HarryHYu/GrappStar/base/spec/DECISIONS.md

# Coordinator decisions log (binding)

Each decision overrides anything older in BASE_SPEC.md, params.py or worker notes. Panel architecture docs that informed them: base/spec/panel/ (reference only).

## Coordinator decisions (binding from v1.0, 3 Nov 2026 11:20 Sydney)

| # | Decision | Why |
|---|---|---|
| D1 | Launch drive COAXIAL: cad-launch's launch sleeve (20 OD, 6 mm key at sprag #1 inside the 26T m2.5 drive gear, splitter sun, rail cheek journals); cad-drum's LAUNCH DOG RING keys onto its inboard flange; main shaft steps to a d12 spigot inside the sleeve; frame outboard bearing at the sleeve's far end | The big gear rides on the rail and only stays in mesh if the drive gear is coaxial with the rail pivot (v10's key property) |
| D2 | Main axis 165 above the deck top | Rail rear and cocked carriage sweep about 150 below the axis at 47 deg |
| D3 | REEL output gear m2 40T face 12 (cad-drum) meshing the capstan gear m2 24T (cad-reel): capstan 1.667 x wiper, about 0.13 to 0.16 m/s line; tow limit default 50 N in firmware | cad-reel's train is m2; at wiper stall the line sees about 373 N, below the 667 N break |
| D4 | 7 cup turns per wrap; brake FIRM during the wrap so the line comes from the slack dart side; N20 to drum ratio sized for 2x margin on the cup laying torque; the locking arc holds the cup at WRAPPED (reaction through the drum axis) | Euler-Eytelwein at mu 0.10 worst case with 2.6 N take-up holds 208 N with 7 wraps |
| D5 | Springs: preload 35 mm at HOME, 245 mm stroke, so 280 mm extension at full cock (13.1 J stored, about 7.5 m/s, about 4.5 m at 35 deg with a 0.5 N brake). Second anchor hole set for 5 mm preload (250 mm at full cock) if the hang test shows a weaker spring. Provision (anchor holes and clearance, not fitted) for a second pair of the same springs: about 8 to 9 m range | Physics F1/F2: safe extension about 290 mm (hook torsion, SF 1.2); more preload also cuts coil clash |
| D6 | Carriage front stop: compliant printed stop with at least 15 mm of travel, peak force under 300 N; carriage as light as possible (target 60 g or less) | Physics F3: a 4 mm pad peaks at about 1.2 kN |
| D7 | Payout brake 0.5 N at the line in LAUNCH and NEUTRAL; 3.0 N in REEL and through the wrap zone | Physics F5: best range with under 0.6 m of overrun |
| D8 | Torque protection: firmware current trips (ignore 50 ms after start; 5 A for 30 ms in aim, reel and tow; 6.5 A while cocking; tow trip at measured free current plus the 50 N equivalent, averaged over 200 ms) AND a mechanical torque limiter in the wiper coupler (cad-drum, printed, set about 5 N m). Keyed printed joints: rounded keyway corners and at least 20 mm of key engagement | Physics F6: the wiper stall (about 14 N m) breaks printed gears and keyed shafts |
| D9 | DRV8833 #3 SLP pin not wired (board pulls it high); AIN1/AIN2 only | Pololu 2130 docs; avoids back-feeding the ESP32 |
| D10 | Dart mass 0.279 kg (264.3 g from kedge/out30/physics.json plus 15 g ballast) | |
| D11 | Never fire without the tether attached | Physics F9: the tether, not the ballast, keeps the dart nose first at these speeds |
| D12 | AS5600 magnet: the Adafruit board ships without one. The magnet cap takes any small neodymium disc mounted edge-on (6 to 10 mm, 2 to 3 mm thick) or a 6 x 2.5 diametric disc. Fallback with no magnet: a 6-bump INDEX CAM on the main shaft read by a printed contact SW_INDEX; firmware degraded mode counts turns and sixths with time interpolation and re-zeroes on SW_HOME, SW_RAIL_LOW and the drum codes. Never wire the wiper's internal park switch | Harry's order shows no magnet; buying one is optional |
| D13 | Panel lens C proposed moving sprag #1 onto the rail pin (claimed 0.5 mm wall under a cut keyway in the 20 OD sleeve). REJECTED for churn and because the sleeve uses an INTEGRAL key rib on its outside (no keyway cut into it): wall 4 mm over the d12 spigot, torsion 1.9 MPa at 2.6 N m and 3.7 MPa at the 5 N m limiter. Binding: integral rib, sleeve wall at least 4 mm, rounded rib roots | Both workers already built the coaxial design; it is sound with a rib |
| D14 | Line transfer from the frame to the pitching rail over printed pulleys on 693ZZ bearings (Harry has them), one pulley on the rail on or just under the pivot axis so the line length does not change with pitch (panel lens C) | Eyes cost e^(mu theta) of 1.3 to 1.6 each; pulleys about 1 percent |
| D15 | TAKE-UP BUS (panel lens B, concept change 1): a gear on the main shaft UPSTREAM of the dog (always turns with the wiper) drives the storage reel's slip clutch through a forward-only printed swing one-way and a compound gear free on the capstan tube, overdrive about 2.5 (above the capstan's line speed and above cocking: 245 mm in about 1 wiper turn). A bus drag brake (about 0.04 N m, more than the LIGHT clutch) parks the bus on backward turns. The capstan train no longer drives the take-up. Payout brake = the LIGHT clutch reacting against the parked bus | Cocking pulls the dart back 245 mm; without take-up that slack is snatched at the end of the stroke: about 15 percent range lost and a 100 to 200 N spike on the tail-cap knot every shot |
| D16 | DRUM ORDER LAUNCH / NEUTRAL / WRAP / REEL (panel lens B, concept change 2): the collar stays in NEUTRAL across the wrap sector and engages REEL only when fully wrapped (fly-in with the wiper creeping forward). Unwrap: collar back to NEUTRAL first, then the cup unwinds while the wiper turns forward (take-up only, capstan still). Clutch per drum zone: LAUNCH LIGHT (0.5 N) / NEUTRAL FIRM (tidy and final approach) / WRAP sector LIGHT (line drawn off the reel; the anchored dart side is taut after the tidy) / REEL FIRM (3 N tail). Replaces D4's "brake firm during the wrap". Still physical: no wraps in LAUNCH, REEL only with wraps on, leaving REEL toward LAUNCH drives the cup back through the whole sector. Wraps stay 7 | Unwrapping in REEL needs forward wiper turns for take-up, which would also turn the capstan and pull the seated dart through the remaining wraps (up to about 157 N, invisible to the current sense) |
| D17 | Firmware sequence, interlocks and power-loss recovery follow panel lens B sections 7.1 to 7.4 (de-cock by running backward from a partial cock; tidy in NEUTRAL; fly-in for REEL; final approach on the FIRM clutch until SW_SEATED, timeout fault DART_STUCK) | Complete failure walk |
| D18 | The base frame carries the rover-side kit: a Kiyo X mount looking along the launch azimuth (pose in params FRAMEWORK; bore-sighted targeting), an RC832 holder with the antenna clear of metal, strain relief for the capture dongle and USB cables | The rover is unspecified; the base is the one structure we design on it |
| D19 | Confirm list: a spare right-angle worm N20 for the drum besides the dart's three (deploy, kick, foot; the foot N20 was already a purchase), the AS5600 magnet, a spare MP1584, M8 bolts or 8 mm rod, the load cell + HX711, how many 693ZZ / F693ZZ are left after the dart | Inventory not confirmed by Harry |
| D20 | REEL output gear m2 50T (cad-drum) and capstan gear m2 22T (cad-reel), centre distance 72.1, capstan axis at 255 deg; supersedes D3's 40T/24T. Wiper gearbox and can oriented ABOVE the main axis (WIPER.orient_deg 90) | At 64.1 the wrap cup came within 36 mm of the main axis, inside a typical wiper gearbox (about 40 mm half-width) in the same axial slab; at 72.1 the cup is 44 mm out. The 2.27 ratio also gives 0.21 m/s line speed (physics asked for more speed) and caps the stall line pull at about 270 N, below the 667 N break |
| D21 | params.py v1.0 and BASE_SPEC v1.0 (layout, interfaces, drum zones, contacts, timeline) written directly by the coordinator after the layout integration run was lost in a container restart | Workers needed positions by 12:00 |
| D22 | WRAP RIGHT AFTER LANDING, while the dart side still lies slack, BEFORE anchoring and the tidy. Sequence: LANDED -> NEUTRAL -> WRAP -> WRAPPED (cup locked, collar NEUTRAL, clutch FIRM) -> dart anchors -> TIDY (the FIRM take-up pulls the dart-side slack through the capstan, which turns freely in its wind-in sense) -> REEL fly-in -> TOW. The Jetson's landing-zone verdict comes before the wrap; a no-go retrieves the unanchored dart on the take-up (or after a wrap, on the capstan) | cad-reel: laying a turn needs 129 mm of line; with a taut dart side it would have to flow from the tail through the turns, which is the capstan's payout sense, blocked by sprag #2: 7 turns would need about 360 N at the ring. The 0.9 m comes from the landing slack instead (worst case it tugs the still unanchored dart under 1 m) |
| D23 | Launch sleeve y 111..193 with a TWO-LAYER big gear (a sector layer for the rack, a full 40T layer for the drive gear, so every cock can start); the sleeve's outboard bushing with the thrust face sits in cad-launch's AIM HOUSING at y 187..193 (stands on the deck; no frame seat on the sleeve); the d12 spigot runs through the sleeve to about y 200; magnet cap y 195..203; AS5600 bracket on the aim housing (cad-launch). The LAUNCH dog ring's joint follows the launch sleeve (it is bolted to it) | cad-launch review: a single sector layer leaves the drive gear in the toothless gap for 117 deg of each turn; the stack no longer fit inside y 172 |
| D24 | Clutch FIRM 5.0 N, LIGHT 0.5 N, both as line tension with the storage reel FULL (r 30.7 mm): torques LIGHT 15 N mm, FIRM 153 N mm (about 23 percent more tension at the core) | Physics: FIRM 3 N delivered 1.9 to 2.3 N at the dart in the final approach against 2.1 to 2.6 N needed; 5 N gives a 1.5x margin |
| D25 | Take-up bus as built by cad-reel: bus gear m1.5 50T face 8 at y 40..48 (cad-drum, on the outer coupler after the shear pin) meshes c1 m1.5 46T free on the capstan tube (centre 72.1); the swing idler m1.5 30T rides c1's hub and engages the reel gear m1.5 20T on forward turns; clutch disk at 2.5 x wiper; NO bus drag brake. Storage reel flange 72 (two-piece) for 20 m | Under payout the clutch back-drives the idler with the same tooth-force sense as take-up, so it stays engaged and reacts on the self-locking wiper; on backward turns it swings out and the reel is not driven. Flange 66 left only 1.6 mm freeboard |
| D26 | D8 torque limiter = a printed PLA shear pin (d4, single shear at r 13, about 5 N m) between the coupler hub and the outer coupler, replaceable, 6 spares in the pack; the firmware current trips are the first line. Carriage stop = printed PLA flexure with about 19 mm travel (no TPU in hand; TPU pads are an optional upgrade) | A printed friction limiter needs about 500 N of axial preload, which a printed spring cannot hold without creep. Physics: 2.8 to 3.3 J per shot needs about 19 mm for a 300 N peak |
| D27 | Contacts: one SW_DOG (fork deflected: tip to tip or jammed) replaces SW_DOG_L/R, checked after every drum arrival including NEUTRAL; GPIO table = fw-base's pins.h (SW_HOME 21, SW_INDEX 35; GPIO38 is the DevKitC-1 v1.1 RGB LED); drum Gray code per cad-drum (bits C B A: LAUNCH 001, L_TO_N 011, NEUTRAL 010, WRAP 110, WRAPPED 111, N_TO_R 101, REEL 100). On a fault the firmware HOLDS the drum (not NEUTRAL) when wraps are on, the spring is drawn, or the fault is the drum itself | Owners' final designs; shifting under load could dry fire or crush |
| D28 | Contract C2: the dart's impact threshold is 3.5 g (not 6 g) | fw-dart: the BNO085 clips at 8 g and filters, so short impacts read under 6 g |
| D29 | Ballistics: range_m is measured from the ground point under the rail pivot; the Jetson adds the camera-to-pivot offset; the solver uses the whole 6..47 deg table and prefers the higher pitch when two solutions exist; minimum range about 2.9 m (at 6 deg) | Physics review: shots would land 0.15 m short; AIM.launch_pitch_range was unused |
| D30 | Springs: the Bunnings part is Century C-243 (5/8 x 6-1/2 in, 0.054 in = 1.37 mm wire), rated 38.4 N max safe load and 302 mm max deflection. Full cock is now 265 mm extension (about 40 N with the estimated rate; preload 23.8 with the 241.2 stroke), fallback hole set F 256.5 mm (8.5 mm rearward, as built); the hang test decides. Supersedes the 280 mm of D5 | Physics catalogue check: 280 mm would be about 42 N, 9 percent over the rating. About 12 J stored instead of 13 J (range about 5 m) |
| D31 | (SUPERSEDED in part: WRAPPED park 314 since params 1.2.1 (D35); faults with the wraps on HOLD the drum, params 1.2.5) CORRECTION of D27: params v1.1 copied a cad-drum message queued before v1.0. params v1.2 restores what cad-drum actually built on v1.0 (drum_NOTES v4): SW_DOG_L and SW_DOG_R (not a single SW_DOG), Gray code bits A B C as in v1.0, end stops -4 / 352, park angles WRAP_PREP 56 and WRAPPED 309, REEL 347, unload jog 8 deg, and the fault rule "from REEL or N_TO_R go to WRAPPED, never NEUTRAL" | Owner's current design; my v1.1 drum block was stale |
| D32 | (SUPERSEDED by D33: offset -10.4, not -6) Tow tension from the current sense: line N = 17 x (I - I_free) - 6 (physics, through the 2.27 capstan ratio); the firmware's 8 N/A constant would let the tow reach about twice the limit | Physics review |
| D33 | Current trips revised: 5 A for 30 ms in aim and reel-in; 6.5 A while cocking AND while towing (a 50 N tow draws 5.1 A); the tow is limited by the tension estimate line N = 17.0 x (I - I_free) - 10.4 (physics v1.2 with FIRM 5 N), default limit 50 N. Printed spring guard over both springs (hooks near their rating) | Physics v1.2 rerun; docs safety review |
| D34 | The rail pivot pulley is cad-launch's part (launch_pulley_piv: groove r 6 on a 693ZZ, M3 axle from the inboard cheek), centre at pitch 0 world (0, 119, -44), axis +Y, rotating with the rail; cad-reel's last frame pulley feeds it in the y 119 plane from about (10, 119, -60). launch.line_entry(P, S) / line_path(P, S) define the hand-over. Tow trip computed in firmware: I_trip = (tow_limit_n + 10.4) / 17.0 + I_free | cad-launch already modelled it clear of the sleeve flange and dog ring; physics v1.2 tow drag |
| D35 | ONE C1 command sequence (BASE_SPEC 10.1), fixed by the coordinator: `wrap` ends at the WRAPPED park 314 with a `WRAPPED` event (no `MODE` REEL); then the dart anchors; `tidy` (take-up by time, event `TIDIED`); `mode` REEL is the fly-in; tow; release; capstan reel-in; `unwrap`; `retrieve` (take-up in NEUTRAL, event `SEATED`); `mode` LAUNCH. `decock` is a first-class command (alias of `cal decock`). fw-base owns PROTOCOL.md and documents exactly this; jetson mission, mock base and systest follow it | Review R1-A: firmware, PROTOCOL.md, the mock and the mission each ran a different drum sequence |
| D36 | Line guide BEHIND the rail rear end on the dart axis (params LAUNCH line_guide_u -200, line_guide_w 85, rail coords): the line runs from the pivot pulley along the rail to that guide, then forward to the dart tail, so the path only gets longer during the stroke. Printed carriage at most 70 g (params LAUNCH carriage_mass_target_g); cad-launch reports the slicer mass to physics | Physics: with the guide at the pivot (D14) the path shortens 72 to 98 mm in 40 ms, the line snatches after the shot: about 7 percent slower, 0.6 m less range (3.70 vs 4.29 m at 0.5 N); a 100 g carriage costs another 0.4 m and overloads the stop |
| D37 | Sleeve flange to dog ring joint: cad-launch puts 3 lugs (6.0 wide x 3.0 tall, r 15..21, at 60 / 180 / 300 deg) on the flange face at y 111 and 3 x M3 clearance holes at r 28.5 (0 / 120 / 240 deg); M3 screws from the launch side into cad-drum's tapped dog ring | Both parts had slots and no key (review R2-E); cad-drum's ring has no room for counterbores between its dogs |
| D38 | Two launch springs only in v1. The second-pair provision (pegs and anchor holes) stays in the CAD but is not supported: the second pair needs about 5.83 N m per cock, above the 5 N m coupler shear pin and the 6.5 A cock trip. Documents must not promise the 4-spring range | Review R2-K mechanism feasibility |
| D39 | Tow limit capped at 70 N (params REEL tow_limit_max_n; firmware refuses higher `max_n` / `tow_limit_n`): the 6.5 A tow trip is about 75 N at the line (17 N/A model) and the shear pin slips near it. `retrieve` only in NEUTRAL with the wraps off (never at the park, never on the capstan: unwrapping with the dart seated is the D16 hazard) | Review R2-K; fw-base question on retrieve at the park |
| D40 | Aim train protection: every backward wiper run in LAUNCH (aim, decock, backward jog) trips at 3 A (params REEL current_trips_a aim / backward_launch 3.0; the normal aim peak is about 1.9 A); the aim splitter sun, idler and bevels print in PPA-CF | Physics with cad-launch's real aim gears (m1.5 z30 face 8): Lewis safety factor 0.62 in PPA-CF at the old 5 A trip, 1.44 at 3 A; PLA fails even at 3 A (review R2-K, R2-F2) |
| D41 | Fly-in after the tidy (line straight, dart anchored): the wiper creep stops at the dog bite, not only at SW_DOG_R: stop as soon as SW_DOG_R closes OR the current rises about 0.8 A above the creep's running level; from the bite on, any wind-in is limited by the tension estimate at 20 N (like a tow start), not by the 3 A hard trip; if SW_DOG_R is still open the drum completes the move and the wiper jogs at most 5 deg at a time. The D35 order stays | Systest F20 with a stiff Dyneema plant (EA 20 kN): the creep after the bite winds about 0.6 mm of line per wiper degree (about 3.4 N per degree), so the fly-in tripped 3 A every time; the old soft plant hid it |
| D42 | Tow sensing offset corrected: line N = 17.0 x (I - I_free) - 3.0 (params REEL tow_tension_model), superseding the -10.4 of D33: the take-up drag was double counted (the clutch disk turns at 2.5 x the wiper, D25). Firmware default and CALIBRATION follow params | Physics round 6 review |
| D43 | Pulleys where the line turns under tow load: the exit eye, the cup ring and the storage guide get printed PPA-CF pulleys (groove radius at least 6 mm) on M3 screw axles (or 693ZZ where Harry has spares); no plain printed eye carries tow load. Path gain capstan/dart 1.15 (params REEL path_gain). The tow limit means the DART-side tension: line N = 14.8 x (I - I_free) - 2.6 at the dart (params REEL tow_tension_model), calibrated with the luggage scale at the line end. Cap 60 N at the dart (D39 updated) | Physics retrieve review: plain printed eyes (50 + 58 deg) give a gain of about 1.5: a 50 N dart pull needed 6.1 A, above 0.8 x the shear pin; 1 to 2.4 W of rubbing heat at the exit eye grooves PLA and weakens Dyneema above 70 C |
| D44 | Coupler shear pin (D26) prints lying down so the shear plane cuts across layers; break 3 spare pins on a torque arm before the first powered cock (MEASURE_LIST G14). Wraps walking along the capstan and the skirt gap get a bench tow test before the first field tow (TEST_PLAN). The storage reel gets a lay guide or more flange margin so a mounded pack does not overflow the d72 flange (cad-reel) | Physics: a layer line on the shear plane slips at 2.5 to 3.3 N m, the same as the cock (2.9) and tow (2.8) torques; without a level wind 20 m mounds to r 35..36 against the r 36 flange |
| D45 | After the landing and before the wrap, the Jetson lowers the rail to the minimum pitch (`aim` 6 deg) when it is above 15 deg (BASE_SPEC 10.1 step 7b); the tow then runs with the rail low. The firmware ignores SW_HOME for 0.5 s after the release (the PLA stop lets the carriage rebound up to about 100 mm) | cad-launch: in tow the line over the lip roller pushes the carriage back by T (1 - cos a); at 47 deg and 60 N that is about 19 N against about 20 N of spring preload; at 6 deg it is under 1 N |
| D46 | The cup-ring roller is not in v1 (it would rebuild Harry's v7 cup): the ring stays a plain eye, pulleys at the exit eye and the storage guide only. Path gain 1.30, dart-side law 13.1 x (I - I_free) - 2.3, tow cap 55 N at the dart (params REEL). Open for Harry: a steel bearing surface in the ring (an M3 screw shank or a pressed steel bore, about mu 0.15, gain 1.22) cuts the ring heat (about 0.9 W at 50 N) | Physics with cad-reel's plan; the first field tows stay at or under 40 N until the ring has been checked for wear |
| D47 | Datum: world y = 0 IS the wiper boss face (params frame note and WIPER motor frame). cad-frame places the motor so its boss face sits at y 0 (the plate and puck may extend to negative y behind it); cad-drum's coupler engagement (D bore over the flats, M8 nut on the thread) is derived from params WIPER (boss_h, shaft lengths) measured from that datum, so Harry's measurements move both together. Frame deck tiles keep at least 3 mm bed margin in print pose (X2D 256 mm) | Review S: the frame put the boss plane at y -10, leaving the coupler on 3.5 mm of flats and 1.2 mm of thread; deck tiles were 255.5 mm in print pose |
| D48 | The wiper boss face sits at world y -10, the rear face of the 10 mm motor plate, as the frame is built. params WIPER boss_face_y (-10) is the one datum: cad-frame places the motor from it and cad-drum derives the coupler hub (D bore over the flats, M8 nut on the thread) from it and the measured WIPER shaft numbers, so the measurements still move both together. Supersedes the y 0 datum of D47; the deck-tile bed margin rule of D47 stands | Final cross-check (cad_power-1): the frame never moved to y 0, so the hub engaged 3.5 mm of flats and 1.2 mm of thread; moving the hub to the frame as built is the smaller, audited change |

## D50: reel unit on the deck behind the launcher (binding from params 1.5.0, 5 Nov 2026)

| # | Decision | Why |
|---|---|---|
| D50 | REEL UNIT BEHIND THE LAUNCHER (supersedes D49; restores the 53ed345 base design with D49's free spool and axial eyelet). The storage reel and capstan sit on the DECK directly behind the launcher, in the rail plane y 140, on a bolt-on deck extension tile (x -412..-164, dovetails, heat-set inserts, M3 to the rover like the other tiles); the launcher stays where it is. From the back: free storage spool (core d40, flange d62, pack 20 wide, axis world Y, keyed on its shaft in two 608s), capstan with Harry's v7 drum and cup (axis world X, horizontal; the cup ring hole turned AXIAL at radius 26, ring at the BOTTOM at home), the unwrapped line straight from the pack top through the eyelet and out of the capstan front. The eyelet sits on the low-aim line (the dart axis at the 6.01 deg LOW dead point extended back, eyelet at world (-240.6, 140, 59.7)), so the floor segment is straight at the tow pitch. ONE free 693ZZ pulley at the rail rear end (the line runs UNDER it): 0 deg at 6 deg, 92 at 20, 114 at 34, 125 at 47 (the rail rear drops 150 mm while the unit stays put, so the owner's estimate of about 40 deg at 47 deg is not reachable this close; the line also leaves the eyelet mouth 72 to 80 deg downward above 20 deg). The bottom and pivot pulleys, pulleys 1 and 2, the swivel, the guide eye and the run under the rail are gone. Drives on the floor, nothing new on the rail, exactly one wiper and one N20: capstan from the REEL gear through a 41T idler, the 22T C gear and ONE bevel pair 20:20 into lane C (d12 along the deck), rear train 20T / 58T idler / 20T (capstan still 50/22 x wiper), sprag #2 on the capstan tube in P1; the cup from the single N20 through the drum's wrap segment and wrap idler, the 24T cup gear, a 1:1 riser (30T, idlers 34T and 30T, K2 30T), ONE bevel pair 18:18 into lane K, rear train 20T / 76T / 20T (7 wraps); the take-up from the always-turning bus gear through c1, the swing idler and the switched slip clutch as before (FIRM 5 N for tidy and the final approach, LIGHT 0.25 N fixed anti-overrun drag for payout and the cock take-up), clutch hub 28T / T2 28T, one bevel pair into lane T and one onto T3, 16T / 34T / 16T to the spool (1:1). Path gain 1.18 at the tow pitch, dart-side law 14.4 x (I - I_free) - 2.5, payout gain 1.32 (20..47 deg). Mission order unchanged (C1, BASE_SPEC 10.1); the take-up during the cock removes the aim slack at the rail-rear pulley | Owner: D49 put about 0.9 kg on the tilting rail (too heavy on the launcher); keep the straight, light D49 line at the tow pitch with the reel on the floor. Cost: three bevel pairs and two idler trains, the take-up chain spins with the spool in payout (about 9000 g mm2 at spool speed, in the physics), large pulley wrap at high pitch (693ZZ, low load in flight). Bench checks: eyelet mouth wear at high-pitch launches, the axial-ring wrap laying (D44 test), the lane shafts' wind-up |
