HarryHYu/GrappStar/base/cad/parts/reel_REPORT.md

# cad-reel report (worker cad-reel, 3 Nov 2026)

Status: DRAFT, updated through the day; final version at 18:30 Sydney.

## 1. What is done

- `reel.py`: the whole reel subsystem on the cad-infra API (parts, joints, kin, allowed, clearances, grounded,
  audit_states, checks, steps, line_path), placed by params.LAYOUT.reel_frame_R and reading REEL, DRUM and LAYOUT
  from params (v1.2).
- `reel_v7.py`: Harry's v7 capstan drum and wrap cup ported exactly to manifold3d (ring, block, U groove cut last,
  funnels); only the bores changed (drum keyed on the capstan tube, cup keyed on the cup shaft with the D hidden).
- `reel_calc.py`: wraps (Euler-Eytelwein), storage pack, spin-up and overrun, clutch preloads and the rocker spring,
  gear train speeds and torques, current to tension, cup holding torque, unwrap schedule.
- `reel_NOTES.md`: every interface number for the other workers (v6: brake linkage in section 6, pulley 2 swivel in 4b).
- Brake input linkage (review 2 rebuild): cad-drum's track 2 cam pushes my brake bar, the bar turns a bell crank, the
  crank lifts the rocker's stiff leg. kin follows the round nose's envelope on cad-drum's real cam profile.
- Rocker spring sized with its real section (`reel_calc.rocker_section`).
- Tests: `test_reel_calc.py` and `test_reel.py` (counts in section 3).

## 2. Decisions I made (Harry was away)

- Kept Harry's v7 reel exactly where the line touches it (ring, groove, guide 1 mm behind the flange, exit eye 31.5
  past the ring, plain round eyes). The two eye axes are tilted to bisect the line's bend (still plain round holes):
  along X the launch line left the guide 50 deg off axis and grazed the post.
- Sprag #2 is the capstan backstop in a separate PPA-CF hub (prints upright, so the 47 mm press seat is round).
- Wrap order: wrap right after landing, while the dart-side line is slack (adopted as D22). With a taut dart side the
  turns would have to slip on the backstopped capstan (about 360 N at the ring at mu 0.15).
- Take-up bus (D15) built as one bus gear on the capstan tube that also drives a pawl-free swing idler riding its own
  hub (adopted as D25); no bus drag brake (payout keeps the idler engaged; the reaction goes to the self-locking wiper).
- Clutch: friction ring r 20..30 on a separate flat flange disc; the PPA-CF brake rocker is the FIRM spring; LIGHT is set
  by two M3 trim screws (tolerance-free), and the brake fails to LIGHT if the drum track lets go.
- Storage reel flange 80 (spec said 66; D44 for the mounded pack), two-piece so it prints without support (D25).
- No slack-line shoe: physics F5 puts landing overrun at 0.24 m and the shroud keeps loops on the reel.
- Brake linkage (review 2: the old push rod from behind the wall could not reach cad-drum's cam, which sits in front
  of my wall 137 mm away): a sliding bar in front of the wall, under the shroud and under a shortened guide post, plus
  a bell crank left of the reel pushing a stiff leg on the rocker from behind (arm B in a 4 mm recess in the wall).
  Chosen over a wedge because a sliding 45 deg wedge needs about 18 N at the cam (cad-drum designed for 15 N); the
  crank needs 5 N plus pin friction.
- Rocker in PPA-CF, not PETG (Harry has no PETG; PLA would creep at 17 MPa held for minutes). The plate stays
  3.0 mm (17 MPa at FIRM); the crank (arm B 14.1 / arm A 20, less the FIRM screw's lost motion) sets the 2.1 mm leg stroke that gives exactly
  LIGHT to FIRM at E 5 GPa. Review 2 showed the old 4 mm at Y -33 would have given FIRM far too high.
- Wall top cut r 37.5 round the main axis (cad-drum's coupler grew to r 35 in my wall plane).
- SW_ARM lever tip moved 3 mm toward -X (home notch rotated with it) so its nuts clear cad-drum's wrap idler by 3.5 mm.
- D44 (no level wind): flange d 80 instead of a lay guide. A fixed fairlead 45 mm from a 22 mm wide pack cannot lay
  line; a traverse is not cheap. The reel axis moved 6 mm left so the guide eye post still clears the reel; the wall
  grew 6 mm on the left (free space).
- D43 exit eye: replaced by pulley 1 itself. Its groove line is tangent to Harry's ring-to-eye line at the old eye
  centre, so the line leaves the cup exactly as in v7 (31.5 past the ring).
- D43 storage guide: kept as a plain eye (tail only, at most 5 N; the pack sweeps 22 mm in front of it).
- Pulley 2 on a swivel fork (review r3_Q): a fixed pulley 2 saw the line leave 5 to 53 deg out of its groove as the
  rail aims. The fork turns about the incoming run, so the line stays within 2 deg.
- FIRM made adjustable (review 3): printed PPA-CF stiffness is only known to about 4 to 9 GPa. A FIRM screw in the
  rocker leg sets the lost motion, and a pad on the wall stops the rocker at LIGHT so the bar is not loaded there.
- Capstan drum in PPA-CF (physics: hoop stress 11.6 MPa if the shear pin slips, PLA allows 12).
- Final cross-check (params 1.3.8):
  - cad_support-5: the pulley 2 post's foot screw holes broke out of its 17.7 mm foot, so cad-frame cut no inserts.
    Foot widened to 29 mm (it now carries the whole gussets too, which also were not fused to the column: fixed),
    2.8 mm or more of solid round each hole; deck_holes(P) lists all 15 reel deck screws for cad-frame.
  - cad_support-7 / docs-3: the SW_ARM step said a bump closes the contact at home. The track holds it CLOSED away
    from home and the notch OPENS it at home (params SWITCHES, config.h armHomeOpen). Step, notes and comments say so;
    the step sets the gap with the lever free in the notch and checks both states with the meter.
  - cad_support-11: d2.6 pilots through the bracket plate under the switch base's four holes; the BOM lists the base,
    lever clamp and bracket screws.
  - cad_support-10: the pivot pulley centre is taken up the rail normal (it was along the rail, 9.2 mm off) at the
    pitch launch.kin poses; pulley 2 raised 2 mm to world z -54, so the real run to the pivot pulley clears cad-drum's
    shift rail by 0.88 mm at 6 deg (it was 0.13).
  - The line follows the cup as kin poses it (cad-drum's wrap idler), not S["wraps"] (up to half a turn apart
    mid-wrap), and checks(P, asm) adds tether_check: the posed line against every posed part of every subsystem, with
    each span's allowed contacts.

## 3. Verified (pasted at the final update)

## 4. Open items

- cad-frame (not mine to change):
  - frame_motor_adapter (194 mm plate, world y -16..0) cuts through my capstan drum, C tube and K shaft. Needs a
    through hole r 30.5 about world (x -18.66, z -69.64).
  - The same plate is crossed by the line run from pulley 1 down to pulley 2 (world x 61.3, z about -49). Needs a
    notch at world x 56..67, z -60..-43, y -16..0. The tether check also finds the guide eye -> cup ring run (0
    wraps) in the plate near world (-51, -5.5, -44) (cross-check cad_support-1, being carved).
- cad-launch (not mine to change): launch.line_path draws the pusher -> dart span straight to the landed dart; in
  rail_low (rail 36 to 47 deg) the tether check finds that straight line in launch_rail_front and launch_big_gear. The
  real line runs over the lip roller first (reel_NOTES.md section 12).
- D46 (coordinator): the cup ring stays a plain eye; a steel ring liner is left open for Harry. A roller in the ring
  would rebuild Harry's v7 cup, so I did not do it.
- D43 storage guide eye: kept as a plain eye. It carries only the tail, at most 5 N (FIRM). The pack position sweeps
  22 mm across a 45 mm run to the guide, which would throw a line off a pulley. Plain eye with coned mouths.
- Mid-wrap the dart line reaches pulley 1 steeply while the ring is turned away from home. It may brush the pulley rim
  and the lower cheek edge; this is slack line (D22). Under tow the cup is at home and the line is in the groove.
- Printing (needs supports or care, noted rather than redesigned):
  - sprag hub seat lip and the ring under it (paint supports inside the seat);
  - the pulley 1 and pulley 2 post cheeks and the pulley 2 arm (supports);
  - SW bracket flange (supports, or print on the flange's wall face).
- 693 inner-race bosses: 0.7 mm wall round the M3 hole; print slowly, or drop them and use two thin shims per pulley.
- Past the LAUNCH stop (drum -4 .. -2) the bar nose already sees cad-drum's gap blend toward FIRM (2.5 mm at -4).
  Harmless unless the drum parks on its stop.
- Rocker creep: 17 MPa held through NEUTRAL, WRAPPED and REEL. Recheck FIRM with the luggage scale after the first
  week (section 5).

## 5. What Harry must measure

1. Capstan sprag CSK20PP keyway depths (inner and outer) against the seat and key rib dimensions in reel_NOTES.md.
2. mu of the Dyneema on the printed capstan (7 wraps hold 407 N at mu 0.10 with the 5 N tail). Hang a weight over a
   printed drum offcut: the wrap count is set from it.
3. LIGHT drag: drum at LAUNCH, reel full. A 50 g weight on the line end must just pull line off slowly (0.5 N). Set
   it with the two trim screws: park the swing arm, line up the reel gear's holes, use a 2.5 mm hex key from behind.
4. FIRM drag: drum in REEL. The luggage scale on the line end must read 5.0 N at slip. Set it with the FIRM screw in
   the rocker leg (one turn is about 1 N), then lock its nut. This also measures the real E of Harry's PPA-CF: the
   screw range covers 4 to 9 GPa.
5. Bar travel: drum at LAUNCH, the nose must sit about 0.2 mm off the cam (feeler). At REEL the crank turns about 11 deg.
6. Storage pack: after winding 20 m, the pack top must stay at least 4 mm under the d 80 flange rim.
