HarryHYu/GrappStar/base/cad/parts/frame_REPORT.md

# frame_REPORT (worker cad-frame)

Interim at 14:45 Sydney; final at 18:30. Interfaces and board data: `frame_NOTES.md`. Whole-base audit (I am the
integration auditor): `frame_INTEGRATION.md`, regenerated by `cad/parts/_frame_tests/integration.py`.

## 1. What the frame is now (BASE_SPEC v1.2.x, D23)

- **Motor end.** Motor plate `frame_cheek_r` at y -10..0 (its front face is the spec's y = 0). A window r 88 takes
  the **puck adapter** `frame_motor_adapter` (PPA-CF): motor slots from `params.WIPER` (+-4 mm), M6 heads from the
  front, a rear lip (r 97, y -16..-10) keys it, 8 x M3 from the front at r 92.5 into lip inserts (only those with both
  plate and lip material are used, at least 4 checked), two tether channels cut out to its edge (cad_support-1).
  The wiper boss face is at y -10 (params WIPER boss_face_y, D48); cad-drum's coupler hub reaches into the puck bore
  to take the flats (y -4..10) and the M8 thread (y 10..22). Puck and plate are carved round the reel cup and capstan
  that pass behind the plate below the axis.
- **Support.** A bridge behind the puck lip carries the plate to `frame_motor_leg` in the free corner between the reel
  cup and the bay (x 78..108, y -55..-30), printed upright on a two-sided gusseted foot (4 x M3 into the deck). A can
  stay `frame_can_stay` from the plate's rear face straps the upright motor can.
- **Gear guards.** `frame_guard_hood` (over the reel and bus gears, hung from the plate front face) and
  `frame_guard_front` (between the drum gears and the bay), carved round every sweep.
- **Deck.** Dovetailed tiles, target footprint plus every foot of every subsystem; an insert under every frame foot
  hole and every round M3 hole found in another subsystem's foot; seams placed as far as possible from holes; rover
  holes never under a foot; 1:1 drill template PDF + CSV.
- **Electronics bay** 124 x 124 in the params region, USB to +x (outward), motor and sensor exits to -x clear of the
  leg, perfboard for the dividers and buses. **Rover kit**: Kiyo X edge-plate mount (tilted to the params pitch),
  RC832 holder, cable anchors.

## 2. Decisions I made (Harry away)

- Read BASE_SPEC section 2 literally (y = 0 is the adapter plate front face): the frame's motor interface moved to
  y <= 0 at 14:05 after review round 3 showed the drum stack and the SW_INDEX mount assume it.
- Frame spring guards dropped: cad-launch owns the D33 spring guard.
- The adapter became a puck in a plate window (not a standoff hub on a cheek): the only way to hold the motor at
  y -10 with the coupler, index block and reel parts all in front of y 0.
- Everything the frame owns near other subsystems is carved from their swept volumes at build time, so the frame
  follows when they move. Cost: the frame build loads the other subsystems (about 35 to 80 s).

## 3. Requests to other workers
- cad-launch: launch.py does not build on base-v1 at 14:26 (`NameError: RIB_T`, launch.py:385); it was left out of
  the 14:26 audit.
- cad-drum: coupler hub bore for the WIPER shaft (flats from y -4 to +10, M8 thread to +22, boss r 12 to y -6).
  Done in the final cross-check (D48): the hub follows params WIPER boss_face_y.
- sensors (whoever owns it): SW_GAP parts sit inside the wiper envelope; move them or mount them on the puck front.
- Everyone: feet on the deck top with M3 clearance holes (inserts come automatically).

## 4. Mass, CG and stability (whole base, 15:10)

- Mass 6.17 kg: frame 3.33 (incl. the 1.3 kg motor and the bought boards), launch 1.50, drum 0.71, reel 0.59,
  sensors 0.05. Printed frame parts about 1.9 kg.
- CG at world (42, 44, -29): 136 mm above the deck, 182 mm from the nearest deck edge.
- Unbolted, the base tips only with about 110 N sideways at 100 mm height; bolted (32 rover M3) the rover bolts see at
  most 14 N pull and 12 N shear at the 373 N wiper-stall line pull (D3).
- Shot: dart momentum 2.0 N s along the rail at 35 deg gives 0.33 N m s about the rear wheel line at the pivot height;
  the rover's front wheels stay down if its CG is more than about 26 mm in front of the rear axle (3 kg rover) or
  22 mm (5 kg).

## 5. Verified (paste of runs: see section 7 at 18:30)

## 6. What Harry must measure
- Wiper motor (boss holes, boss height, gearbox and can envelope, shaft flats and thread): edit `params.WIPER`, rerun,
  reprint `frame_motor_adapter` (the puck) and `frame_can_stay`.
- BTS7960 heatsink height and hole pattern; which ESP32-S3 DevKitC-1 (Micro-USB or USB-C); the rover top plate.
