HarryHYu/GrappStar/docs/build/src/07_electronics.md

# 7. Electronics and wiring (base and rover)

Battery unplugged for every step in this section. Two documents, used in this order:

1. **Base electronics bay, on the bench** (7.2, `firmware/base/WIRING.md` section 8, Parts A to D): set the buck,
   wire the ESP32, BTS7960, DRV8833, sensors and contacts, run the meter checks, first power with the ESP32 on the
   Mac's USB. Then `firmware/base/BENCH_TEST.md`.
2. **The whole rover** (7.1, the system page): the XT60 Y harness, the fuses, the Jetson and video, and the first
   power-on of everything together (its part 4). Do this once the base is assembled and on the rover (order of
   work step 9), and again after any rewiring.

One-page printable pin sheets for the bench: `docs/build/Wiring_Cheat_Sheet_Base.pdf` (base ESP32-S3) and
`docs/build/Wiring_Cheat_Sheet_Dart.pdf` (dart XIAO).

Before the buck output goes to the DRV8833 VM (WIRING.md Part B step 11), measure the buck on its own again: 9.0 V
with no load, then connect it (battery unplugged).

When you reach WIRING.md Part B step 12 (buck input), put a 2 A inline fuse in the IN+ wire right at the B+ screw
(system page, run P4).

Where the two differ, the system page adds the rover parts (Y harness, 2 A and 1 A tap fuses, Jetson, RC832); the
ESP32 pins always come from WIRING.md.

## 7.1 The whole system

@include docs/build/SYSTEM_ELECTRICAL.md

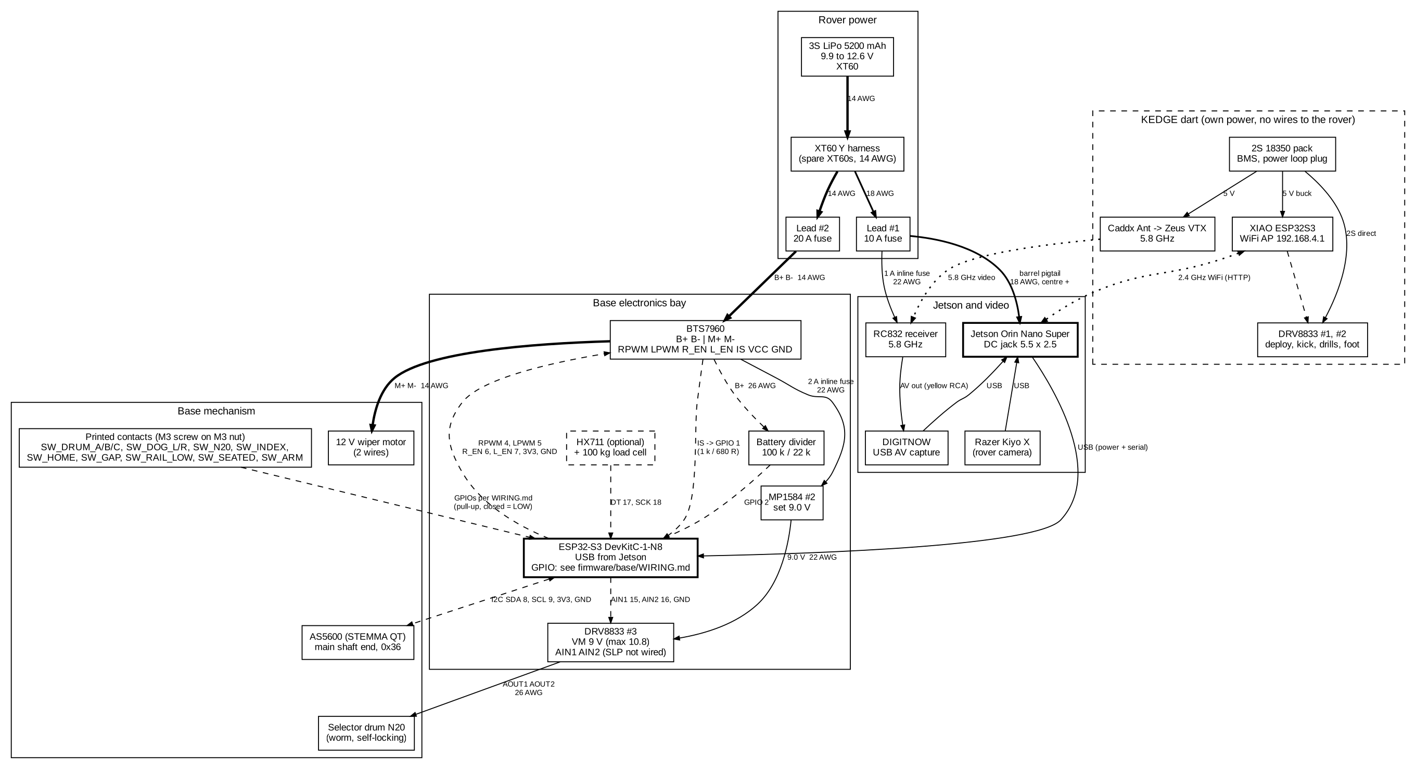
[picture p1: docs/build/system_electrical.png]
Whole system electrical diagram (bold = battery power, dashed = signal, dotted = radio)


## 7.2 Base ESP32 wiring (pin by pin)

@include firmware/base/WIRING.md
