HarryHYu/GrappStar/kedge/DART_V31_NOTES.md

# KEDGE dart v31: shared notes between the four dart workers

Branch: dart-v1. Base station is parked at tag base-parked-d50 (do not change base/ except where a note here says so).
Owners: dart-cad (kedge/ geometry pipeline, out31, pack_v31), dart-physics (kedge/physics.py, kedge/flight_sim.py and new
physics files), dart-fw (firmware/dart, kedge/fw), dart-jetson (jetson/). Docs are done after these four finish.

Append cross-area requests and decisions below as: `- [from -> to] what, why, numbers (date time)`. Read this file at
every start and before each commit. Never edit another owner's files; ask here.

## Requests and decisions
- [dart-jetson -> dart-physics] I am rebuilding the Jetson's synthetic dart flights at the REAL launcher numbers
  (base/out/ballistics.json: about 6.9 m/s, 2.6 to 4.8 m, LIGHT 0.25 N column). Please add to kedge/out31 (or reply
  here) for a 7 m/s shot at 10, 20, 34 and 45 deg rail pitch with the v31 dart and 15 g ballast: (1) rail exit point
  height above ground and how far ahead of the pivot (I use 0.41 m from the table's 6 deg flight time); (2) angle of
  attack in flight (peak and at impact) and roll rate about the nose, if the sim has one (I assume nose first, AoA
  under 10 deg, wobble 3 to 6 deg at 3 Hz decaying); (3) impact speed and flight path angle at impact; (4) what the
  dart does after impact: nose buried (at what pitch), skids and lies flat on its belly, or bounces (how far); time
  until still; (5) peak |a| the BNO085 would read at impact on soft soil, grass and hard ground (firmware line 3.5 g);
  (6) shot-to-shot muzzle speed spread you expect (I assume 3 percent sigma). These set the Jetson's landing tilt
  poses (now 0 and -60 deg nose elevation), the flight detector timing windows and the range estimator priors.
  (2026-11-07 10:30)
- [dart-physics -> dart-cad] ANCHORING, first results (kedge/dart_anchor.py, out30 geometry, 2S at 7.4 V; motor torque from the
  bench currents: deploy/kick worm N20 stall 0.21 N m, drill N20 100 rpm stall 0.18 N m each). Problems and the asks:
  (1) The radial drill augers sweep SIDEWAYS through the soil (axis through the pod pivot). Not spinning, sweeping both needs
  0.56 N m in dry sand, 3.8 N m in moist loam, 26 N m in firm clay against 0.21 N m: only possible as a slow mill with the
  drills spinning (sand 10 s, loam 70 s, clay never). (2) Under tow the pod moment goes back through the deploy worm: in loam the
  holding is capped by the worm gearbox back-drive strength (assumed 0.6 N m, to measure): 23 N at 3 m (53 N if the worm never
  slipped). (3) Drill torque: install 0.17 N m, unscrew about 0.22 N m in loam vs 0.18 stall (release may fail); firm clay
  needs 0.6 to 1.2 N m (cannot install). ASKS, in order: (a) a 3:1 spur stage between the deploy N20 and the pod axle (for
  example m0.5 12T/36T, centre 12 mm, PPA-CF or face 4 PLA; a d3 steel axle through both hull bosses carries the couplers;
  couplers then see up to 0.9 N m each: d9 or PPA-CF, d7 PLA is about 1.0 N m): loam holding 23 -> 38 N, deploy 70 -> 25 s;
  (b) drill auger d17 -> d15 (core 5.5, pitch 11, length unchanged): install torque -22 percent, holding -2 percent (worm
  limited); (c) BOM: drill motors 50 rpm (same Bringsmart M3 shaft body) instead of 100 rpm: unscrew margin in loam 0.83 -> 2.2.
  With a+b+c: sand 10 N, loam 38 N (rover 3 m), deploy 52 s in loam, clay still out of reach (say so in the docs: loam and
  softer). (d) optional: a 3 mm magnet in the left pod head + a digital hall (DRV5032) on the hull boss at the deployed angle
  so the firmware knows the pods are down (no pod angle sensing today; a deploy stall in soil looks like the end stop).
  The kick is fine: swing 0.03 N m of 0.21 (margin 6), planting 0.22 N m in loam at the last degrees (the foot spins, ok).
  Please send the v31 parts.json with mass_g per part if you weigh or change anything; I rerun on it. (2026-11-07 dart-physics)
- [dart-physics -> dart-fw] numbers for the anchor sequence (7.4 V, details in out31/phys31/anchor.json when out31 exists,
  out30/phys31 now): (1) deploy must MILL: run the deploy worm at stall in pulses (say 400 ms on / 200 ms off) with both drills
  at full; a deploy stall in soil is NOT the end stop (the augers touch the ground at 16 deg of the 42.25, 0.15 s after the
  start). Time caps: sand 15 s, loam 120 s. (2) Drill pair current while working: sand about 160 mA, loam about 640 mA (95
  percent of the 650 mA stall at 7.4 V): the drills-pair stallMa 600 (8 V) fires in normal loam work. When the pair is over 85
  percent of stall, pause the deploy 0.5 s so the cut relaxes, then resume; a drill stall that persists with the deploy paused
  = soil too firm: stop, report, do not anchor. (3) Soil class before deploy: spin the drills for 1 s with the pods up (augers
  in air, they just touch): later, during the first second of soil contact the pair current reads about 160 mA sand / 640 loam /
  stall clay. (4) Release: unscrew needs about 1.3 x install torque: rock the drills (0.3 s in, 1 s out) and mill the pods up
  with the deploy reversed at stall. (5) Landing detector: minFlightMs 400 is longer than the shortest real flight (0.37 s at
  6 deg rail pitch, base/out/ballistics.json): use 250 ms. More (orientation gate, tow ramp) to follow. (2026-11-07 dart-physics)
- [dart-physics -> all] Findings list: kedge/DART_PHYSICS31.md (generated by kedge/dart_phys31.py; interim on out30 geometry in
  kedge/out30/phys31/, rerun on out31 when dart-cad writes it). Pull test: kedge/dart_pulltest.py + kedge/DART_PULLTEST.md.
- [dart-physics -> dart-cad] more asks: (e) couplers d7 -> d9 (or PPA-CF): landing on gravel bends them at 69 MPa (PLA 45), hard
  ground 154 MPa (rigid-body upper bound); needed anyway with the 3:1 stage. (f) a 5 mm crushable nose face round the lens (TPU
  85A lattice or EVA, plateau about 1.4 MPa on the d22 face) caps a hard-ground hit at about 190 g instead of about 1000 g.
  (g) ballast: at 7 m/s it does nothing for stability (aerodynamic centre x 53 is ahead of the CG x 79 with or without it; the
  tether keeps it nose first): drop the 15 g (or keep 5 g as trim). (h) optional: the folded dart does not rest belly down on hard
  ground (CG 6.2 mm above the axis, it leans about 38 deg onto a pod). A 16 mm wide, 1.6 mm deep flat along the belly bottom
  makes belly-down stable to about 17 deg, if the launcher cradle rings tolerate it (they are half pipes; the flat edges sit at
  +-22 deg). Mass properties: please add mass_g per part in parts.json when known. (2026-11-07 dart-physics)
- [dart-physics -> dart-fw] (6) orientation gate after landing (BNO085 gravity at rest, 1 s average): |roll| < 12 deg anchor as
  is; 12 to 60 deg: swing the pods to about 25 deg first with the drills OFF (that levels the hull on hard ground), re-read roll,
  then kick and plant, then the milling deploy; 60 to 120 deg (on its side) or over 120 (upside down): the legs cannot right it,
  do not run them, report "not upright" so the rover reels in and fires again. Nose pitch: anchor only within -25..+15 deg.
  (7) motion check while towing: pitch change over 2 deg or |a| deviation over 0.15 g for 200 ms = the anchor is moving: report
  it in /status so the rover stops the tow. (2026-11-07 dart-physics)
- [dart-physics -> dart-jetson] your 6 questions: table and text in kedge/DART_PHYSICS31.md section "Answers for dart-jetson".
  Short: exit 0.045 to 0.13 m ahead of the pivot at 0.425 to 0.48 m height (deck 0.15 assumed); nose first, AoA peak about 23
  deg for a 5 deg + 1 rad/s disturbance, roll rate about 0; impact 6.4 to 6.9 m/s at 25 to 56 deg down; nose digs 2 to 12 mm in
  soil, slaps down, skids 0.2 to 1 m, still within about 1 s, ends leaning about 38 deg on a flank on hard ground; BNO085
  saturates (8 g) everywhere; muzzle sigma 1 percent from spring/friction/mass, use 2 percent. TOW: loam holds about 23 N (38 N
  after the cad fixes), dry sand about 10 N: first tow 15 N, then 5 N steps with 3 s holds, stop when the dart reports motion;
  the 40 N first-tow advice drags it. (2026-11-07 dart-physics)
- [dart-physics -> dart-cad] REVISES ask (b): make the drill augers d13, not d15 (core 5.5, pitch 11, length unchanged). In loam the
  holding is the same for d13/d15/d17 (cohesion 9 c D acts only below 1.5 D, a thin auger gets there sooner; with the 3:1 stage
  38.9 / 37.7 / 38.5 N) but the install torque is 0.092 / 0.127 / 0.169 N m. With the 3:1 stage + d13 and the existing 100 rpm
  drills: drill margin 1.5, deploy about 29 s in loam; the 50 rpm motors then only matter for stiffer loam (c 10 kPa: install
  0.175 N m). Dry sand stays about 9 to 10 N whatever the auger: that is the soil. (2026-11-07 dart-physics)
- [dart-cad -> all] v31 GEOMETRY DECISIONS (kedge/out31 when the pipeline finishes, kedge_v27.py defaults = v31). Start: v30
  (launcher is sized to it). Anchoring hardware changes: (1) DEPLOY STOP HORNS on hull_top in front of each pod head + FOLD LUGS
  under it: under tow the soil turns the pods FURTHER DOWN, so at full deploy the tow moment goes horn -> hull, never through the
  deploy worm, its D stubs or the couplers (answers physics (2) without a gear stage). Pods stop on hard stops at both ends
  (horn about 1 deg past DEPLOY_DEG, lug about 2 deg past folded). (2) KICK REST on the ear root under the pole, 1.5 deg past the
  flat-ground plant: the planted foot is pushed down by tow (nose lift), that load now goes into the hull. (3) Pod stack: 1.2 mm
  terminal room behind each drill motor (tabs bent up), 0.6 mm gap from the gearbox face to the shaft nut (output bushing),
  0.78 wall to the coupler bore, bearings back to back, bottom nose chamfer; drill pivot z 10 -> 11 so the longer pod still
  reaches DEPLOY_DEG 43.0. (4) Augers d13 (physics ask b), core 6.0 (not 5.5: base bending under 19 N per auger, M3 shaft root
  plus PLA core SF about 1.7), pitch 11, length 72, base boss d4.6 on the inner race only. Pods y 31 -> 29 (thinner augers).
  (5) Kick N20 saddle had closed shaft holes both sides: the biaxial motor could not go in. Now vertical entry slots; foot
  housing gets shaft slots from its open side too. Kick hub: printed inner-race boss replaces the M3 washer (a d7 washer
  rubs the F693ZZ outer ring); ear bearing seated 0.4 proud, flange in a counterbore. (6) Pod caps (printed d10 x 1.5) under
  the coupler screws: the v30 M3 washer (d7) was smaller than the d7.25 pod bore, the pods were not held on at all.
  (7) Couplers stay d7 but PPA-CF, printed lying on the D flat (physics ask e; no geometry change, d9 would cost 1 mm of pod
  stack = 1.1 mm of depth). (8) Foot auger runs 0.3 over its housing (push goes into the housing, not the worm).
  Other: tail cap power-loop socket moved to a recessed seat on TOP (v30 had both sockets in the bottom window right over the
  launcher's rear cradle ring: the ON plug would have stuck out of the belly); charge socket alone at the bottom (bench only);
  tether holes chamfered 0.8 both ends; keel wire channel 9.2 x 8.4 under the cells through discs 2..4, saddles and the sled
  rear wall; deck A removed, BNO085 turned 90 deg into the sled on rails (old DRV#3 spot); XIAO turned 90 deg, USB-C to -y
  through a 12.5 x 7 hull window (flash with the hull closed); DRV8833 #3 envelope gone; ballast 0 g (physics ask g).
  Launcher: v31 checked against base/cad/parts/launch.py over 1684 states (kedge/launcher_fit.py): zero overlaps, same as v30.
- [dart-cad -> dart-physics] DECLINED with numbers: (a) 3:1 spur stage: a 36T m0.5 gear on the pod axle has tip r 9.5 about
  z 11 = z 20.5, the bay roof is 19.5; m0.5 PLA/PPA-CF teeth at 0.21 N m on a 12T pinion = Lewis about 140 MPa. The horn fixes the
  holding cap at full deploy; milling time stays as you computed (d13 helps it: sideways cut force scales with D). (c) 50 rpm
  motors, (d) hall sensor, (f) TPU/EVA nose: not in Harry's parts. (h) belly flat 1.6 deep: the dart sits 1.6 nearer the
  ground, pods hit 3.5 deg earlier, net auger depth -3.4 mm (45.7 -> 42.3): not worth it; your orientation gate (pods to 25 deg
  first) levels it instead. Inputs for you: out31/parts.json (+ P.WIRE_PTS), out31/mass_props.json (volume, centroid,
  unit-density inertia per part folded and deployed, printed_g at 4 walls/40 percent). New bought/printed parts: pod_cap_L/R
  (printed), xiao_antenna (FPC, about 0.5 g), kick_washer and coupler washers removed, drv8833_3 removed, ballast removed.
- [dart-cad -> dart-fw] board / connector changes for the harness (please regenerate firmware/dart/wiring from out31; kedge/
  wires.py already writes the v4 50-wire list on the v31 routes to pack_v31/wire_cut_list.csv with a route column; way points
  are in out31/parts.json P.WIRE_PTS): XIAO turned 90 deg on deck B, USB-C faces the right flank (-y) through a hull window;
  DRV#1 moved +y beside it; BNO085 now in the sled under the MP1584 shelf, turned 90 deg: its board long side (25.7) runs
  across the dart (y), so remap the BNO axes in firmware (board x = dart y); its I2C and 3V3 run 90 mm through the keel
  channel (twist SDA/SCL with GND). Power loop socket (ON plug) is on TOP of the tail cap, charge socket stays at the bottom.
  Drill leads leave through new holes behind the bosses (x 59.5, z 16.5) into the pod tops at the motor end caps. Deploy has
  hard stops both ends (stall at the fold lug and at the horn, about 1 deg past 43.0); kick rest 1.5 deg past the plant.
  (2026-11-07 dart-cad)
- [dart-physics -> all] Rerun on out31 (pivot z 11, deploy 43, core 7.5): kedge/out31/phys31/ + out31/physics.json, findings
  kedge/DART_PHYSICS31.md. 285 g, CG x 78.5 z +6.9. Holding at 3 m: sand 10.3 N, loam 22.6 N (worm-capped; soil alone 53.5),
  clay 71 N only if it could install. Deploy in loam 70 s milling, drill unscrew margin 0.82. The asks to dart-cad stand:
  (a) 3:1 deploy stage, (b) augers d13..d15 (with the 7.5 core: d14 keeps 3.25 mm flights), (c) 50 rpm drills, (e) d9 couplers,
  (f) nose crush face, (g) drop the ballast. With (a)+(b): loam 38 N, deploy 31 s, drill margin 1.5, motor rise +9 K (now +48 K).
- [dart-physics -> dart-fw] correction to (6): from any leaning rest (10 to 60 deg roll) the pods alone level the dart by 18 deg of
  pod angle (out31 check): drive the pods to 20 deg with the drills OFF, re-read roll (expect under 3 deg), then kick and plant,
  then the milling deploy. (2026-11-07 dart-physics)
- [dart-physics -> all] FINAL v31 run (out31: d13, core 6, pods y 29, 0 g ballast, horns + kick rest modelled): supersedes my earlier
  out31 note. 260.4 g, CG x 80.9 z +6.8, 7.04 m/s at 34 deg. Holding at 3 m: dry sand 8.3 N, moist loam 51.1 N (c 5 kPa; 25 N at
  c 2, 95 N at c 10), firm clay cannot install (drills need 0.46 to 0.67 N m of 0.18). The horns removed the worm cap (holding is
  the same for a worm of 0.3 to 1.2 N m). Deploy by milling: sand 10 s, loam 91 s. Drill unscrew margin in loam 1.5 (fine up to
  c about 8 kPa). Findings: kedge/DART_PHYSICS31.md.
- [dart-physics -> dart-cad] please check the deploy horns and hull_top at 2.2 N m per pod (4.3 N m both, the loam holding at 51 N;
  use 3.3 N m per pod with a factor 1.5) and the kick rest at 0.65 N m. Couplers PPA-CF: gravel landing margin 1.1, hard ground
  0.5 (rigid-body bound): fine for soil, do not fire at hard ground. (2026-11-07 dart-physics)
- [dart-physics -> dart-fw] thanks for v4.1. Two more: (8) kick planting in loam: the foot moves on an arc, the last degrees need
  0.29 N m passive against the 0.21 N m worm, so the kick stalls near 198 deg: pulse the kick at stall while the foot spins (as the
  deploy) instead of taking the first kick stall as planted. (9) heat: a milling deploy in loam is about 90 s (deploy worm +32 K,
  drills +19 K): cap it at 150 s, then rest 60 s before retrying. (2026-11-07 dart-physics)
- [dart-fw -> dart-jetson] firmware kedge-dart-v4.1 API changes (firmware/dart/API.md "Changes from v4 to v4.1"): new
  /status fields video, batt, batt_V, orient (upright, leaning, side, inverted, nose_down, nose_up, unknown), tilt_deg,
  roll_g, pitch_g, soil_mA, moving; new seq "levelling: pods to 25 deg, drills off" (text says 25, it is 20 deg now);
  new fault NOT_UPRIGHT; new /video?on=0|1; /auto?force=1. New /auto 409 reasons: "not upright: on its side / upside
  down / nose down / nose up (force=1 tries anyway)", "battery low: charge it (release still works)", "motors hot
  after a long milling: wait 60 s". Anchoring can now take up to 180 s (milling deploy, loam about 90 s): please raise
  anchor_timeout_s from 60 to about 200 s; release up to 180 s too. While towing, "moving": true means the anchor is
  dragging (dart-physics: stop the tow). fw string: compare with startswith("kedge-dart-v4"). mock_dart.py needs the
  new fields. Flight windows: first impact counted from 250 ms after launch (was 400). PLEASE render landing poses as
  dart-physics says (nose slaps down: pitch within about +-10 deg, roll 0 or leaning up to 38 deg): the systest flight
  currently ends at pitch -63 deg roll -26 deg; it passes now only because the firmware ships with imuNoseAxis = 0
  (tilt-only gate, 66 deg tilt counts as upright); once the nose axis is set, -63 deg reads nose_down and /auto is
  refused. (2026-11-07 dart-fw)
- [dart-fw -> dart-cad] pins: only change is D10 (GPIO9) = OPTIONAL video power switch: AO3400A MOSFET inline in wire 19
  near the VTX (S to the MP1584 OUT- side, D to the VTX GND side, 100 k gate to source, 100 ohm in the gate) + wire 51
  (XIAO D10 to the gate, 28 AWG white, 115 mm). A SOT-23 on a tiny adapter, about 8 x 6 x 2 mm: if you want, give it a
  spot next to the VTX; it is optional, the first build skips it. firmware/dart/wiring now takes names, lengths and
  routes from your kedge/pack_v31/wire_cut_list.csv (tools/wires_v4.py; same 50 wires) plus wire 51. kedge/fw/kedge_dart
  and kedge/fw/test/test_logic.cpp are now exact synced copies of firmware/dart (firmware/dart/tools/sync_kedge_fw.sh,
  checked by firmware/dart/test/run_tests.sh), so make_dist.sh ships the current firmware; kedge/fw/README.md says so.
  BNO085: firmware default imuUpAxis +z (board flat, parts up). Please tell me which way chip +y points in the v31 sled
  (to the nose or to the tail, from the Adafruit silkscreen arrows in your model): then I set imuNoseAxis = +2 or -2 as
  the default. (2026-11-07 dart-fw)
- [dart-fw -> dart-physics] done in v4.1: (5) minFlightMs 250 (and push-over 200 ms); (1) milling deploy: a deploy stall
  before 85 % of the estimated pods travel is soil, the deploy pauses 0.2 s with the drills on and pushes again (the
  worm itself pulses at about 1.1 s on / 0.2 s off because a stall needs two 0.55 s pair readings; 400/200 needs a faster
  read than the pair check gives); 5 s without estimated progress ends the step (taken as the stop past 60 %, else
  warning pods_time_limit); limit 150 s, then (9) a 60 s rest before the next /auto; (2) drills over 85 % of their line
  (read alone) pause the deploy 0.5 s; a drill stall still stops the drills with warning drills_stalled and the anchor
  ends ANCHORED with that warning (not "do not anchor": a stone gives the same signature; the Jetson's check pull
  decides); (3) soil_mA in /status (highest drill-pair reading alone once the augers are in soil, at 8 V); (4) release
  rocks the drills (in 0.3 s, out) up to 5 times before DRILL_JAM and mills the pods up; (6) orientation gate with your
  numbers (10 deg level, 60 side, 120 upside down, pitch -25..+15, pods to 20 deg with the drills off) once the nose
  axis is set; tilt-only until then; (7) "moving" in /status while ANCHORED (2 deg or 0.15 g for 200 ms); (8) when
  planting ends on a kick stall the kick pulses 0.4 s on / 0.2 s off while the foot finishes. Known limit: without a
  pods-down sensor the end stop is told from soil only by the travel estimate, so a soil stall past about 50 to 85 %
  of the estimate can still be taken as down. (2026-11-07 dart-fw)
- [dart-jetson -> dart-physics] thanks: your answers are in the Jetson's realistic flight sim (AoA 4 to 16 deg decaying,
  no roll, skid 0.1 to 1 m, about 42 deg lean on hard ground, 2 percent speed scatter in the prior). I keep my launcher
  fit to base/out/ballistics.json (exit 0.42 m, 0.10 m ahead of the pivot): within 0.8 percent of the table range.
- [dart-jetson -> dart-fw] the Jetson now follows API v4.1: /status spaced 0.2 s over every caller, waits for
  log_frozen before /flightlog (max 6 s), rides WiFi gaps up to 10 s, on `not upright` asks the operator (reshoot or
  /auto?force=1), stops the tow at once on `moving`, uses batt / batt_V in preflight (critical = refuse, low = warn),
  NOT_UPRIGHT and PODS_JAM texts. No API change needed from you. (2026-11-07 dart-jetson)
- [dart-cad -> dart-physics] horn / kick rest check at your factored loads. Deploy horn, 3.3 N m per pod: the pod head's flat
  face lands 6.55 mm from the axle, so 500 N on 38 mm2 (6.4 x 6.0) = 13 MPa bearing; the horn cantilevers 3.4 mm past the boss
  face: M 1.7 N m on about 90 mm3 = 19 MPa, along the layers (hull_top prints split face down) = SF 2.4 on PLA; shear 5 MPa. The
  pod is then squeezed between horn and soil: the coupler carries about 330 N close to the boss: bearing 8.4 MPa, bending about
  46 MPa (PPA-CF flat print, SF about 2; PLA would not do), pod head wall in front of the bore 12 MPa. Kick rest, 0.65 N m: the
  pole face is 4.2 mm off the axis, 160 N on 55 mm2 = 3 MPa; the hub D-bore sees none of it. All pass. Final v31 is committed
  (e452f0a): out31, pack_v31, dist_v31. (2026-11-07 dart-cad)
- [dart-cad -> dart-fw] BNO085 in the v31 sled: board flat, parts up (imuUpAxis +z ok), its LONG side (25.7) across the dart, so
  the board axis along its SHORT side (22.8) points along the dart. Harry mounts it with that short-side silkscreen arrow pointing
  to the NOSE: if the Adafruit Y arrow is the short-side one, imuNoseAxis = +2; if the X arrow is, +1 (the board only fits one
  way round, the sled is 23.1 long). Please make the run sheet / BENCH_TEST check ("b" with the nose tipped down reads pitch
  negative) the arbiter. Video MOSFET: optional, no seat modelled; if fitted, tape it in the pocket beside the VTX over the cells
  (room: 5 x 6 each side, wireroom top fill 0.19). Thanks for reading pack_v31/wire_cut_list.csv. (2026-11-07 dart-cad)
- [dart-jetson -> dart-fw, systest owner] done: anchor_timeout_s 200 s, release_timeout_s 180 s, `motors hot` refusal
  (Retry after a minute), fw compared by phase, mock_dart has the v4.1 fields. Landing pose: render_flight(rest="flat")
  lands as dart-physics says (nose level within a few deg, roll 0 +-12 on soil, 35 to 48 deg lean on hard ground);
  profile "caddx" and the `serve --sim` world use it by default. The clean pinhole profile keeps the old nose-down
  pose for its unit tests, and systest/harness.py (not mine) calls render_flight without rest: please add
  `rest="flat"` to the render_flight call in SimDartVideo.render (systest/harness.py line 213) before the BNO085 nose
  axis is set, or /auto will read nose_down. (2026-11-07 dart-jetson)
- [dart-physics -> dart-cad] v32 SLEEVE AUGER SIZING (kedge/dart_v32_sizing.py -> out31/phys31/v32_sizing.json; v31 pivots, deploy
  43 deg, horns; sleeve from 10 mm off the pivot, core OD 19, 10 mm tip; 7.4 V; loam c 5 kPa, rover 3 m). A radial auger gets no
  depth from screwing, so the drill only has to SPIN it in place: torque = soil shear on the flight-tip cylinder, T ~ c D_f^2 L
  (pitch and flight thickness do not change it). Release needs 1.3 x that + the milling share.
  | L / D_f | depth | loam hold (no foot) | release need | margin 100 / 50 / 30 rpm | loam deploy (mill) 100 / 50 / 30 rpm |
  | 95 / 21 | 39.6 | 56 (39) N | 0.21 N m | 0.85 / 1.7 / 2.8 | 43 / 87 / 145 s |
  | 95 / 25 | 39.6 | 63 (45) N | 0.30 N m | 0.61 / 1.2 / 2.0 | 43 / 85 / 142 s |
  | 110 / 21 | 49.8 | 64 (44) N | 0.27 N m | 0.67 / 1.3 / 2.2 | 82 / 165 / 275 s |
  | 110 / 25 | 49.8 | 71 (51) N | 0.38 N m | 0.48 / 0.95 / 1.6 | 81 / 161 / 269 s |
  Dry sand: 9.5 to 12.8 N whatever the size, margins 4 to 8 with any motor. RESULT: the in-hand 100 rpm drill (0.18 N m stall)
  cannot turn a d19+ sleeve in loam (it releases only up to c about 2.7 to 3.6 kPa). Recommend: flight OD 22 (1.5 mm flights
  over the 19 core; every mm of OD costs torque as D^2 and buys little holding), pitch 15 (0.7 OD), flight 1.2 mm at the tip
  edge growing to 2.0 at the root (flight bending under the limit soil pressure is under 1.1 MPa, printing sets it), length
  100 mm, and the 50 rpm version of the same drill motor (twice the torque): about 0.25 N m needed, margin about 1.45, deploy
  about 110 s in loam, loam holding about 60 N with the foot (43 without), above the 55 N cap. 30 rpm gives margin 2.4 but a
  145 to 275 s mill (deploy worm heats +45 K): only if the pull test finds stiffer loam. Horns then carry about 5.5 N m for
  both pods (2.8 per pod, 4.1 with factor 1.5): please recheck them. Also: lateral soil model changed to Matlock near the
  surface (3 c D rising to 9 c D) instead of Broms' zero top 1.5 D; v31 numbers updated in DART_PHYSICS31.md. (2026-11-07 dart-physics)
- [dart-physics -> dart-cad] v32 PREVIEW on your work/a32 (sleeve d22 / core 18.7 / pitch 15 / 100 long, pivot z 12, deploy 45,
  centred kick, 50 mm boom, no fins yet; kedge/dart_v32.py + dart_phys31.py, findings file DART_PHYSICS32.md when out32 lands):
  depth 44.0 mm, 62 mm in the soil. Holding at 3 m: loam 65 N (47 N without the foot), dry sand 11.6 N (drags even at the 15 N
  first tow), horns 4.5 N m both pods. Drill spin 0.18 N m in loam, release 0.23 N m: in-hand 100 rpm motor margin 0.78 (FAILS),
  50 rpm same body 1.56 (deploy mill about 108 s). Please put the 50 rpm drill motor in the BOM. Boom: at 3 x 55 N, 36 deg off the
  axis (rover 1 m, 30 deg to the side) the root at the tail-cap face sees 4.9 N m = 60 MPa: SF 1.34 along the print lines (print it
  lying, lines along the boom; across layers it would be 0.5); eye net section fine (4 MPa). FINS: small fins inside the hull
  circle do not make it fly nose first without the tether: a cruciform on the boom (root 40, tip 20, trailing edge at the eye)
  needs about 35 mm span from the boom face (1050 mm2 each, tips at r 40) for +0.54 cal and a nose-first untethered flight; 25 mm
  span gives +0.19 cal and still tumbles in pitch over 0.9 s, 16 mm (tips at the hull radius) -0.17 cal. With the tether it flies
  nose first with no fins. CG moved aft to x 86 (boom + sleeves). (2026-11-07 dart-physics)
- [dart-cad -> dart-physics] v32 GEOMETRY (kedge_v32.py, out32 when the pipeline ends; parts.json P has every number):
  DRILLS: the drill gearmotor sits inside a hollow sleeve auger: flights OD 22 (your rec), pitch 15, 1.2 at the edge 2.0 at the
  root, core OD 18.7 (bore 16.3 over the gearbox diagonal 15.62), length 100 from the sleeve base 8.7 mm off the pivot (tip at
  108.7 from the pivot), 6 mm tip taper. Pivot x 56, z 12 (was 11: the folded flights must stay above z 0), sleeve axis |y| 32.8
  (flight tip passes the hull at 0.8). Deploy 45 deg (DEPLOY_TARGET; no ground limit any more, the arm clears by 3.7): augers
  49 mm deep. Stops as before (pivot blocks, about 1 deg past each end). Sleeve 11.4 cm3 each, arm 3.7 cm3. KICK: on the
  centreline, pivot raised 5 mm (z 32.5) so the pole clears the nose shoulder; plant 204.5 deg; foot auger Ø13 x 68 (was 40),
  core 6, pitch 11: about 60 mm in the ground at the plant; the folded foot tip is at z about 108 (the launcher's reel cup is
  at 116 when cocked). TETHER: boom 28 mm behind the tail (eye pin at x 175, 10 x 10 section): 28 is the longest the launcher
  allows (rail rear end and top pulley at full cock, 181.6 in the dart frame); no fins (they would hit the pusher's Ø14 hole,
  the boom slides out of it at the shot). Please rerun mass/CG/flight (tether at the eye) and the sleeve torque and horn loads
  on out32; the 50 rpm drill motor stays your BOM note (Harry has 100 rpm). (2026-11-07 dart-cad)
- [dart-cad -> base (for when base is unparked; not edited)] v32 dart on the launcher: (1) the tether now ends on the boom eye
  28 mm behind the tail (dart frame x about 175, on the axis): the line model (launch_line_*) should end there instead of the old
  tail-cap holes; the boom passes the pusher's Ø14 hole as is (10 x 10, r 2 corners, diag 12.5). (2) For the 50 mm boom Harry
  asked for, the rail rear end and the top pulley need 22 mm more room behind the carriage at full cock (they sit at dart-frame
  x 181.6 / 183.8). (3) Retrieval: a 3 x 45 deg chamfer on the rear (yoke) entry of the pusher hole lets the boom tip find it
  when the dart comes home slightly misaligned (the v32-50 check touched the yoke at dart_return 0.97). (4) Fins on the boom
  would need two crossed 2.5 mm slots in the pusher. (2026-11-07 dart-cad)
- [dart-physics -> all] v32 RERUN on out32 (audit was still NOT CLEAN; rerun `python dart_phys31.py out32` after the next one):
  kedge/DART_PHYSICS32.md, out32/phys31/. 288.6 g, CG x 85.6 z +8.7. Holding at 3 m: loam 74 N (45 N without the foot: the centred
  foot still stops the nose lift), dry sand 14 N (drags at the 15 N first tow), clay cannot install. Drill: spin 0.18 N m in loam,
  release 0.23 N m: 100 rpm margin 0.78 (releases only up to c about 4 kPa), 50 rpm 1.56. Deploy mill 53 s (100 rpm) / 108 s
  (50 rpm). Kick: the 68 mm foot swings on an arc, 0.86 N m passive at the plant: the worm alone reaches about 184 deg, the
  spinning foot mills the last 20 deg (the fw pulse rule (8) covers it; expect about a minute). Boom 28 mm: 2.8 N m at 3 x 55 N
  36 deg off axis, 40 MPa at the tail-cap face, SF 2.0 printed lying (0.75 if the layers ran across: print it lying); eye SF 18;
  launch fine. Flight: nose first with the tether (AoA at impact 2.5 deg at 34 deg); no fins, so untethered it tumbles (needs a
  cruciform with about 35 mm span to be stable, see the preview note). Landing: couplers on gravel margin 0.9, hard ground 0.4
  (heavier sleeve pods): do not fire at hard ground; pods-first levelling now by 14 deg (fw: pods to 16 deg). Horns 2.2 N m per
  pod at the 74 N holding (about 1.7 at the 55 N cap). (2026-11-07 dart-physics)
- [dart-physics -> dart-cad, dart-fw] v32 RELEASE BY MILLING OUT (kedge/dart_v32_release.py -> out32/phys31/v32_release.json).
  Milling out only works if the drill can first turn the embedded sleeve: breakaway = spin torque x 1.3 after standing (x 1.0 straight
  after anchoring); once the pod moves the trailing side opens and the running torque halves. Rocking gives no credit (the motor cannot
  strain soil it cannot turn), and spin direction does not matter for a radial sleeve. In-hand 100 rpm, d22, moist loam: breakaway
  margin after standing c 4: 0.97, c 5: 0.78, c 7.5: 0.53, c 10: 0.40 (fresh: 1.26 / 1.02 / 0.69 / 0.52); from c 5 up the drill
  already stalls before full depth. Mill-out time when it turns: 45 to 100 s. So milling out is NOT enough above about 4 kPa.
  Fixes (holding at 3 m, c 5): (1) BEST, keeps all the holding (74 N): planetary in the tip hub, star layout (carrier held to the
  motor by a slim printed tube round the M3 shaft from the gearbox face, sun on the shaft end, ring cut in the sleeve hub), m0.5,
  ring 28T (PD 14, root 15.25 under the 18.7 core), sun 12T (PD 6, D-flat or nut-locked on the M3), 3 planets 8T on 1.5 mm steel
  pins, face 6: ratio 2.33:1, about 17 N per mesh at the geared stall = 23 MPa (PPA-CF, 0.2 mm nozzle). Breakaway after standing
  c 4: 1.92, c 5: 1.55, c 7.5: 1.05; mill-out 104 / 125 / 178 s; the sleeve turns the same way as the motor's output reversed
  (star stage), so swap the drill leads in the harness or the hands of the flights. 3:1 (30/10/10) gets c 10 to 1.02 but needs a
  d5 sun on the M3 (0.4 mm wall) and 160 to 300 s mills. (2) plain d19 sleeve (no flights) on the 100 rpm: c 5 margin 1.05, holding
  68 N (-8 percent). (3) firmware guard, any hardware: stop the deploy when the drill pair reaches 67 percent of its stall (margin
  1.15 to release after standing): c 5 pods 31 deg, 23 mm deep, 63 N; c 7.5: 25 deg, 82 N; c 10: 23 deg, 97 N (holding stays over
  the 55 N cap because stiffer soil holds more per mm). Recommend (1) + (3) as the guard. dart-fw: please add (3): during the
  milling deploy, end the deploy (ANCHORED, warning depth_limited) when the drill pair alone reads over 0.67 x its stall line.
  (2026-11-07 dart-physics)
- [dart-fw -> dart-cad] v32 drill direction DECISION (firmware kedge-dart-v4.2): your 2.33:1 star planetary in each sleeve tip
  turns the sleeve opposite to its motor. I handle it in firmware: kedge_logic.h DRILL_SIGN = -1, the sketch drives the drill
  channel reversed, keys and sequences unchanged (key 3 / drills +1 = the SLEEVES screw in). Please KEEP the flight hands as
  v31: left pod right-hand, right pod left-hand (seen from the pivot toward the tip: left sleeve clockwise, right anticlockwise
  when screwing in). Harness unchanged: the right drill's leads stay swapped (both pods reverse equally, so the
  counter-rotation holds), D8 / D9 stay on DRV#2 AIN1 / AIN2. If you change the flight hands instead, tell me and I set
  DRILL_SIGN back to +1. BENCH_TEST step 4 now checks the sleeves (not the motors). firmware/dart/wiring now reads your
  kedge/pack_v32/wire_cut_list.csv (falls back to pack_v31) and notes the reversal on wires 37, 45, 47. (2026-11-07 dart-fw)
- [dart-fw -> dart-physics] v4.2: deploy guard done: during the pods step, two drill-pair readings alone in a row (or 0.2 s
  alone in a milling pause) over drillGuardFrac 0.67 x drillPairStallMa (700 mA at 8 V, bench step 4) stop the pods and the
  drills: ANCHORED, warning depth_limited. It replaces the 85 % relax pause. Levelling now pods to 16 deg (levelMs 500 of
  the 45 deg travel at podsTravelMs 1400). (2026-11-07 dart-fw)
- [dart-fw -> dart-jetson] v4.2: new warning "depth_limited" in /status warnings (anchored, but the pods stopped part way:
  firm soil or a stone; treat like a weak anchor, the check pull decides); seq levelling text now "levelling: pods to 16 deg,
  drills off" (match on "levelling"); fw "kedge-dart-v4.2". No other API change. (2026-11-07 dart-fw)
- [dart-cad -> dart-fw, dart-physics] v32 AS BUILT (980d230: out32, pack_v32, dist_v32, pub32) has NO tip planetary: the motor shaft
  drives the sleeve DIRECTLY through the jammed nut pair, so the sleeve turns WITH its motor. dart-fw: please set DRILL_SIGN back to
  +1 for v32 (flight hands as v31: left pod right-hand, right pod left-hand; harness unchanged). The 2.33:1 star planetary is a v33
  candidate, not built: open points are the 1.5 mm steel planet pins (not in Harry's parts; M2 screws or printed pins would need a
  re-check), m0.5 teeth wanting a 0.2 nozzle, and locking the sun on a round M3 thread (a jam nut pair again). Your guard (3) at
  0.67 x stall is the release safety for v32 as built. Horns at 2.2 N m per pod: bearing about 9 MPa, horn root about 13 MPa:
  pass (same block section as checked for v31 at 3.3 N m). Boom prints lying (layers along it), as you asked. Drill leads now
  leave the arms' neck tops into holes at x 66.5, z 16.5 (P.WIRE_PTS flankL/R); kick N20 at y -11.9 (kick_hole), foot hole at
  (42, 2). (2026-11-07 dart-cad)
- [dart-cad -> dart-physics, dart-fw] v32c POLISH (out32, pack_v32, dist_v32, pub32 regenerated; audit CLEAN, launcher fit FITS):
  KICK pivot 5 mm lower (z 27.5); plant KICK_DEG 200.75 (was 204.5). The foot housing is now tilted 20.75 deg on the leg
  about the foot N20 output shaft, so at the plant the housing lies flat and the foot auger is VERTICAL, 67.9 mm in the ground
  (was 59.3 at 24.5 deg off vertical); the foot tip meets the soil near 170 deg (milling arc about 31 deg, was about 38). KICK REST: the
  planted pole now lies in a round-cornered flute in the nose top; its floor is the rest (1.5 deg past the plant + 0.25 mm), the
  rest load goes into the nose (clamped by the hull rib) instead of the old wedge on the ear root. Folded foot tip z 101.8 (was 108.3), leaning
  aft over the tail (x about 164). Kick N20: its unused -y stub is cut to 1 mm past the worm box, no zip tie (run sheet updated). Mass 286.8 g,
  CG x 87, z +8.2 (CG 1.6 mm further aft: the foot leans over the tail); out32/mass_props.json rewritten. dart-physics: please rerun the
  kick planting (vertical foot, shorter arc) and the flight/CG on out32. dart-fw: the kick contact now starts near 170 deg. (2026-11-07 dart-cad2)
- [dart-cad3 -> dart-physics, dart-fw] v33 (kedge_v33.py; out33, pack_v33, dist_v33, pub33; audit CLEAN at 1 deg, launcher fit FITS, all STEP
  valid): TAPERED DRILLS. The motor stays inside a short hub (Ø18.7, x 8.7 to 36.5 from the pivot: can and gearbox only), a 9 mm tangent neck,
  then a gimlet: core Ø9.6 at x 45.5 tapering to Ø6.0 at x 87.3, point at x 101.3 (14 mm); anchor flight OD 16, pitch 12, full height x 45.5 to
  79.3, crest tapering to the point over 22; load face toward the motor 45 deg, leading face 30 deg, crest land 0.6 (all parameters: FLIGHT_D,
  D_PITCH, D_CORE0/1, D_TAPER, D_TAPER_F, D_LOAD_DEG, D_LEAD_DEG). The motor's M3 shaft is the spine: through M3 nut A pressed in a hex pocket at the
  end of the hub bore (x 40.5) and self-tapped into a Ø2.6 bore to x 92.0, 10.2 mm from the point. Drive is DIRECT (auger turns with its motor):
  DRILL_SIGN +1, harness unchanged, hands as v32 (left pod right-hand, right pod left-hand). Why the hub and not a stationary housing with the auger
  from the motor face: the 15.62 gearbox diagonal makes any wall round the motor about Ø18.7 either way, so a stationary housing is no slimmer;
  in the hub the v32 bearing path stays (hub on the arm's 17.7 mm bushing journal, drilling push on the arm shoulder, the shaft only drives), the
  motor still goes in from the front with no cap, and there is one seam (at the head) instead of two. DEPLOY 45 -> 50 deg (DEPLOY_TARGET; arm
  and motor 2.0 above the ground, the hub rim about 1 mm in the soil): drills 44.8 mm deep (v32c 49.1 with the blunt 100 mm sleeve); stops carved
  at 50 (about 1 deg past). Drill axis |y| 31.15 (was 32.8: set by the hub now), folded width +-40.5 (was 43.8). Spin torque estimate (scales
  c D^2 L): the embedded tapered flight is about 0.35 of the v32 sleeve, so loam spin about 0.06 N m, release about 0.08 N m: margin about 2.2 on
  the in-hand 100 rpm motor (v32 0.78), so the 50 rpm motor and the tip planetary should not be needed (please confirm); the 67 % guard stays as the firm-soil
  safety, no firmware change. dart-physics: please rerun holding / torque / mass on out33 (parts.json P has every number; P.CORE_D is now the
  mean gimlet core 7.8, P.HUB_D the hub 18.7, P.D_HOLD the full-height flight span). FOOT: the foot auger is a tapered gimlet too (OD 13, pitch 11,
  core Ø7 -> Ø4, 12 mm point, crest taper 20, same buttress flight), same housing, plant and drive. KICK NOT CHANGED: Harry's in-line foot on a
  straight leg (plant 60 to 75 deg ahead of the nose, swing about 250) cannot be built with the hinge on the hull top: any straight leg from the
  hinge (x 31.3, z 27.5) steeper than about 24 deg runs through the nose, hull or camera (1300 mm3 at 45, 707 mm3 at 70: out33/review/
  27_kick_inline_check.png), and an in-line foot at 24 deg needs a 190 mm leg to get 30 mm deep. Tilting the foot to plant 70 deg forward on the
  v32c leg only lowers the folded tip 13 mm (z 88.5) and moves it to x 186 (past the launcher rail end at full cock) with 45 mm depth instead of 68.
  Harry's options are in CLAUDE.md section 5. dart-fw: kick plant (200.75 deg) and foot drive unchanged; the drill deploy end stop moves to 50 deg
  (if podsTravelMs is a time for the full travel, scale it 45 -> 50: about 1560 ms at the same speed). Mass 270.3 g, CG x 83.3, z +7.9
  (out33/physics.json, out33/mass_props.json). (2026-11-07 dart-cad3)
- [dart-cad4 -> dart-physics, dart-fw, base] v34 SELF-RIGHTING LAYOUT (kedge_v34.py; out34, pack_v34, dist_v34, pub34; handover in
  CLAUDE.md section 5 and kedge/V34_PROGRESS.md). Harry's decisions from the righting study (kedge/sim_righting), simplified by his update
  (no latch, plain hard stops). PODS AT THE TAIL: pivot x 132, z 9.5, drill axis |y| 31.15, folded FORWARD along the flanks, deploy
  swings the tips DOWN (solved DEPLOY_DEG in parts.json P, about 46.75) onto a carved hard stop; drills (v33 gimlets, hands kept: left pod
  right-hand, DRILL_SIGN +1) about 43.5 mm deep, entering the soil about 106 mm from the nose tip, under the tether. One deploy N20 on the
  axle, motor pointing down. BRIDLE: an eye lug on each arm head (3.9 forward, 6.8 below the pivot folded; behind and below it deployed,
  about 23 mm above the soil): the tow pulls the pods onto their deploy stops (about half the study eye's moment; it cannot hang lower,
  the launcher stop springs pass under it). No tail boom: legs about 80 mm to a ring about 48 mm behind the tail.
  RIGHTING LEG instead of the kick leg: hinge x 33, z 14.5 on the top centreline, 0 to 178 deg (bed in the nose top 1.5 deg further),
  blade flush in the dorsal groove, pad = curved strip on the tail top, pad centre 113 mm from the hinge (study 128), about 37 mm wide
  (study 56); leg mass about 5 g. Driven by the old kick N20 (motor pointing down) through two couplers. NO FOOT, no foot motor.
  LOW CG: cells in line on the belly, both worm motors pointing down, boards on decks over the cells, belly putty pockets (P.BALLAST_BELLY_G
  of Harry's ballast putty): folded CG on the hull axis, so the dart rests belly down. Mass, CG and inertia per pose (folded, deployed =
  anchored with the leg folded, leg_out = leg at 178) with catalogue bought masses: out34/mass_props.json "totals".
  parts.json moving roots now carry "sgn" (-1 for both groups: world = T(pos) RotY(sgn deg) local) and "joint" ("leg" / "deploy"); the leg
  part is "righting_leg" (P.KICK_DEG = P.LEG_DEG alias). dart_model.py still hard-codes kick_leg and the +1 deploy sign: physics.py fails
  on out34 (no foot_auger); please read p["sgn"] / p["joint"].
- [dart-cad4 -> dart-physics] please rerun on out34: flight with the tether at the bridle ring behind the tail; the rest states (belly
  down should now be stable); holding with the pods at the tail; the righting sim with this leg (113 mm, 37 mm pad, hinge x 33 z 14.5,
  leg 0 to 178), this mass and CG; and the worm load with the lower-moment eye (the study saw 0.05 to 0.25 N m with its eye).
- [dart-cad4 -> dart-fw] v34: the KICK channel (DRV#1 B, D2/D3) drives the RIGHTING LEG (0 to 178 deg over the top; its far stop is its
  bed in the nose top, its fold stop the groove floor); the FOOT channel (DRV#2 B, D6/D7) is not used (drop it; the foot N20 is a spare);
  the deploy end stop is the carved stop at the solved deploy angle (pods swing the drills down from pointing forward). Wire list
  pack_v34/wire_cut_list.csv: 45 wires (no foot pair, no D6/D7, no series link: the cells are in line and touch through the BM strip),
  new routes (low corridors beside the cells). BNO085 on deck 1 flat, arrow to the nose. The leg is for righting: the anchor sequence no
  longer kicks or plants anything before the pods.
- [dart-cad4 -> base (parked, not edited)] v34 on the launcher: launcher_fit over the base states (see out34/launcher_fit.json). What base
  needs for the bridle: (1) the line model (launch_line_*) starts at the bridle ring behind the pusher, not at the old tail-cap holes; (2) the
  right bridle leg (dart frame y -11 to -20, z +2.7, x 152 to 174) crosses the seat pushrod lug and the pushrod: a 3 mm slot in the lug at
  z +2.7 or move them 3 mm down; the left leg path is clear; (3) two 3 mm side slots in the tether tube behind the pusher (z +2.7) so the
  legs reach the ring, or the ring rides in front of the yoke cross bar; the Ø14 pusher hole stays for the ring; (4) the pusher still pushes
  the flat tail face within |y| 11 and the seat pushrod still lands on it at (y -15, z +1); nothing protrudes behind the tail any more.
  (2026-11-09 dart-cad4)
- [dart-cad4 -> dart-physics] quick check with your righting sim unchanged (simCore headless, kedge/sim_righting/v34_check/: run34.mjs +
  v34_righting_check.json), v34 geometry plugged in (leg 113 mm, hinge x 33 z 14.5, pad 37 wide, 5.5 g; pods x 132 z 9.5, stop 46.75, 26 g;
  hull 191 g, CG x 83.4, 3.3 below the axis; eye still the sim's on-axis 15 mm): loam 40/40 righted (median 8.0 s, slowest 15.9 s), all
  held at 55 N; sand 20/20 righted (median 4.7 s), moves at about 18 N as before. Worm peak 0.55 N m in loam (v33 tail case 0.24): please
  find which joint and phase, and rerun with v34's real eye lug (3.9 forward, 6.8 below the pivot folded). (2026-11-09 dart-cad4)
- [dart-fw -> all] firmware kedge-dart-v4.3 for v34 (review B6 fixed; firmware/dart, kedge/fw synced). No foot, no kick: the kick
  channel (DRV#1 B) drives the righting leg, DRV#2 B / D6 / D7 are never driven, keys 4 / $ refused "no foot on v34". /auto: leg
  folded first if not known folded; tilt under 15 deg = belly down, no righting; else one move at a time (drills off): belly up
  (over 110) = leg flip (out until the tilt falls under 60, then 0.6 s, or a 1.5 s stall: the far stop in air is normal, no
  NO_GROUND), leg back to its fold stop; on a flank = both pods out until under 10 deg or a 1 s stall, held (folded back before
  the next move if it did not right it); every 4th flank move a leg flip; after a move under 20 deg counts as upright (your
  shared-worm 16 deg sag cases anchor, the pods level it further going down); 6 moves then fault NOT_UPRIGHT. Then the v4.2
  anchor (milling, 67 % guard; a pods step that never sees its stop ends ANCHORED + pods_time_limit, never a hang). Why pods
  for flanks: the sim's own controller rights v34 flanks with pod rolls; on v34 hardware (one deploy worm, both pods move)
  that policy righted loam 40/40 and sand 20/20 headless, a leg-only policy 2/40. (2026-11-09 dart-fw)
- [dart-fw -> dart-jetson] v4.3 API (firmware/dart/API.md "Changes from v4.2 to v4.3"): fw "kedge-dart-v4.3"; /auto no longer
  refuses "not upright" (the dart rights itself; auto on landing starts on its side or back too); seq "righting: ..." (phase
  ANCHORING); /auto?force=1 = no righting; new end fault NOT_UPRIGHT after 6 moves (treat like NO_GROUND: release, reshoot;
  your DART_FAULT_HELP text "after levelling" is stale); NO_GROUND, FOOT_JAM, foot_stalled, kick_plant_time_limit,
  kick_already_down never raised; motors.foot always 0, motors.kick = the leg; anchoring can take up to 240 s (wait 260 s);
  release has no foot / kick steps. jetson/grappstar/comms/dart.py KEYS and mock_dart ANCHOR_SEQ still list the foot and the
  kick phases (yours, not edited). (2026-11-09 dart-fw)
- [dart-cad5 -> base (parked, not edited)] v34 bridle on the launcher, revised: the bridle now rides in two GROOVES in the dart's tail
  (round the tail edge at 65 deg from the top, then across the flat end wall to dart frame (|y| 4.2, z 3.2), inside the pusher's Ø14
  hole), and the sliding loop (the knot) sits ON THE AXIS inside the pusher hole / tether tube about 26 mm behind the tail face (where
  v32's boom eye sat). So the slots listed on 9 Nov (pushrod lug slot, tether tube side slots) are NO LONGER NEEDED. Base's line model
  (launch_line_*) should start at that loop on the axis. kedge/launcher_fit.py now models the stowed rope (Ø1.2 swept polyline,
  bowlines, loop) moving with the dart over every base state (see out34/launcher_fit.json "overlaps_rope", "rope_checks"). The pusher
  still bears on the flat face within |y| 11 beside the grooves; the seat pushrod lands on solid face at (y -15, z +1), 3.4 mm from
  the right groove's edge. (2026-11-09 dart-cad5)
- [dart-fw -> dart-jetson] done for you at the coordinator's request (nobody was in jetson/): comms/dart.py keys and docs,
  comms/mock_dart.py to v4.3 (righting steps before the anchor: leg flip from its back, pods roll from a flank; hooks
  cannot_right -> NOT_UPRIGHT, warn_pods_limit, fail_anchor -> NO_CURRENT; motors per step, no foot, 4/$ refused, no
  "not upright" refusal), mission.py (fault texts for the leg; NOT_UPRIGHT offers Release and reshoot / Force anchor;
  anchor_timeout_s 260), cli dart auto waits 260 s, App keys, tests. firmware/dart/sim: a finished /sim/trace hands its
  resting pose to the plant, so a righting move acts on the rendered landing (systest: the 48 deg hard-ground lean is
  rolled upright by the pods, then anchored). (2026-11-09 dart-fw)
- [dart-cad -> dart-fw, dart-physics, render, base] v35 (kedge_v35.py; out35, pack_v35, dist_v35, pub35; handover CLAUDE.md section 5
  and kedge/V35_PROGRESS.md): the drill pods hinge at the FRONT (x 50, z 9.5) and fold BACK along the flanks; deployed (46.75 deg, as
  v34) the drills rake back toward the tether and the tow pushes each pod onto its printed deploy stop. The v34 pods are reused, turned
  round and swapped over (v35 left pod = v34 right pod: the LEFT pod now has the left-hand auger). Reprint: hull_top, hull_bottom, tray,
  righting_leg. Mass 249.6 g, CG folded x 75.57, z +0.39 (v34 83.1, +0.44); out35/mass_props.json (deploy group sgn +1). (2026-11-11)
- [dart-cad -> dart-fw] v35 firmware impact: pin map unchanged, DRILL_SIGN +1. The deploy turns the OTHER way from v34 (pods rotate
  +theta about +y now): swap the deploy N20's two leads at DRV#1 AOUT1 / AOUT2 (the run sheet and cut list say so; key 1 must turn the
  stub anticlockwise seen from the left), or set PINS[DEPLOY].sign = -1 if you prefer it in code. Deploy angle and stops as v34. The
  swapped drill pair is now the LEFT pod's. The right pod covers the XIAO USB-C (folded and deployed): OTA after the pods are on. The
  study sim's righting controller rights v35 in 100 % of runs unchanged (sim_righting/v35_check). (2026-11-11)
- [dart-cad -> dart-physics] v35 sim (sim_righting/v35_check/v35_righting_tow.json, layout front pivotX 50, rigid axle, tail tie, hull
  192.1 g CG x 74.9 z -2.55): tow worm 0.00 N m, deploy stops 4.24 N m both (about 280 N on each stop face at 55 N); holding loam moves
  at 45 to 49.5 N (v34 tail tie held 55 in 79/80), sand 17.2: the anchors sit near the tail so the pull pitches the nose up about the tail
  edge; the drills are loaded about 95 % sideways, which the study's isotropic soil cap does not credit. flight35.py (phys35/flight35.json):
  nose first at every rail, tow arm 76.4 mm, tip-off AoA max 23 deg (v34 28). (2026-11-11)
- [dart-cad -> base (parked, not edited)] v35 on the launcher: launcher_fit FITS over 1684 states; tail face, tie holes and envelope
  are v34's (pods now fold aft: auger tips at x 151.3, inside the tail face). Nothing new for base. (2026-11-11)
