HarryHYu/GrappStar/kedge/DART_PHYSICS32.md

# KEDGE v32 dart physics: findings

Generated by `kedge/dart_phys31.py` on `out32` geometry (2026-11-07 04:27). Base station numbers from
base/spec/params.py 1.5.0 through base/physics. Every assumption is a named constant in dart_model.py, dart_anchor.py,
dart_landing.py or flight_sim.py; measured bench torques (dart_pulltest.py torque) replace them through kedge/bench31.json.

## Key numbers

- Mass 288.6 g (140.7 printed, 0 ballast), CG x 85.6 mm, z +8.7 mm above the axis.
- Launch (34 deg, this mass): 6.78 m/s, peak 17.6 g over 59.3 ms, tail push 60.4 N, line pull in the stroke 8.28 N, above 4 g for 56 ms (launch detector fine). Muzzle speed spread about 0.96 percent sigma.
- Flight (tether on, 0.25 N brake): nose first at every pitch; 34 deg: 4.41 m, 0.871 s, impact 6.47 m/s at 45.5 deg down, angle of attack at impact 2.5 deg (5 deg + 1 rad/s disturbance). Without the tether it tumbles with or without ballast: aerodynamic centre x 59.6 is ahead of the CG (-0.62 cal).
- Impact at 34 deg (nose, rigid-body upper bound at the CG): soft soil 120 g (4.9 mm nose dig), grass 92 g, gravel 448 g, hard ground 951 g. The BNO085 clips at 8 g in every case.
- At rest on flat hard ground the folded dart does NOT lie belly down: the CG is 8.7 mm above the axis, so it rolls onto a flank and leans about 36 deg on a pod (random tumble: 46 percent leaning, 28 percent on its side, 20 percent upside down).
- Holding at the dart, rover 3 m (line 7.3 deg): dry sand 13.8 N, moist loam 73.8 N, firm clay 463.6 N (if it could install). Rover 1 m: 14.0 / 74.6 / 463.6 N. Against the 15 N first tow and the 55 N cap: loam holds both, dry sand holds neither.
- Energy: avionics 2.52 W, video about 1.85 h on the 2S 18350 pack (630 mAh usable); anchor sequence about 15.5 mAh in loam, release about 20.1 mAh (5.7 percent of the pack). Energy is not a limit.

## What fails or has no margin, and the fix

1. Drill deploy torque. The augers are radial on the pods, so they sweep sideways through the soil. Sweeping both without spinning needs 0.619 N m in dry sand, 3.788 N m in loam, 25.645 N m in firm clay against the deploy worm's 0.207 N m stall. They only go in as a mill (drills spinning, worm at stall): sand 9 s, loam 53 s, clay never. Fix: milling deploy in firmware (dart-fw: worm pulsed at stall, drills full, deploy stall is not the end stop, time caps). A 3:1 stage would cut the loam time by 3 but does not fit under the bay roof (dart-cad).
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
