HarryHYu/GrappStar/base/out/base/pack/plates/plate_2_PLA.png

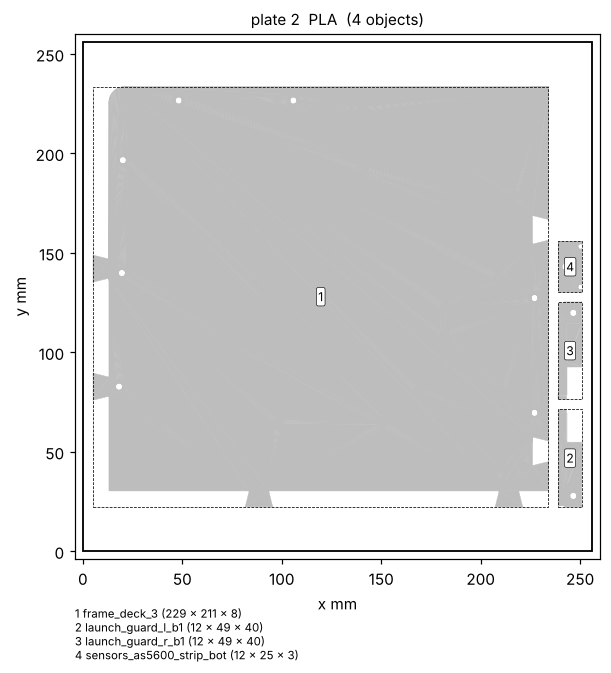
base/out/base/pack/plates/plate_2_PLA.png
