HarryHYu/GrappStar/base/out/base/pack/plates/plate_3_PLA.png

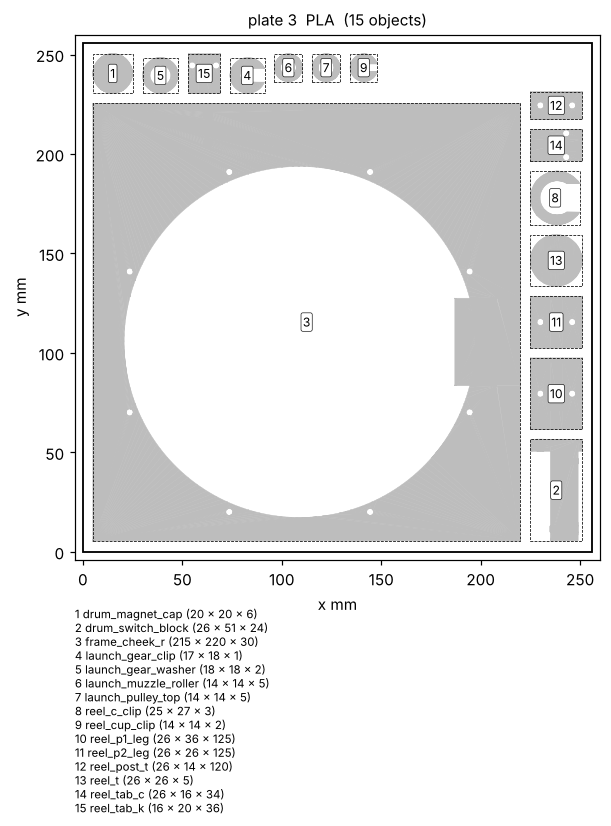
base/out/base/pack/plates/plate_3_PLA.png
