HarryHYu/GrappStar/base/out/base/pack/plates/plate_8_PLA.png

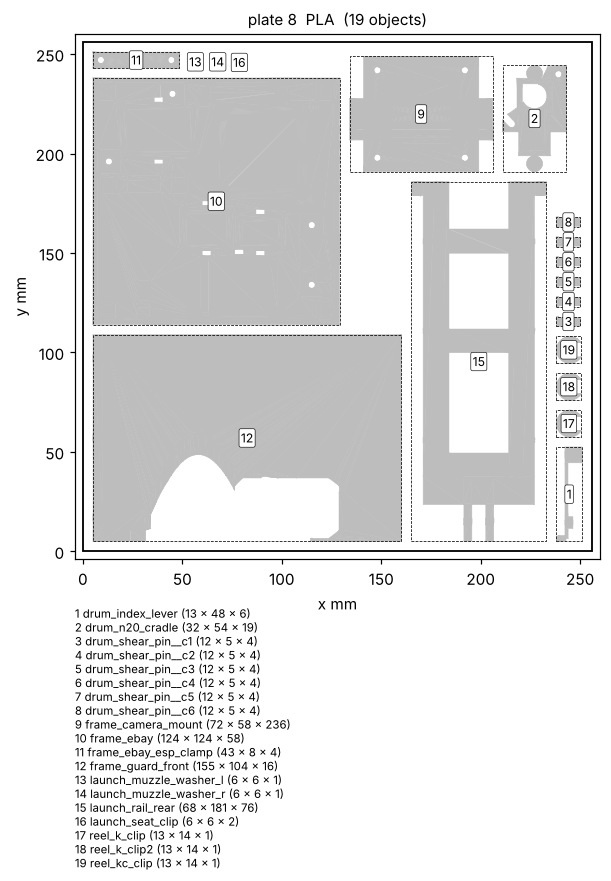
base/out/base/pack/plates/plate_8_PLA.png
