HarryHYu/GrappStar/base/out/base/pack/plates/plate_11_PLA.png

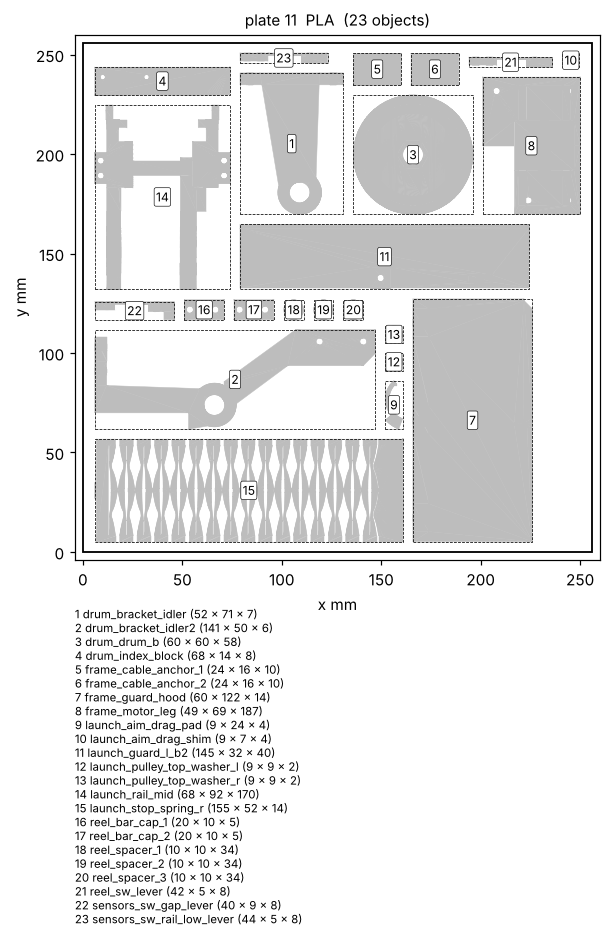
base/out/base/pack/plates/plate_11_PLA.png
