HarryHYu/GrappStar/base/out/base/pack/plates/plate_12_PLA.png

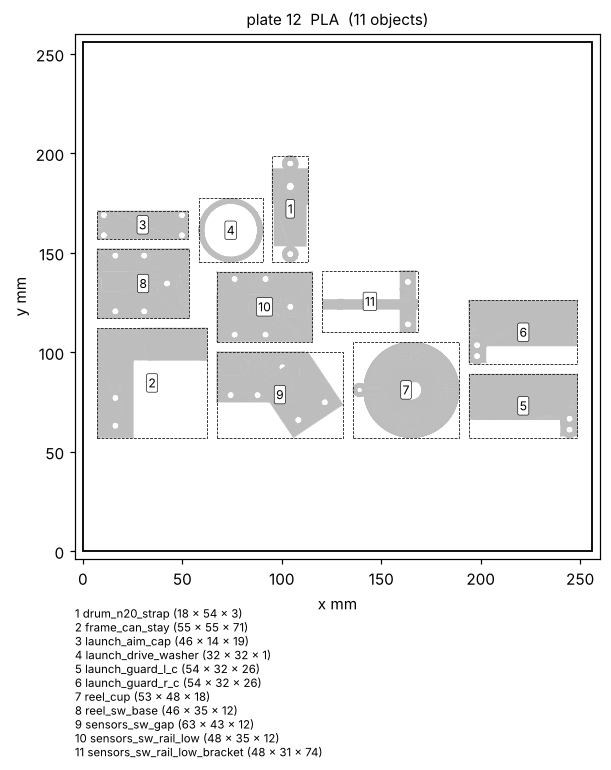
base/out/base/pack/plates/plate_12_PLA.png
