HarryHYu/GrappStar/base/out/base/pack/plates/plate_17_PPA-CF.png

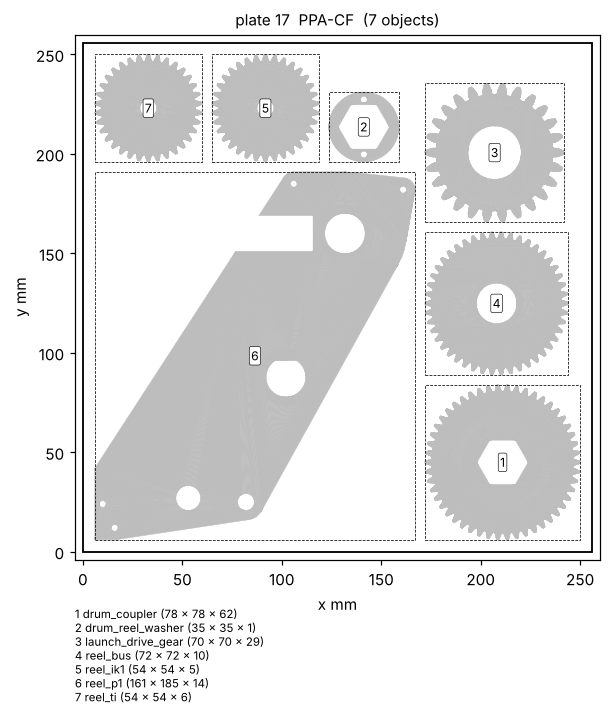
base/out/base/pack/plates/plate_17_PPA-CF.png
