HarryHYu/GrappStar/base/out/base/pack/plates/plate_20_PPA-CF.png

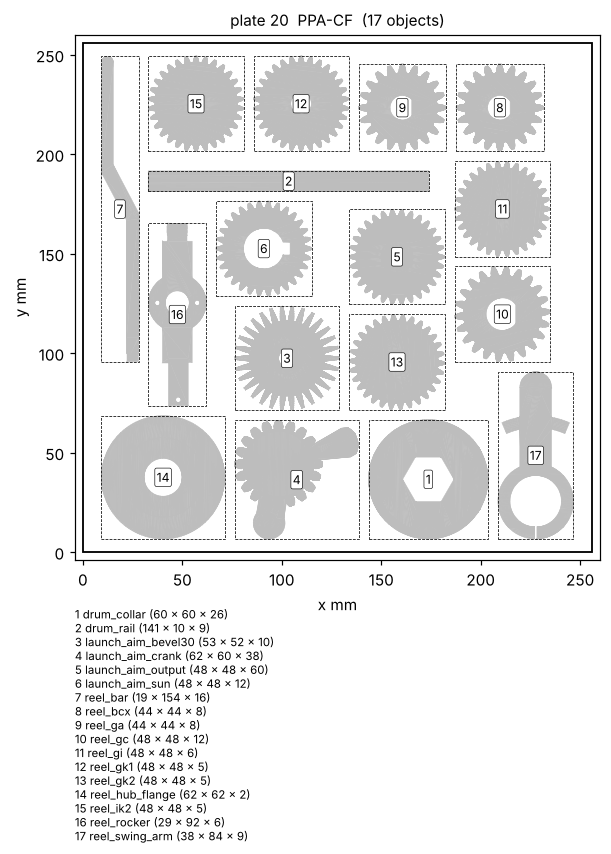
base/out/base/pack/plates/plate_20_PPA-CF.png
