HarryHYu/GrappStar/base/out/base/pack/plates/plate_21_PPA-CF.png

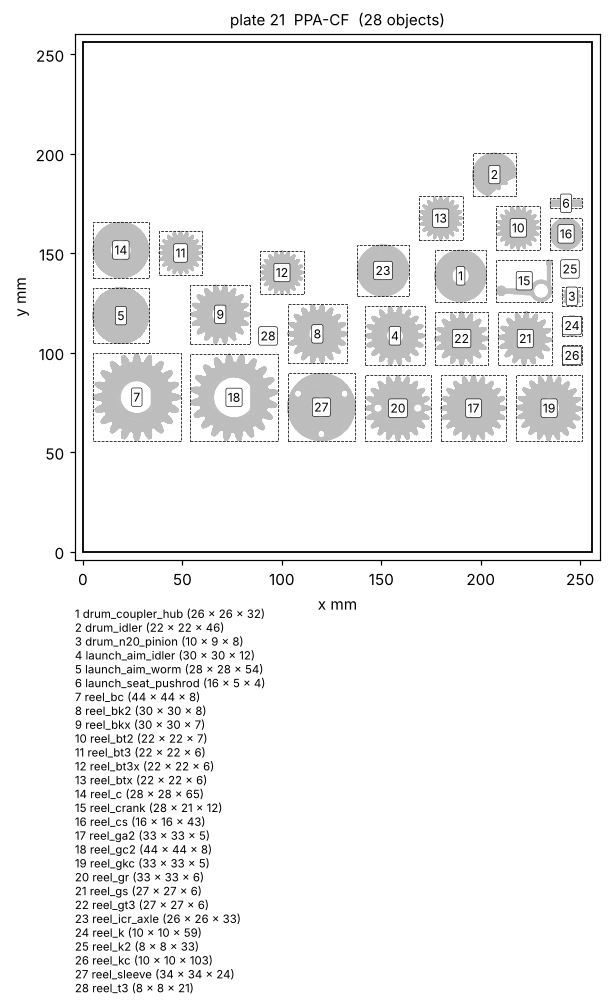
base/out/base/pack/plates/plate_21_PPA-CF.png
