HarryHYu/GrappStar/base/out/base/sections.png

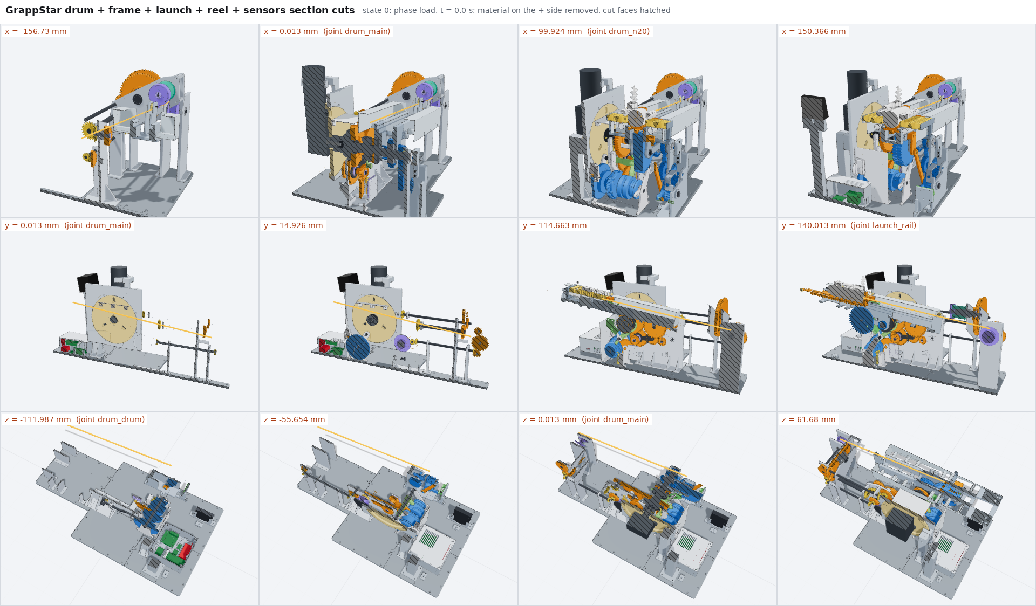
base/out/base/sections.png
