HarryHYu/GrappStar/base/out/base/shots/mech_launcher.png

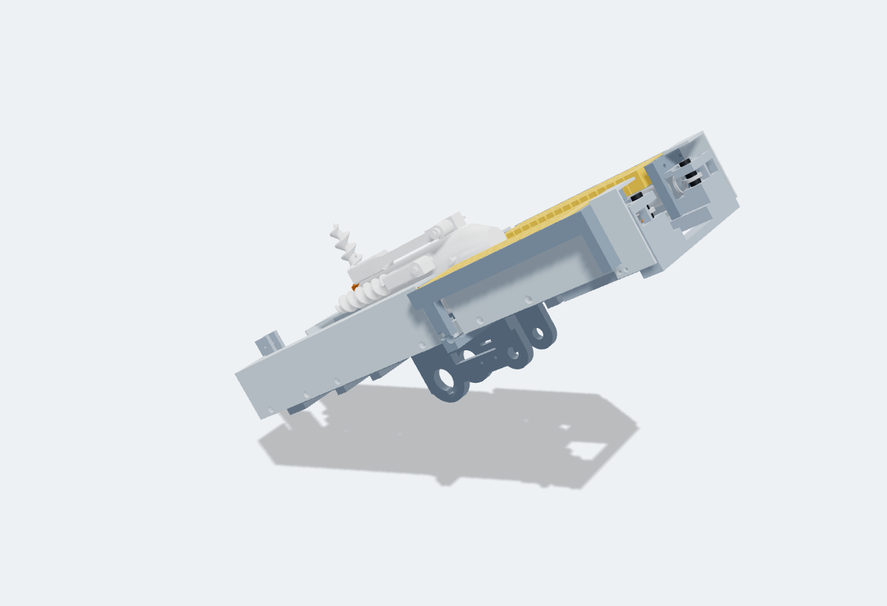
base/out/base/shots/mech_launcher.png
