HarryHYu/GrappStar/base/out/base/shots/mech_power.png

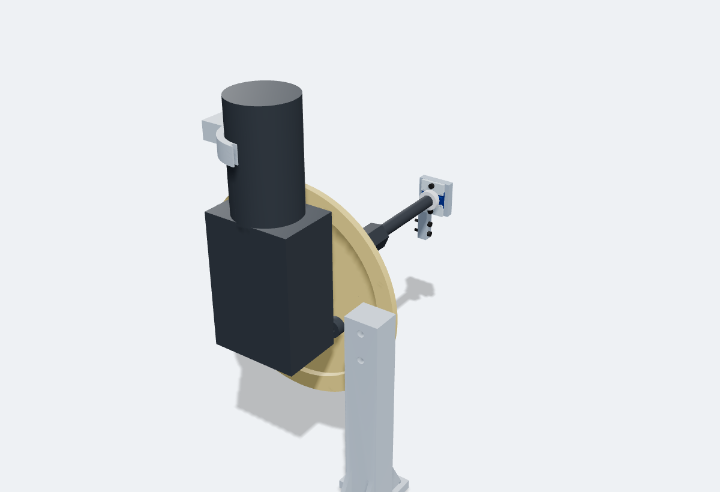
base/out/base/shots/mech_power.png
