HarryHYu/GrappStar/base/out/base/shots/mech_wrap.png

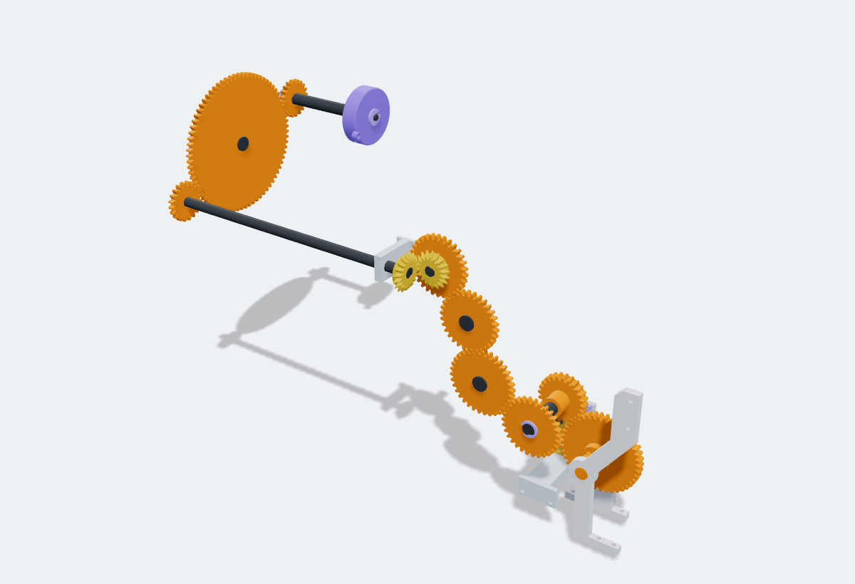
base/out/base/shots/mech_wrap.png
