HarryHYu/GrappStar/base/out/base/shots/sim_follow_dart.png

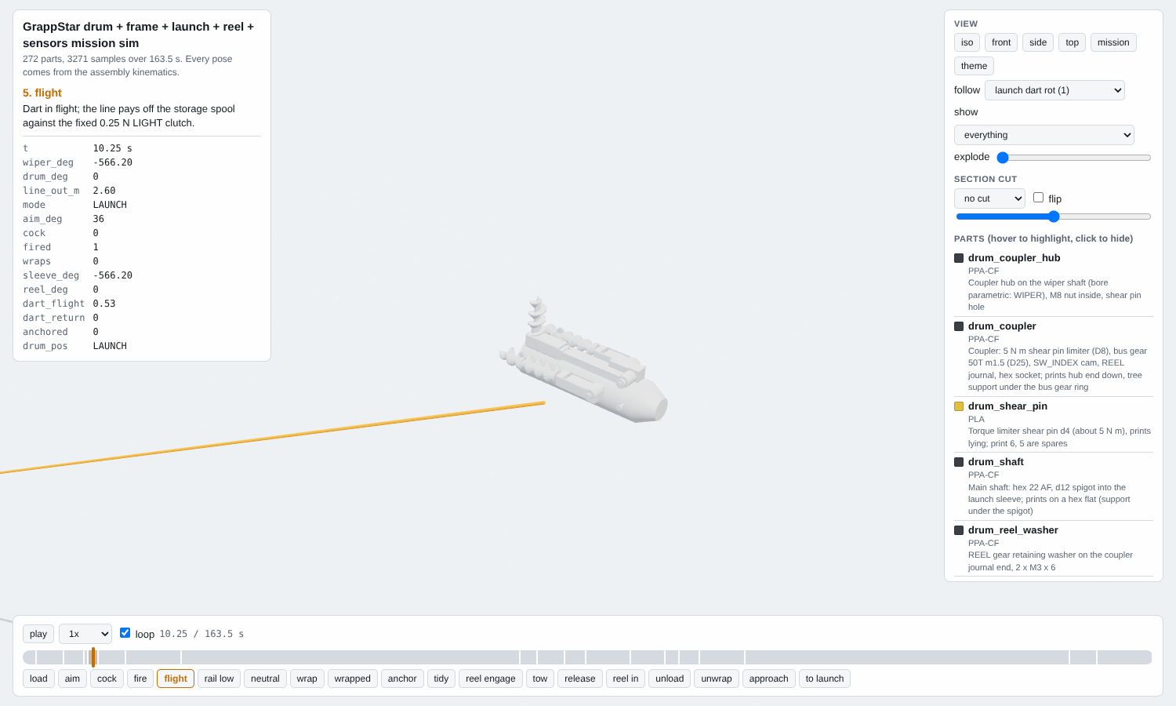
base/out/base/shots/sim_follow_dart.png
