HarryHYu/GrappStar/base/out/base/shots/sim_hero.png

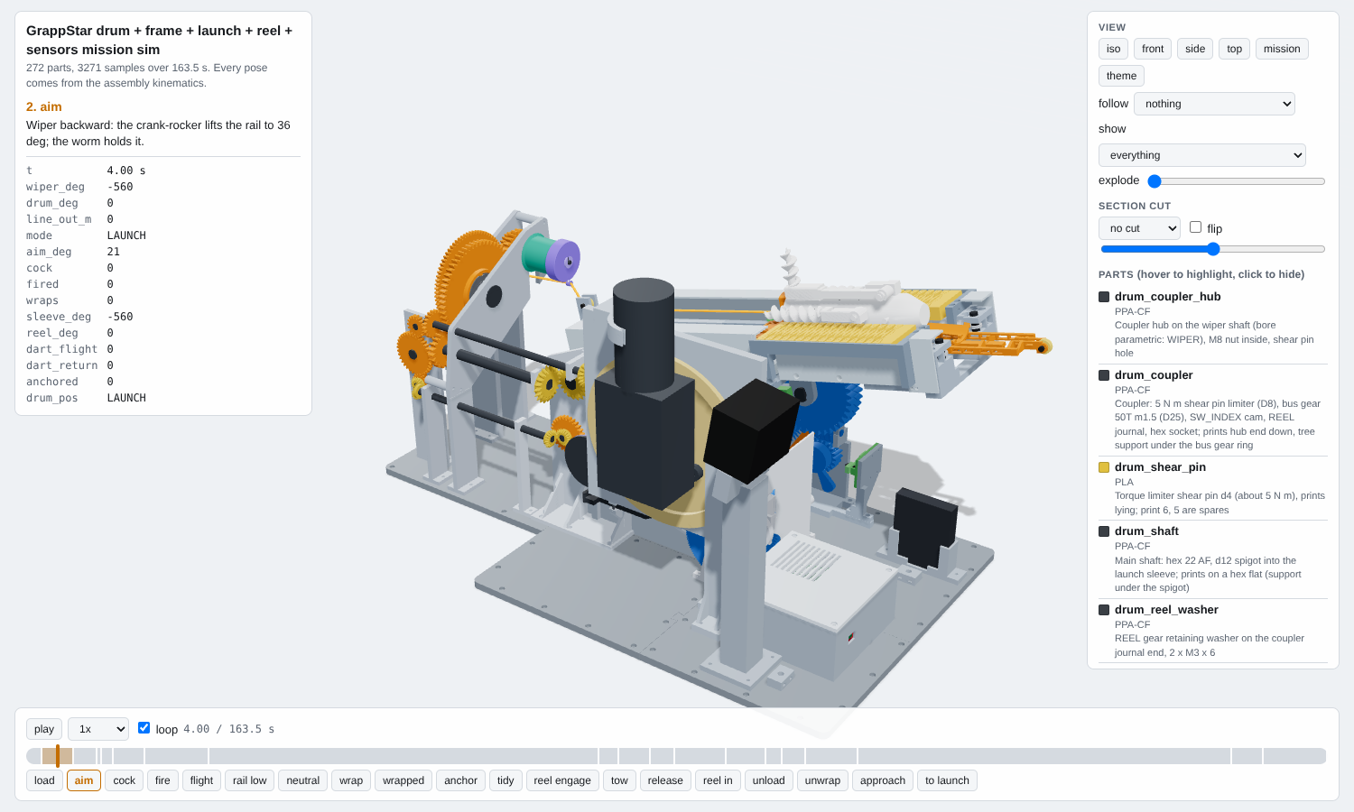
base/out/base/shots/sim_hero.png
