HarryHYu/GrappStar/base/out/base/views/section_01_x.png

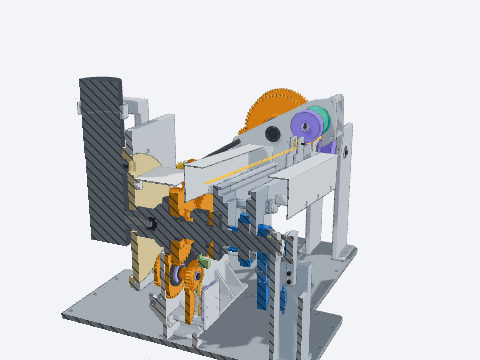
base/out/base/views/section_01_x.png
