HarryHYu/GrappStar/base/out/base/views/section_04_y.png

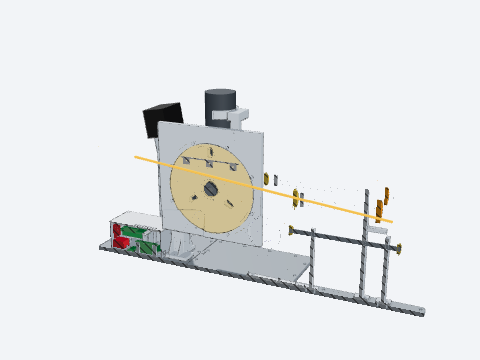
base/out/base/views/section_04_y.png
