HarryHYu/GrappStar/base/out/base/views/section_05_y.png

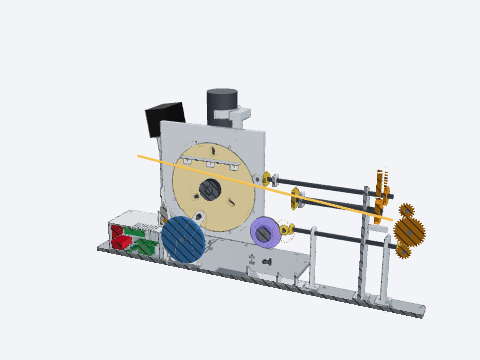
base/out/base/views/section_05_y.png
