HarryHYu/GrappStar/base/out/base/views/section_07_y.png

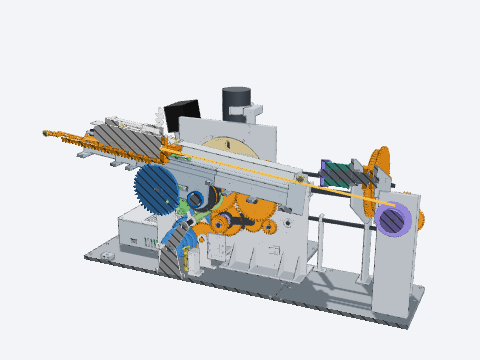
base/out/base/views/section_07_y.png
