HarryHYu/GrappStar/base/out/base/views/section_08_z.png

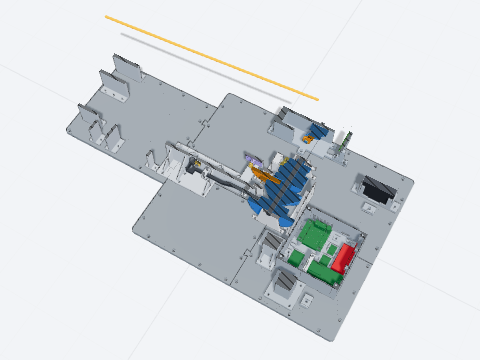
base/out/base/views/section_08_z.png
