HarryHYu/GrappStar/base/out/base/views/section_11_z.png

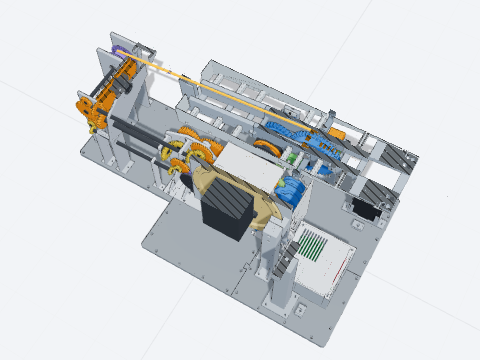
base/out/base/views/section_11_z.png
