HarryHYu/GrappStar/base/out/base/views/view_az000_el+60.png

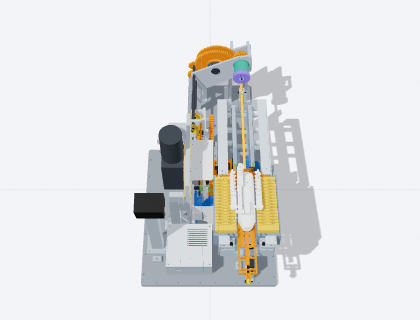
base/out/base/views/view_az000_el+60.png
