HarryHYu/GrappStar/base/out/base/views/view_az135_el+60.png

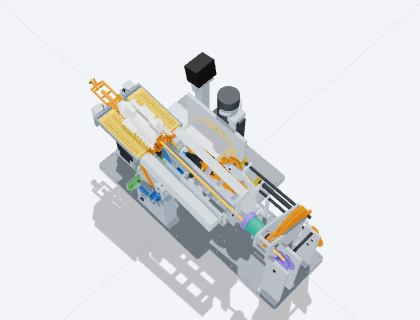
base/out/base/views/view_az135_el+60.png
