HarryHYu/GrappStar/base/out/base/views/view_az180_el-20.png

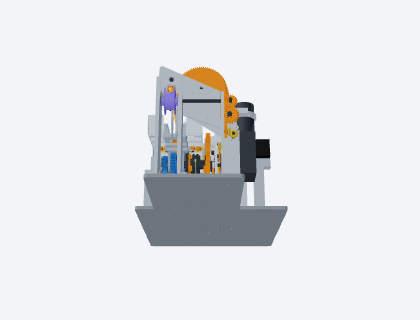
base/out/base/views/view_az180_el-20.png
