HarryHYu/GrappStar/base/out/base/views/view_az270_el+25.png

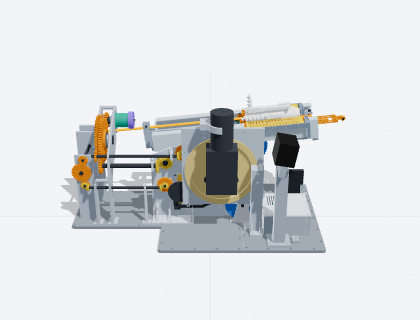
base/out/base/views/view_az270_el+25.png
