HarryHYu/GrappStar/base/out/base/views/view_az315_el+60.png

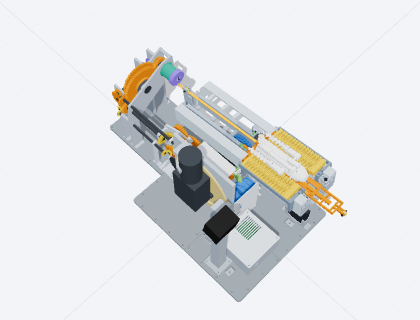
base/out/base/views/view_az315_el+60.png
