HarryHYu/GrappStar/base/out/display/plates/plate_3_PLA.png

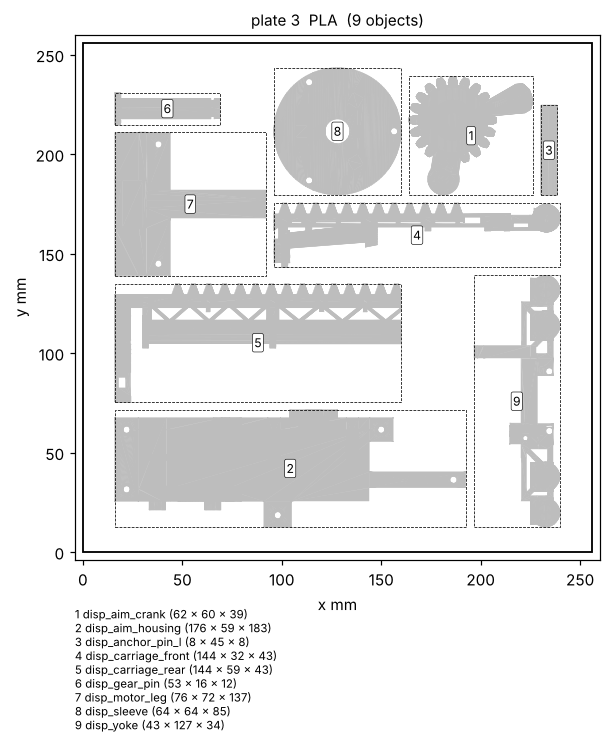
base/out/display/plates/plate_3_PLA.png
