HarryHYu/GrappStar/base/out/display/plates/plate_4_optional_PLA.png

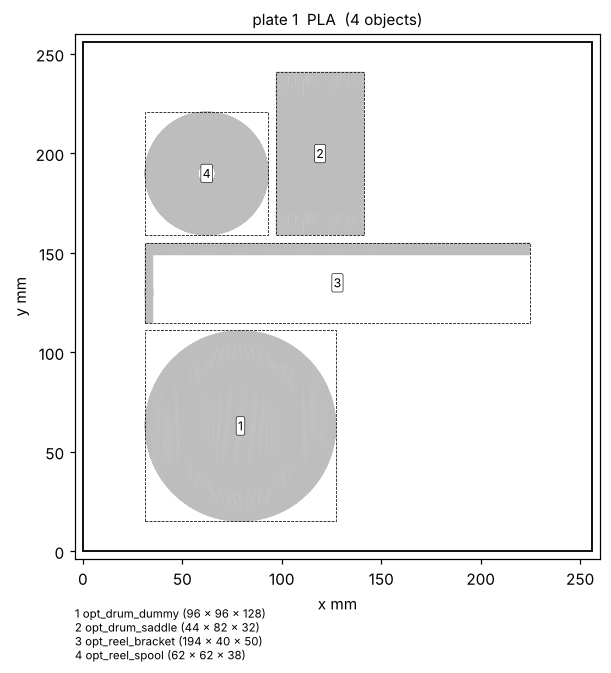
base/out/display/plates/plate_4_optional_PLA.png
