HarryHYu/GrappStar/base/out/display/plates_sheet.png

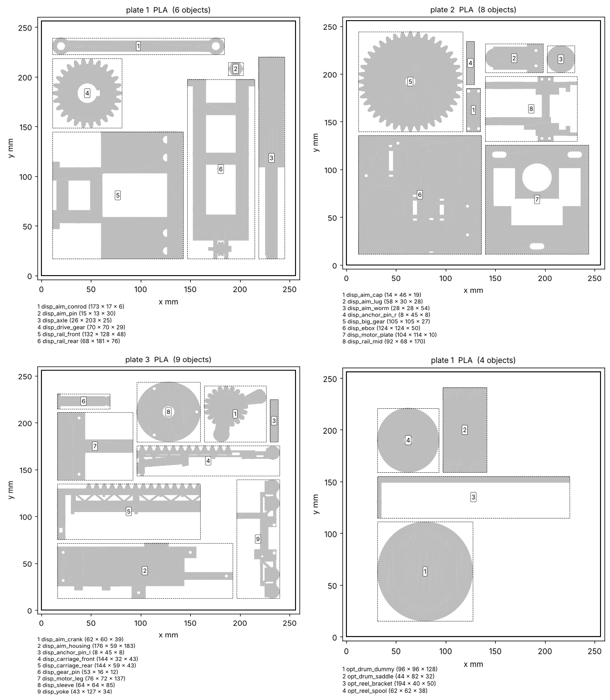
base/out/display/plates_sheet.png
