HarryHYu/GrappStar/base/out/display/renders/display_ebox_motor.png

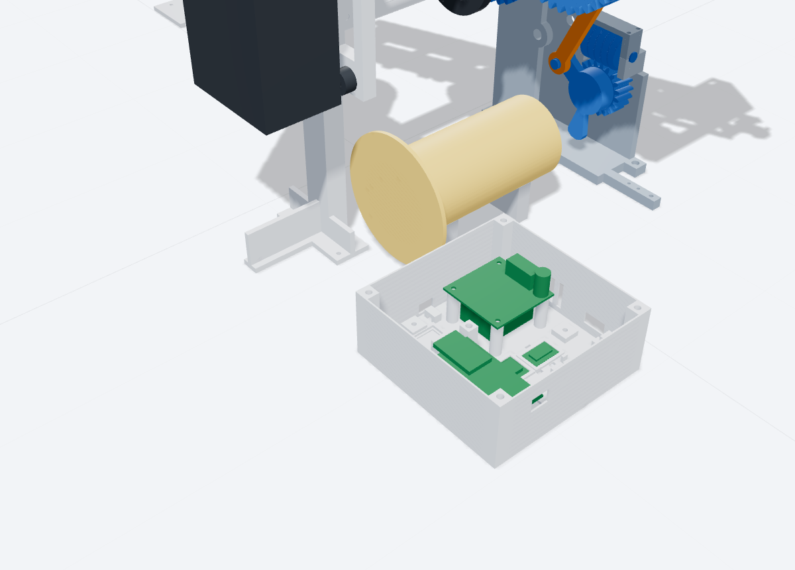
base/out/display/renders/display_ebox_motor.png
