HarryHYu/GrappStar/base/out/display/renders/display_iso_left.png

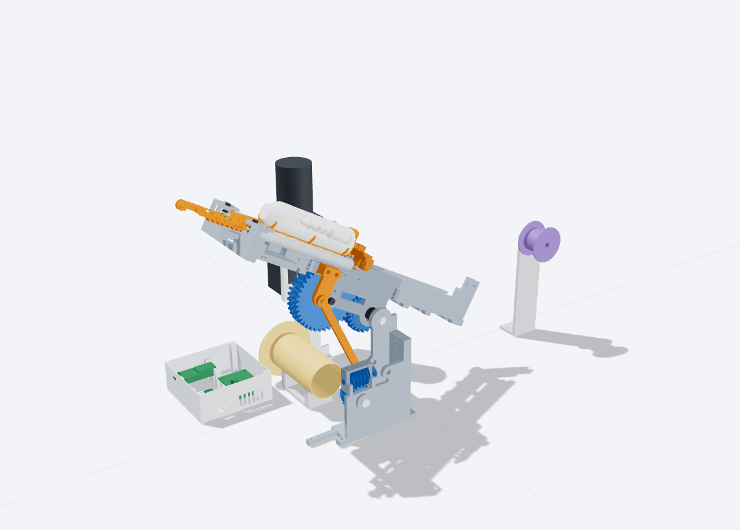
base/out/display/renders/display_iso_left.png
