HarryHYu/GrappStar/base/out/display/renders/display_iso_right_motor.png

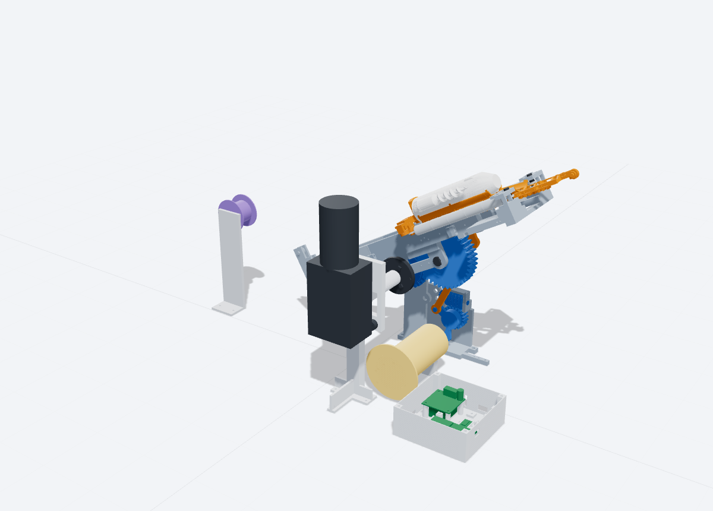
base/out/display/renders/display_iso_right_motor.png
