HarryHYu/GrappStar/base/out/display/renders/display_launcher.png

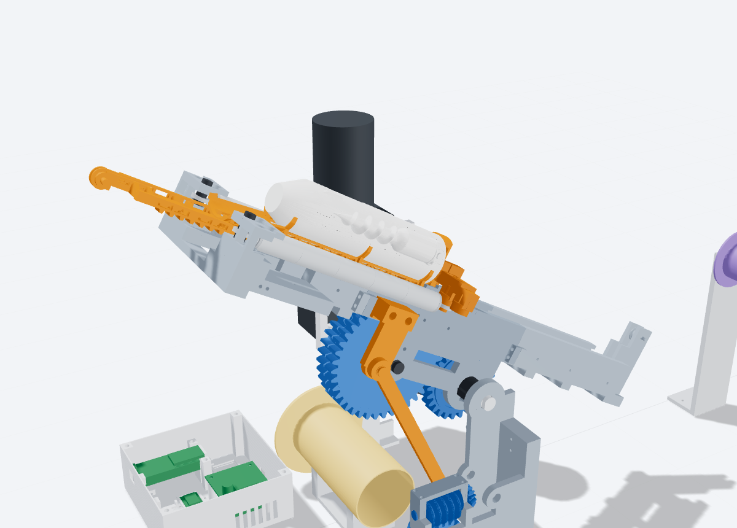
base/out/display/renders/display_launcher.png
