HarryHYu/GrappStar/base/out/display/renders/display_sheet.png

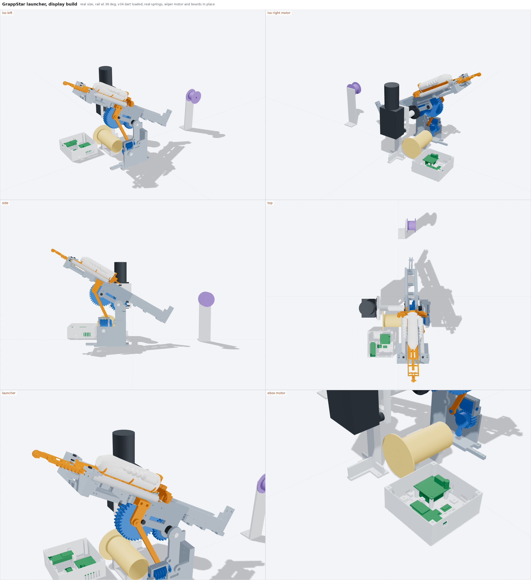
base/out/display/renders/display_sheet.png
