HarryHYu/GrappStar/base/out/display/renders/display_side.png

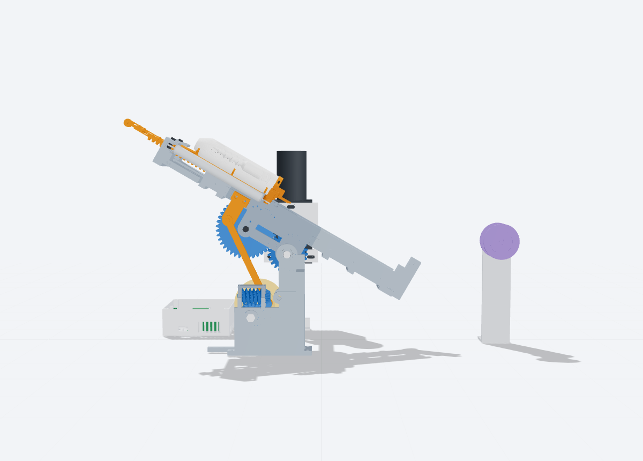
base/out/display/renders/display_side.png
