HarryHYu/GrappStar/base/out/display/renders/display_top.png

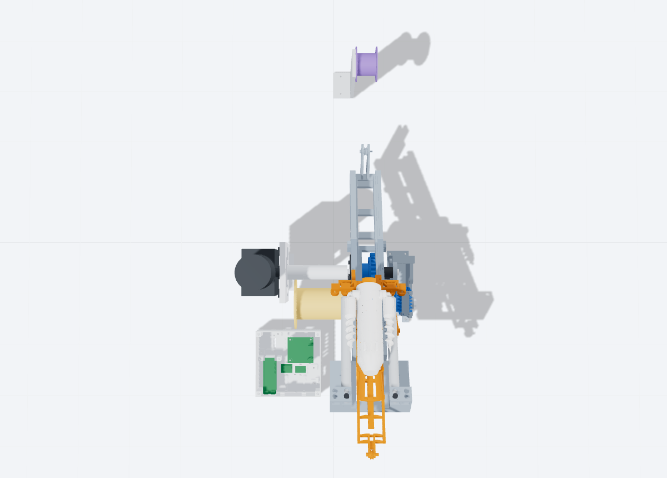
base/out/display/renders/display_top.png
