HarryHYu/GrappStar/base/out/show/audit_sheet.png

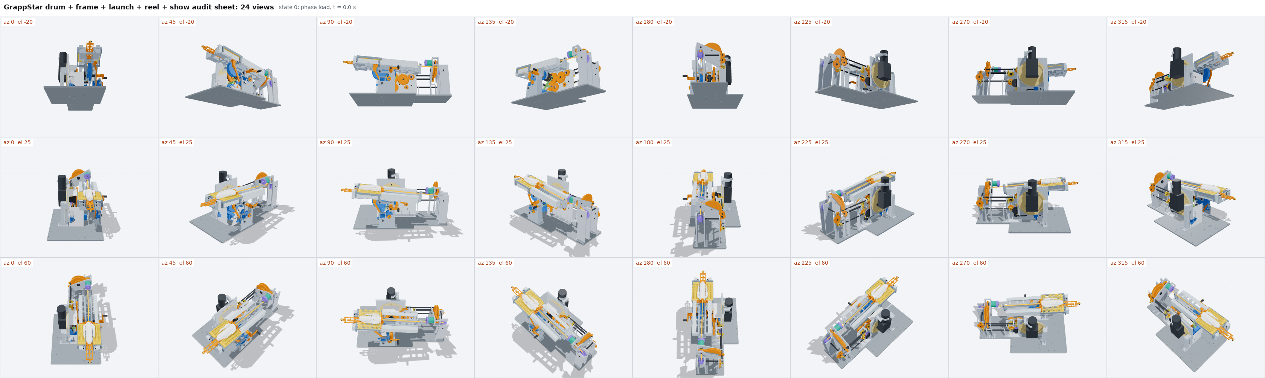
base/out/show/audit_sheet.png
