HarryHYu/GrappStar/base/out/show/plates_all.png

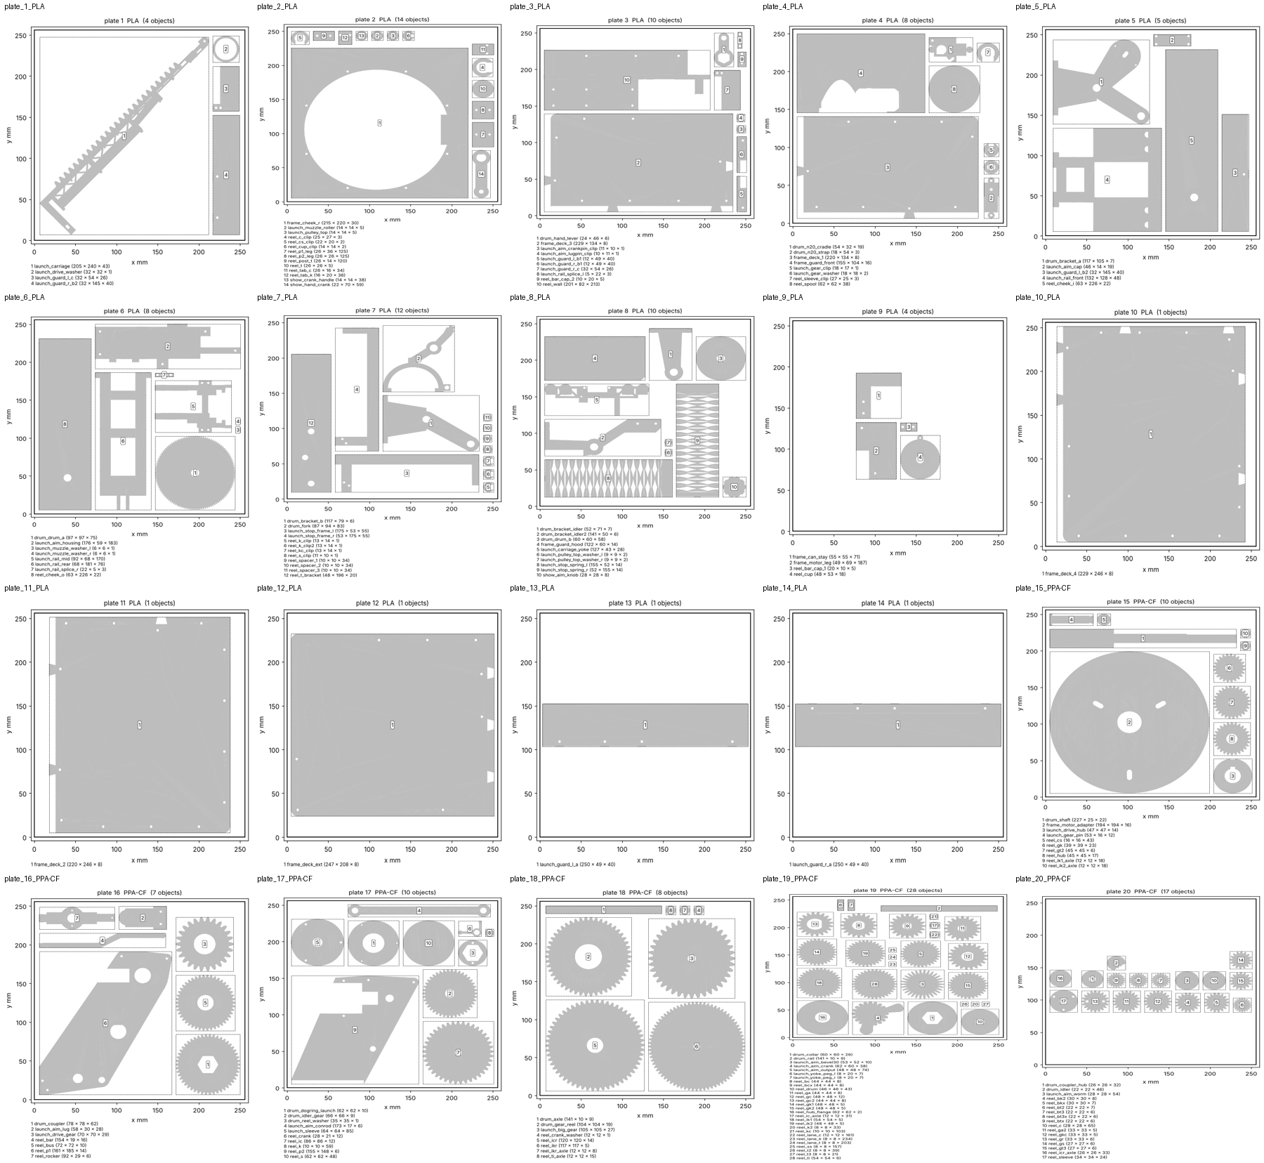
base/out/show/plates_all.png
