HarryHYu/GrappStar/base/out/show/renders/show_cocked_iso.png

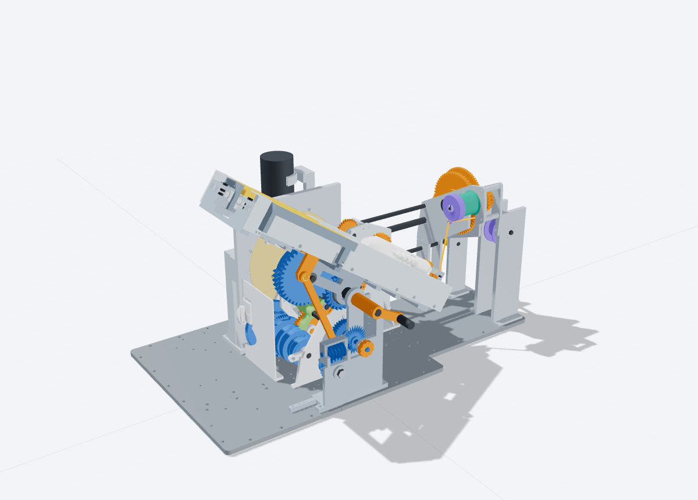
base/out/show/renders/show_cocked_iso.png
