HarryHYu/GrappStar/base/out/show/renders/show_cocked_iso_motor_side.png

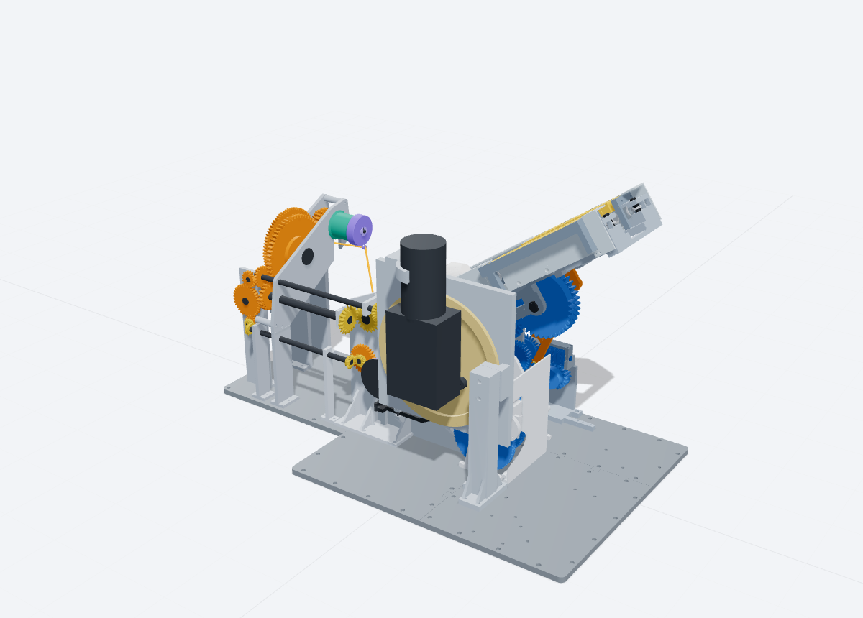
base/out/show/renders/show_cocked_iso_motor_side.png
