HarryHYu/GrappStar/base/out/show/renders/show_cocked_launcher.png

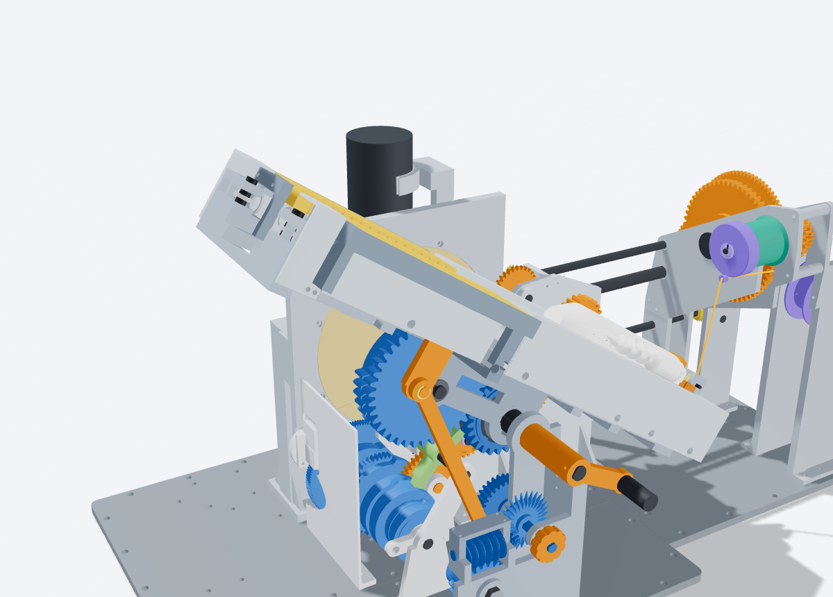
base/out/show/renders/show_cocked_launcher.png
