HarryHYu/GrappStar/base/out/show/renders/show_cocked_side.png

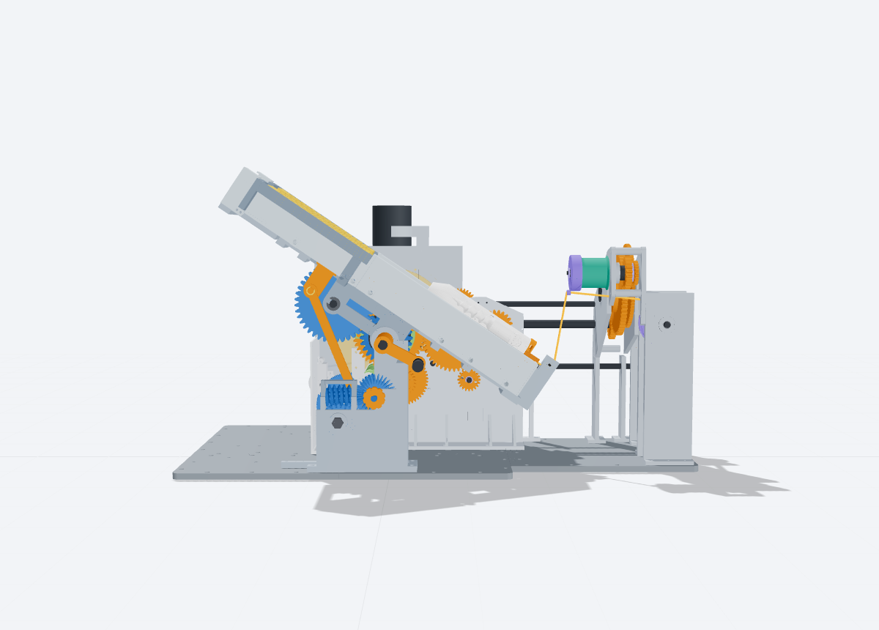
base/out/show/renders/show_cocked_side.png
