HarryHYu/GrappStar/base/out/show/renders/show_fired_iso.png

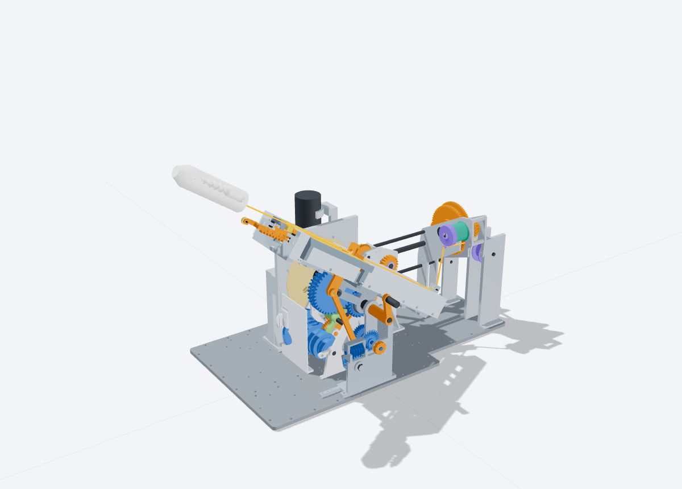
base/out/show/renders/show_fired_iso.png
