HarryHYu/GrappStar/base/out/show/renders/show_fired_iso_motor_side.png

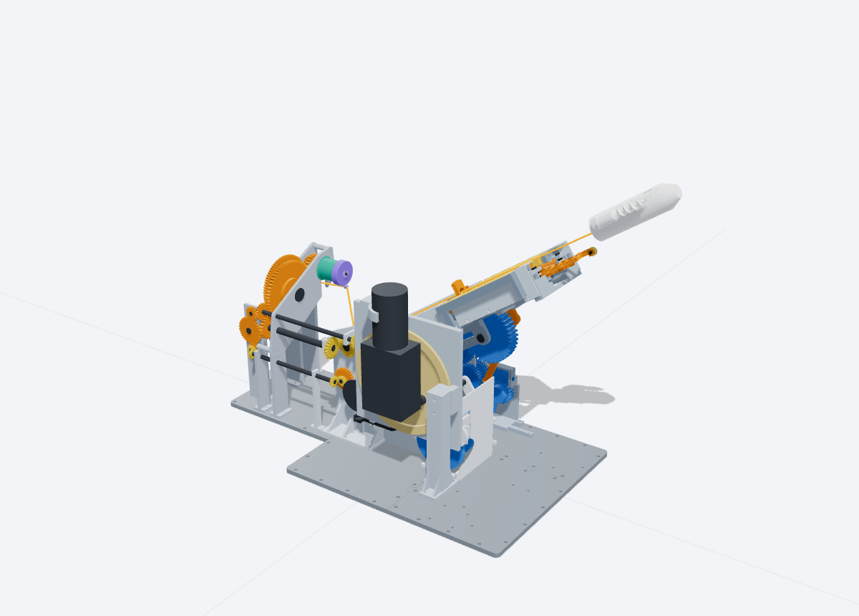
base/out/show/renders/show_fired_iso_motor_side.png
