HarryHYu/GrappStar/base/out/show/renders/show_fired_launcher.png

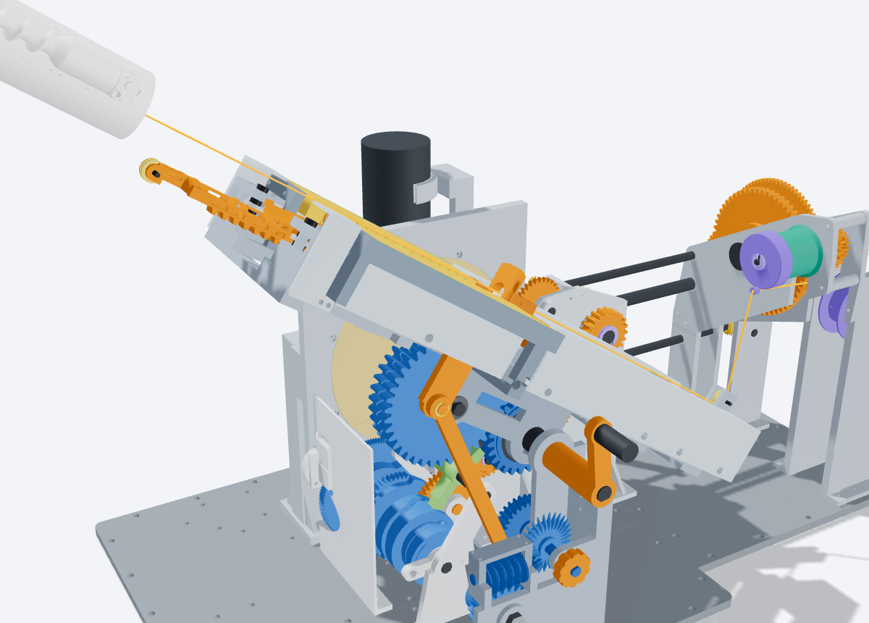
base/out/show/renders/show_fired_launcher.png
