HarryHYu/GrappStar/base/out/show/renders/show_fired_side.png

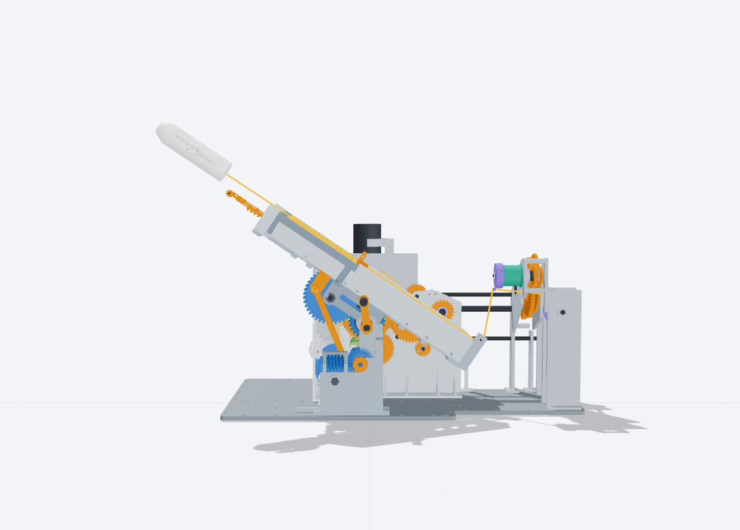
base/out/show/renders/show_fired_side.png
