HarryHYu/GrappStar/base/out/show/renders/show_loaded_controls.png

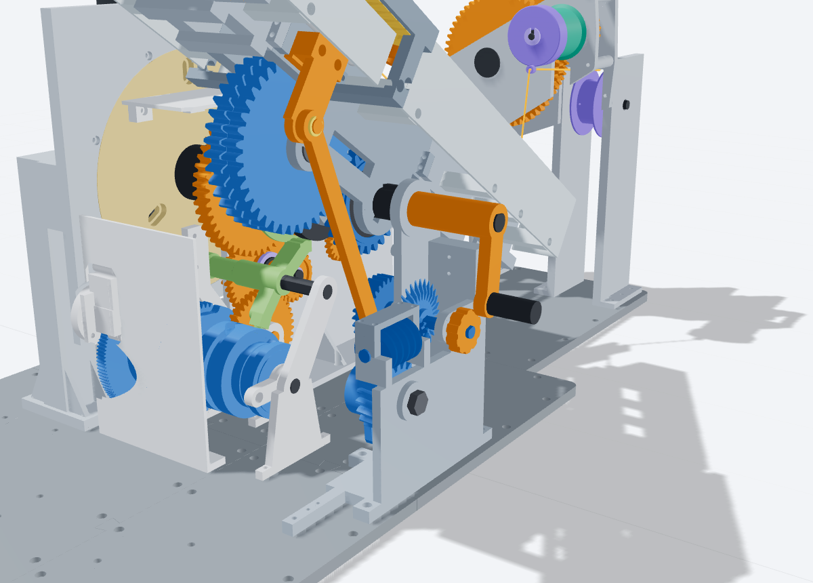
base/out/show/renders/show_loaded_controls.png
