HarryHYu/GrappStar/base/out/show/renders/show_loaded_tail_knot.png

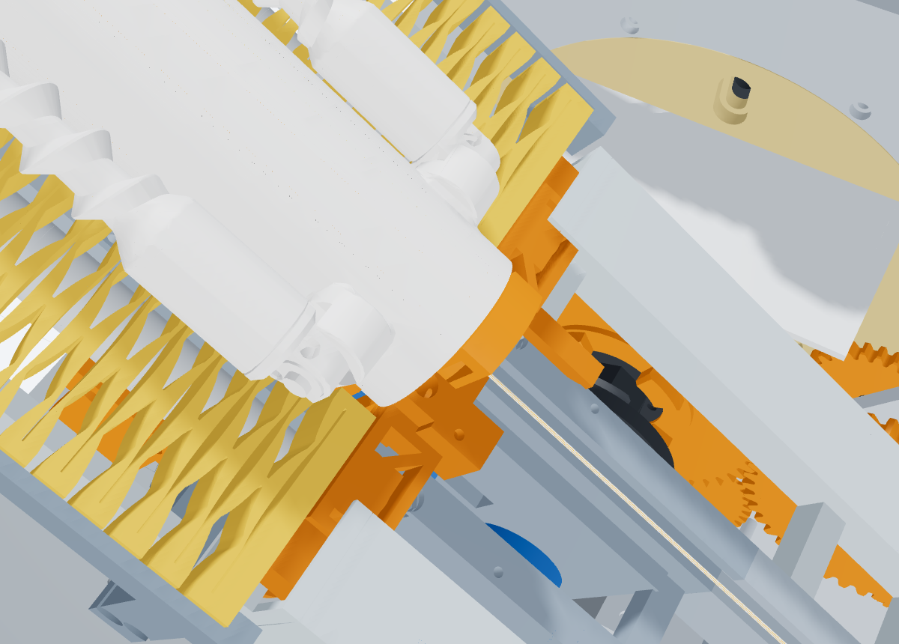
base/out/show/renders/show_loaded_tail_knot.png
