HarryHYu/GrappStar/base/out/show/renders/show_loaded_tail_knot_b.png

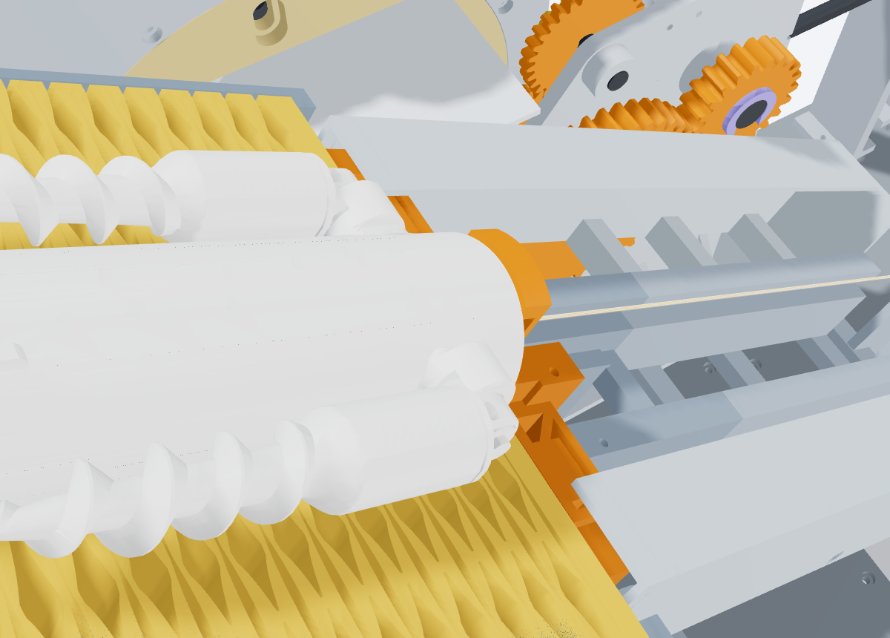
base/out/show/renders/show_loaded_tail_knot_b.png
