HarryHYu/GrappStar/base/out/show/renders/show_states.png

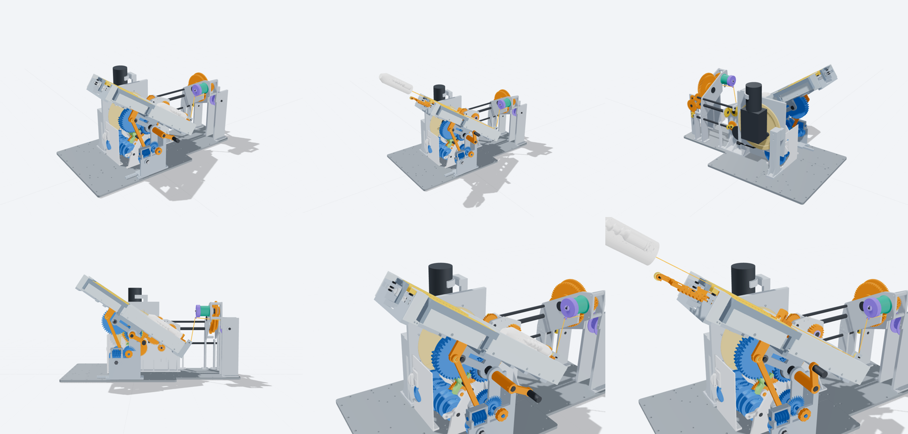
base/out/show/renders/show_states.png
