HarryHYu/GrappStar/base/out/show/sections.png

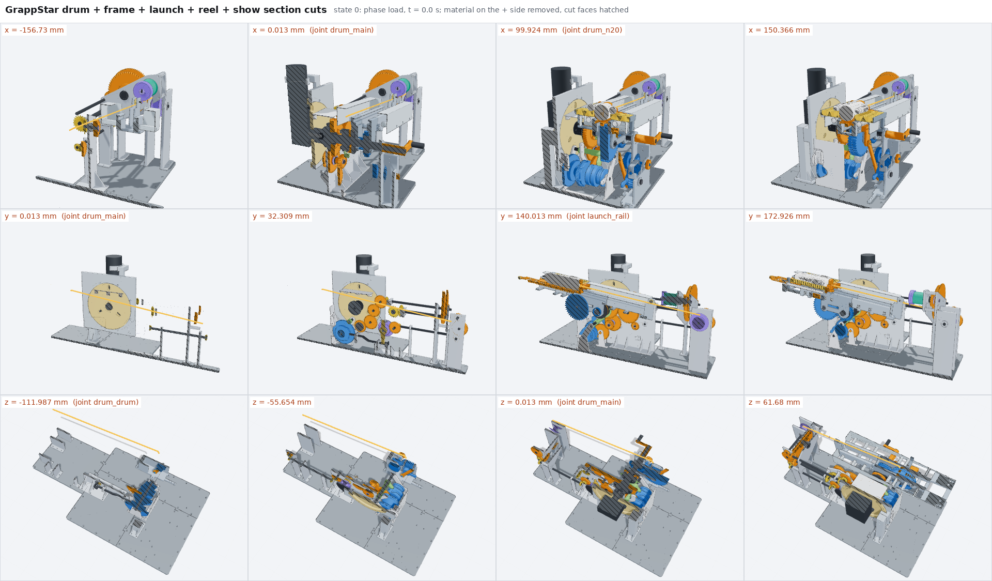
base/out/show/sections.png
