HarryHYu/GrappStar/base/site/mech/aim.png

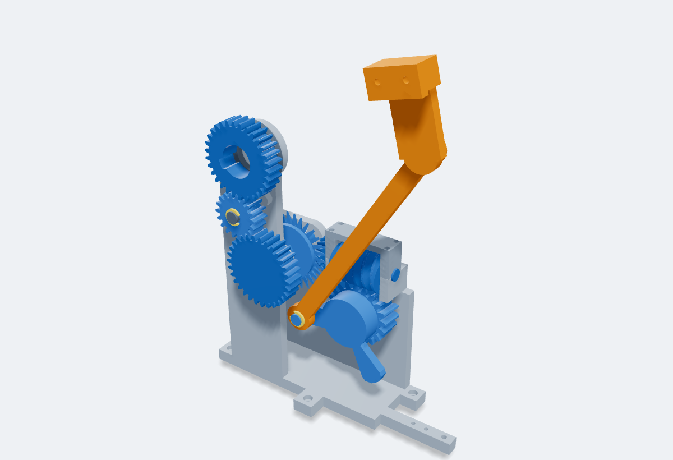
base/site/mech/aim.png
