HarryHYu/GrappStar/base/site/mech/cock.png

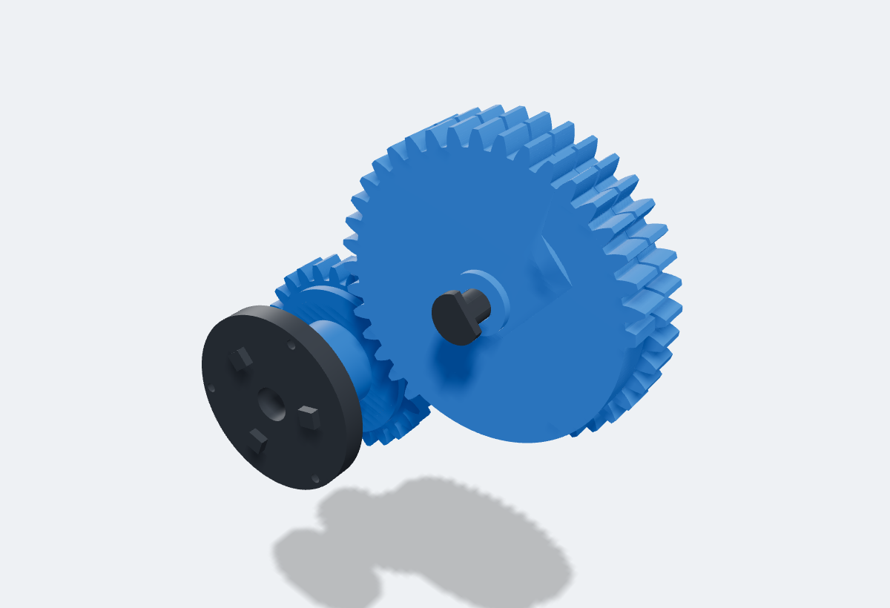
base/site/mech/cock.png
