HarryHYu/GrappStar/base/site/mech/selector.png

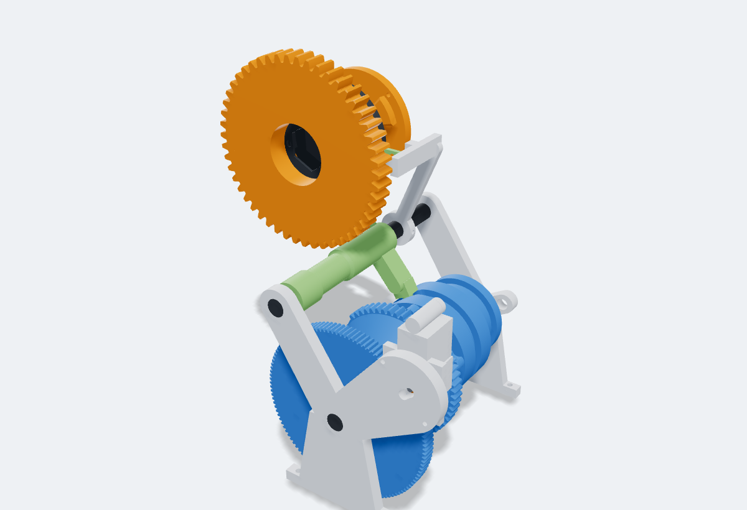
base/site/mech/selector.png
