HarryHYu/GrappStar/base/site/mech/storage.png

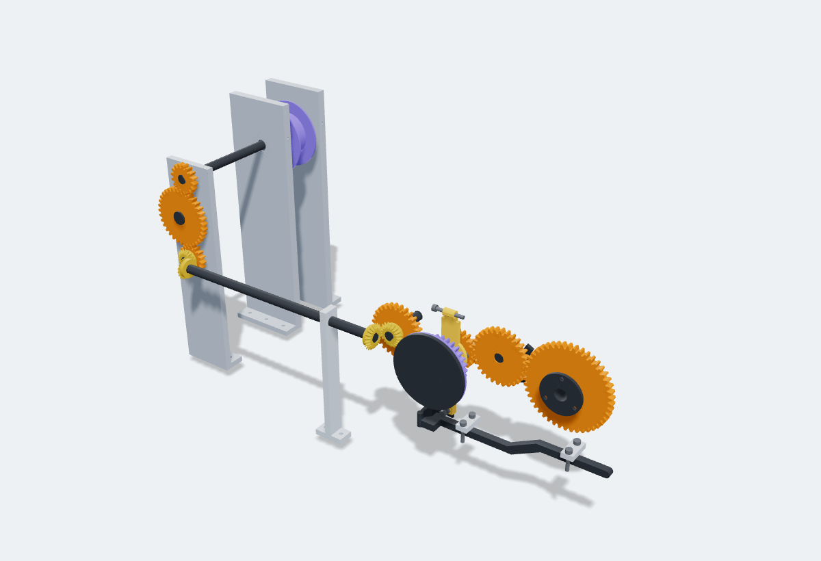
base/site/mech/storage.png
