HarryHYu/GrappStar/base/site/operator.png

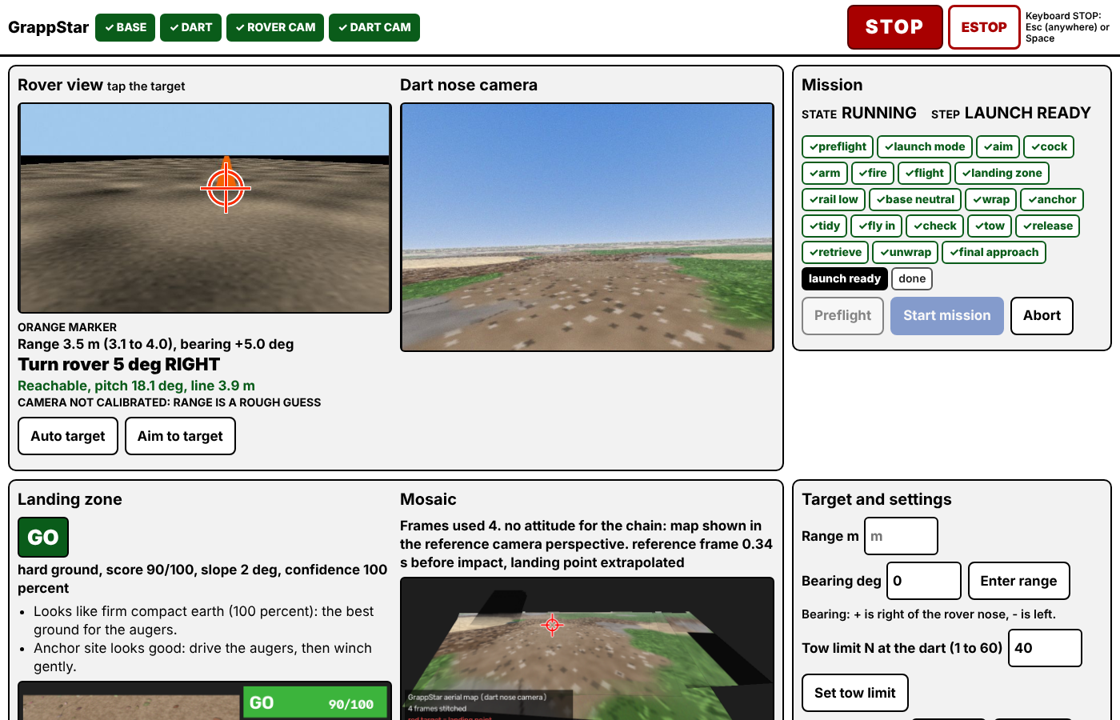
base/site/operator.png
