HarryHYu/GrappStar/kedge/dist_v35/KEDGE_v35/docs/audit_sheet.png

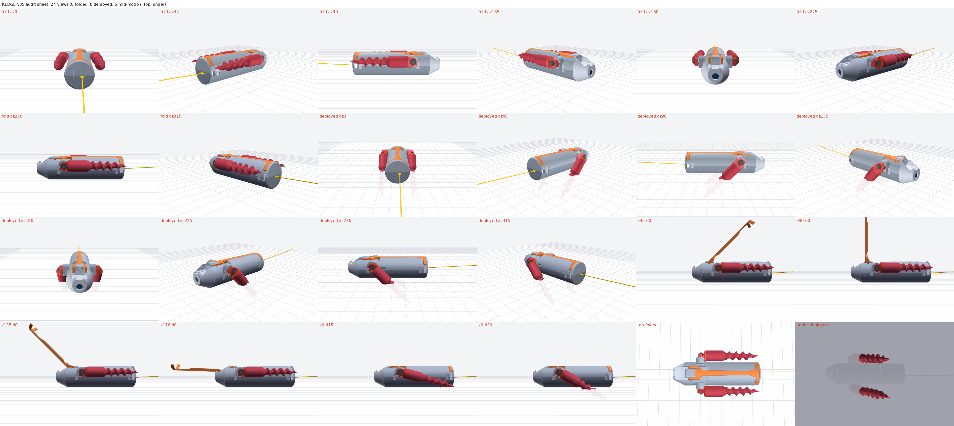
kedge/dist_v35/KEDGE_v35/docs/audit_sheet.png
