HarryHYu/GrappStar/kedge/dist_v35/KEDGE_v35/docs/flight_sim.png

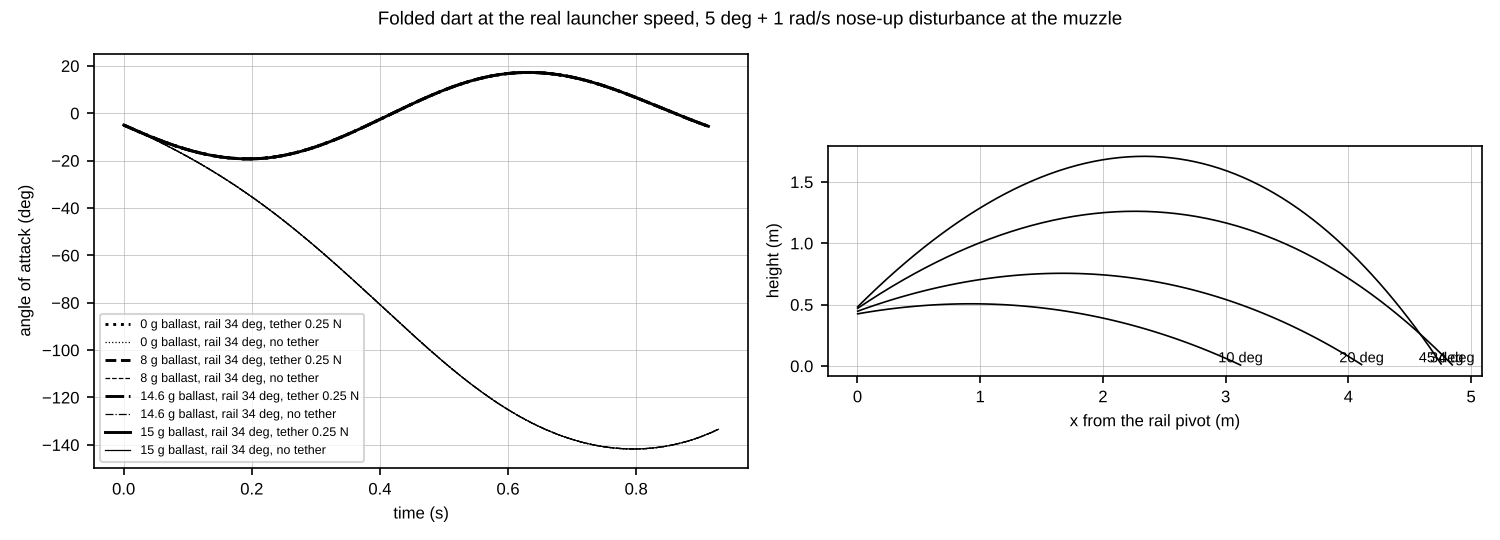
kedge/dist_v35/KEDGE_v35/docs/flight_sim.png
