HarryHYu/GrappStar/kedge/dist_v35/KEDGE_v35/docs/plates.png

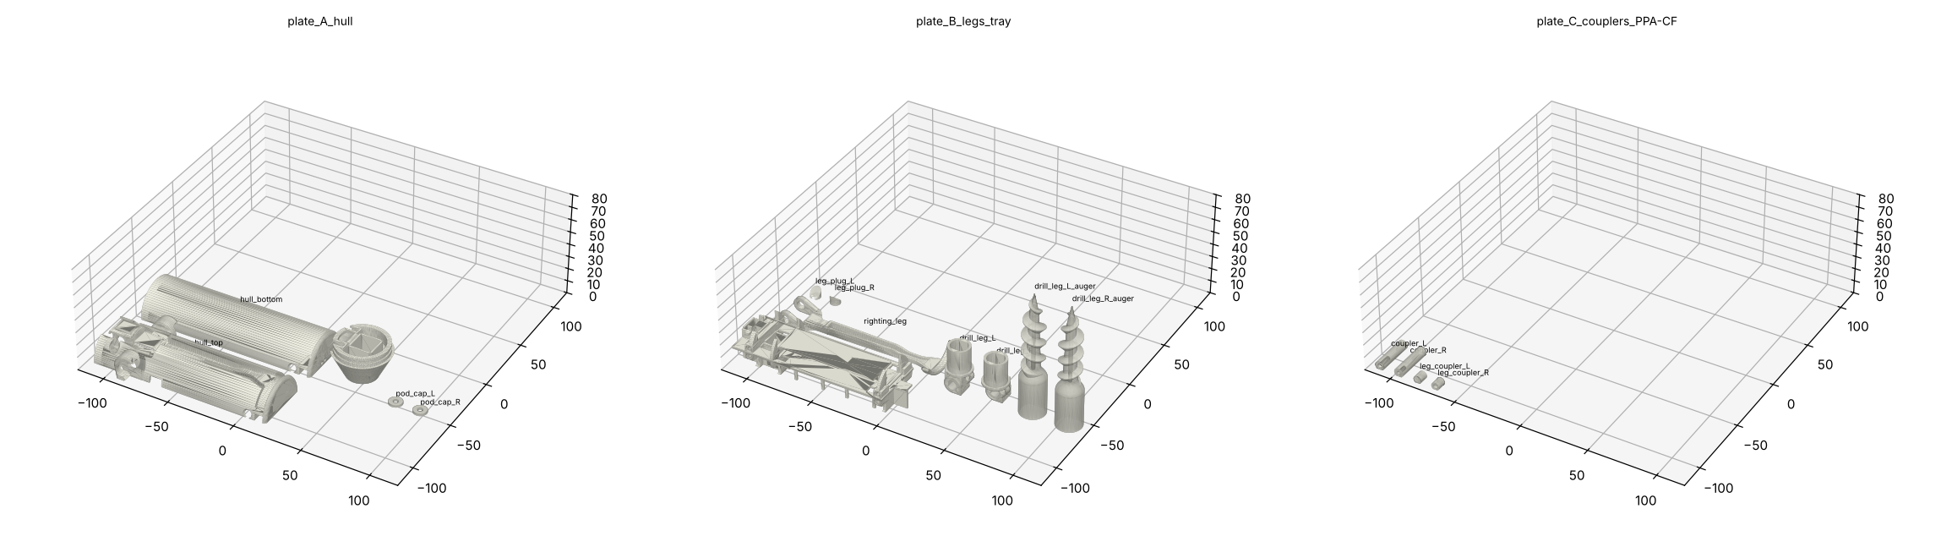
kedge/dist_v35/KEDGE_v35/docs/plates.png
