HarryHYu/GrappStar/kedge/dist_v35/KEDGE_v35/docs/sections.png

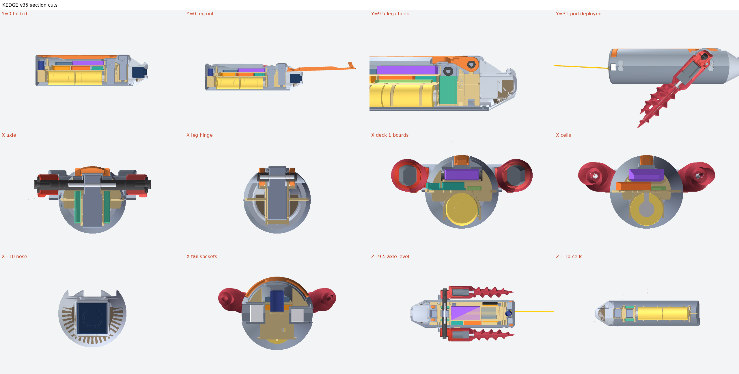
kedge/dist_v35/KEDGE_v35/docs/sections.png
