HarryHYu/GrappStar/kedge/gs/shots/a0.png

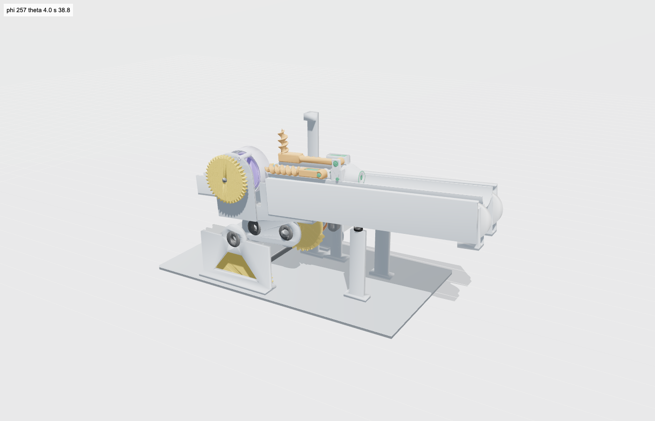
kedge/gs/shots/a0.png
