HarryHYu/GrappStar/kedge/gs/shots/asm2_6.png

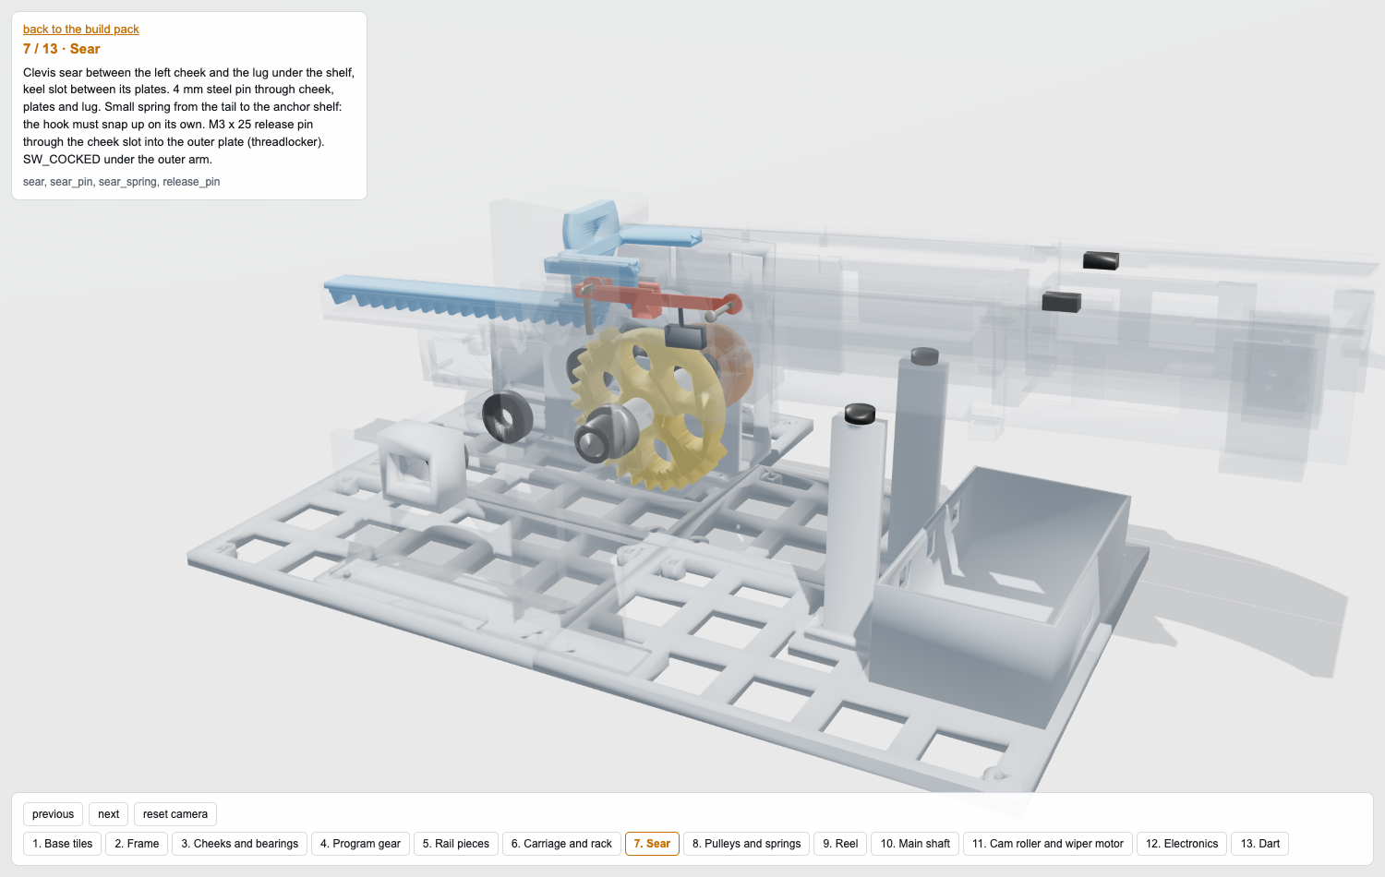
kedge/gs/shots/asm2_6.png
