HarryHYu/GrappStar/kedge/gs/shots/asm_3.png

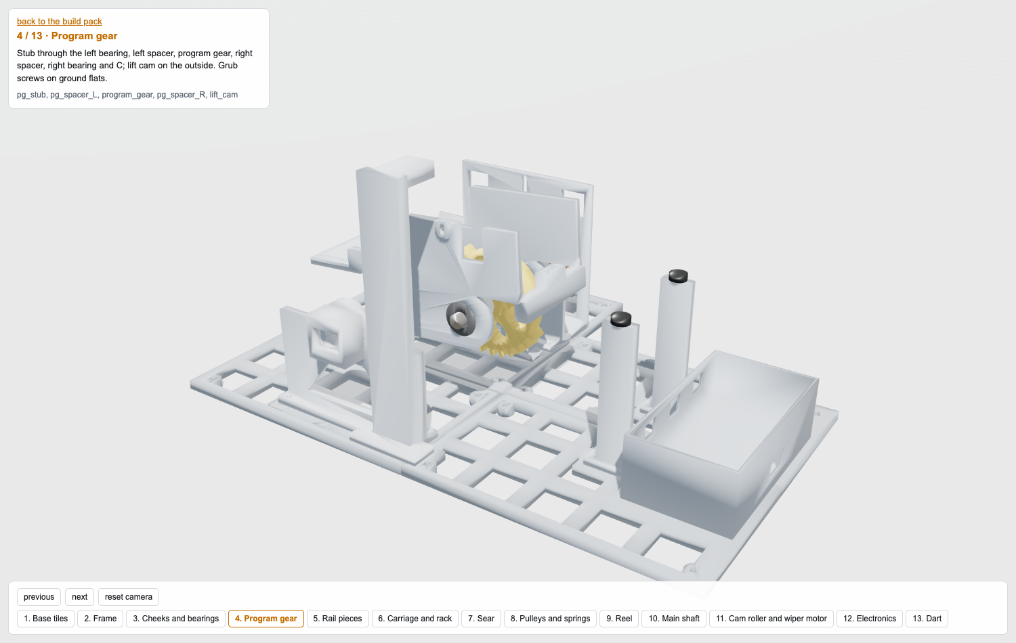
kedge/gs/shots/asm_3.png
