HarryHYu/GrappStar/kedge/gs/shots/asm_9.png

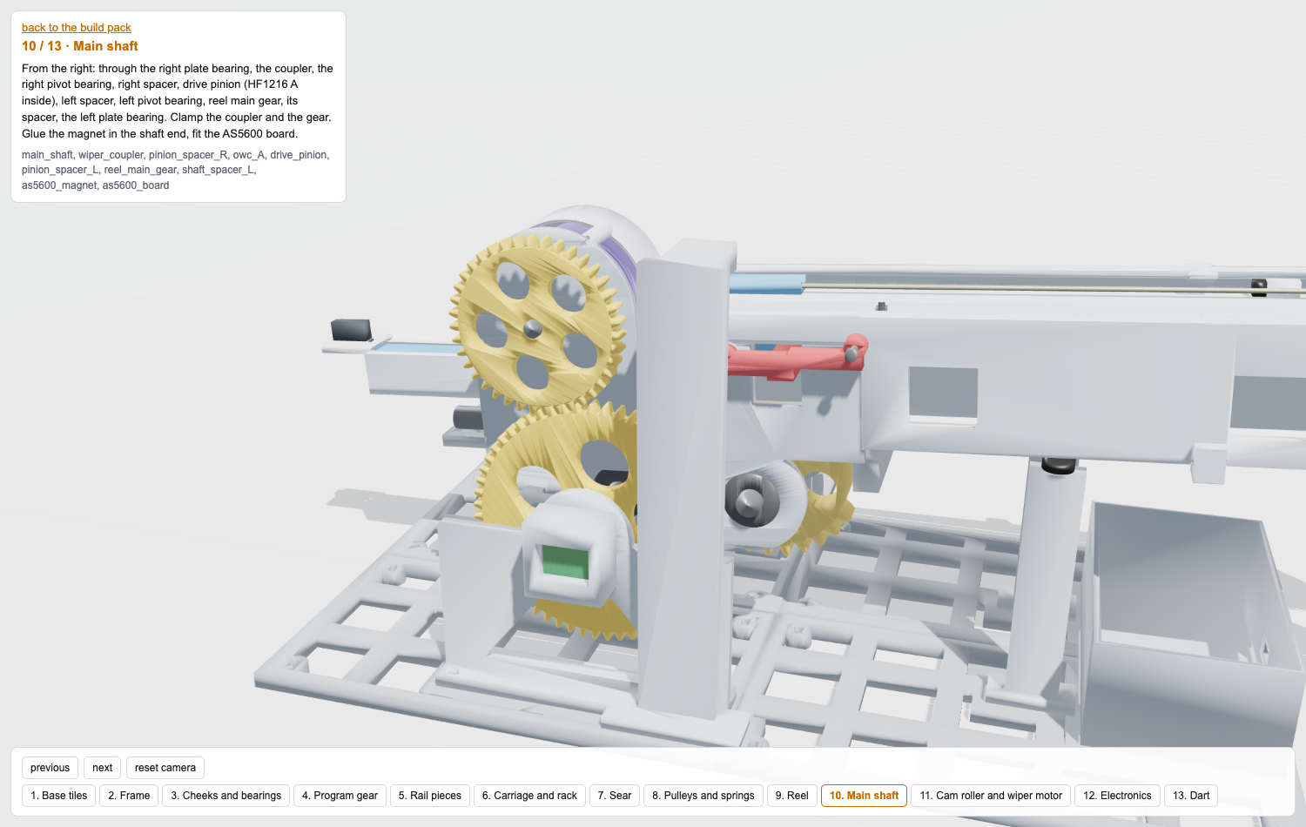
kedge/gs/shots/asm_9.png
