HarryHYu/GrappStar/kedge/gs/shots/asm_sheet.jpg

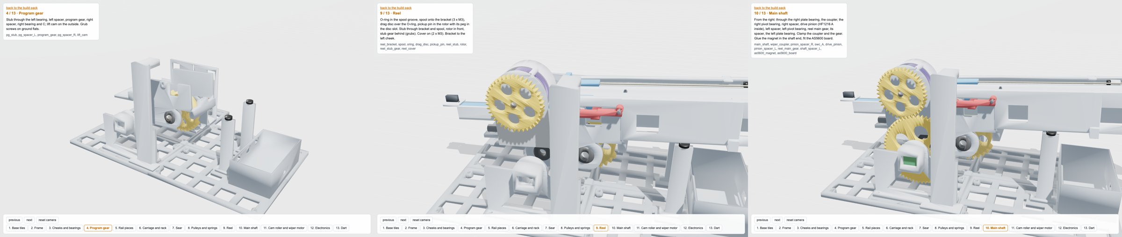
kedge/gs/shots/asm_sheet.jpg
