HarryHYu/GrappStar/kedge/gs/shots/b1.png

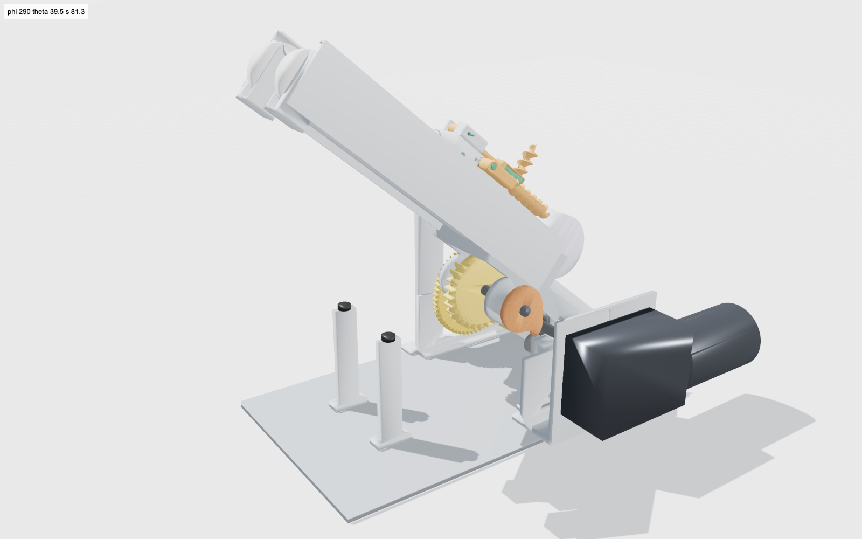
kedge/gs/shots/b1.png
