HarryHYu/GrappStar/kedge/gs/shots/pin_9.7.png

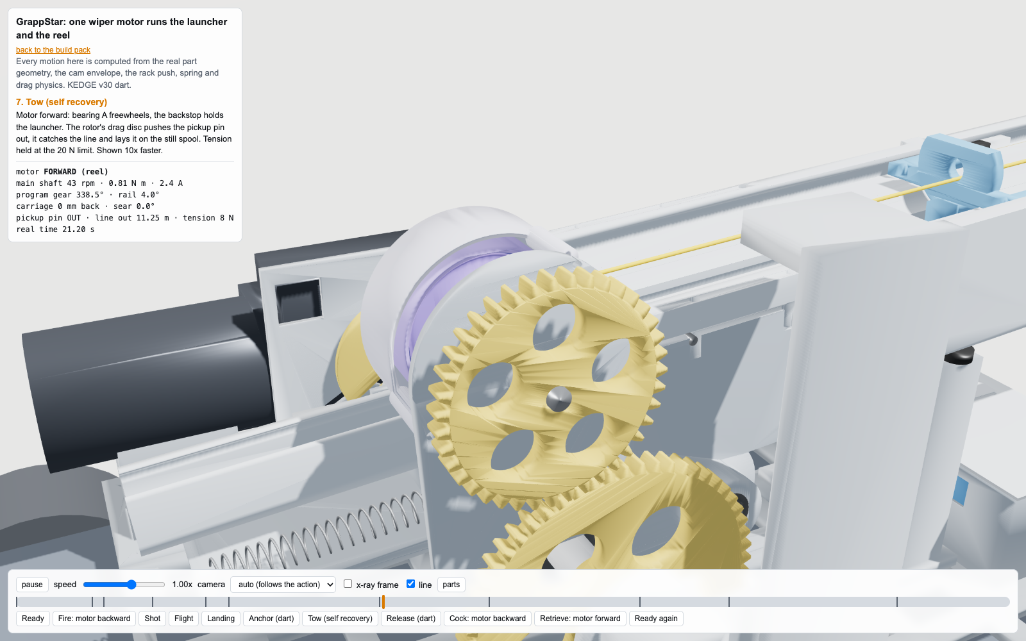
kedge/gs/shots/pin_9.7.png
