HarryHYu/GrappStar/kedge/gs/shots/pin_10.5.png

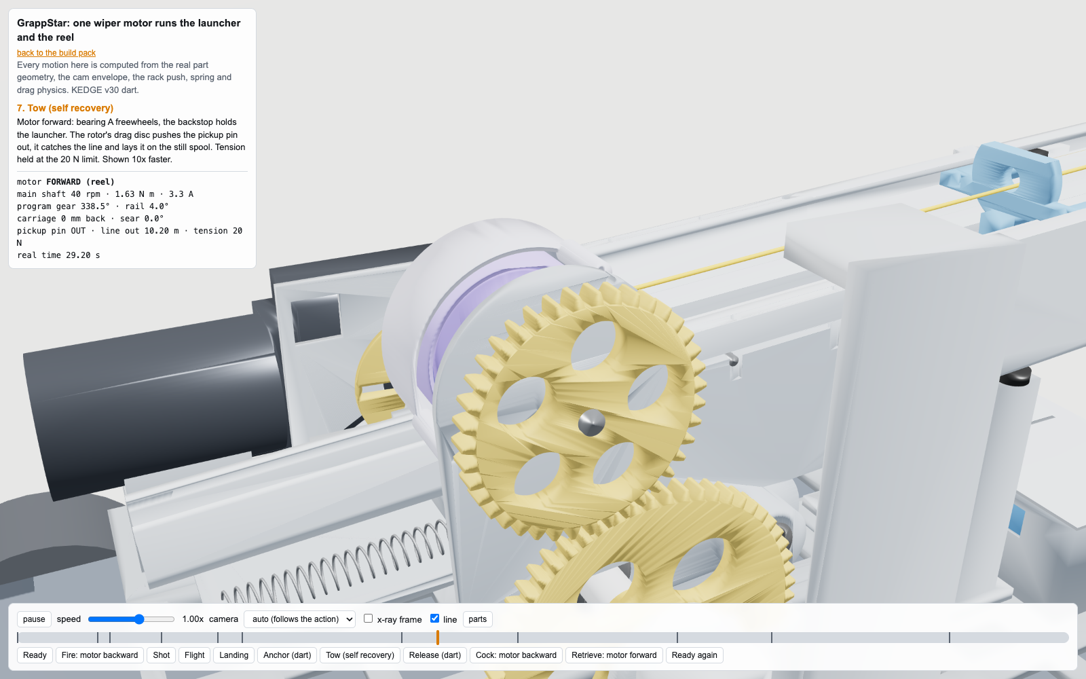
kedge/gs/shots/pin_10.5.png
