HarryHYu/GrappStar/kedge/gs/shots/r_21.5.png

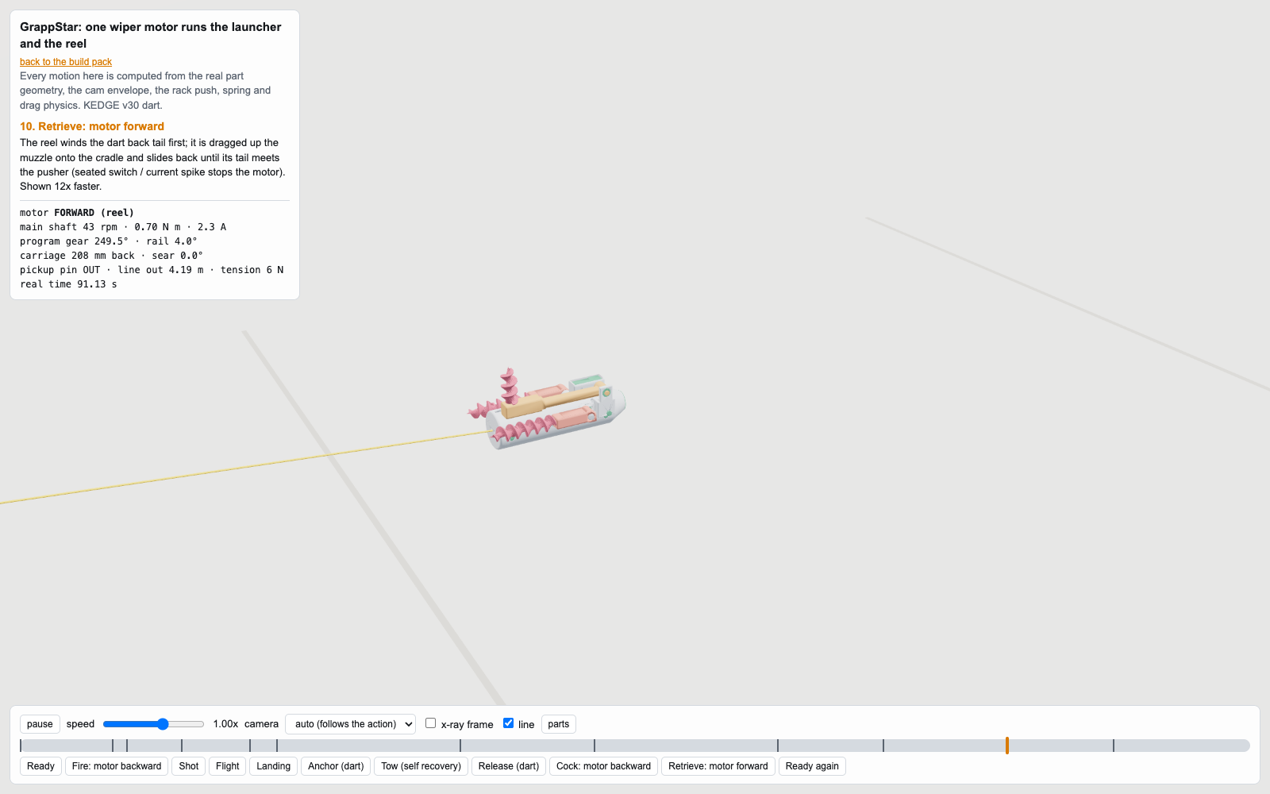
kedge/gs/shots/r_21.5.png
