HarryHYu/GrappStar/kedge/gs/shots/r_23.6.png

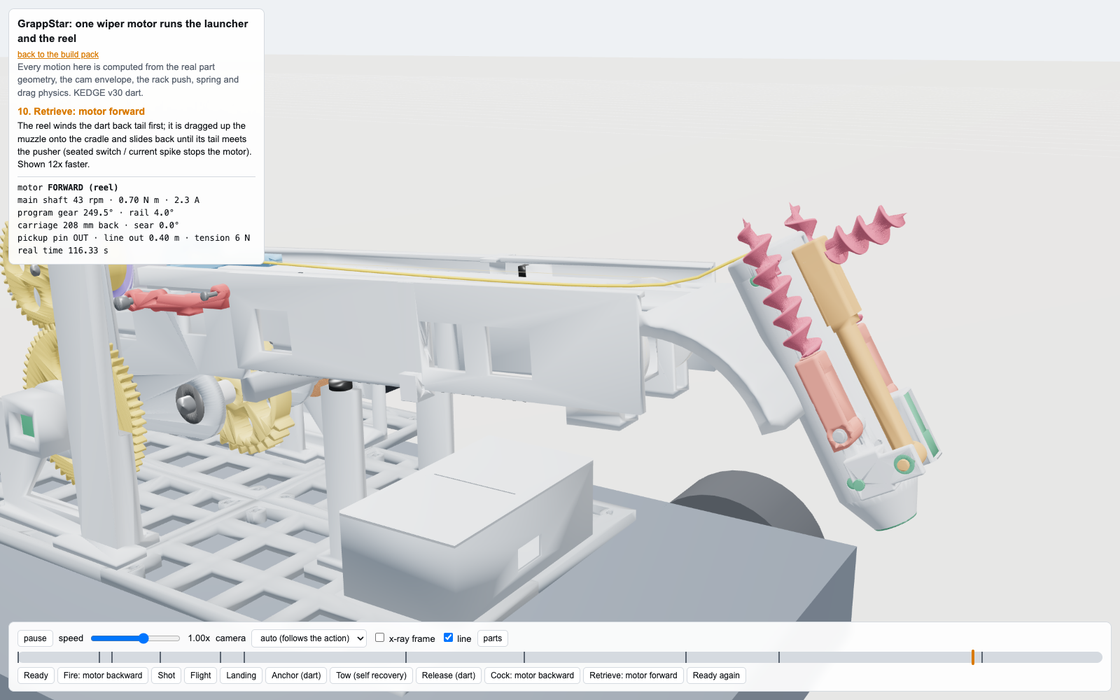
kedge/gs/shots/r_23.6.png
