HarryHYu/GrappStar/kedge/gs/shots/reel_x.png

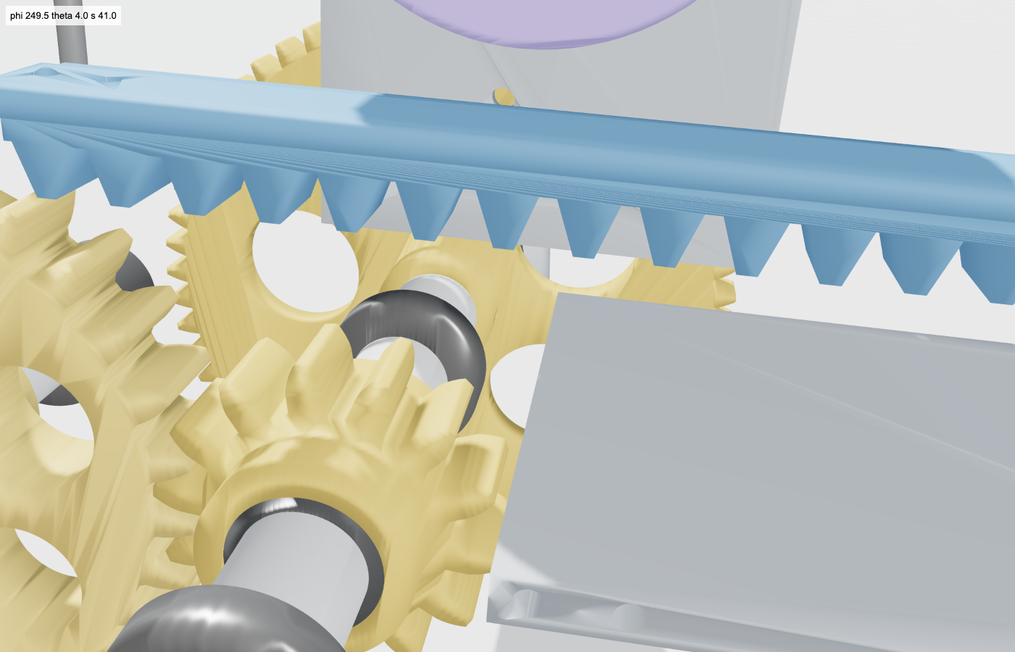
kedge/gs/shots/reel_x.png
