HarryHYu/GrappStar/kedge/gs/shots/s_2.2.png

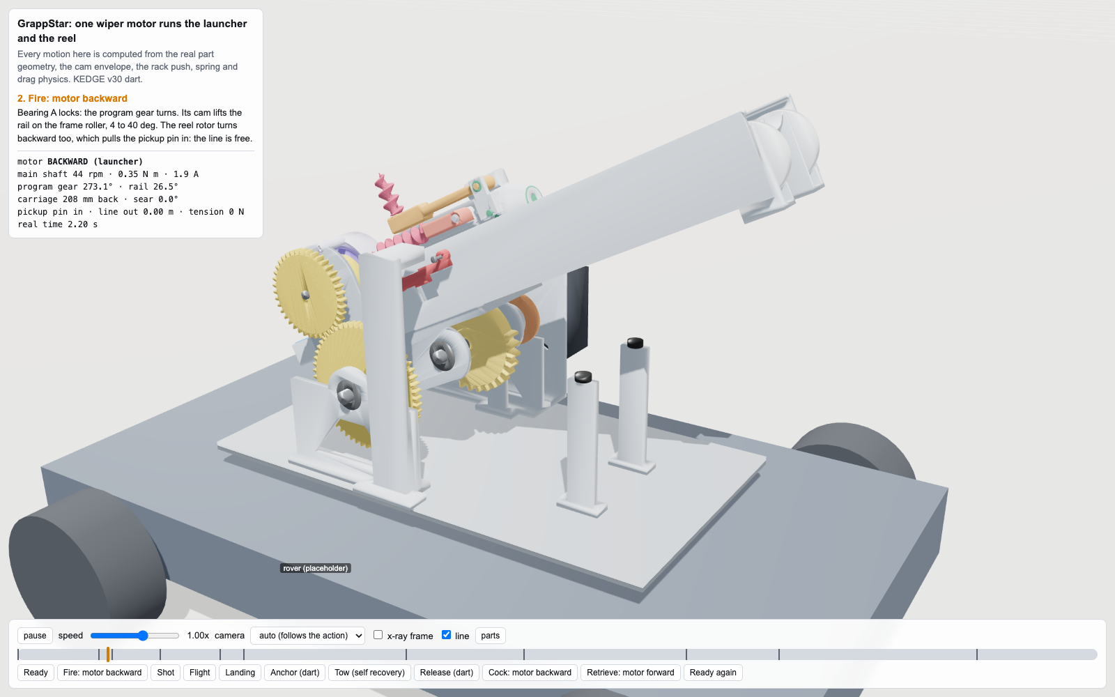
kedge/gs/shots/s_2.2.png
