HarryHYu/GrappStar/kedge/gs/shots/t_12.png

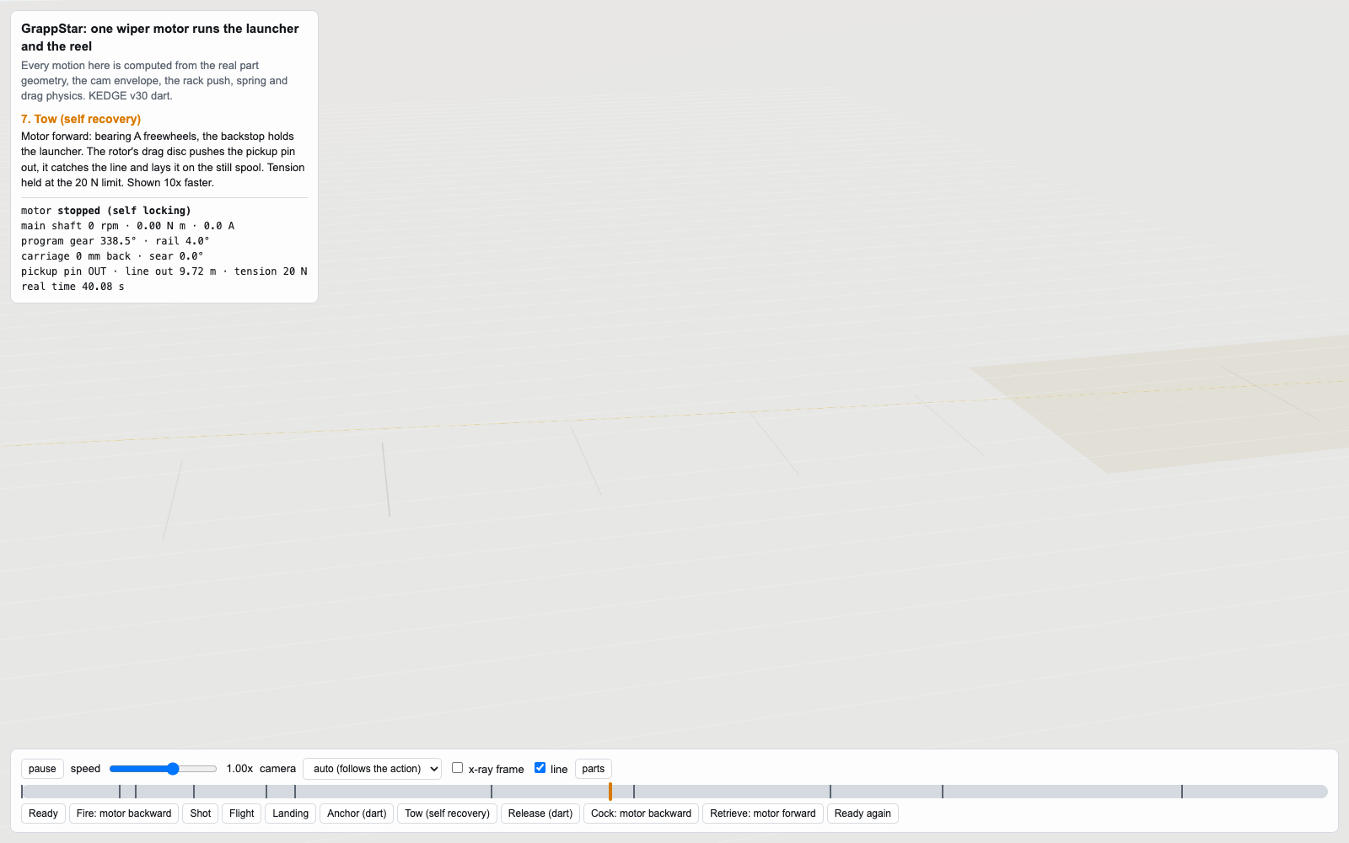
kedge/gs/shots/t_12.png
