HarryHYu/GrappStar/kedge/gs/shots/t_17.2.png

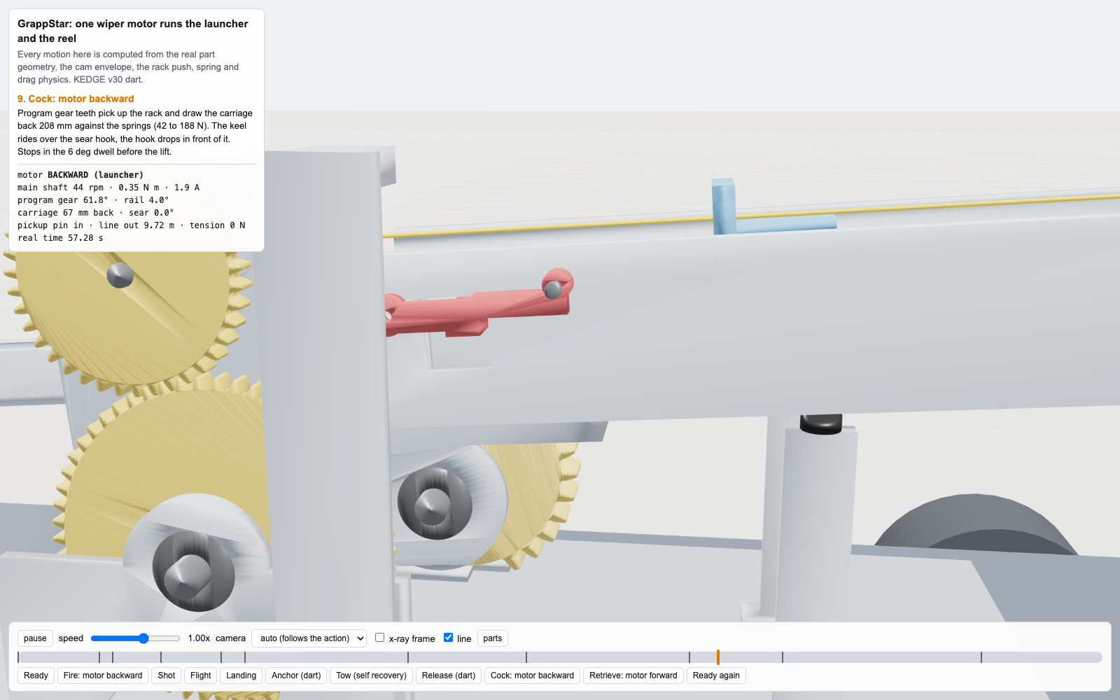
kedge/gs/shots/t_17.2.png
