HarryHYu/GrappStar/kedge/gs/shots/trip_2.25.png

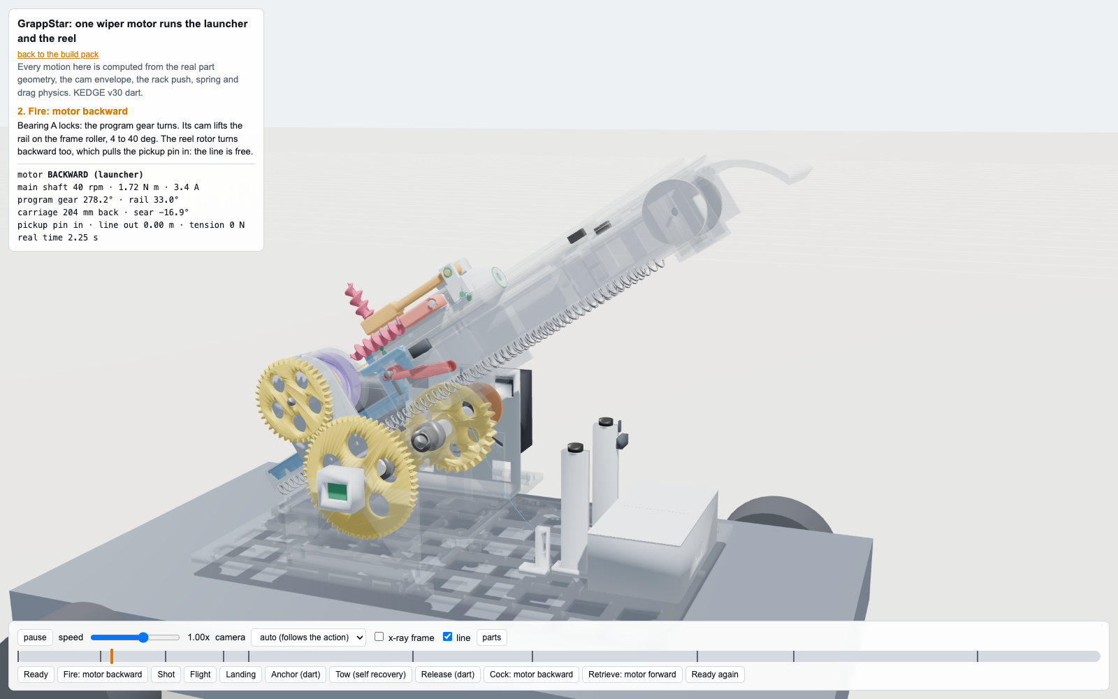
kedge/gs/shots/trip_2.25.png
