HarryHYu/GrappStar/kedge/gs/shots/u_17.5.png

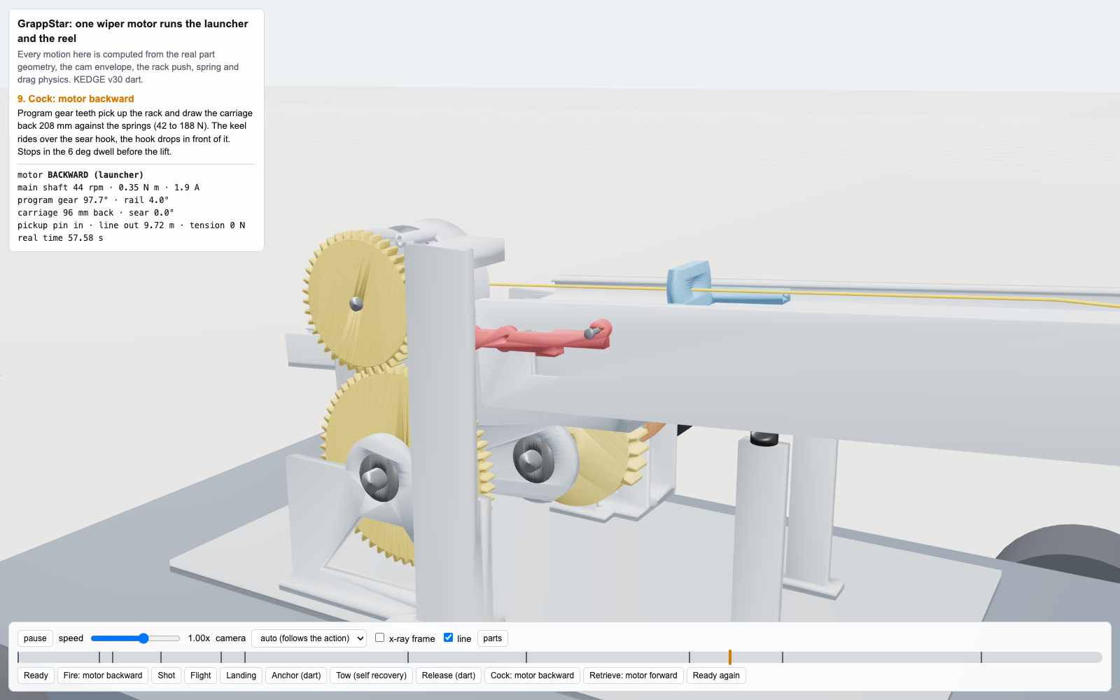
kedge/gs/shots/u_17.5.png
