HarryHYu/GrappStar/kedge/gs/shots/x_17.3.png

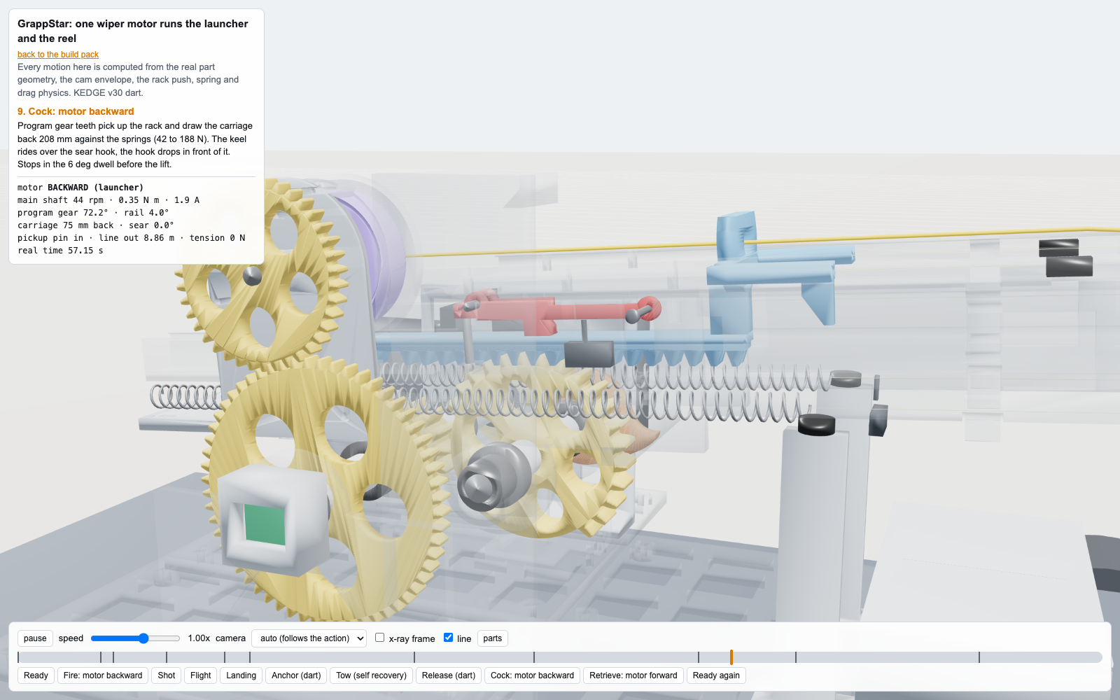
kedge/gs/shots/x_17.3.png
