HarryHYu/GrappStar/kedge/out29/_c08.png

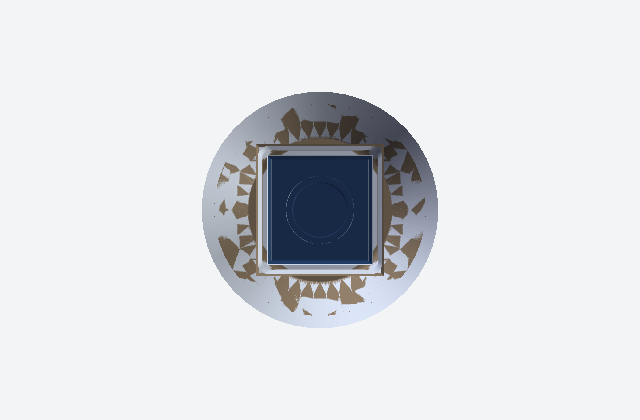
kedge/out29/_c08.png
