HarryHYu/GrappStar/kedge/out30/img_deployed_side.png

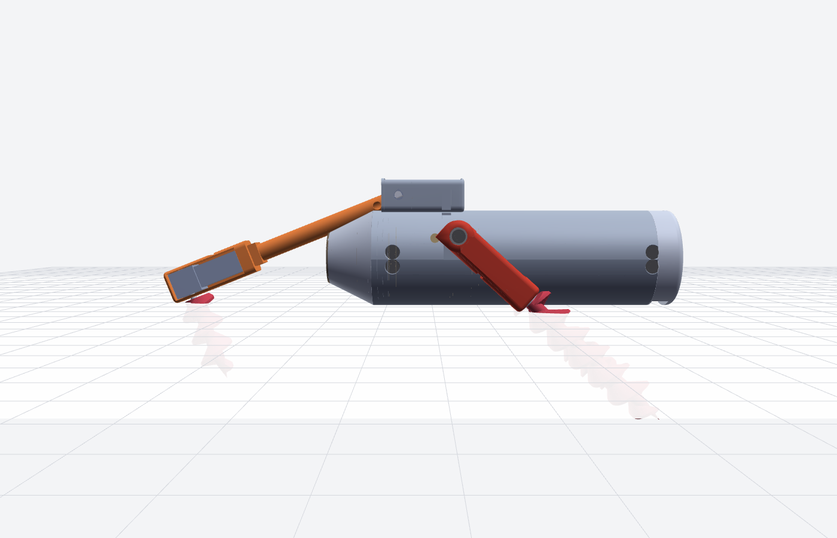
kedge/out30/img_deployed_side.png
