HarryHYu/GrappStar/kedge/out32/phys31/anchor.png

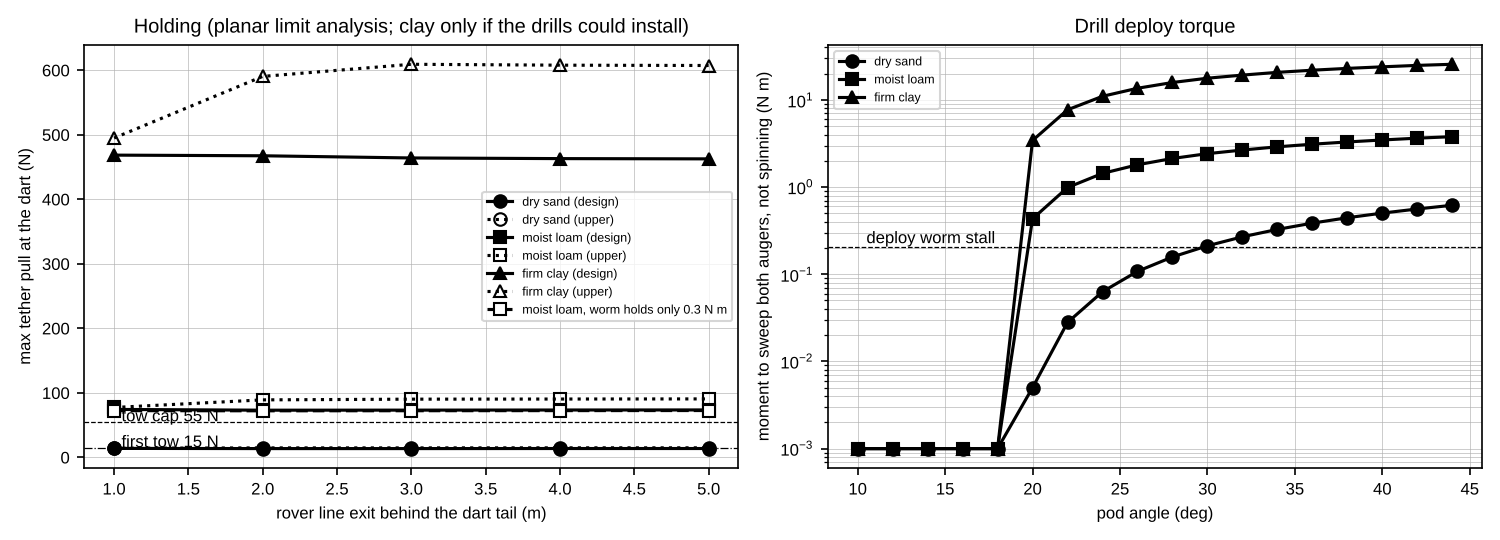
kedge/out32/phys31/anchor.png
