HarryHYu/GrappStar/kedge/out32/review/after/01_folded_34_front.png

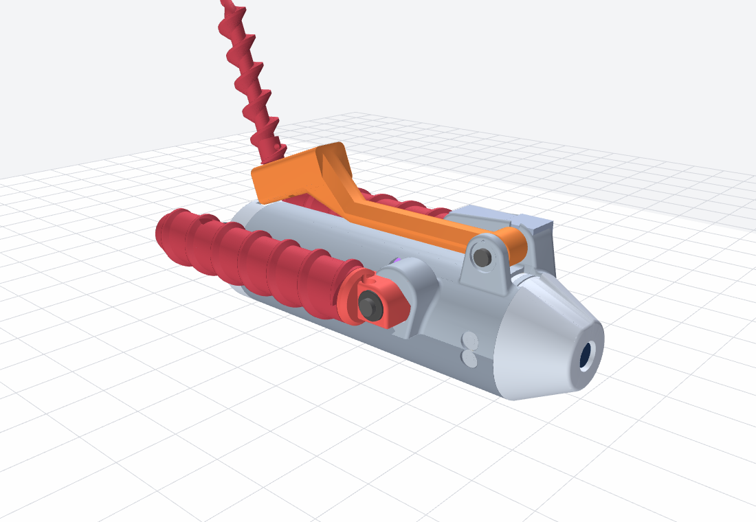
kedge/out32/review/after/01_folded_34_front.png
