HarryHYu/GrappStar/kedge/out32/review/after/02_folded_34_rear.png

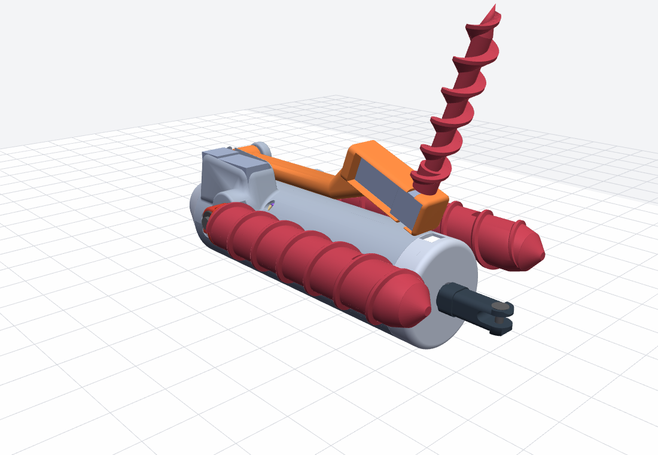
kedge/out32/review/after/02_folded_34_rear.png
