HarryHYu/GrappStar/kedge/out32/review/after/06_pod_left_deployed.png

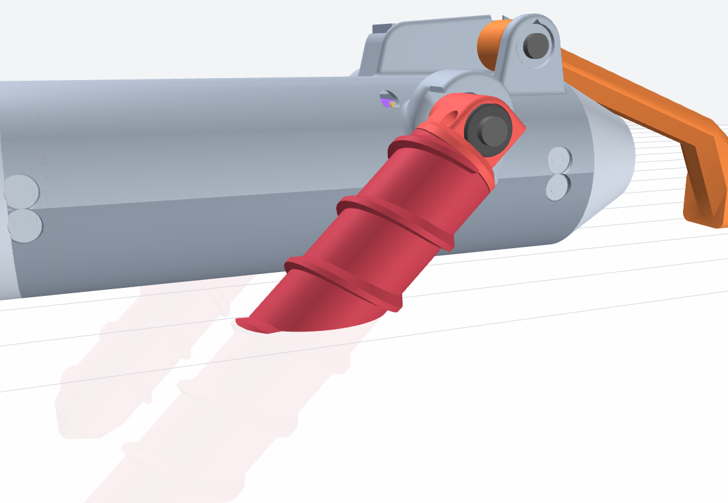
kedge/out32/review/after/06_pod_left_deployed.png
