HarryHYu/GrappStar/kedge/out32/review/after/10_kick_planted.png

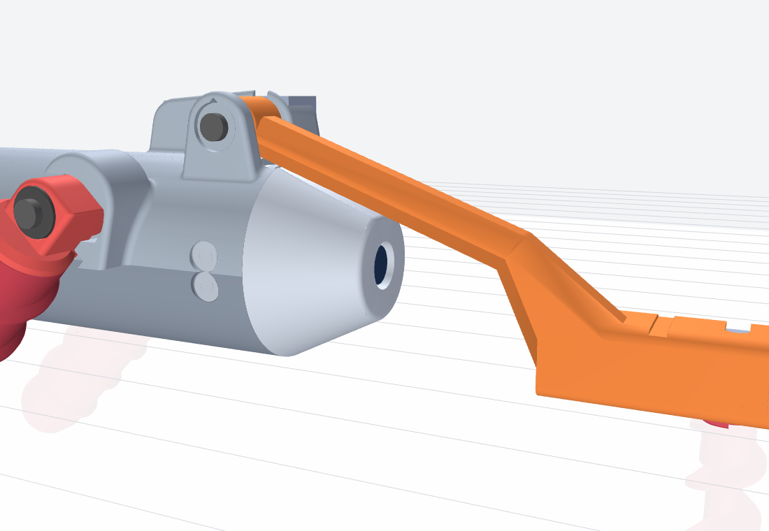
kedge/out32/review/after/10_kick_planted.png
