HarryHYu/GrappStar/kedge/out32/review/after/11_tail_boom.png

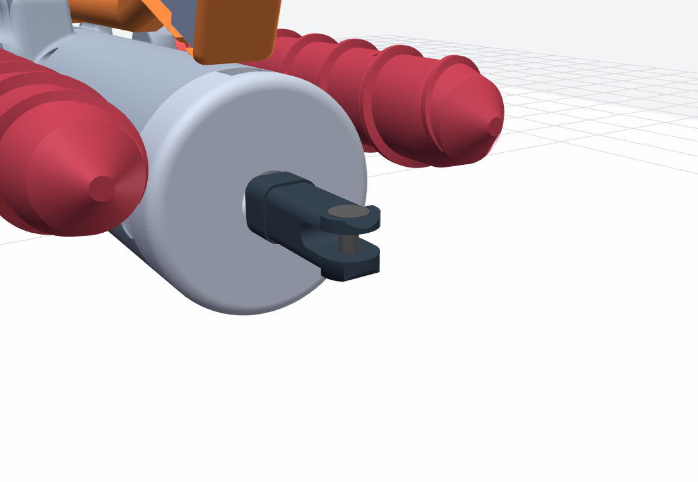
kedge/out32/review/after/11_tail_boom.png
