HarryHYu/GrappStar/kedge/out32/review/after/14_under_deployed.png

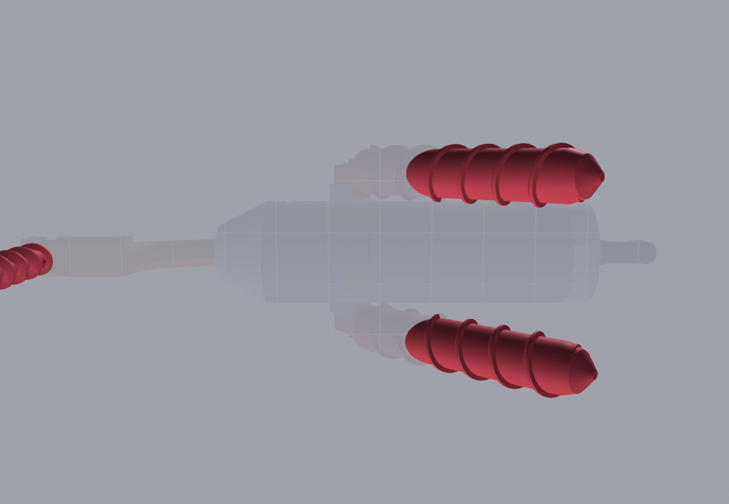
kedge/out32/review/after/14_under_deployed.png
