HarryHYu/GrappStar/kedge/out32/review/after/15_folded_left_low.png

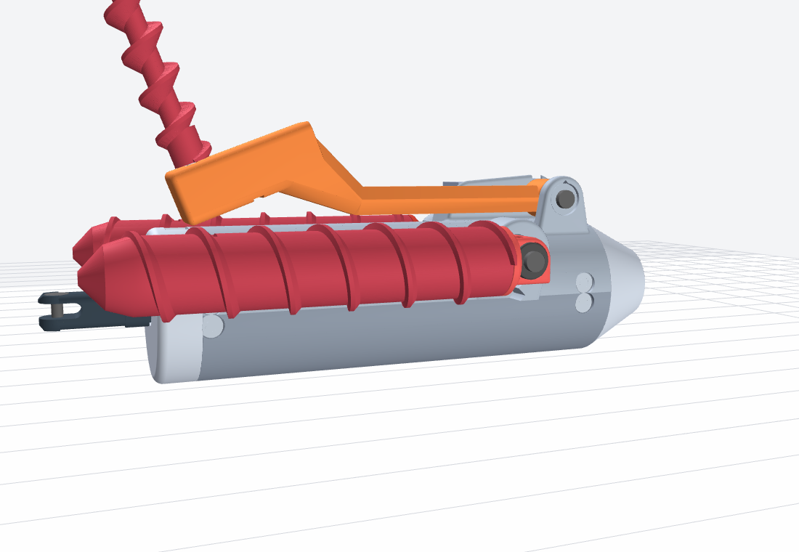
kedge/out32/review/after/15_folded_left_low.png
