HarryHYu/GrappStar/kedge/out32/review/after/16_folded_right_high.png

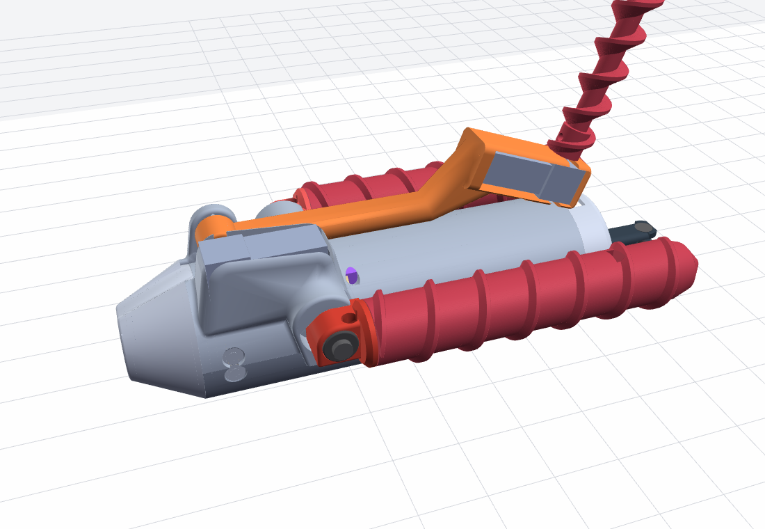
kedge/out32/review/after/16_folded_right_high.png
