HarryHYu/GrappStar/kedge/out32/review/after/18_kick_mid_120.png

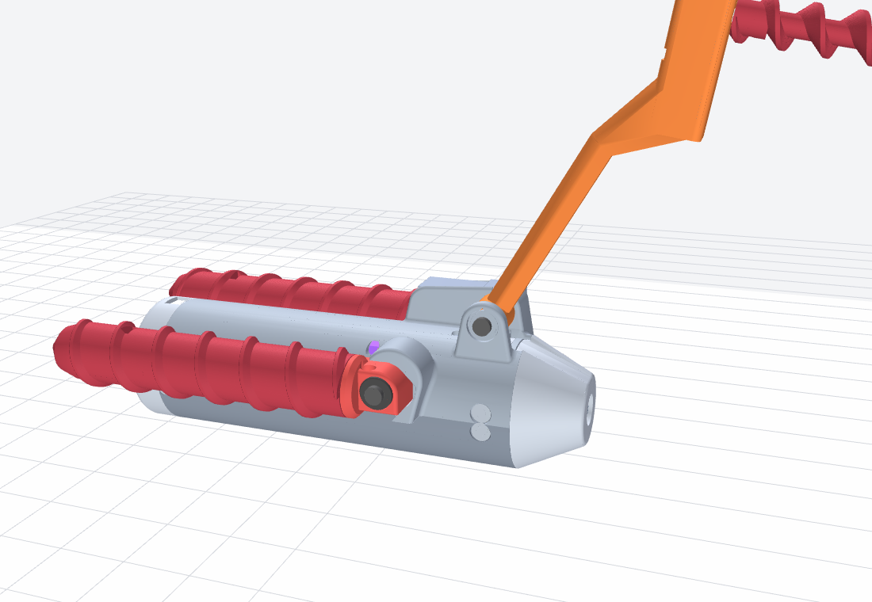
kedge/out32/review/after/18_kick_mid_120.png
