HarryHYu/GrappStar/kedge/out32/review/after/audit_sheet.png

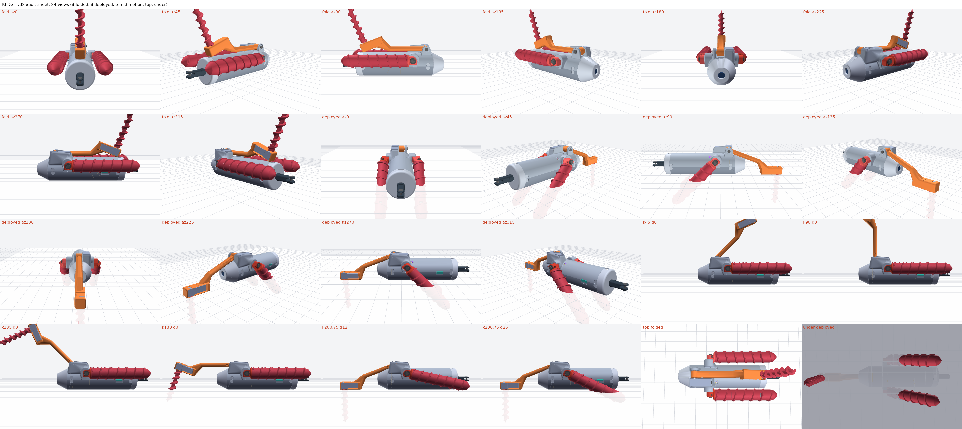
kedge/out32/review/after/audit_sheet.png
