HarryHYu/GrappStar/kedge/out32/review/after/sections.png

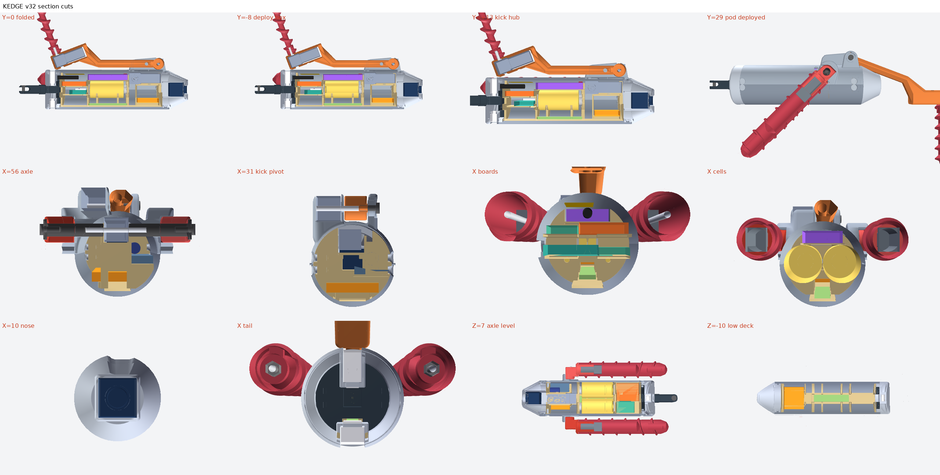
kedge/out32/review/after/sections.png
