HarryHYu/GrappStar/kedge/out32/review/after/v32c_now.png

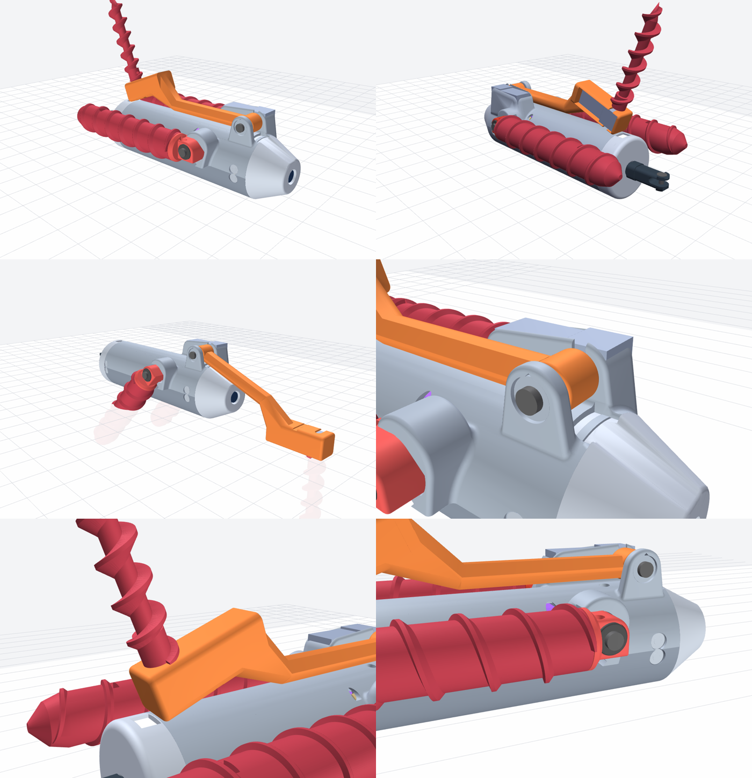
kedge/out32/review/after/v32c_now.png
