HarryHYu/GrappStar/kedge/out33/review/07_pod_right_folded_low.png

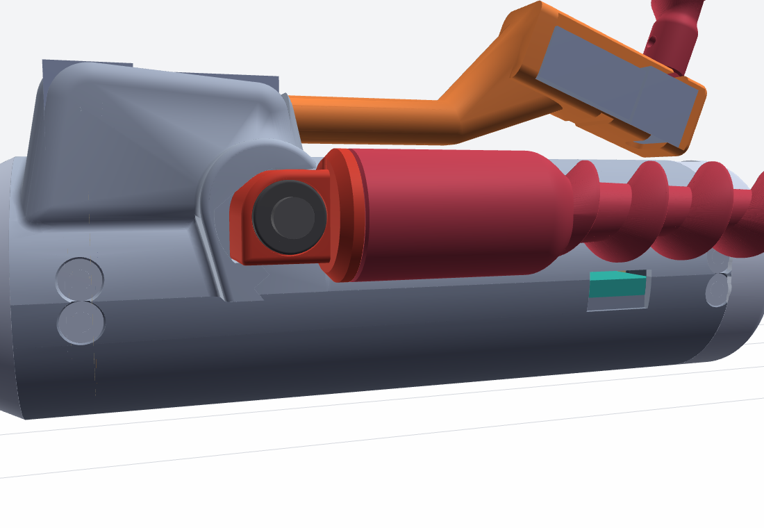
kedge/out33/review/07_pod_right_folded_low.png
