HarryHYu/GrappStar/kedge/out33/review/09_foot_folded.png

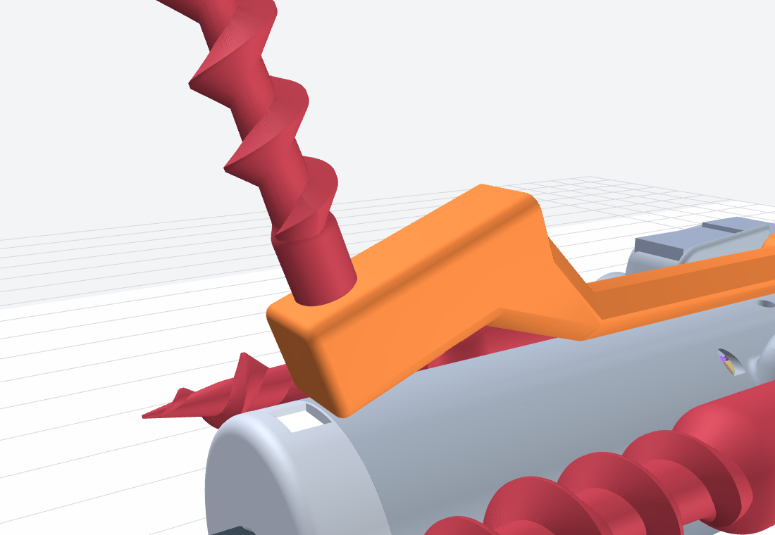
kedge/out33/review/09_foot_folded.png
