HarryHYu/GrappStar/kedge/out33/review/11_tail_boom.png

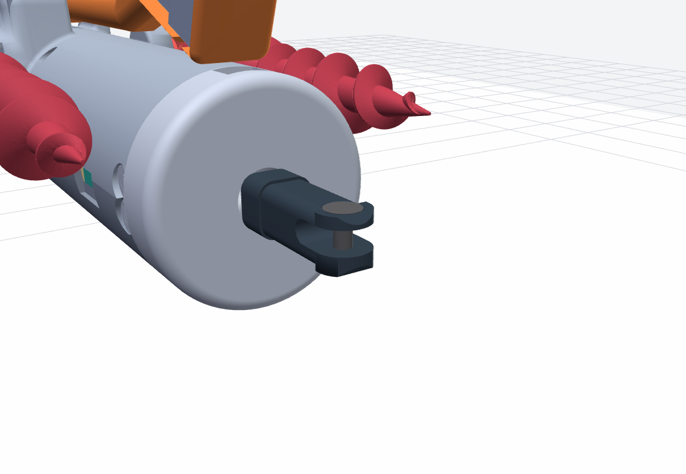
kedge/out33/review/11_tail_boom.png
