HarryHYu/GrappStar/kedge/out34/review/03_deployed_34_front.png

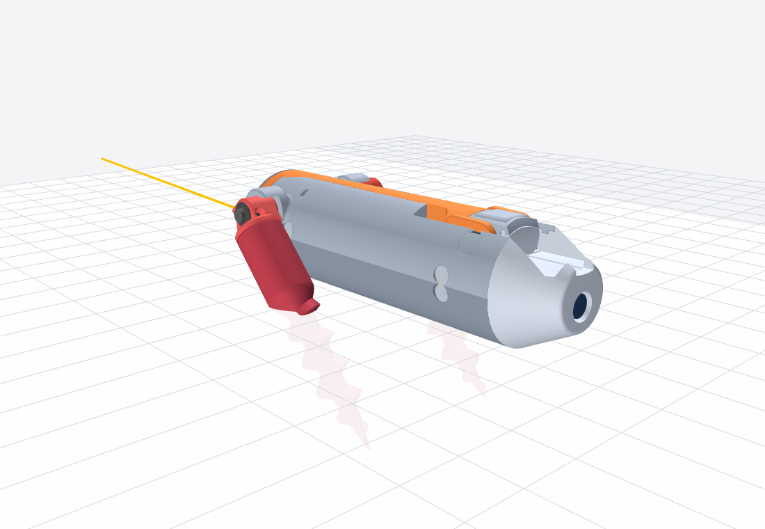
kedge/out34/review/03_deployed_34_front.png
