HarryHYu/GrappStar/kedge/out34/review/04_deployed_side.png

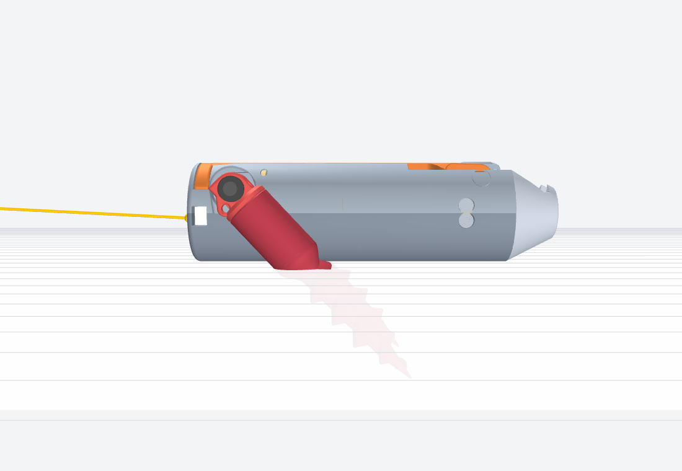
kedge/out34/review/04_deployed_side.png
