HarryHYu/GrappStar/kedge/out34/review/05_leg_178_side.png

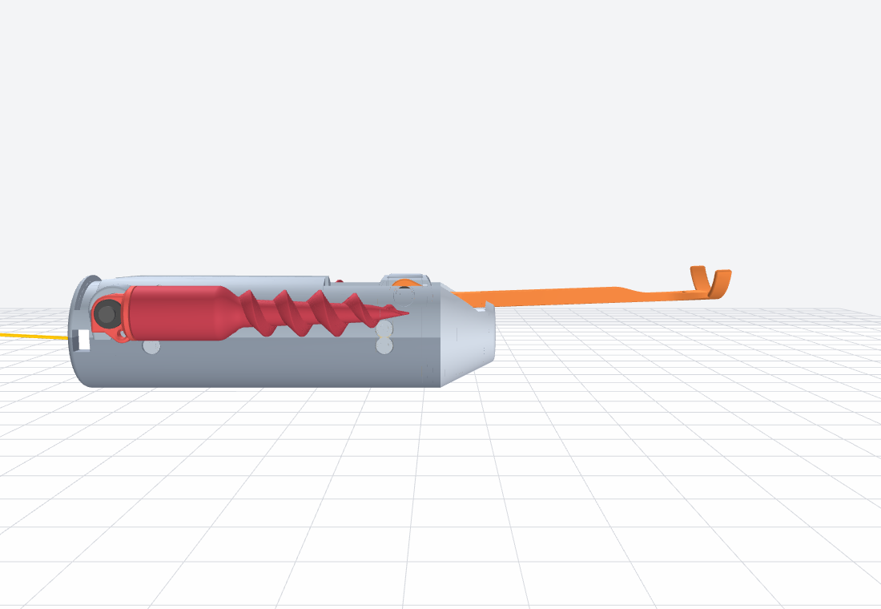
kedge/out34/review/05_leg_178_side.png
