HarryHYu/GrappStar/kedge/out34/review/06_leg_90_34.png

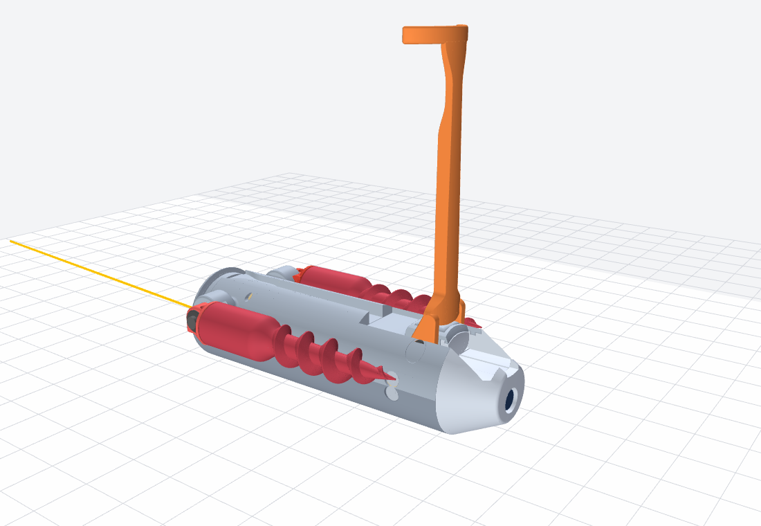
kedge/out34/review/06_leg_90_34.png
