HarryHYu/GrappStar/kedge/out34/review/07_hinge_close.png

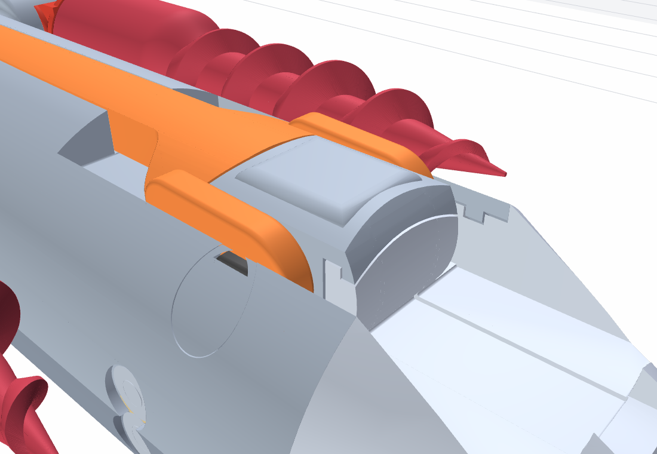
kedge/out34/review/07_hinge_close.png
