HarryHYu/GrappStar/kedge/out34/review/08_hinge_close_rear.png

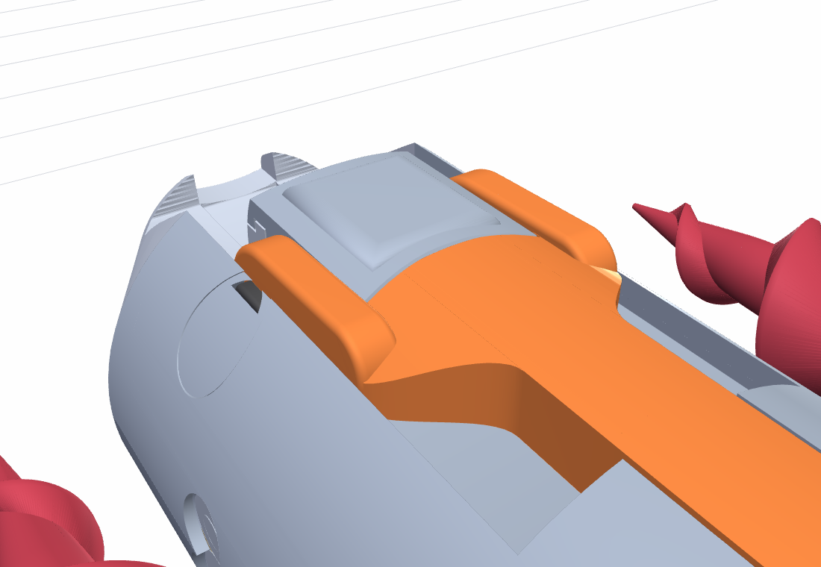
kedge/out34/review/08_hinge_close_rear.png
