HarryHYu/GrappStar/kedge/out34/review/09_tail_pad.png

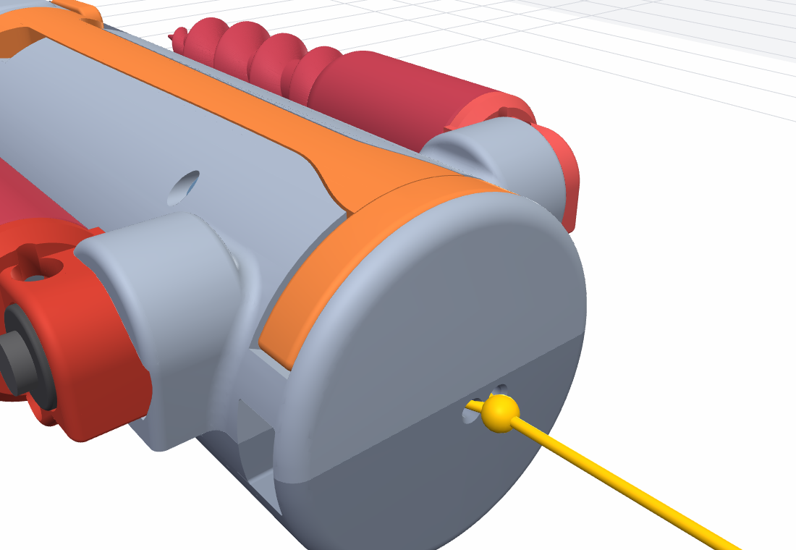
kedge/out34/review/09_tail_pad.png
