HarryHYu/GrappStar/kedge/out34/review/10_pod_rear_folded.png

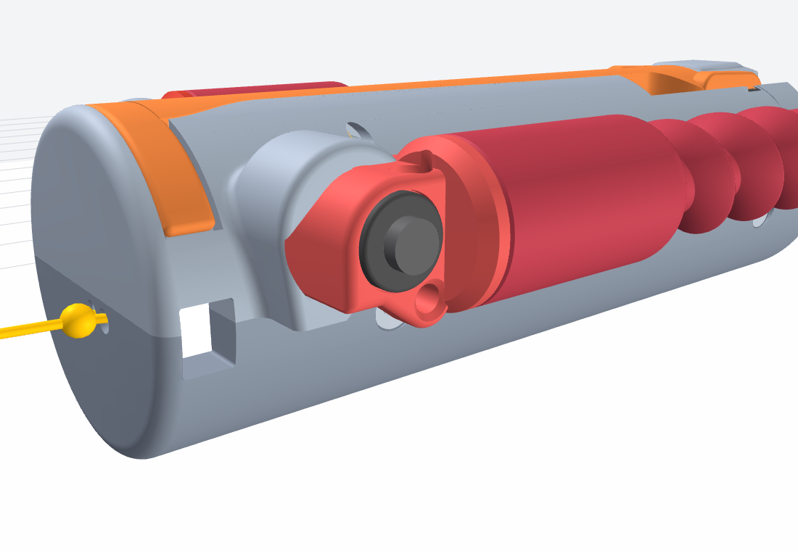
kedge/out34/review/10_pod_rear_folded.png
