HarryHYu/GrappStar/kedge/out34/review/11_pod_rear_deployed.png

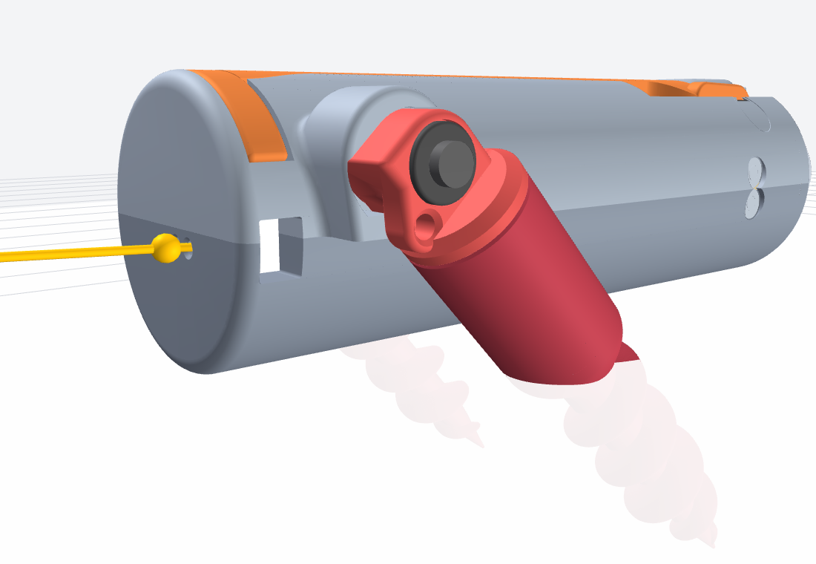
kedge/out34/review/11_pod_rear_deployed.png
