HarryHYu/GrappStar/kedge/out34/review/12_nose.png

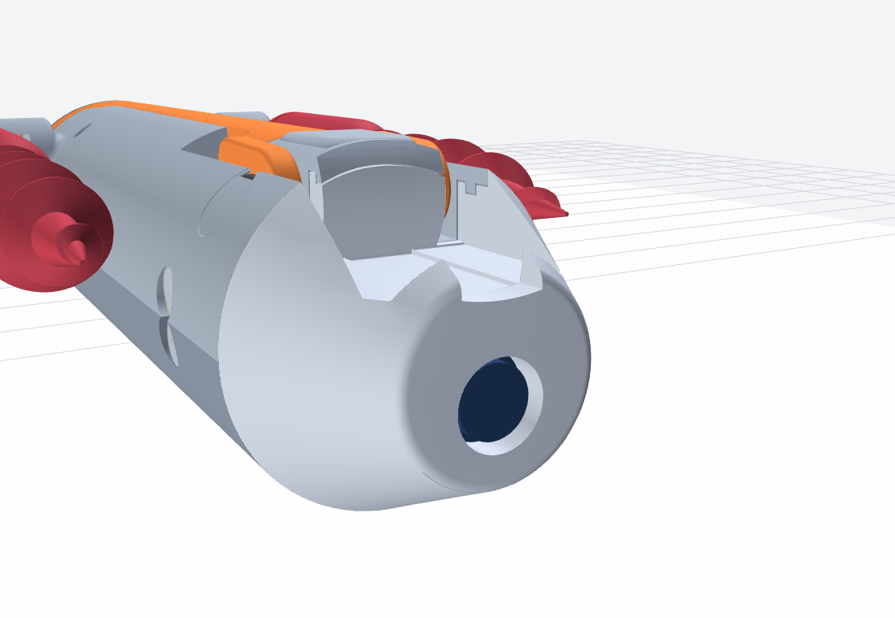
kedge/out34/review/12_nose.png
