HarryHYu/GrappStar/kedge/out34/review/14_under_deployed.png

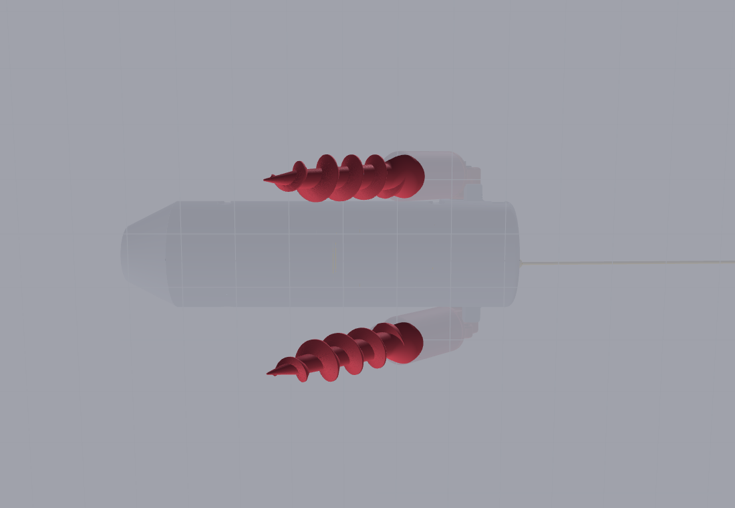
kedge/out34/review/14_under_deployed.png
