HarryHYu/GrappStar/kedge/out34/review/17_leg_45_hinge.png

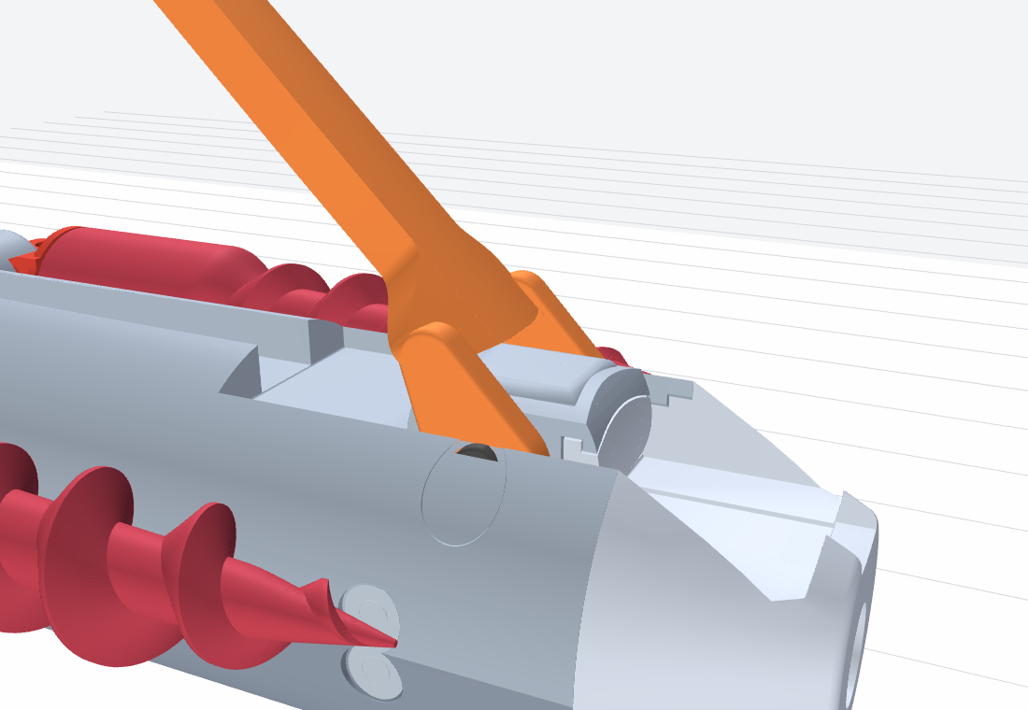
kedge/out34/review/17_leg_45_hinge.png
