HarryHYu/GrappStar/kedge/out34/review/18_leg_178_nose.png

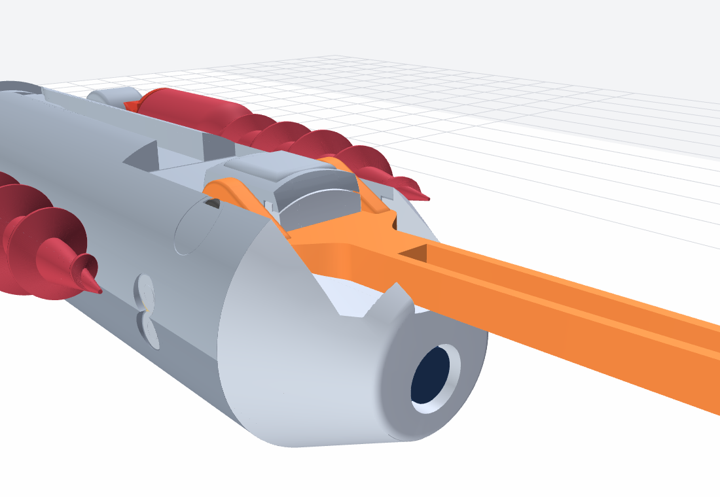
kedge/out34/review/18_leg_178_nose.png
