HarryHYu/GrappStar/kedge/out34/review/19_section_y0_folded.png

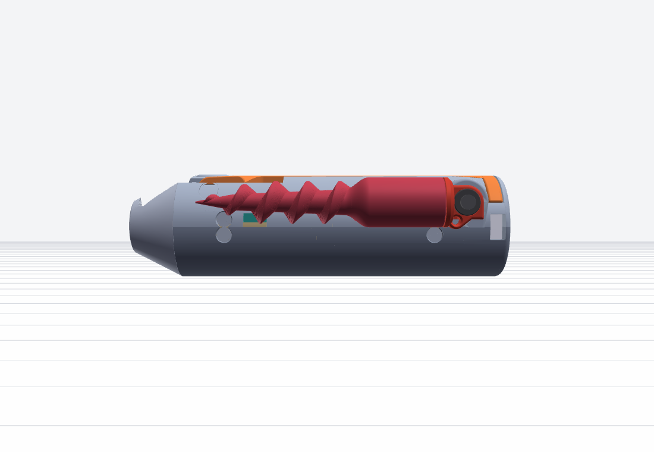
kedge/out34/review/19_section_y0_folded.png
