HarryHYu/GrappStar/kedge/out34/review/20_section_pivot.png

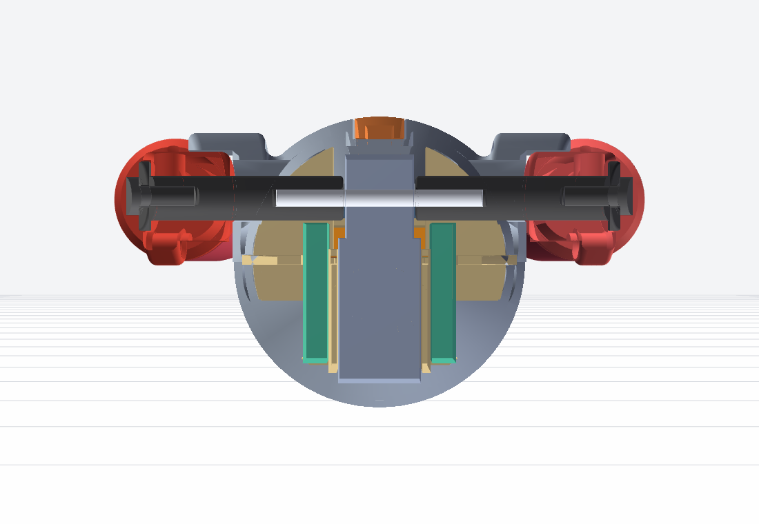
kedge/out34/review/20_section_pivot.png
