HarryHYu/GrappStar/kedge/out34/review/22_pods_deployed_rear_low.png

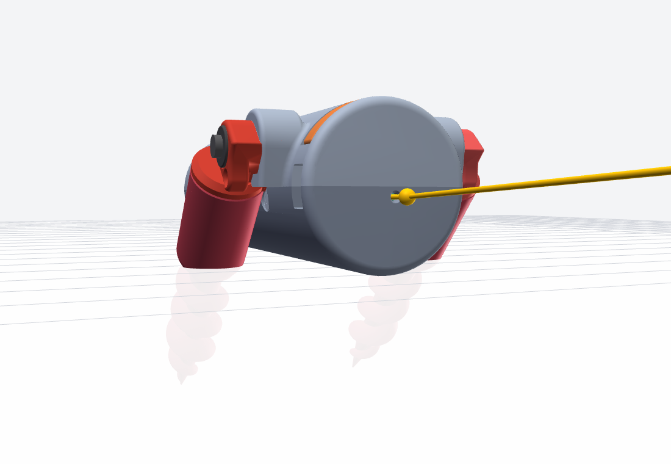
kedge/out34/review/22_pods_deployed_rear_low.png
