HarryHYu/GrappStar/kedge/out34/review/c01_nose_putty_y0.png

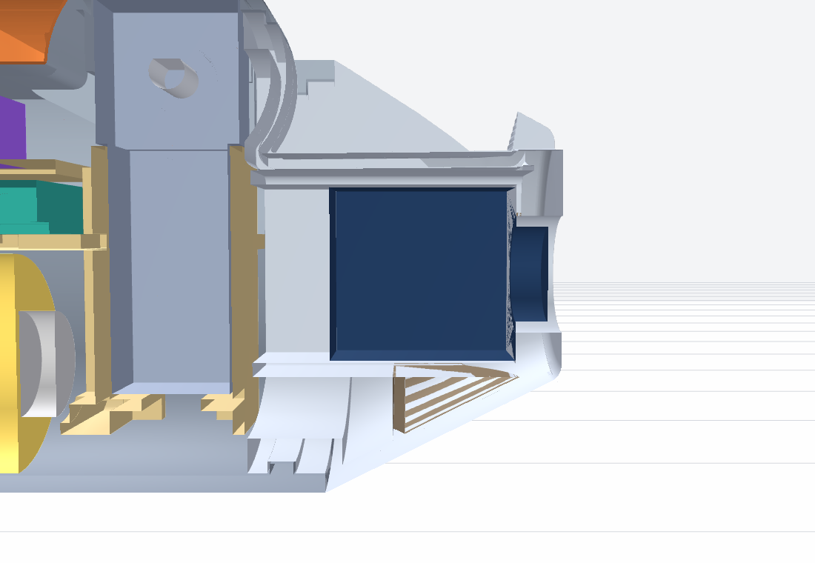
kedge/out34/review/c01_nose_putty_y0.png
