HarryHYu/GrappStar/kedge/out34/review/c03_nose_rear_x20.png

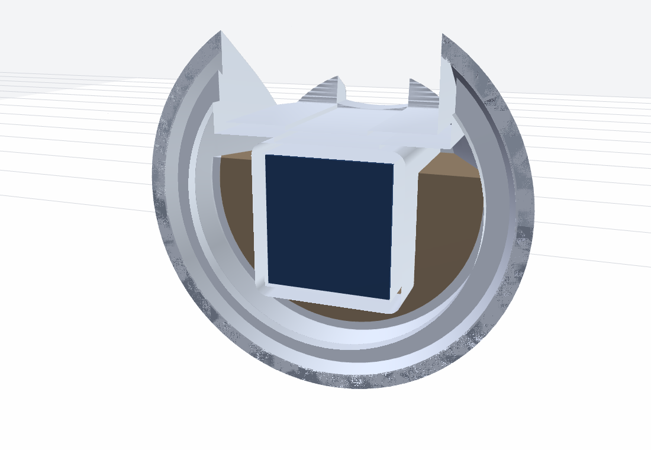
kedge/out34/review/c03_nose_rear_x20.png
