HarryHYu/GrappStar/kedge/out34/review/c08_bosses_plan_z3.png

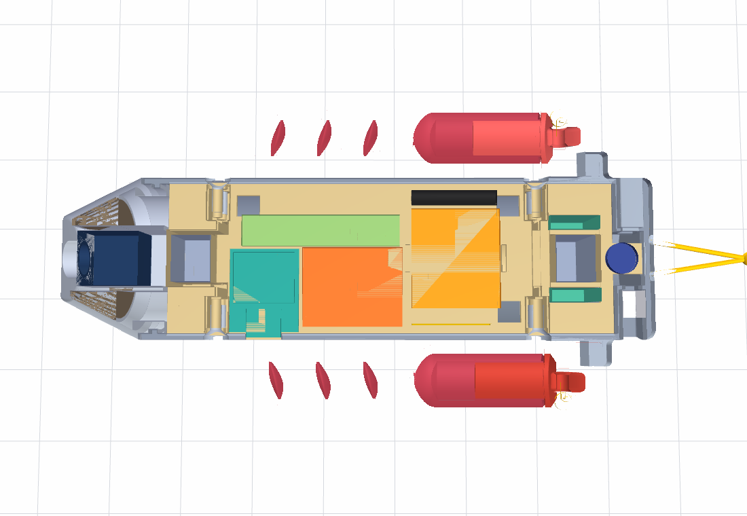
kedge/out34/review/c08_bosses_plan_z3.png
