HarryHYu/GrappStar/kedge/out34/review/c11_pivot_x132.png

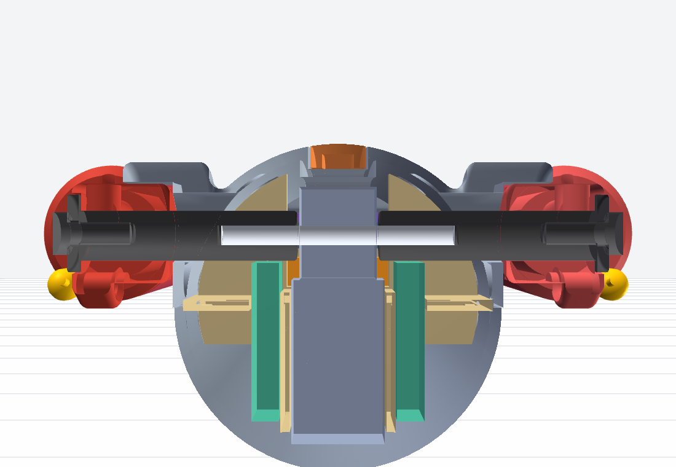
kedge/out34/review/c11_pivot_x132.png
