HarryHYu/GrappStar/kedge/out34/review/c18_saddle_x54.png

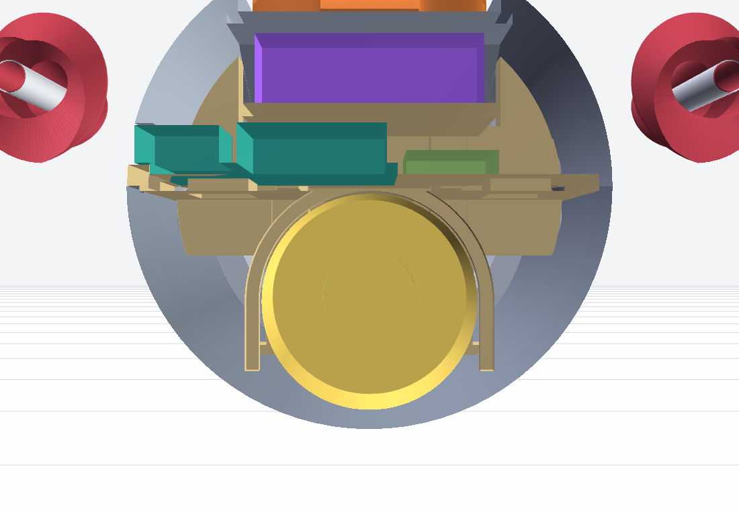
kedge/out34/review/c18_saddle_x54.png
