HarryHYu/GrappStar/kedge/out34/review/c20_usb_x52.png

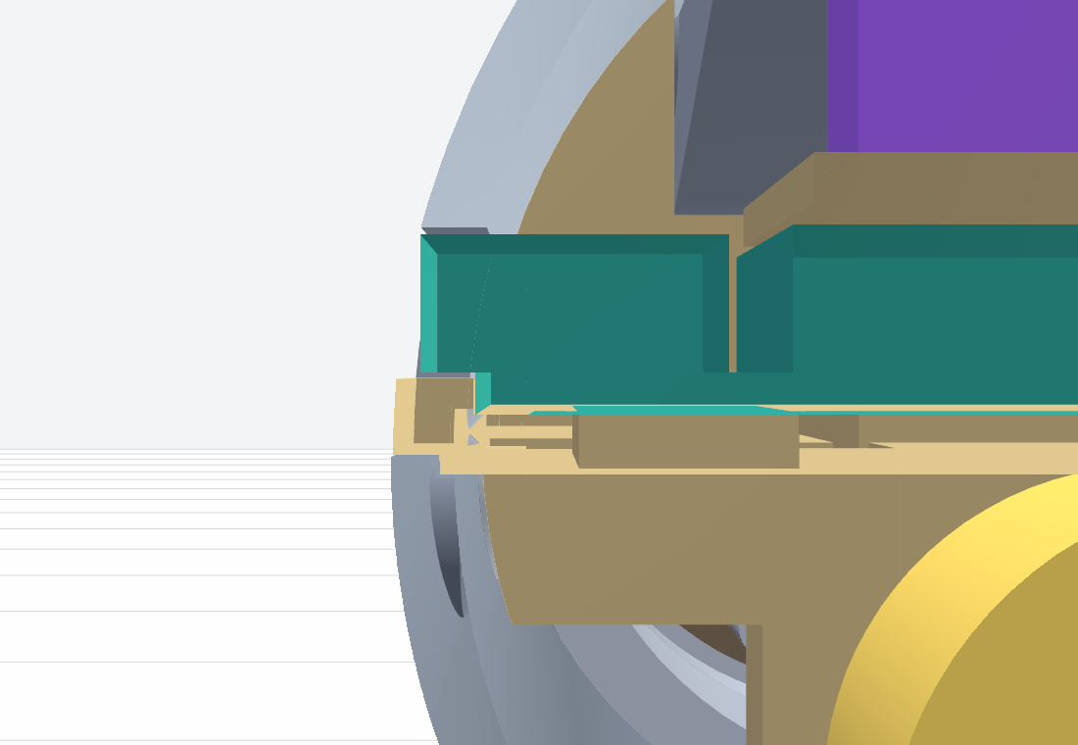
kedge/out34/review/c20_usb_x52.png
