HarryHYu/GrappStar/kedge/out34/review/c21_capacitor_open.png

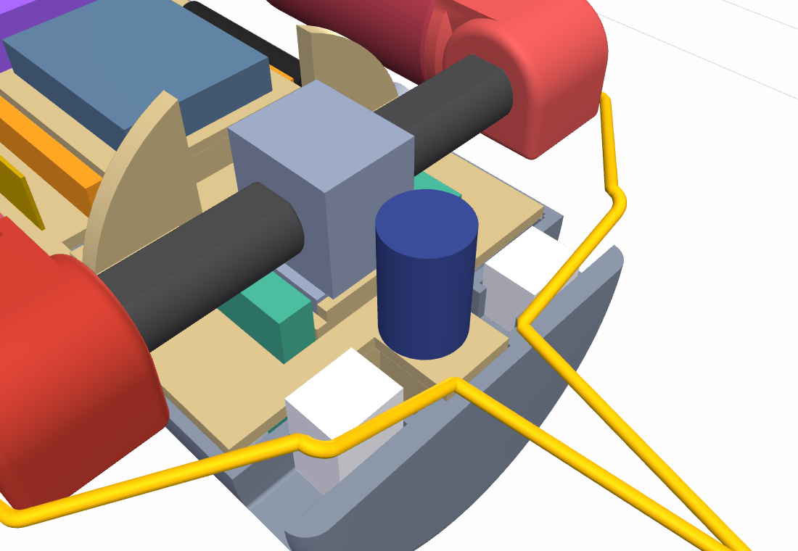
kedge/out34/review/c21_capacitor_open.png
