HarryHYu/GrappStar/kedge/out34/review/c22_plug_rope_left.png

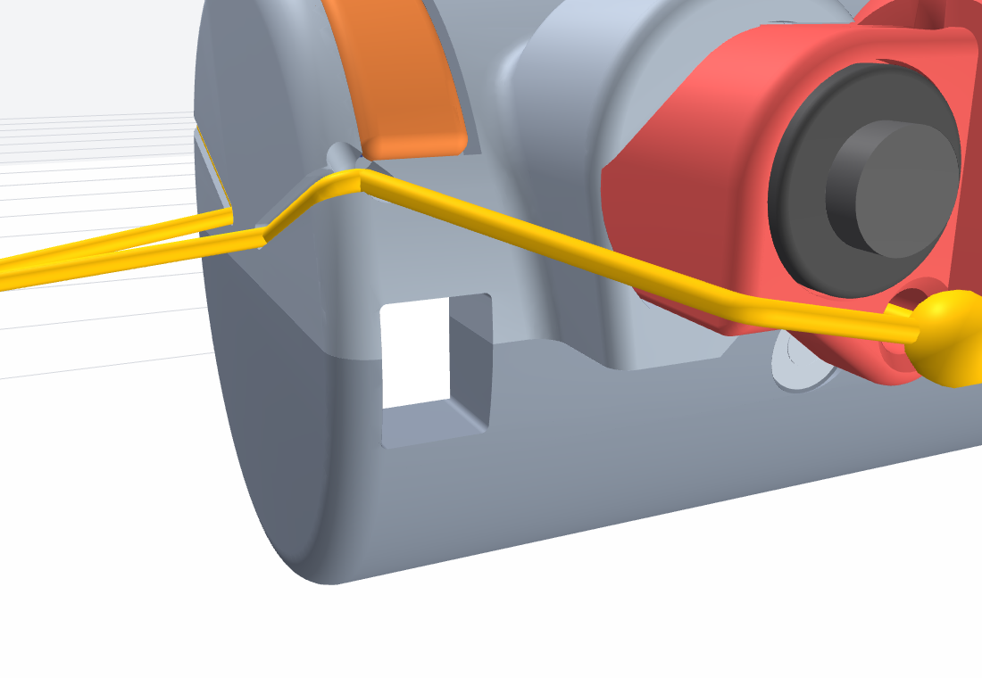
kedge/out34/review/c22_plug_rope_left.png
