HarryHYu/GrappStar/kedge/out34/review/c23_saddles_side_open.png

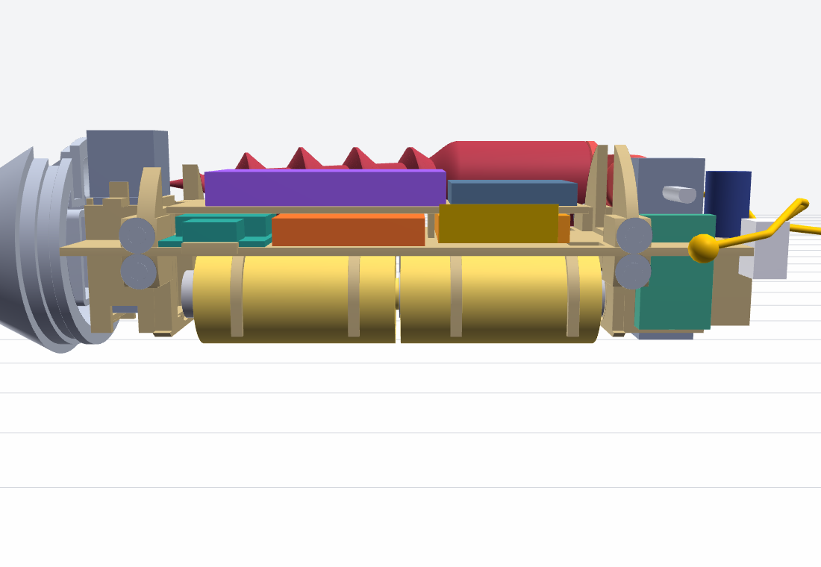
kedge/out34/review/c23_saddles_side_open.png
