HarryHYu/GrappStar/kedge/out34/review/c24_putty_nose_open.png

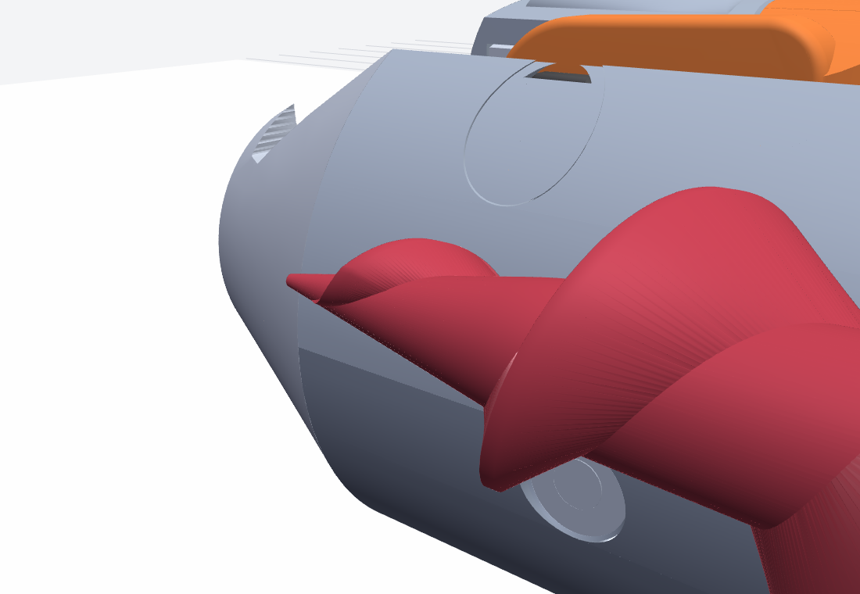
kedge/out34/review/c24_putty_nose_open.png
