HarryHYu/GrappStar/kedge/out34/review/h2_34_noleg.png

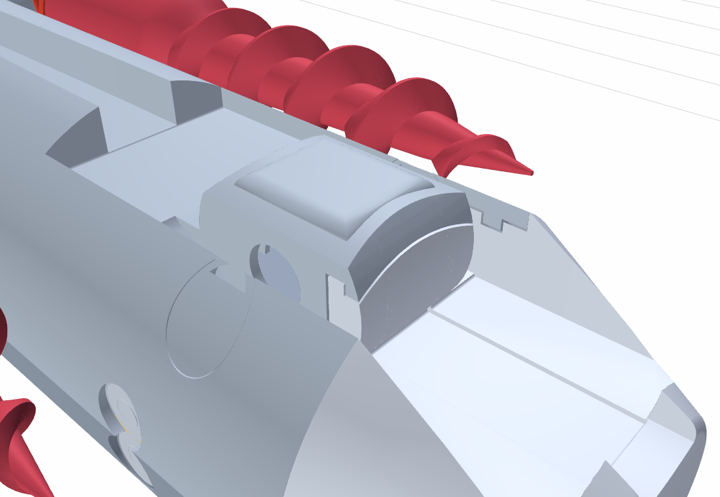
kedge/out34/review/h2_34_noleg.png
