HarryHYu/GrappStar/kedge/out34/review/L1_top_folded.png

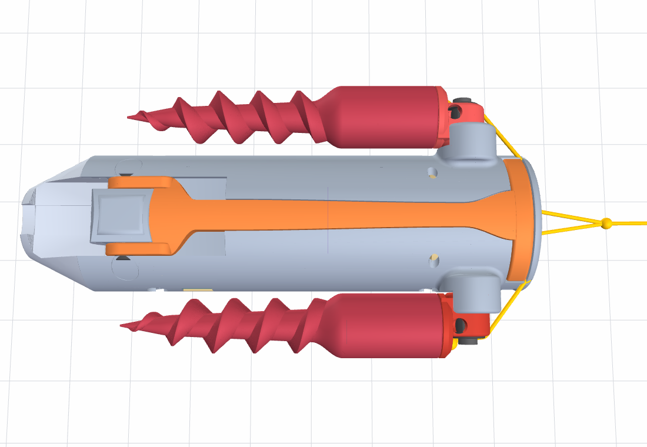
kedge/out34/review/L1_top_folded.png
