HarryHYu/GrappStar/kedge/out34/review/L3_pad_close.png

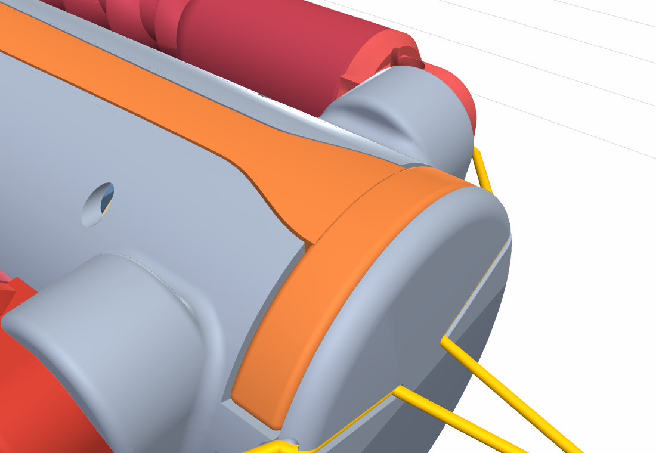
kedge/out34/review/L3_pad_close.png
