HarryHYu/GrappStar/kedge/out34/review/L4_folded_34_rear_high.png

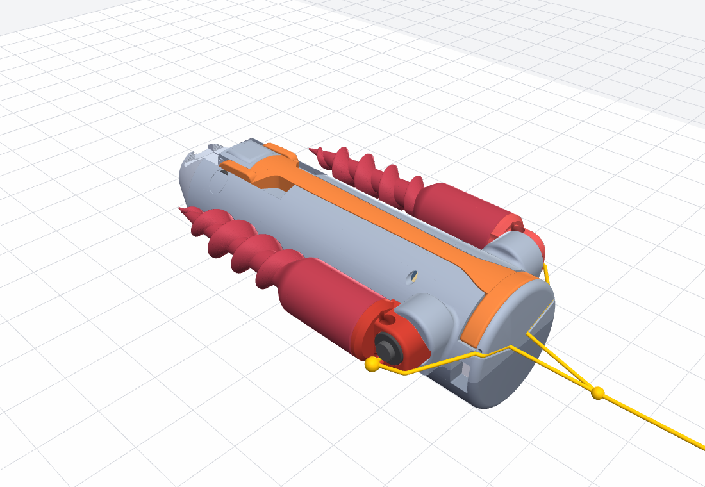
kedge/out34/review/L4_folded_34_rear_high.png
