HarryHYu/GrappStar/kedge/out34/review/pub/p1_folded_front34.png

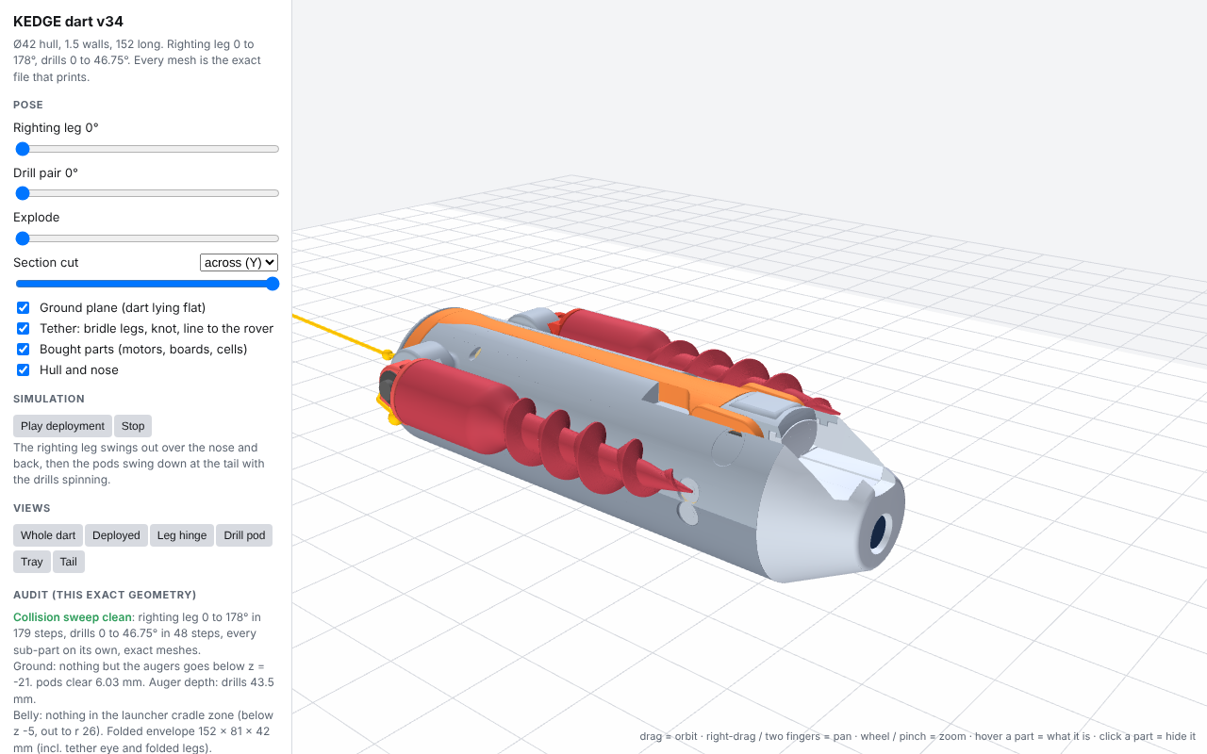
kedge/out34/review/pub/p1_folded_front34.png
