HarryHYu/GrappStar/kedge/out35/_c03.png

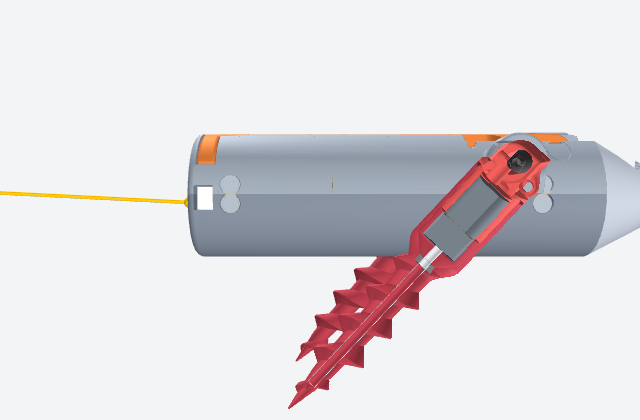
kedge/out35/_c03.png
