HarryHYu/GrappStar/kedge/out35/_c04.png

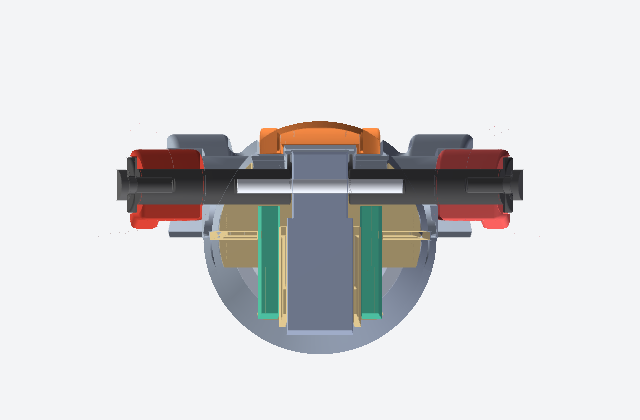
kedge/out35/_c04.png
