HarryHYu/GrappStar/kedge/out35/_c06.png

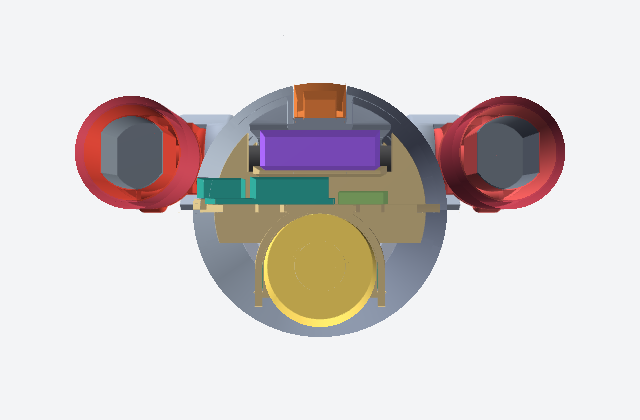
kedge/out35/_c06.png
