HarryHYu/GrappStar/kedge/out35/_s00.png

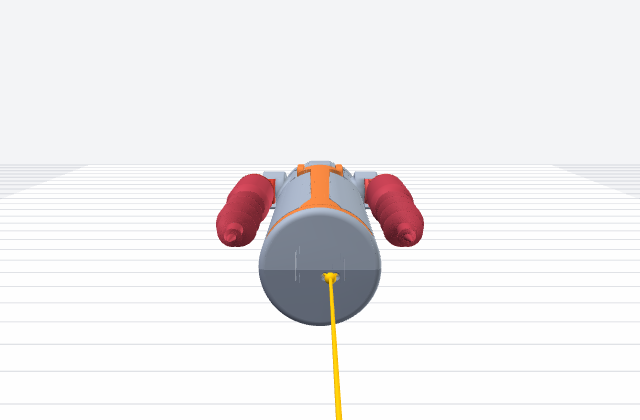
kedge/out35/_s00.png
