HarryHYu/GrappStar/kedge/out35/_s03.png

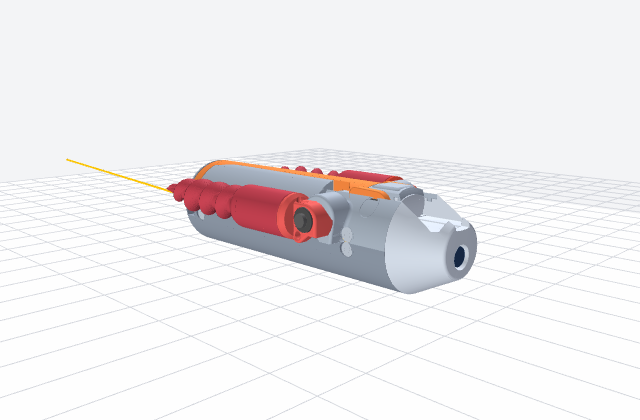
kedge/out35/_s03.png
