HarryHYu/GrappStar/kedge/out35/_s04.png

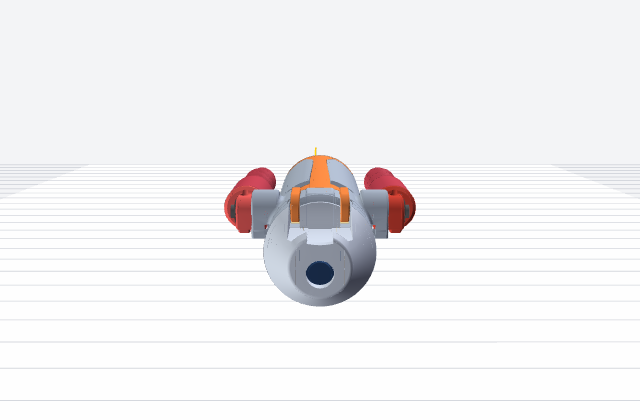
kedge/out35/_s04.png
