HarryHYu/GrappStar/kedge/out35/_s07.png

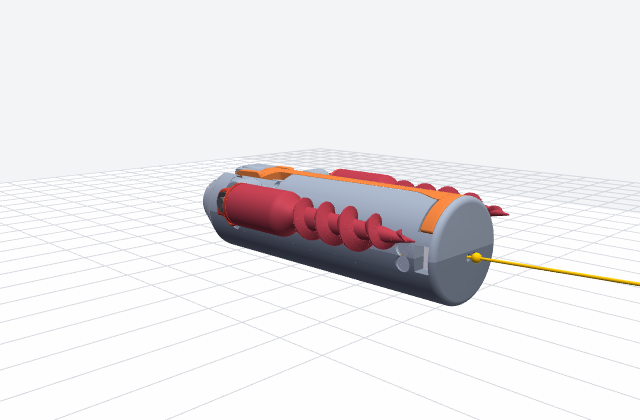
kedge/out35/_s07.png
