HarryHYu/GrappStar/kedge/out35/_s11.png

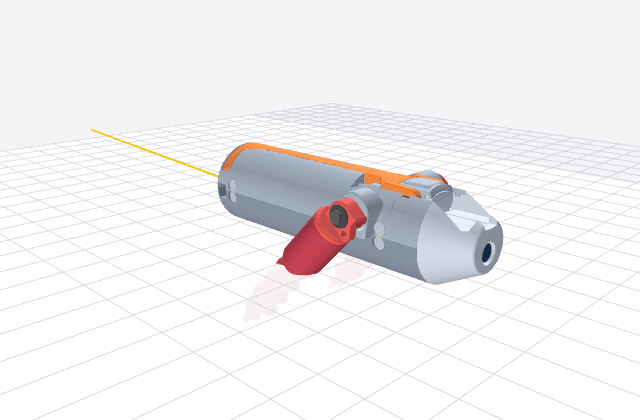
kedge/out35/_s11.png
