HarryHYu/GrappStar/kedge/out35/_s14.png

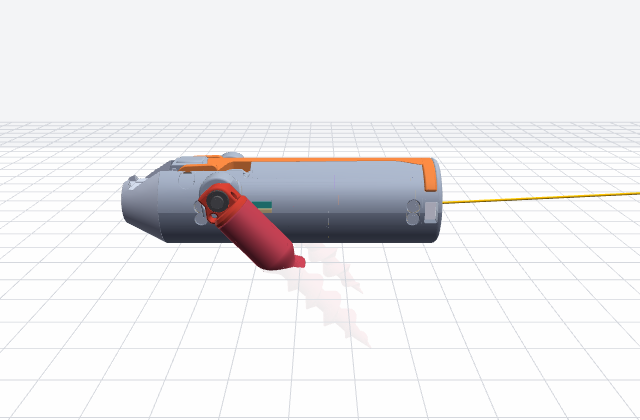
kedge/out35/_s14.png
