HarryHYu/GrappStar/kedge/out35/_s18.png

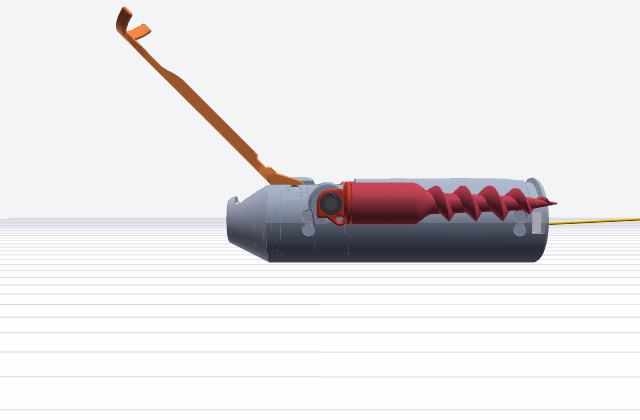
kedge/out35/_s18.png
