HarryHYu/GrappStar/kedge/out35/_s21.png

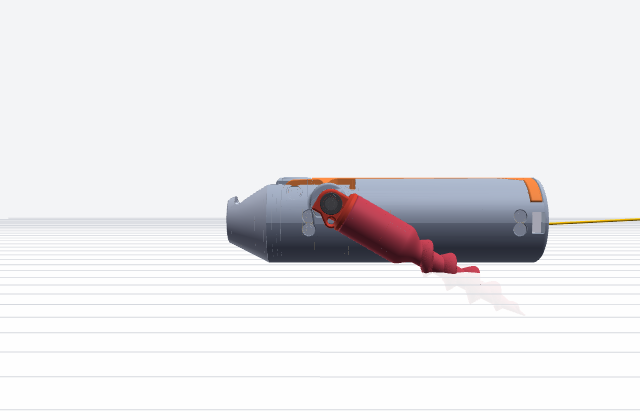
kedge/out35/_s21.png
