HarryHYu/GrappStar/kedge/out35/_s22.png

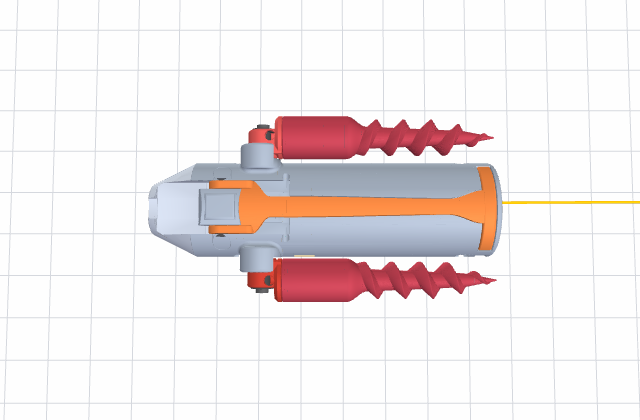
kedge/out35/_s22.png
