HarryHYu/GrappStar/kedge/out35/img_deployed_side.png

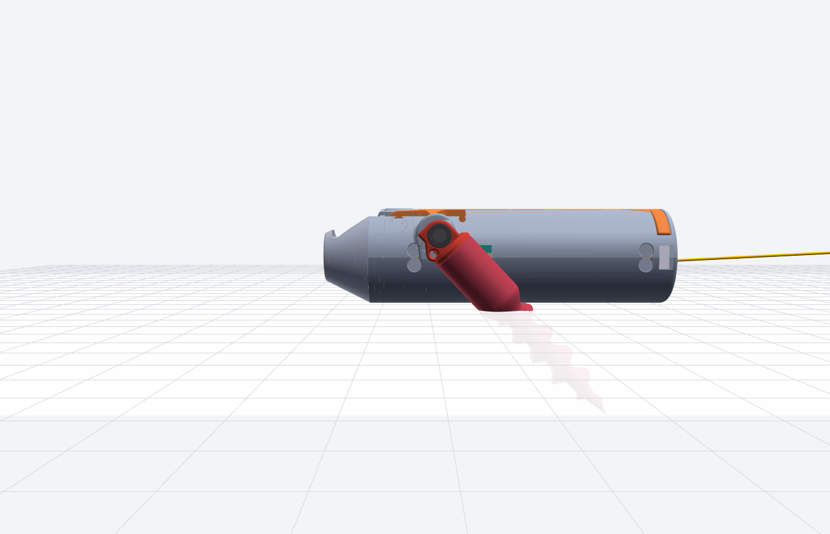
kedge/out35/img_deployed_side.png
