HarryHYu/GrappStar/kedge/out35/img_exploded.png

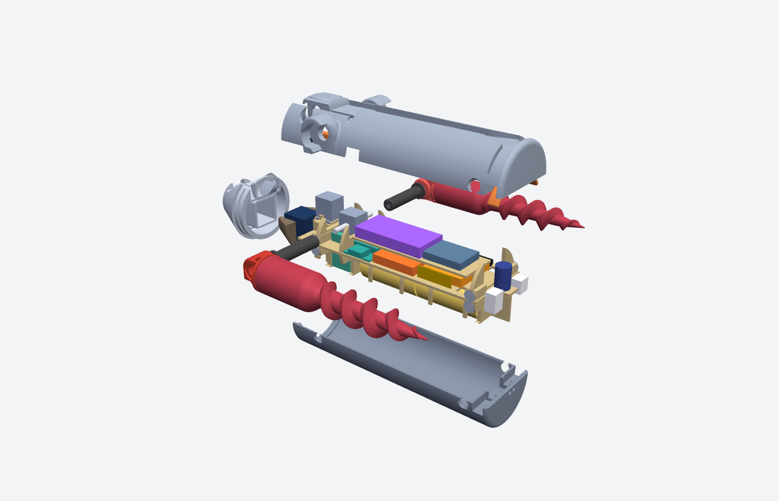
kedge/out35/img_exploded.png
