HarryHYu/GrappStar/kedge/out35/img_kick_hub.png

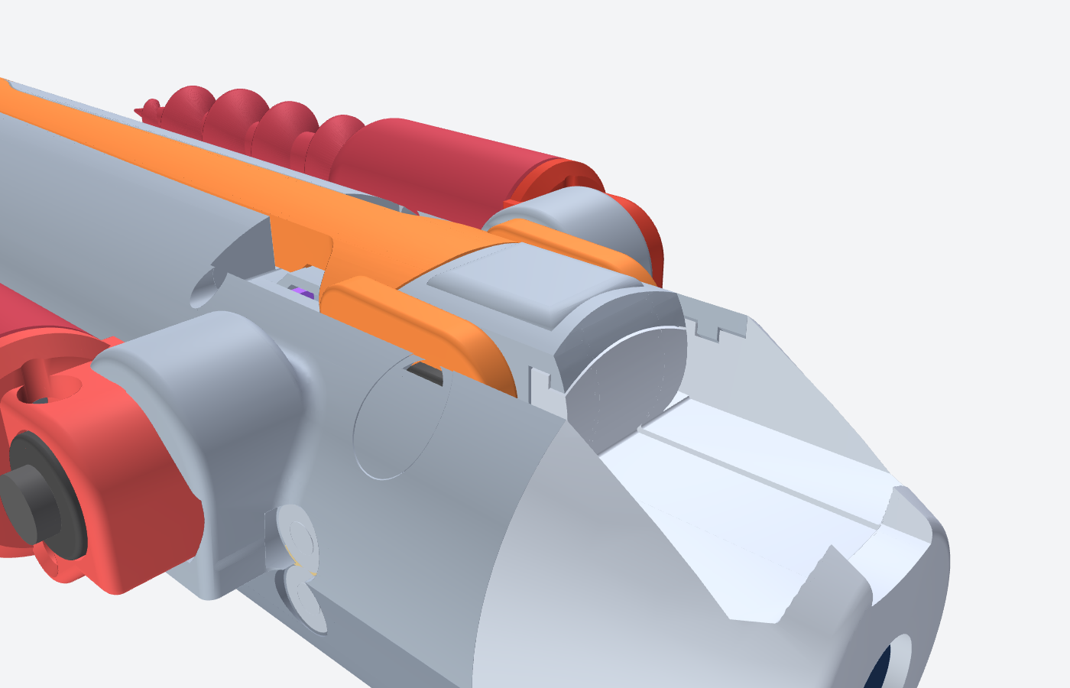
kedge/out35/img_kick_hub.png
