HarryHYu/GrappStar/kedge/out35/img_pod_section.png

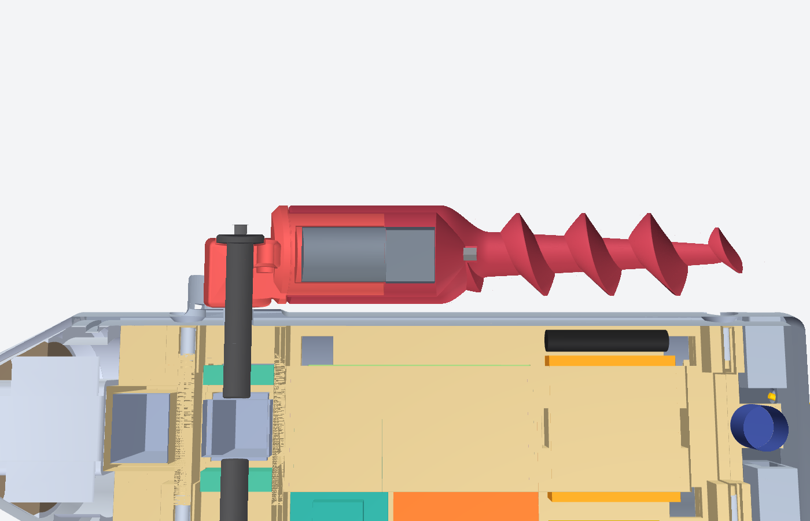
kedge/out35/img_pod_section.png
