HarryHYu/GrappStar/kedge/out35/img_stage2_in_bottom.png

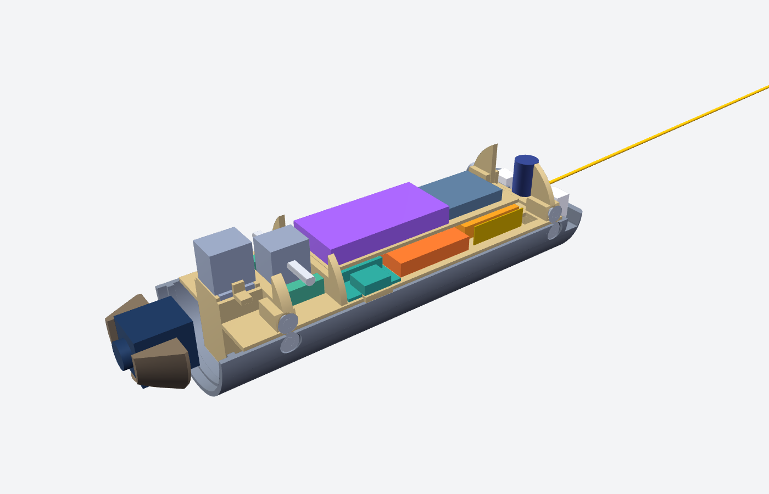
kedge/out35/img_stage2_in_bottom.png
