HarryHYu/GrappStar/kedge/out35/img_stage3_closed.png

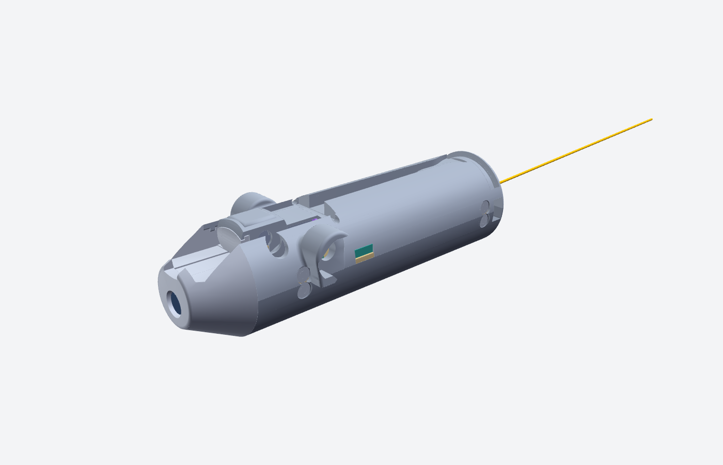
kedge/out35/img_stage3_closed.png
