HarryHYu/GrappStar/kedge/out35/img_tray_populated.png

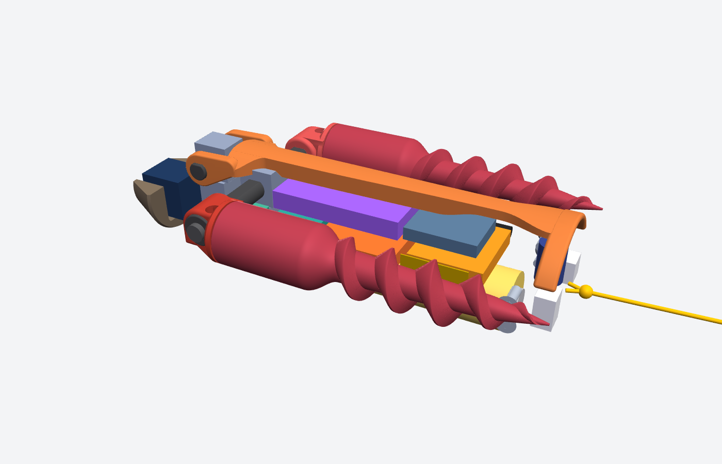
kedge/out35/img_tray_populated.png
