HarryHYu/GrappStar/kedge/out35/review/08_hinge_close_rear.png

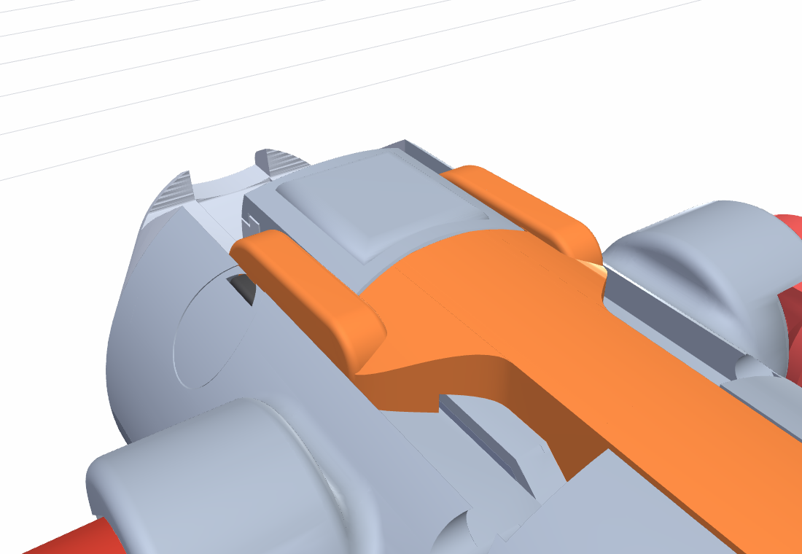
kedge/out35/review/08_hinge_close_rear.png
