HarryHYu/GrappStar/kedge/out35/review/09_tail_pad.png

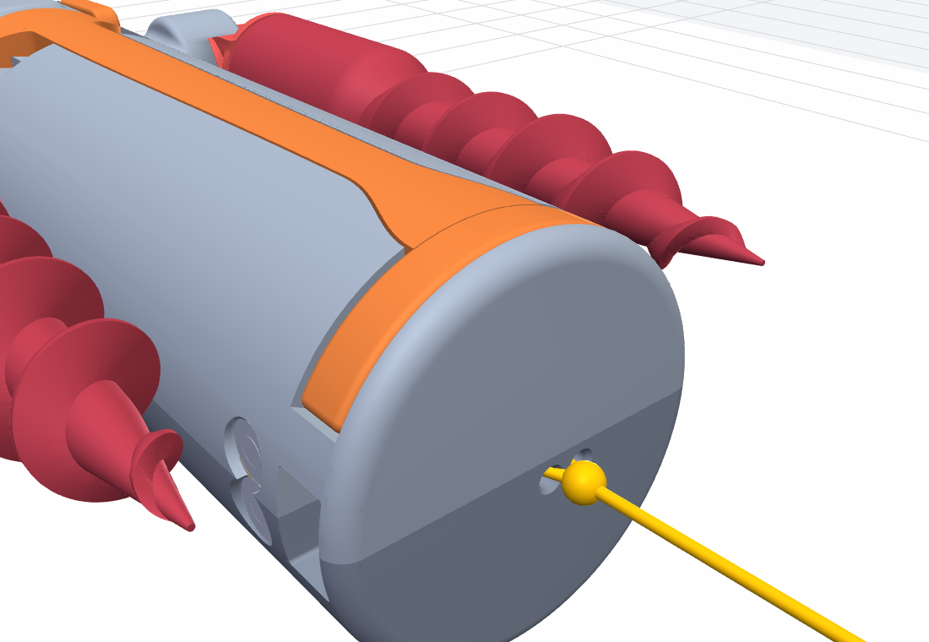
kedge/out35/review/09_tail_pad.png
