HarryHYu/GrappStar/kedge/out35/review/11_pod_rear_deployed.png

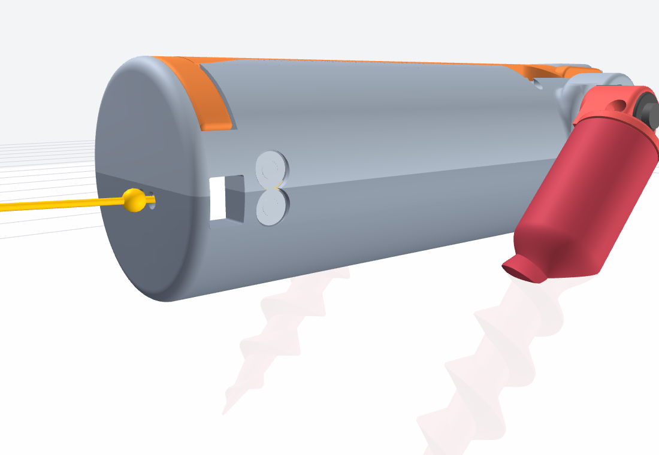
kedge/out35/review/11_pod_rear_deployed.png
