HarryHYu/GrappStar/kedge/out35/review/16_flank_sockets.png

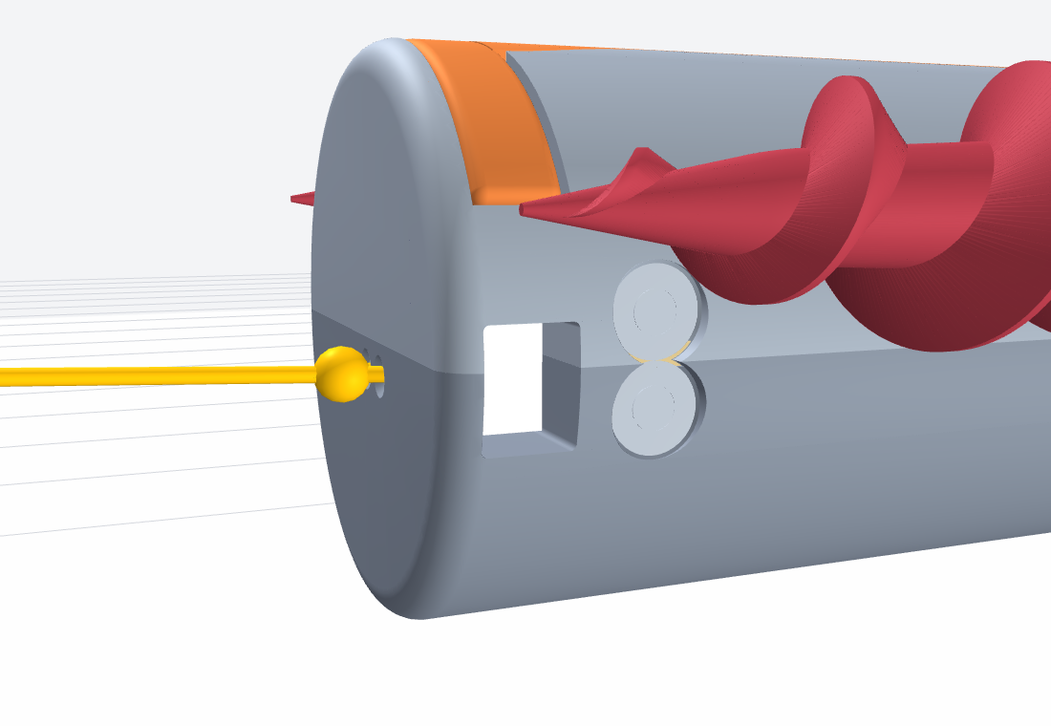
kedge/out35/review/16_flank_sockets.png
