HarryHYu/GrappStar/kedge/out35/review/21_section_hinge.png

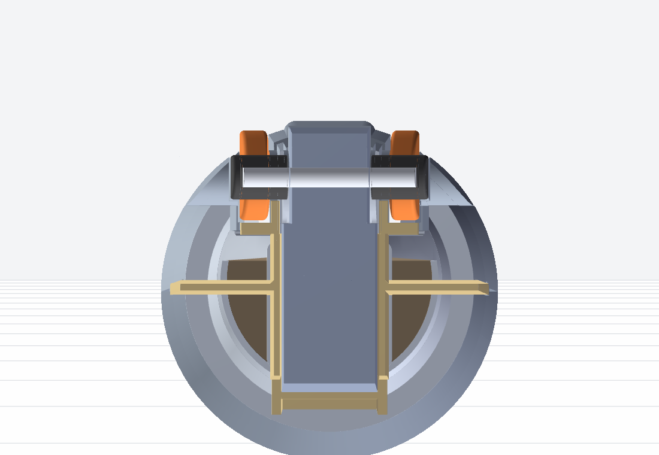
kedge/out35/review/21_section_hinge.png
