HarryHYu/GrappStar/kedge/out35/review/22_pods_deployed_rear_low.png

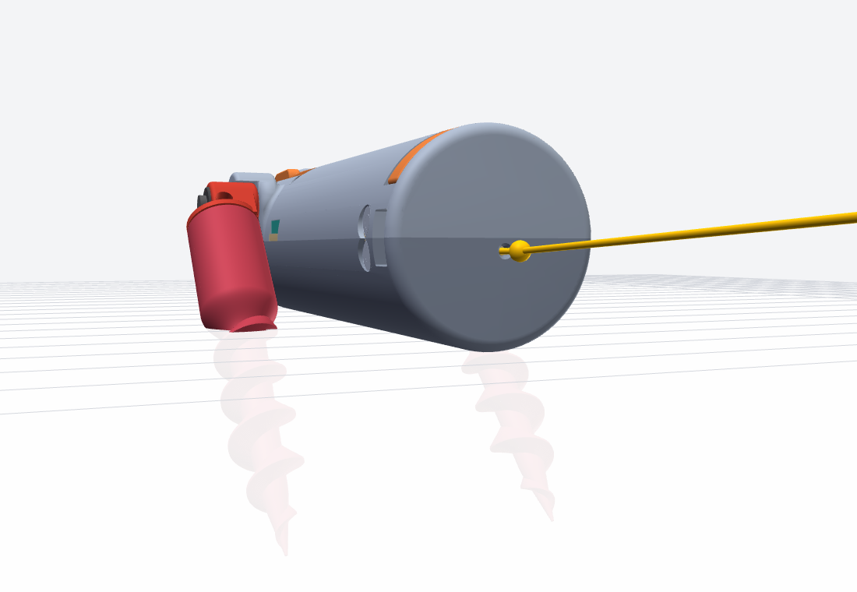
kedge/out35/review/22_pods_deployed_rear_low.png
