HarryHYu/GrappStar/kedge/out35/review/v02_leg_out_top.png

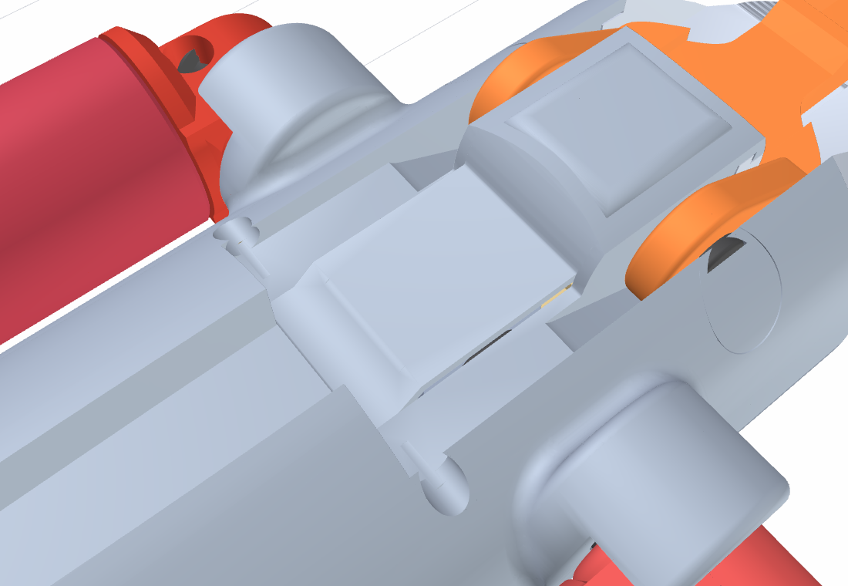
kedge/out35/review/v02_leg_out_top.png
