HarryHYu/GrappStar/kedge/out35/review/v03_leg_out_x58.png

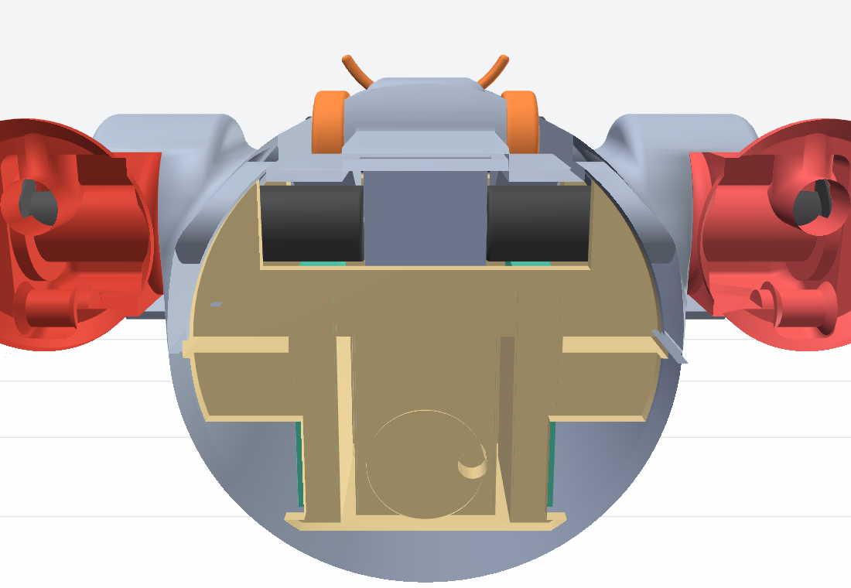
kedge/out35/review/v03_leg_out_x58.png
