HarryHYu/GrappStar/kedge/out35/review/v05_deploy_stop_left.png

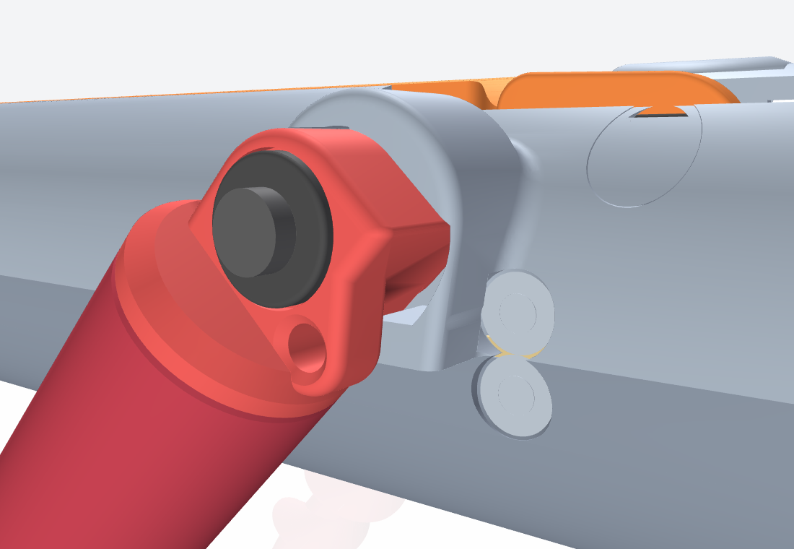
kedge/out35/review/v05_deploy_stop_left.png
