HarryHYu/GrappStar/kedge/out35/review/v08_usb_window_deployed.png

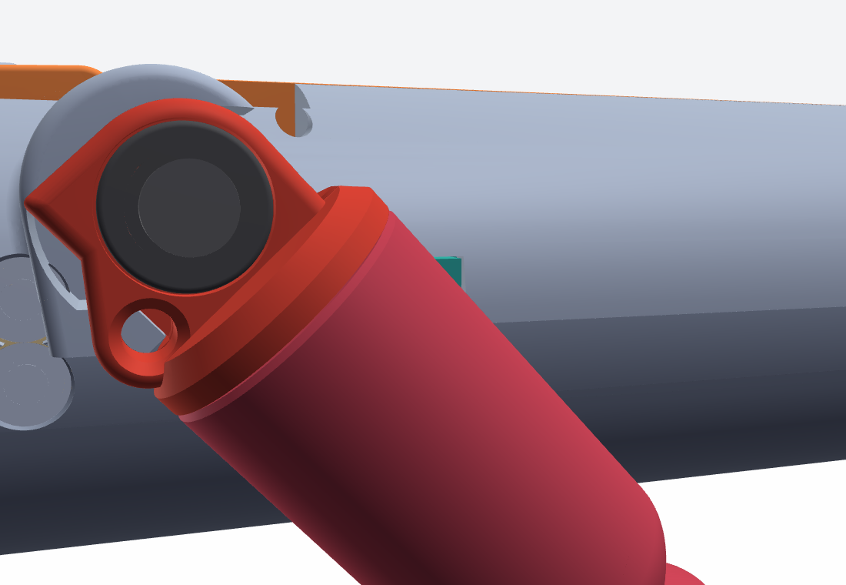
kedge/out35/review/v08_usb_window_deployed.png
