HarryHYu/GrappStar/kedge/out35/review/v09_drill_lead_holes.png

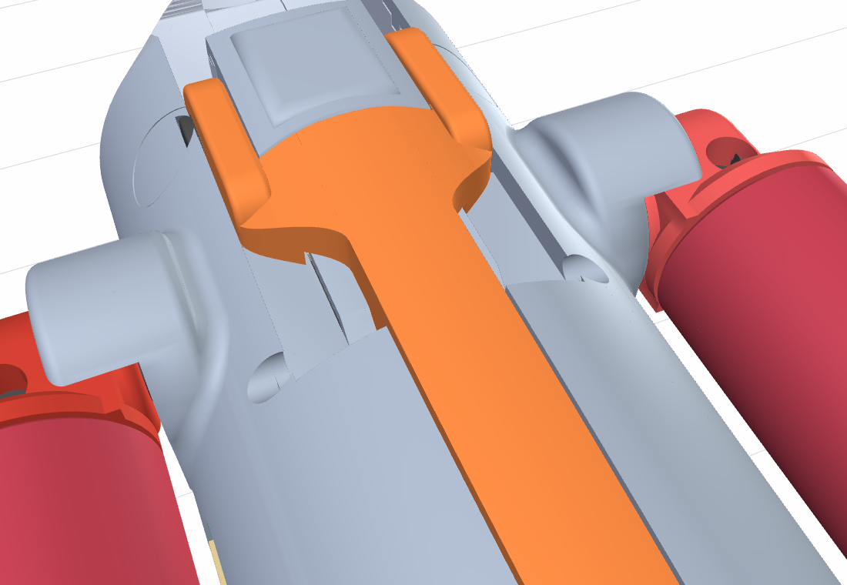
kedge/out35/review/v09_drill_lead_holes.png
