HarryHYu/GrappStar/kedge/out35/review/v11_interior_x57.png

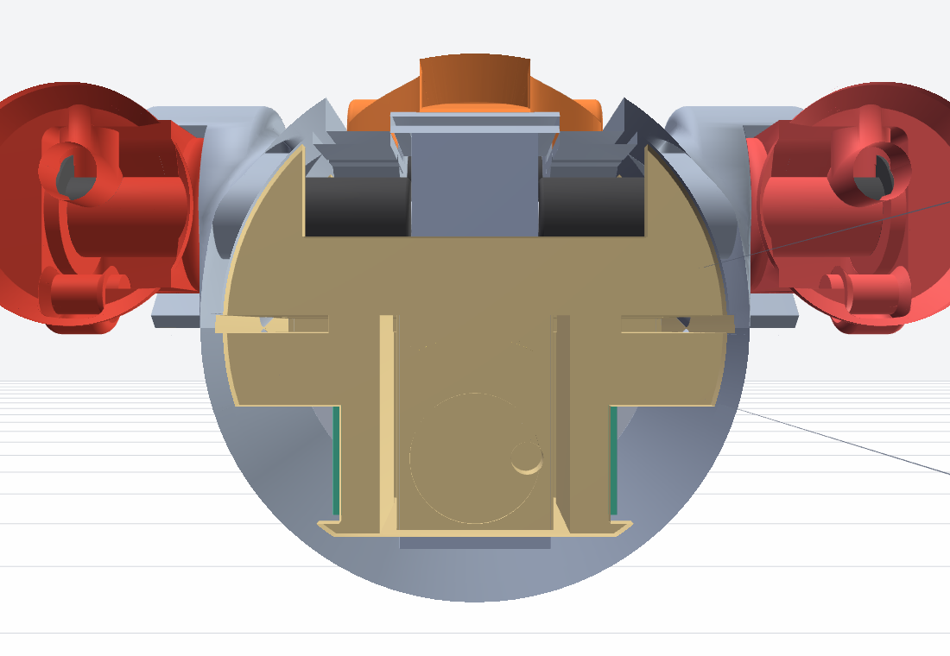
kedge/out35/review/v11_interior_x57.png
