HarryHYu/GrappStar/kedge/pack_gs/renders/01_overview.png

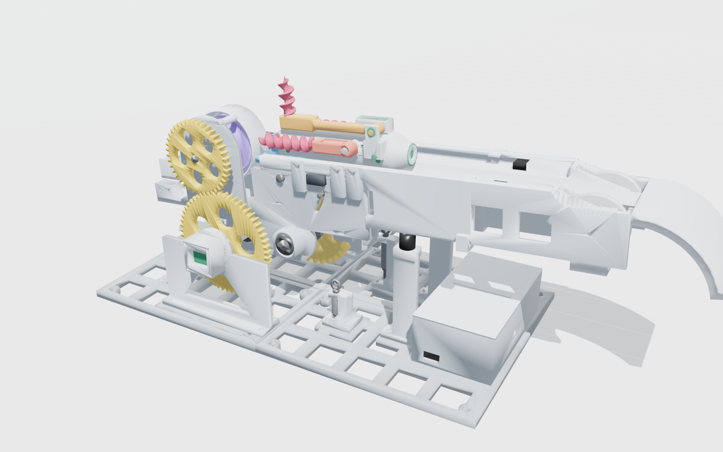
kedge/pack_gs/renders/01_overview.png
