HarryHYu/GrappStar/kedge/pack_gs/renders/02_fire_pose.png

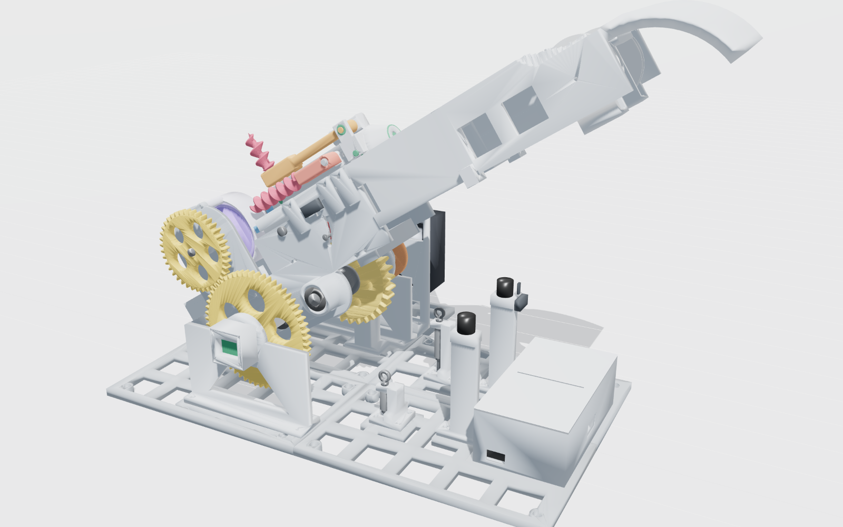
kedge/pack_gs/renders/02_fire_pose.png
