HarryHYu/GrappStar/kedge/pack_gs/renders/03_right_side_cam.png

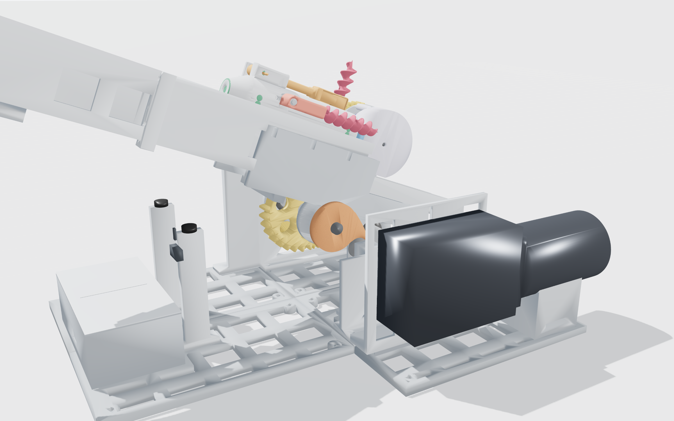
kedge/pack_gs/renders/03_right_side_cam.png
