HarryHYu/GrappStar/kedge/pack_gs/renders/04_reel_left.png

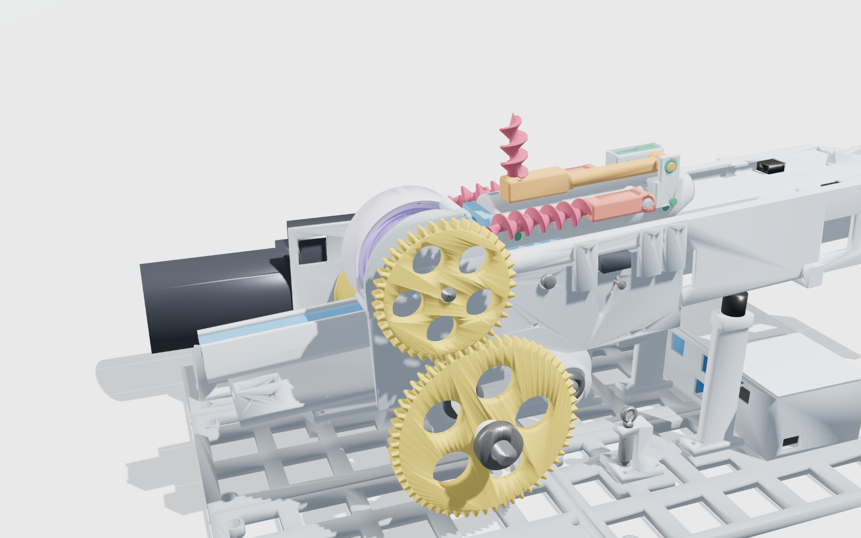
kedge/pack_gs/renders/04_reel_left.png
