HarryHYu/GrappStar/kedge/pack_gs/renders/05_sear.png

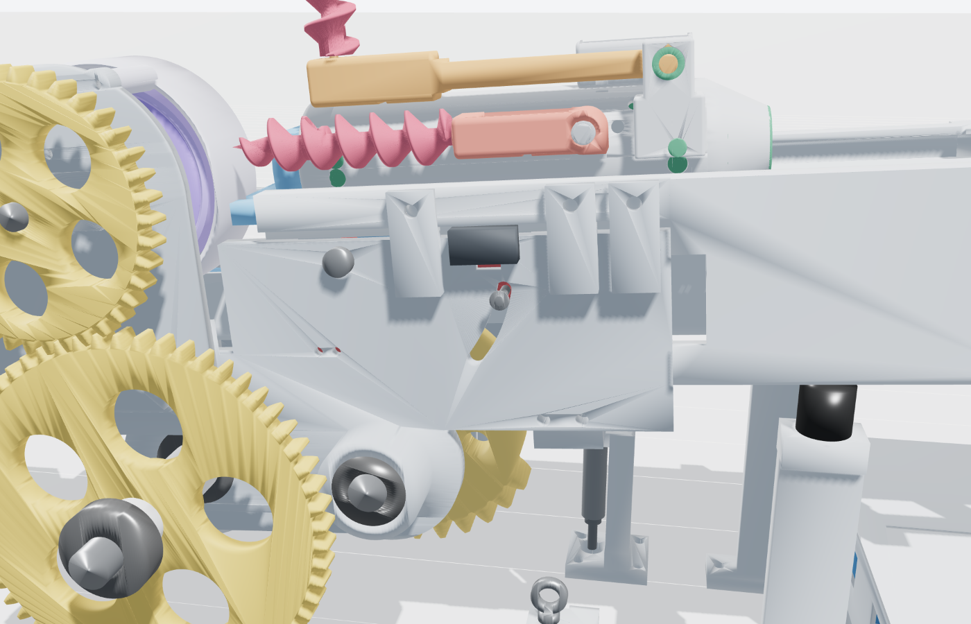
kedge/pack_gs/renders/05_sear.png
