HarryHYu/GrappStar/kedge/pack_gs/renders/06_top.png

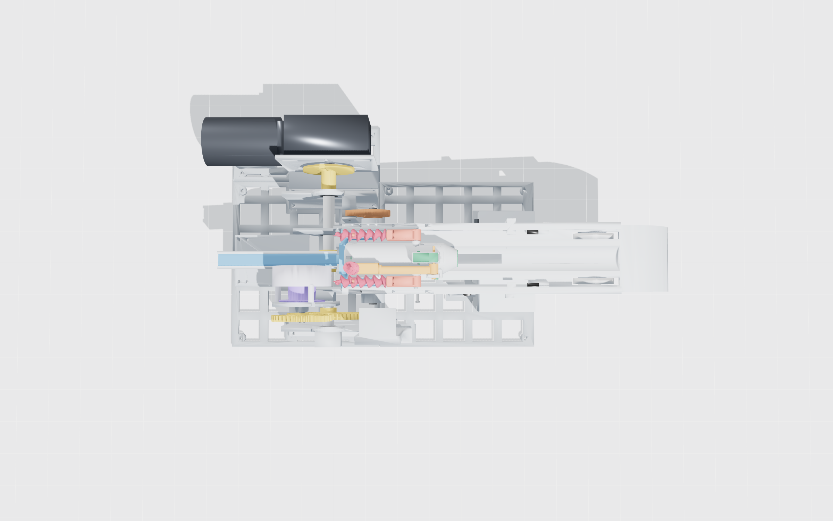
kedge/pack_gs/renders/06_top.png
