HarryHYu/GrappStar/kedge/pack_gs/renders/07_xsec_xray.png

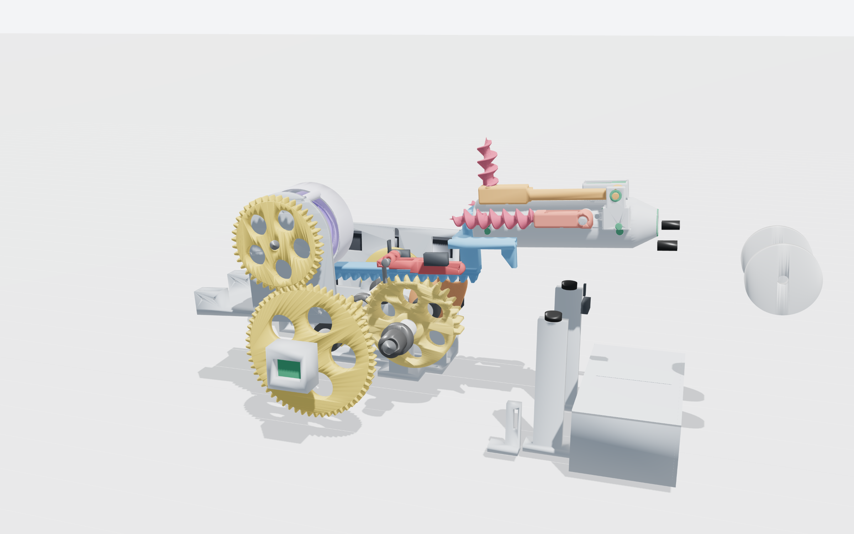
kedge/pack_gs/renders/07_xsec_xray.png
