HarryHYu/GrappStar/kedge/reports/fig/cad_v32b_deployed_side.png

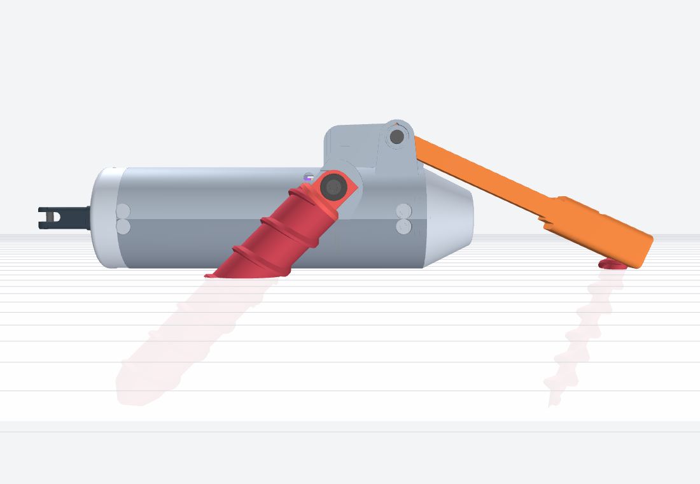
kedge/reports/fig/cad_v32b_deployed_side.png
