HarryHYu/GrappStar/kedge/reports/fig/cad_v32c_final.png

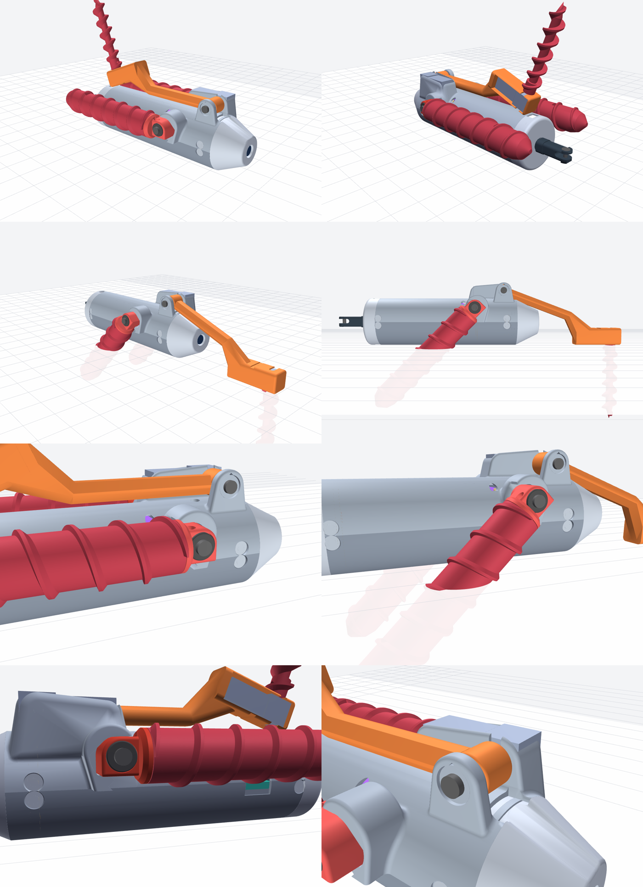
kedge/reports/fig/cad_v32c_final.png
