HarryHYu/GrappStar/kedge/reports/fig/cad_v33_16_auger_hub_folded.png

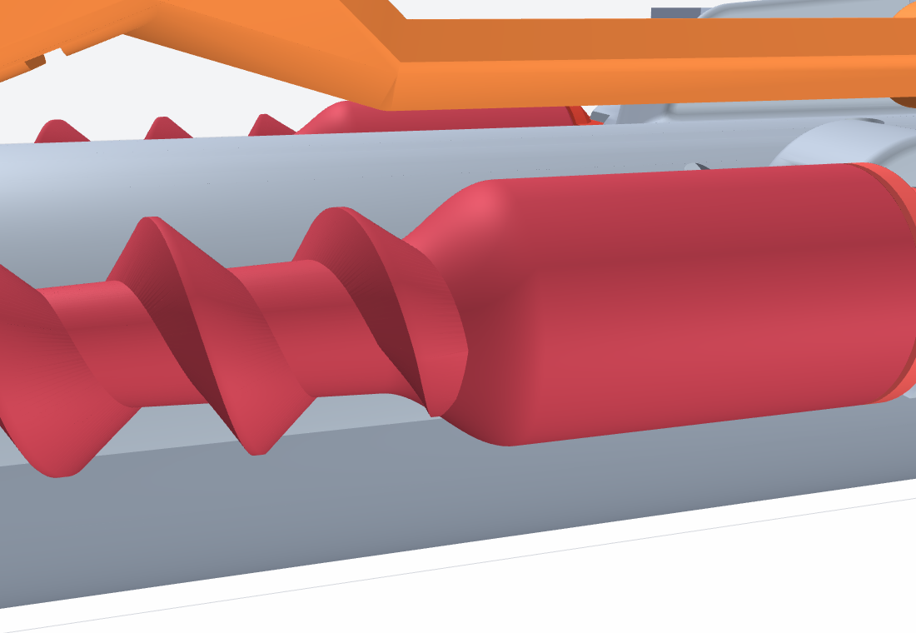
kedge/reports/fig/cad_v33_16_auger_hub_folded.png
