HarryHYu/GrappStar/kedge/reports/fig/cad_v33_17_auger_right_low.png

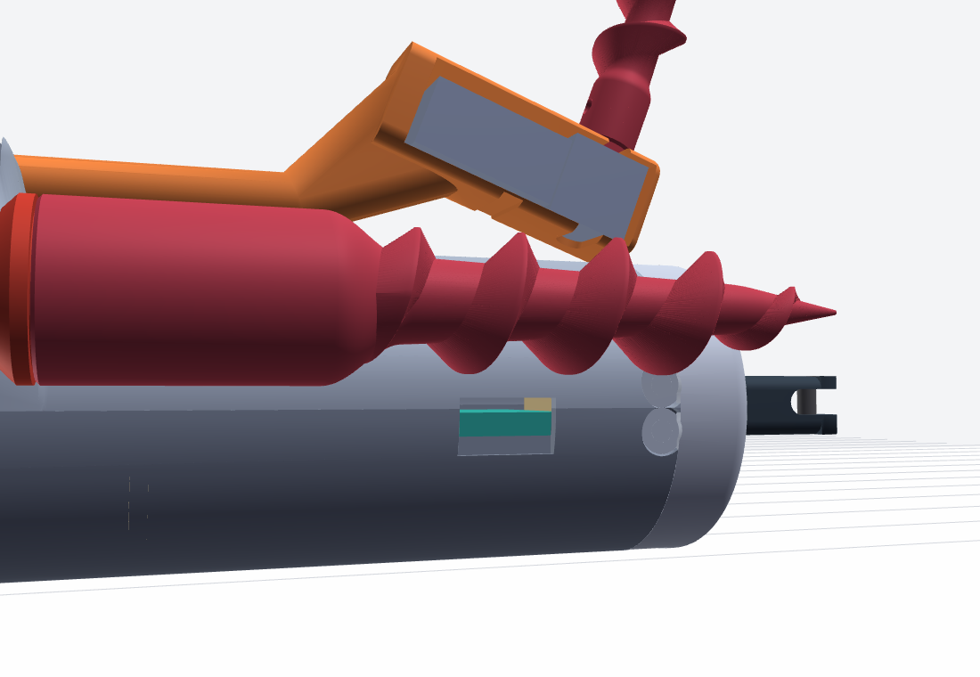
kedge/reports/fig/cad_v33_17_auger_right_low.png
