HarryHYu/GrappStar/kedge/reports/fig/cad_v33_24_foot_gimlet.png

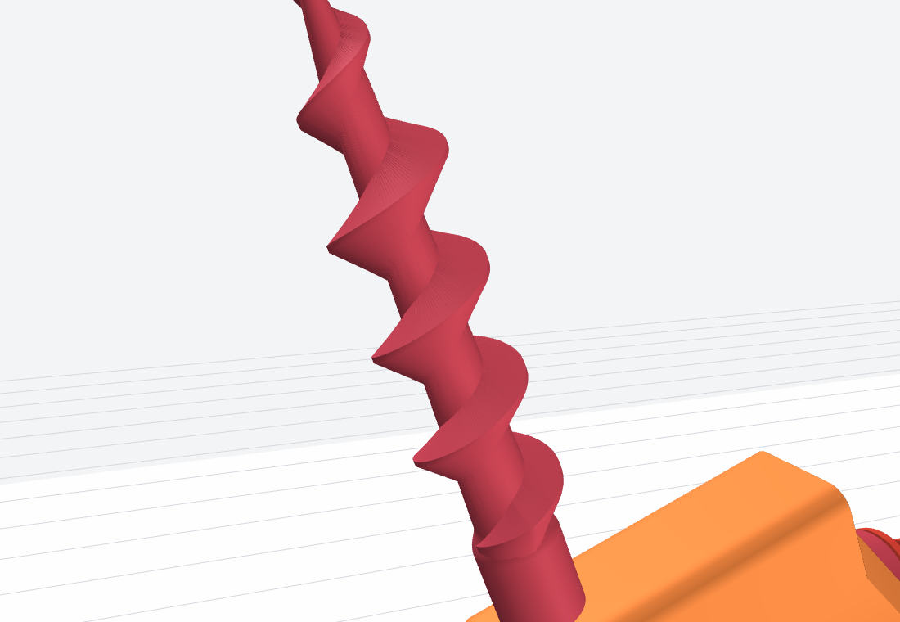
kedge/reports/fig/cad_v33_24_foot_gimlet.png
