HarryHYu/GrappStar/kedge/reports/fig/cad_v33_25_pod_section.png

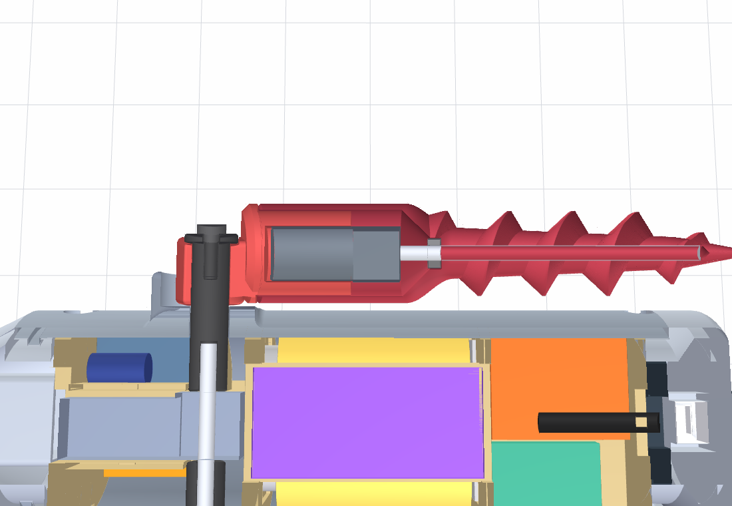
kedge/reports/fig/cad_v33_25_pod_section.png
