HarryHYu/GrappStar/kedge/reports/fig/cad_v33_27_kick_inline_check.png

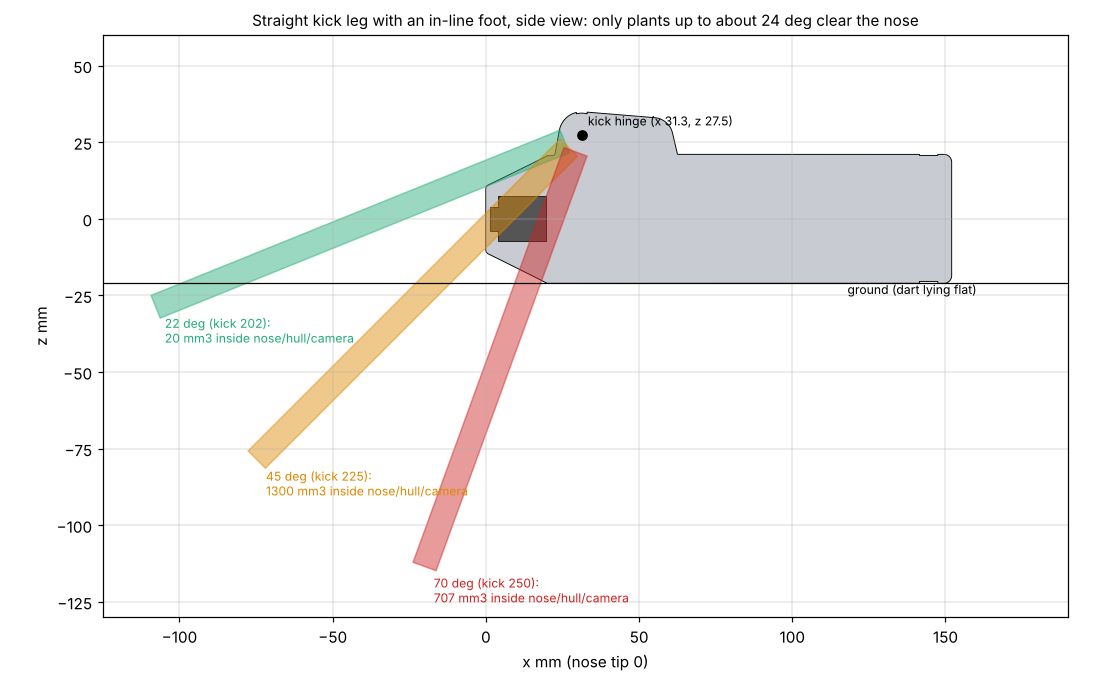
kedge/reports/fig/cad_v33_27_kick_inline_check.png
