HarryHYu/GrappStar/kedge/reports/fig/cad_v33_deployed_side.png

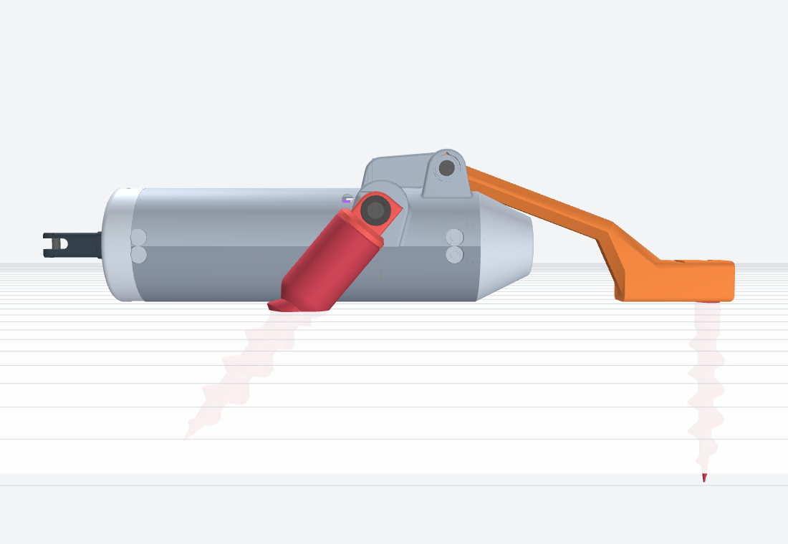
kedge/reports/fig/cad_v33_deployed_side.png
