HarryHYu/GrappStar/kedge/reports/fig/cad_v33_sheet.png

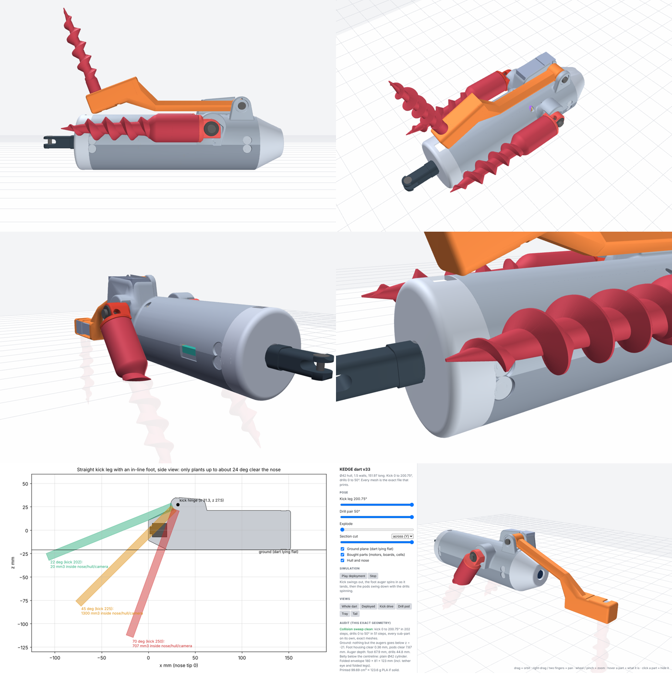
kedge/reports/fig/cad_v33_sheet.png
