HarryHYu/GrappStar/kedge/reports/fig/fig_cg_height_effect.png

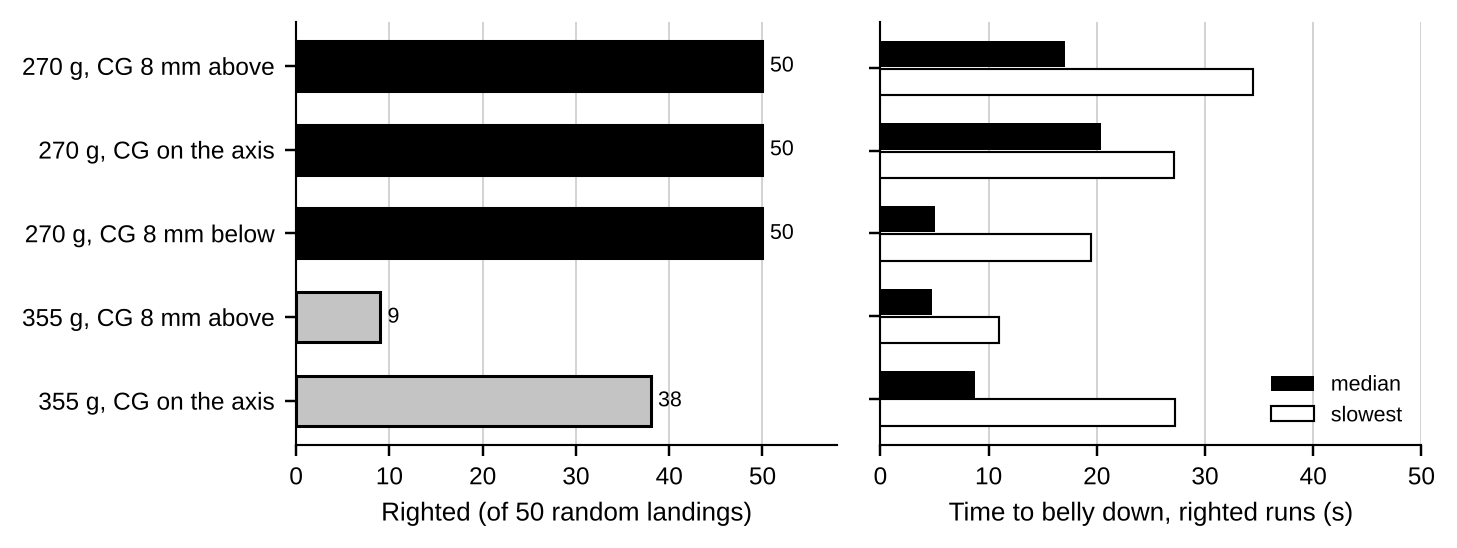
kedge/reports/fig/fig_cg_height_effect.png
