HarryHYu/GrappStar/kedge/reports/fig/fig_holding_by_soil.png

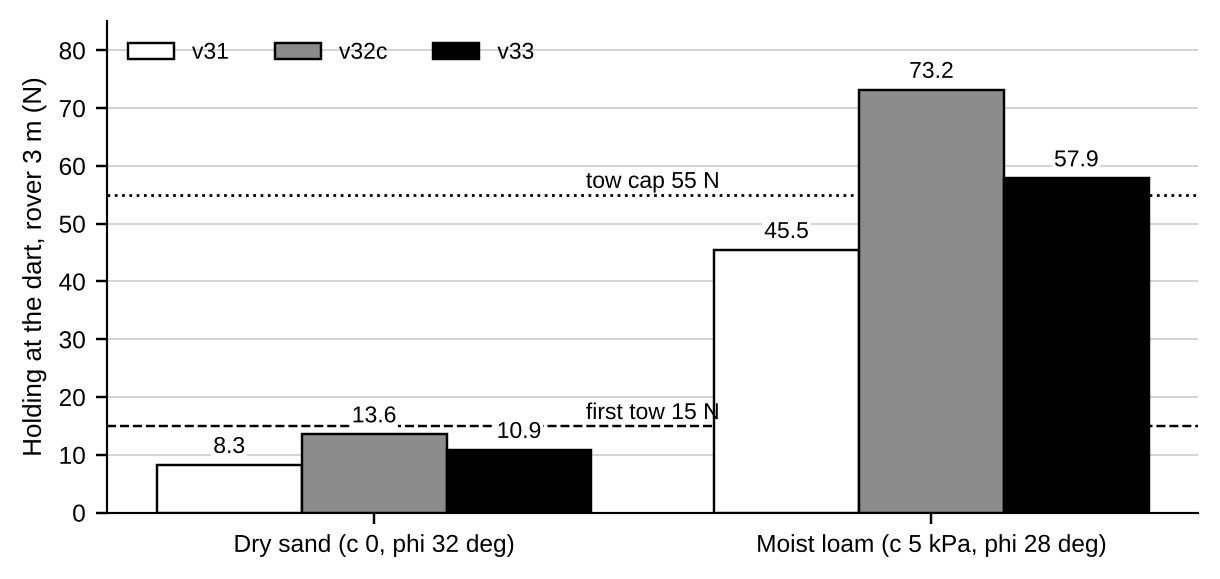
kedge/reports/fig/fig_holding_by_soil.png
