HarryHYu/GrappStar/kedge/reports/fig/fig_holding_vs_tension.png

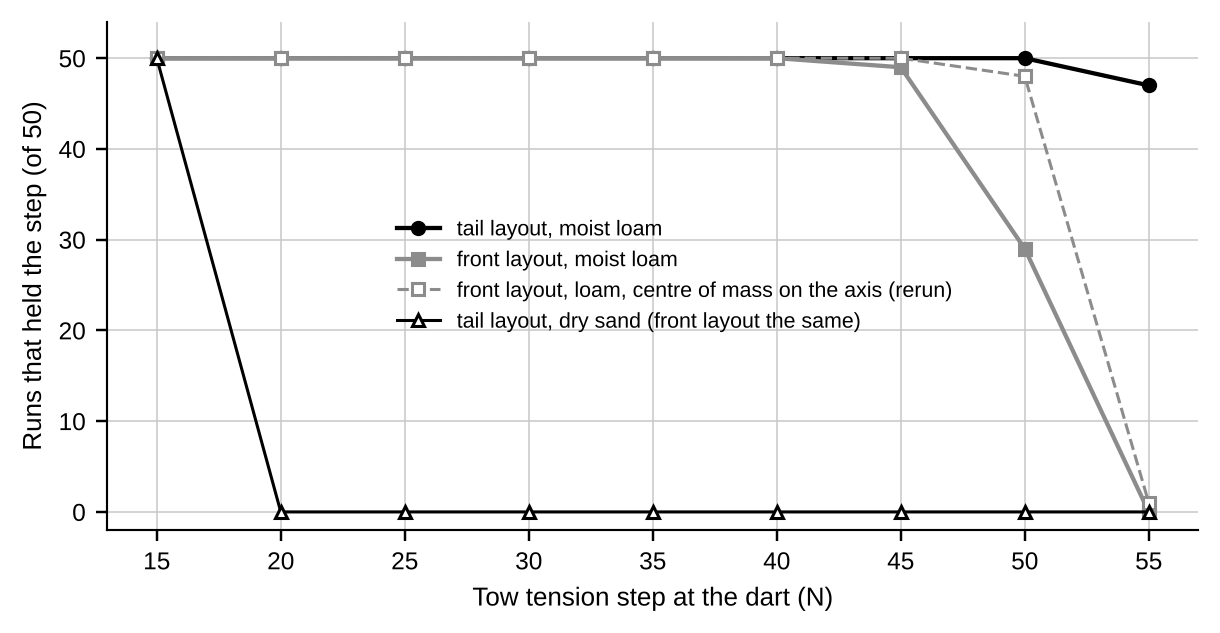
kedge/reports/fig/fig_holding_vs_tension.png
