HarryHYu/GrappStar/kedge/reports/fig/fig_layout_worm_load.png

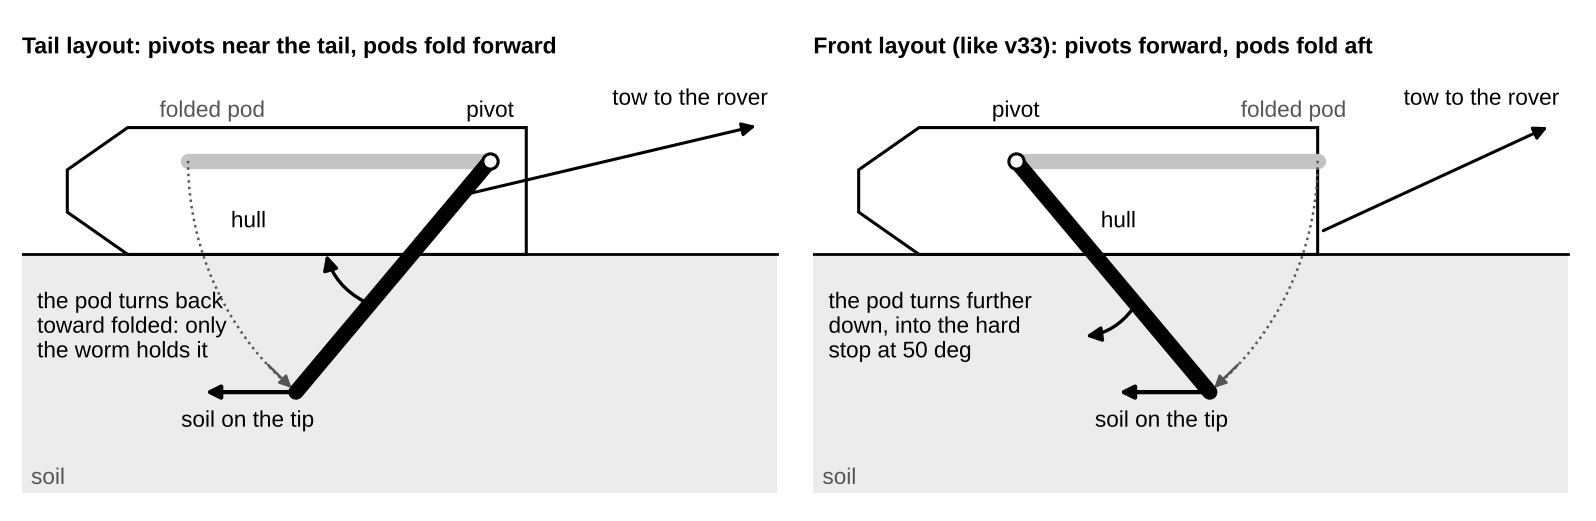
kedge/reports/fig/fig_layout_worm_load.png
