HarryHYu/GrappStar/kedge/reports/fig/fig_mass_breakdown.png

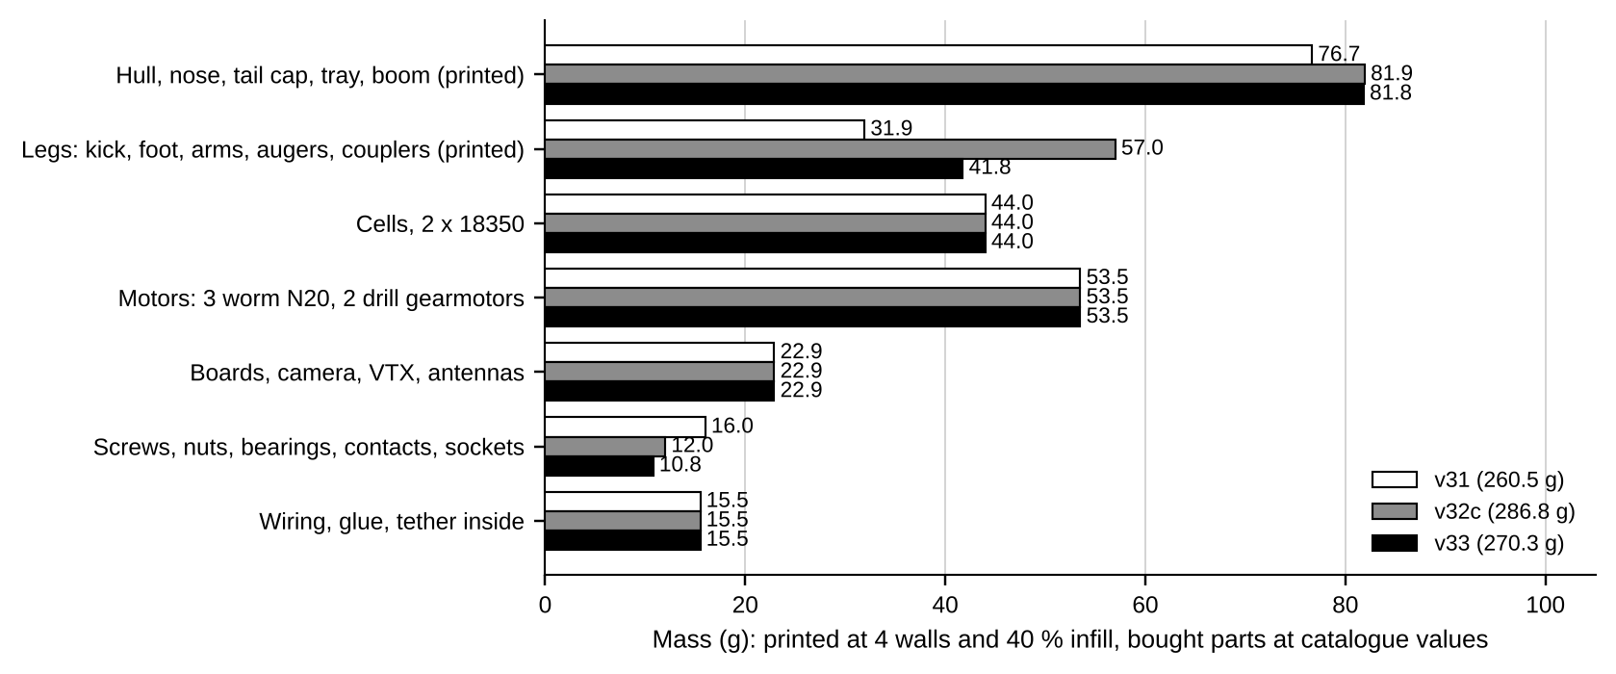
kedge/reports/fig/fig_mass_breakdown.png
