HarryHYu/GrappStar/kedge/reports/fig/fig_release_vs_cohesion.png

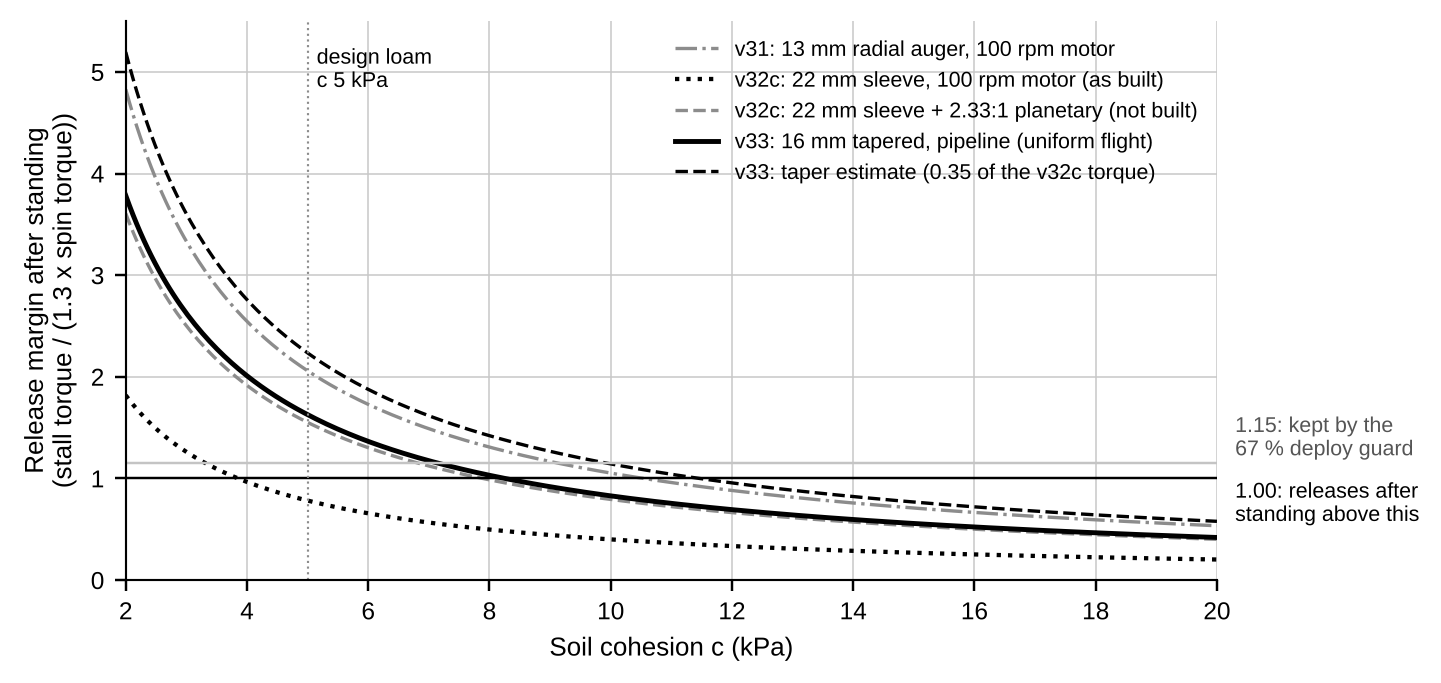
kedge/reports/fig/fig_release_vs_cohesion.png
