HarryHYu/GrappStar/kedge/reports/fig/fig_righting_time_hist.png

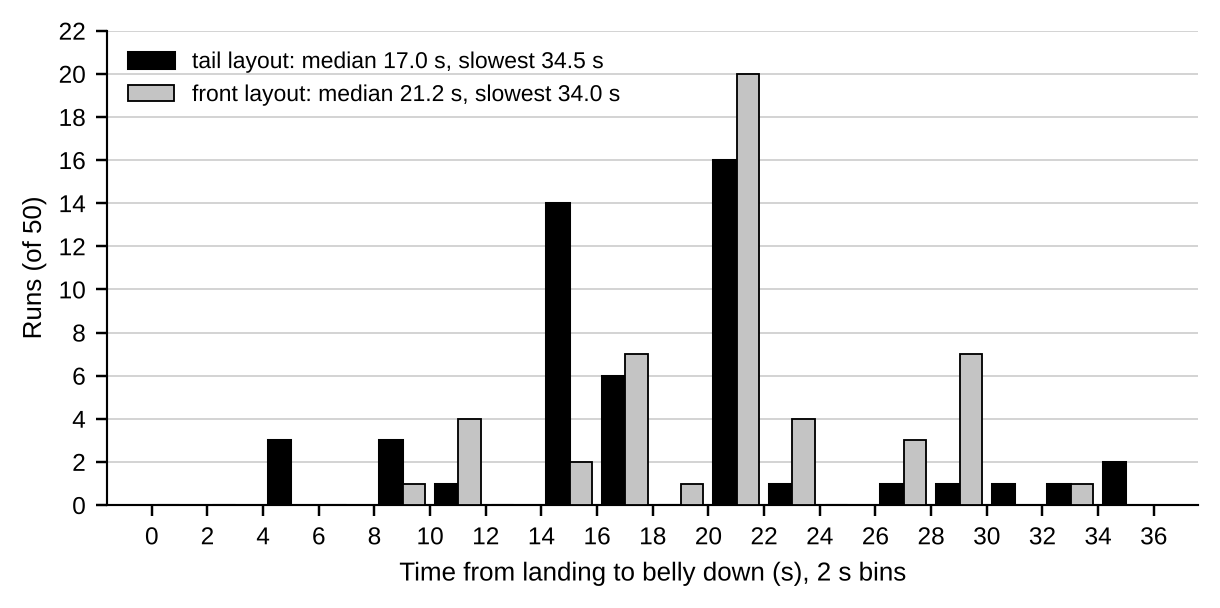
kedge/reports/fig/fig_righting_time_hist.png
