HarryHYu/GrappStar/kedge/reports/fig/fig_spin_torque_vs_od.png

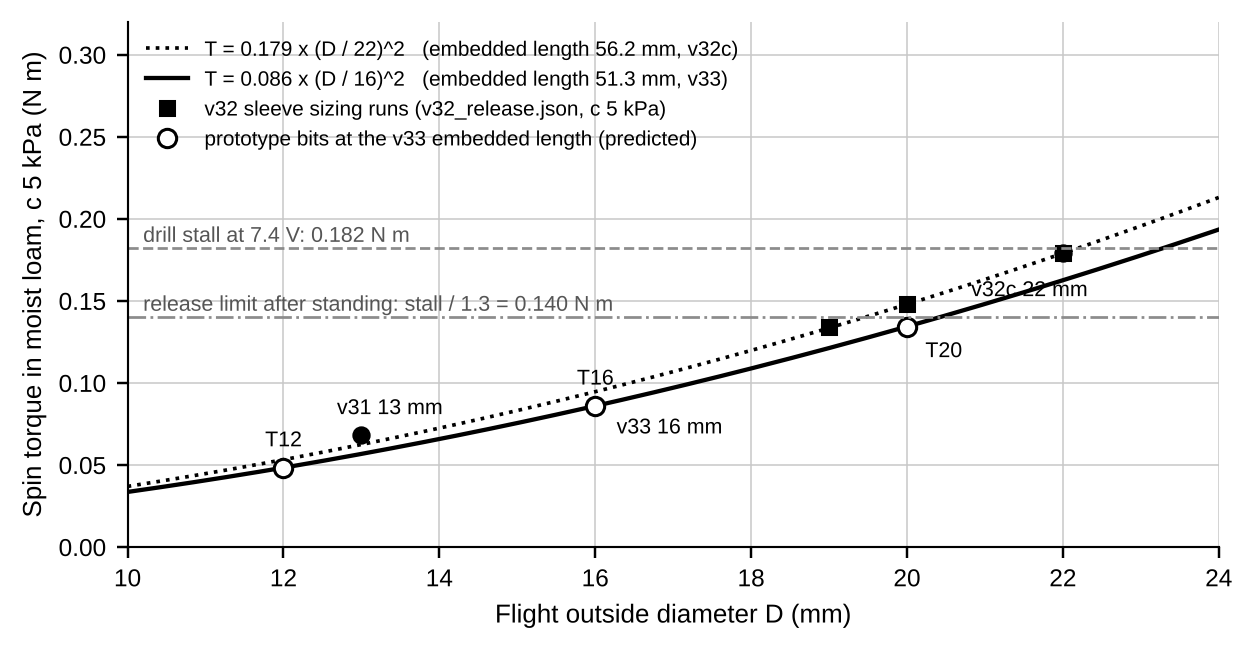
kedge/reports/fig/fig_spin_torque_vs_od.png
