HarryHYu/GrappStar/kedge/reports/fig/proto_bits.png

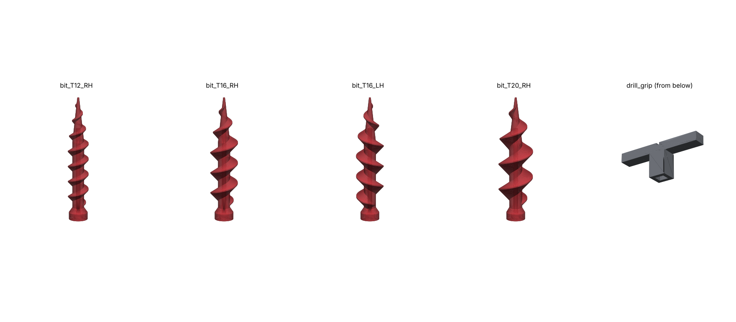
kedge/reports/fig/proto_bits.png
