HarryHYu/GrappStar/kedge/reports/fig/sim_belly_podroll.png

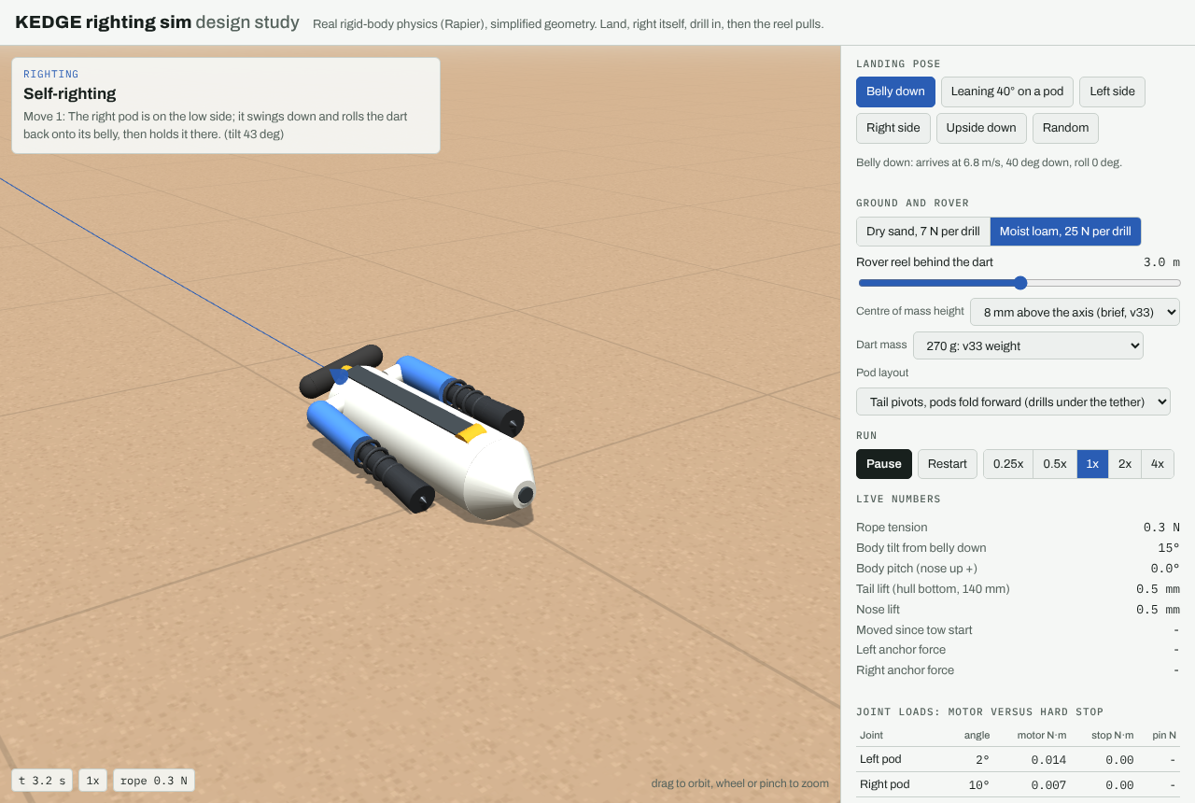
kedge/reports/fig/sim_belly_podroll.png
