HarryHYu/GrappStar/kedge/reports/fig/sim_stuck_355g.png

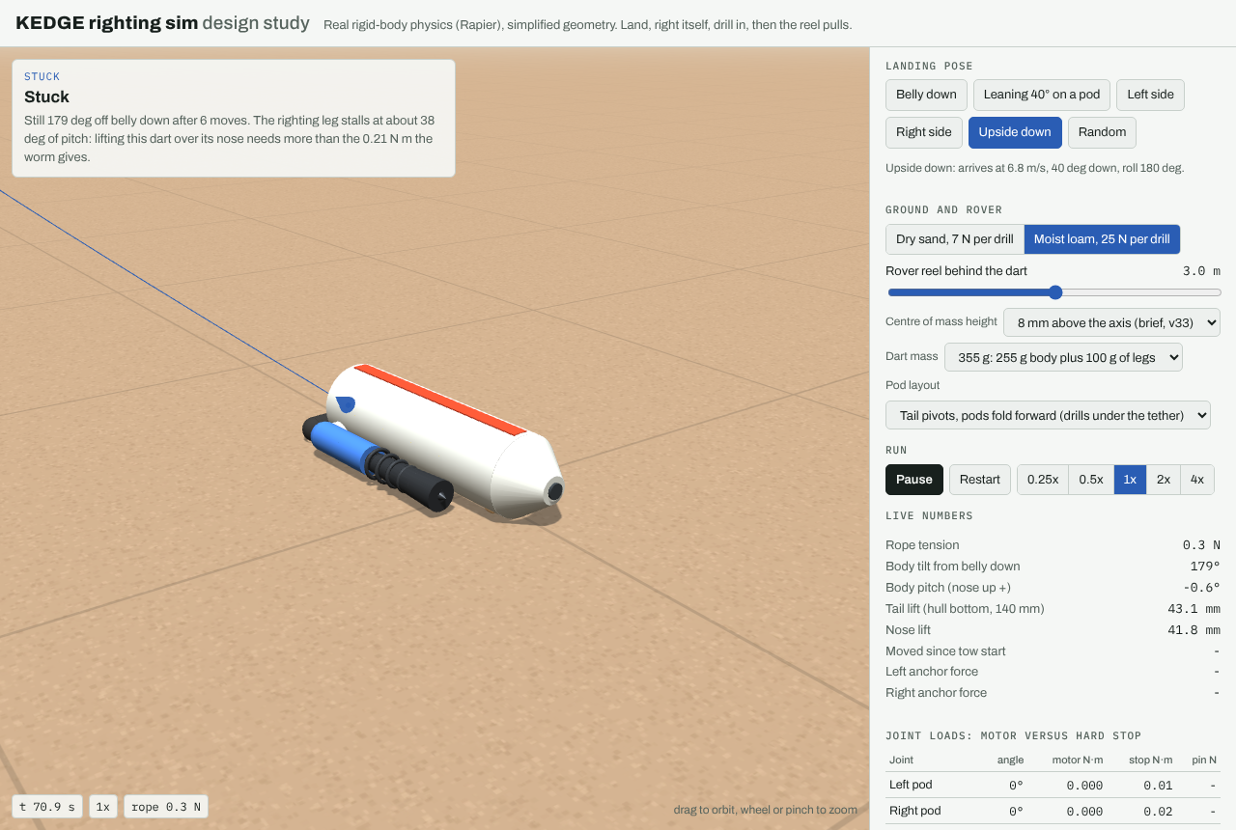
kedge/reports/fig/sim_stuck_355g.png
