HarryHYu/GrappStar/kedge/reports/fig/sim_tow_front_layout.png

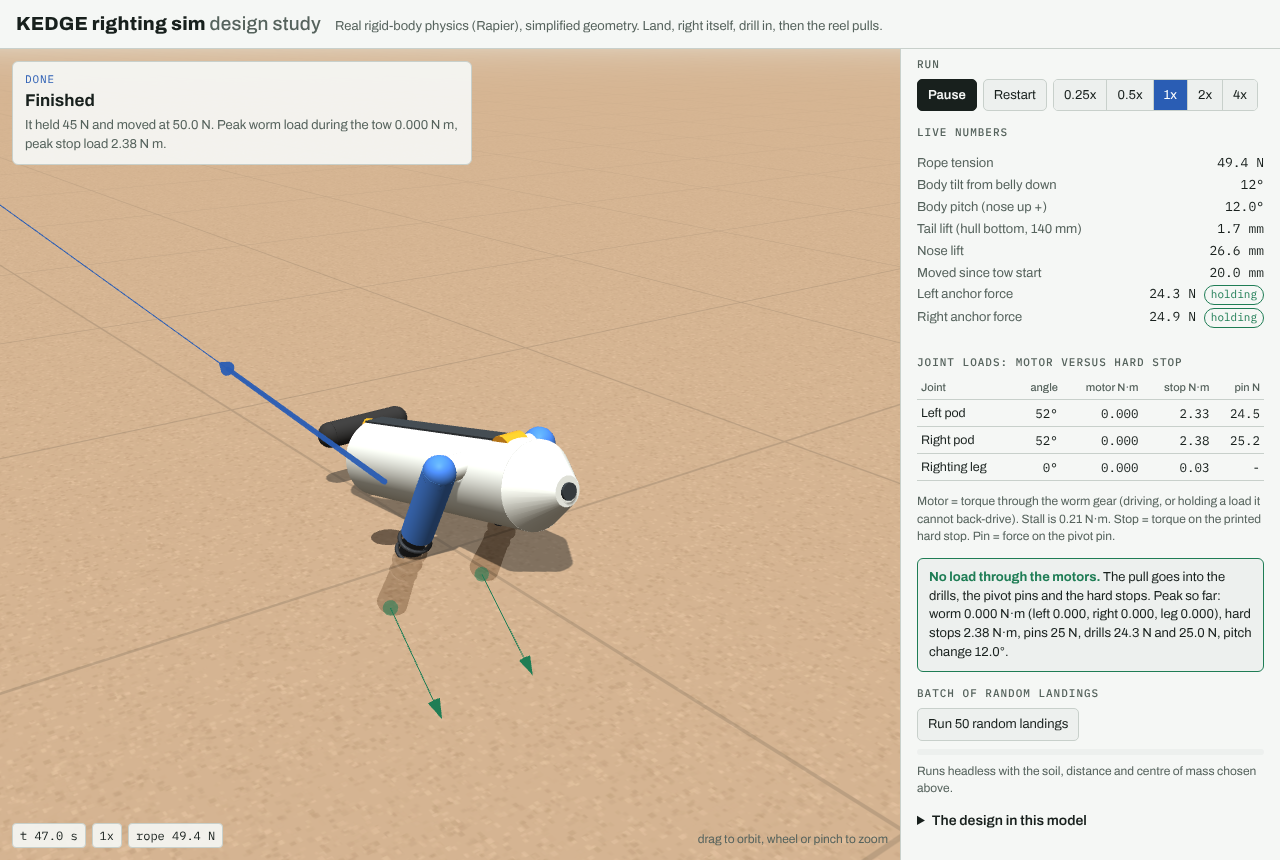
kedge/reports/fig/sim_tow_front_layout.png
