HarryHYu/GrappStar/kedge/reports/fig/sim_tow_tail_55N.png

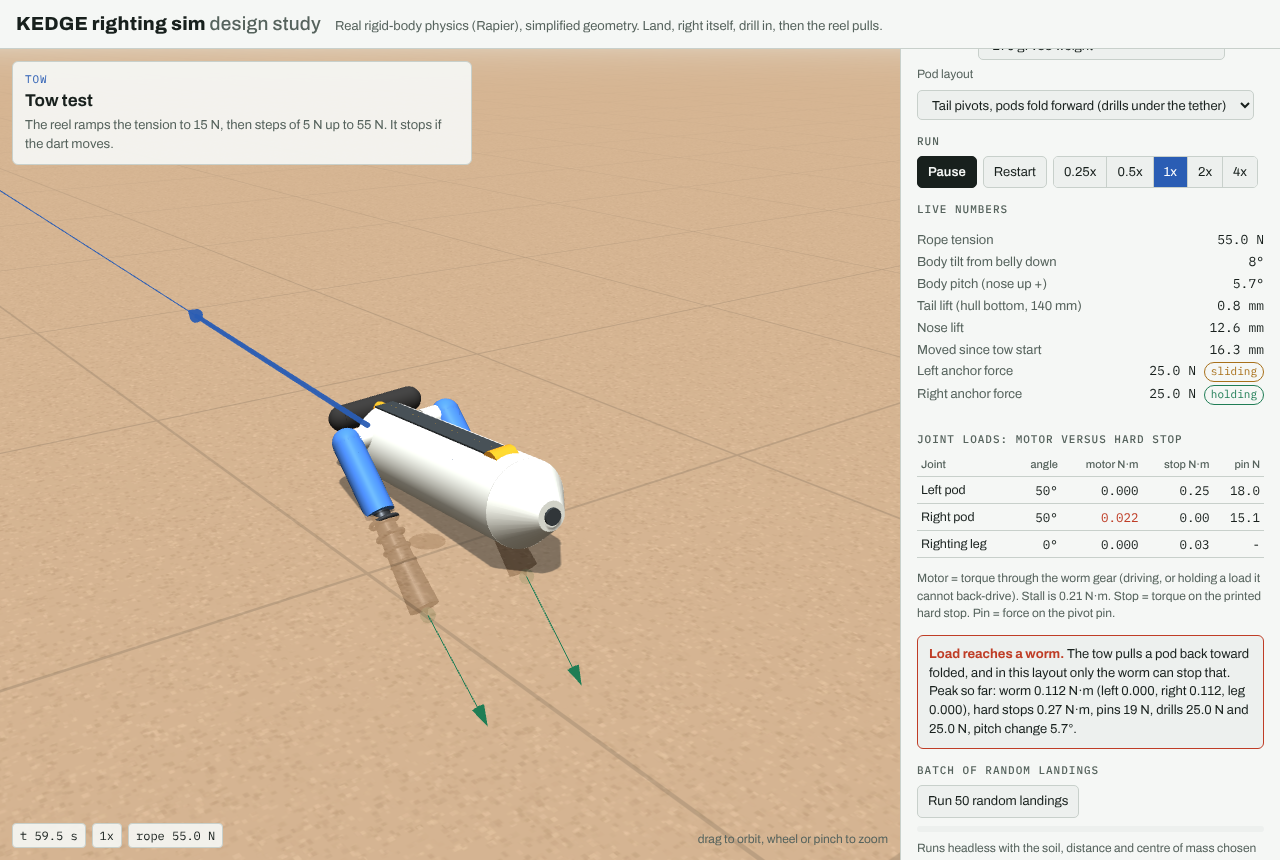
kedge/reports/fig/sim_tow_tail_55N.png
