HarryHYu/GrappStar/kedge/reports/fig/sim_upside_drilling.png

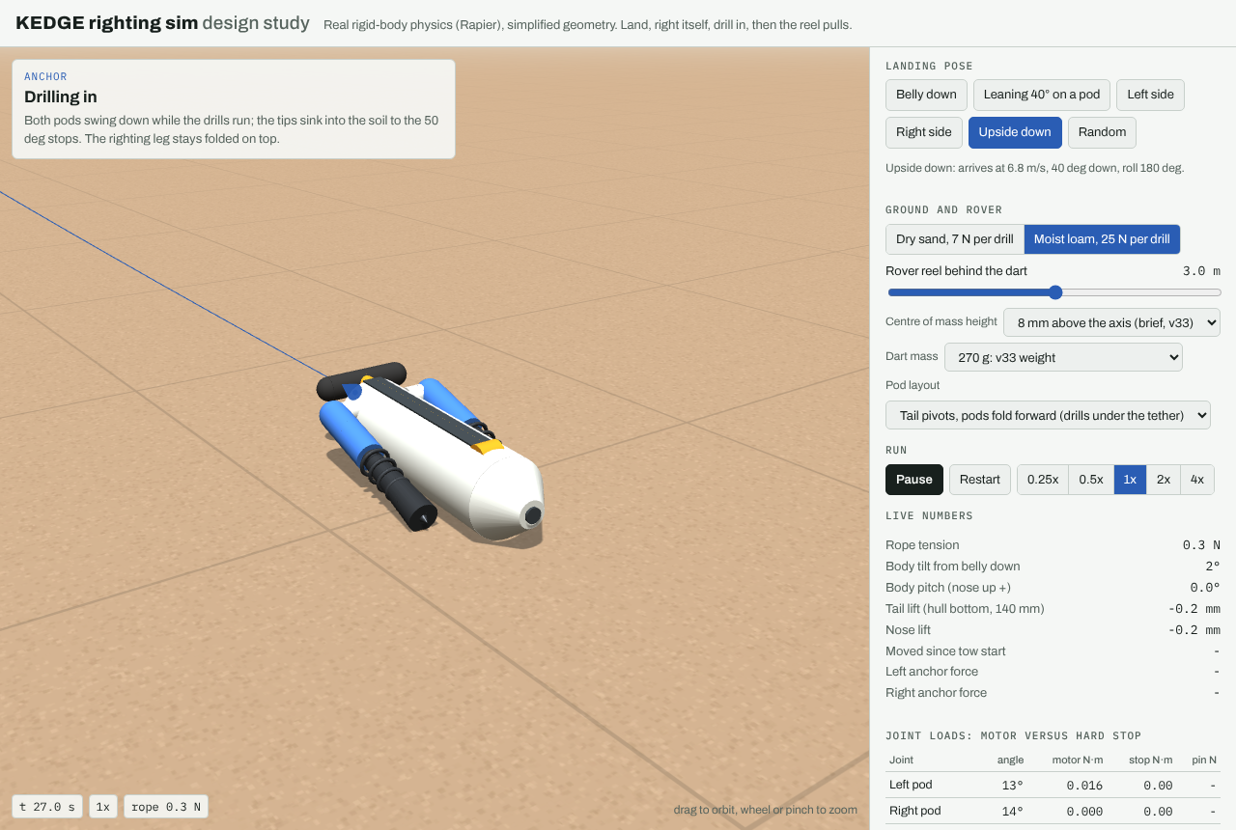
kedge/reports/fig/sim_upside_drilling.png
