HarryHYu/GrappStar/kedge/reports/fig/sim_upside_flip.png

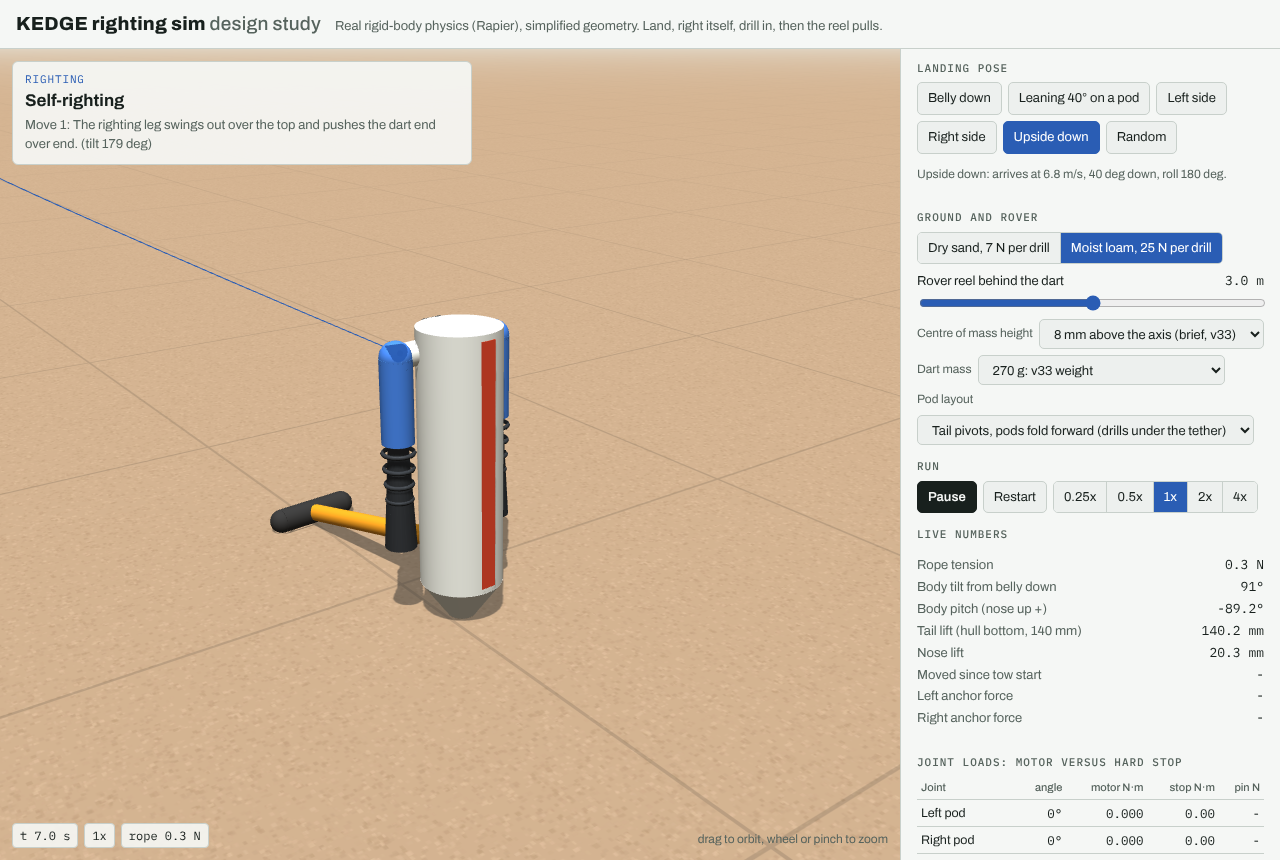
kedge/reports/fig/sim_upside_flip.png
