HarryHYu/GrappStar/kedge/site/04_reel_left.jpg

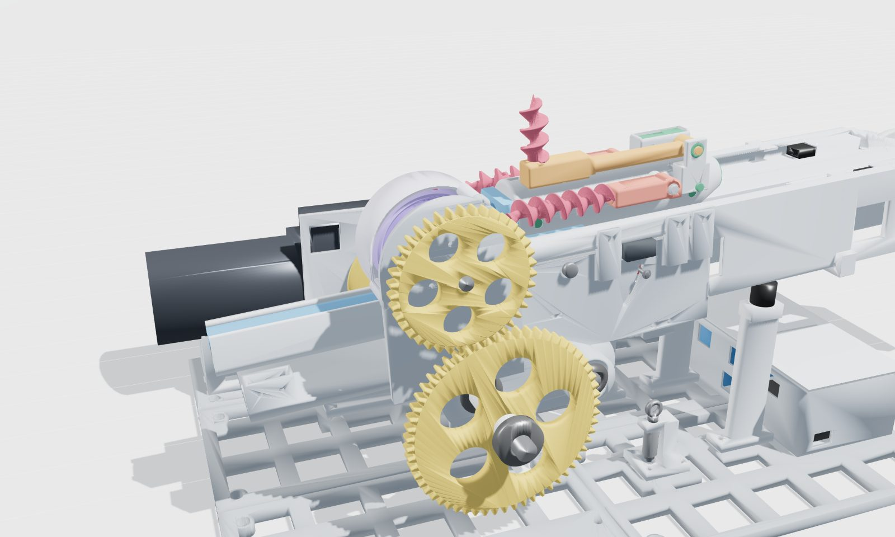
kedge/site/04_reel_left.jpg
