HarryHYu/GrappStar/kedge/work/shots/payout_sim.png

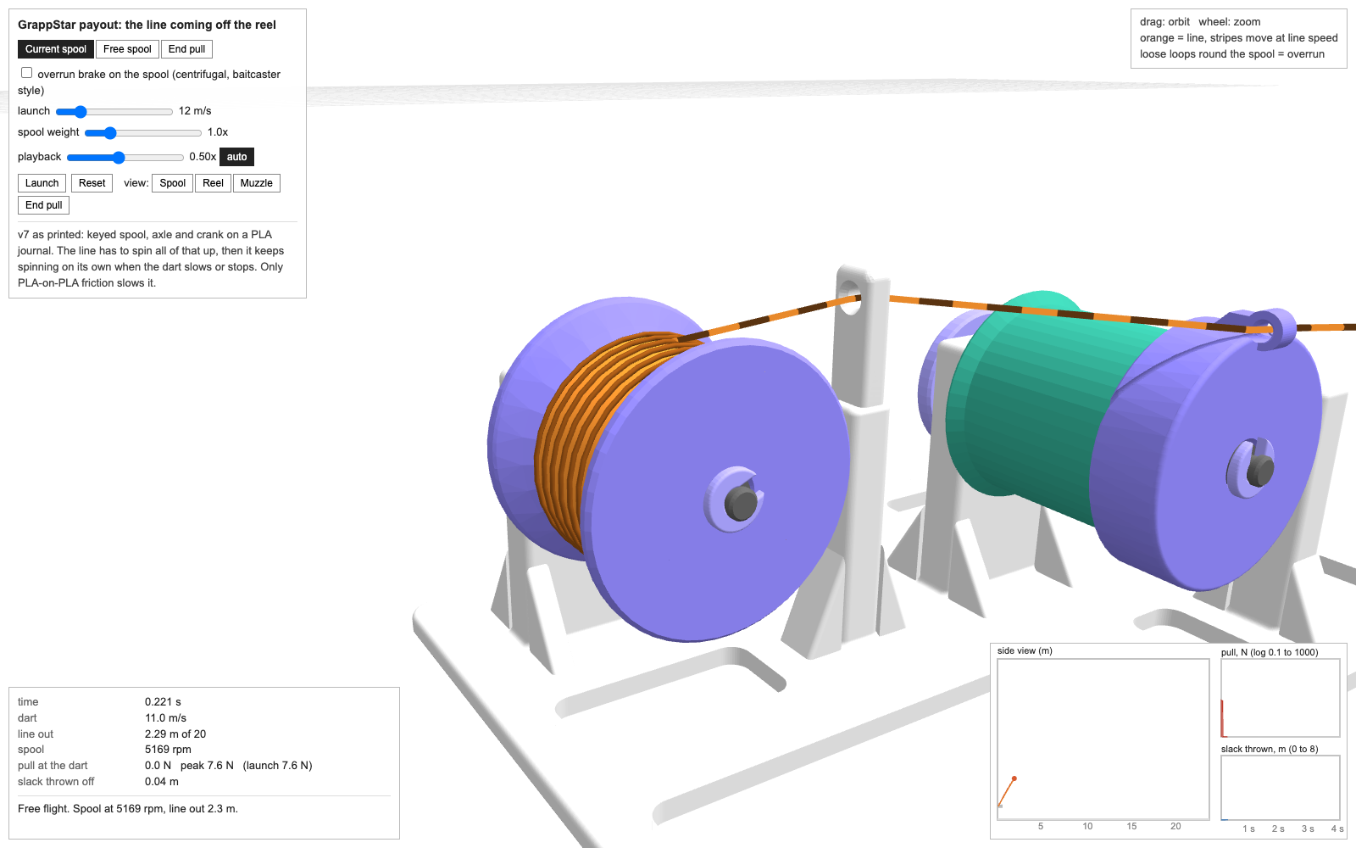
kedge/work/shots/payout_sim.png
