HarryHYu/GrappStar/kedge/work/shots/reel_sim.png

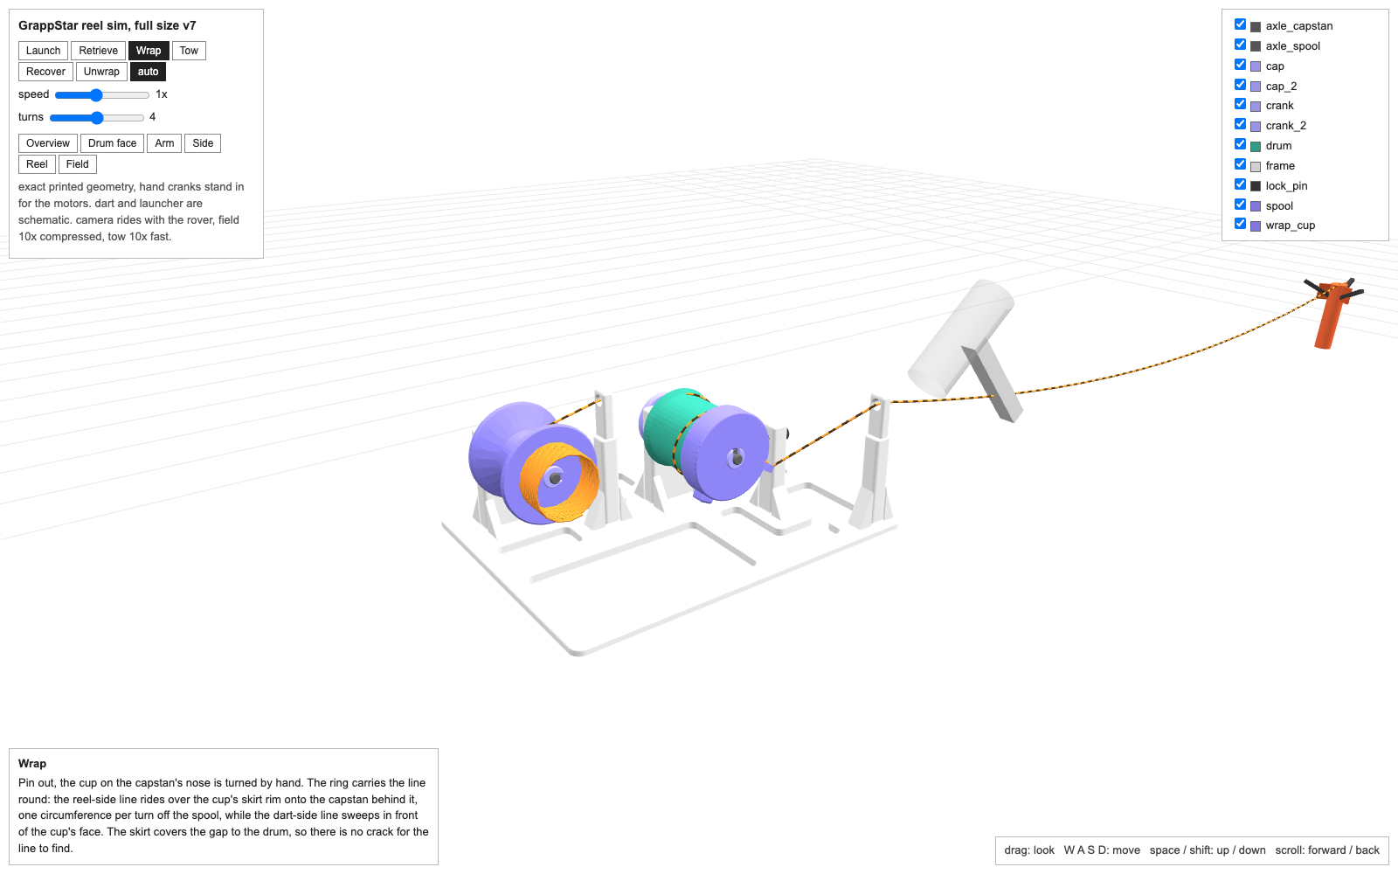
kedge/work/shots/reel_sim.png
