HarryHYu/GrappStar/knowledge/images/9166a6d4_1.png

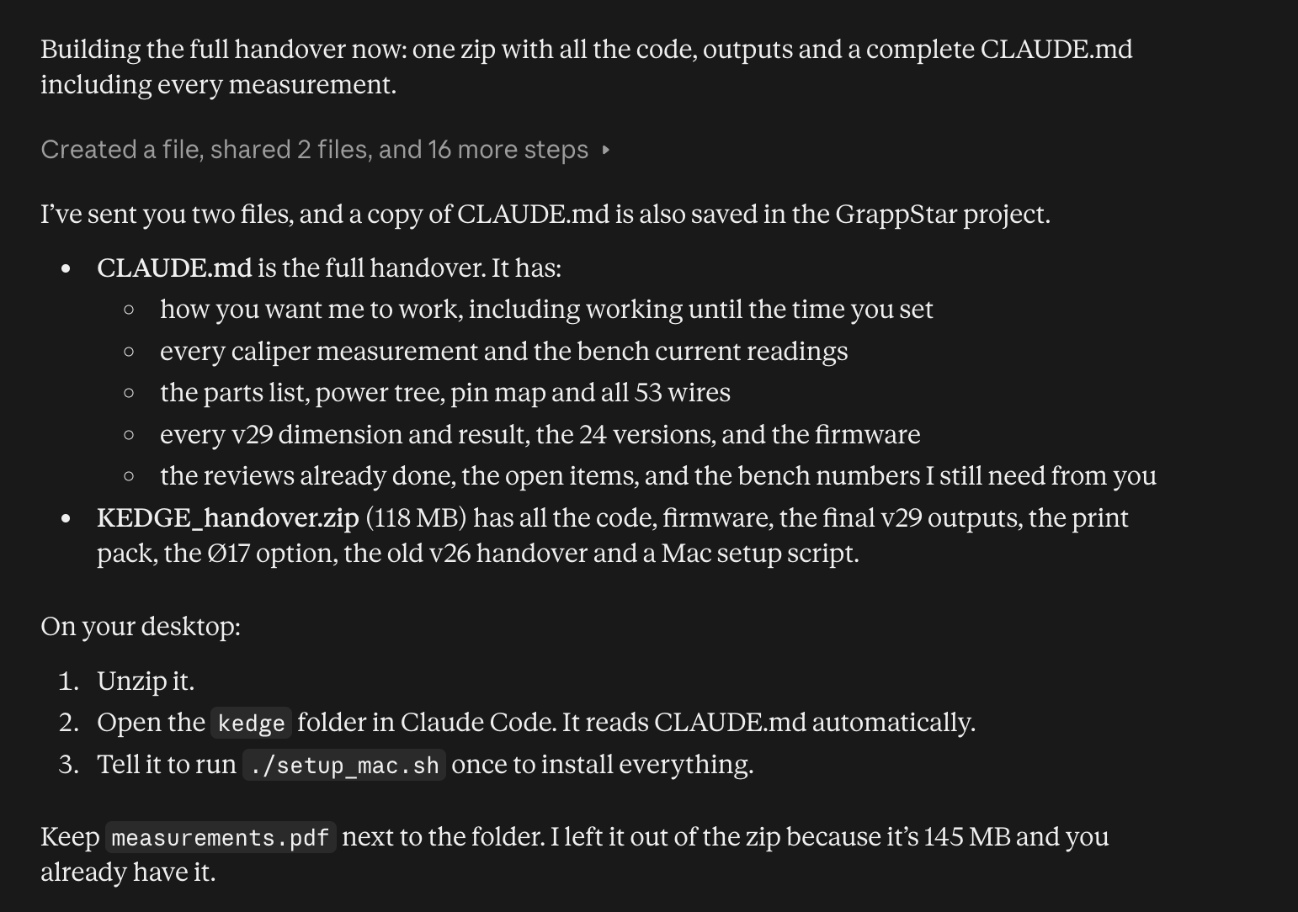
knowledge/images/9166a6d4_1.png
