HarryHYu/GrappStar/knowledge/images/29012b84_1.webp

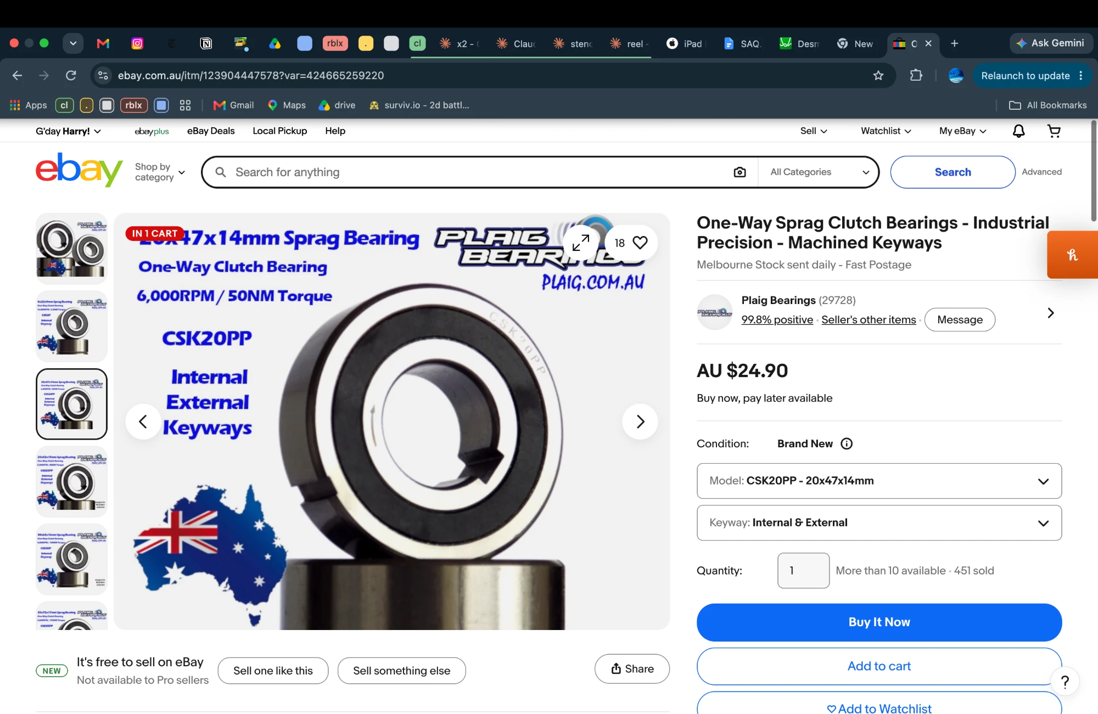
knowledge/images/29012b84_1.webp
