HarryHYu/GrappStar/knowledge/images/29012b84_2.webp

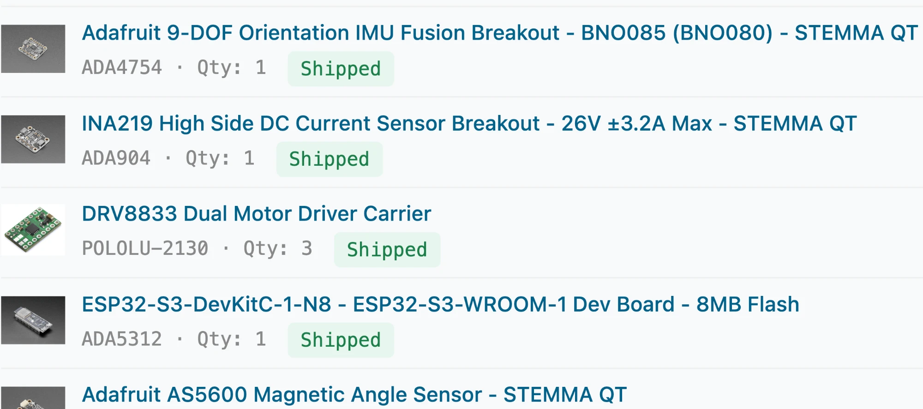
knowledge/images/29012b84_2.webp
