HarryHYu/GrappStar/knowledge/images/29012b84_3.webp

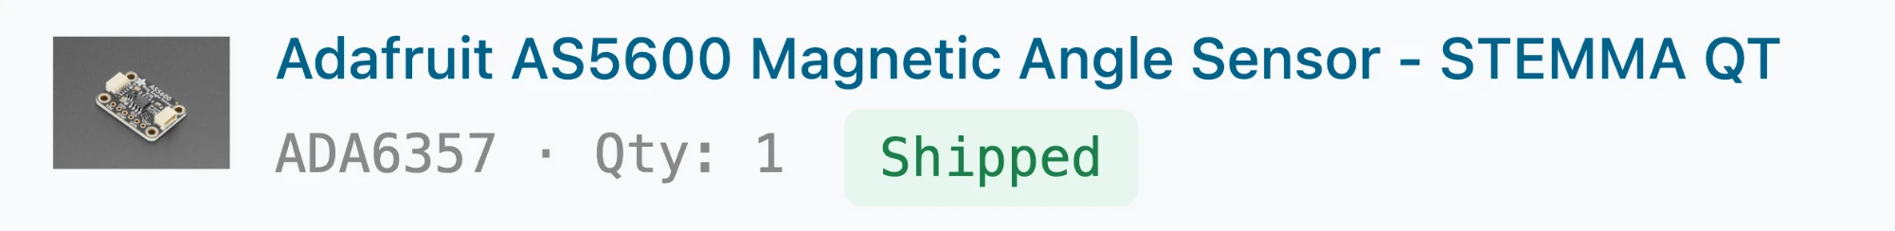
knowledge/images/29012b84_3.webp
