HarryHYu/GrappStar/render/motion/plots/01_film_clock.png

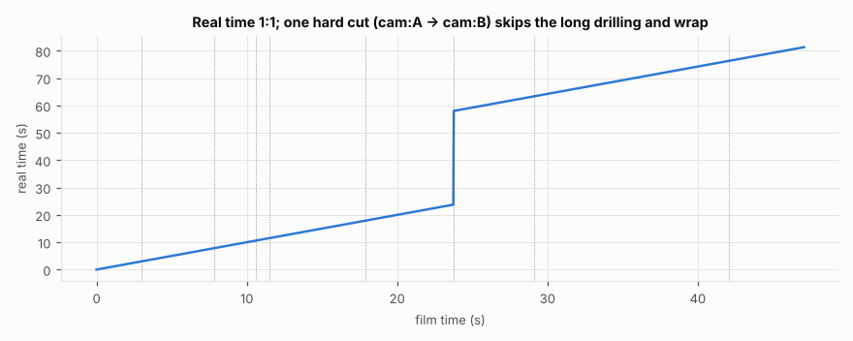
render/motion/plots/01_film_clock.png
