HarryHYu/GrappStar/render/motion/plots/02_base.png

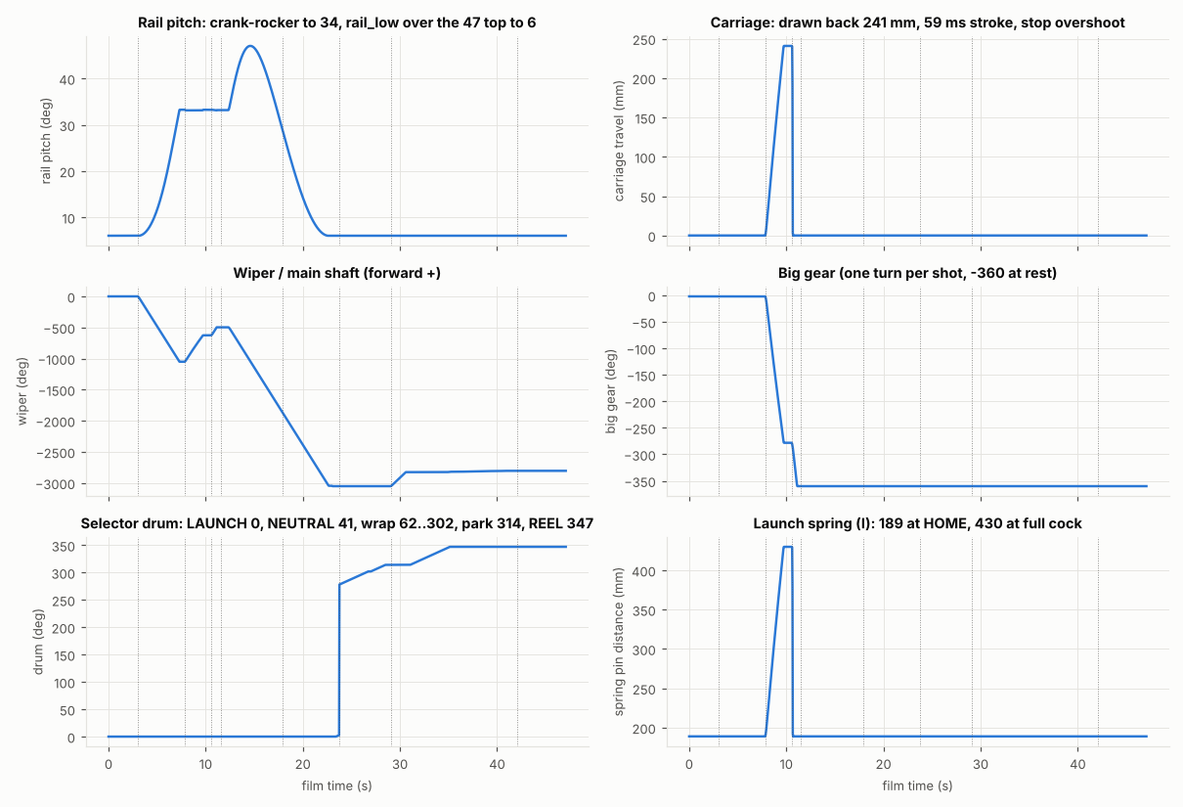
render/motion/plots/02_base.png
