HarryHYu/GrappStar/render/motion/plots/03_shot.png

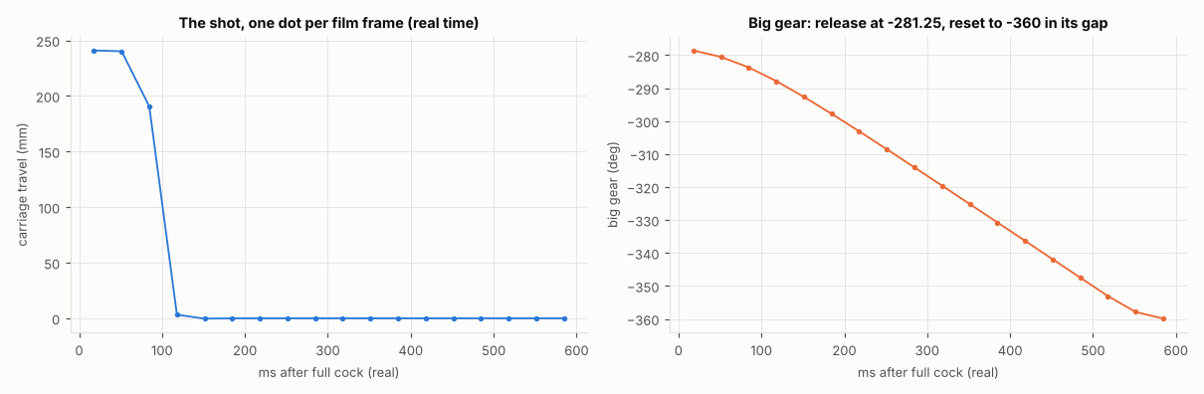
render/motion/plots/03_shot.png
