HarryHYu/GrappStar/render/motion/plots/04_dart_path.png

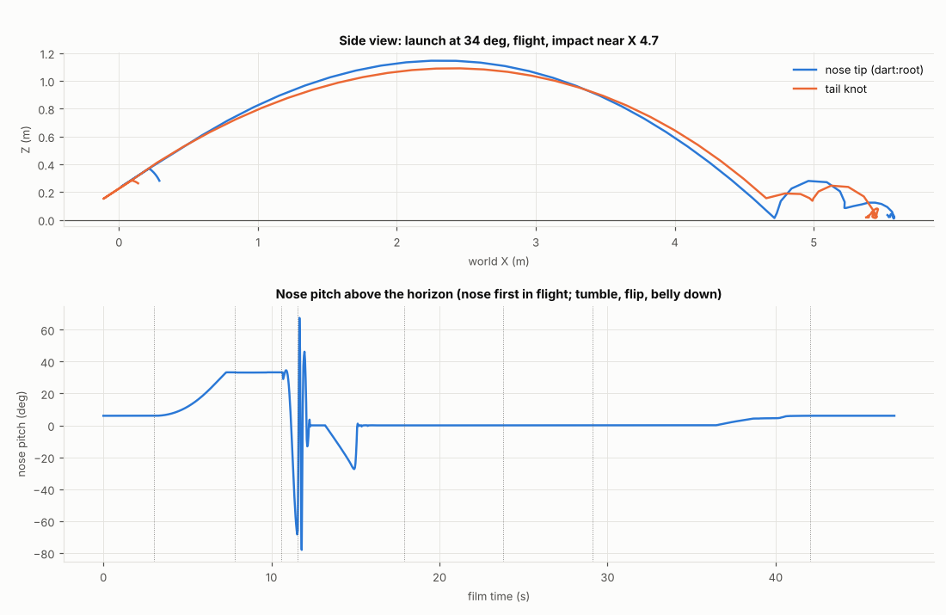
render/motion/plots/04_dart_path.png
