HarryHYu/GrappStar/render/motion/plots/05_flight_attitude.png

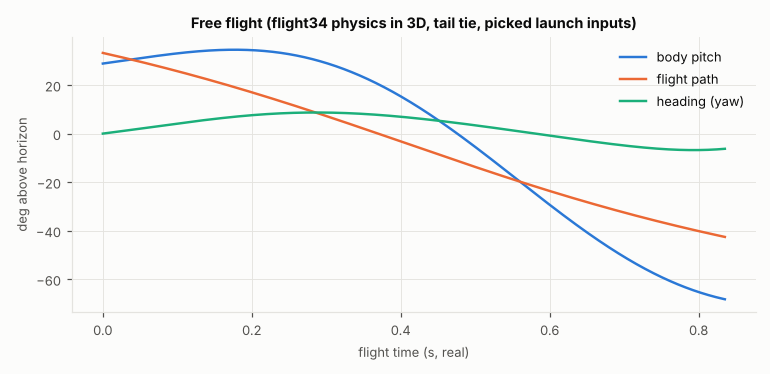
render/motion/plots/05_flight_attitude.png
