HarryHYu/GrappStar/render/motion/plots/06_dart_joints.png

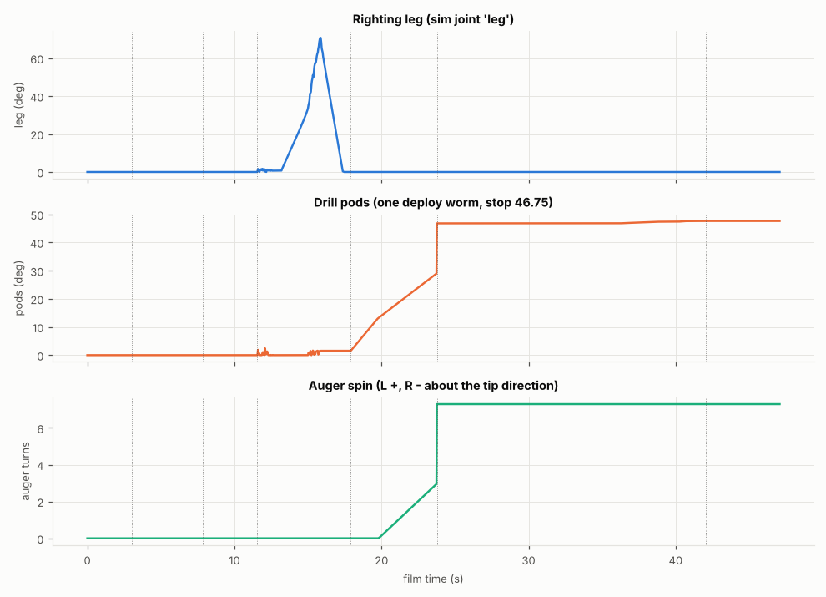
render/motion/plots/06_dart_joints.png
