HarryHYu/GrappStar/render/motion/plots/07_tether.png

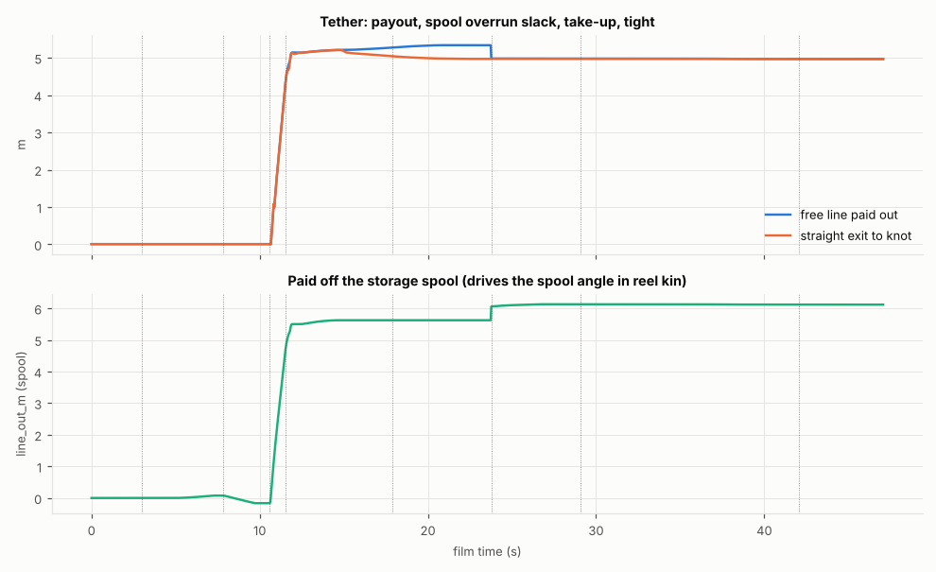
render/motion/plots/07_tether.png
