HarryHYu/GrappStar/render/motion/plots/08_line_snapshots.png

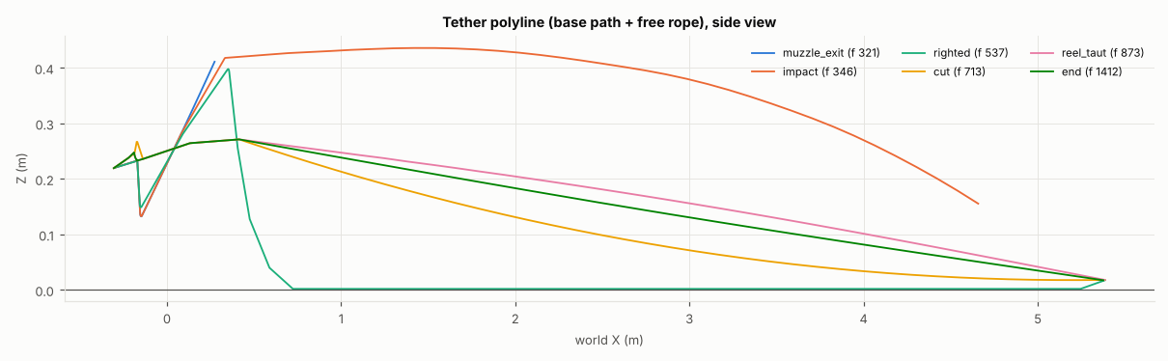
render/motion/plots/08_line_snapshots.png
