HarryHYu/GrappStar/render/motion/plots/09_sim_tension.png

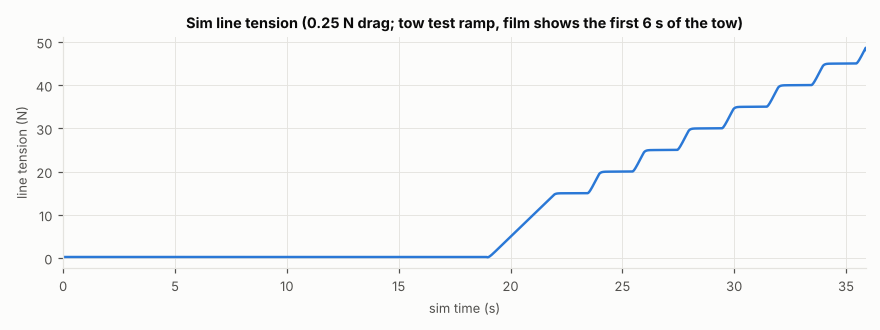
render/motion/plots/09_sim_tension.png
