HarryHYu/GrappStar/render/motion/plots/10_scene_check.png

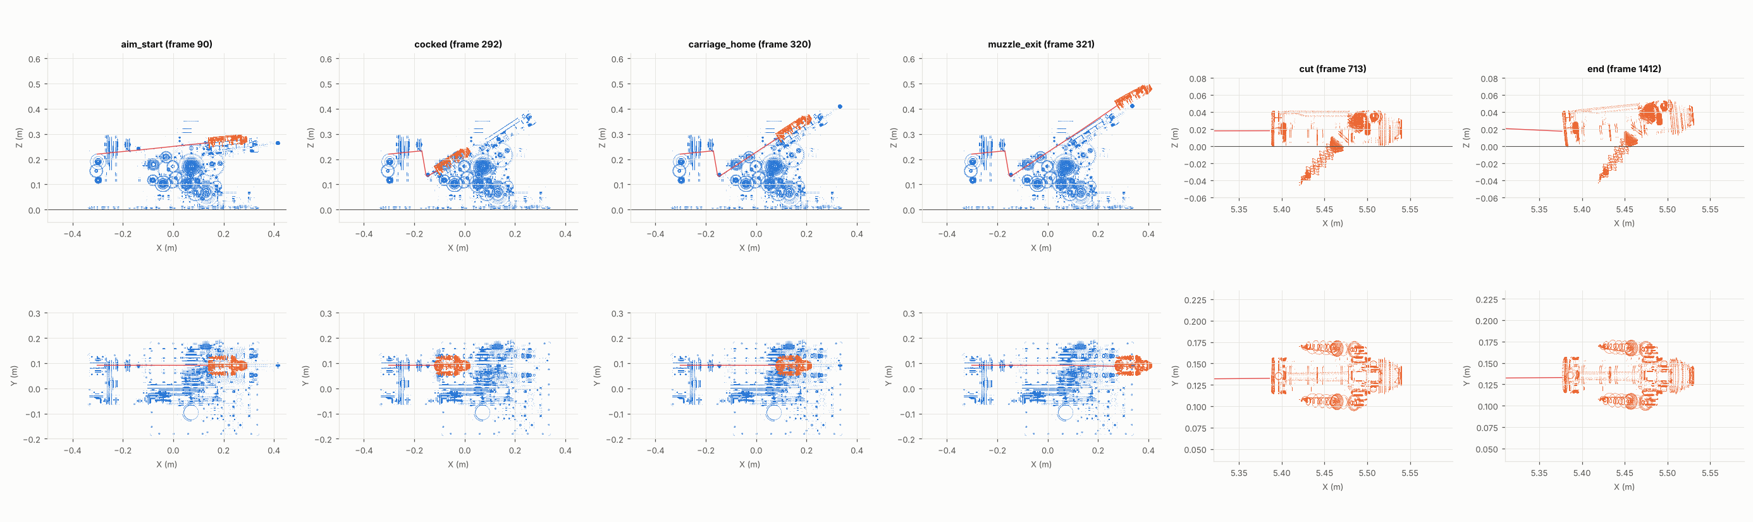
render/motion/plots/10_scene_check.png
