HarryHYu/GrappStar/render/out/env_sheet.png

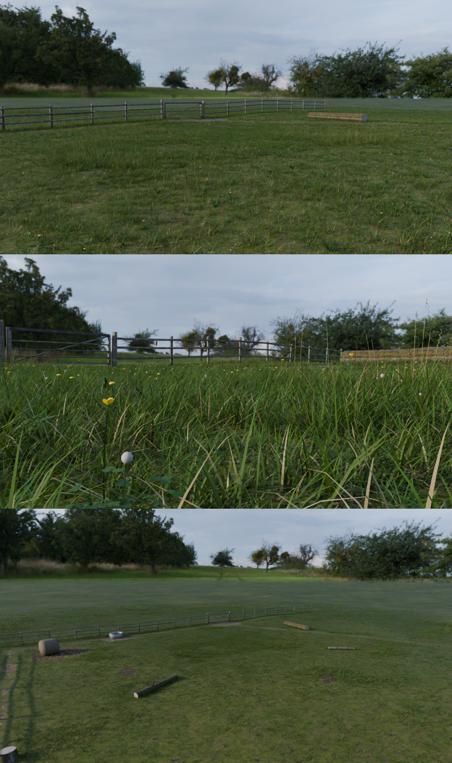
render/out/env_sheet.png
