HarryHYu/GrappStar/render/out/models_sheet.png

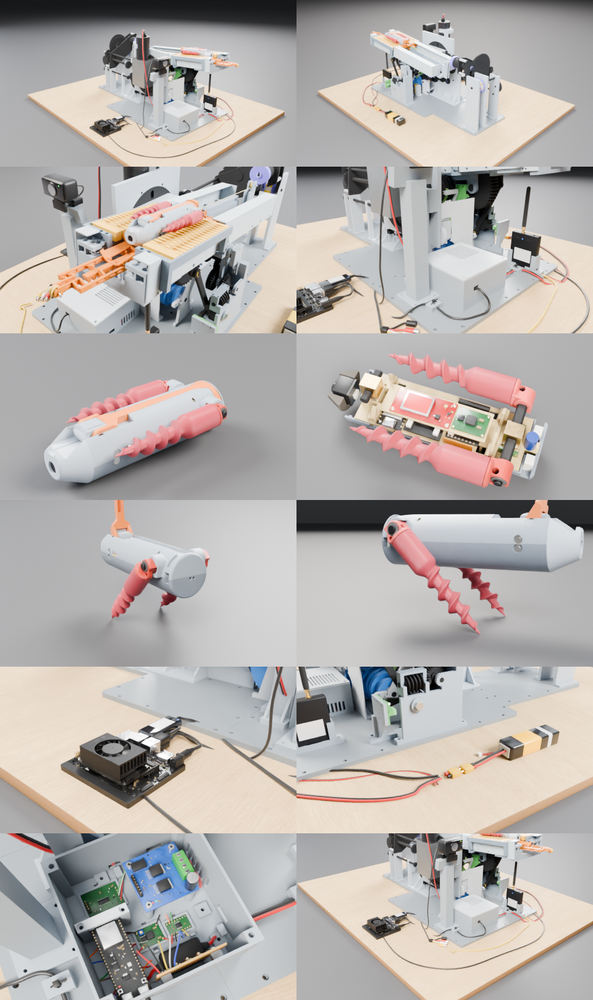
render/out/models_sheet.png
