HarryHYu/GrappStar/render/out/preview_env.png

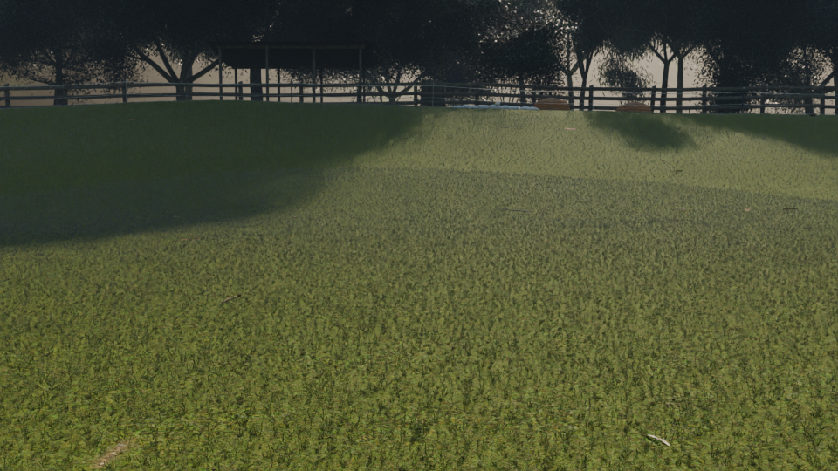
render/out/preview_env.png
