HarryHYu/GrappStar/render/out/preview_env_b.png

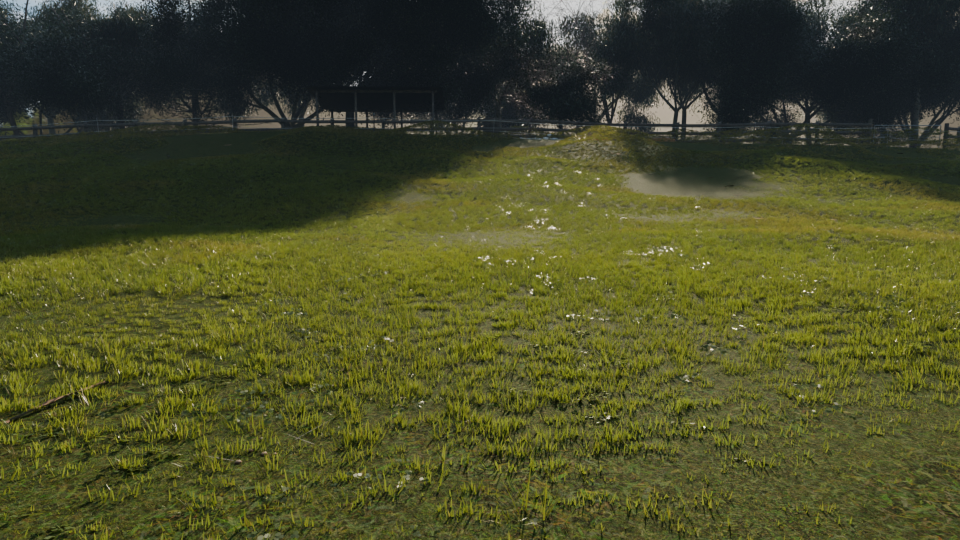
render/out/preview_env_b.png
