HarryHYu/GrappStar/render/out/preview_env_fg.png

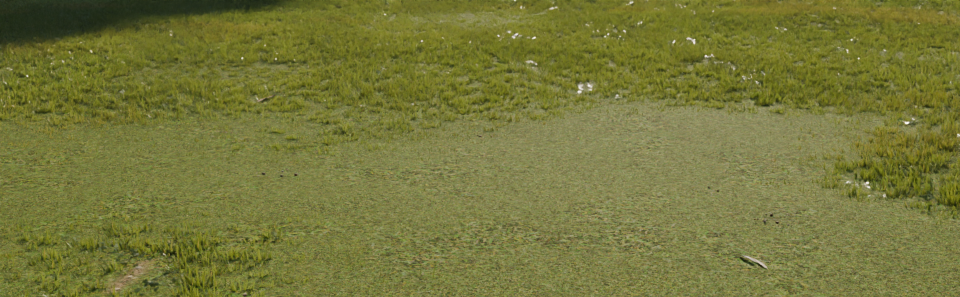
render/out/preview_env_fg.png
