HarryHYu/GrappStar/render/out/preview_env_photo.png

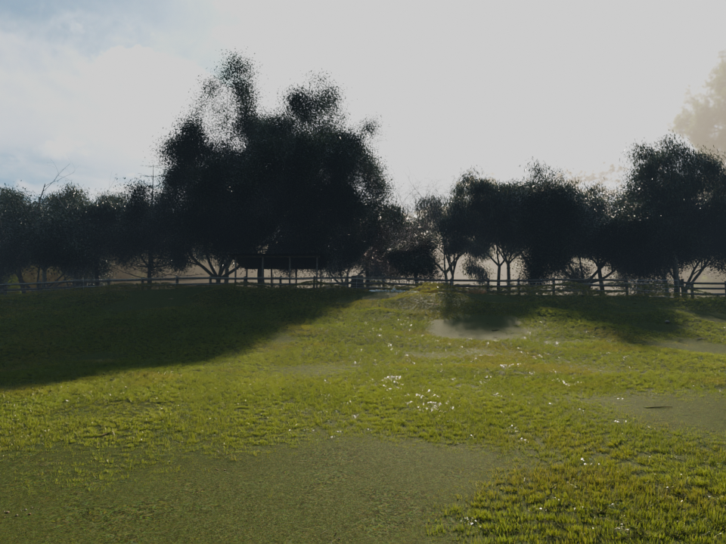
render/out/preview_env_photo.png
