HarryHYu/GrappStar/render/out/preview_models_base.png

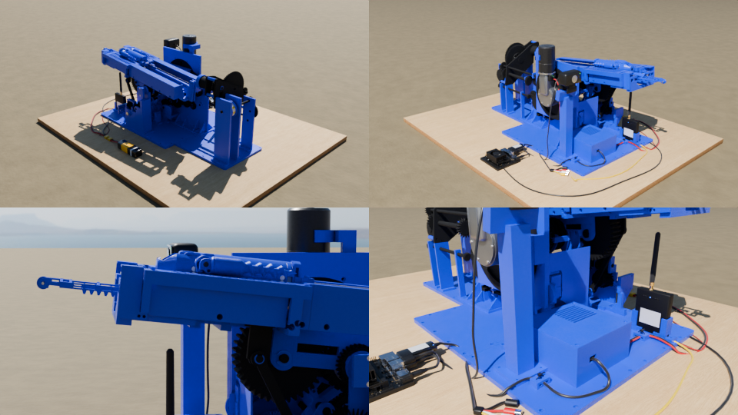
render/out/preview_models_base.png
