HarryHYu/GrappStar/render/out/preview_models_dart.png

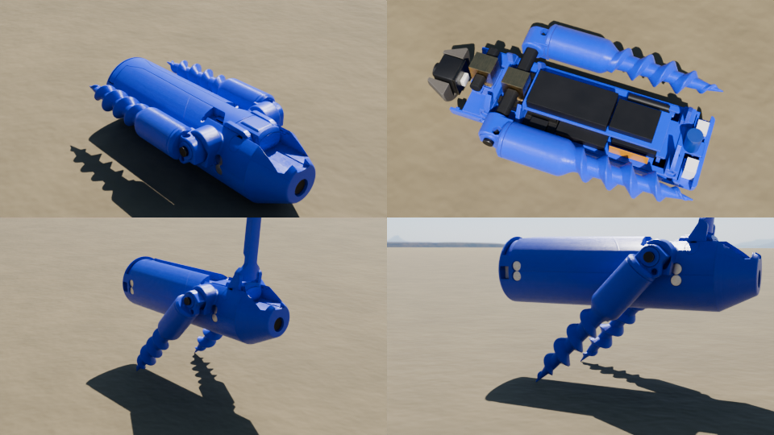
render/out/preview_models_dart.png
