HarryHYu/GrappStar/render/out/preview_models_elec.png

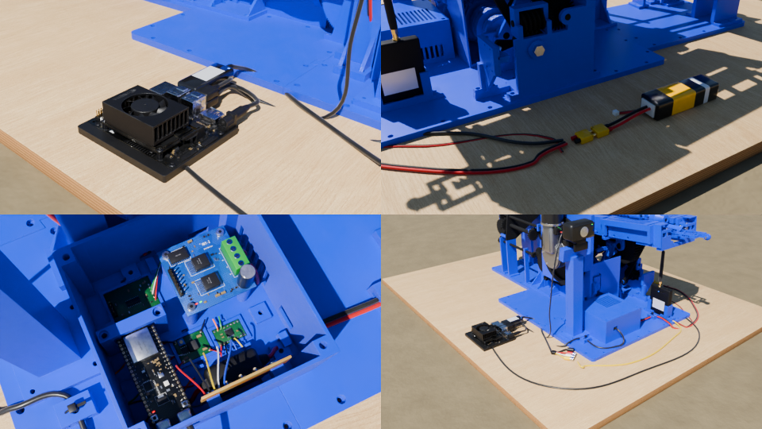
render/out/preview_models_elec.png
