HarryHYu/GrappStar/render/out/preview_models_hardlight_check.png

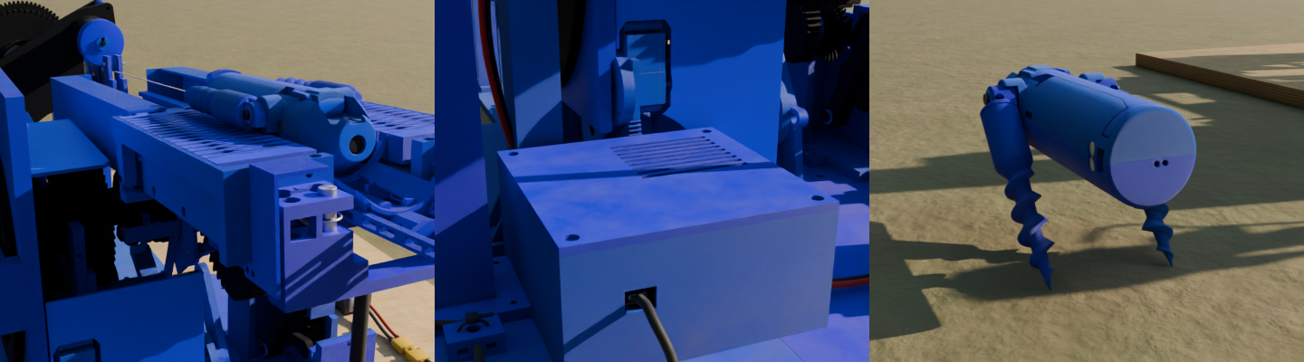
render/out/preview_models_hardlight_check.png
