HarryHYu/GrappStar/render/out/preview_models_sun_check.png

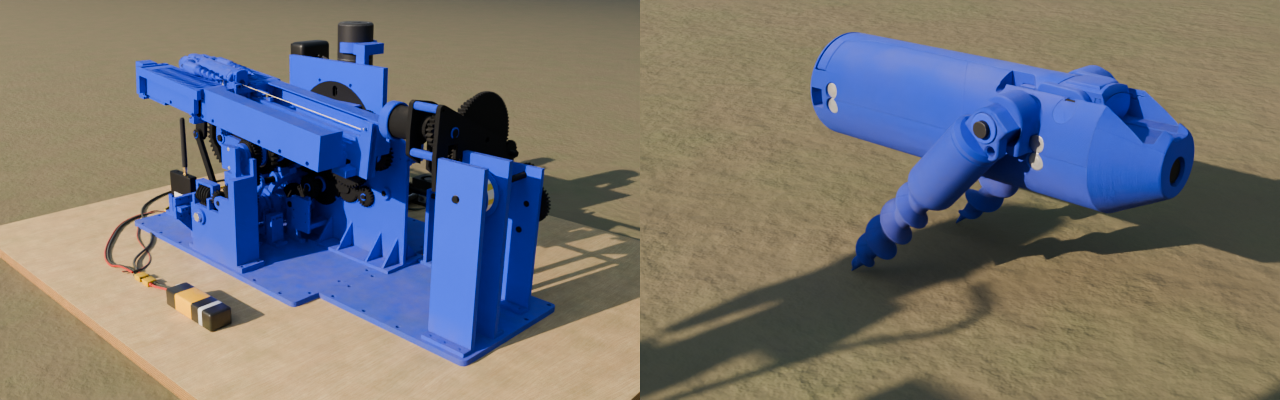
render/out/preview_models_sun_check.png
