HarryHYu/GrappStar/render/out/progress_1.png

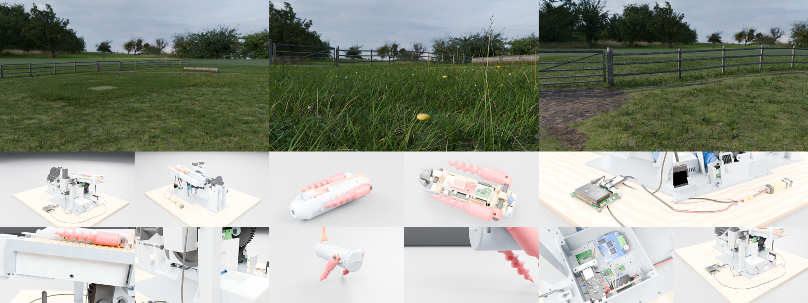
render/out/progress_1.png
