HarryHYu/GrappStar/render/out/shot_A1_launch.png

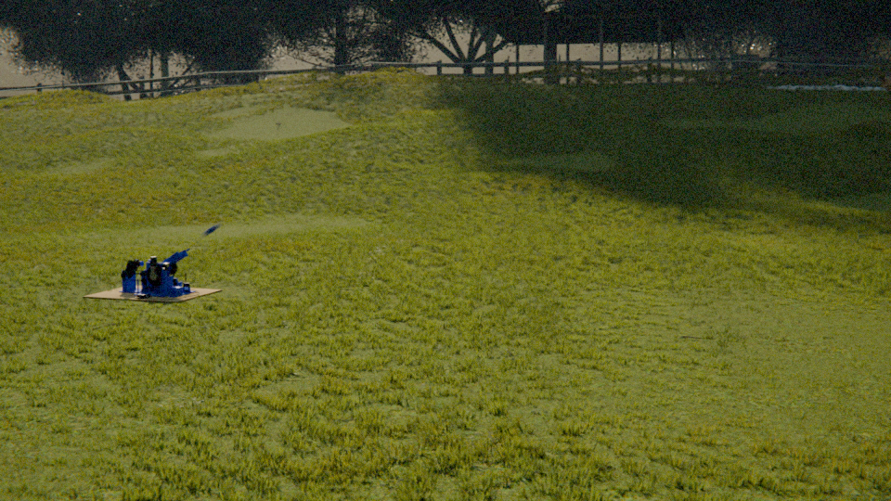
render/out/shot_A1_launch.png
