HarryHYu/GrappStar/render/out/shot_A2_flight.png

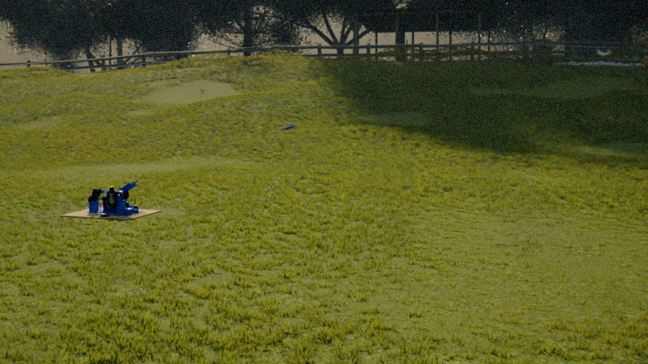
render/out/shot_A2_flight.png
