HarryHYu/GrappStar/render/out/shot_A3_landed.png

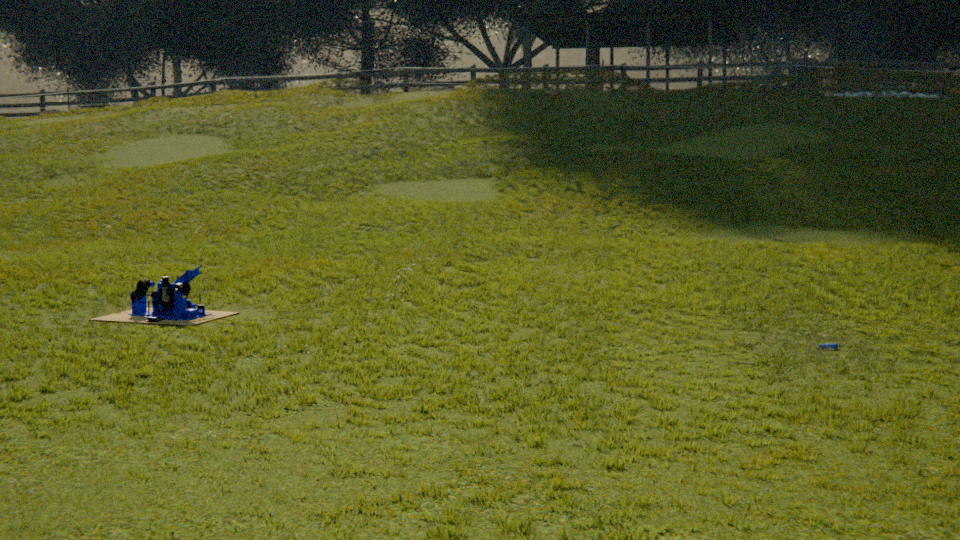
render/out/shot_A3_landed.png
