HarryHYu/GrappStar/render/out/shot_A4_righting.png

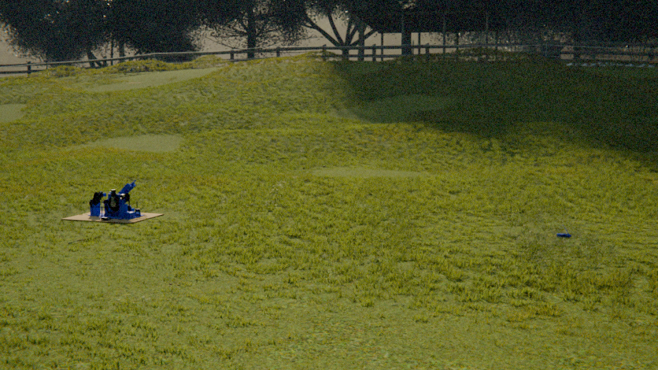
render/out/shot_A4_righting.png
