HarryHYu/GrappStar/render/out/shot_A5_drills.png

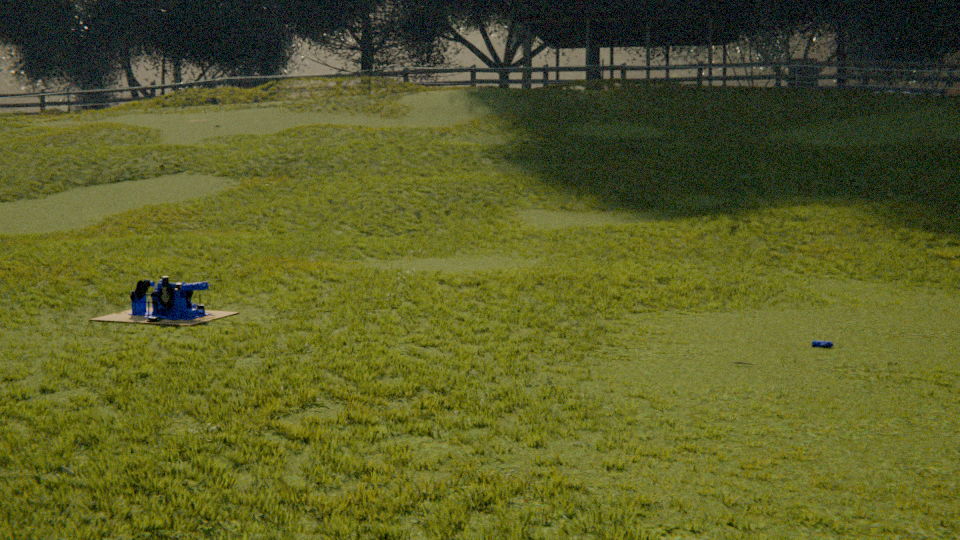
render/out/shot_A5_drills.png
