HarryHYu/GrappStar/render/out/shot_B1_taut.png

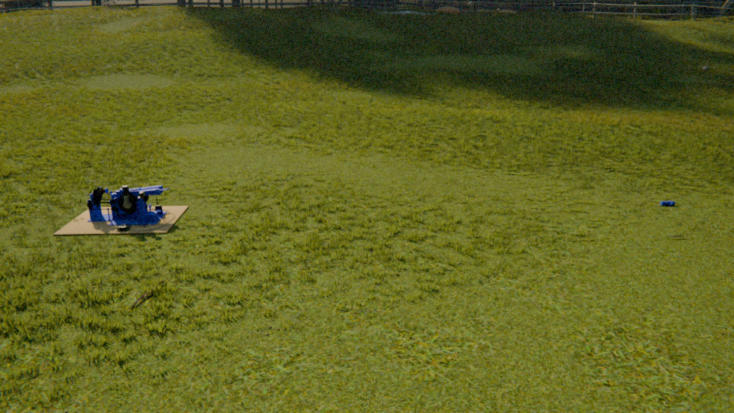
render/out/shot_B1_taut.png
