HarryHYu/GrappStar/render/out/shot_B2_tow.png

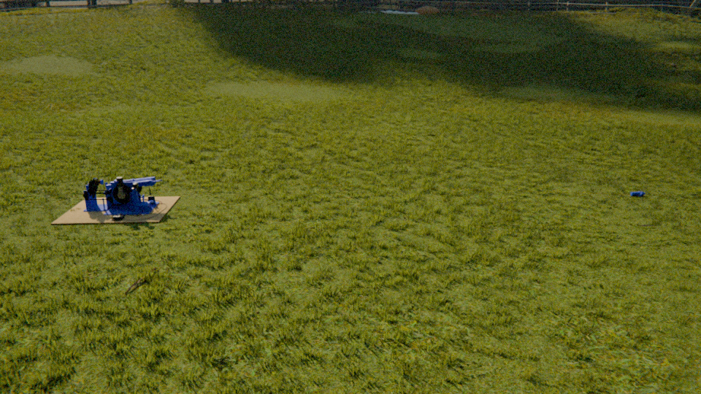
render/out/shot_B2_tow.png
