HarryHYu/GrappStar/render/out/shots_sheet.png

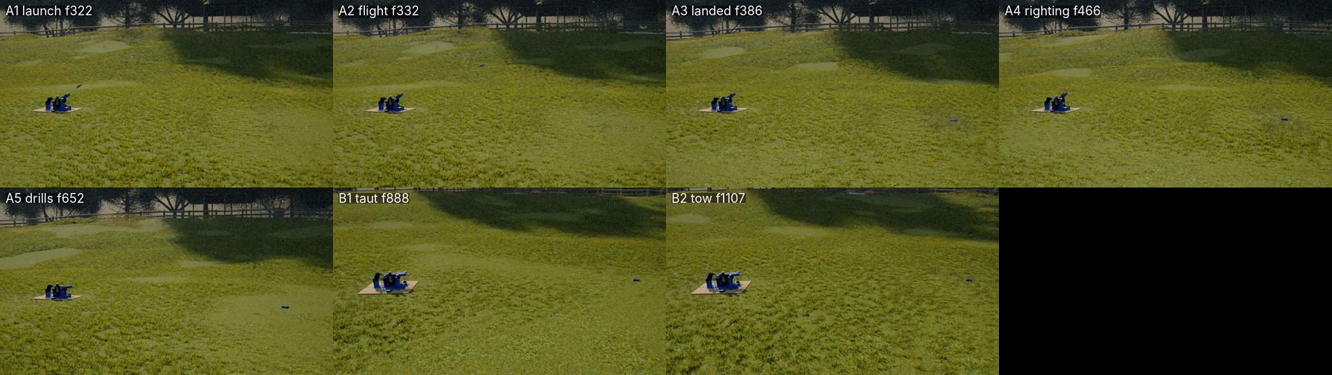
render/out/shots_sheet.png
