HarryHYu/GrappStar/render/out/still_front.png

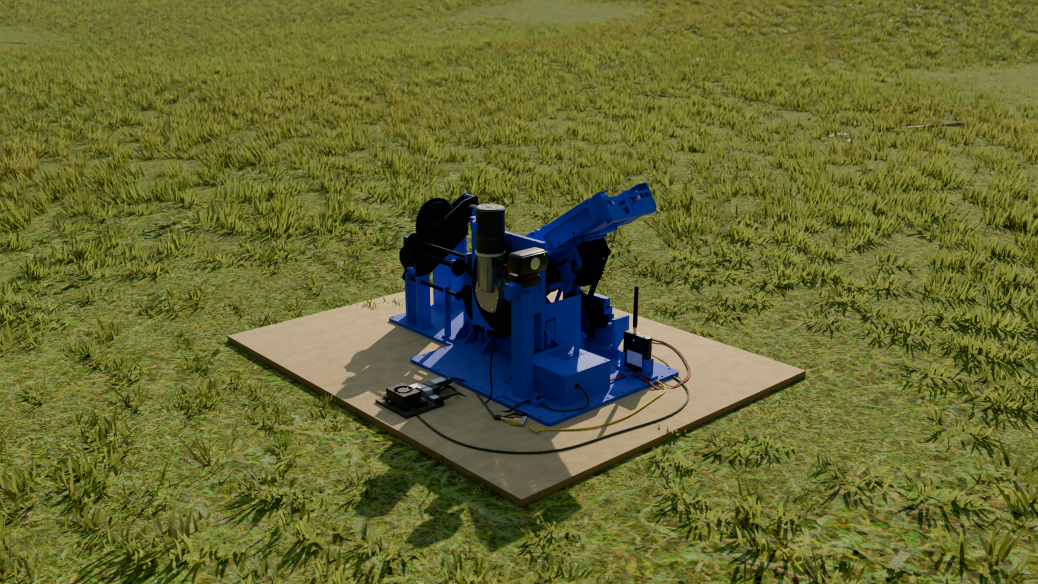
render/out/still_front.png
