HarryHYu/GrappStar/render/out/still_rear.png

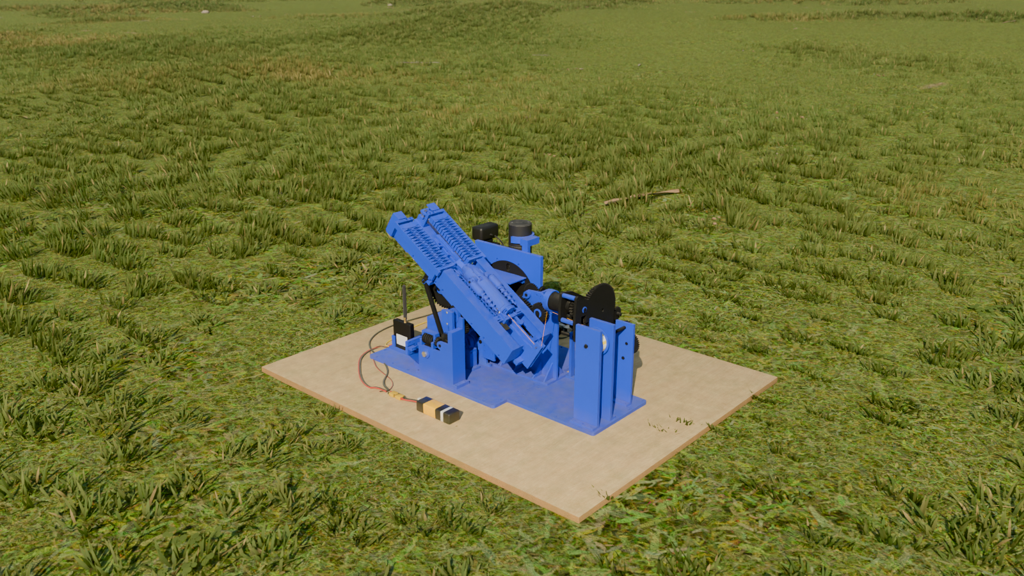
render/out/still_rear.png
