HarryHYu/GrappStar/render/out/table_a.png

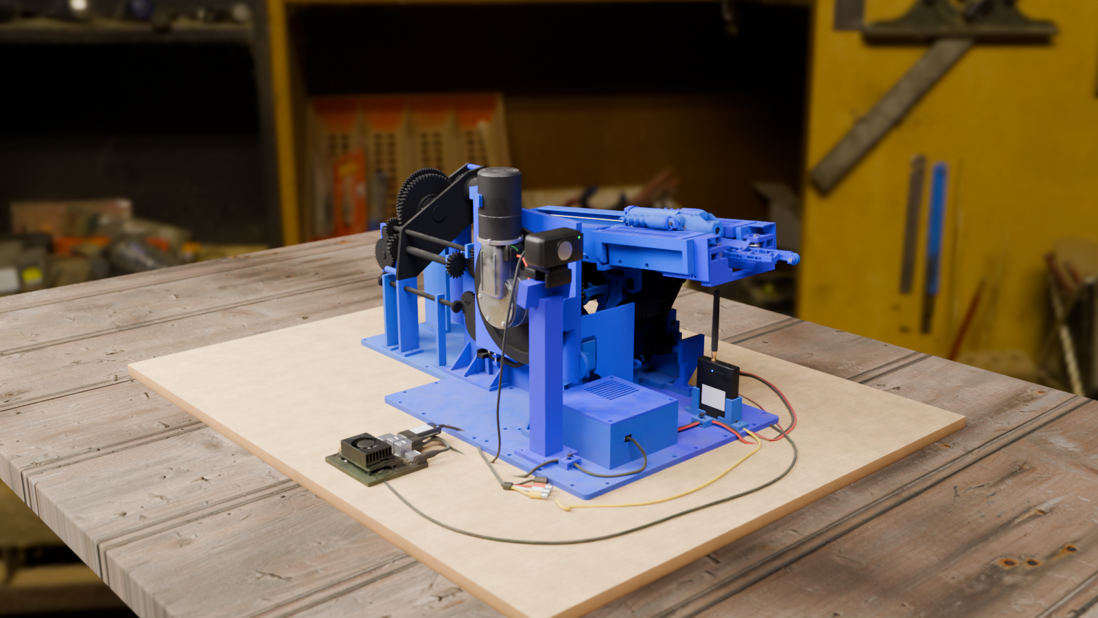
render/out/table_a.png
