HarryHYu/GrappStar/render/out/table_b.png

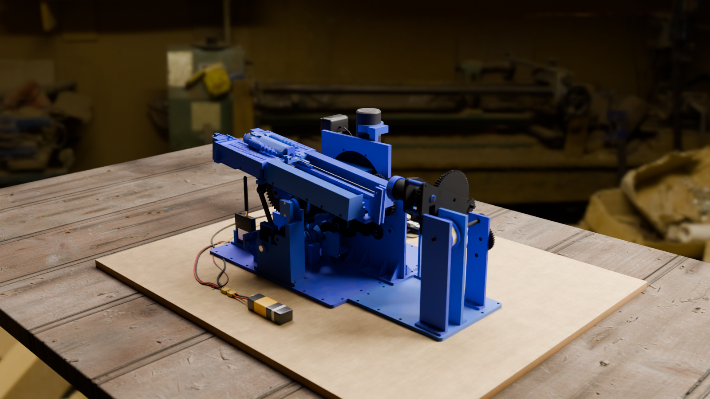
render/out/table_b.png
