HarryHYu/GrappStar/render/out/table_dart.png

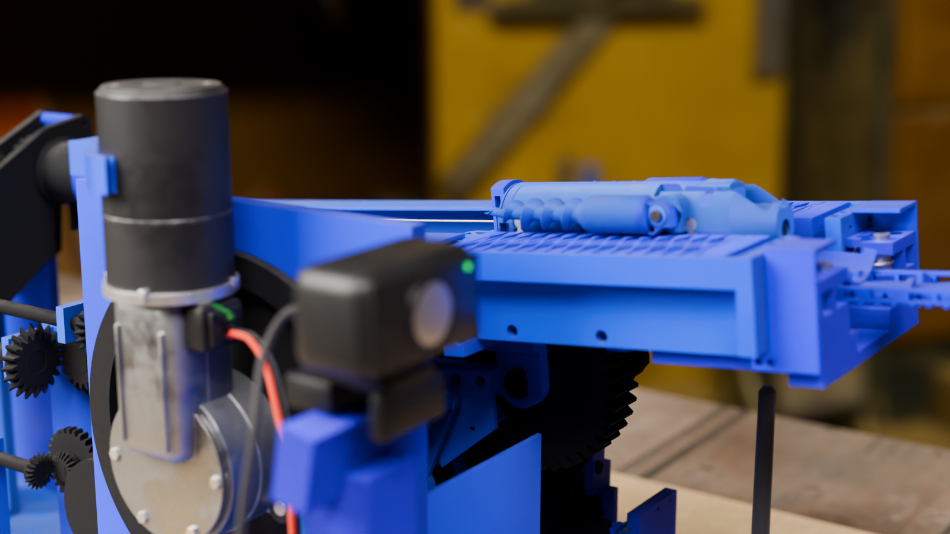
render/out/table_dart.png
