HarryHYu/GrappStar/base/out/base/BOM.md

# Bill of materials

## Printed parts

| part | subsystem | material | qty | mass g each | mass g total | notes |
|---|---|---|---|---|---|---|
| drum_bracket_a | drum | PLA | 1 | 37.7 | 37.7 | Drum bracket A: axle, shift rail, N20 ear, 2 x M3 to the deck |
| drum_bracket_b | drum | PLA | 1 | 23.4 | 23.4 | Drum bracket B: axle, shift rail, 2 x M3 to the deck |
| drum_bracket_idler | drum | PLA | 1 | 12.5 | 12.5 | Wrap idler journal post, 2 x M3 to the deck |
| drum_bracket_idler2 | drum | PLA | 1 | 16.2 | 16.2 | Wrap idler second journal post (motor end), 2 x M3 to the deck |
| drum_dog_post | drum | PLA | 1 | 6.0 | 6.0 | Dog contact post on the shift rail: SW_DOG_R and SW_DOG_L screws (collar fully engaged) |
| drum_drum_a | drum | PLA | 1 | 146.5 | 146.5 | Drum A: N20 gear 120T m0.8, brake cam, wrap segment gear + locking arc, hex spigot |
| drum_drum_b | drum | PLA | 1 | 79.0 | 79.0 | Drum B: shift groove barrel, Gray code bands A B C, hand lever hex boss |
| drum_fork | drum | PLA | 1 | 25.9 | 25.9 | Compliant shift fork: thin yoke is the spring (about 1.5 N/mm), follower pin in groove 1, contact tab |
| drum_hand_lever | drum | PLA | 1 | 4.0 | 4.0 | Hand lever on the drum hex boss (fallback: swing the N20 out first) |
| drum_index_block | drum | PLA | 1 | 8.1 | 8.1 | SW_INDEX block: 2 x M3 x 12 through the idler post 2 strut, M3 nut contact |
| drum_index_lever | drum | PLA | 1 | 0.9 | 0.9 | SW_INDEX lever on the 6-bump coupler cam (D12 fallback encoder) |
| drum_magnet_cap | drum | PLA | 1 | 1.9 | 1.9 | AS5600 magnet cap on the spigot end (6 x 2.5 diametric or edge-on disc), M3 x 6 onto the flat |
| drum_n20_cradle | drum | PLA | 1 | 11.9 | 11.9 | N20 cradle on the bracket A ear: pivot + swing screw (hand fallback), SW_N20 contact |
| drum_n20_strap | drum | PLA | 1 | 2.7 | 2.7 | End plate closing the N20 cradle, 2 x M3 x 8 |
| drum_shear_pin | drum | PLA | 6 | 0.2 | 1.1 | Torque limiter shear pin d4 (about 5 N m), prints lying; print 6, 5 are spares |
| drum_sw_lever_0 | drum | PLA | 1 | 1.0 | 1.0 | Code switch lever A: flexure, round nub, M3 x 6 contact screw |
| drum_sw_lever_1 | drum | PLA | 1 | 1.0 | 1.0 | Code switch lever B: flexure, round nub, M3 x 6 contact screw |
| drum_sw_lever_2 | drum | PLA | 1 | 1.0 | 1.0 | Code switch lever C: flexure, round nub, M3 x 6 contact screw |
| drum_switch_block | drum | PLA | 1 | 16.6 | 16.6 | Code switch block: 3 lever feet, 3 M3 nut contacts (SW_DRUM_A, B, C) |
| frame_cable_anchor_1 | frame | PLA | 1 | 4.0 | 4.0 | cable-tie anchor (strain relief), 1 x M3 x 12 into the deck |
| frame_cable_anchor_2 | frame | PLA | 1 | 4.0 | 4.0 | cable-tie anchor (strain relief), 1 x M3 x 12 into the deck |
| frame_camera_mount | frame | PLA | 1 | 166.5 | 166.5 | Kiyo X mount: its own clip grips the 16 mm edge plate (or a 1/4-20 screw), 4 x M3 x 10 into the deck |
| frame_can_stay | frame | PLA | 1 | 28.4 | 28.4 | can stay: post on the motor plate (2 x M3 x 12 into plate inserts), cable tie or hose clamp round the can through the cradle slots; reprint with the adapter |
| frame_cheek_r | frame | PLA | 1 | 197.7 | 197.7 | motor plate (y -10..0, front face = the spec's y 0): window for the puck adapter, 8 rim holes (M3 x 12 from the front into the puck lip), bridge to the motor leg (2 x M3 x 12), can stay and hood inserts; carved round the other subsystems |
| frame_deck_1 | frame | PLA | 1 | 290.3 | 290.3 | deck: M3 inserts for every frame foot; 9 x M3 rover holes (it is its own drill template) |
| frame_deck_2 | frame | PLA | 1 | 241.0 | 241.0 | deck: M3 inserts for every frame foot; 8 x M3 rover holes (it is its own drill template) |
| frame_deck_3 | frame | PLA | 1 | 302.3 | 302.3 | deck: M3 inserts for every frame foot; 7 x M3 rover holes (it is its own drill template) |
| frame_deck_4 | frame | PLA | 1 | 249.9 | 249.9 | deck: M3 inserts for every frame foot; 11 x M3 rover holes (it is its own drill template) |
| frame_deck_ext | frame | PLA | 1 | 340.5 | 340.5 | deck: M3 inserts for every frame foot; 8 x M3 rover holes (it is its own drill template) |
| frame_ebay | frame | PLA | 1 | 175.3 | 175.3 | electronics bay: ESP32-S3 cradle (USB slot), BTS7960 on standoffs with vents, DRV8833, MP1584, HX711 pockets, fuse cradle, wire exits with tie anchors |
| frame_ebay_esp_clamp | frame | PLA | 1 | 1.6 | 1.6 | ESP32 hold-down over the module end, 2 x M3 x 8 into the cradle posts |
| frame_ebay_lid | frame | PLA | 1 | 71.4 | 71.4 | bay lid: grille over the BTS7960, 4 x M3 into the corner bosses |
| frame_guard_front | frame | PLA | 1 | 46.0 | 46.0 | front gear guard between the drum gears and the bay, M3 x 10 into the deck |
| frame_guard_hood | frame | PLA | 1 | 26.2 | 26.2 | gear hood over the reel and bus gears, M3 x 10 through its lugs into the motor plate |
| frame_motor_leg | frame | PLA | 1 | 117.3 | 117.3 | motor support leg (prints upright): 4 x M3 x 10 into the deck, 2 x M3 x 12 along y into the bridge behind the motor plate |
| frame_rc832_holder | frame | PLA | 1 | 22.8 | 22.8 | RC832 holder: receiver stands antenna-end up in the slot, leads out low, 2 x M3 x 10 |
| launch_aim_cap | launch | PLA | 1 | 5.2 | 5.2 | Worm shaft saddle cap, 4 x M3x30 through the legs into 13 deep pilots in the saddles |
| launch_aim_crankpin_clip | launch | PLA | 1 | 0.1 | 0.1 | Printed C clip on the crank pin, inboard of the conrod |
| launch_aim_drag_pad | launch | PLA | 1 | 0.4 | 0.4 | Flexure drag pad: cantilever finger t 2, tip bump 0.45 into the sleeve d20 (strain 0.43 %, about 2.3 N), root block pushed axially into the arm hub pocket |
| launch_aim_drag_shim | launch | PLA | 1 | 0.1 | 0.1 | Preload shim behind the drag pad root block (nominal; print up to 0.25 thicker for more drag, strain stays under 0.7 %) |
| launch_aim_housing | launch | PLA | 1 | 185.4 | 185.4 | Aim housing on the deck (4 x M3 x 10 from the top through its counterbored foot flanges into the deck inserts): sleeve end bushing, countershaft bushings, worm saddles, M8 wheel bolt (head on the outer boss, nut in the inner face hex pocket), engaged and swung-out swing arm stop posts |
| launch_aim_idler_clip | launch | PLA | 1 | 0.1 | 0.1 | Printed C clip on the arm pin, holds the idler |
| launch_aim_lugpin_clip | launch | PLA | 1 | 0.1 | 0.1 | Printed C clip on the lug pin, outboard of the conrod |
| launch_carriage | launch | PLA | 1 | 59.6 | 59.6 | Carriage: rack, shoes, dart cradle, pusher with tether hole, spring arms and pegs, SW feet |
| launch_carriage_yoke | launch | PLA | 1 | 23.5 | 23.5 | Bolted yoke: both spring arms (hit the stop, d8.1 holes for the 8 mm steel rod spring pegs, D5 holes at y +-56 empty), cross bar, keys, SW_SEATED block, rigid SW_HOME foot. Prints on the peg boss bottoms and key plates (w 62) |
| launch_drive_washer | launch | PLA | 1 | 0.2 | 0.2 | Spacer washer: drive gear hub to the left cheek |
| launch_gear_clip | launch | PLA | 1 | 0.3 | 0.3 | C clip on the big gear pin groove |
| launch_gear_washer | launch | PLA | 1 | 0.5 | 0.5 | Spacer washer: big gear hub to the left cheek |
| launch_guard_l_a | launch | PLA | 1 | 65.0 | 65.0 | Spring guard left rear (end wall, top cover) (D33): 2 mm side plate outside both spring pairs, 4 wall brackets (M3x12 self tap into the rail wall); fit by moving it inward |
| launch_guard_l_b1 | launch | PLA | 1 | 4.5 | 4.5 | Spring guard left mid front of the stop frame (D33): 2 mm side plate outside both spring pairs, 1 wall bracket (M3x12 self tap into the rail wall); fit by moving it inward |
| launch_guard_l_b2 | launch | PLA | 1 | 17.9 | 17.9 | Spring guard left mid under the stop spring (D33): 2 mm side plate outside both spring pairs, 1 wall bracket (M3x12 self tap into the rail wall) and a foot on the front plate (M3x10 self tap down); fit by moving it inward |
| launch_guard_l_c | launch | PLA | 1 | 4.8 | 4.8 | Spring guard left front (top cover) (D33): 2 mm side plate outside both spring pairs, 2 bosses on the front plate edge (M3x12 self tap along y); fit by moving it inward |
| launch_guard_r_a | launch | PLA | 1 | 65.0 | 65.0 | Spring guard right rear (end wall, top cover) (D33): 2 mm side plate outside both spring pairs, 4 wall brackets (M3x12 self tap into the rail wall); fit by moving it inward |
| launch_guard_r_b1 | launch | PLA | 1 | 4.5 | 4.5 | Spring guard right mid front of the stop frame (D33): 2 mm side plate outside both spring pairs, 1 wall bracket (M3x12 self tap into the rail wall); fit by moving it inward |
| launch_guard_r_b2 | launch | PLA | 1 | 21.8 | 21.8 | Spring guard right mid under the stop spring (D33): 2 mm side plate outside both spring pairs, 2 wall brackets (M3x12 self tap into the rail wall) and a foot on the front plate (M3x10 self tap down); fit by moving it inward |
| launch_guard_r_c | launch | PLA | 1 | 4.8 | 4.8 | Spring guard right front (top cover) (D33): 2 mm side plate outside both spring pairs, 2 bosses on the front plate edge (M3x12 self tap along y); fit by moving it inward |
| launch_muzzle_roller | launch | PLA | 1 | 0.5 | 0.5 | Lip roller at the carriage front: the tether bends down over it in tow and retrieval (groove r 6 for the 1 mm line), 693ZZ inside |
| launch_muzzle_washer_l | launch | PLA | 1 | 0.0 | 0.0 | Lip roller thrust washer (0.9 thick, flange on the cheek side) between the bearing inner race and the cheek: put both in the roller bore, then drop roller and washers into the fork slot |
| launch_muzzle_washer_r | launch | PLA | 1 | 0.0 | 0.0 | Lip roller thrust washer (0.9 thick, flange on the cheek side) between the bearing inner race and the cheek: put both in the roller bore, then drop roller and washers into the fork slot |
| launch_pulley_top | launch | PLA | 1 | 0.5 | 0.5 | Rail-rear tether pulley (D50, the line runs under it), groove r 6, 693ZZ inside |
| launch_pulley_top_washer_l | launch | PLA | 1 | 0.1 | 0.1 | Printed top-hat thrust washer between fork plate and 693ZZ inner race |
| launch_pulley_top_washer_r | launch | PLA | 1 | 0.1 | 0.1 | Printed top-hat thrust washer between fork plate and 693ZZ inner race |
| launch_rail_front | launch | PLA | 1 | 137.7 | 137.7 | Rail front piece: shoe track end, spring anchor posts with straps, muzzle tie |
| launch_rail_mid | launch | PLA | 1 | 178.6 | 178.6 | Rail mid piece: shoe track, cheeks on the sleeve, big gear pin bosses, lever seats, SW_GAP bracket pilots |
| launch_rail_rear | launch | PLA | 1 | 135.9 | 135.9 | Rail rear piece: shoe track, walls, tether fork and two pulleys behind the rear end |
| launch_rail_splice_l | launch | PLA | 1 | 0.3 | 0.3 | Top splice strap over the front rail joint (4 x M3 x 10 self tap) |
| launch_rail_splice_r | launch | PLA | 1 | 0.3 | 0.3 | Top splice strap over the front rail joint (4 x M3 x 10 self tap) |
| launch_seat_clip | launch | PLA | 1 | 0.1 | 0.1 | Head cap on the plunger pin (rests on the yoke block) |
| launch_stop_frame_l | launch | PLA | 1 | 32.7 | 32.7 | Stop frame (print outboard face down): outboard preload ledge, anchor seat, rear foot (2 x M3x12 into the rail wall), front foot (2 x M3x16 into the rail front plate, hex key through the d6.5 holes in the front wall). Fit before the spring guards and the main springs |
| launch_stop_frame_r | launch | PLA | 1 | 32.7 | 32.7 | Stop frame (print outboard face down): outboard preload ledge, anchor seat, rear foot (2 x M3x12 into the rail wall), front foot (2 x M3x16 into the rail front plate, hex key through the d6.5 holes in the front wall). Fit before the spring guards and the main springs |
| launch_stop_spring_l | launch | PLA | 1 | 81.6 | 81.6 | Carriage stop flexure: 16 loops (31 tapered leaves t 3.15/1.0 x 14), print upside down on the flat w 83.5 face, 100% infill / all perimeters; preload 6.6 mm by 2 x M3x20 draw screws through the frame front wall |
| launch_stop_spring_r | launch | PLA | 1 | 81.6 | 81.6 | Carriage stop flexure: 16 loops (31 tapered leaves t 3.15/1.0 x 14), print upside down on the flat w 83.5 face, 100% infill / all perimeters; preload 6.6 mm by 2 x M3x20 draw screws through the frame front wall |
| launch_sw_home | launch | PLA | 1 | 0.8 | 0.8 | SW_HOME printed flex lever on the right rail lip, at rest (prints on its side): beam 0.8 thick, contact gap 0.50 (one screw turn), pad pretravel 0.70 + overtravel 0.25, peak strain 0.10 % (limit 0.8 %) |
| launch_sw_seated | launch | PLA | 1 | 0.8 | 0.8 | SW_SEATED printed flex lever on the left rail lip, at rest (prints on its side): beam 0.8 thick, contact gap 0.50 (one screw turn), pad pretravel 0.70 + overtravel 0.25, peak strain 0.10 % (limit 0.8 %) |
| reel_bar_cap_1 | reel | PLA | 1 | 1.0 | 1.0 | Bar guide cap: closes the U guide over the bar. Print flat |
| reel_bar_cap_2 | reel | PLA | 1 | 1.0 | 1.0 | Bar guide cap: closes the U guide over the bar. Print flat |
| reel_c_clip | reel | PLA | 1 | 1.0 | 1.0 | C-clip behind G_c |
| reel_cheek_i | reel | PLA | 1 | 102.1 | 102.1 | Inboard cheek: spool shaft 608, P2 bolts to its front edge. Print flat |
| reel_cheek_o | reel | PLA | 1 | 102.1 | 102.1 | Outboard cheek: spool shaft 608, P2 bolts to its front edge. Print flat |
| reel_cs_clip | reel | PLA | 1 | 0.5 | 0.5 | C-clip behind the C gear |
| reel_cup | reel | PLA | 1 | 12.7 | 12.7 | Wrap cup (Harry v7, ring hole turned axial): ring at the bottom at home, the line passes straight through it. Print open end down |
| reel_cup_clip | reel | PLA | 1 | 0.3 | 0.3 | Harry's v7 C-clip on the cup shaft neck in front of the cup |
| reel_k_clip | reel | PLA | 1 | 0.1 | 0.1 | C-clip holding the cup gear on the cup shaft |
| reel_k_clip2 | reel | PLA | 1 | 0.1 | 0.1 | C-clip in front of the riser gear |
| reel_kc_clip | reel | PLA | 1 | 0.1 | 0.1 | C-clip behind P2 |
| reel_p1_leg | reel | PLA | 1 | 30.8 | 30.8 | P1 leg: from the deck up to P1; lane T runs through its bushing. Print on its side |
| reel_p2_leg | reel | PLA | 1 | 22.8 | 22.8 | P2 leg: from the deck up to P2; lane T runs through its bushing. Print on its side |
| reel_post_t | reel | PLA | 1 | 12.8 | 12.8 | Lane T front post on the deck extension. Print on its foot |
| reel_s_clip | reel | PLA | 1 | 0.1 | 0.1 | C-clip holding the reel gear |
| reel_sleeve_clip | reel | PLA | 1 | 1.0 | 1.0 | C-clip on the sleeve behind the bus gear hub |
| reel_spacer_1 | reel | PLA | 1 | 2.9 | 2.9 | Spacer tube between P1 and P2 (M3 through) |
| reel_spacer_2 | reel | PLA | 1 | 2.9 | 2.9 | Spacer tube between P1 and P2 (M3 through) |
| reel_spacer_3 | reel | PLA | 1 | 2.9 | 2.9 | Spacer tube between P1 and P2 (M3 through) |
| reel_spool | reel | PLA | 1 | 36.1 | 36.1 | Free storage spool: 20 m of 1 mm Dyneema on a dia 40 core, d62 flanges, keyed on the spool shaft |
| reel_sw_base | reel | PLA | 1 | 7.0 | 7.0 | SW_ARM contact base (printed switch, M3 head on M3 nut) |
| reel_sw_bracket | reel | PLA | 1 | 20.6 | 20.6 | SW_ARM bracket: screwed to the wall below the gears. Print flat |
| reel_sw_lever | reel | PLA | 1 | 1.3 | 1.3 | SW_ARM lever: rides the cup gear's raised track (contact closed) and drops into its home notch (open). Print on its side |
| reel_t | reel | PLA | 1 | 1.7 | 1.7 | Thrust ring: the rocker pushes it onto the rear 608 inner race |
| reel_t_bracket | reel | PLA | 1 | 58.3 | 58.3 | T bracket: bushings for T3 and the spool shaft behind the 45T pair. Print flat |
| reel_tab_c | reel | PLA | 1 | 6.6 | 6.6 | Lane C bushing tab: screwed to the wall front. Print on its flange |
| reel_tab_k | reel | PLA | 1 | 5.6 | 5.6 | Lane K bushing tab: screwed to the wall front. Print on its flange |
| reel_wall | reel | PLA | 1 | 291.1 | 291.1 | Reel wall: foot, take-off bosses (C, K2, T2, idlers), rocker ears, stop pins, brake guides and crank boss. Print on its foot |
| sensors_as5600_carrier | sensors | PLA | 1 | 12.7 | 12.7 | AS5600 carrier: plate with 4 pegs through the board holes, column screwed to the aim housing spine |
| sensors_as5600_strip_bot | sensors | PLA | 1 | 1.0 | 1.0 | AS5600 clamp strip on the board edge over the pegs, M3 from the strip front into a nut in the carrier back |
| sensors_as5600_strip_top | sensors | PLA | 1 | 1.0 | 1.0 | AS5600 clamp strip on the board edge over the pegs, M3 from the strip front into a nut in the carrier back |
| sensors_sw_gap | sensors | PLA | 1 | 9.9 | 9.9 | SW_GAP printed contact base (cad.lib.switch, coupon 2 geometry): with its arm screwed to the right rail cheek outer face below the big gear, closed by the big gear cam bump (gear in its gap) |
| sensors_sw_gap_lever | sensors | PLA | 1 | 1.4 | 1.4 | SW_GAP lever, t 1.4 mm, print on its side so layers run along the beam |
| sensors_sw_rail_low | sensors | PLA | 1 | 7.3 | 7.3 | SW_RAIL_LOW printed contact base (cad.lib.switch, coupon 2 geometry): on its bracket on the aim housing foot, closed by the crank cam at the LOW dead point |
| sensors_sw_rail_low_bracket | sensors | PLA | 1 | 17.8 | 17.8 | SW_RAIL_LOW bracket on the aim housing foot extension: an M3x10 into the extension and its own deck screw, an M3x16 from the top through the counterbored foot and the extension into a deck insert |
| sensors_sw_rail_low_lever | sensors | PLA | 1 | 1.3 | 1.3 | SW_RAIL_LOW lever, t 1.4 mm, print on its side so layers run along the beam |
| drum_axle | drum | PPA-CF | 1 | 13.1 | 13.1 | Fixed drum axle d10, pressed into brackets A and B |
| drum_collar | drum | PPA-CF | 1 | 44.0 | 44.0 | Dog collar: hex bore, 4 back-cut roofed dogs each face, fork groove (bridges over the lower dogs) |
| drum_coupler | drum | PPA-CF | 1 | 89.3 | 89.3 | Coupler: 5 N m shear pin limiter (D8), bus gear 50T m1.5 (D25), SW_INDEX cam, REEL journal, hex socket; prints hub end down, tree support under the bus gear ring |
| drum_coupler_hub | drum | PPA-CF | 1 | 14.6 | 14.6 | Coupler hub on the wiper shaft (bore parametric: WIPER), M8 nut inside, shear pin hole |
| drum_dogring_launch | drum | PPA-CF | 1 | 19.0 | 19.0 | LAUNCH dog ring: 3 slots for the launch sleeve lugs, 3 x M3 from the sleeve side |
| drum_gear_reel | drum | PPA-CF | 1 | 95.9 | 95.9 | REEL output gear m2 50T face 12 (D20), free on its sleeve, dog face toward the collar |
| drum_idler | drum | PPA-CF | 1 | 7.6 | 7.6 | Wrap idler shaft: pinion 10T m1.25 (locked at home by the drum lock arc), lock cam, two journals |
| drum_idler_gear | drum | PPA-CF | 1 | 27.5 | 27.5 | Wrap idler output gear 42T m1.5 (D bore) to the cad-reel cup ring 24T: 7 cup turns |
| drum_n20_pinion | drum | PPA-CF | 1 | 0.5 | 0.5 | N20 pinion 10T m0.8, D bore pressed on the N20 shaft |
| drum_rail | drum | PPA-CF | 1 | 13.1 | 13.1 | Shift rail d10, pressed into brackets A and B |
| drum_reel_washer | drum | PPA-CF | 1 | 0.9 | 0.9 | REEL gear retaining washer on the coupler journal end, 2 x M3 x 6 |
| drum_shaft | drum | PPA-CF | 1 | 45.2 | 45.2 | Main shaft: hex 22 AF, d12 spigot into the launch sleeve; prints on a hex flat (support under the spigot) |
| frame_motor_adapter | frame | PPA-CF | 1 | 299.3 | 299.3 | puck adapter: slotted M6 holes (+-4 mm) for the motor bosses, rear lip with 8 M3 inserts for the rim screws; reprint when the motor is measured |
| launch_aim_arm | launch | PPA-CF | 1 | 6.6 | 6.6 | Swing arm on the sleeve, dragged by the printed PLA flexure pad in its hub; printed idler pin with a printed C clip groove |
| launch_aim_bevel30 | launch | PPA-CF | 1 | 8.8 | 8.8 | Bevel m1.5 z30 on the countershaft D flat, drives the z15 2:1 |
| launch_aim_conrod | launch | PPA-CF | 1 | 14.2 | 14.2 | Conrod 156 between pin centres (PPA-CF), printed C clips on both pins |
| launch_aim_crank | launch | PPA-CF | 1 | 35.3 | 35.3 | Worm wheel m2 z20 face 16 = crank gear, crank arm r30 and d8 crank pin in one part, two 608 inside |
| launch_aim_idler | launch | PPA-CF | 1 | 7.5 | 7.5 | Splitter idler m1.5 z18 face 12 on the arm pin |
| launch_aim_lug | launch | PPA-CF | 1 | 16.9 | 16.9 | Lug bracket (PPA-CF), 2 x M3 into the rail wall, d8 lug pin at (u 115.2, w 0) |
| launch_aim_output | launch | PPA-CF | 1 | 26.2 | 26.2 | Splitter output m1.5 z30 face 12 with its d8 countershaft (D flat) |
| launch_aim_sun | launch | PPA-CF | 1 | 18.3 | 18.3 | Splitter sun m1.5 z30 face 12, keyed on the launch sleeve |
| launch_aim_worm | launch | PPA-CF | 1 | 21.3 | 21.3 | Worm m2 pd24 single start (lead angle 4.8 deg, self-locking) + d8 shaft + bevel z15 |
| launch_big_gear | launch | PPA-CF | 1 | 177.6 | 177.6 | Big gear m2.5: sector layer 27 of 40 teeth (rack, v10 release teeth) + full 40T layer (drive), SW_GAP cam bump, on the rail pin |
| launch_drive_gear | launch | PPA-CF | 1 | 29.9 | 29.9 | Drive gear m2.5 26T, sprag #1 inside on an integral key rib |
| launch_gear_pin | launch | PPA-CF | 1 | 5.4 | 5.4 | Snap pin d10 for the big gear, C clip; prints lying on its flat |
| launch_seat_plunger | launch | PPA-CF | 1 | 1.0 | 1.0 | SW_SEATED plunger: foot pad + stem with a 45 deg chamfer, clip groove on top |
| launch_seat_pushrod | launch | PPA-CF | 1 | 0.2 | 0.2 | SW_SEATED pushrod d3.2 with the stem slot |
| launch_sleeve | launch | PPA-CF | 1 | 49.3 | 49.3 | Launch sleeve d20: dog ring flange, integral key ribs (sprag #1, splitter sun), journals |
| launch_yoke_peg_l | launch | PPA-CF | 1 | 1.2 | 1.2 | Spring peg on the yoke arm (printed PPA-CF lying down, or 8 mm steel rod 20 long): pressed into the blind d8.1 hole from below up to its end (a drop of CA if it is loose), the spring hook sits on the 6 mm below the boss (held at w 60 by the spring line); ends deburred |
| launch_yoke_peg_r | launch | PPA-CF | 1 | 1.2 | 1.2 | Spring peg on the yoke arm (printed PPA-CF lying down, or 8 mm steel rod 20 long): pressed into the blind d8.1 hole from below up to its end (a drop of CA if it is loose), the spring hook sits on the 6 mm below the boss (held at w 60 by the spring line); ends deburred |
| reel_bar | reel | PPA-CF | 1 | 7.9 | 7.9 | Brake bar: cad-drum's track 2 cam pushes its nose, its left end turns the crank. Print flat |
| reel_bc | reel | PPA-CF | 1 | 7.5 | 7.5 | C bevel m2 z20 (1:1 into lane C) |
| reel_bcx | reel | PPA-CF | 1 | 8.0 | 8.0 | Lane C bevel m2 z20 (meshes the C bevel) |
| reel_bk2 | reel | PPA-CF | 1 | 3.3 | 3.3 | K bevel m1.5 z18 on K2 (1:1 into lane K) |
| reel_bkx | reel | PPA-CF | 1 | 3.1 | 3.1 | Lane K bevel m1.5 z18 (meshes the K2 bevel) |
| reel_bt2 | reel | PPA-CF | 1 | 1.5 | 1.5 | T bevel m1 z20 on T2 (1:1 into lane T) |
| reel_bt3 | reel | PPA-CF | 1 | 1.3 | 1.3 | T3 bevel m1 z20 |
| reel_bt3x | reel | PPA-CF | 1 | 1.4 | 1.4 | Lane T rear bevel m1 z20 (meshes T3 in front of its axis) |
| reel_btx | reel | PPA-CF | 1 | 1.4 | 1.4 | Lane T front bevel m1 z20 (meshes the T2 bevel) |
| reel_bus | reel | PPA-CF | 1 | 26.3 | 26.3 | Bus gear m1.5 z46 (free on the sleeve): driven by the drum's bus gear, drives the swing idler. Print face down |
| reel_c | reel | PPA-CF | 1 | 19.8 | 19.8 | Capstan tube C: key rib in the sprag and the drum, D flat for G_c. Print standing |
| reel_crank | reel | PPA-CF | 1 | 2.1 | 2.1 | Brake bell crank: the bar turns it, arm B pushes the rocker leg. Print on its flat side |
| reel_crank_washer | reel | PPA-CF | 1 | 0.2 | 0.2 | Printed washer: keeps the crank on its boss |
| reel_cs | reel | PPA-CF | 1 | 9.3 | 9.3 | Countershaft C (PPA-CF d16): bevel in front of the wall, wall bushing, 22T gear behind |
| reel_drum | reel | PPA-CF | 1 | 44.5 | 44.5 | Capstan drum dia 40 x 40 (Harry v7), keyed on the tube. Print flange down |
| reel_ga | reel | PPA-CF | 1 | 11.2 | 11.2 | G_a m2 z20 on lane C |
| reel_ga2 | reel | PPA-CF | 1 | 4.0 | 4.0 | G_a' m1.5 z20 on lane K |
| reel_gc | reel | PPA-CF | 1 | 19.4 | 19.4 | C gear m2 z22: driven by the REEL gear (50T) through the 41T idler |
| reel_gc2 | reel | PPA-CF | 1 | 9.2 | 9.2 | G_c m2 z20 on the capstan tube |
| reel_gi | reel | PPA-CF | 1 | 11.3 | 11.3 | Swing idler m1.5 z30: meshes the reel gear only on forward wiper turns |
| reel_gk | reel | PPA-CF | 1 | 11.9 | 11.9 | Cup gear m1.5 z24: driven by the drum's wrap idler; the raised track on its back holds SW_ARM closed, the notch at home lets it open |
| reel_gk1 | reel | PPA-CF | 1 | 9.3 | 9.3 | Cup riser gear m1.5 z30 on the cup shaft in front of the wall (1:1 riser to K2) |
| reel_gk2 | reel | PPA-CF | 1 | 9.5 | 9.5 | K2 riser gear m1.5 z30 |
| reel_gkc | reel | PPA-CF | 1 | 3.8 | 3.8 | G_k m1.5 z20 on the cup shaft K' |
| reel_gr | reel | PPA-CF | 1 | 4.7 | 4.7 | Reel gear m1.5 z20: turns the clutch disk 2.5 x wiper speed |
| reel_gs | reel | PPA-CF | 1 | 2.9 | 2.9 | Spool shaft gear m1.5 z16 |
| reel_gt2 | reel | PPA-CF | 1 | 9.8 | 9.8 | T2 gear m1.5 z28: meshes the clutch hub 1:1 |
| reel_gt3 | reel | PPA-CF | 1 | 2.9 | 2.9 | T3 gear m1.5 z16 |
| reel_hub | reel | PPA-CF | 1 | 13.1 | 13.1 | Clutch hub: two 608s on the reel shaft, 40T teeth drive T2 (and the spool 1:1). Print rear face down |
| reel_hub_flange | reel | PPA-CF | 1 | 6.0 | 6.0 | Friction disc: keeps the front 608 in, carries the clutch friction ring. Print flat |
| reel_ic | reel | PPA-CF | 1 | 67.6 | 67.6 | REEL idler m2 z41: from the REEL gear to the C gear |
| reel_ic_axle | reel | PPA-CF | 1 | 2.0 | 2.0 | REEL idler axle pin (PPA-CF d8): pressed into the wall from behind, head behind the idler |
| reel_icr | reel | PPA-CF | 1 | 89.2 | 89.2 | I_c m2 z58: idler from lane C to the capstan, sprag #2 pressed in its hub |
| reel_icr_axle | reel | PPA-CF | 1 | 11.9 | 11.9 | I_c axle (PPA-CF d20, keyed): fixed in P1 (D flat), carries sprag #2's inner race |
| reel_ik1 | reel | PPA-CF | 1 | 12.3 | 12.3 | Cup riser idler m1.5 z34 on its axle pin in the wall |
| reel_ik1_axle | reel | PPA-CF | 1 | 1.2 | 1.2 | Idler axle pin (PPA-CF d8): pressed into the wall from the front, head in front of the idler |
| reel_ik2 | reel | PPA-CF | 1 | 9.4 | 9.4 | Cup riser idler m1.5 z30 on its axle pin in the wall |
| reel_ik2_axle | reel | PPA-CF | 1 | 1.2 | 1.2 | Idler axle pin (PPA-CF d8): pressed into the wall from the front, head in front of the idler |
| reel_ikr | reel | PPA-CF | 1 | 63.1 | 63.1 | I_k m1.5 z76: idler from lane K to the cup shaft |
| reel_ikr_axle | reel | PPA-CF | 1 | 0.6 | 0.6 | I_k axle pin (PPA-CF d8): pressed into P2, head in front of the idler |
| reel_k | reel | PPA-CF | 1 | 5.5 | 5.5 | Cup shaft K: through the sleeve, cup gear behind the wall, riser gear in front. Print standing |
| reel_k2 | reel | PPA-CF | 1 | 2.0 | 2.0 | K2 stub (PPA-CF d8): wall bushing, riser gear and the K bevel |
| reel_kc | reel | PPA-CF | 1 | 9.6 | 9.6 | Rear cup shaft K': cup in front, G_k behind, journal in P2. Print standing |
| reel_lane_c | reel | PPA-CF | 1 | 21.5 | 21.5 | Lane C (PPA-CF d12): the capstan drive along the deck to the reel unit. Print standing |
| reel_lane_k | reel | PPA-CF | 1 | 14.5 | 14.5 | Lane K (PPA-CF d8): the cup drive along the deck to the reel unit. Print standing |
| reel_lane_t | reel | PPA-CF | 1 | 12.6 | 12.6 | Lane T (PPA-CF d8): the take-up drive along the deck to the spool. Print standing |
| reel_p1 | reel | PPA-CF | 1 | 111.9 | 111.9 | Reel unit front plate P1 with the sprag #2 seat and the capstan bushing. Print front face down |
| reel_p2 | reel | PPA-CF | 1 | 86.0 | 86.0 | Reel unit rear plate P2: cup shaft and lane K journals, I_k axle. Print flat |
| reel_rocker | reel | PPA-CF | 1 | 6.1 | 6.1 | Brake rocker: flexible PPA-CF lever = clutch spring, pushed by the crank. Print flat |
| reel_s | reel | PPA-CF | 1 | 14.1 | 14.1 | Reel shaft: 608 journals, head = clutch disk, D flat for the reel gear. Print head down |
| reel_sleeve | reel | PPA-CF | 1 | 8.4 | 8.4 | Stationary sleeve at the old capstan axis: c1 turns on it, the cup shaft inside. Print flange down |
| reel_ss | reel | PPA-CF | 1 | 9.6 | 9.6 | Spool shaft (PPA-CF d8): 45T gear, bushing in the T bracket, 608s in both cheeks, the spool on its flat |
| reel_swing_arm | reel | PPA-CF | 1 | 5.5 | 5.5 | Swing arm: rides on the bus gear hub, carries the idler into mesh on forward wiper turns. Print flat |
| reel_t2 | reel | PPA-CF | 1 | 2.4 | 2.4 | T2 stub (PPA-CF d8): wall bushing, 40T gear and the T bevel |
| reel_t3 | reel | PPA-CF | 1 | 1.2 | 1.2 | T3 stub (PPA-CF d8): rear T bevel and the 45T gear |
| reel_ti | reel | PPA-CF | 1 | 14.7 | 14.7 | Take-up idler m1.5 z34 |
| reel_ti_axle | reel | PPA-CF | 1 | 1.0 | 1.0 | Take-up idler axle pin (PPA-CF d8): pressed into the T bracket, head on the inboard side of the idler |

## Printed totals

| material | parts | mass g | filament m (1.75 mm) |
|---|---|---|---|
| PLA | 115 | 4609 | 1545.2 |
| PPA-CF | 87 | 1943 | 646.1 |

## Bought parts

### Bearings

| item | count | used by |
|---|---|---|
| 608ZZ 8x22x7 | 6 | launch_aim_brg_1, launch_aim_brg_2, reel_brg_1, reel_brg_2, reel_brg_3, reel_brg_4 |
| 693ZZ 3x8x4 | 2 | launch_muzzle_roller_brg, launch_pulley_top_brg |
| Adafruit AS5600 STEMMA QT PID 6357 | 1 | sensors_as5600 |
| CSK20PP 20x47x14 sprag #1 | 1 | launch_sprag |
| CSK20PP one-way bearing 20x47x14 | 1 | reel_sprag |

### Fasteners

| item | count | used by |
|---|---|---|
| M3 nut | 11 | launch_sw_seated_nut, launch_sw_home_nut, reel_p1, sensors_as5600_strip_top, sensors_as5600_strip_bot, sensors_sw_rail_low_nut, sensors_sw_gap_nut |
| M3 nut (jam) | 2 | sensors_sw_rail_low_screw, sensors_sw_gap_screw |
| M3 nyloc nut | 1 | launch_muzzle_roller_axle |
| M3x10 self tap | 2 | launch_guard_l_b2, launch_guard_r_b2 |
| M3x10 self tap (lever clamp) | 6 | reel_sw_lever, sensors_sw_rail_low_lever, sensors_sw_gap_lever |
| M3x10 SHCS | 20 | reel_tab_c, reel_tab_k, reel_post_t, reel_p1_leg, reel_p2_leg, reel_cheek_i, reel_cheek_o, reel_t_bracket, sensors_sw_rail_low_screw, sensors_sw_gap_screw |
| M3x10 SHCS (foot into the housing) | 1 | sensors_sw_rail_low_bracket |
| M3x10 SHCS + 2 M3 nuts | 1 | reel_sw_hw |
| M3x10 SHCS + M3 nut | 1 | reel_firm_screw |
| M3x12 self tap | 17 | launch_guard_l_a, launch_guard_l_b1, launch_guard_l_b2, launch_guard_l_c, launch_guard_r_a, launch_guard_r_b1, launch_guard_r_b2, launch_guard_r_c |
| M3x12 SHCS | 4 | reel_p2, sensors_as5600_strip_top, sensors_as5600_strip_bot |
| M3x12 SHCS (arm into the right cheek) | 2 | sensors_sw_gap |
| M3x16 SHCS | 15 | launch_muzzle_roller_axle, reel_bar_screws, reel_p1, reel_p2 |
| M3x16 SHCS (deck screw) | 1 | sensors_sw_rail_low_bracket |
| M3x16 SHCS (into the housing spine) | 2 | sensors_as5600_carrier |
| M3x20 SHCS | 1 | reel_crank_screw |
| M3x20 SHCS + nyloc nut | 1 | launch_pulley_top_axle |
| M3x25 SHCS + M3 nut | 1 | reel_rocker_pin |
| M3x6 SHCS | 2 | launch_sw_seated_screw, launch_sw_home_screw |
| M3x8 self tap (base to bracket) | 8 | reel_sw_base, sensors_sw_rail_low |
| M3x8 SHCS | 7 | reel_sleeve, reel_trim_screws, reel_sw_bracket |
| M8 hex nut ISO 4032 | 1 | launch_aim_nut |
| M8x25 hex bolt ISO 4017 | 1 | launch_aim_bolt |
| STEMMA QT JST SH 4 pin cable | 1 | sensors_as5600 |

### Other

| item | count | used by |
|---|---|---|
| (part of the wiper motor) | 1 | frame_wiper_shaft |
| 12 V car wiper motor (self-locking worm), 2-wire rebuild | 1 | frame_wiper_motor |
| 8 mm steel rod, cut to length (see note), ends deburred | 2 | launch_anchor_pin_l, launch_anchor_pin_r |
| BTS7960 43 A module (IBT-2) | 1 | frame_pcb_bts7960 |
| Century C-243 (5/8 x 6-1/2 in x 0.054 in wire) extension spring | 2 | launch_spring_l_hook_a, launch_spring_r_hook_a |
| Dyneema braid 1 mm (LINE) | 9 | launch_line_a0, launch_line_a1, launch_line_a2, launch_line_a3, launch_line_a4, launch_line_a5, launch_line_a6, launch_line_a7, launch_line_a8 |
| Espressif ESP32-S3-DevKitC-1-N8 | 1 | frame_pcb_esp32 |
| HX711 load cell amplifier (optional) | 1 | frame_pcb_hx711 |
| inline ATO fuse holder + 20 A fuse | 1 | frame_fuse_20a |
| KEDGE v30 dart (reference, built separately) | 1 | launch_dart |
| launch_line_p (bought, no bought_ref) | 1 | launch_line_p |
| launch_spring_l_0 (bought, no bought_ref) | 1 | launch_spring_l_0 |
| launch_spring_l_1 (bought, no bought_ref) | 1 | launch_spring_l_1 |
| launch_spring_l_2 (bought, no bought_ref) | 1 | launch_spring_l_2 |
| launch_spring_l_3 (bought, no bought_ref) | 1 | launch_spring_l_3 |
| launch_spring_l_4 (bought, no bought_ref) | 1 | launch_spring_l_4 |
| launch_spring_l_hook_c (bought, no bought_ref) | 1 | launch_spring_l_hook_c |
| launch_spring_r_0 (bought, no bought_ref) | 1 | launch_spring_r_0 |
| launch_spring_r_1 (bought, no bought_ref) | 1 | launch_spring_r_1 |
| launch_spring_r_2 (bought, no bought_ref) | 1 | launch_spring_r_2 |
| launch_spring_r_3 (bought, no bought_ref) | 1 | launch_spring_r_3 |
| launch_spring_r_4 (bought, no bought_ref) | 1 | launch_spring_r_4 |
| launch_spring_r_hook_c (bought, no bought_ref) | 1 | launch_spring_r_hook_c |
| MP1584EN buck module, set to 9.0 V | 1 | frame_pcb_mp1584 |
| N20 right-angle self-locking worm gearmotor 12 V 27 rpm (have) | 1 | drum_n20 |
| perfboard 55 x 31 (dividers, pull-downs, 3V3 and GND buses), 2 x M3 x 10 on wall bosses | 1 | frame_perfboard |
| Pololu DRV8833 2130 (headers off) | 1 | frame_pcb_drv8833 |
| Razer Kiyo X webcam | 1 | frame_kiyo_x |
| RC832 5.8 GHz receiver (80 x 65 x 15) | 1 | frame_rc832 |
| sensors_as5600_col_screws (bought, no bought_ref) | 1 | sensors_as5600_col_screws |
| sensors_as5600_nut_bot (bought, no bought_ref) | 1 | sensors_as5600_nut_bot |
| sensors_as5600_nut_top (bought, no bought_ref) | 1 | sensors_as5600_nut_top |
| sensors_as5600_screw_bot (bought, no bought_ref) | 1 | sensors_as5600_screw_bot |
| sensors_as5600_screw_top (bought, no bought_ref) | 1 | sensors_as5600_screw_top |
| sensors_sw_gap_jam (bought, no bought_ref) | 1 | sensors_sw_gap_jam |
| sensors_sw_rail_low_jam (bought, no bought_ref) | 1 | sensors_sw_rail_low_jam |

Parts that are not printed and have no bought_ref: launch_spring_l_hook_c, launch_spring_l_0, launch_spring_l_1, launch_spring_l_2, launch_spring_l_3, launch_spring_l_4, launch_spring_r_hook_c, launch_spring_r_0, launch_spring_r_1, launch_spring_r_2, launch_spring_r_3, launch_spring_r_4, launch_line_p, sensors_as5600_nut_top, sensors_as5600_screw_top, sensors_as5600_nut_bot, sensors_as5600_screw_bot, sensors_as5600_col_screws, sensors_sw_rail_low_jam, sensors_sw_gap_jam.
