HarryHYu/GrappStar/base/cad/parts/launch_NOTES.md

# Launcher + aim train: notes (worker cad-launch)

Current state for BASE_SPEC v1.2.7 (D23 sleeve y 111..193 in the aim housing bushing, D26 PLA flexure stop, D36 rear
line guide, D37 flange lugs, D38 two springs). Every number below comes from the code: `launch_kin.py` (sizing), `launch.py` (geometry, kin, contacts),
`launch_aim.py` (aim train), `launch_line.py` (tether on the rail). Run `python cad/parts/launch_kin.py` for the
sizing summary.

## 1. How it works (Harry's v10, sized to KEDGE v30)

- The rail pivots on the main axis. The LAUNCH SLEEVE (coaxial on the main shaft's d12 spigot, driven by cad-drum's
  LAUNCH dog ring at its flange, y 111) carries sprag #1 inside the 26T drive gear.
- The BIG GEAR rides on the rail on its own pin (82.6 from the axis). Two layers on one hub:
  - sector layer (y 134..146, the rack plane): 27 of 40 teeth, Harry's release teeth (last one cut to the pitch line,
    the one before 30 percent taller);
  - full 40T layer (y 147.5..158.5, face 11) that the drive gear meshes all the way round. (One sector layer would leave the
    drive in the toothless gap for 117 deg of every turn: found in review round 1.)
- One big gear turn (553.8 forward wiper deg) = cock, release, reset to rest. Backward wiper turns freewheel in
  sprag #1. The sprag drag can carry the big gear up to about 127 deg BACKWARD from rest before its relieved last
  tooth meets rack tooth 0 from behind (review 3): no damage, the carriage only presses its stop, but SW_GAP opens.
- Firmware rules: aim only at HOME (spring slack). After any aim move, run FORWARD until SW_GAP closes (the gear
  passes its gap with no tooth contact), then fire in one forward run of 553.8 wiper deg.
- The carriage is a long sled (the rack must be one stroke long). The dart rides on it in a light V cradle (5 rings
  and 2 strips), tail on the pusher; the tether leaves through the pusher hole on the axis.
- Aim: v10 crank-rocker scaled 0.6, rotated -90 deg about the pivot (pitch table identical to v10, 6.0 to 47.1 deg),
  driven only by BACKWARD wiper turns: swing-arm splitter (pawl-free) -> 2:1 bevel -> self-locking worm (lead
  4.8 deg) -> worm wheel 20T = crank. 10 wiper turns per aim cycle. The worm holds the pitch while cocking and at the
  shot.

## 2. Current numbers (generated: `PYTHONPATH=. python cad/parts/launch_numbers.py`)

| item | value |
|---|---|
| params version | 1.2.9 |
| springs | 2 x Century C-243 (5/8 x 6-1/2 in x 0.054 in wire), k 0.125 N/mm, F0 7.0 N each, max_ext 265.0 mm |
| stroke (travel at release / peak) | 240.2 / 240.9 mm (design value 240.9) |
| preload at HOME / extension at full cock | 23.8 / 264.7 mm |
| force at HOME / full cock (both springs) | 19.9 / 80.2 N |
| energy released | 12.06 J |
| hook pin distance HOME / cocked | 188.9 / 429.8 mm |
| big gear | m2.5 40T: sector layer 27 teeth (gap 117 deg, face 12 on a 9 mm rack) + full 40T layer (face 11) |
| drive gear | 26T, face 11 (full layer y 147.5..158.5 world; physics SF 1.55 at the 5 N m pin), centre distance 82.6 |
| wiper deg per shot / release at | 553.8 / 432.7 forward wiper deg from rest |
| torque at full cock: big gear / wiper | 4.01 / 2.61 N m |
| moving mass (carriage body + yoke + roller + seat parts) | 80.5 g (dart 279 g) |
| carriage rear face HOME / cocked (u) | 70.6 / -170.3 |
| rail span (u) / splits | -178.3 .. 273.5 / (-30.0, 140.0) |
| spring anchors (u, y, w) | 263.5, +-38 (provision +-56), 60 |
| tether pulleys (rail frame) | top (-200.9, 0.0, 78.1), bottom (-200.9, 0.0, 30.0), pivot (0.0, -21.0, -44.0) |
| aim | pitch 6.01 .. 47.06 deg, 10 wiper deg per crank deg, worm lead 4.76 deg |
| dart speed / range at 34 deg (physics, 80 g carriage) | 6.85 m/s; 4.19 / 3.76 / 3.39 m at 0.5 / 0.75 / 1.0 N line drag; about 2.7 J into the stop |

1:1 springs (a pulley trades force for stroke and multiplies the moving spring mass by the ratio squared). Preload =
SPRING.max_ext - stroke (spec D30: max_ext 265, so 23.8 mm). The stroke is fixed by the 27-tooth sector.

## 3. Tooth timing

`launch.release_table` (real 2D tooth contact): at rest tooth 0 is 3 pitches (27 deg) before the mesh centre so it is
the first tooth to touch rack tooth 0 while the carriage sits on its stop (a turning gear cannot enter a stationary rack
at the mesh centre). Release at big gear -281.25 deg. The gear then runs on through its 117 deg gap to rest (-360).
Audited with the gear lagging up to 12 deg behind during the shot; carriage rebound positions off the stop are inside
those shot states.

## 4. Geometry (rail frame: origin on the main axis at y 140, u along the rail to the muzzle, w up, y = world y - 140)

World: x = u cos p - w sin p, z = u sin p + w cos p (p = pitch); world origin on the main axis (LAYOUT v1.0).

| item | value |
|---|---|
| rack pitch line / dart axis | w 50.1 / w 85 (dart rests 0.4 low on the cradle) |
| shoe track (rail walls y +-22..28) | u -178.3 to 190 |
| spring anchors | 8 mm steel rod pins in post + strap (double shear); fallback hole set F 8.5 mm rearward (256.5 at full cock; the stop frame front wall at u 248.15 leaves no room for 15); spare holes at y +-56 (D5 provision, D38: two springs in v1) |
| rail | 3 printed pieces split at u -30 and 140 (2 x M3 x 16 per flange pair) |
| tether pulleys | 693ZZ in printed pulleys (groove r 6); positions in section 2 |
| carriage | body (|y| <= 21.5, prints on its side) + 2 bolted spring arms (half lap, 2 x M3 each) |
| sleeve (world y) | flange 111..119 (D37: 3 lugs 6 x 3 at r 15..21 on the face into the dog ring slots, 3 x M3 at r 28.5 into the tapped ring), cheek journals 123..131 and 161..168, sprag rib 143.5..158.5, sun rib 174..182, end 193 in the aim housing bushing |
| aim crank centre | world (58.0, about 202, -100.5) |

Swept envelope: rail rear dips to about z -150 at 47 deg (fork bottom about 22 above the deck); muzzle about +260 up.

## 5. Contacts (printed: M3 screw head on an M3 nut, internal pull-up; no wire rides on the carriage)

| name | where | closes when |
|---|---|---|
| SW_HOME | flex lever on the RIGHT rail lip at u 40..69, y -25 | a rigid foot under the right yoke arm sits on its screw: closed from about 3 to 5 mm behind the stop to 21 mm into the stop overshoot. Overshoot into the stop just slides the foot (never a load path) |
| SW_SEATED | flex lever on the LEFT rail lip, mirrored | the dart tail pushes a pushrod in the pusher (y 15, w 86) back 1.5 mm; its wedge pushes a plunger whose foot presses the lever screw. Only meaningful at HOME |
| SW_GAP | cad-sensors contact on a bracket on the right cheek outer face (pilots at u 48 / 64, w 2) | a 2 mm cam bump on the big gear web (r 29.7 at 225 deg) passes its tip: gear within about +-5 deg of rest |
| SW_RAIL_LOW | cad-sensors contact on the aim housing foot, cam on the crank (launch_aim) | crank within the window around the LOW dead point |

Firmware: shot reference = SW_GAP closing edge at the end of the forward run (or AS5600 angle); SW_HOME confirms the
carriage really came home; SW_RAIL_LOW zeroes the aim crank on the backward run.

## 6. Carriage stop (`launch_stop.py`, D26: no TPU)

Printed PLA flexure per side: 16 closed loops (31 tapered leaves, 3.15 to 1.0 mm thick) lying over the main spring,
in a bolted frame, preloaded 6.56 mm (32 N per side, 64 N both, far more than the 10 N per side spring pull at HOME, so the carriage rests
exactly at u_stop). Both sides: 9.76 N/mm, 4.29 J at 23.8 mm, peak 296 N, leaf stress 34.8 MPa. Every gap closes at
23.8 mm, so the stack goes solid exactly at full travel (no separate hard stop). Sized for the moving mass of the
first build (about 122 g moving: up to 3.9 J after the dart leaves); the lighter
carriage only adds margin. PLA returns most of the energy: the carriage rebounds up to about 100 mm before the
springs and friction settle it; the gear is in its gap then (audited). Firmware: wait 0.5 s after the release before
reading SW_HOME. Dry fire (no dart, 12 J into the stop) exceeds it: firmware refuses fire without SW_SEATED.

## 6b. Strength notes

- Cock train: drive gear 26T and full 40T layer face 11 in PPA-CF: physics SF 1.55 / 1.74 at the 5 N m shear pin; the
  sector layer on the 9 mm rack 1.42 at 5 N m.
- Aim train: splitter face 12 (SF 1.57 to 1.83 at 5 A), worm wheel face 16 (1.42), bevel pair z15 / z30 face 8: SF 0.44
  to 0.70 at the shear pin / 5 A, about 1.65 at the D40 3 A trip for backward runs. Only that 3 A trip protects the
  bevels: keep it in firmware (fine for v1; a jam strips the printed bevel first).
- Print notes: the drive gear and the aim bevel z30 rims print over air in their print orientation; use tree supports
  under the rims (listed in the print sheet overhang warnings).

## 7. Aim table for fw-base

P.AIM.table holds the full cycle (backward wiper deg from the LOW dead point vs pitch). Rising stroke 0..1596 wiper deg
(6.0 to 47.1 deg), falling stroke 1596..3600 (back to 6.0, controlled by the worm, no drop).

## 8. Interfaces

- cad-drum: dog ring bolted to the sleeve flange at y 111 (D37: sleeve lugs in the ring slots, 3 x M3 x 10 from the
  flange side into the tapped ring, fitted before the sleeve goes into the cheeks). kin: the sleeve angle equals
  S["sleeve_deg"] exactly (or wiper_deg in drum-only and load states), so ring and sleeve always agree. Spigot d12 runs through the 12.35 sleeve bore to the magnet cap at y 195..203.
- cad-frame: the aim housing stands on the deck: 4 x M3 x 10 from the TOP through counterbored holes in its foot
  flanges (two behind the spine, one in front of the outer wall, one on an inboard tab) into deck heat-set inserts.
  `launch.deck_holes(P)` re-exports `launch_aim.deck_holes(P)` so the frame's deck_contacts cuts the inserts (the deck
  is on the rover long before Aim 3, so nothing can be reached from below). The SW_RAIL_LOW bracket's deck screw
  passes through a clearance hole in the housing foot extension; it is cad-sensors' (`sensors.deck_holes`).
- cad-sensors: AS5600 carrier, SW_RAIL_LOW and SW_GAP (sensors.py) screw into pilots on the aim housing and the right
  cheek; the cams (big gear bump, crank cam) are launch parts. Keep out of the rail sweep (LAYOUT keep_out).
- cad-reel: the tether arrives at the rear of the pivot pulley (D36: then over the bottom and top pulleys behind the
  rail rear end, top tangent on the dart axis, forward to the pusher), `launch.line_entry(P, S)` (world); `launch.line_path(P, S)`
  continues it over the rail pulleys to the pusher and the dart tail.
- Timeline keys used by kin: aim_deg, cock, fired, dart_flight, dart_return, phase ("lower" runs the crank over the
  top and down the falling stroke).
