HarryHYu/GrappStar/base/cad/parts/drum_NOTES.md

# Drum subsystem notes (worker cad-drum): main shaft, dog clutch, N20 selector drum

Status: v7, 3 Nov 2026 14:50 Sydney. Written against params.py v1.3.0. Deviations are in section 0.

Every number lives in code:
- `_drum_kin.py` DEFAULTS: angles, groove and clutch profiles, Gray code, stop plan, timing, loads. It has no CAD
  imports.
- `drum.py` GEOM: geometry. G() reads params.LAYOUT.axes (main, drum, capstan origins), deck_top_z and
  DRUM.reel_output, and derives the fork pin direction and the idler position from them.
- Firmware table: `drum_table.json` (`python cad/parts/_drum_kin.py --json`). All codes in it are A B C strings.

Coordinates: world mm. s = world y (distance from the adapter plate face). Local frame L (joint drum_base): x = world
x, y = world DOWN.

State keys (params 1.2.3):
- wiper_deg drives the main shaft, coupler, bus gear and collar;
- sleeve_deg drives the LAUNCH dog ring (with cad-launch's sleeve);
- reel_deg drives the REEL gear;
- drum_deg drives the drum.

A state without wiper_deg: the main shaft follows the launch sleeve in LAUNCH, reel_deg in REEL, else 0. Without sleeve_deg the dog ring follows cad-launch's sleeve joint
(it is bolted to it).

## 0. Deviations from the params v1.0 table (most in params; the rest are listed in drum_REPORT.md)

- Single-turn travel: end stops -4 / 352. The original -8 / 358 spanned 366 deg.
- Park angles off the code edges:
  - 56 (WRAP_PREP);
  - 314 (WRAPPED, inside N_TO_R: clutch FIRM from 312, collar NEUTRAL until 318).
- Idler output 42T (7 cup turns = 4 pinion turns x 42/24).
- Clutch ramps 30..40 and 302..312, which keep the 2x N20 margin at FIRM 5 N.
- One small difference: the cup lock frees at 62 (the window start), not 60. The lock layer is cut exactly where the
  pinion turns.

## 1. What it does

- The wiper turns the coupler hub. A printed shear pin (about 5 N m, D8/D26) drives the outer coupler, which
  carries:
  - the SW_INDEX cam (D12);
  - the take-up bus gear 50T m1.5 (D25, meshing cad-reel c1 46T at 72.1);
  - the REEL gear journal;
  - the hex socket for the main shaft.
- REEL output gear m2 50T (D20): free on the coupler journal, held by a retaining washer.
- LAUNCH dog ring: keyed to the cad-launch launch sleeve flange.
- DOG COLLAR: on the shaft hex.
- SELECTOR DRUM: drum A and drum B on a fixed d10 axle, self-locking right-angle N20 through 10:120. It carries:
  - groove 1 (long compliant fork);
  - track 2 (cad-reel clutch pushrod);
  - a segment gear with a locking arc (wrap idler);
  - three Gray code bands (SW_DRUM_A/B/C).
- SW_DOG_L / SW_DOG_R close only when the collar is fully engaged. SW_N20 closes when the N20 is swung into mesh.
- Hand fallback: loosen the swing screw, swing the N20 cradle out, turn the hand lever.

## 2. Main axis stack (s = world y)

| s | part | notes |
|---|---|---|
| -5..27.5 | `drum_coupler_hub` PPA-CF OD 26 | D48: placed from params WIPER boss_face_y (-10) and the shaft numbers (drum.G, cad-frame's motor model defaults), so the measurements move the shaft and the hub together. Wiper shaft per cad-frame's model (not measured): output boss top s -6, round d10 to s -4, flats 8 to s 10, M8 thread s 10..22. The hub starts 1.0 above the boss (0.5 once the nut pulls it onto the end of the flats), inside the puck bore (r 15). Round bore to s -3.5, D bore to s 10.5 (13.5 mm on the flats), M8 nut at s 13..19.5 in a round pocket (13 mm socket, 8 mm down) |
| 0.5..62 | `drum_coupler` PPA-CF | OD 40 to s 27.5, 45 deg cone to the index cam (r 26), 45 deg cone to r 28.5, bus gear. Stays under r 28.5 for s < 40 (cad-reel's wall top edge is 29.6 under the axis). Prints hub end down; tree support under the bus gear ring (r 28.5..39) |
| | (coupler) shear pin | `drum_shear_pin` d4, radial at s 9, single shear at r 13 (about 4.9 N m) |
| | (coupler) socket | hex 22 AF from s 28; the shaft end is bored d9.6 for the wiper thread end |
| | (coupler) shaft retention | none: a radial screw would sit inside the frame cheek, out of reach. The shaft is captured by the magnet cap against the launch sleeve end (2 mm play) and its hex shoulder against the sleeve flange (5 mm); the hex stays at least 29 mm in the socket |
| 33.5..38.5 | SW_INDEX cam on the coupler | 6 bumps, base r 26, nub lift 2.5 |
| 40..48 | bus gear | 50T m1.5, face 8, tip r 39 |
| 48..50.3 | thrust step r 20 | the REEL gear bears on it |
| 50..62 | REEL journal OD 33 | 1.45 mm wall outside the washer screw holes |
| 62.05..63.5 | `drum_reel_washer` | OD 35.1, hex bore on the shaft, 2 x M3 x 6 at r 13.8 on the flat lines into the journal end (heads clear the flats) |
| 50.5..69.5 | `drum_gear_reel` m2 50T face 12, dogs 64.5..69.5 | bore steps to r 17.7 past the journal |
| 28..106 | `drum_shaft` hex 22 AF | |
| 106..198.5 | d12 spigot | through the launch sleeve bore (12.35) and the aim housing bushing (D23); flat from s 194.5 |
| 72..98 | `drum_collar` at NEUTRAL | dogs 72..77 and 93..98, groove 82..88. REEL engaged: tips at 65. LAUNCH engaged: tips at 105 |
| 100.5..111 | `drum_dogring_launch` | dogs 100.5..105.5, back face at 111 with 3 key slots, 3 x M3 tapped at r 28.5 |
| 195..201.5 | `drum_magnet_cap` | magnet pocket d6.2 x 2.6, face at 201.5; M3 x 6 radial onto the spigot flat. AS5600 bracket: cad-launch |

### 2b. Launch sleeve interface (agreed, D37)

- Sleeve flange face at s 111.
- Lugs on the SLEEVE: 3 lugs 6.0 wide x 3.0 tall, r 15..21, at 60 / 180 / 300 deg. They key into my slots, which are
  6.4 x 3.2. I keep the slots because the ring prints on that face.
- Screws: 3 x M3 clearance holes in the sleeve flange at r 28.5, 0 / 120 / 240 deg. The heads go on the sleeve side
  and thread into my ring. My ring has no room for counterbores between its dogs.
- The sleeve's two-way axial location is in cad-launch's aim housing (D23).

## 3. Dog clutch

- 4 dogs, r 18..26, height 5, root 36 deg. Engaged play +-8 deg.
- Both flanks back-cut 4 deg (resists walking out). Tips roofed 1.2 mm.
- Neutral gap 2.5, stroke 7, engagement 4.5.
- Tip to tip: the yoke (2.4 thick flat PLA, about 0.95 N/mm out of plane) bends up to 4.5 mm, the drum still
  arrives, and SW_DOG_x stays open.
- SW_DOG_L / SW_DOG_R: screw heads on the fixed dog post touch the nut in the yoke tab 0.5 mm before full engagement
  (about 0.5 N contact force through the yoke).

## 4. Drum (axis world x 60, z -112; s 1..142)

`drum_drum_a` (PLA, prints standing on the gear face; 45 deg cones under the cam and the segment gear):

| s | feature |
|---|---|
| 8..16 | drum gear 120T m0.8 x -0.3. N20 pinion 10T m0.8 x +0.3 at L angle -40, world (99.9, z -78.5) |
| 18..29 | clutch cam: base r 30, lift 0 / 4 mm, follower at L angle 180 (straight back), 15 N at FIRM |
| 52..60 | segment gear m1.25 from 60T, 39 teeth over 240 deg |
| 59.95..66 | locking arc ring r 38, sitting on the segment gear |
| 29..77 | neck r 10 |
| 77..83 | hex spigot 16 AF into drum B, +x corner cut flat at x 7.5 (drum B's socket keeps it: one orientation only) |

`drum_drum_b` (PLA, prints standing on the barrel face):

| s | feature |
|---|---|
| 77.3..106 | groove 1 barrel r 30, groove 6.4 x 4. The groove roof prints as a 4 mm ledge: clean it with a file if it droops |
| 108..114 / 115..121 / 122..128 | code bands A / B / C, base r 22, nub lift 3, round-nub envelope |
| 128.7..135.7 | hex boss 14 AF for the hand lever |

Fork:
- pads in the collar groove (s 82.3..87.7), yoke 82.3..84.7;
- sleeve on the rail s 15.5..98.5 at NEUTRAL (83 long, grease it), necked to r 7.5 below s 57 (cad-reel c1);
- follower pin d6 at s 91.8, entering the barrel from the main-axis side.

Rail and dog post:
- `drum_rail` d10 at world (25, z -58), s 1..142.
- `drum_dog_post` clamps the rail at s 106.5..111.5, clear of the launch rail cheeks (y 123..131). Its bar runs back
  to s 69.8; REEL boss to s 72.8, LAUNCH boss from s 94.2. Clamp: slide fit on the rail, M3 x 8 tapped onto the
  rail flat. The two boss screws go in before the post goes on (no driver room later).

Wrap idler:
- `drum_idler` shaft: d10 journals in two posts (s 40.5..46.5 and 78..85), d12 between them (the shoulders locate it
  axially).
- Pinion 10T m1.25 x +0.4 at s 52..59.7; lock cam at s 60.3..66.
- `drum_idler_gear` 42T m1.5 on the D flat at s 68.5..75.8 (ends short of the bump on cad-reel's cup gear back), with a thrust hub to post 1.
- Axis at world (16.24, z -104.88).

N20 cradle (on the bracket A ear):
- pivot M3 at world (111.9, z -89.5); swing screw at world (88.4, z -64.5), 55 mm from the drum axis (clear of the
  drum gear); ear r 20 round the N20;
- swing M3 tapped in the ear, through an arc slot in the cradle plate, 0..+15 deg only (+ swings the pinion out;
  it cannot be pushed into the drum gear);
- the N20 shaft end below the pinion runs in a matching arc slot in the ear;
- SW_N20: nut in a pocket in the ear front face (wire groove), M3 x 8 tapped in the cradle plate from +s, 2.5 mm off
  the nut centre so the tip lands on a flat; the back of bracket A is only 4 mm from the frame cheek.
- Strap screws in r 4 lugs at N20-frame x -11.5 and 34.

Contact blocks:
- `drum_switch_block`: s 105..128, on the back (-x) side of the drum (cad-reel's pulley 2 post fills the front).
  The code levers are mirrored; their joints turn about -z.
- `drum_index_block`: +x of the coupler cam at s 32.5..40.5, held by a strut of idler post 2 (2 x M3 x 12 from the
  far face of the post, tapped into the block). Nothing of mine is fixed to the frame cheek: cad-frame carves the
  cheek round every drum part.

## 5. Drum angle table

| zone | drum deg | collar | clutch | cup | code A B C | code range |
|---|---|---|---|---|---| --- |
| LAUNCH | -4..8 (target 0) | LAUNCH | LIGHT | home, locked | 100 | -4..6 |
| L_TO_N | 8..32 | ramp 8..32 | LIGHT (ramp to FIRM over 30..40) | locked | 110 | 6..34 |
| NEUTRAL | 32..50 (target 41) | NEUTRAL | FIRM from 40 | locked | 010 | 34..50 |
| WRAP_PREP | 50..62 (park 56) | NEUTRAL | FIRM to LIGHT 50..62 | locked to 62 | 011 | 50..62 |
| WRAP | 62..302 | NEUTRAL | LIGHT | 7 turns | 001 | 62..302 |
| N_TO_R | 302..340 (park WRAPPED 314) | NEUTRAL to 318, ramp 318..340 | LIGHT to FIRM 302..312 | locked at 7 | 101 | 302..342 |
| REEL | 340..352 (target 347) | REEL | FIRM | locked | 111 | 342..352 |

- Code edges at 6, 34, 50, 62, 302 and 342 are the physical contact closing points: the bump ramps put the
  80 percent lift, where the contact closes, on the edge.
- Bit arcs (closed inside):
  - A: [-8, 34) and [302, 362)
  - B: [6, 62) and [342, 354)
  - C: [50, 354)
- Code 000 never occurs: fault DRUM_SENSOR.

## 6. Stop plan and timing

| target | dir | edge | code change (A B C) | extra |
|---|---|---|---|---|
| LAUNCH 0 | - | 6 | 110 to 100 | 6 |
| NEUTRAL 41 | + | 34 | 110 to 010 | 7 |
| NEUTRAL 41 | - | 50 | 011 to 010 | 9 |
| WRAP_START 56 | + | 50 | 010 to 011 | 6 |
| WRAP_START 56 | - | 62 | 001 to 011 | 6 |
| WRAPPED 314 | + | 302 | 001 to 101 | 12 |
| WRAPPED 314 | - | 342 | 111 to 101 | 28 (30 percent error lands 305.6..322.4: the collar has moved under 0.7 mm at 322) |
| REEL 347 | + | 342 | 101 to 111 | 5 |

Timing:
- 8.1 deg/s nominal. LAUNCH to NEUTRAL 5.1 s, wrap window 29.6 s, WRAPPED to REEL 4.1 s, full travel 44 s.
- Timeout = 1.3 x nominal + 1 s up to the expected edge.

## 7. Firmware rules (fw-base c740e46 is the reference for behaviour; drum_table.json "rules" are my inputs to it)

1. Wiper stopped before drum moves, with two exceptions:
   - the fly-in into REEL (D41): creep the wiper forward over 318..340; stop the creep when SW_DOG_R closes or the
     wiper current rises 0.8 A, then jog at most 5 deg at a time;
   - the unwrap: REEL or WRAPPED back to NEUTRAL with the wiper creeping forward for the bus take-up.
2. Check SW_DOG_L / SW_DOG_R during and after every move:
   - LAUNCH needs DOG_L closed;
   - REEL needs DOG_R closed;
   - NEUTRAL, WRAP_PREP, WRAP and WRAPPED need both open;
   - never enter the wrap window with either closed.
3. Dog not closed in LAUNCH: backward wiggle of the wiper within a 40 deg / 6 s budget. Leaving LAUNCH or REEL under
   load: unload jog 6 deg (params unload_jog_deg), stopped early on a 0.8 A rise.
4. During every move:
   - a code that is not the current zone or the next one in the travel direction: stop, DRUM_SENSOR;
   - an intermediate code must last at least 70 percent of its span / dps;
   - timeout 1.3 x nominal + 1 s: stop, DRUM_TIMEOUT;
   - SW_ARM opening (cup leaves home) outside a wrap or unwrap: fault;
   - contacts debounced 20 ms with chatter detection (0.16 deg of drum at 8.1 deg/s).
   All 7 nonzero codes are valid zones, so one failed contact reads as a wrong zone: these rules and the dog
   cross-checks catch it.
5. Faults (D27):
   - In LAUNCH or L_TO_N: HOLD the drum unless SW_HOME is closed (spring not drawn), then NEUTRAL.
   - In NEUTRAL or WRAP_PREP: stop the wiper and hold.
   - With the wraps on (WRAP, N_TO_R, REEL): HOLD where it is (DRUM_HELD), never NEUTRAL; the operator unwraps when
     safe. There is no REEL to WRAPPED command: the unwrap goes REEL to NEUTRAL with the take-up.
6. Boot: no automatic drum moves (the host commands them).
   - Cross-check the code with the other switches: LAUNCH needs DOG_L closed; REEL needs DOG_R closed; NEUTRAL and
     WRAP_PREP need both dogs open and SW_ARM closed (cup home); otherwise report.
   - The first commanded move from a guessed angle re-references on a real code edge.
   - Code 000: DRUM_SENSOR.
7. SW_N20 open means the hand fallback is active: no drum moves. When it closes again, the boot rules run again.
8. SW_INDEX: 6 pulses per wiper turn (degraded mode without the AS5600 magnet).
9. Positive drum = N20 forward (DRV8833 #3 AIN1 high) = wrap direction.

## 8. Contacts (printed: M3 screw head or tip touching an M3 nut, pull-up, closed = LOW)

| name | GPIO (params) | where | closes |
|---|---|---|---|
| SW_DRUM_A / B / C | 10 / 11 / 12 | levers on the bands, drum back (-x) | at 80 percent of the bump lift |
| SW_DOG_L | 13 | dog post LAUNCH boss (M3 x 8) | collar within 0.5 mm of full LAUNCH engagement |
| SW_DOG_R | 14 | dog post REEL boss (M3 x 8) | collar within 0.5 mm of full REEL engagement |
| SW_INDEX | 35 | index lever on the coupler cam | 6 times per wiper turn |
| SW_N20 | 47 | screw tip in the bracket A ear, nut in the cradle | N20 swung into mesh |

- Levers: PLA beam 1.6 thick, 36 long, round nub r 1.5, M3 x 6 in a 4 mm boss 8 mm below the nub. Peak strain
  0.66 percent (cad.lib.switch model, limit 0.8). Contact gap at rest 1.87 (codes) and 1.56 (index).
- The feet screw along x into the block face.

## 9. Loads and strength

- N20 stall estimate 0.22 N m at 9 V (0.20 used). Drum stall capacity 2.16 N m at 12:1.
- Peak drum load 0.92 N m, margin 2.34 (params rule: at least 2). Peaks per load:

| load | peak N m | basis |
|---|---|---|
| fork | 0.72 | yoke block force 4.3 N plus 3 N friction, x 1.88 racking: (1 + 2 mu a/L) / (1 - 2 mu b/L), pin b 36.5 and yoke a 77.6 on opposite sides of the rail (a = far pad: a soft yoke may bear on one pad), sleeve L 83, mu 0.25 greased rail; groove 44 deg. Margin 2.30 at mu 0.35, 1.85 at mu 0.45; lock-up only at mu 1.14 |
| clutch ramps | 0.78 | 15 N pushrod at FIRM 5 N (cad-reel: 10.8 N at 4 mm, design 15) |
| wrap | 0.78 | 0.06 N m at the cup x 10.5 / 0.81 |

  The loads never coincide. The 0.92 worst (at 302) includes a follower friction term (force x mu x r) even where
  the track is LIGHT: conservative; without it the margin is about 2.75.
- Sensitivity: groove and cam mu 0.4 gives margin 1.91; with rail mu 0.35 as well, 1.83. The 2x margin needs a real
  stall of at least 0.171 N m at 9 V: Harry measures it. Not in the model: lever and axle drag (small).
- At the 5 N m limiter:
  - hex torsion 2.5 MPa;
  - REEL gear Lewis 10 MPa;
  - dogs about 2.1 MPa (3.3 mm flat contact after the 1.2 roof, 4.5 mm engaged).
- The tow cap of 60 N at the dart (D39/D43) gives about 2.8 N m at the main shaft, under the 5 N m limiter.

## 10. Wrap train (cad-reel)

- Window 62..302 = 40 pitches of the 60T m1.25 segment = 4 pinion turns.
- Lock: locked at home and at 7 cup turns. Lock play +-1.5 deg at the pinion; mesh backlash +-1 deg. Clean handover
  (one side always held).
- Output gear 42T m1.5, face 7.3, s 68.5..75.8, axis world (16.24, z -104.88). Cup gear 24T at 49.6.
- Tooth phase (measured on the exact meshes, cad-reel joint conventions): reel_cup = (42/24) x drum_idler + 3.01
  (`drum.reel_cup_deg(P, S)`), reel_bus = (50/46) x wiper_deg + 3.91, reel_capstan = (50/22) x reel_deg + 8.18.

## 11. Frame interfaces (cad-frame)

| part | s | deck fixing |
|---|---|---|
| bracket A | 1..7.7 | 2 x M3 at world x 32 and 88 |
| bracket B | 136..142 | 2 x M3 at world x 32 and 88 |
| idler post 1 | 78..85 | 2 x M3 at world x -8.8 and 33.2 |
| idler post 2 | 40.5..46.5 | 2 x M3 at world x 33.2 and 45.2 (x >= 12.3 below z -118: reel_wall) |
| switch block | 105..128 | 2 x M3 at world x 5.0 |

- All stand on the deck top (z -165).
- Index block: on idler post 2, no frame fixing (params DRUM.sw_index_mount says so).
- Clear the coupler (r 28.5 at s < 40), the index block (s 32.5..40.5, x 39..53, z +12..-56) and the bus gear
  (r 39, s 40..48).

## 12. Open items and measurements for Harry

- Wiper output shaft (the coupler hub is parametric).
- N20 output shaft diameter and flat (modelled d3, 2.5 flat).
- N20 stall torque (bench).
- Shear pin break torque (cad-infra coupon: about 8.3 kg on a luggage scale at r 60).
- Spare worm N20 for the drum (D19).
- AS5600 magnet (optional, SW_INDEX fallback).

## 13. Printing (print_tf in drum.py; the pack tool writes the STLs this way)

| part | material | on the bed | supports and notes |
|---|---|---|---|
| drum_coupler | PPA-CF | hub end down | tree support under the bus gear ring only (r 28.5..39 at s 40) |
| drum_coupler_hub | PPA-CF | motor end down | none |
| drum_shear_pin (x6) | PLA, 100 percent | lying on its 0.4 mm flat (D44) | 5 mm brim (30 mm2 on the bed) |
| drum_shaft | PPA-CF, 100 percent | lying on a hex flat | tree supports under the spigot |
| drum_gear_reel | PPA-CF | plain face down | none |
| drum_reel_washer | PPA-CF | flat | none |
| drum_collar | PPA-CF, 100 percent | one dog face down | tree support (build plate only) under the body face between the dogs; file the hex entry if it droops |
| drum_dogring_launch | PPA-CF, 100 percent | slotted back face down | none |
| drum_drum_a | PLA | gear face down | tree support under the brake cam lobe (4.5 mm ledge) and the segment teeth (3.3 mm) |
| drum_drum_b | PLA | barrel face down | groove roof ledge 4 mm; band undersides up to 4 mm at the bumps: tree support |
| drum_idler | PPA-CF | journal end (s 40) down | 5 mm brim (78 mm2 on the bed, 46 mm tall); tree support under the lock cam disc |
| drum_idler_gear | PPA-CF | flat | none |
| drum_n20_pinion | PPA-CF | flat | 5 mm brim (42 mm2) |
| drum_fork | PLA | sleeve end down (s 15.5, about 170 mm2) | brim; tree support under the yoke, arms and the follower pin (its working flanks are top and bottom: check the pin fits the groove, sand if tight) |
| drum_dog_post | PLA | as print_tf | tree support under the arm bridge and the two bosses |
| drum_n20_cradle | PLA | plate down | support under the roof over the drum gear cut |
| drum_axle, drum_rail | PPA-CF | on their 1 mm flat | none |
| everything else | PLA | largest flat face down | none |
