HarryHYu/GrappStar/kedge/out34/review/parts/coupler_L.png

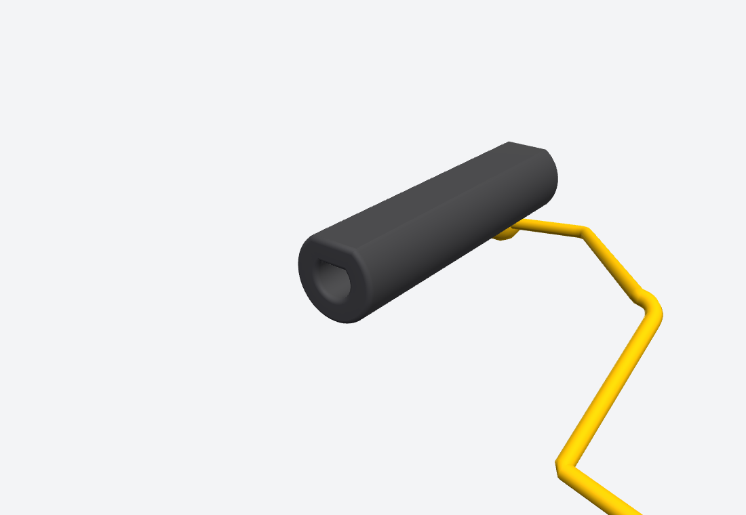
kedge/out34/review/parts/coupler_L.png
