HarryHYu/GrappStar/kedge/out34/review/parts/drill_leg_L.png

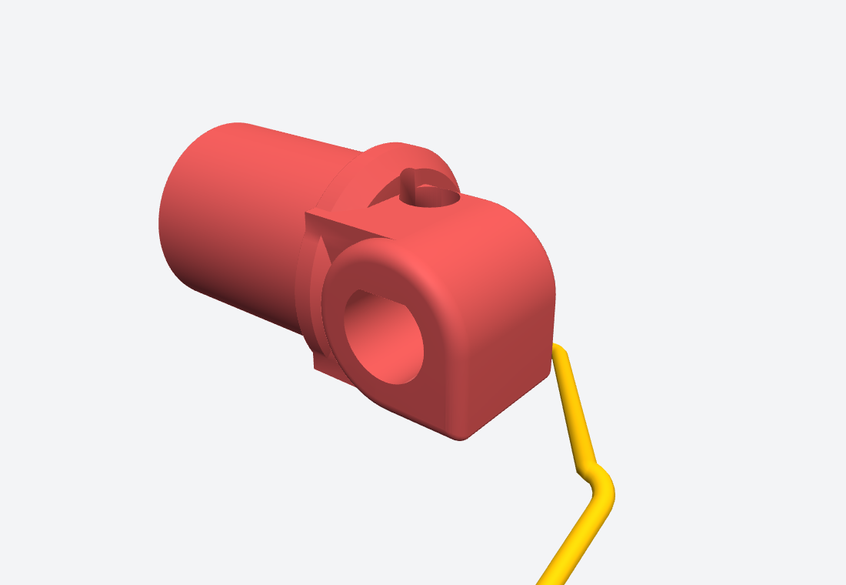
kedge/out34/review/parts/drill_leg_L.png
