HarryHYu/GrappStar/kedge/out34/review/parts/drill_leg_L_auger.png

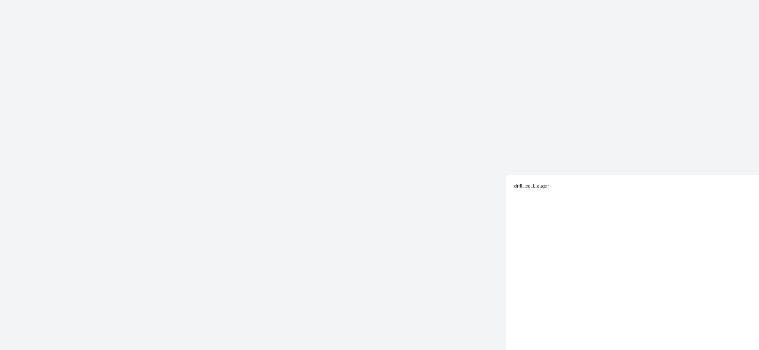
kedge/out34/review/parts/drill_leg_L_auger.png
