HarryHYu/GrappStar/kedge/out34/review/parts/hull_bottom.png

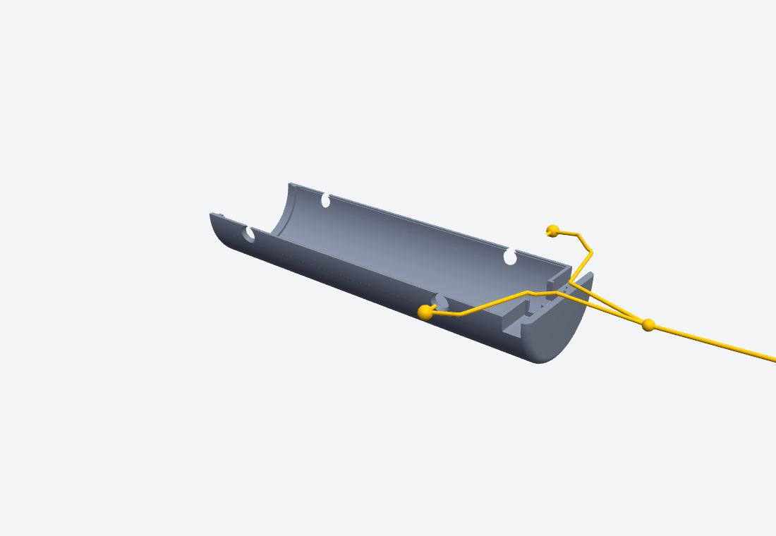
kedge/out34/review/parts/hull_bottom.png
