HarryHYu/GrappStar/kedge/out34/review/parts/leg_coupler_L.png

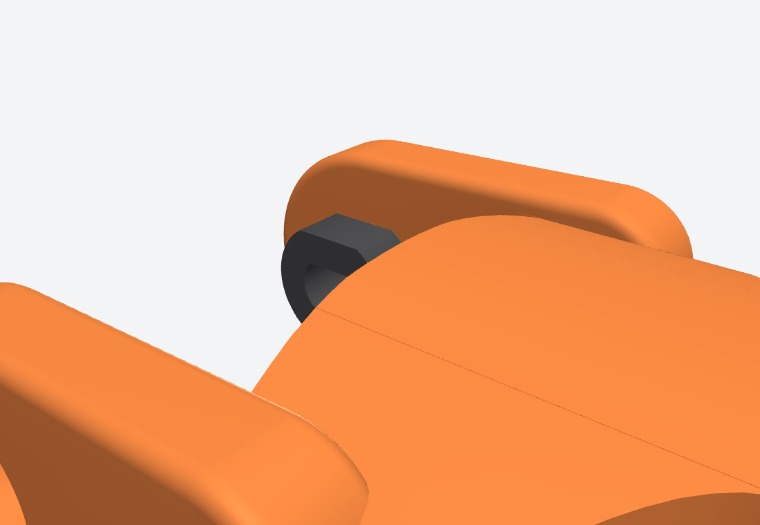
kedge/out34/review/parts/leg_coupler_L.png
