HarryHYu/GrappStar/kedge/out34/review/parts/leg_plug_L.png

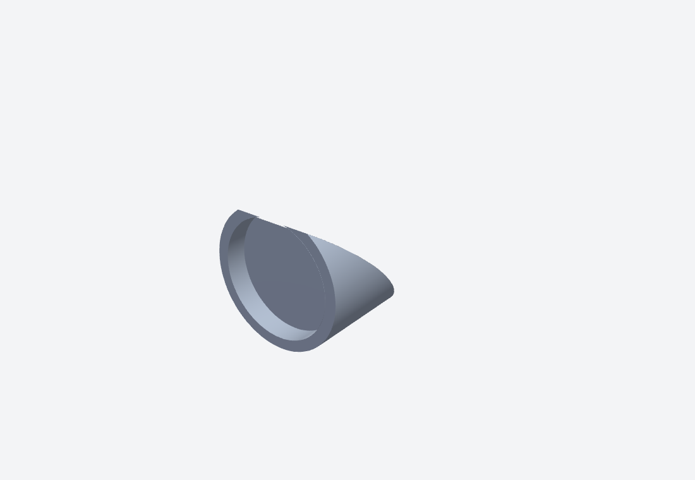
kedge/out34/review/parts/leg_plug_L.png
