HarryHYu/GrappStar/kedge/out34/review/parts/nose.png

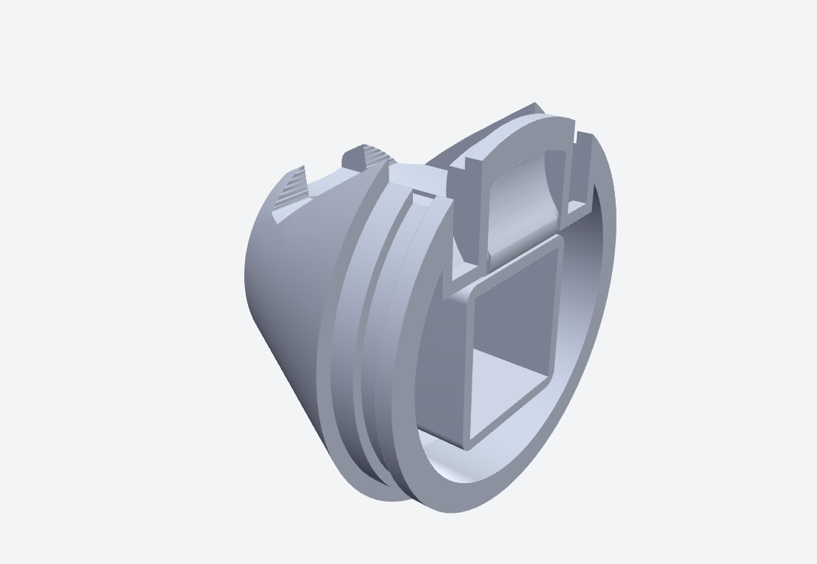
kedge/out34/review/parts/nose.png
