HarryHYu/GrappStar/kedge/out34/review/parts/q_arm.png

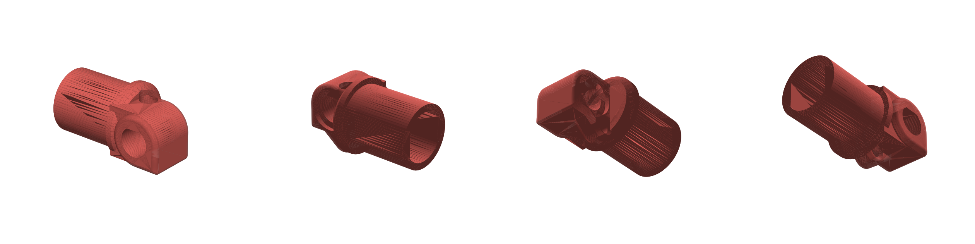
kedge/out34/review/parts/q_arm.png
