HarryHYu/GrappStar/kedge/out34/review/parts/q_auger.png

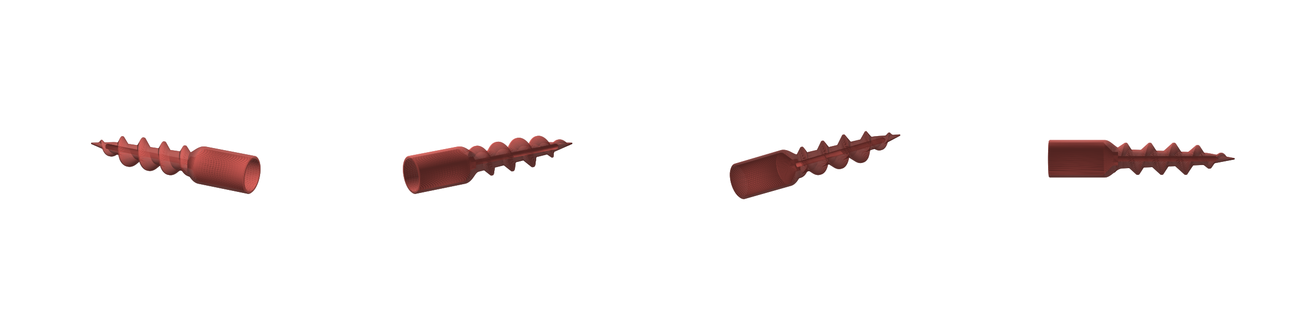
kedge/out34/review/parts/q_auger.png
