HarryHYu/GrappStar/kedge/out34/review/parts/q_plug.png

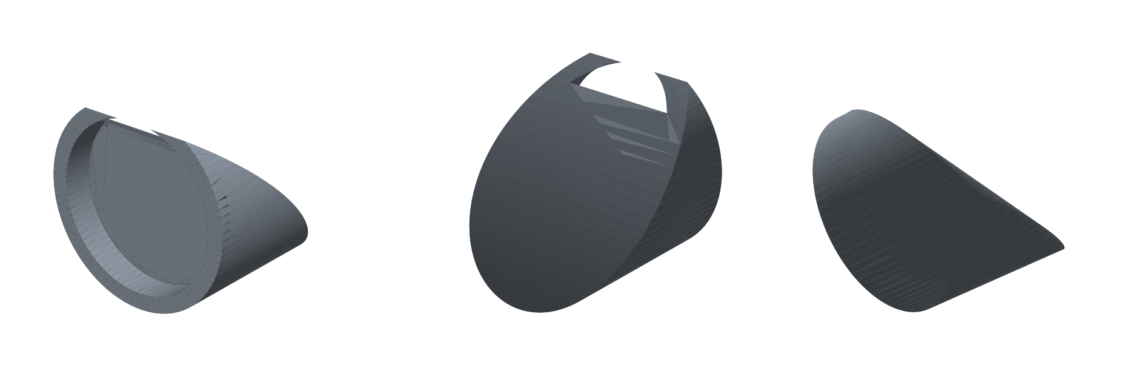
kedge/out34/review/parts/q_plug.png
