HarryHYu/GrappStar/kedge/out34/review/parts/q_small.png

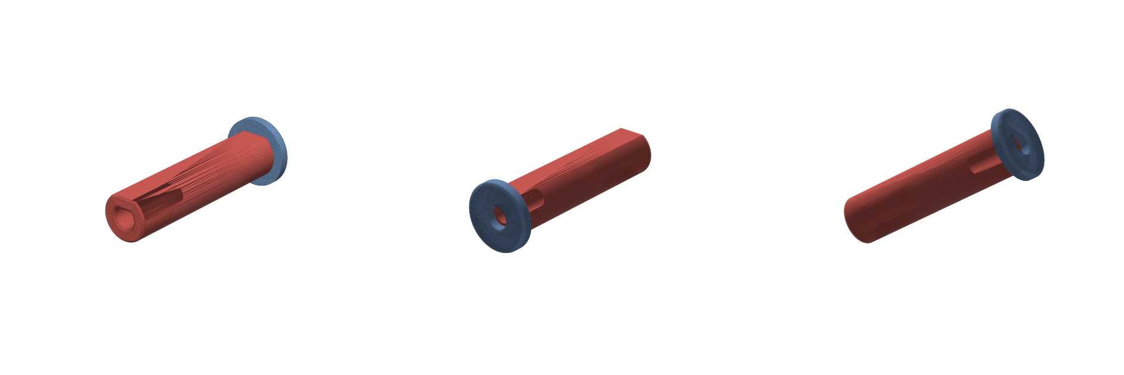
kedge/out34/review/parts/q_small.png
