HarryHYu/GrappStar/kedge/out34/review/parts/righting_leg.png

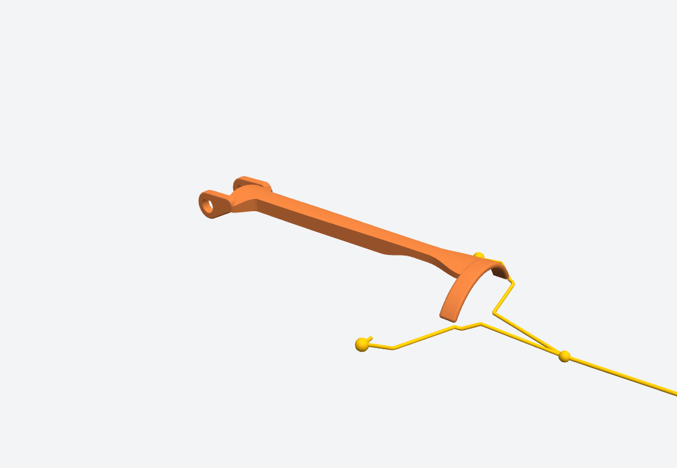
kedge/out34/review/parts/righting_leg.png
