HarryHYu/GrappStar/kedge/gs/out/reel_main_gear.stl

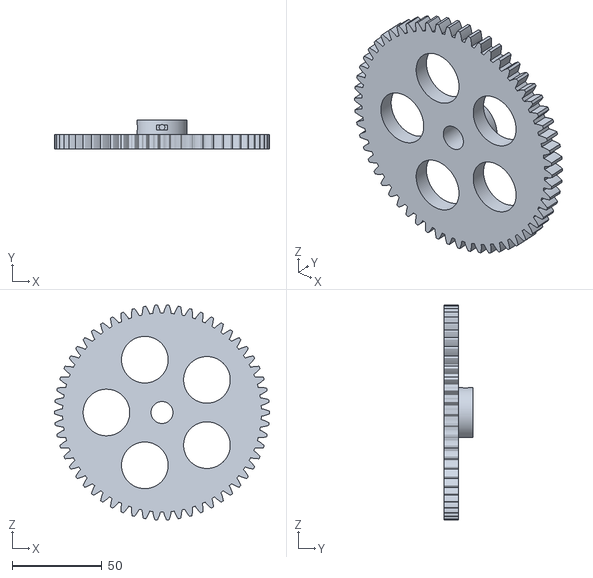
[picture p248: CAD file, 2026-11-02]
kedge/gs/out/reel_main_gear.stl
120.0 x 16.0 x 119.9
