HarryHYu/GrappStar/kedge/gs/out/main_shaft.stl

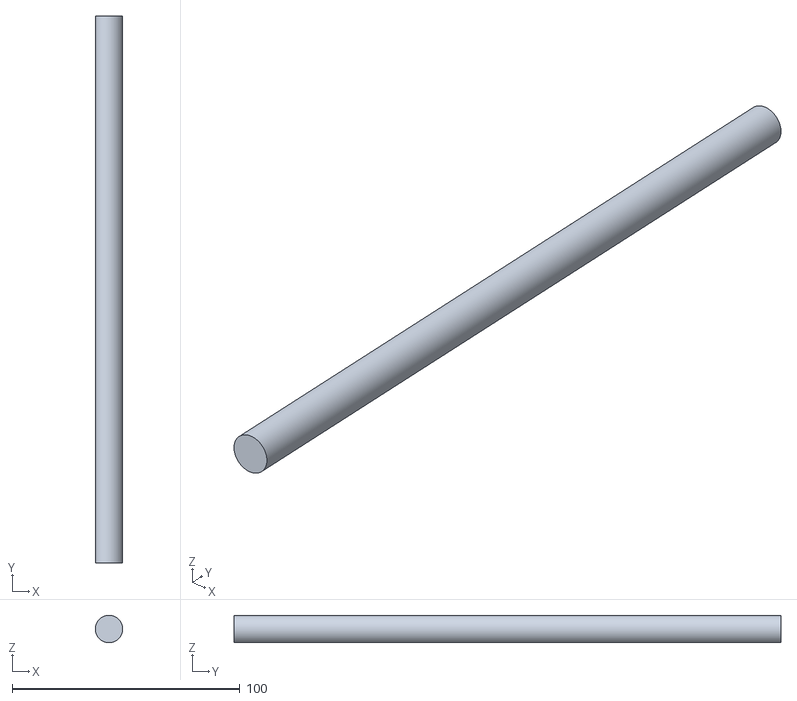
[picture p249: CAD file, 2026-11-02]
kedge/gs/out/main_shaft.stl
12.0 x 240.0 x 12.0
