HarryHYu/GrappStar/base/out/base/pack/plates/plate_19_PPA-CF.3mf

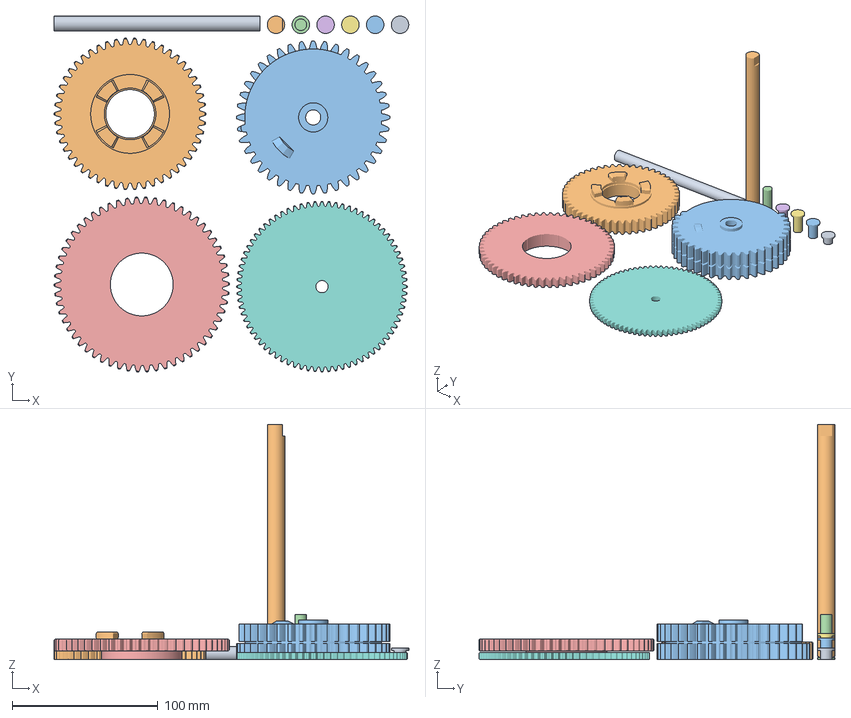
[picture p250: CAD file, 2026-11-06]
base/out/base/pack/plates/plate_19_PPA-CF.3mf
243.0 x 244.0 x 161.2 mm
drum_axle
drum_gear_reel
launch_big_gear
reel_ic_axle
reel_icr
reel_ik1_axle
reel_ik2_axle
reel_ikr
reel_ikr_axle
reel_lane_c
reel_ti_axle
