HarryHYu/GrappStar/base/out/base/pack/stl/reel_tab_c.stl

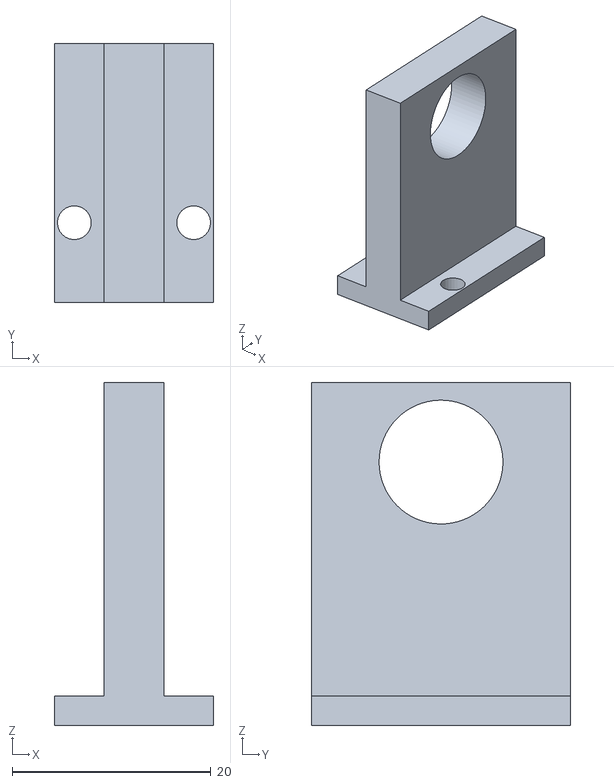
[picture p251: CAD file, 2026-11-06]
base/out/base/pack/stl/reel_tab_c.stl
16.0 x 26.0 x 34.5
