HarryHYu/GrappStar/base/out/display/plates/plate_4_optional_PLA.3mf

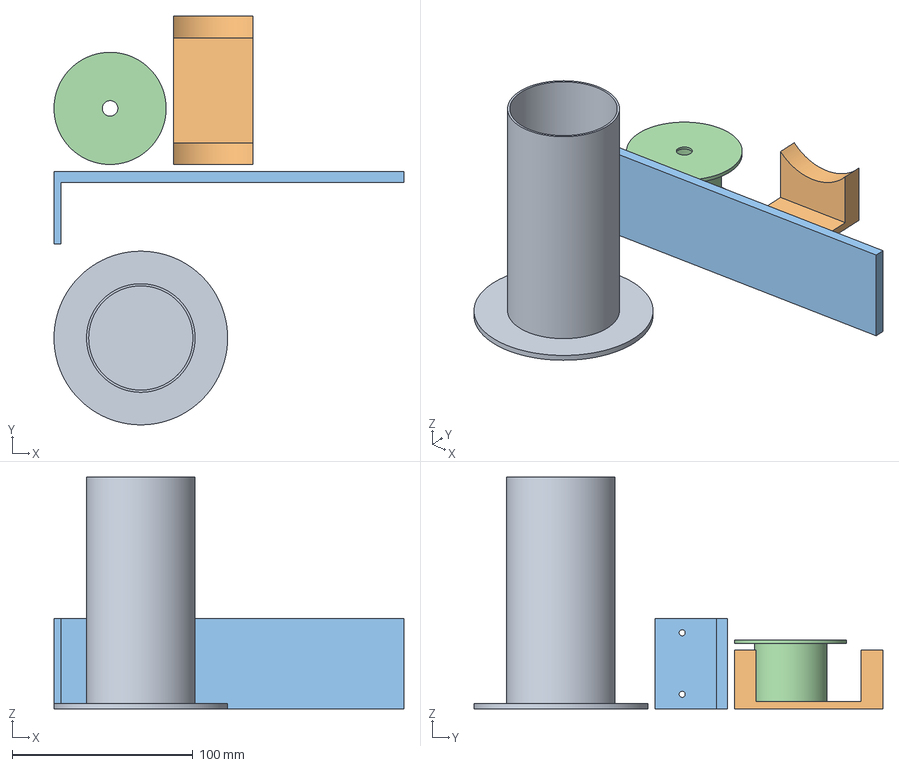
[picture p252: CAD file, 2026-11-11]
base/out/display/plates/plate_4_optional_PLA.3mf
193.5 x 225.9 x 128.0 mm
opt_drum_dummy
opt_drum_saddle
opt_reel_bracket
opt_reel_spool
