HarryHYu/GrappStar/base/pack/coupons/rc1_sleeve.stl

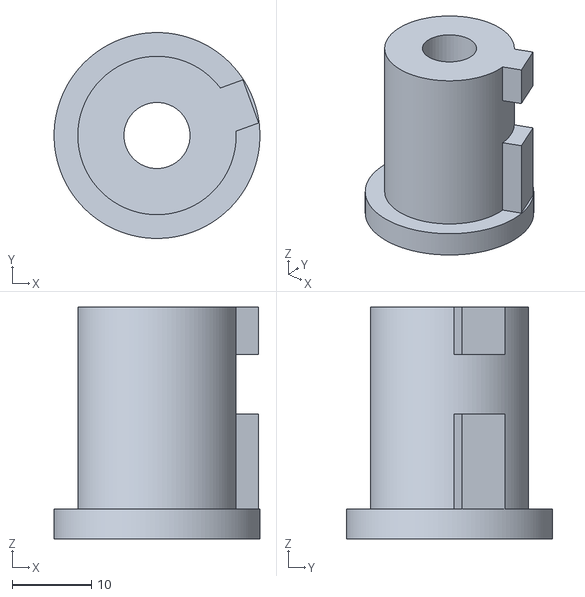
[picture p253: CAD file, 2026-11-03]
base/pack/coupons/rc1_sleeve.stl
26.0 x 26.0 x 29.3
