HarryHYu/GrappStar/base/pack/fit_coupon/coupon_plate_1.3mf

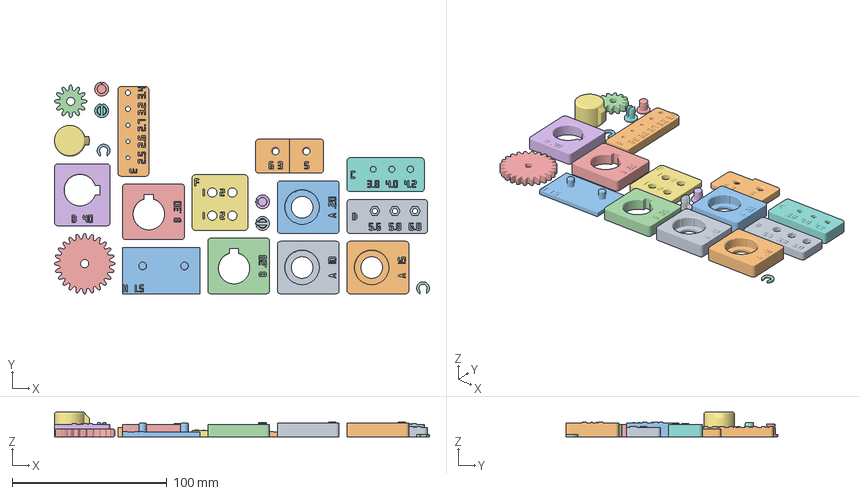
[picture p254: CAD file, 2026-11-03]
base/pack/fit_coupon/coupon_plate_1.3mf
242.5 x 136.8 x 16.0 mm
coupon_a1_608_rib
coupon_a2_608_rib
coupon_a3_608_rib
coupon_b1_key_bore
coupon_b2_key_bore
coupon_b3_key_bore
coupon_b_key_shaft
coupon_c_m3_insert
coupon_d_m3_nut
coupon_e_m3_holes
coupon_f_c_clip__c1
coupon_f_c_clip__c2
coupon_f_clip_pin_1
coupon_f_clip_pin_2
coupon_f_pin_host
coupon_f_snap_pin_1
coupon_f_snap_pin_2
coupon_g_eye
coupon_h_gear_plate
coupon_h_gear_z12
coupon_h_gear_z24
