HarryHYu/GrappStar/kedge/dist_v35/KEDGE_v35/launcher/barrel_profile.dxf

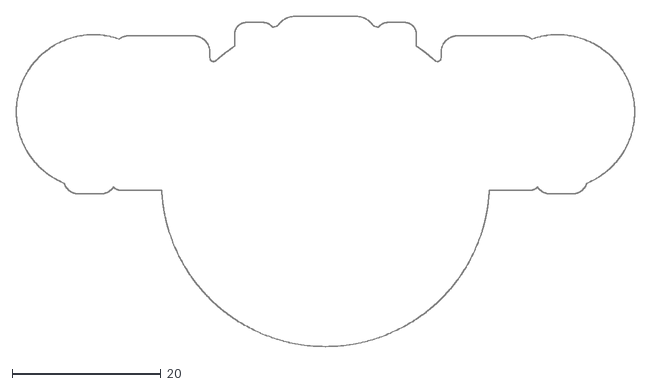
[picture p255: CAD file, 2026-11-11]
kedge/dist_v35/KEDGE_v35/launcher/barrel_profile.dxf
83.0 x 44.3
