HarryHYu/GrappStar/kedge/dist_v35/KEDGE_v35/print/plate_A_hull.3mf

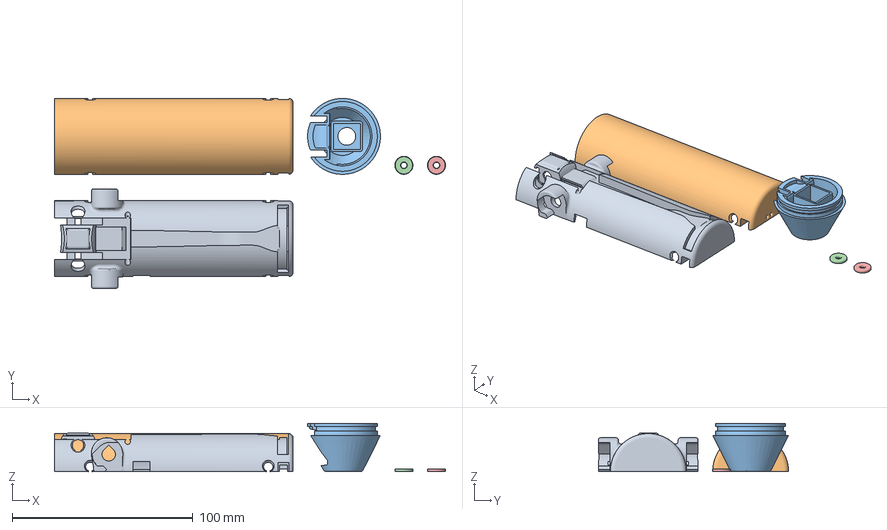
[picture p256: CAD file, 2026-11-11]
kedge/dist_v35/KEDGE_v35/print/plate_A_hull.3mf
216.3 x 105.2 x 26.6 mm
hull_top
hull_bottom
nose
pod_cap_L
pod_cap_R
