HarryHYu/GrappStar/kedge/dist_v35/KEDGE_v35/step/fit_coupon_pegs.step

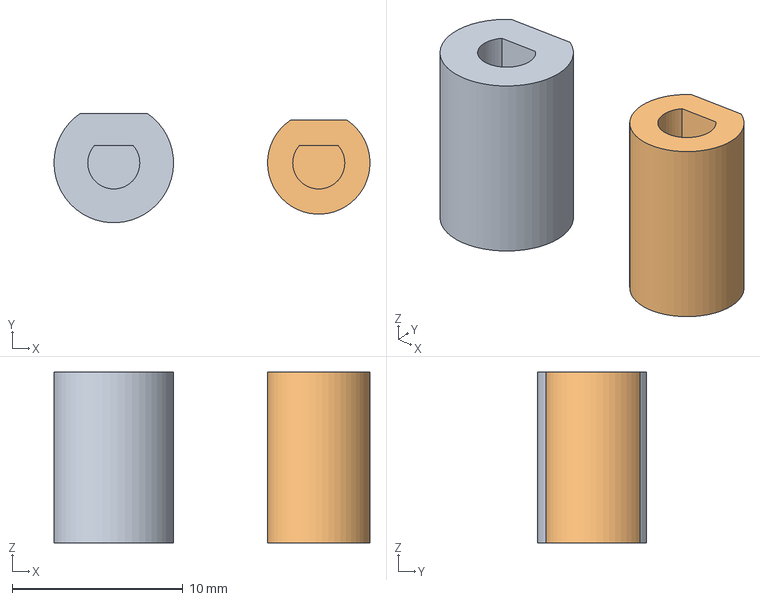
[picture p257: CAD file, 2026-11-11]
kedge/dist_v35/KEDGE_v35/step/fit_coupon_pegs.step
18.5 x 6.39 x 10.0 mm
