HarryHYu/GrappStar/kedge/dist_v35/KEDGE_v35_all_STL/PLA/tray.stl

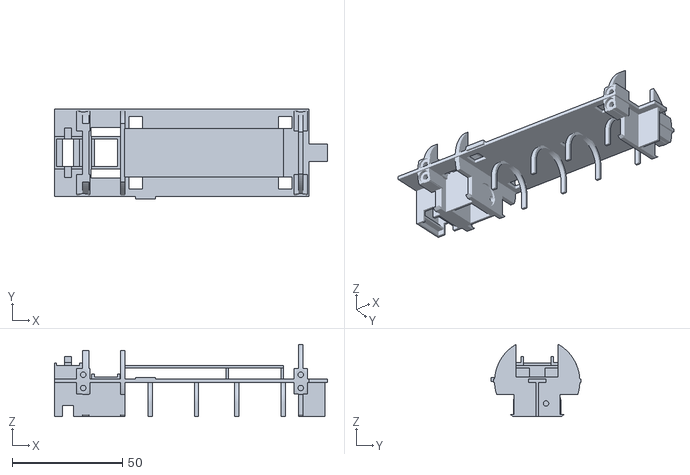
[picture p258: CAD file, 2026-11-11]
kedge/dist_v35/KEDGE_v35_all_STL/PLA/tray.stl
123.6 x 40.8 x 32.8
