HarryHYu/GrappStar/kedge/dist_v35/KEDGE_v35_all_STL/PPA-CF/leg_coupler_L.stl

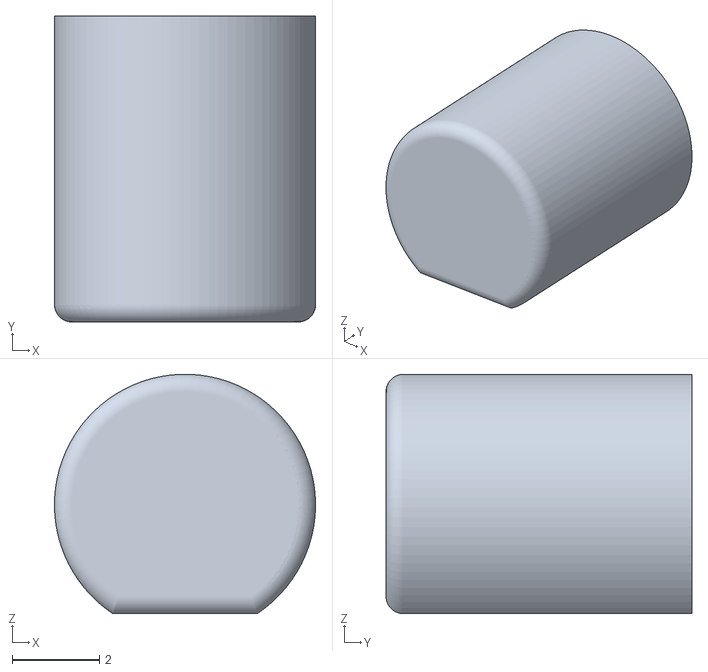
[picture p259: CAD file, 2026-11-09]
kedge/dist_v35/KEDGE_v35_all_STL/PPA-CF/leg_coupler_L.stl
6.00 x 7.03 x 5.50
