HarryHYu/GrappStar/kedge/gs/out/pulley_R.stl

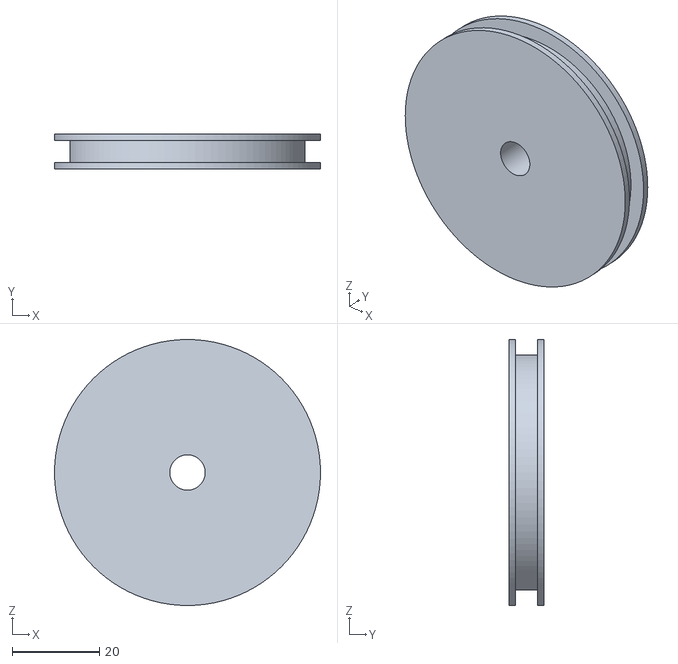
[picture p260: CAD file, 2026-11-02]
kedge/gs/out/pulley_R.stl
61.0 x 8.00 x 61.0
