HarryHYu/GrappStar/kedge/out30/contacts_front_springs.stl

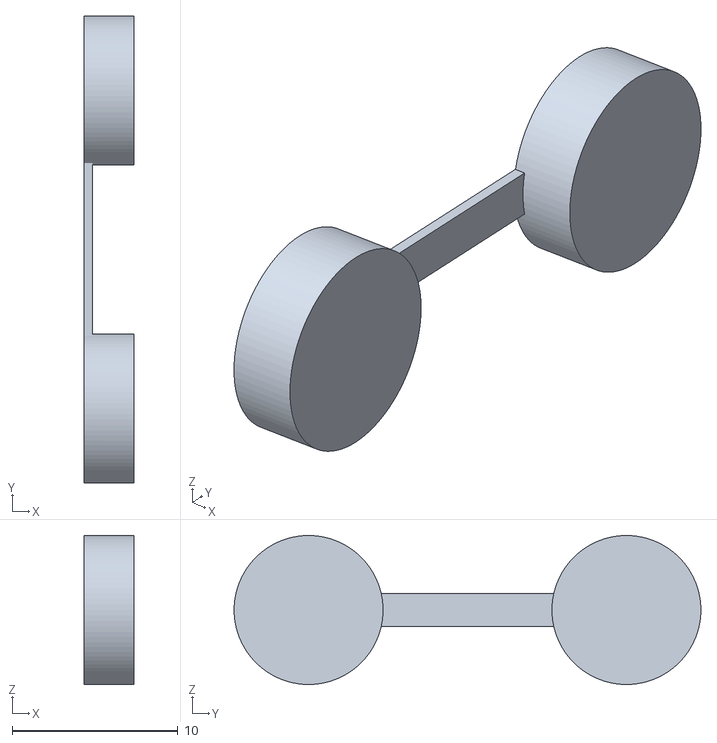
[picture p261: CAD file, 2026-11-02]
kedge/out30/contacts_front_springs.stl
3.01 x 28.2 x 9.00
