HarryHYu/GrappStar/kedge/out31/drill_leg_R_motor.stl

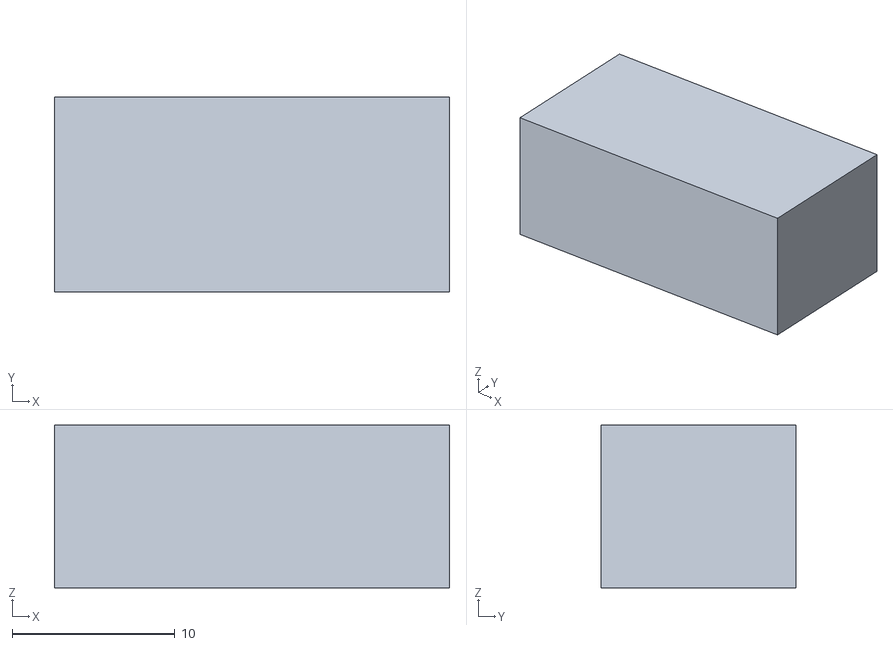
[picture p262: CAD file, 2026-11-07]
kedge/out31/drill_leg_R_motor.stl
24.3 x 12.0 x 10.0
