HarryHYu/GrappStar/kedge/out34/drill_leg_L.step

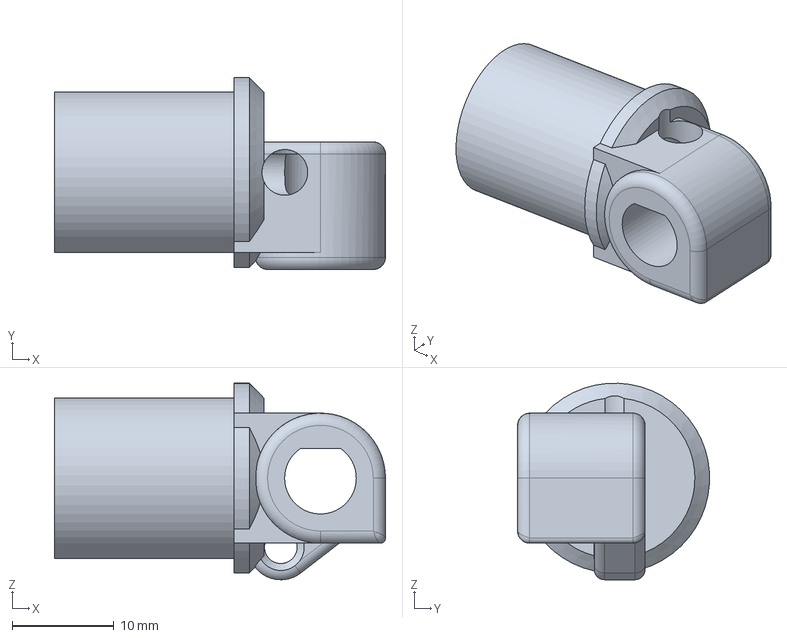
[picture p263: CAD file, 2026-11-09]
kedge/out34/drill_leg_L.step
32.6 x 18.9 x 19.3 mm
