HarryHYu/GrappStar/kedge/out35/drv8833_1.stl

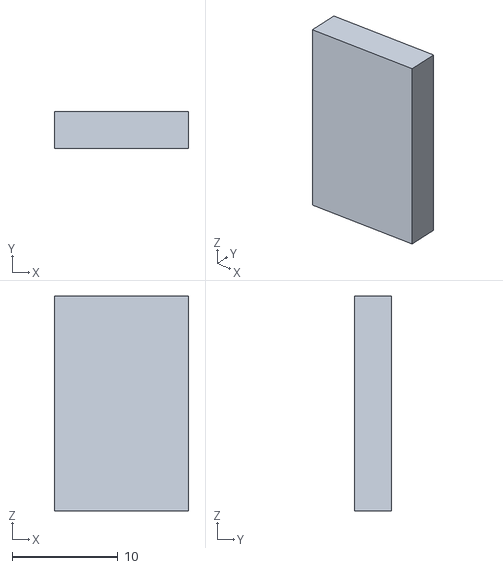
[picture p264: CAD file, 2026-11-11]
kedge/out35/drv8833_1.stl
12.7 x 3.50 x 20.3
