HarryHYu/GrappStar/kedge/pack_gs/plates/plate_05_PLA.3mf

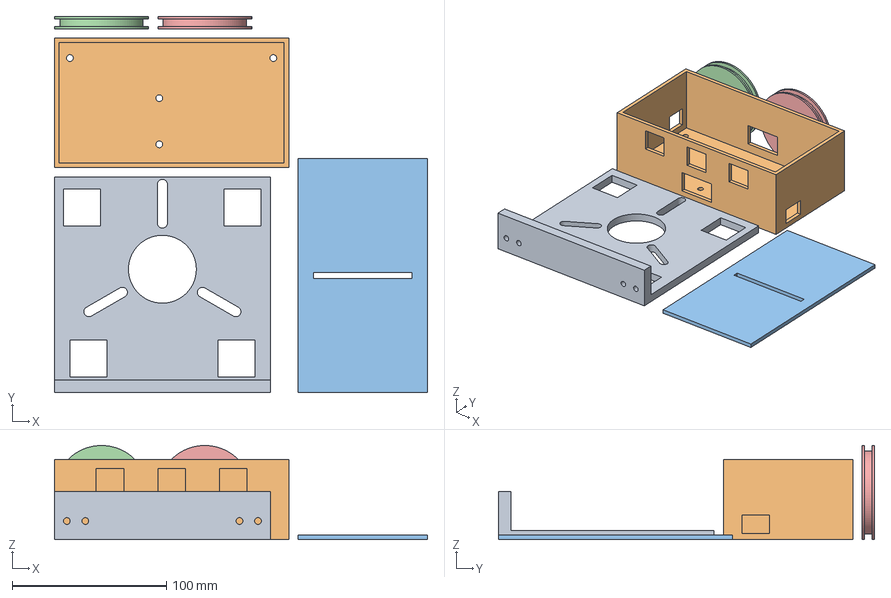
[picture p265: CAD file, 2026-11-02]
kedge/pack_gs/plates/plate_05_PLA.3mf
242.0 x 244.0 x 61.0 mm
motor_plate.stl
ebox.stl
ebox_lid.stl
pulley_R.stl
pulley_L.stl
