HarryHYu/GrappStar/kedge/pack_gs/step/pg_spacer_L.step

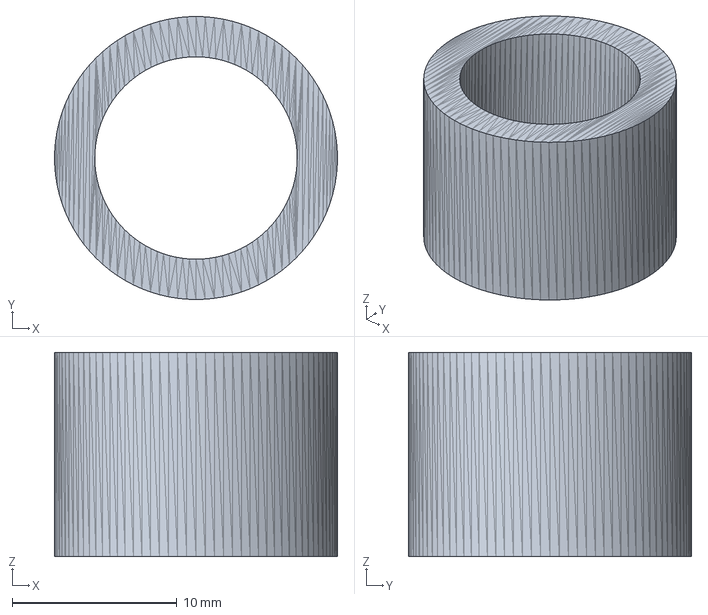
[picture p266: CAD file, 2026-11-02]
kedge/pack_gs/step/pg_spacer_L.step
17.2 x 17.2 x 12.4 mm
