HarryHYu/GrappStar/kedge/pack_proto/drill_test_plate.3mf

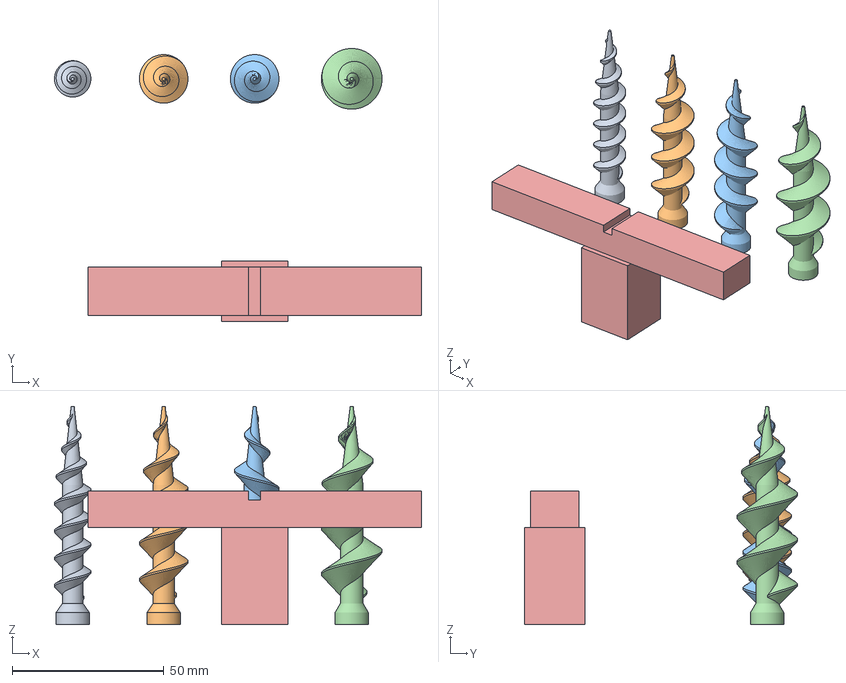
[picture p267: CAD file, 2026-11-07]
kedge/pack_proto/drill_test_plate.3mf
121.0 x 90.0 x 72.0 mm
bit_T12_RH
bit_T16_RH
bit_T16_LH
bit_T20_RH
drill_grip
