HarryHYu/GrappStar/kedge/pack_v35/plate_C_couplers_PPA-CF.3mf

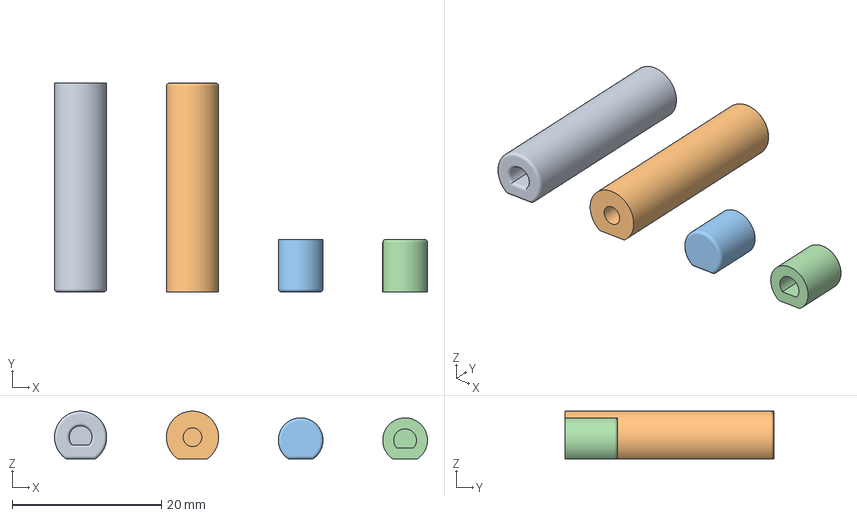
[picture p268: CAD file, 2026-11-11]
kedge/pack_v35/plate_C_couplers_PPA-CF.3mf
50.0 x 28.0 x 6.40 mm
coupler_L
coupler_R
leg_coupler_L
leg_coupler_R
