HarryHYu/GrappStar/kedge/work/launcher10/07_frame.stl

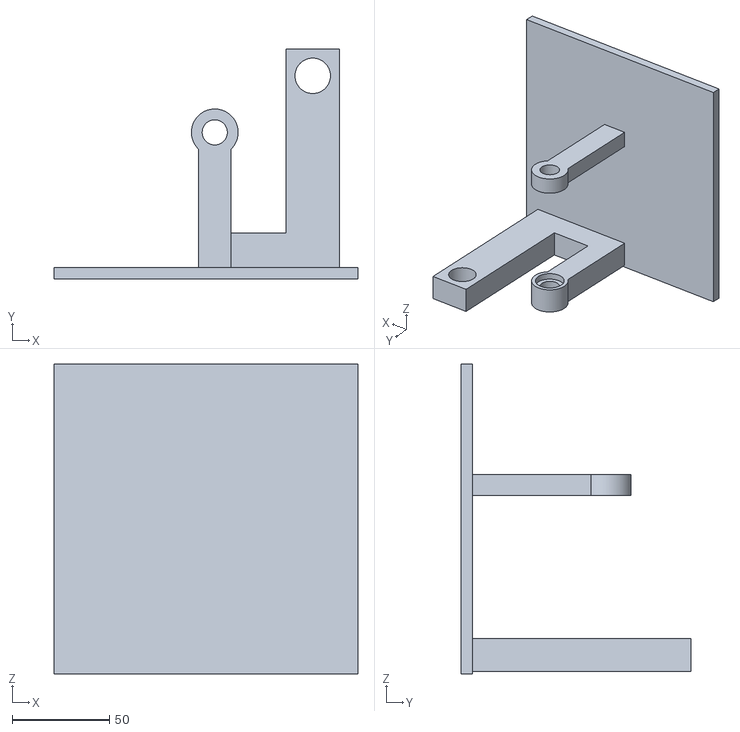
[picture p269: CAD file, 2026-11-02]
kedge/work/launcher10/07_frame.stl
156.0 x 118.1 x 159.0
