HarryHYu/GrappStar/kedge/work/reel7/frame.stl

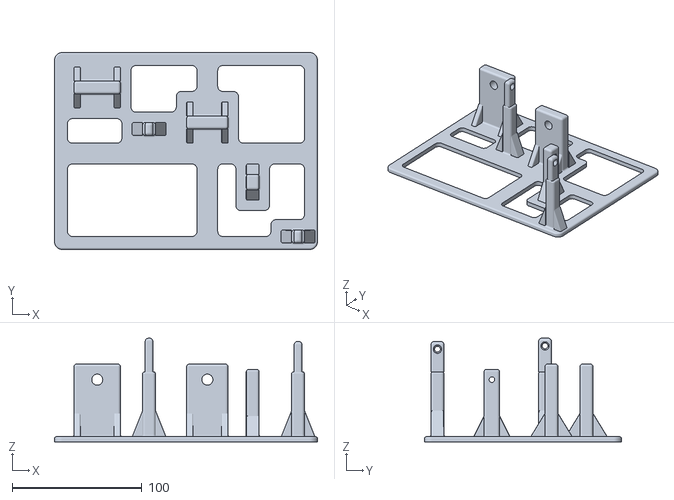
[picture p270: CAD file, 2026-11-02]
kedge/work/reel7/frame.stl
203.0 x 152.0 x 80.0
