HarryHYu/GrappStar/originals/grappstar_desk_v10_test_stl/16_motor.stl

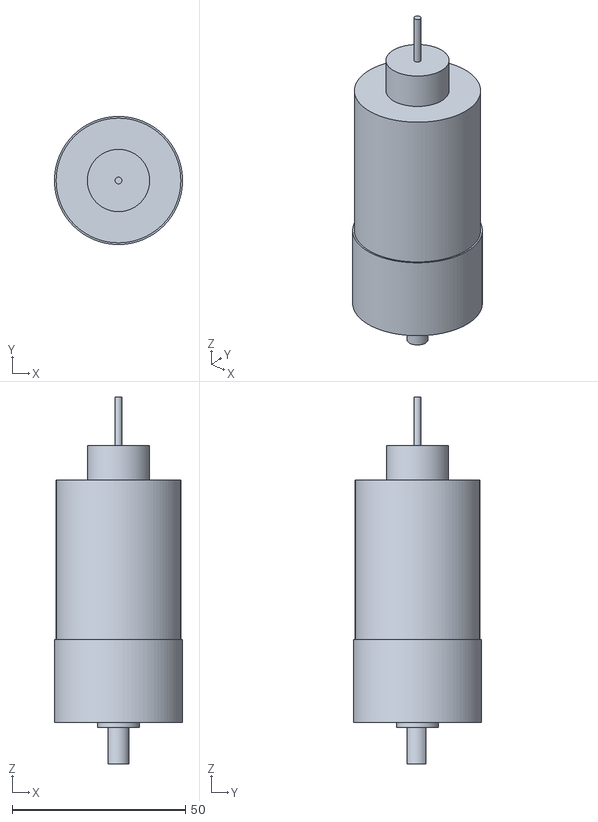
[picture p271: CAD file, 2026-11-02]
originals/grappstar_desk_v10_test_stl/16_motor.stl
37.0 x 37.0 x 106.0
