HarryHYu/GrappStar/originals/grappstar_desk_v9_stl/13_bearing_A.stl

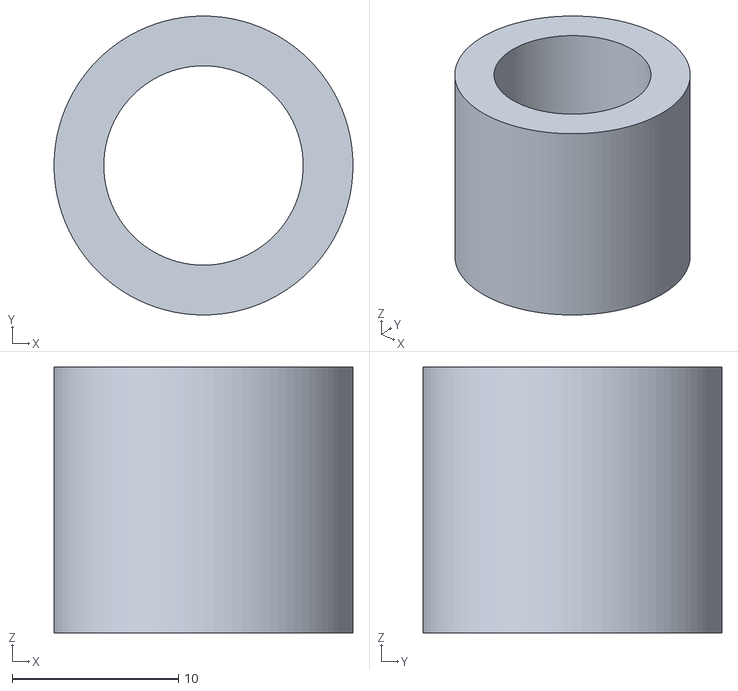
[picture p272: CAD file, 2026-11-02]
originals/grappstar_desk_v9_stl/13_bearing_A.stl
18.0 x 18.0 x 16.0
