HarryHYu/GrappStar/originals/grappstar_mini_reel_v9/lock_bracket.stl

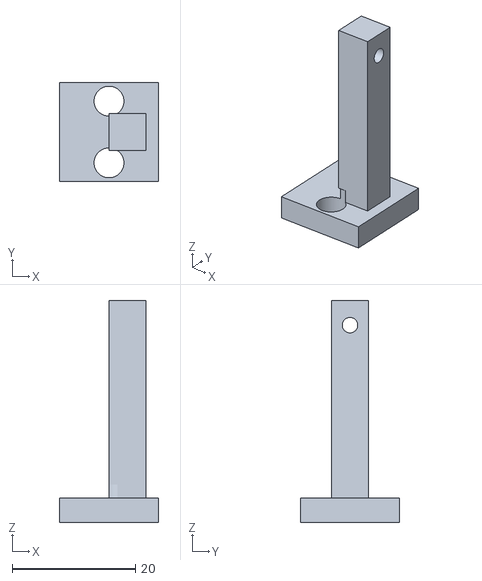
[picture p273: CAD file, 2026-11-02]
originals/grappstar_mini_reel_v9/lock_bracket.stl
16.0 x 16.0 x 36.0
