HarryHYu/GrappStar/originals/kedge_poc_print/poc_snap_pin.stl

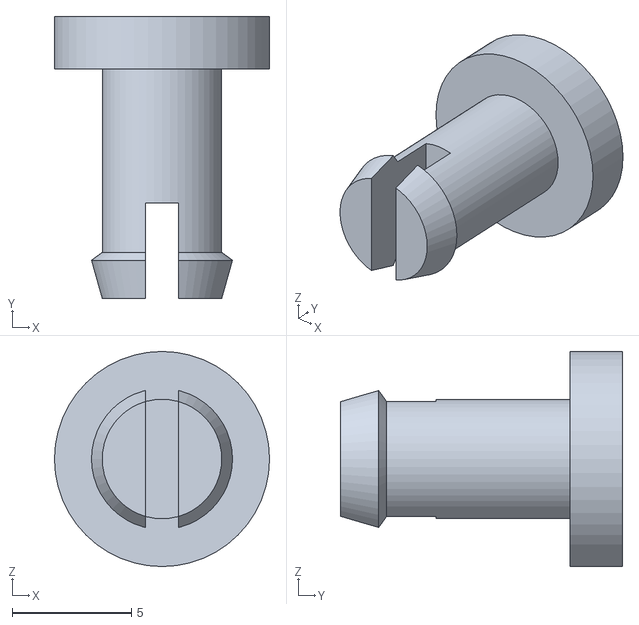
[picture p274: CAD file, 2026-11-02]
originals/kedge_poc_print/poc_snap_pin.stl
9.00 x 11.8 x 9.00
