HarryHYu/GrappStar/base/out/base/pack/plates/plate_16_PPA-CF.3mf

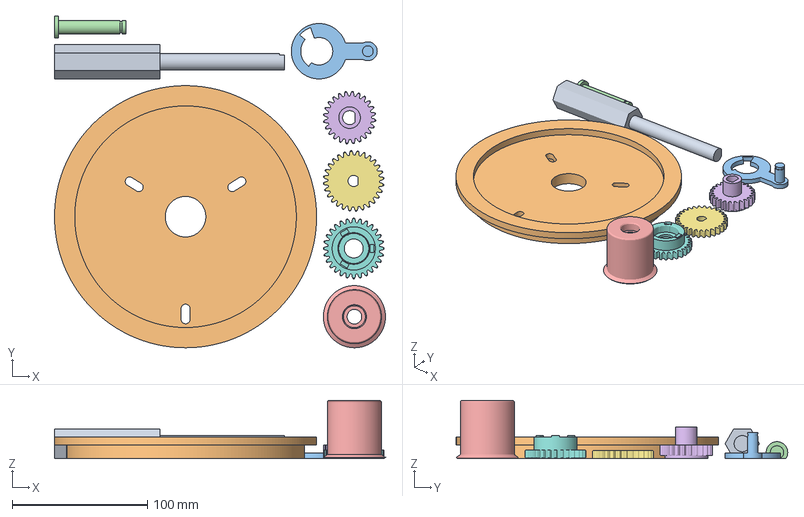
[picture p275: CAD file, 2026-11-06]
base/out/base/pack/plates/plate_16_PPA-CF.3mf
245.0 x 245.4 x 43.0 mm
drum_shaft
frame_motor_adapter
launch_aim_arm
launch_gear_pin
reel_drum
reel_gk
reel_gt2
reel_hub
