HarryHYu/GrappStar/base/out/base/pack/stl/frame_cheek_r.stl

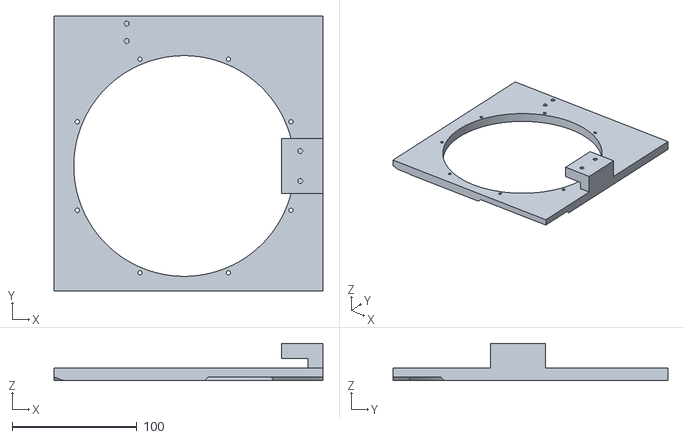
[picture p276: CAD file, 2026-11-06]
base/out/base/pack/stl/frame_cheek_r.stl
215.0 x 220.0 x 30.0
