HarryHYu/GrappStar/base/out/display/plates/plate_1_PLA.3mf

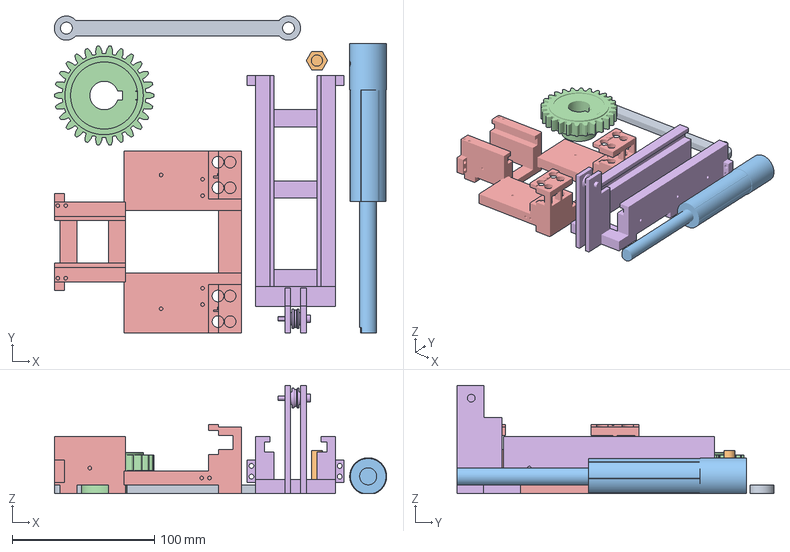
[picture p277: CAD file, 2026-11-11]
base/out/display/plates/plate_1_PLA.3mf
233.5 x 222.7 x 76.1 mm
disp_aim_conrod
disp_aim_pin
disp_axle
disp_drive_gear
disp_rail_front
disp_rail_rear
