HarryHYu/GrappStar/base/pack/coupons/rc1_plate.stl

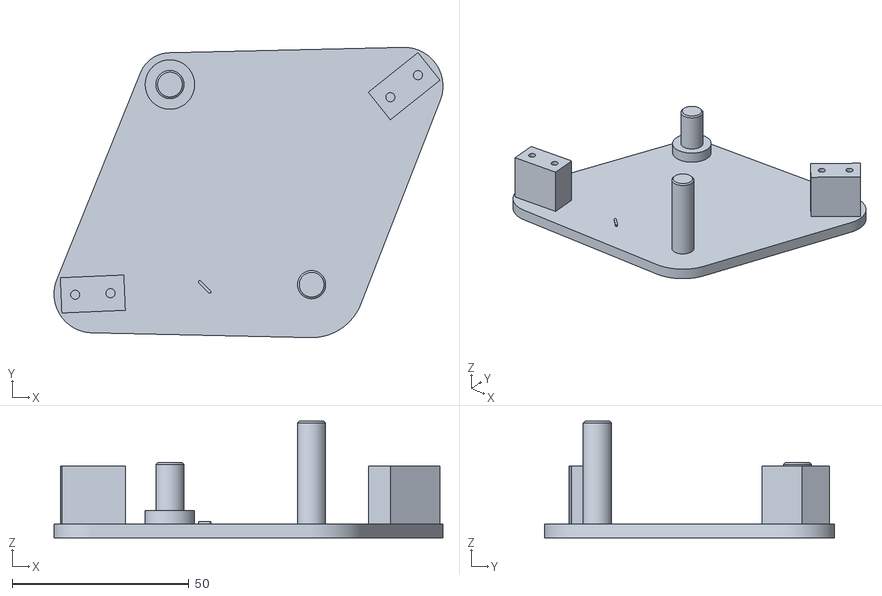
[picture p278: CAD file, 2026-11-03]
base/pack/coupons/rc1_plate.stl
110.1 x 82.2 x 33.1
