HarryHYu/GrappStar/base/pack/fit_coupon/coupon_f_snap_pin_2.stl

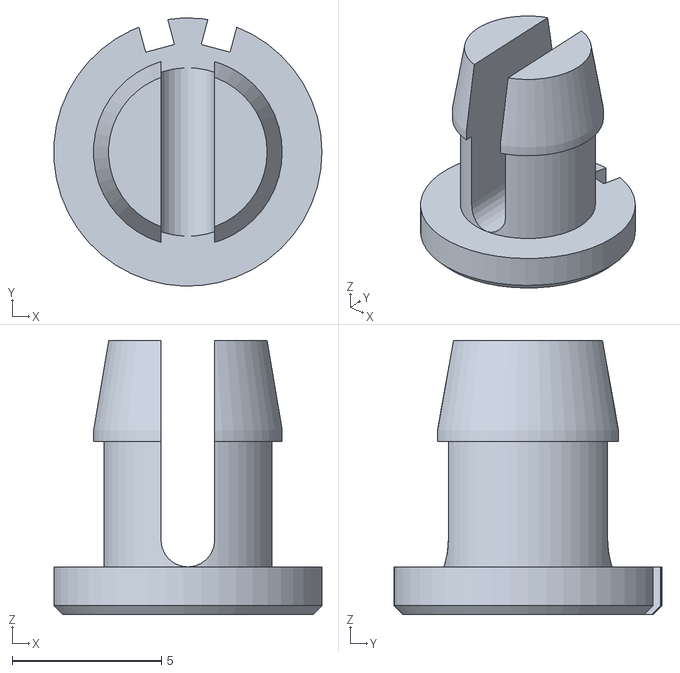
[picture p279: CAD file, 2026-11-03]
base/pack/fit_coupon/coupon_f_snap_pin_2.stl
8.99 x 8.99 x 9.20
