HarryHYu/GrappStar/kedge/dist_v35/KEDGE_v35/launcher/barrel_keepout.stl

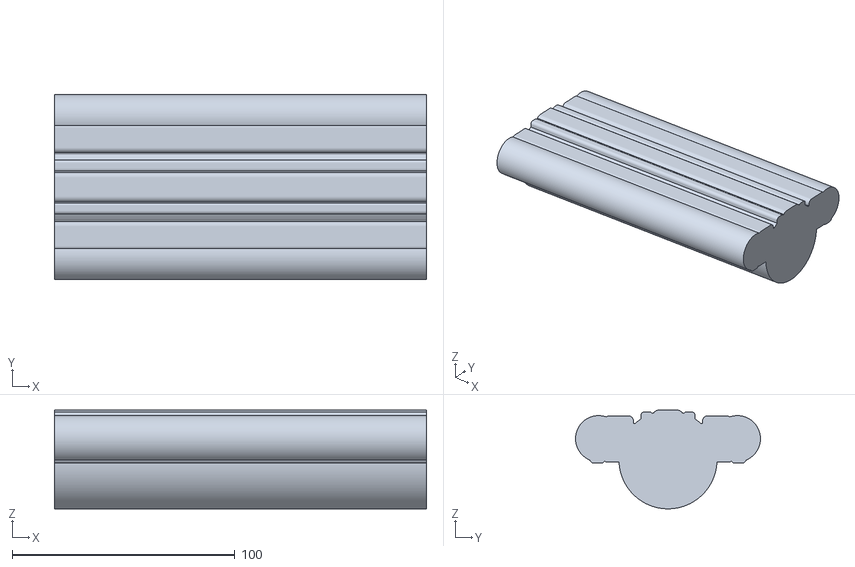
[picture p280: CAD file, 2026-11-11]
kedge/dist_v35/KEDGE_v35/launcher/barrel_keepout.stl
167.0 x 83.0 x 44.3
