HarryHYu/GrappStar/kedge/dist_v35/KEDGE_v35/step/fit_coupon.step

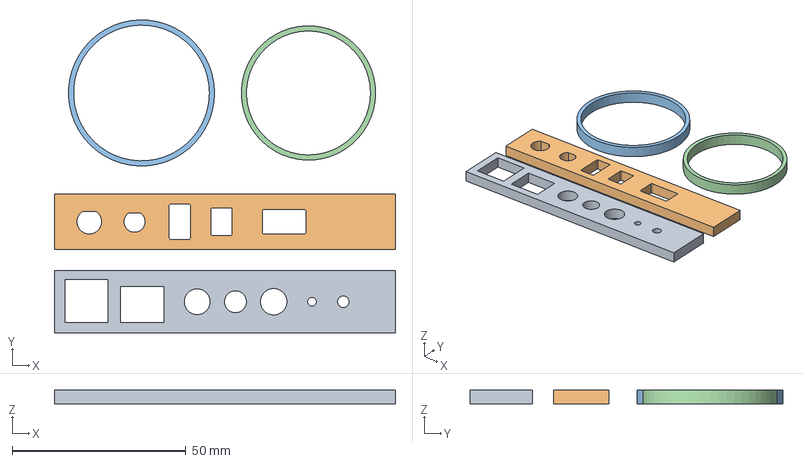
[picture p281: CAD file, 2026-11-11]
kedge/dist_v35/KEDGE_v35/step/fit_coupon.step
98.0 x 90.0 x 4.00 mm
