HarryHYu/GrappStar/kedge/dist_v35/KEDGE_v35_all_STL/PLA/hull_bottom.stl

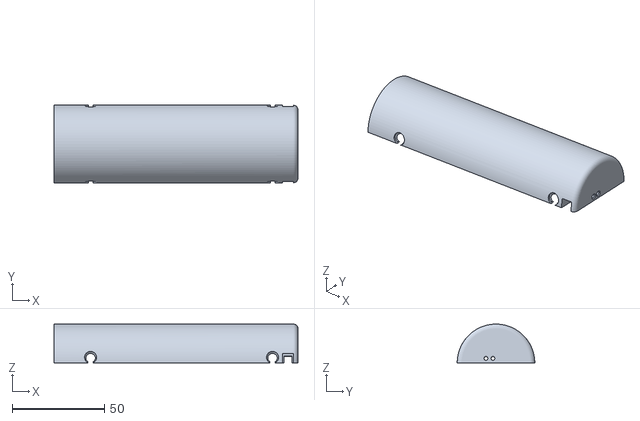
[picture p282: CAD file, 2026-11-11]
kedge/dist_v35/KEDGE_v35_all_STL/PLA/hull_bottom.stl
132.0 x 42.0 x 21.0
