HarryHYu/GrappStar/kedge/dist_v35/KEDGE_v35_all_STL/PPA-CF/coupler_L.stl

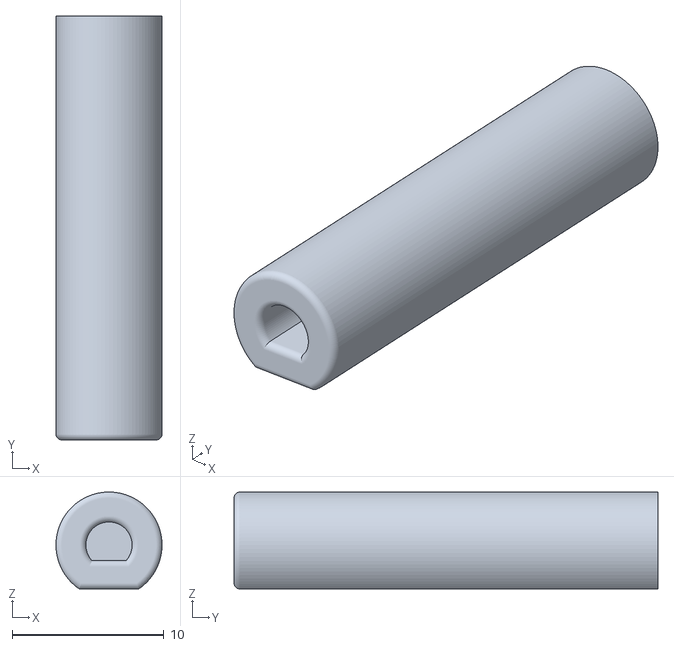
[picture p283: CAD file, 2026-11-09]
kedge/dist_v35/KEDGE_v35_all_STL/PPA-CF/coupler_L.stl
7.00 x 28.0 x 6.40
