HarryHYu/GrappStar/kedge/dist_v35/KEDGE_v35_reprint_vs_v34_STL/PLA/hull_top.stl

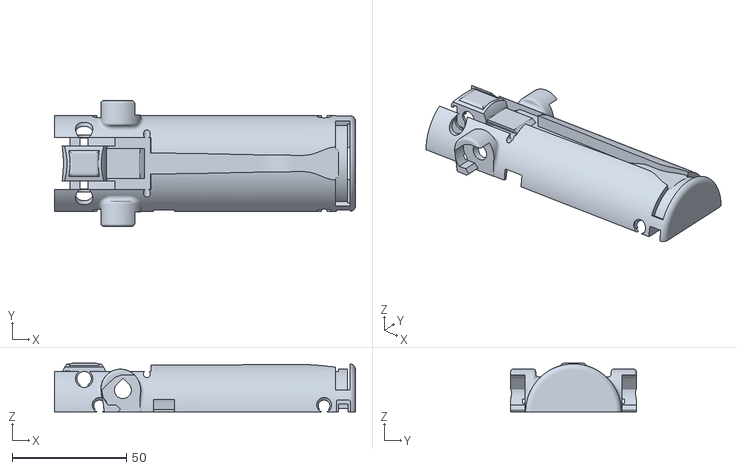
[picture p284: CAD file, 2026-11-11]
kedge/dist_v35/KEDGE_v35_reprint_vs_v34_STL/PLA/hull_top.stl
132.0 x 55.2 x 21.3
