HarryHYu/GrappStar/kedge/gs/out/spring_env_L.stl

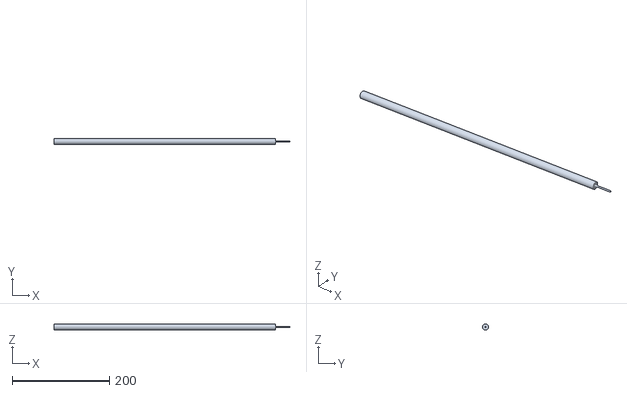
[picture p285: CAD file, 2026-11-02]
kedge/gs/out/spring_env_L.stl
485.2 x 12.6 x 12.6
