HarryHYu/GrappStar/kedge/out30/contacts_rear_plates.stl

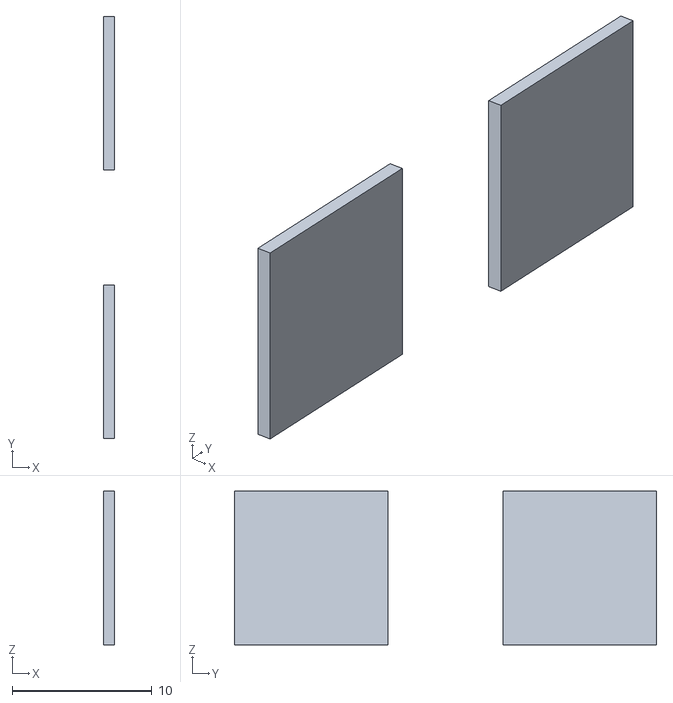
[picture p286: CAD file, 2026-11-02]
kedge/out30/contacts_rear_plates.stl
0.79 x 30.2 x 11.0
