HarryHYu/GrappStar/kedge/out31/drill_leg_R_brg2.stl

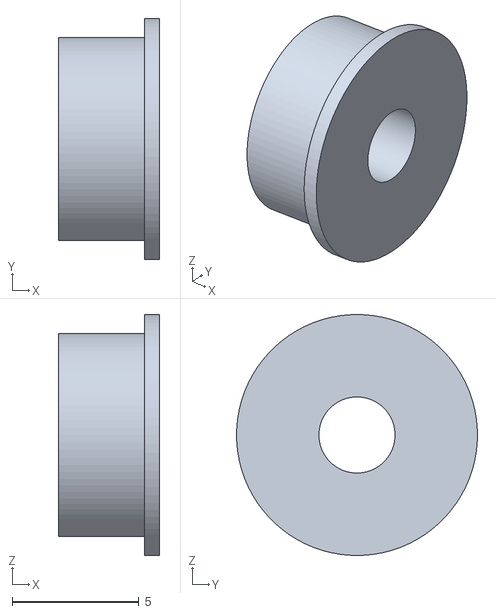
[picture p287: CAD file, 2026-11-07]
kedge/out31/drill_leg_R_brg2.stl
4.00 x 9.50 x 9.50
