HarryHYu/GrappStar/kedge/out35/vtx.stl

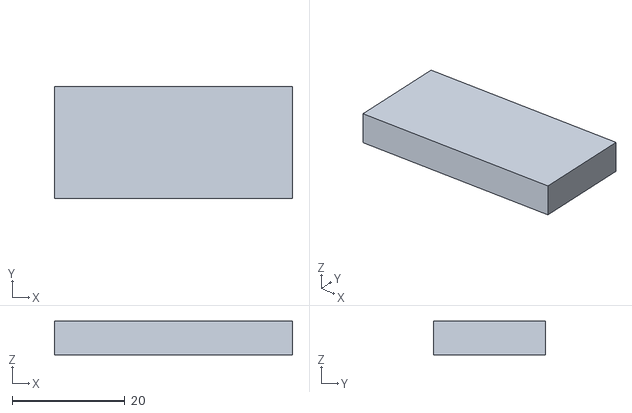
[picture p288: CAD file, 2026-11-11]
kedge/out35/vtx.stl
42.2 x 19.9 x 6.01
