HarryHYu/GrappStar/kedge/pack_gs/plates/plate_06_PPA-CF.3mf

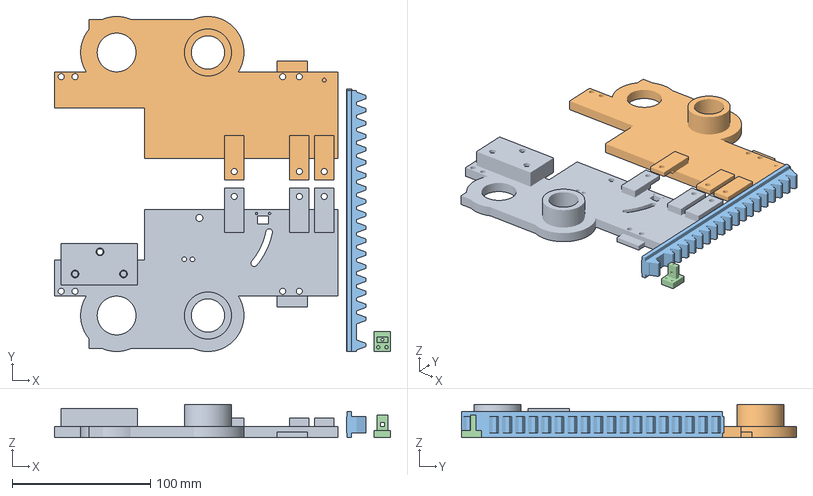
[picture p289: CAD file, 2026-11-02]
kedge/pack_gs/plates/plate_06_PPA-CF.3mf
243.0 x 242.0 x 24.0 mm
cheek_L.stl
cheek_R.stl
rack.stl
sear_spring_post.stl
