HarryHYu/GrappStar/kedge/pack_proto/bit_T12_RH.stl

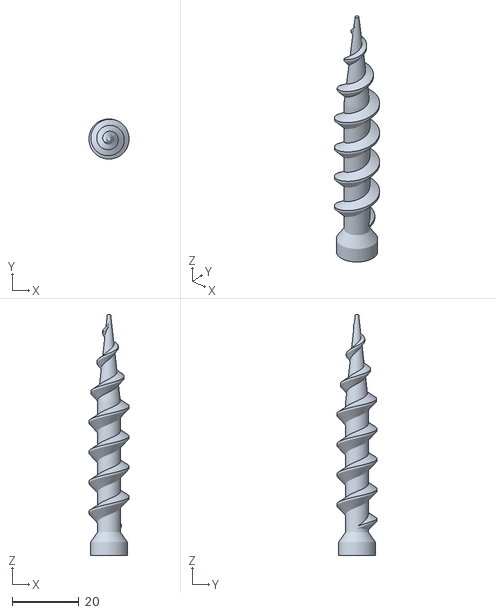
[picture p290: CAD file, 2026-11-07]
kedge/pack_proto/bit_T12_RH.stl
12.0 x 12.0 x 72.0
