HarryHYu/GrappStar/kedge/work/launcher10/09_crank_gear.stl

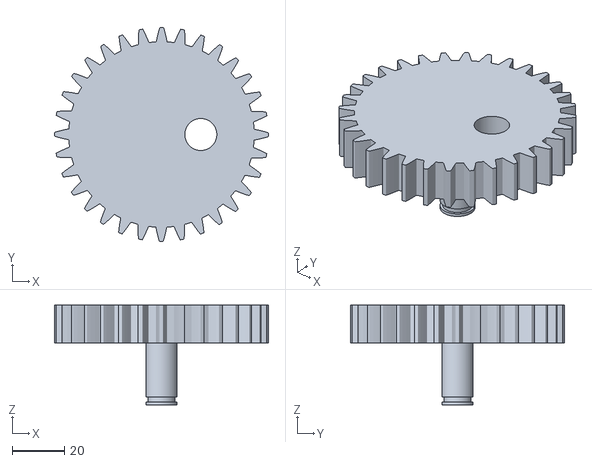
[picture p291: CAD file, 2026-11-02]
kedge/work/launcher10/09_crank_gear.stl
81.6 x 81.6 x 38.1
