HarryHYu/GrappStar/kedge/work/reel7/crank.stl

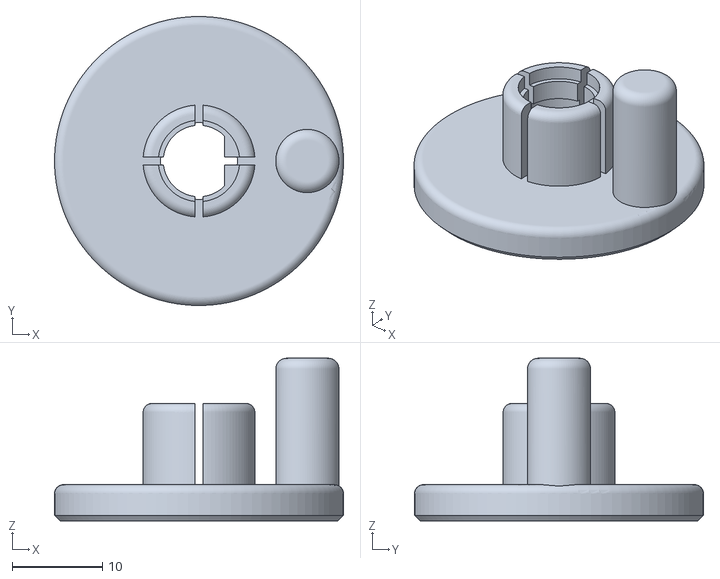
[picture p292: CAD file, 2026-11-02]
kedge/work/reel7/crank.stl
32.0 x 32.0 x 18.0
