HarryHYu/GrappStar/originals/grappstar_mini_reel_v9/base.stl

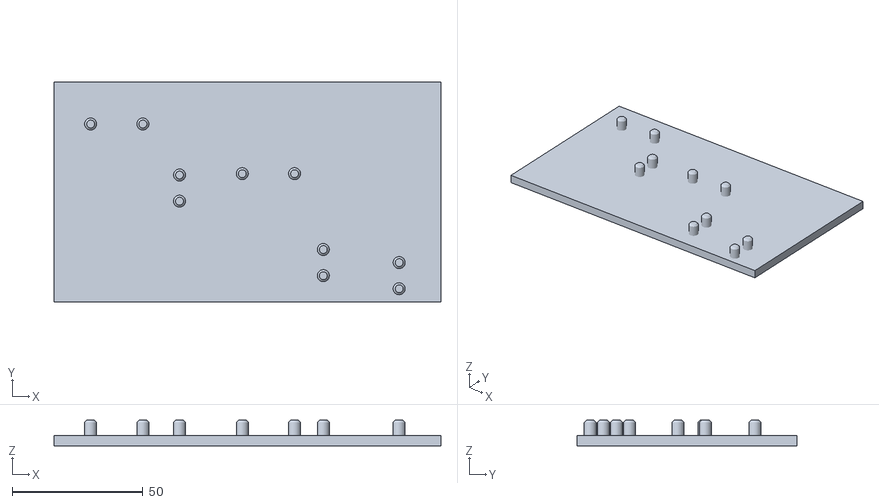
[picture p293: CAD file, 2026-11-02]
originals/grappstar_mini_reel_v9/base.stl
148.0 x 84.0 x 9.80
