HarryHYu/GrappStar/originals/kedge_poc_print/poc_body.stl

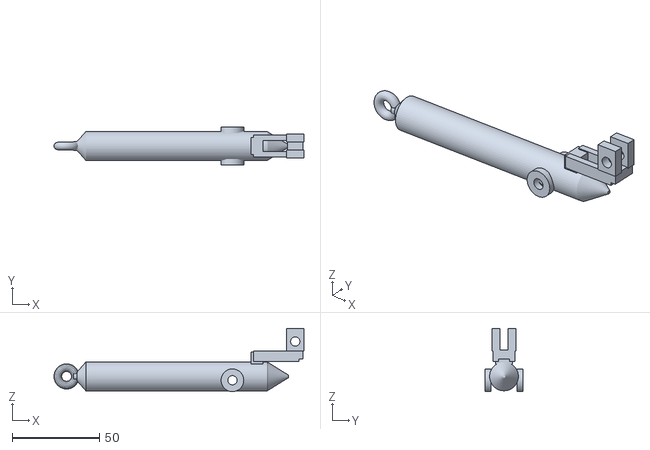
[picture p294: CAD file, 2026-11-02]
originals/kedge_poc_print/poc_body.stl
143.2 x 21.7 x 36.2
