HarryHYu/GrappStar/base/out/base/pack/plates/plate_4_PLA.3mf

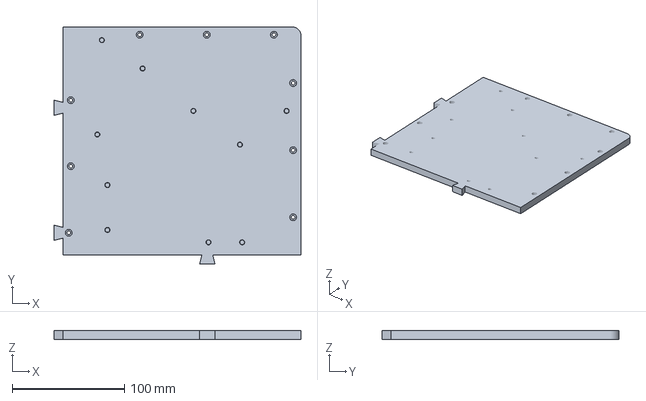
[picture p295: CAD file, 2026-11-06]
base/out/base/pack/plates/plate_4_PLA.3mf
220.0 x 211.3 x 8.00 mm
