HarryHYu/GrappStar/base/out/base/pack/stl/reel_ga2.stl

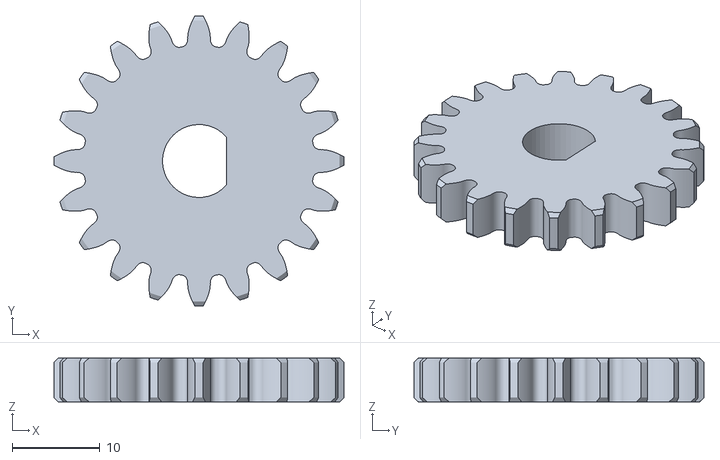
[picture p296: CAD file, 2026-11-06]
base/out/base/pack/stl/reel_ga2.stl
33.0 x 33.0 x 5.00
