HarryHYu/GrappStar/base/out/display/plates/plate_2_PLA.3mf

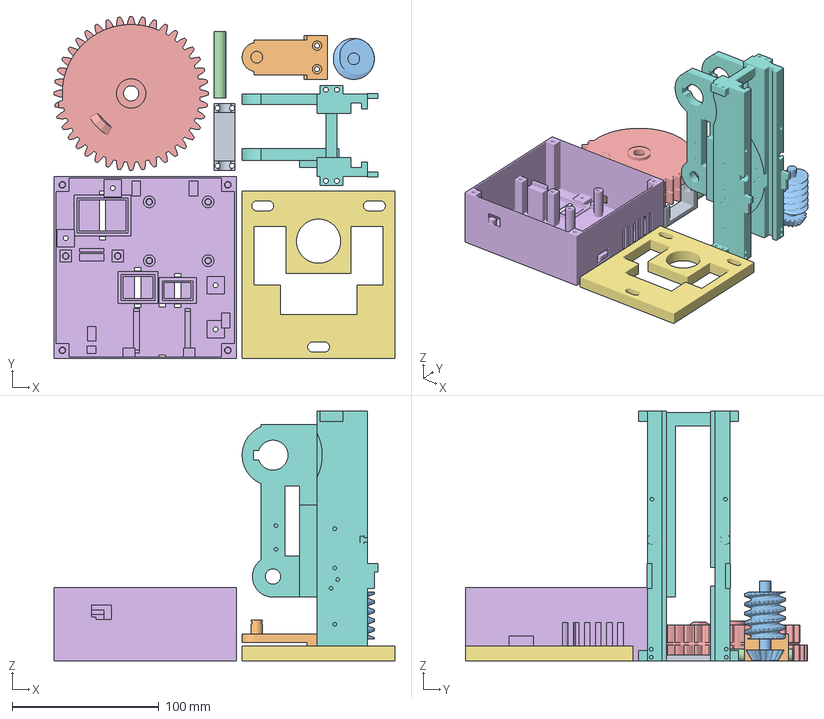
[picture p297: CAD file, 2026-11-11]
base/out/display/plates/plate_2_PLA.3mf
232.0 x 233.0 x 170.0 mm
disp_aim_cap
disp_aim_lug
disp_aim_worm
disp_anchor_pin_r
disp_big_gear
disp_ebox
disp_motor_plate
disp_rail_mid
