HarryHYu/GrappStar/base/pack/coupons/rc1_stop_e.stl

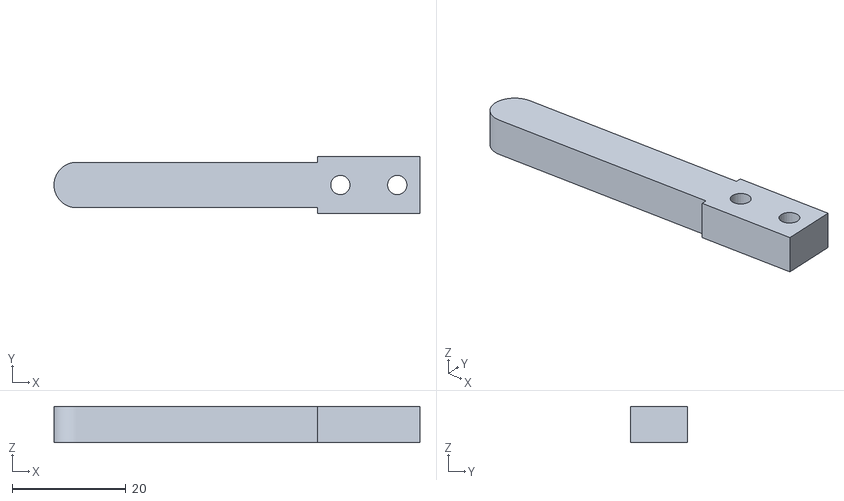
[picture p298: CAD file, 2026-11-03]
base/pack/coupons/rc1_stop_e.stl
64.4 x 10.0 x 6.40
