HarryHYu/GrappStar/base/pack/fit_coupon/coupon_b2_key_bore.stl

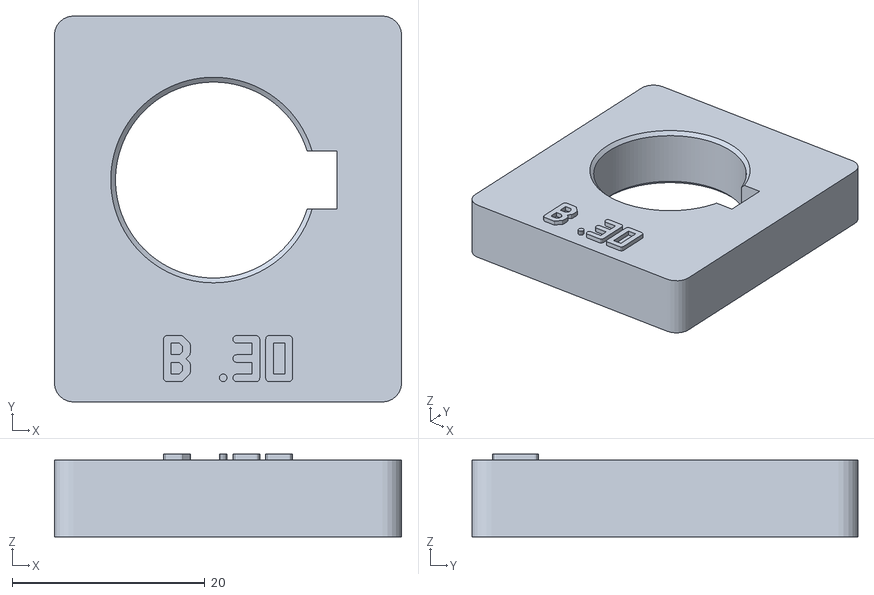
[picture p299: CAD file, 2026-11-03]
base/pack/fit_coupon/coupon_b2_key_bore.stl
36.0 x 40.0 x 8.60
