HarryHYu/GrappStar/kedge/dist_v35/KEDGE_v35/print/plate_B_legs_tray.3mf

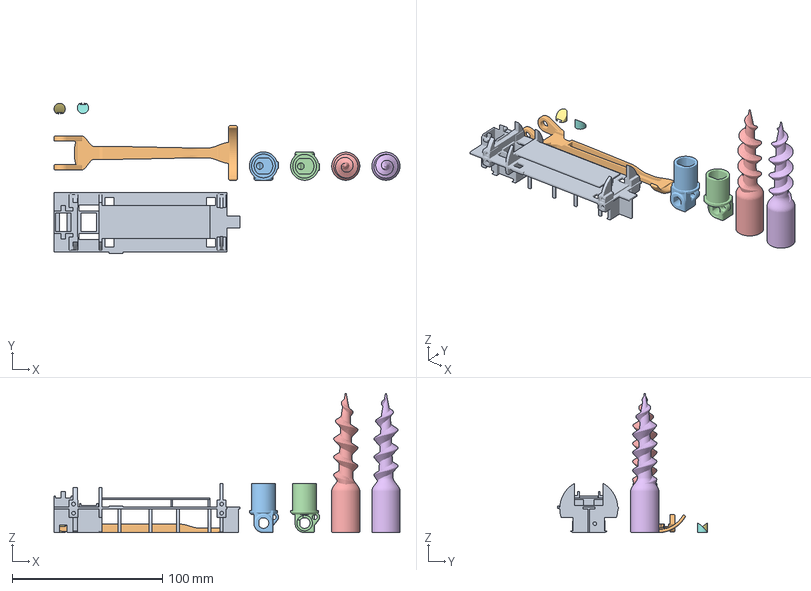
[picture p300: CAD file, 2026-11-11]
kedge/dist_v35/KEDGE_v35/print/plate_B_legs_tray.3mf
230.0 x 100.0 x 92.6 mm
tray
righting_leg
drill_leg_L
drill_leg_R
drill_leg_L_auger
drill_leg_R_auger
leg_plug_L
leg_plug_R
