HarryHYu/GrappStar/kedge/dist_v35/KEDGE_v35_all_STL/PLA/righting_leg.stl

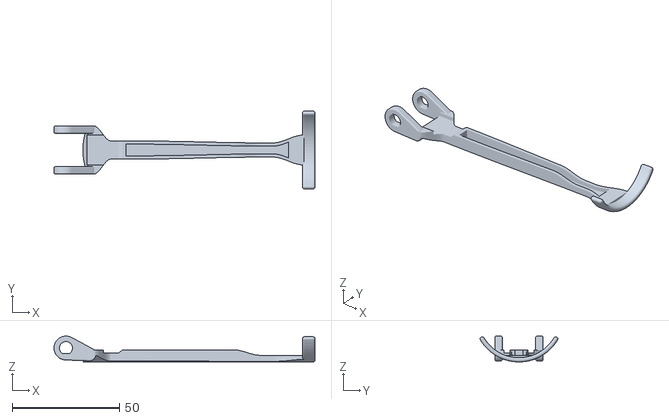
[picture p301: CAD file, 2026-11-11]
kedge/dist_v35/KEDGE_v35_all_STL/PLA/righting_leg.stl
121.9 x 36.4 x 12.1
