HarryHYu/GrappStar/kedge/gs/out/trip_spring.stl

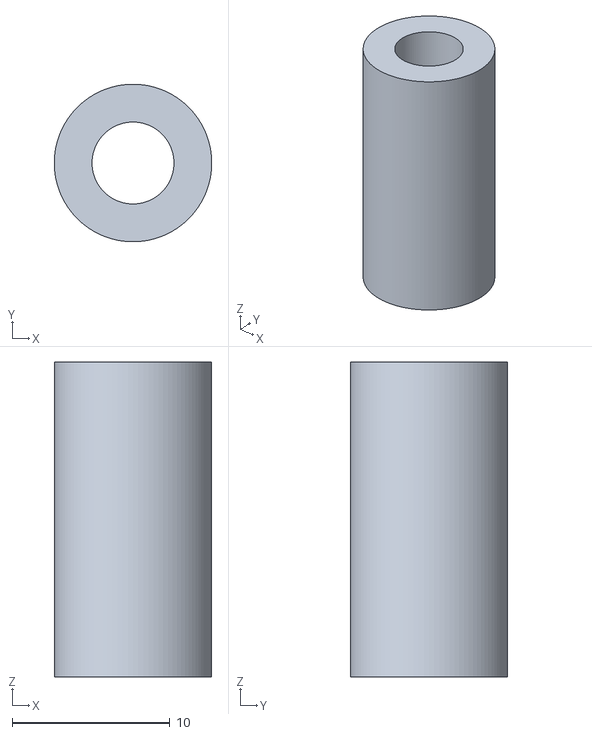
[picture p302: CAD file, 2026-11-02]
kedge/gs/out/trip_spring.stl
10.0 x 10.0 x 20.0
