HarryHYu/GrappStar/kedge/out34/leg_plug_L.step

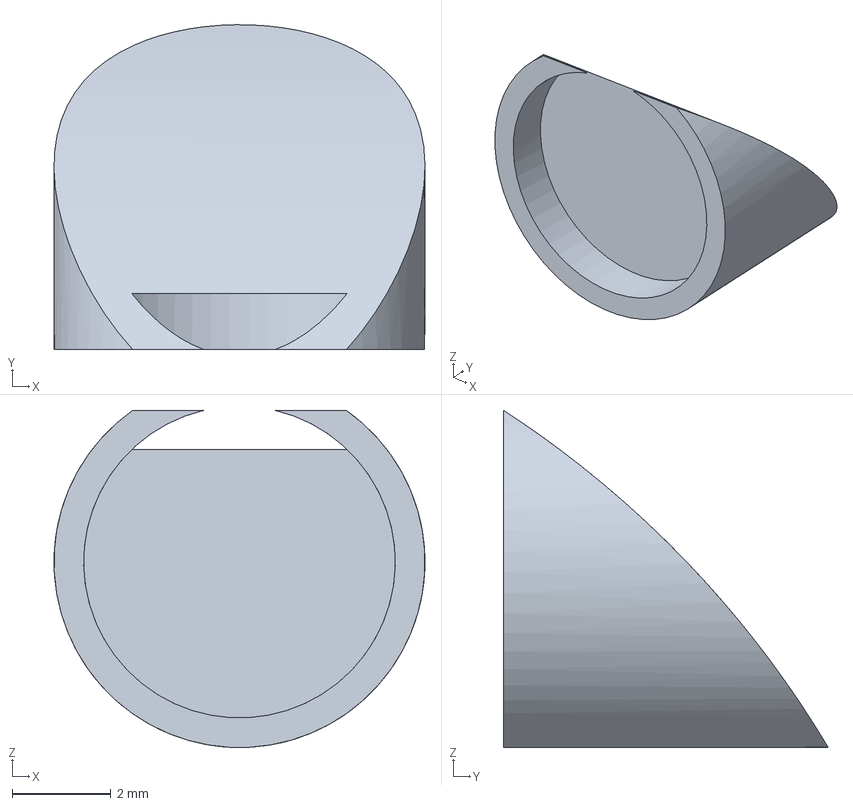
[picture p303: CAD file, 2026-11-09]
kedge/out34/leg_plug_L.step
7.50 x 6.56 x 6.81 mm
