HarryHYu/GrappStar/kedge/out35/nose.stl

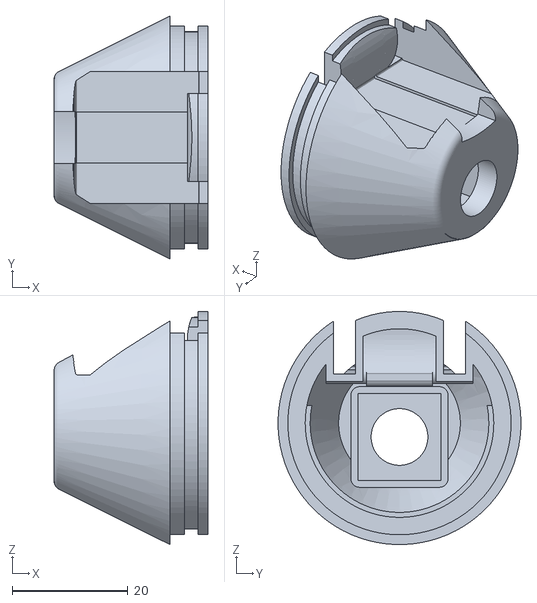
[picture p304: CAD file, 2026-11-11]
kedge/out35/nose.stl
26.6 x 42.0 x 40.3
