HarryHYu/GrappStar/kedge/pack_gs/plates/plate_02_PLA.3mf

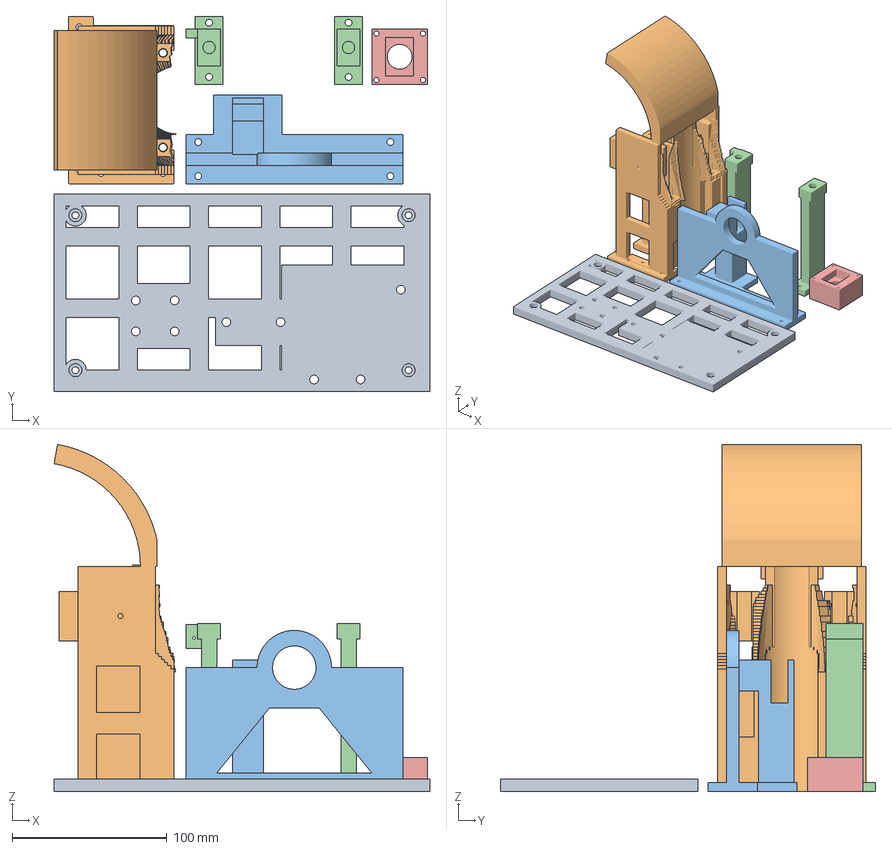
[picture p305: CAD file, 2026-11-02]
kedge/pack_gs/plates/plate_02_PLA.3mf
242.5 x 242.0 x 224.0 mm
base_4.stl
rail_beam_C.stl
frame_plate_R.stl
bumper_posts.stl
as5600_bracket.stl
