HarryHYu/GrappStar/kedge/pack_gs/step/shaft_spacer_M.step

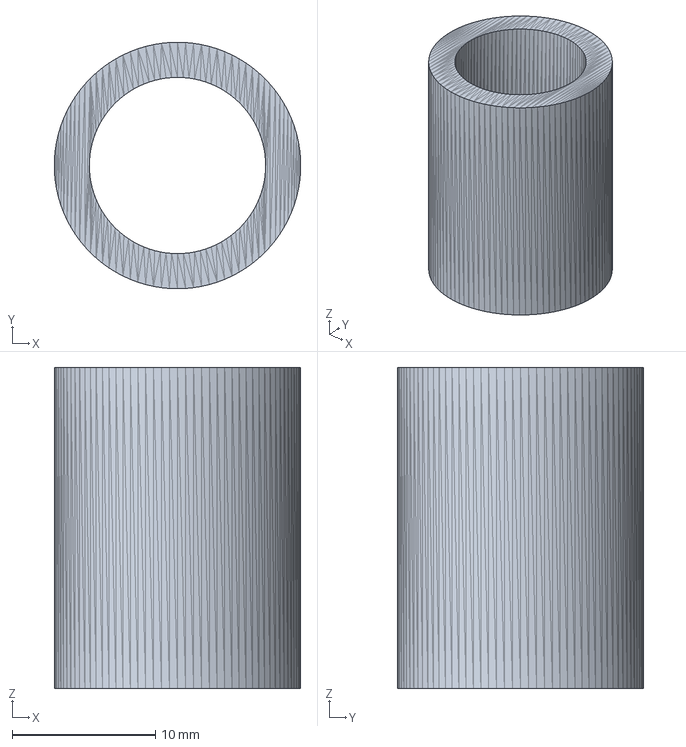
[picture p306: CAD file, 2026-11-02]
kedge/pack_gs/step/shaft_spacer_M.step
17.2 x 17.2 x 22.4 mm
