HarryHYu/GrappStar/kedge/pack_proto/drill_grip.stl

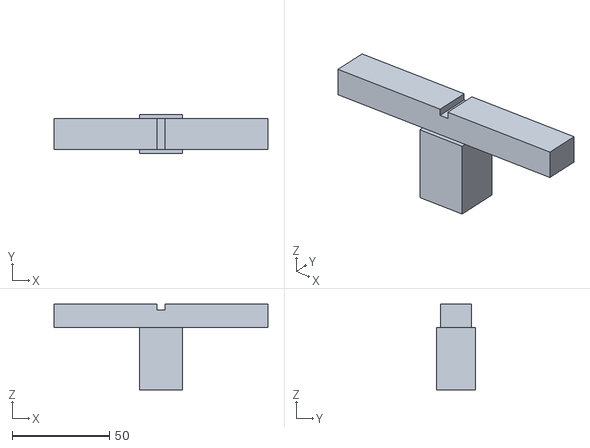
[picture p307: CAD file, 2026-11-07]
kedge/pack_proto/drill_grip.stl
110.0 x 20.0 x 44.0
