HarryHYu/GrappStar/kedge/work/launcher10/12_clip.stl

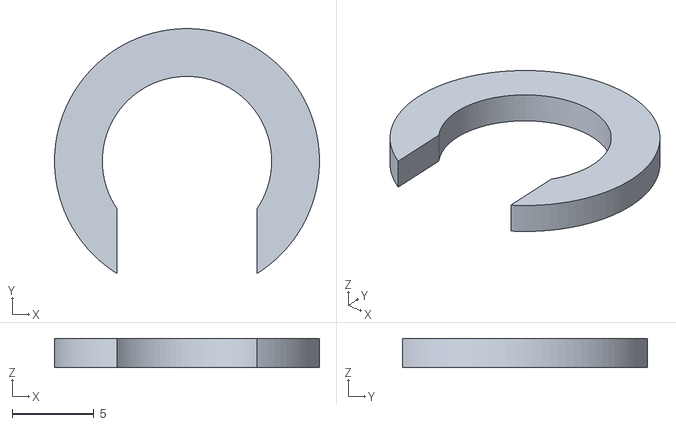
[picture p308: CAD file, 2026-11-02]
kedge/work/launcher10/12_clip.stl
16.2 x 15.0 x 1.80
