HarryHYu/GrappStar/kedge/work/reel7/drum.stl

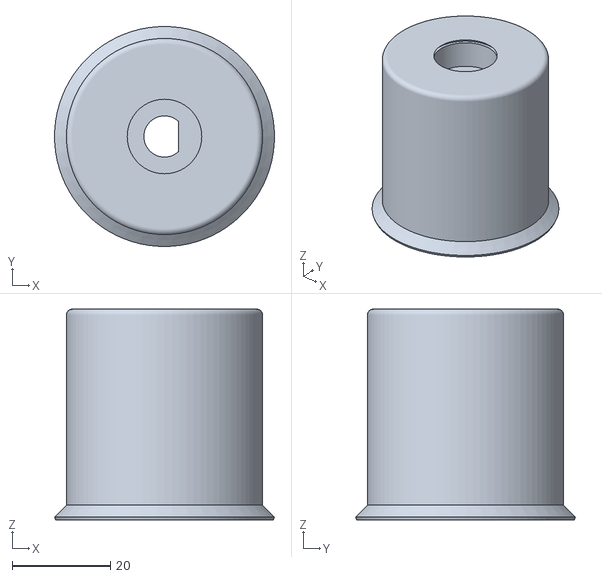
[picture p309: CAD file, 2026-11-02]
kedge/work/reel7/drum.stl
44.9 x 44.9 x 43.0
