HarryHYu/GrappStar/originals/grappstar_desk_v9_stl/06_rail_body.stl

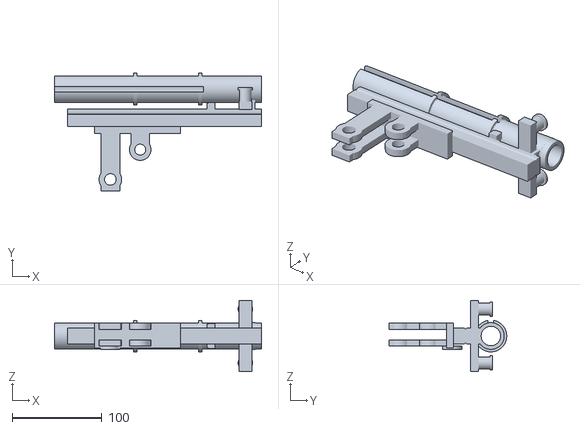
[picture p310: CAD file, 2026-11-02]
originals/grappstar_desk_v9_stl/06_rail_body.stl
230.4 x 130.8 x 79.2
