HarryHYu/GrappStar/originals/grappstar_mini_reel_v9/eye_post.stl

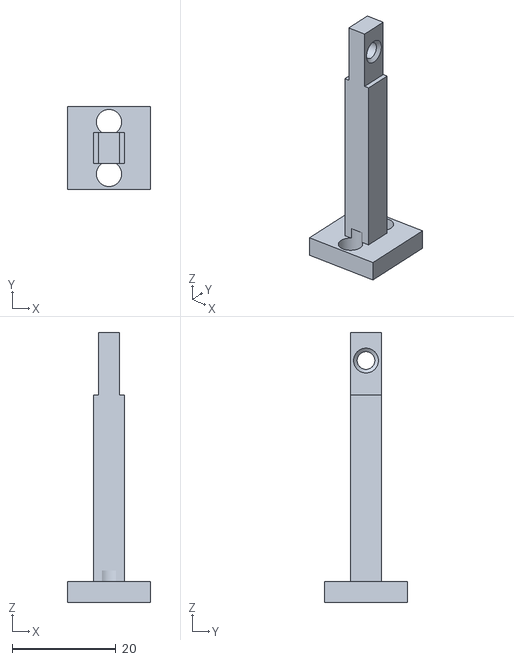
[picture p311: CAD file, 2026-11-02]
originals/grappstar_mini_reel_v9/eye_post.stl
16.0 x 16.0 x 52.0
