HarryHYu/GrappStar/originals/kedge_poc_print/poc_leg_kick.stl

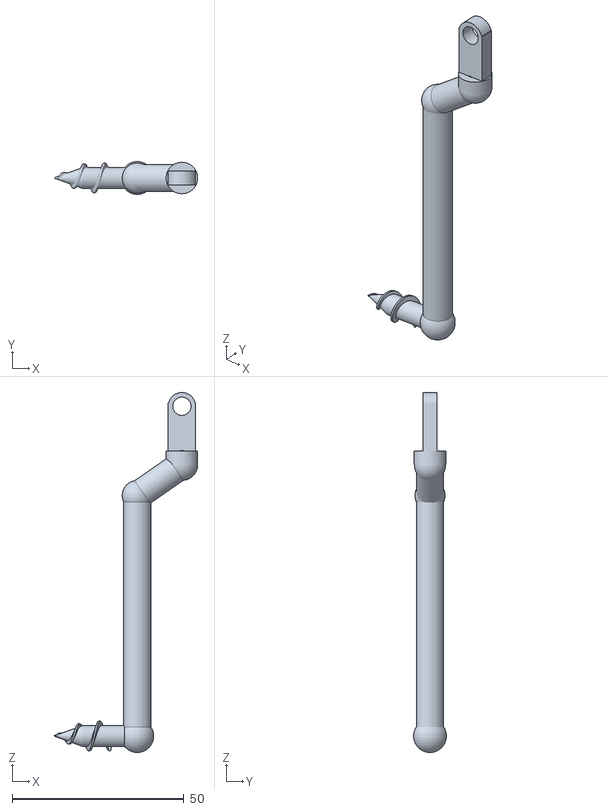
[picture p312: CAD file, 2026-11-02]
originals/kedge_poc_print/poc_leg_kick.stl
41.8 x 9.57 x 104.8
