HarryHYu/GrappStar/base/out/base/pack/plates/plate_11_PLA.3mf

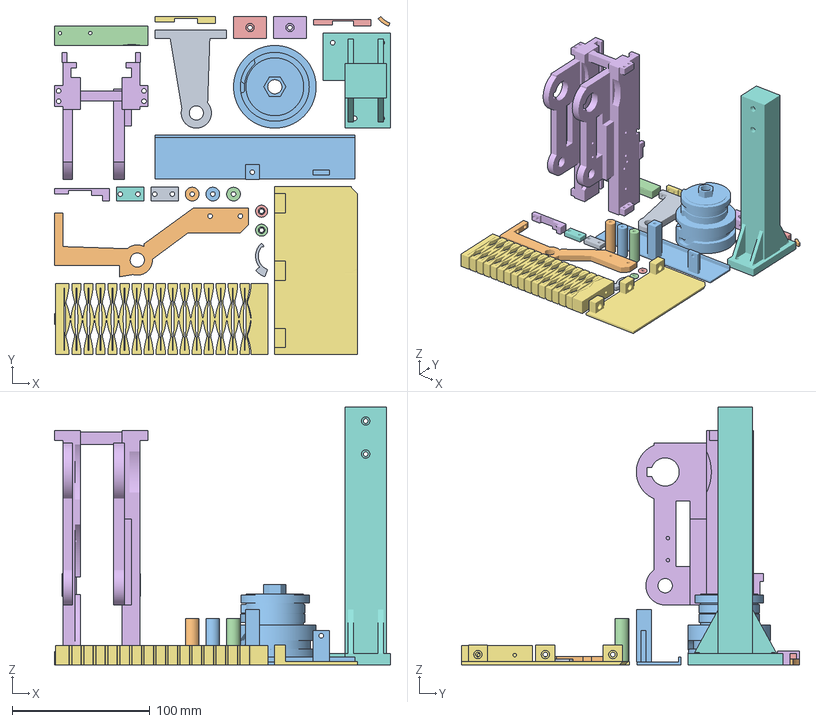
[picture p313: CAD file, 2026-11-06]
base/out/base/pack/plates/plate_11_PLA.3mf
244.0 x 245.6 x 187.0 mm
drum_bracket_idler
drum_bracket_idler2
drum_drum_b
drum_index_block
frame_cable_anchor_1
frame_cable_anchor_2
frame_guard_hood
frame_motor_leg
launch_aim_drag_pad
launch_aim_drag_shim
launch_guard_l_b2
launch_pulley_top_washer_l
launch_pulley_top_washer_r
launch_rail_mid
launch_stop_spring_r
reel_bar_cap_1
reel_bar_cap_2
reel_spacer_1
reel_spacer_2
reel_spacer_3
reel_sw_lever
sensors_sw_gap_lever
sensors_sw_rail_low_lever
