HarryHYu/GrappStar/base/out/base/pack/stl/reel_bt3.stl

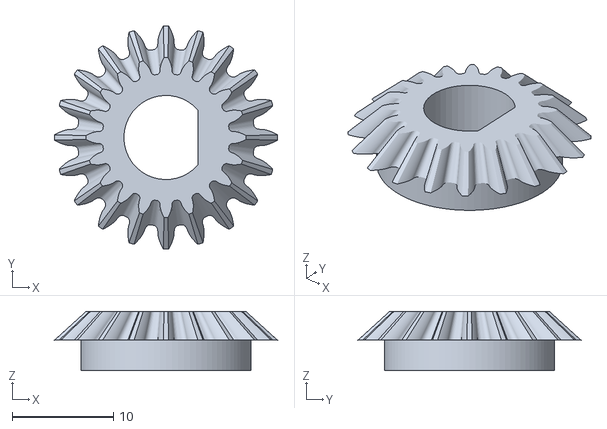
[picture p314: CAD file, 2026-11-06]
base/out/base/pack/stl/reel_bt3.stl
22.0 x 22.0 x 5.83
