HarryHYu/GrappStar/base/out/display/plates/plate_3_PLA.3mf

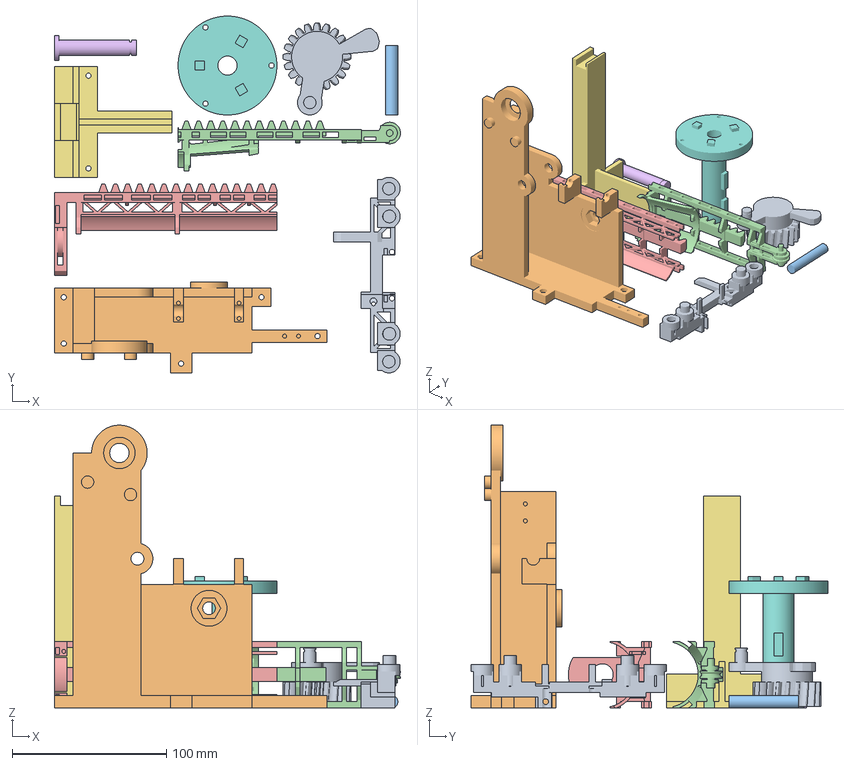
[picture p315: CAD file, 2026-11-11]
base/out/display/plates/plate_3_PLA.3mf
224.0 x 231.0 x 183.0 mm
disp_aim_crank
disp_aim_housing
disp_anchor_pin_l
disp_carriage_front
disp_carriage_rear
disp_gear_pin
disp_motor_leg
disp_sleeve
disp_yoke
