HarryHYu/GrappStar/base/pack/coupons/risk_plate_1_PLA.3mf

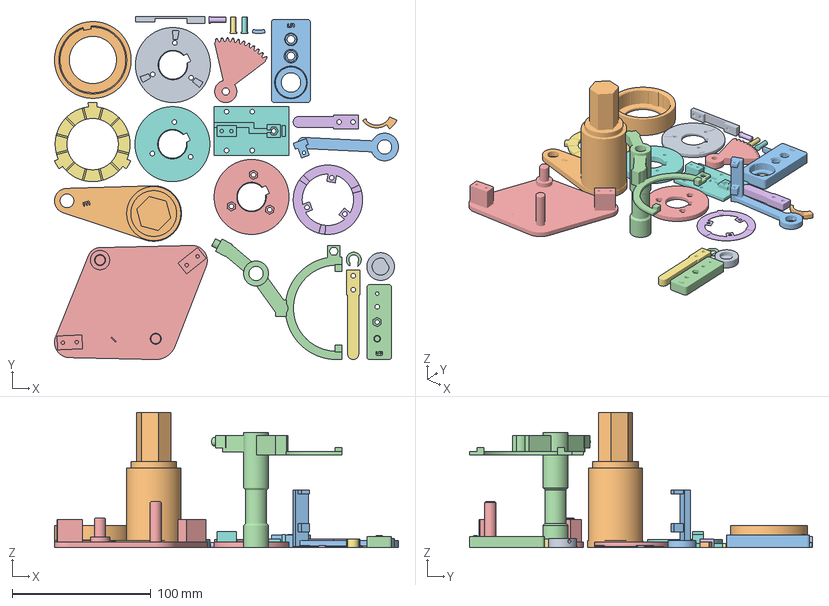
[picture p316: CAD file, 2026-11-03]
base/pack/coupons/risk_plate_1_PLA.3mf
247.8 x 247.2 x 97.5 mm
rc10_magnet_cap
rc1_drag_pad
rc1_drag_shim
rc1_idler_clip
rc1_plate
rc1_stop
rc1_stop_e
rc2_switch_base
rc2_switch_lever
rc3_base
rc3_dog_post
rc3_fork
rc4_adjuster_plate
rc4_flexure
rc4_friction_disc
rc4_hub_plate
rc4_pressure_plate
rc5_csk20_seat
rc5_seats_608_693
rc6_m3_tile
rc8_m125_seg
rc9_shear_pin__c1
rc9_shear_pin__c2
rc9_shear_pin__c3
