HarryHYu/GrappStar/kedge/gs/out/pinion_spacer_L.stl

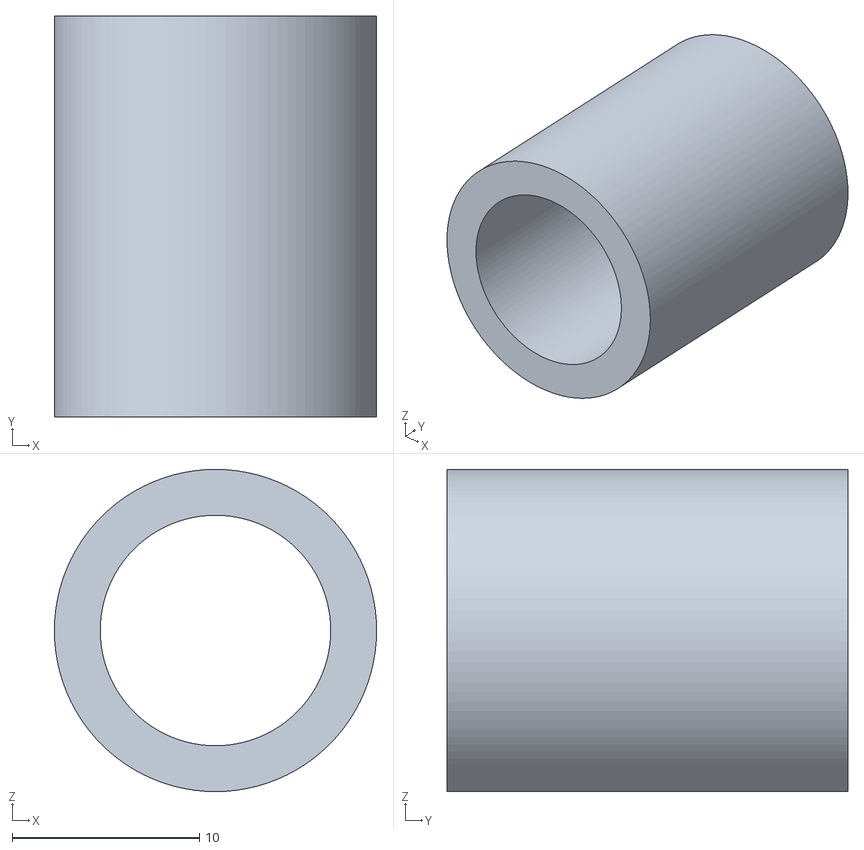
[picture p317: CAD file, 2026-11-02]
kedge/gs/out/pinion_spacer_L.stl
17.2 x 21.4 x 17.2
