HarryHYu/GrappStar/kedge/out33/foot_auger.stl

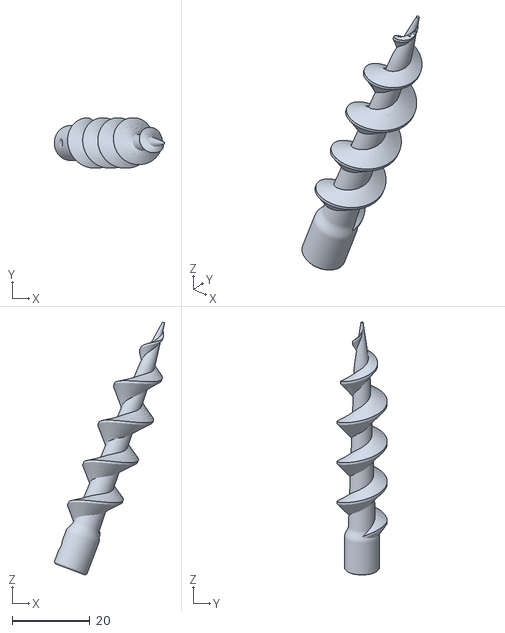
[picture p318: CAD file, 2026-11-07]
kedge/out33/foot_auger.stl
28.4 x 13.0 x 65.1
