HarryHYu/GrappStar/kedge/out35/ina219.stl

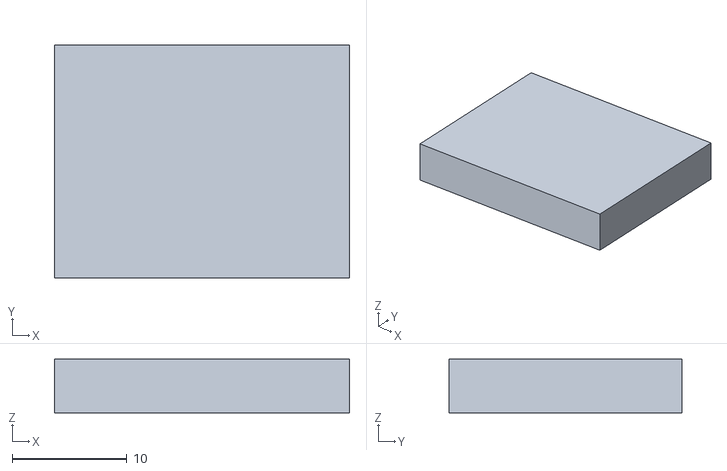
[picture p319: CAD file, 2026-11-11]
kedge/out35/ina219.stl
25.7 x 20.3 x 4.70
