HarryHYu/GrappStar/kedge/pack_gs/plates/plate_07_PPA-CF.3mf

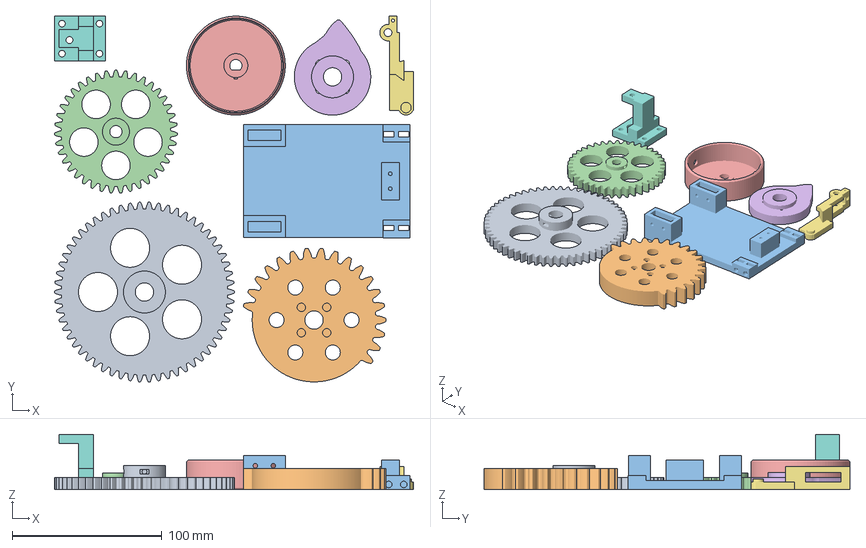
[picture p320: CAD file, 2026-11-02]
kedge/pack_gs/plates/plate_07_PPA-CF.3mf
239.5 x 244.0 x 37.0 mm
reel_main_gear.stl
program_gear.stl
spring_anchor.stl
reel_stub_gear.stl
rotor.stl
lift_cam.stl
sear.stl
trip_anchor.stl
