HarryHYu/GrappStar/kedge/pack_gs/step/spool.step

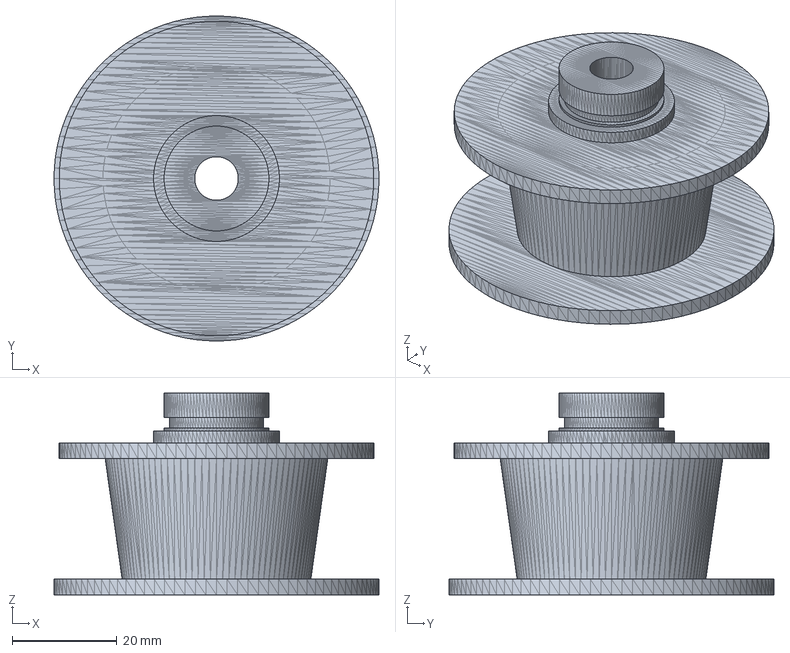
[picture p321: CAD file, 2026-11-02]
kedge/pack_gs/step/spool.step
62.0 x 62.0 x 38.5 mm
