HarryHYu/GrappStar/kedge/pack_proto/bit_T20_RH.stl

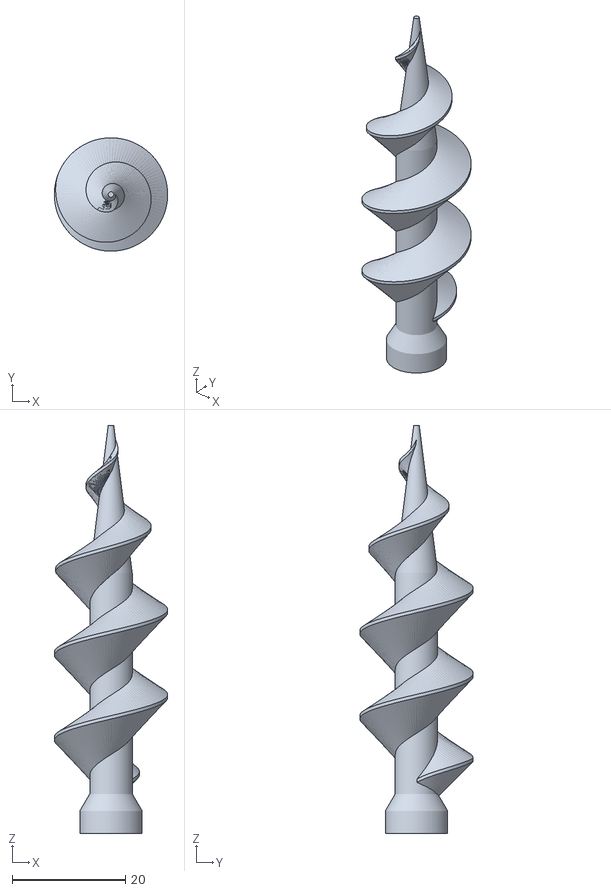
[picture p322: CAD file, 2026-11-07]
kedge/pack_proto/bit_T20_RH.stl
20.0 x 20.0 x 72.0
