HarryHYu/GrappStar/kedge/work/launcher10/08_pinion.stl

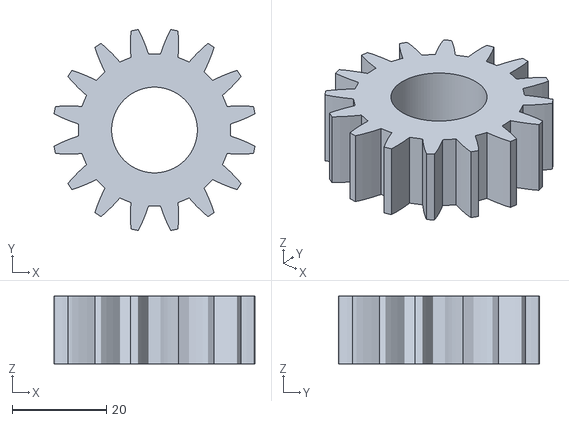
[picture p323: CAD file, 2026-11-02]
kedge/work/launcher10/08_pinion.stl
42.6 x 42.6 x 14.4
