HarryHYu/GrappStar/kedge/work/reel7/axle_spool.stl

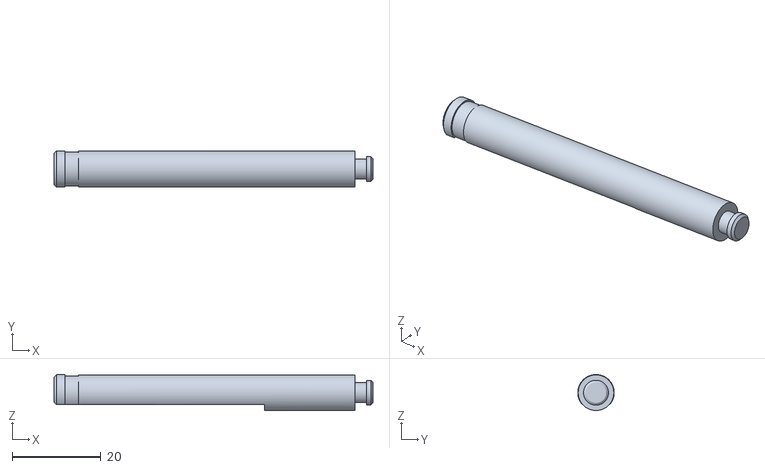
[picture p324: CAD file, 2026-11-02]
kedge/work/reel7/axle_spool.stl
71.7 x 8.20 x 8.10
