HarryHYu/GrappStar/originals/grappstar_mini_reel_v9/capstan_bracket.stl

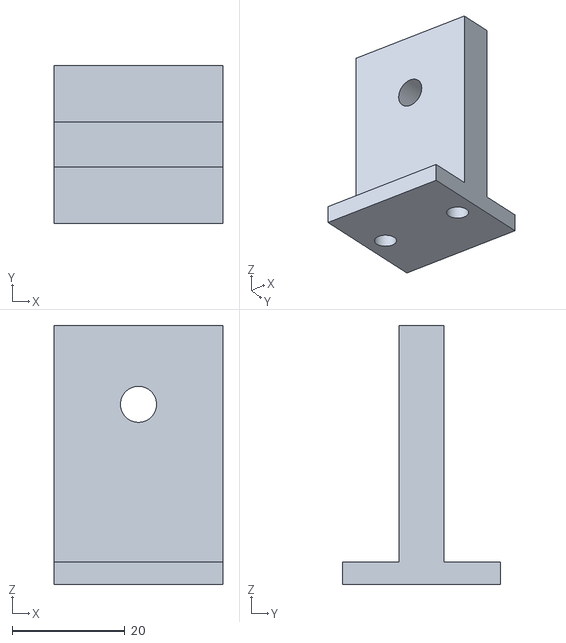
[picture p325: CAD file, 2026-11-02]
originals/grappstar_mini_reel_v9/capstan_bracket.stl
30.0 x 28.0 x 46.0
