HarryHYu/GrappStar/originals/kedge_poc_print/poc_leg_drill.stl

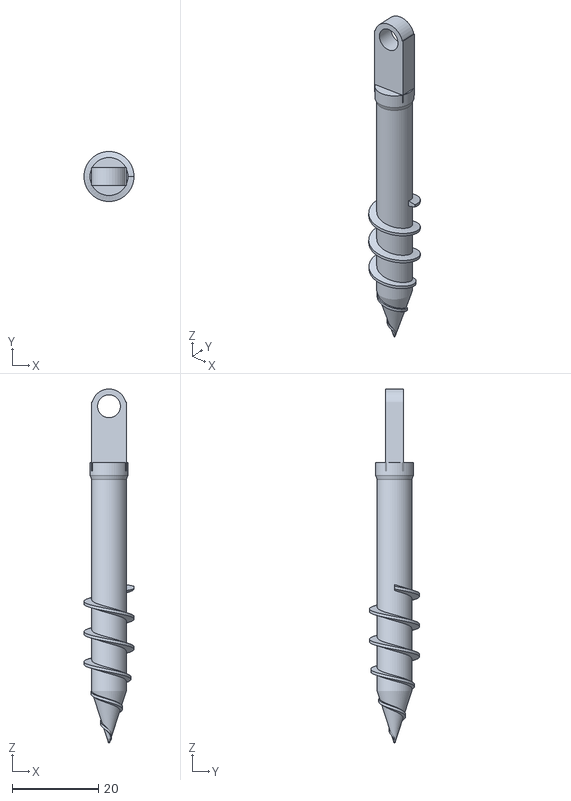
[picture p326: CAD file, 2026-11-02]
originals/kedge_poc_print/poc_leg_drill.stl
11.6 x 11.6 x 82.0
