HarryHYu/GrappStar/base/out/base/pack/plates/plate_3_PLA.3mf

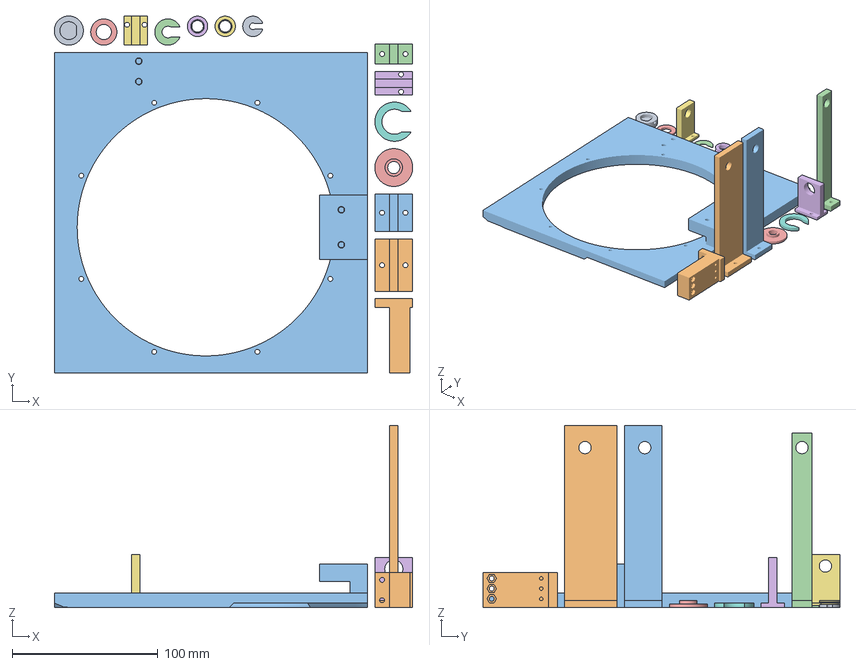
[picture p327: CAD file, 2026-11-06]
base/out/base/pack/plates/plate_3_PLA.3mf
246.0 x 245.0 x 125.0 mm
drum_magnet_cap
drum_switch_block
frame_cheek_r
launch_gear_clip
launch_gear_washer
launch_muzzle_roller
launch_pulley_top
reel_c_clip
reel_cup_clip
reel_p1_leg
reel_p2_leg
reel_post_t
reel_t
reel_tab_c
reel_tab_k
