HarryHYu/GrappStar/base/out/base/pack/stl/reel_gt3.stl

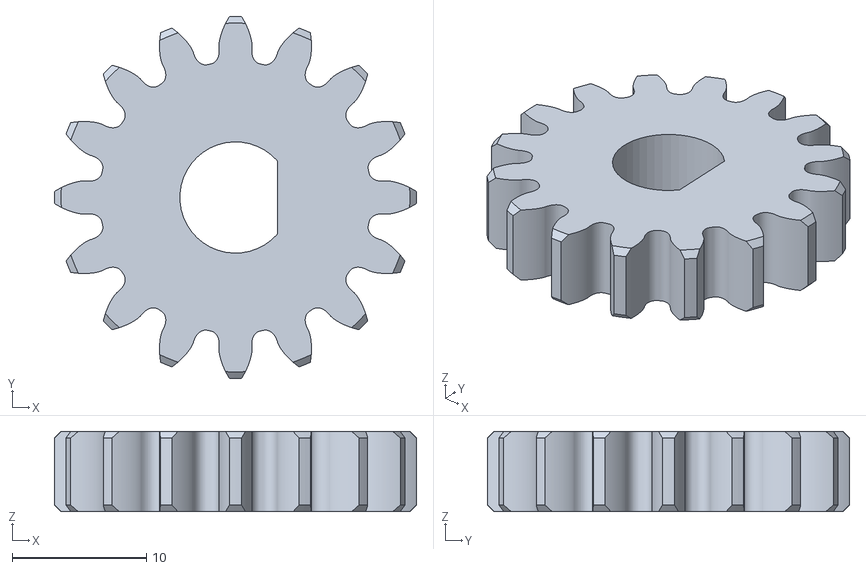
[picture p328: CAD file, 2026-11-06]
base/out/base/pack/stl/reel_gt3.stl
27.0 x 27.0 x 6.00
