HarryHYu/GrappStar/base/pack/coupons/risk_plate_2_PPA-CF.3mf

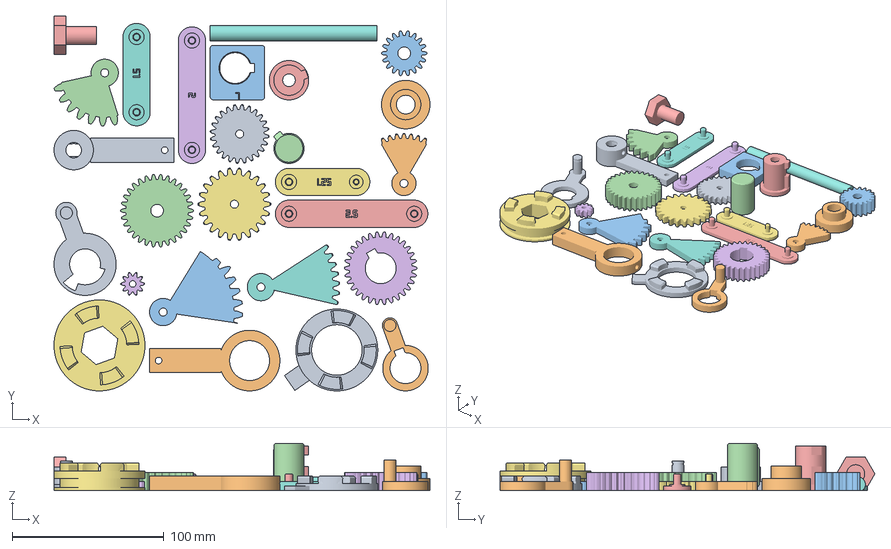
[picture p329: CAD file, 2026-11-03]
base/pack/coupons/risk_plate_2_PPA-CF.3mf
248.0 x 247.2 x 31.0 mm
rc1_arm
rc1_crank
rc1_idler
rc1_output
rc1_sleeve
rc1_sun
rc3_collar
rc3_rail
rc3_reel_face
rc7_bushing
rc7_key_bore
rc7_key_stub
rc7_spigot
rc8_m125_pinion
rc8_m125_plate
rc8_m15_plate
rc8_m15_z24
rc8_m15_z42
rc8_m25_big
rc8_m25_drive
rc8_m25_plate
rc8_m2_plate
rc8_m2_z22
rc8_m2_z50
rc9_hub_lever
rc9_outer_lever
