HarryHYu/GrappStar/kedge/gs/out/rubber_foot_L.stl

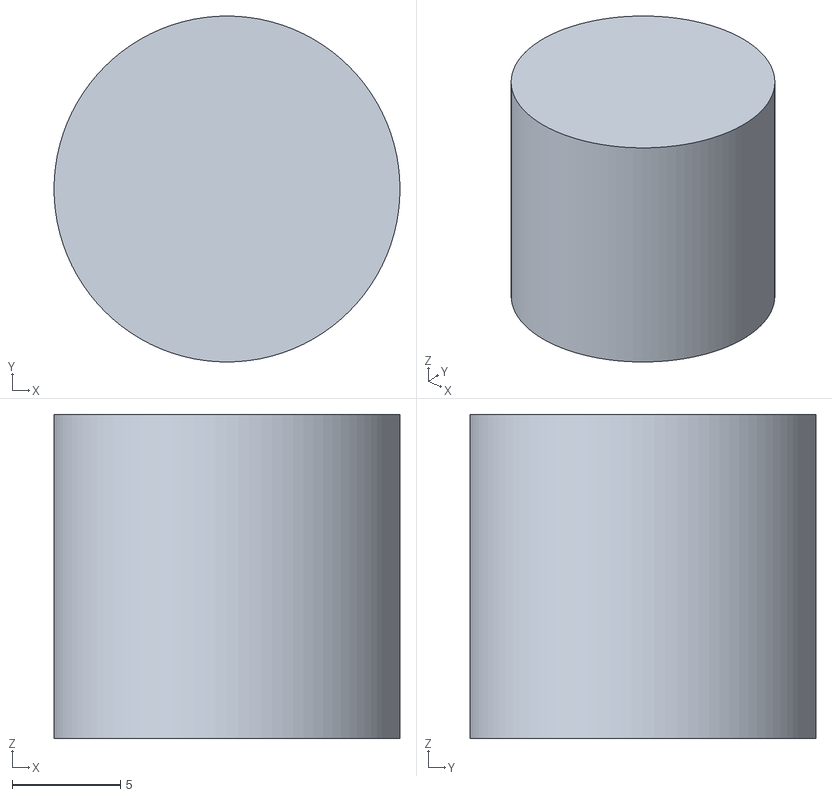
[picture p330: CAD file, 2026-11-02]
kedge/gs/out/rubber_foot_L.stl
16.0 x 16.0 x 15.0
