HarryHYu/GrappStar/kedge/out34/pod_cap_R.step

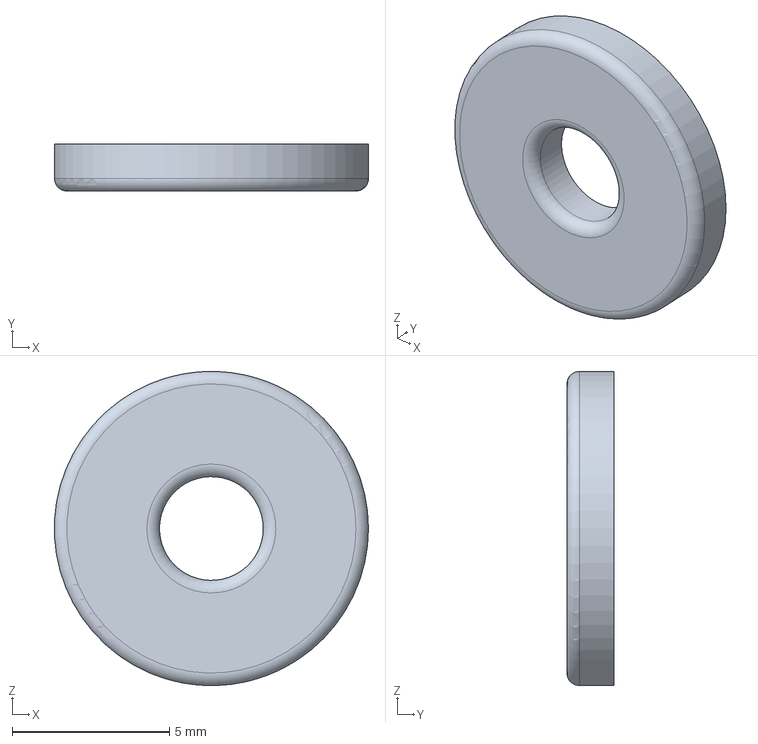
[picture p331: CAD file, 2026-11-09]
kedge/out34/pod_cap_R.step
9.99 x 1.50 x 10.00 mm
