HarryHYu/GrappStar/kedge/out35/cell_2.stl

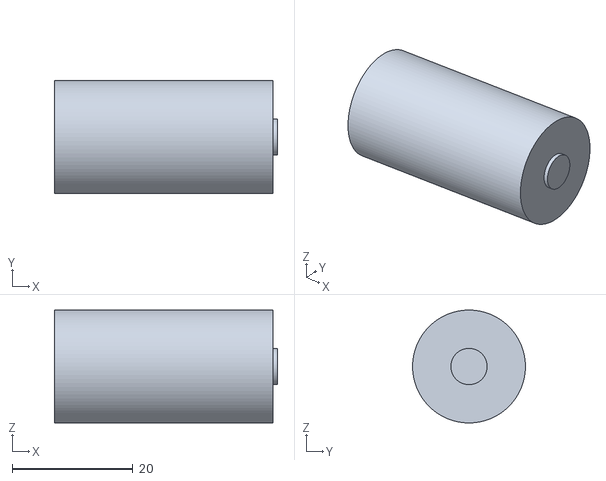
[picture p332: CAD file, 2026-11-11]
kedge/out35/cell_2.stl
36.9 x 18.7 x 18.7
