HarryHYu/GrappStar/kedge/pack_gs/plates/plate_04_PLA.3mf

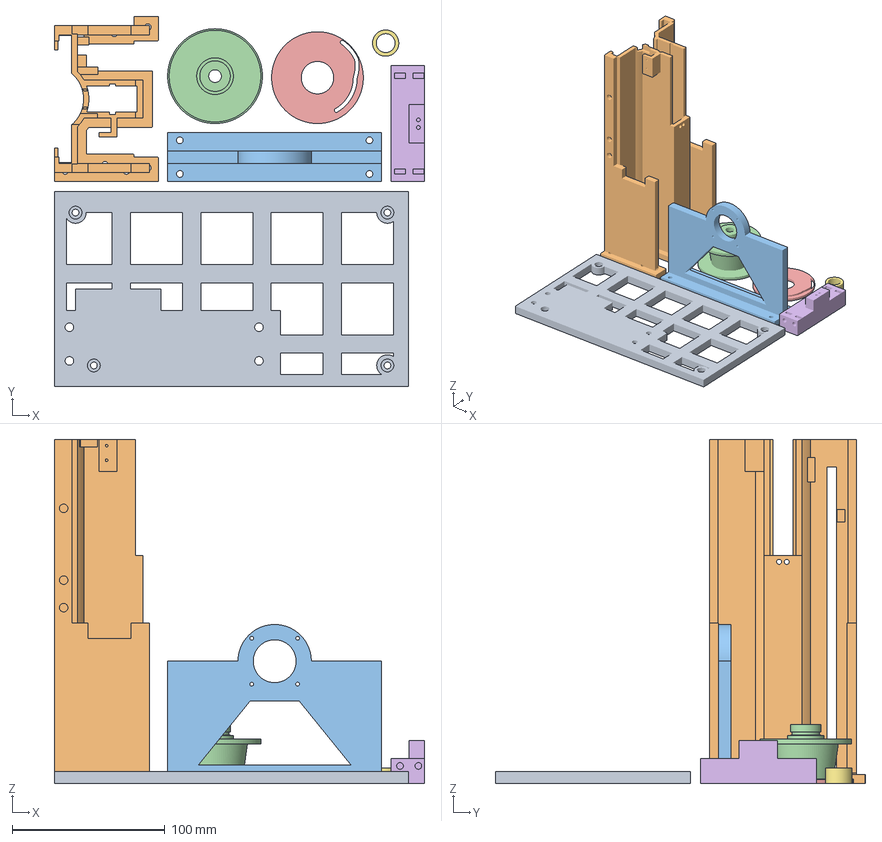
[picture p333: CAD file, 2026-11-02]
kedge/pack_gs/plates/plate_04_PLA.3mf
242.0 x 242.0 x 225.0 mm
base_2.stl
rail_beam_B.stl
frame_plate_L.stl
spool.stl
drag_disc.stl
cheek_tie.stl
shaft_spacer_L.stl
