HarryHYu/GrappStar/kedge/pack_gs/step/shaft_spacer_R.step

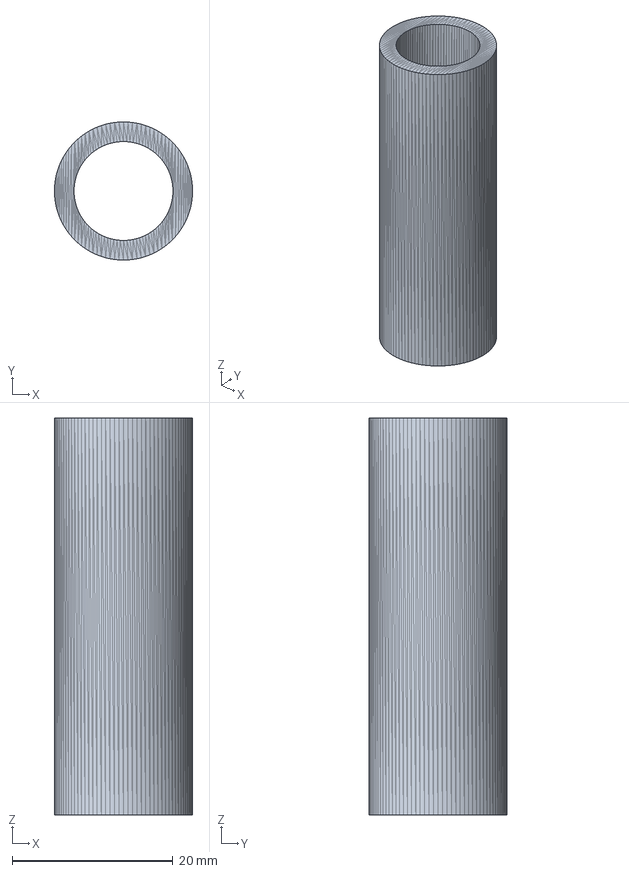
[picture p334: CAD file, 2026-11-02]
kedge/pack_gs/step/shaft_spacer_R.step
17.2 x 17.2 x 49.4 mm
