HarryHYu/GrappStar/kedge/pack_proto/bit_T16_LH.stl

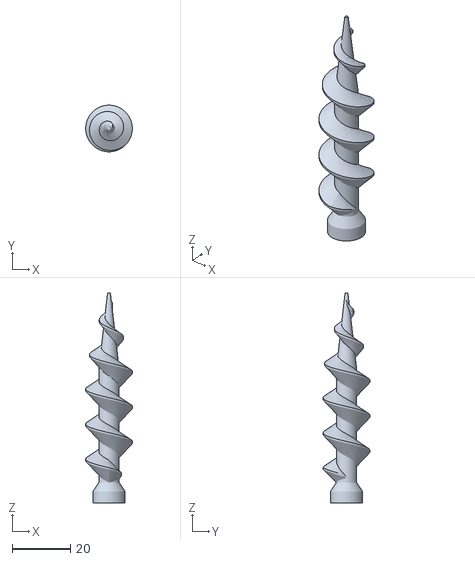
[picture p335: CAD file, 2026-11-07]
kedge/pack_proto/bit_T16_LH.stl
16.0 x 16.0 x 72.0
