HarryHYu/GrappStar/kedge/work/launcher10/10_conrod.stl

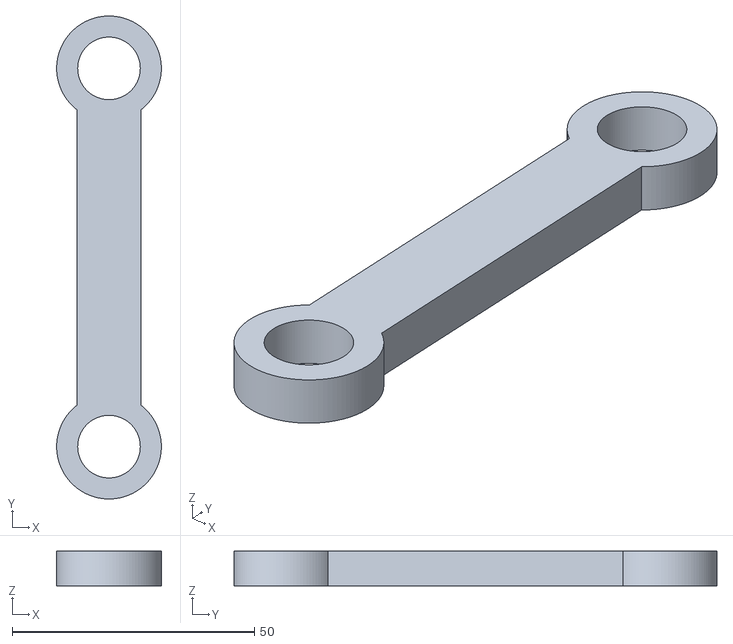
[picture p336: CAD file, 2026-11-02]
kedge/work/launcher10/10_conrod.stl
21.6 x 99.6 x 7.20
