HarryHYu/GrappStar/kedge/work/reel7/cap.stl

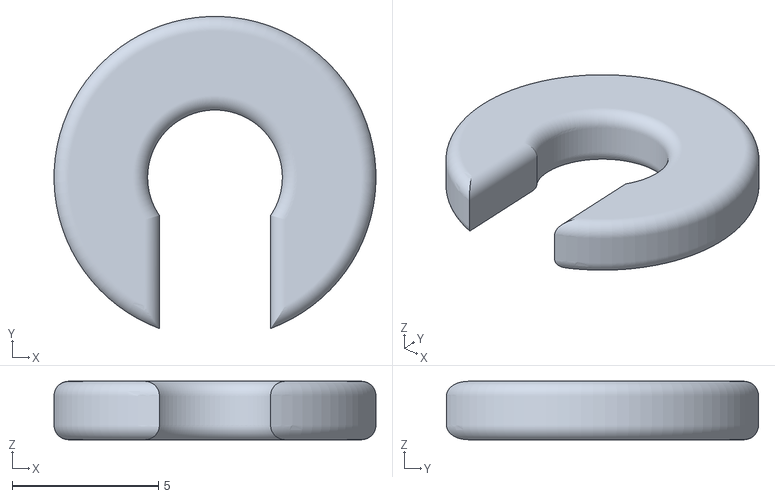
[picture p337: CAD file, 2026-11-02]
kedge/work/reel7/cap.stl
11.0 x 10.7 x 2.00
