HarryHYu/GrappStar/originals/grappstar_desk_v9_stl/03_axle_head.stl

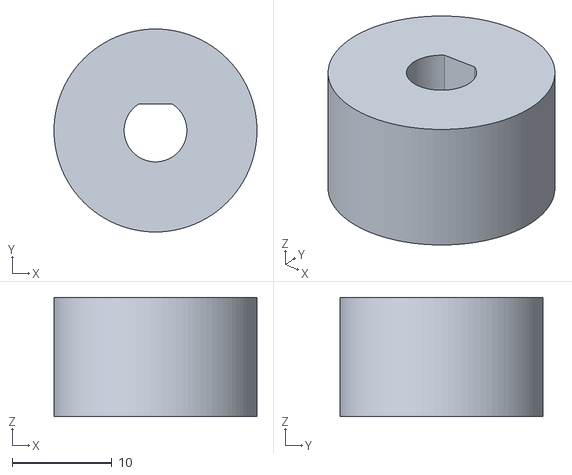
[picture p338: CAD file, 2026-11-02]
originals/grappstar_desk_v9_stl/03_axle_head.stl
20.4 x 20.4 x 12.0
