HarryHYu/GrappStar/originals/grappstar_mini_reel_v9/axle_spool.stl

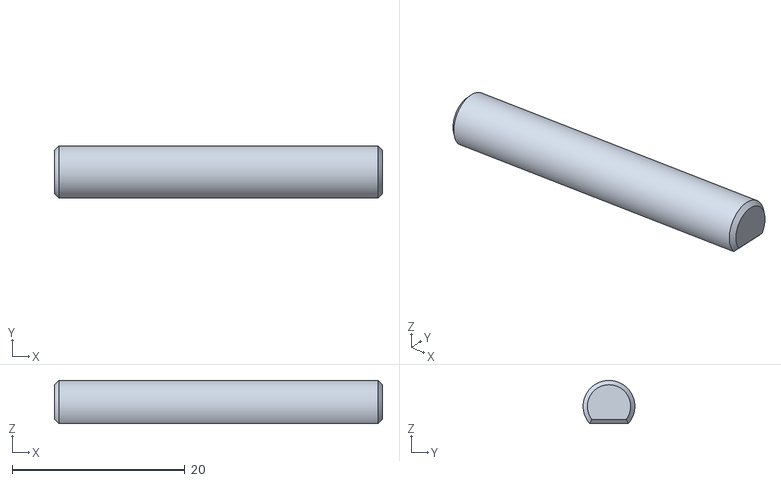
[picture p339: CAD file, 2026-11-02]
originals/grappstar_mini_reel_v9/axle_spool.stl
38.0 x 6.00 x 5.00
