HarryHYu/GrappStar/base/out/base/pack/plates/plate_8_PLA.3mf

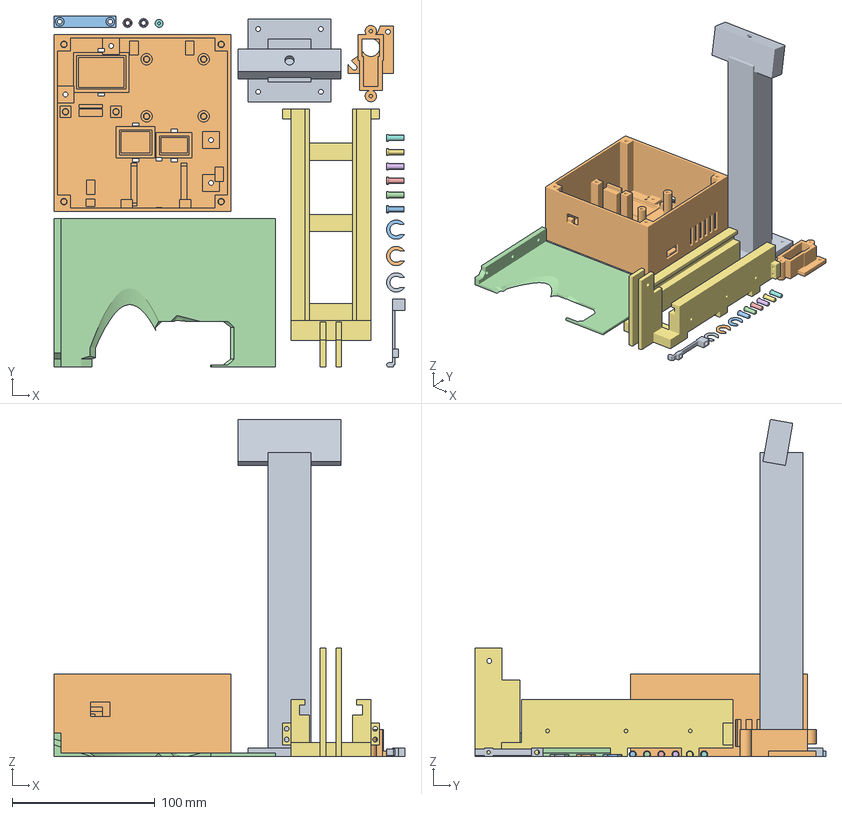
[picture p340: CAD file, 2026-11-06]
base/out/base/pack/plates/plate_8_PLA.3mf
245.9 x 246.0 x 236.4 mm
drum_index_lever
drum_n20_cradle
drum_shear_pin__c1
drum_shear_pin__c2
drum_shear_pin__c3
drum_shear_pin__c4
drum_shear_pin__c5
drum_shear_pin__c6
frame_camera_mount
frame_ebay
frame_ebay_esp_clamp
frame_guard_front
launch_muzzle_washer_l
launch_muzzle_washer_r
launch_rail_rear
launch_seat_clip
reel_k_clip
reel_k_clip2
reel_kc_clip
