HarryHYu/GrappStar/base/out/base/pack/stl/reel_hub.stl

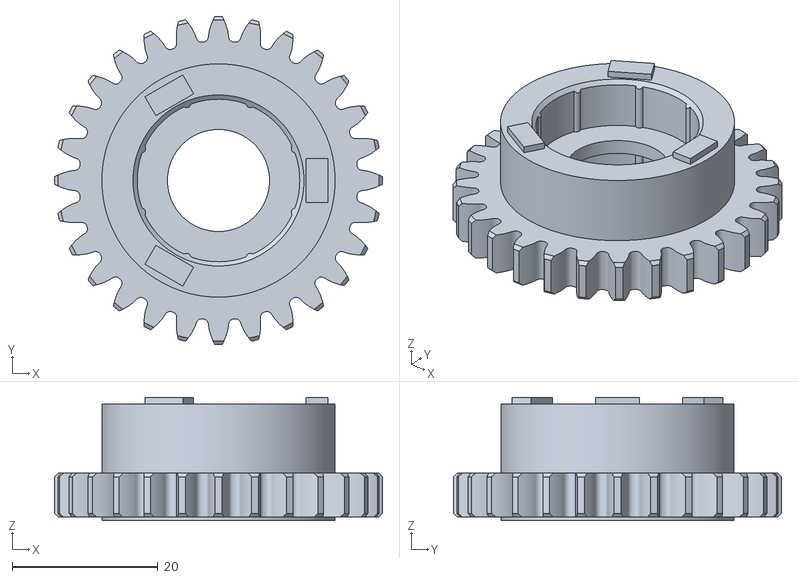
[picture p341: CAD file, 2026-11-06]
base/out/base/pack/stl/reel_hub.stl
45.0 x 45.0 x 16.9
