HarryHYu/GrappStar/base/pack/coupons/rc7_spigot.stl

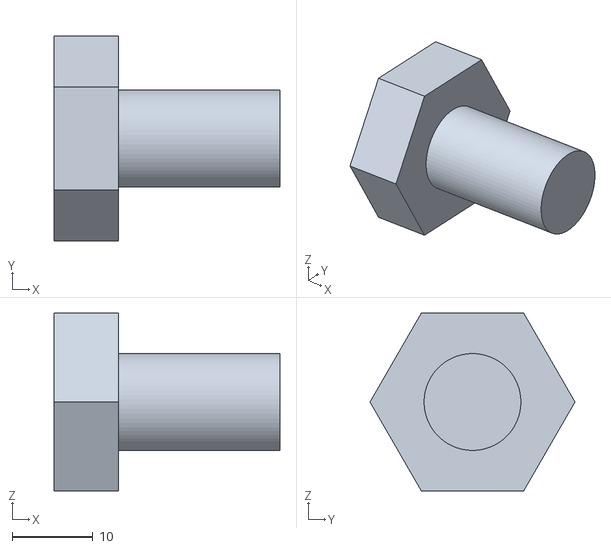
[picture p342: CAD file, 2026-11-03]
base/pack/coupons/rc7_spigot.stl
28.0 x 25.4 x 22.0
