HarryHYu/GrappStar/kedge/out31/deploy_shaft.stl

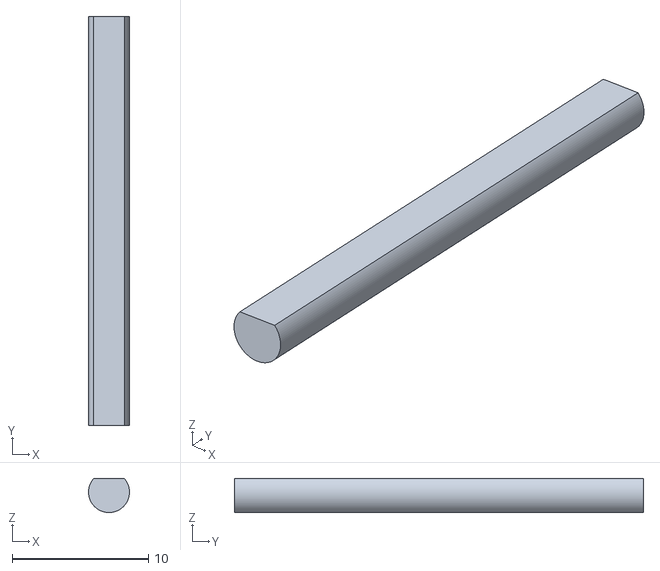
[picture p344: CAD file, 2026-11-07]
kedge/out31/deploy_shaft.stl
3.00 x 30.0 x 2.50
