HarryHYu/GrappStar/kedge/pack_gs/plates/plate_08_PPA-CF.3mf

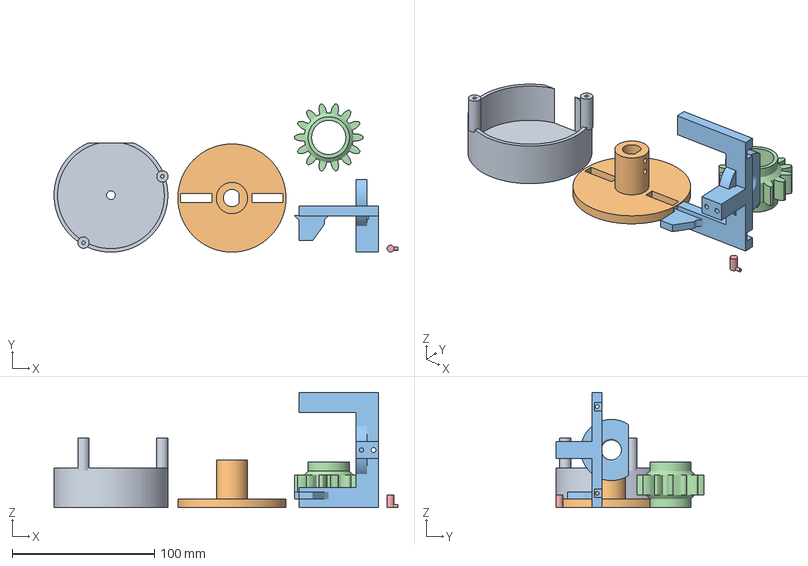
[picture p345: CAD file, 2026-11-02]
kedge/pack_gs/plates/plate_08_PPA-CF.3mf
241.6 x 104.2 x 81.0 mm
reel_cover.stl
wiper_coupler.stl
sled.stl
drive_pinion.stl
pickup_pin.stl
