HarryHYu/GrappStar/kedge/pack_gs/step/cheek_L.step

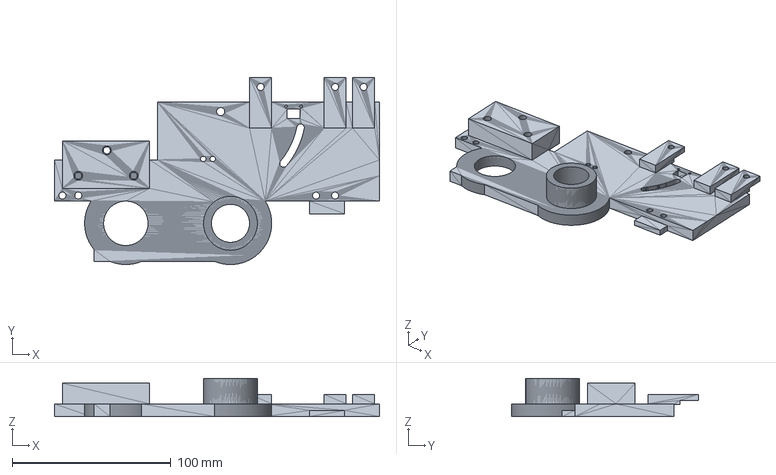
[picture p346: CAD file, 2026-11-02]
kedge/pack_gs/step/cheek_L.step
205.0 x 118.0 x 24.0 mm
