HarryHYu/GrappStar/kedge/work/launcher10/14_crank_pin.stl

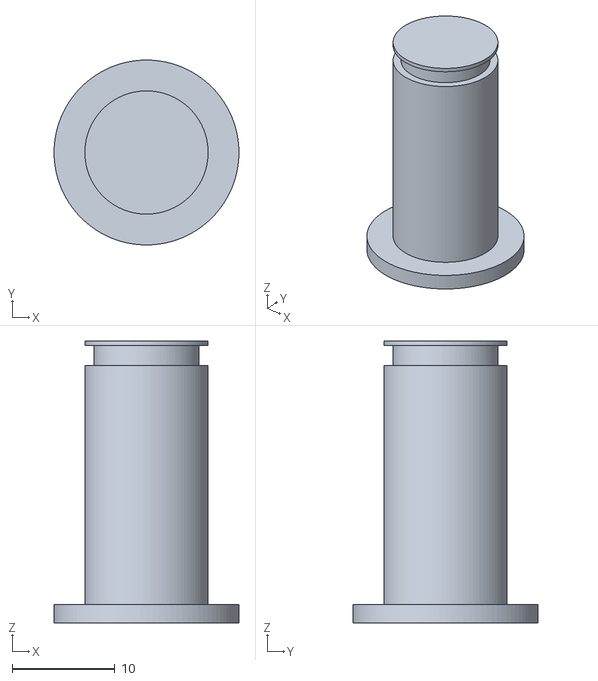
[picture p347: CAD file, 2026-11-02]
kedge/work/launcher10/14_crank_pin.stl
18.0 x 18.0 x 27.5
