HarryHYu/GrappStar/kedge/work/reel7/wrap_cup.stl

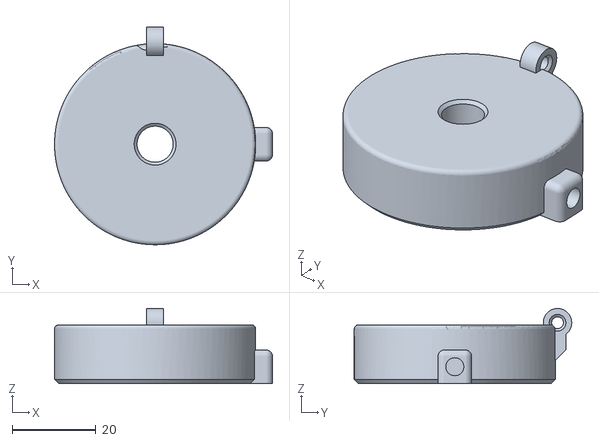
[picture p348: CAD file, 2026-11-02]
kedge/work/reel7/wrap_cup.stl
52.0 x 51.9 x 17.9
