HarryHYu/GrappStar/originals/grappstar_desk_v9_stl/07_frame.stl

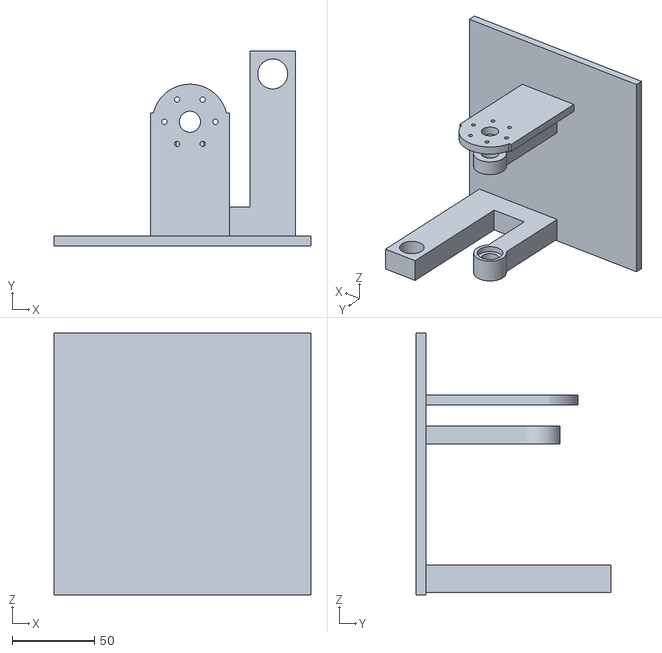
[picture p349: CAD file, 2026-11-02]
originals/grappstar_desk_v9_stl/07_frame.stl
156.0 x 118.1 x 159.0
