HarryHYu/GrappStar/originals/grappstar_mini_reel_v9/cap.stl

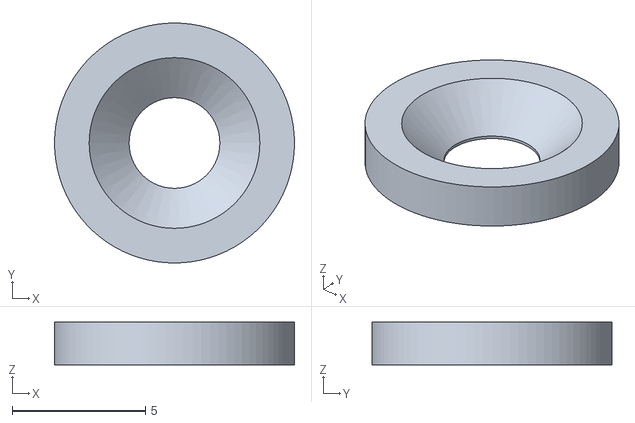
[picture p350: CAD file, 2026-11-02]
originals/grappstar_mini_reel_v9/cap.stl
9.00 x 9.00 x 1.60
