HarryHYu/GrappStar/base/out/base/pack/plates/plate_21_PPA-CF.3mf

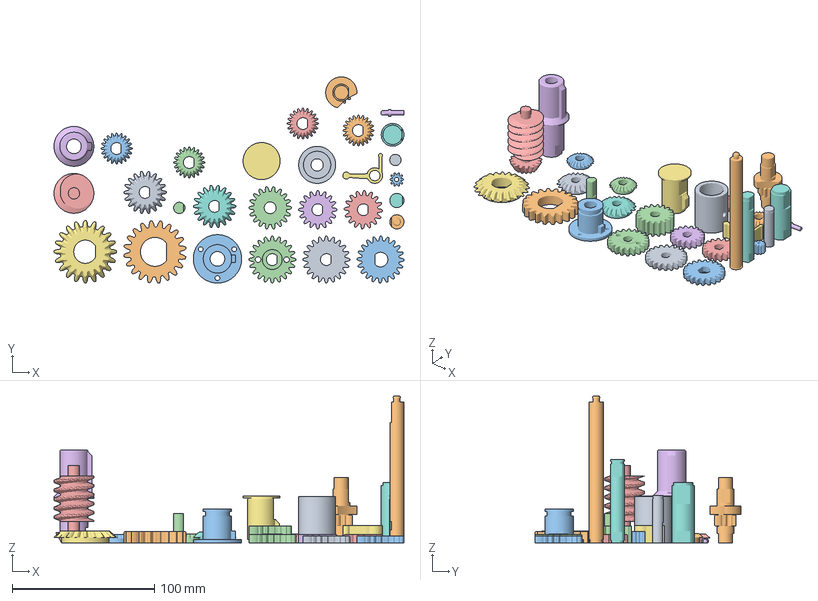
[picture p351: CAD file, 2026-11-06]
base/out/base/pack/plates/plate_21_PPA-CF.3mf
245.8 x 144.8 x 103.2 mm
drum_coupler_hub
drum_idler
drum_n20_pinion
launch_aim_idler
launch_aim_worm
launch_seat_pushrod
reel_bc
reel_bk2
reel_bkx
reel_bt2
reel_bt3
reel_bt3x
reel_btx
reel_c
reel_crank
reel_cs
reel_ga2
reel_gc2
reel_gkc
reel_gr
reel_gs
reel_gt3
reel_icr_axle
reel_k
reel_k2
reel_kc
reel_sleeve
reel_t3
