HarryHYu/GrappStar/base/out/base/pack/stl/reel_ikr.stl

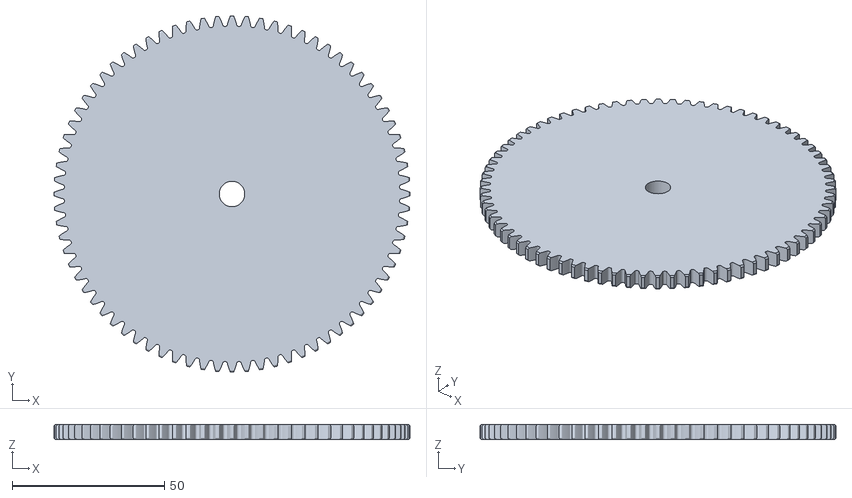
[picture p352: CAD file, 2026-11-06]
base/out/base/pack/stl/reel_ikr.stl
117.0 x 117.0 x 5.00
