HarryHYu/GrappStar/base/pack/coupons/rc9_hub_lever.stl

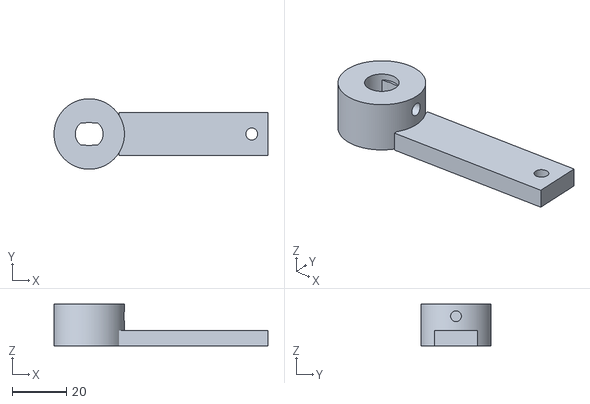
[picture p353: CAD file, 2026-11-03]
base/pack/coupons/rc9_hub_lever.stl
79.0 x 26.0 x 15.5
