HarryHYu/GrappStar/base/pack/fit_coupon/coupon_a1_608_rib.stl

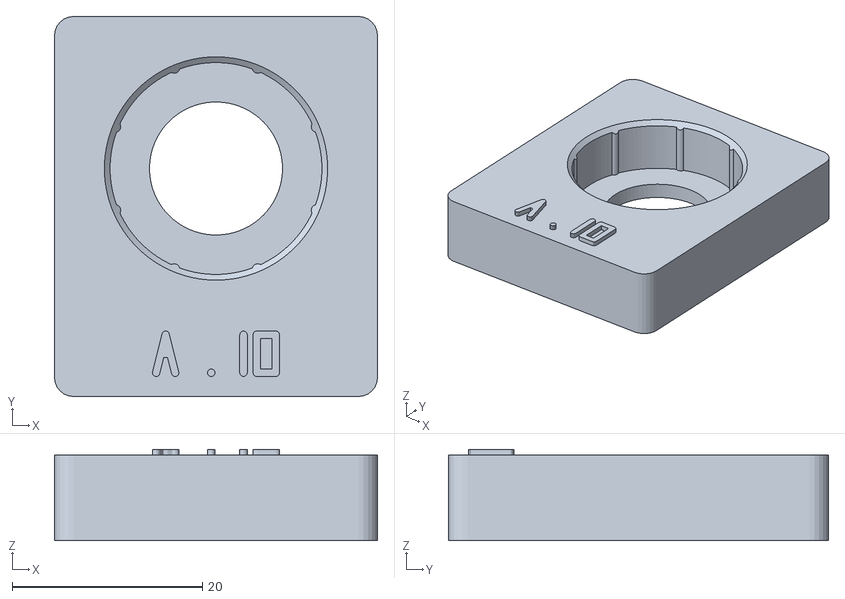
[picture p354: CAD file, 2026-11-03]
base/pack/fit_coupon/coupon_a1_608_rib.stl
34.0 x 40.0 x 9.60
