HarryHYu/GrappStar/kedge/gs/out/wiper_coupler.stl

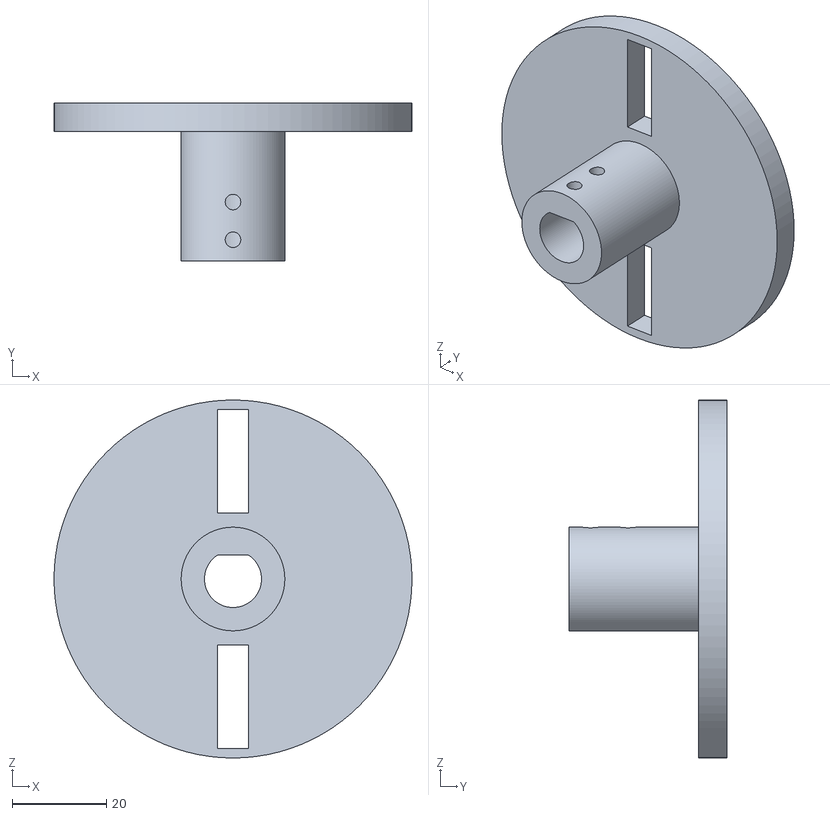
[picture p355: CAD file, 2026-11-02]
kedge/gs/out/wiper_coupler.stl
76.0 x 33.5 x 76.0
