HarryHYu/GrappStar/kedge/pack_gs/plates/plate_01_PLA.3mf

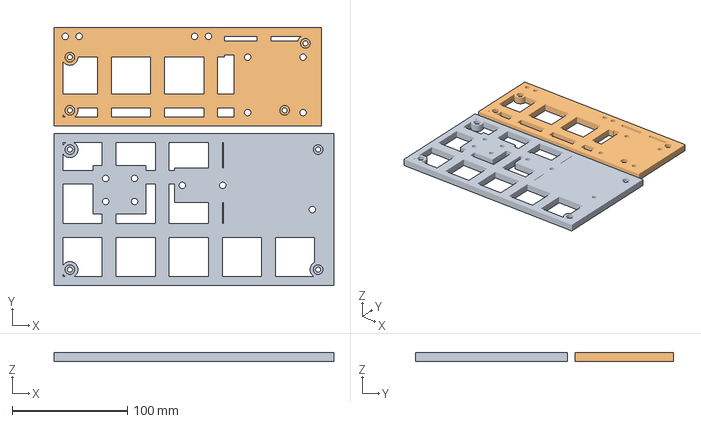
[picture p356: CAD file, 2026-11-02]
kedge/pack_gs/plates/plate_01_PLA.3mf
242.5 x 223.5 x 8.00 mm
base_3.stl
base_5.stl
