HarryHYu/GrappStar/kedge/pack_gs/step/base_2.step

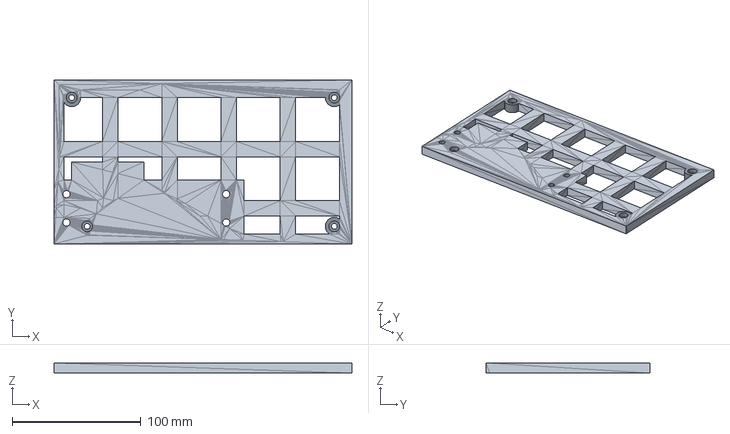
[picture p357: CAD file, 2026-11-02]
kedge/pack_gs/step/base_2.step
231.5 x 127.5 x 8.00 mm
