HarryHYu/GrappStar/kedge/work/launcher10/04_carriage.stl

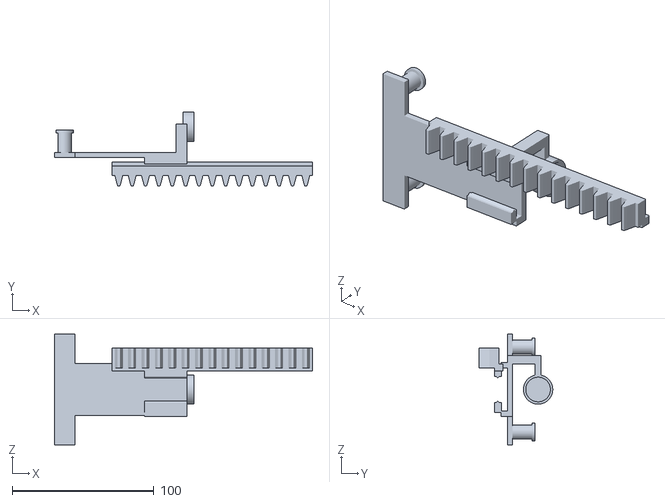
[picture p358: CAD file, 2026-11-02]
kedge/work/launcher10/04_carriage.stl
182.0 x 51.9 x 78.0
