HarryHYu/GrappStar/kedge/work/reel7/lock_pin.stl

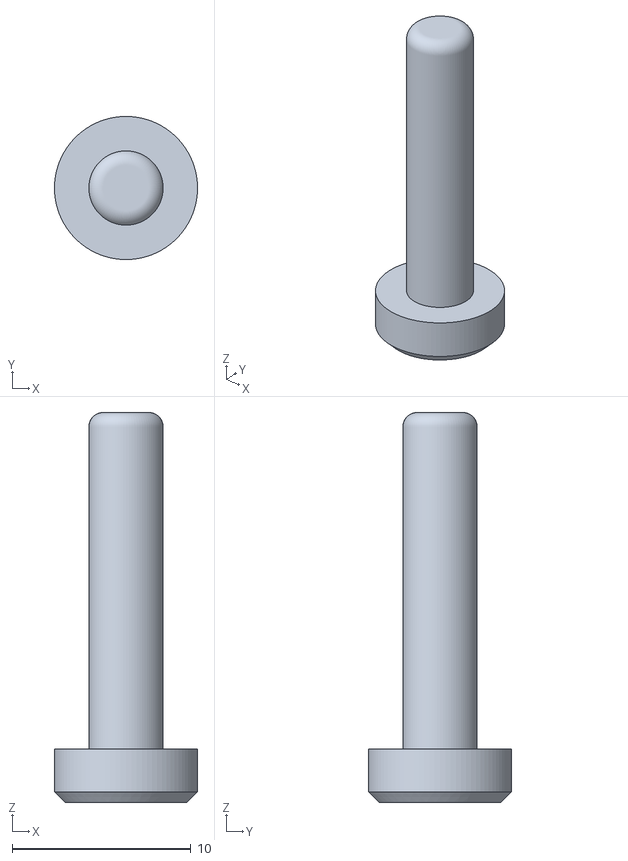
[picture p359: CAD file, 2026-11-02]
kedge/work/reel7/lock_pin.stl
8.00 x 8.00 x 21.8
