HarryHYu/GrappStar/(list of files, cad)

Other CAD files:
kedge/pack_v35/KEDGE_v35_assembly_folded.step
kedge/pack_gs/step/reel_main_gear.step
originals/GrappStarv0.3mf
kedge/out34/drill_leg_L_auger.step
kedge/pack_gs/step/pulley_L.step
kedge/dist_v35/KEDGE_v35/step/drill_leg_L.step
kedge/dist_v35/KEDGE_v35_all_STL/PPA-CF/leg_coupler_R.stl
kedge/dist_v35/KEDGE_v35/step/leg_plug_L.step
kedge/dist_v35/KEDGE_v35_all_STL/PPA-CF/fit_coupon_pegs.stl
kedge/out34/hull_top.step
originals/grappstar_desk_v9_stl/15_bearing_C.stl
base/pack/fit_coupon/coupon_b3_key_bore.stl
kedge/dist_v35/KEDGE_v35/step/leg_plug_R.step
kedge/dist_v35/KEDGE_v35_all_STL/PLA/drill_leg_R.stl
kedge/dist_v35/KEDGE_v35_all_STL/PPA-CF/coupler_R.stl
kedge/dist_v35/KEDGE_v35/step/leg_coupler_R.step
kedge/dist_v35/KEDGE_v35_all_STL/PLA/nose.stl
kedge/gs/out/shaft_spacer_M.stl
kedge/out34/leg_plug_R.step
kedge/out35/drv8833_2.stl
kedge/pack_proto/bit_T16_RH.stl
kedge/dist_v35/KEDGE_v35/step/leg_coupler_L.step
kedge/dist_v35/KEDGE_v35_all_STL/PLA/drill_leg_L.stl
kedge/out34/coupler_R.step
kedge/out35/drill_leg_L.stl
originals/grappstar_desk_v9_stl/14_bearing_B.stl
originals/grappstar_mini_reel_v9/reel_bracket.stl
base/out/base/pack/plates/plate_10_PLA.3mf
base/out/base/pack/plates/plate_12_PLA.3mf
base/out/base/pack/plates/plate_13_PLA.3mf
base/out/base/pack/plates/plate_14_PLA.3mf
base/out/base/pack/plates/plate_15_PLA.3mf
base/out/base/pack/plates/plate_17_PPA-CF.3mf
base/out/base/pack/plates/plate_18_PPA-CF.3mf
base/out/base/pack/plates/plate_1_PLA.3mf
base/out/base/pack/plates/plate_20_PPA-CF.3mf
base/out/base/pack/plates/plate_2_PLA.3mf
base/out/base/pack/plates/plate_5_PLA.3mf
base/out/base/pack/plates/plate_6_PLA.3mf
base/out/base/pack/plates/plate_7_PLA.3mf
base/out/base/pack/plates/plate_9_PLA.3mf
base/out/base/pack/stl/drum_axle.stl
base/out/base/pack/stl/drum_bracket_a.stl
base/out/base/pack/stl/drum_bracket_b.stl
base/out/base/pack/stl/drum_bracket_idler.stl
base/out/base/pack/stl/drum_bracket_idler2.stl
base/out/base/pack/stl/drum_collar.stl
base/out/base/pack/stl/drum_coupler.stl
base/out/base/pack/stl/drum_coupler_hub.stl
base/out/base/pack/stl/drum_dog_post.stl
base/out/base/pack/stl/drum_dogring_launch.stl
base/out/base/pack/stl/drum_drum_a.stl
base/out/base/pack/stl/drum_drum_b.stl
base/out/base/pack/stl/drum_fork.stl
base/out/base/pack/stl/drum_gear_reel.stl
base/out/base/pack/stl/drum_hand_lever.stl
base/out/base/pack/stl/drum_idler.stl
base/out/base/pack/stl/drum_idler_gear.stl
base/out/base/pack/stl/drum_index_block.stl
base/out/base/pack/stl/drum_index_lever.stl
base/out/base/pack/stl/drum_magnet_cap.stl
base/out/base/pack/stl/drum_n20_cradle.stl
base/out/base/pack/stl/drum_n20_pinion.stl
base/out/base/pack/stl/drum_n20_strap.stl
base/out/base/pack/stl/drum_rail.stl
base/out/base/pack/stl/drum_reel_washer.stl
base/out/base/pack/stl/drum_shaft.stl
base/out/base/pack/stl/drum_shear_pin.stl
base/out/base/pack/stl/drum_sw_lever_0.stl
base/out/base/pack/stl/drum_sw_lever_1.stl
base/out/base/pack/stl/drum_sw_lever_2.stl
base/out/base/pack/stl/drum_switch_block.stl
base/out/base/pack/stl/frame_cable_anchor_1.stl
base/out/base/pack/stl/frame_cable_anchor_2.stl
base/out/base/pack/stl/frame_camera_mount.stl
base/out/base/pack/stl/frame_can_stay.stl
base/out/base/pack/stl/frame_deck_1.stl
base/out/base/pack/stl/frame_deck_2.stl
base/out/base/pack/stl/frame_deck_3.stl
base/out/base/pack/stl/frame_deck_4.stl
base/out/base/pack/stl/frame_deck_ext.stl
base/out/base/pack/stl/frame_ebay.stl
base/out/base/pack/stl/frame_ebay_esp_clamp.stl
base/out/base/pack/stl/frame_ebay_lid.stl
base/out/base/pack/stl/frame_guard_front.stl
base/out/base/pack/stl/frame_guard_hood.stl
base/out/base/pack/stl/frame_motor_adapter.stl
base/out/base/pack/stl/frame_motor_leg.stl
base/out/base/pack/stl/frame_rc832_holder.stl
base/out/base/pack/stl/launch_aim_arm.stl
base/out/base/pack/stl/launch_aim_bevel30.stl
base/out/base/pack/stl/launch_aim_cap.stl
base/out/base/pack/stl/launch_aim_conrod.stl
base/out/base/pack/stl/launch_aim_crank.stl
base/out/base/pack/stl/launch_aim_crankpin_clip.stl
base/out/base/pack/stl/launch_aim_drag_pad.stl
base/out/base/pack/stl/launch_aim_drag_shim.stl
base/out/base/pack/stl/launch_aim_housing.stl
base/out/base/pack/stl/launch_aim_idler.stl
base/out/base/pack/stl/launch_aim_idler_clip.stl
base/out/base/pack/stl/launch_aim_lug.stl
base/out/base/pack/stl/launch_aim_lugpin_clip.stl
base/out/base/pack/stl/launch_aim_output.stl
base/out/base/pack/stl/launch_aim_sun.stl
base/out/base/pack/stl/launch_aim_worm.stl
base/out/base/pack/stl/launch_big_gear.stl
base/out/base/pack/stl/launch_carriage.stl
base/out/base/pack/stl/launch_carriage_yoke.stl
base/out/base/pack/stl/launch_drive_gear.stl
base/out/base/pack/stl/launch_drive_washer.stl
base/out/base/pack/stl/launch_gear_clip.stl
base/out/base/pack/stl/launch_gear_pin.stl
base/out/base/pack/stl/launch_gear_washer.stl
base/out/base/pack/stl/launch_guard_l_a.stl
base/out/base/pack/stl/launch_guard_l_b1.stl
base/out/base/pack/stl/launch_guard_l_b2.stl
base/out/base/pack/stl/launch_guard_l_c.stl
base/out/base/pack/stl/launch_guard_r_a.stl
base/out/base/pack/stl/launch_guard_r_b1.stl
base/out/base/pack/stl/launch_guard_r_b2.stl
base/out/base/pack/stl/launch_guard_r_c.stl
base/out/base/pack/stl/launch_muzzle_roller.stl
base/out/base/pack/stl/launch_muzzle_washer_l.stl
base/out/base/pack/stl/launch_muzzle_washer_r.stl
base/out/base/pack/stl/launch_pulley_top.stl
base/out/base/pack/stl/launch_pulley_top_washer_l.stl
base/out/base/pack/stl/launch_pulley_top_washer_r.stl
base/out/base/pack/stl/launch_rail_front.stl
base/out/base/pack/stl/launch_rail_mid.stl
base/out/base/pack/stl/launch_rail_rear.stl
base/out/base/pack/stl/launch_rail_splice_l.stl
base/out/base/pack/stl/launch_rail_splice_r.stl
base/out/base/pack/stl/launch_seat_clip.stl
base/out/base/pack/stl/launch_seat_plunger.stl
base/out/base/pack/stl/launch_seat_pushrod.stl
base/out/base/pack/stl/launch_sleeve.stl
base/out/base/pack/stl/launch_stop_frame_l.stl
base/out/base/pack/stl/launch_stop_frame_r.stl
base/out/base/pack/stl/launch_stop_spring_l.stl
base/out/base/pack/stl/launch_stop_spring_r.stl
base/out/base/pack/stl/launch_sw_home.stl
base/out/base/pack/stl/launch_sw_seated.stl
base/out/base/pack/stl/launch_yoke_peg_l.stl
base/out/base/pack/stl/launch_yoke_peg_r.stl
base/out/base/pack/stl/reel_bar.stl
base/out/base/pack/stl/reel_bar_cap_1.stl
base/out/base/pack/stl/reel_bar_cap_2.stl
base/out/base/pack/stl/reel_bc.stl
base/out/base/pack/stl/reel_bcx.stl
base/out/base/pack/stl/reel_bk2.stl
base/out/base/pack/stl/reel_bkx.stl
base/out/base/pack/stl/reel_bt2.stl
base/out/base/pack/stl/reel_bt3x.stl
base/out/base/pack/stl/reel_btx.stl
base/out/base/pack/stl/reel_bus.stl
base/out/base/pack/stl/reel_c.stl
base/out/base/pack/stl/reel_cheek_i.stl
base/out/base/pack/stl/reel_cheek_o.stl
base/out/base/pack/stl/reel_crank.stl
base/out/base/pack/stl/reel_crank_washer.stl
base/out/base/pack/stl/reel_cs.stl
base/out/base/pack/stl/reel_cs_clip.stl
base/out/base/pack/stl/reel_cup.stl
base/out/base/pack/stl/reel_cup_clip.stl
base/out/base/pack/stl/reel_drum.stl
base/out/base/pack/stl/reel_ga.stl
base/out/base/pack/stl/reel_gc.stl
base/out/base/pack/stl/reel_gc2.stl
base/out/base/pack/stl/reel_gi.stl
base/out/base/pack/stl/reel_gk.stl
base/out/base/pack/stl/reel_gk1.stl
base/out/base/pack/stl/reel_gk2.stl
base/out/base/pack/stl/reel_gkc.stl
base/out/base/pack/stl/reel_gr.stl
base/out/base/pack/stl/reel_gs.stl
base/out/base/pack/stl/reel_gt2.stl
base/out/base/pack/stl/reel_hub_flange.stl
base/out/base/pack/stl/reel_ic.stl
base/out/base/pack/stl/reel_ic_axle.stl
base/out/base/pack/stl/reel_icr.stl
base/out/base/pack/stl/reel_icr_axle.stl
base/out/base/pack/stl/reel_ik1.stl
base/out/base/pack/stl/reel_ik1_axle.stl
base/out/base/pack/stl/reel_ik2.stl
base/out/base/pack/stl/reel_ik2_axle.stl
base/out/base/pack/stl/reel_ikr_axle.stl
base/out/base/pack/stl/reel_k.stl
base/out/base/pack/stl/reel_k2.stl
base/out/base/pack/stl/reel_k_clip2.stl
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
