HarryHYu/GrappStar/firmware/base/WIRING.md

# Base station wiring

Board: ESP32-S3 DevKitC-1-N8. Pins come from `grappstar_base/pins.h` (firmware `base-1.3.1`). Nothing here has been
wired and tested on real hardware yet: check every step with the multimeter.

**The rule: battery unplugged whenever a wire or plug moves. Plug the battery in last, after the checks. Never pull a
plug while the battery is in.** The one exception: lead #2's XT60 is the physical motor kill switch and may be pulled
at any time (the build guide's motors-safe state).

## 1. Pin table

| GPIO | Name in pins.h | Connects to | Note |
|---|---|---|---|
| 4 | `PIN_RPWM` | BTS7960 RPWM | wiper FORWARD (dir 1), PWM 20 kHz |
| 5 | `PIN_LPWM` | BTS7960 LPWM | wiper BACKWARD (dir -1), PWM 20 kHz |
| 6 | `PIN_REN` | BTS7960 R_EN | plus 10 k from R_EN to GND |
| 7 | `PIN_LEN` | BTS7960 L_EN | plus 10 k from L_EN to GND |
| 1 | `PIN_WIPER_IS` | BTS7960 R_IS + L_IS through 1 k | plus 680 R and a 1 uF capacitor from GPIO1 to GND (the IS divider and filter) |
| 2 | `PIN_VBAT` | battery divider middle | 100 k from 3S + (at the BTS7960 B+ screw) to GPIO2, 22 k from GPIO2 to GND |
| 8 | `PIN_SDA` | AS5600 SDA | STEMMA QT blue wire |
| 9 | `PIN_SCL` | AS5600 SCL | STEMMA QT yellow wire |
| 15 | `PIN_DRUM_IN1` | DRV8833 AIN1 | drum N20 |
| 16 | `PIN_DRUM_IN2` | DRV8833 AIN2 | drum N20 |
| 10 | `PIN_SW_A` | contact `SW_DRUM_A` | drum code bit A |
| 11 | `PIN_SW_B` | contact `SW_DRUM_B` | drum code bit B |
| 12 | `PIN_SW_C` | contact `SW_DRUM_C` | drum code bit C |
| 13 | `PIN_SW_D` | contact `SW_DOG_L` | collar engaged in LAUNCH |
| 14 | `PIN_SW_E` | contact `SW_DOG_R` | collar engaged in REEL |
| 47 | `PIN_SW_F` | contact `SW_N20` | drum N20 in mesh (open = N20 swung out of mesh for the hand lever) |
| 21 | `PIN_SW_G` | contact `SW_HOME` | carriage on its front stop (uncocked) |
| 39 | `PIN_SW_H` | contact `SW_GAP` | big gear in its toothless gap (rest) |
| 40 | `PIN_SW_I` | contact `SW_RAIL_LOW` | rail at its lowest pitch (aim home) |
| 41 | `PIN_SW_J` | contact `SW_SEATED` | dart tail on the pusher |
| 42 | `PIN_SW_K` | contact `SW_ARM` | closed while the wrap cup is away, OPENS for about +-5 deg at home (one cup turn counted per opening) |
| 35 | `PIN_SW_L` | contact `SW_INDEX` | only on a build without the AS5600 magnet (decision D12). Leave open otherwise |
| 17 | `PIN_HX_DT` | HX711 DT (DOUT) | optional load cell |
| 18 | `PIN_HX_SCK` | HX711 SCK | optional load cell |
| 3V3 | | AS5600 VIN, BTS7960 VCC, HX711 VCC | logic supply |
| GND | | common ground (see section 3) | |

The DRV8833 SLP pin is **not wired** to any GPIO (decision D9: the Pololu board pulls it high by itself). Its FLT pin
is not used either. GPIO21 is `SW_HOME`, not SLP.

Which contact goes on which pin comes from `swBit` in `config.h`. Default: the order above, `SW_DRUM_A` on `PIN_SW_A`
through `SW_ARM` on `PIN_SW_K`. `SW_INDEX` is switched off in `config.h` unless the build has no magnet.

Pins the firmware avoids on purpose: 0, 3, 45, 46 (boot strapping), 19 and 20 (the USB port), 26 to 32 (flash),
43 and 44 (UART), 38 and 48 (the RGB LED). `params.py` once suggested GPIO38 for `SW_HOME`; that is the RGB LED on
newer boards, so `SW_HOME` is on GPIO21 instead.

## 2. Resistors and fuses: what goes where

| Part | From | To | Why | If you do not have it |
|---|---|---|---|---|
| 10 k | BTS7960 R_EN | GND (BTS7960 header) | keeps the bridge off while the ESP32 resets or is flashed | any value from 4.7 k to 47 k |
| 10 k | BTS7960 L_EN | GND (BTS7960 header) | same | any value from 4.7 k to 47 k |
| 1 k | R_IS + L_IS (tied) | GPIO1 | series protection for the pin | any value from 1 k to 4.7 k |
| 680 R | GPIO1 | GND | turns the IS current into a voltage (sets `amps_per_volt` = 8500 / 680 = 12.5) | any value from 470 R to 1 k, then `set amps_per_volt` to 8500 / your value (1 k: 8.5) |
| 100 k | BTS7960 B+ screw (soldered right at the screw) | the long wire to GPIO2 | battery divider top: the long wire then carries only the divided voltage, never the full 12.6 V | leave the divider out (both resistors) and send `{"id":1,"cmd":"set","key":"vbat_wired","val":false}` after every start-up (it is not kept): no `vbat`, no battery checks, and no `NO_POWER` protection |
| 1 uF capacitor (strongly recommended) | GPIO1 (at the ESP32 end of the IS wire) | GND | smooths the IS pulses. The sketch already averages 16 reads spread across the 20 kHz PWM period, so the reading is right without it; the capacitor is belt and braces against noise and timing slips | 1 uF to 2.2 uF, ceramic best (an electrolytic: striped leg to GND). Without one the firmware still works; fit it when you can |
| 22 k | GPIO2 | GND | battery divider bottom (12.6 V reads 2.27 V) | as above: the firmware assumes exactly 100 k / 22 k, so do not swap in other values |
| 2 A inline fuse | BTS7960 B+ screw | MP1584 IN+ | a short in the buck or the DRV8833 blows this, not the thin wires | no small fuse: use 18 AWG wire for that lead and keep it short (under 10 cm) |
| 20 A fuse | battery + (XT60 lead #2) | BTS7960 B+ | main fuse | none: never run without it |

There is NO resistor on the DRV8833 SLP pin (it is not wired at all). The 1 uF capacitor from GPIO1 to GND is strongly
recommended (above). Optional: 100 nF from GPIO2 to GND (steadies `vbat`).

## 3. Power

```
3S LiPo + --> 20 A fuse (XT60 lead #2) --> BTS7960 B+ screw --+--> 2 A fuse --> MP1584 #2 IN+   (buck, set to 9.0 V first)
                                                              +--> 100 k (at the screw) --> long wire --> GPIO2 --> 22 k --> GND
3S LiPo - -----------------------------------------------> BTS7960 B- --> MP1584 #2 IN-

MP1584 #2 OUT+ (9.0 V) --> DRV8833 VM (Pololu labels it VIN)
MP1584 #2 OUT-         --> DRV8833 GND

BTS7960 M+ / M-  --> wiper motor red / black (never the green park switch wire)
DRV8833 AOUT1 / AOUT2 --> drum N20 motor
ESP32 power: USB from the Jetson (from the Mac on the bench)
```

- **Wiper:** 3S LiPo, then the 20 A fuse, then BTS7960 B+ and B-. Use thick wire (14 AWG) on B+, B-, M+ and M-.
  Never wire the wiper's green park switch wire.
- **Drum N20:** through MP1584 #2 set to **9.0 V**. The DRV8833 VM maximum is 10.8 V and a full 3S is 12.6 V, so
  **never connect the 3S straight to the DRV8833.** Set the buck to 9.0 V BEFORE its output touches the DRV8833
  (Part A below). Take the buck input from the BTS7960 B+ and B- screws, so it sits behind the main fuse.
- **Which buck:** the dart uses ONE MP1584. MP1584 #2 is the spare from the dart build (MEASURE_LIST C4). It may still
  be set to some other voltage from earlier: Part A re-sets it to 9.0 V.
- **2 A fuse:** in the buck IN+ lead, right at the B+ screw.
- **ESP32:** powered over USB from the Jetson (on the bench: from the Mac). Never connect the battery to the ESP32
  5V or 3V3 pins.
- **Common ground:** ESP32 GND, BTS7960 GND (logic header), DRV8833 GND and MP1584 OUT- must all be joined. Without a
  common ground the control signals mean nothing.
- **Battery divider:** 100 k soldered right at the BTS7960 B+ screw, then the long wire to GPIO2, 22 k from GPIO2 to
  GND. 12.6 V reads 2.27 V on the pin. It feeds `vbat` in telemetry and the battery checks (`NO_POWER` under 6 V,
  `BROWNOUT` under 9.9 V while a motor runs). With the battery unplugged `vbat` reads about 0. If you leave the divider
  out, send `{"id":1,"cmd":"set","key":"vbat_wired","val":false}` (then `vbat` is `null` and there is no battery
  check). It goes back to true at every start-up, so send it again after each power-up; without it every motor command
  is refused with `NO_POWER`.

## 4. BTS7960 details

- **10 k pull-downs on R_EN and L_EN.** While the ESP32 resets or is being flashed its pins float, and a floating
  enable pin can let the motor twitch. With 10 k to GND the BTS7960 stays off until the firmware drives R_EN and L_EN
  high. Solder each resistor between the EN pin and a GND pin on the BTS7960 header.
- **VCC** to ESP32 3V3, **GND** to ESP32 GND.
- **IS divider:** tie R_IS and L_IS together. From there a 1 k resistor to GPIO1. From GPIO1 a 680 R resistor to GND.
  The BTS7960 IS pin gives a small current: motor amps divided by 8500. At 20 A that is 2.35 mA, and 2.35 mA through
  the 680 R gives about 1.6 V at GPIO1, well under 3.3 V. So `amps_per_volt` = 8500 / 680 = 12.5 (the default).
- **1 uF capacitor from GPIO1 to GND: strongly recommended.** Solder it at the ESP32 end of the IS wire, right at
  GPIO1 and a GND pin. The IS pin only reports while the high side conducts (a 20 kHz pulse train); the sketch takes
  16 reads 53 us apart that step through the PWM period, so their average is right even without the capacitor. The
  capacitor is belt and braces: it also smooths noise and covers a late read.
- **Check for an onboard IS resistor first.** With everything unpowered, tie R_IS and L_IS together and put the meter
  (ohms) between that point and GND. Open (no reading) means no onboard resistor: the default scale 12.5 is right.
  If it reads a resistance Rb, write it down. The scale changes:

  `Rx = 1680 in parallel with Rb`, then `amps_per_volt = 8500 x 1680 / (Rx x 680)`.

  No onboard resistor gives 12.5. Two onboard 1 k gives about 54.5. Set it with
  `{"id":1,"cmd":"set","key":"amps_per_volt","val":54.5}` (your number), then calibrate it (CALIBRATION.md).

## 5. DRV8833 details

- VM (Pololu: VIN) from the buck OUT+ at 9.0 V. GND to the buck OUT- and to the ESP32 GND.
- AIN1 to GPIO15, AIN2 to GPIO16, AOUT1 and AOUT2 to the drum N20. Only channel A is used. Leave BIN1, BIN2, BOUT1,
  BOUT2 open.
- **SLP: leave it unconnected** (decision D9). The board pulls it high itself, so the driver is always awake. No GPIO
  and no resistor on it.
- FLT: leave it unconnected.
- **If the drum does nothing: battery unplugged, wire DRV8833 SLP to the ESP32 3V3 pin (never to VM).**
- Never put 3V3 on a pad that is the motor supply. Meter check (unpowered): if a pad beeps to VM, it is the motor supply.
- If the drum turns the wrong way, swap the two N20 wires at AOUT1 and AOUT2 (battery unplugged). CALIBRATION.md
  section (c) says how to tell.

## 6. Contact switches

Each printed contact is an M3 screw head touching an M3 nut.

- One side of each contact to its GPIO, the other side to GND.
- The ESP32 uses its internal pull-up. Closed = LOW = shown as closed in telemetry.
- No resistors needed. All the GND sides may share one GND wire.

| Contact | Pin | GPIO | Telemetry `sw` key |
|---|---|---|---|
| `SW_DRUM_A` | `PIN_SW_A` | 10 | `a` |
| `SW_DRUM_B` | `PIN_SW_B` | 11 | `b` |
| `SW_DRUM_C` | `PIN_SW_C` | 12 | `c` |
| `SW_DOG_L` | `PIN_SW_D` | 13 | `l` |
| `SW_DOG_R` | `PIN_SW_E` | 14 | `r` |
| `SW_N20` | `PIN_SW_F` | 47 | `n` |
| `SW_HOME` | `PIN_SW_G` | 21 | `H` |
| `SW_GAP` | `PIN_SW_H` | 39 | `G` |
| `SW_RAIL_LOW` | `PIN_SW_I` | 40 | `L` |
| `SW_SEATED` | `PIN_SW_J` | 41 | `S` |
| `SW_ARM` | `PIN_SW_K` | 42 | `W` |
| `SW_INDEX` | `PIN_SW_L` | 35 | `I` (only shows when switched on in `config.h`) |

The three drum code contacts read the drum position as a code (BENCH_TEST.md step 2 has the table). All three open
(code 000) never happens on a working drum: the firmware treats it as a wire off and faults (`DRUM_SENSOR`).

On the bench, before the drum is built, use two jumper wires:

- GPIO11 to GND: code "b only" = NEUTRAL.
- GPIO47 to GND: `SW_N20` closed. Without it the firmware thinks the N20 is swung out of mesh (hand mode) and refuses every drum
  move (`HAND_MODE`).

## 7. AS5600 and HX711

- **AS5600** (Adafruit STEMMA QT): use a STEMMA QT cable. Red to 3V3, black to GND, blue (SDA) to GPIO8, yellow (SCL)
  to GPIO9. DIR pad to GND (fixed count direction). Plug and unplug the cable only with the battery unplugged.
- **Magnet:** the Adafruit board comes without one. Any small neodymium disc mounted edge-on (decision D12), or a
  6 x 2.5 mm diametric disc, in the magnet cap on the main shaft end, **1 to 2 mm from the chip, centred** on it.
- **HX711** (optional): VCC to 3V3, GND to GND, DT to GPIO17, SCK to GPIO18. Load cell wires to E+, E-, A+, A- as
  printed on the HX711 board. The firmware finds it at boot (`"hx711":true` in the `HELLO` line).

## 8. Build order, step by step

You need: multimeter, the 20 A fuse lead (XT60 lead #2), MP1584 #2, a 2 A inline fuse for the buck, 2 x 10 k, 1 k,
680 R, 100 k, 22 k, a 1 uF to 2.2 uF capacitor (strongly recommended), optionally a 100 nF capacitor (section 2 lists fallbacks), an insulated small
screwdriver for the buck.

### Part A: set the buck (on its own, before the build)

MP1584 #2 must be set to 9.0 V before it ever touches the DRV8833. This is done with the buck on its own: nothing else
is wired to it.

1. Battery unplugged. Solder input leads to MP1584 #2, long enough to reach the BTS7960 B+ and B- screws later: red
   to IN+, with the 2 A inline fuse at the far (B+ screw) end of the red lead; black to IN-. Nothing on the output.
2. Battery unplugged. Connect the input leads to the fused side of the XT60 lead (red to +, black to -). Check with
   the meter (beep mode) that IN+ and IN- are not shorted.
3. Battery unplugged. Clip the meter probes onto OUT+ and OUT- (meter on DC volts), so you do not have to hold them.
4. Battery unplugged. Hands and tools clear of the pads. Now plug the battery in. Turn the little screw on the buck
   with the insulated screwdriver until the meter reads **9.0 V**. Turn slowly: many turns may be needed. Keep the
   screwdriver and probes off the other pads. Then unplug the battery.
5. Battery unplugged. (If it is still in, unplug it now, before anything else.) Disconnect the buck input leads from
   the XT60 lead. Mark the buck "9.0 V".

### Part B: build

1. Battery unplugged. Solder the two 10 k pull-downs: R_EN to GND and L_EN to GND on the BTS7960 header.
2. Battery unplugged. Check the BTS7960 for an onboard IS resistor (section 4). Write the number down.
3. Battery unplugged. Wire the IS divider: R_IS and L_IS tied, 1 k to GPIO1, 680 R from GPIO1 to GND, and the 1 uF
   capacitor from GPIO1 to GND at the ESP32 end (strongly recommended).
4. Battery unplugged. BTS7960 logic: RPWM GPIO4, LPWM GPIO5, R_EN GPIO6, L_EN GPIO7, VCC 3V3, GND to ESP32 GND.
5. Battery unplugged. Battery divider: solder the 100 k right at the BTS7960 B+ screw, run the long wire from its
   other end to GPIO2, 22 k from GPIO2 to GND. Optional 100 nF from GPIO2 to GND.
6. Battery unplugged. AS5600: STEMMA QT cable to 3V3, GND, GPIO8 (SDA), GPIO9 (SCL). DIR to GND.
7. Battery unplugged. Contacts: one side to the GPIO from section 6, other side to GND. Contacts not built yet: put
   the two bench jumpers on (GPIO11 to GND, GPIO47 to GND, section 6).
8. Battery unplugged. HX711 if you have it: 3V3, GND, GPIO17 (DT), GPIO18 (SCK).
9. Battery unplugged. USB check with no power wiring yet: plug USB into the port labelled USB, open the Serial
   Monitor and do "First contact" in README.md. `status` must show `"magnet":"OK"`. Close each contact and watch
   telemetry `sw` (BENCH_TEST.md step 2). Unplug USB.
10. Battery unplugged. DRV8833: AIN1 GPIO15, AIN2 GPIO16, GND to ESP32 GND. SLP and FLT stay unconnected.
    AOUT1 and AOUT2 to the drum N20.
11. Battery unplugged. Check the buck on its own once more before it touches the DRV8833: connect only its input to
    the fused XT60 lead as in Part A (nothing on the output, meter on OUT+ / OUT-), plug the battery in, read 9.0 V
    with no load, unplug the battery and disconnect the input again. Only then, battery still unplugged: OUT+ to
    DRV8833 VM, OUT- to DRV8833 GND.
12. Battery unplugged. Buck input: the red lead's fuse end (the 2 A inline fuse) to the BTS7960 B+ screw, so the
    fuse sits right at the screw; its other end is already on the buck IN+ (If you have no 2 A fuse: 18 AWG, under
    10 cm). Black lead from IN- to BTS7960 B-.
13. Battery unplugged. Power: fused XT60 lead + to BTS7960 B+, - to B-. Use 14 AWG. The 20 A fuse in the + lead.
14. Battery unplugged. Wiper motor to M+ and M- (red to M+, black to M-). On the bench the motor is clamped and has
    nothing attached (BENCH_TEST.md).
15. Battery unplugged. Ground: check ESP32 GND, BTS7960 GND, DRV8833 GND and buck OUT- are all joined.

### Part C: checks with the multimeter (still unplugged)

16. Battery unplugged. Beep mode: **B+ to B- must NOT beep.** A very short chirp is fine (capacitors on the boards
    charging from the meter). A steady beep is a short: stop and find it.
17. Battery unplugged. Beep mode: buck OUT+ to OUT- must not beep. DRV8833 VM to GND must not beep.
18. Battery unplugged. Beep mode: ESP32 GND to BTS7960 GND, DRV8833 GND and buck OUT- must beep (common ground).
19. Battery unplugged. Beep mode: ESP32 3V3 to GND must not beep (a short chirp is fine). 3V3 must not beep to B+ or
    to DRV8833 VM. DRV8833 SLP must not beep to any GPIO.
20. Battery unplugged. Ohms: GPIO2 to GND about 22 k (a bit less is fine). R_EN to GND and L_EN to GND about 10 k.
21. Battery unplugged. Check every motor and power screw terminal is tight and no bare strand touches its neighbour.
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
