HarryHYu/GrappStar/base/out/base/shots/assembly_dark_phone.png

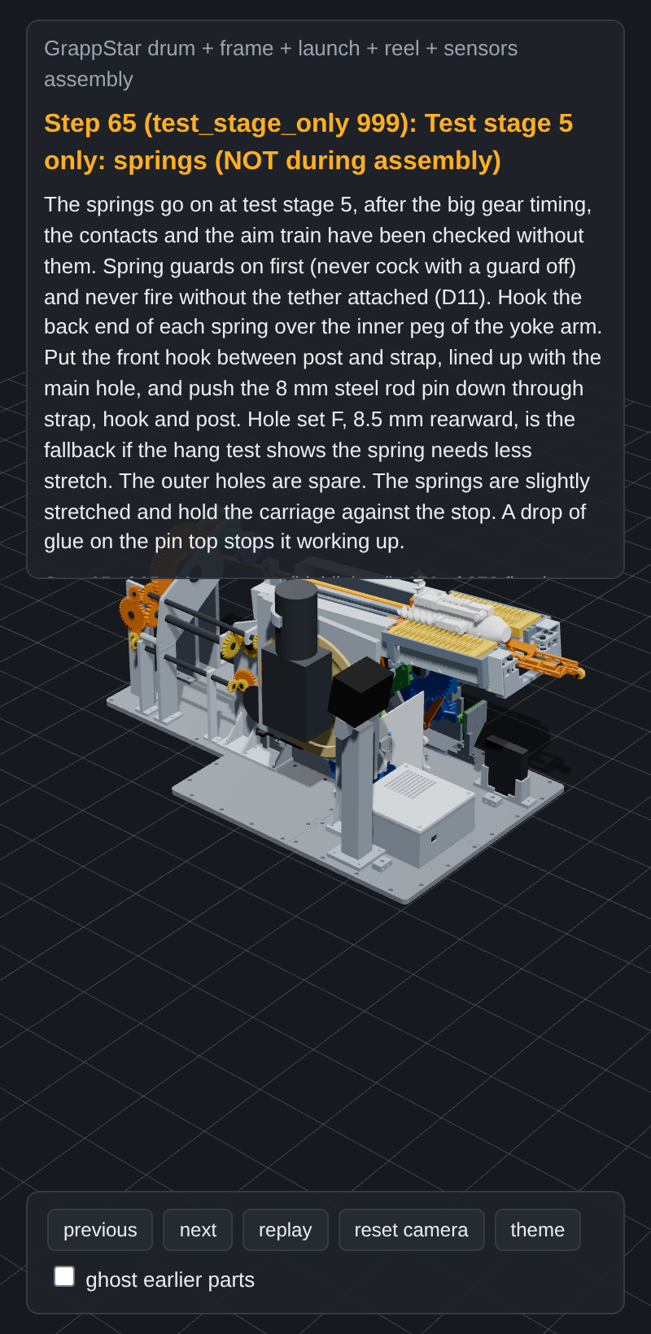
base/out/base/shots/assembly_dark_phone.png
