HarryHYu/GrappStar/base/out/base/shots/assembly_step01.png

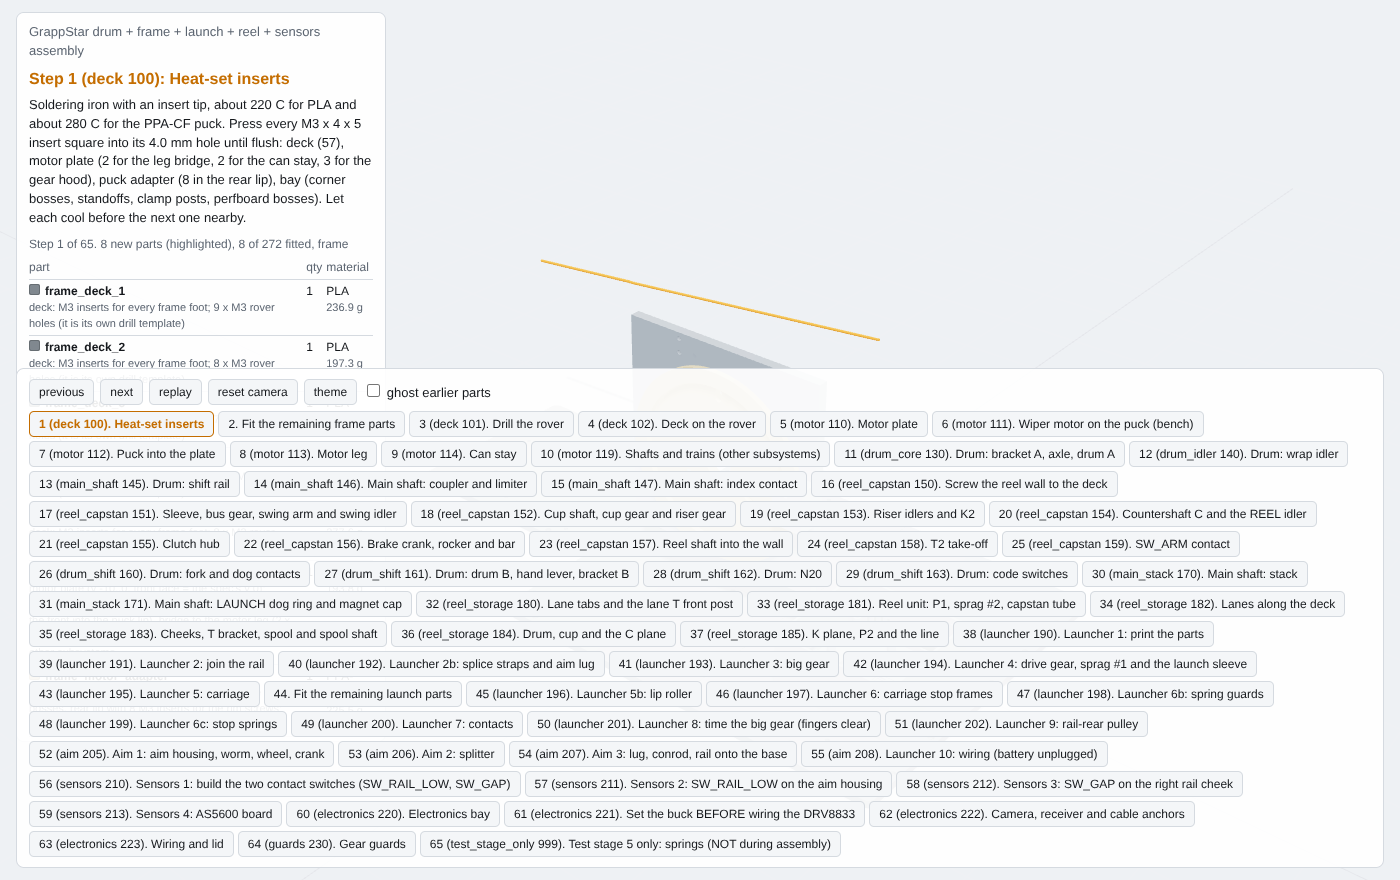
base/out/base/shots/assembly_step01.png
