HarryHYu/GrappStar/base/out/base/shots/assembly_step33.png

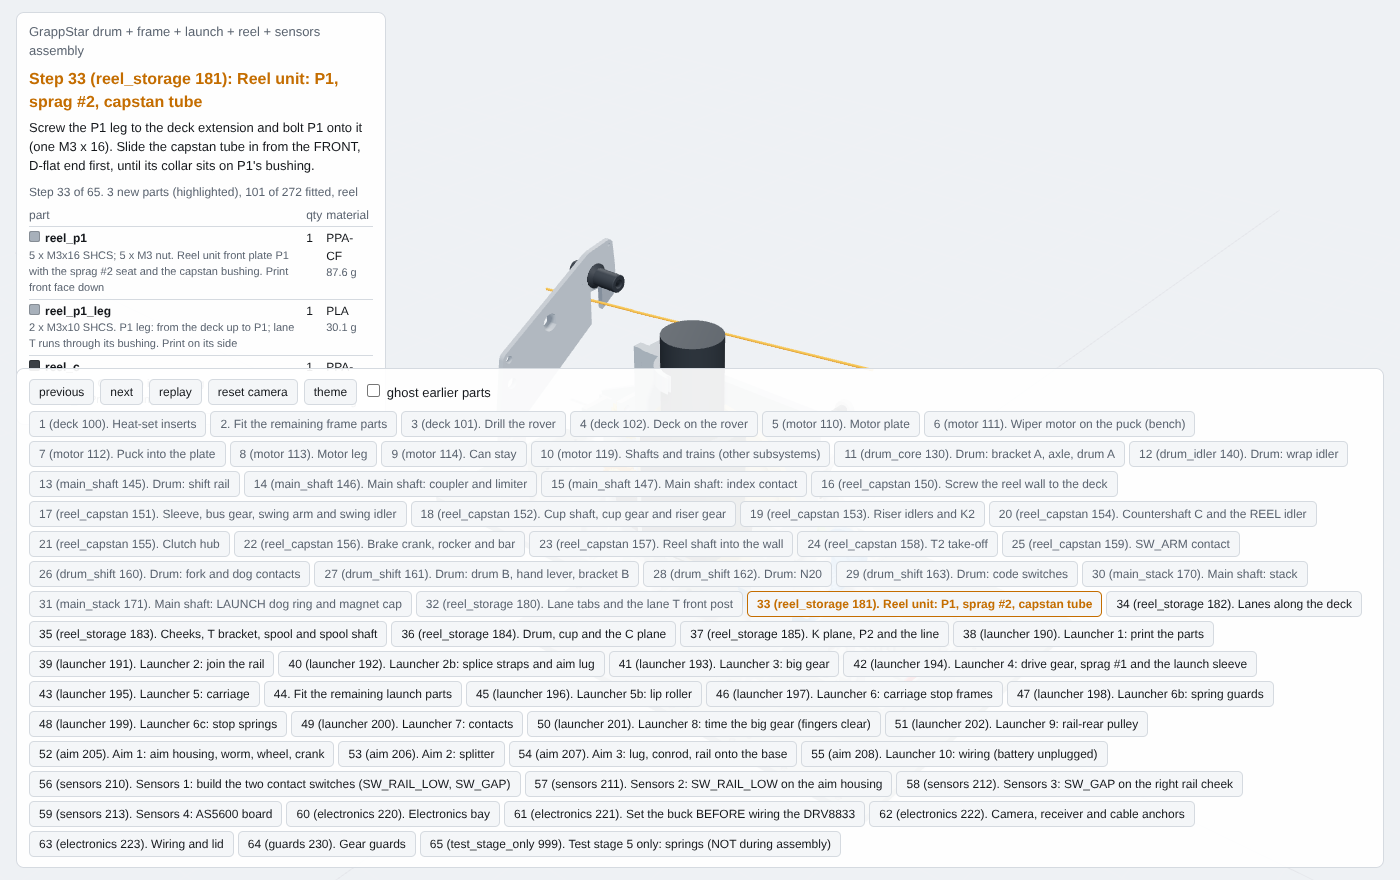
base/out/base/shots/assembly_step33.png
