HarryHYu/GrappStar/base/out/base/shots/assembly_step65.png

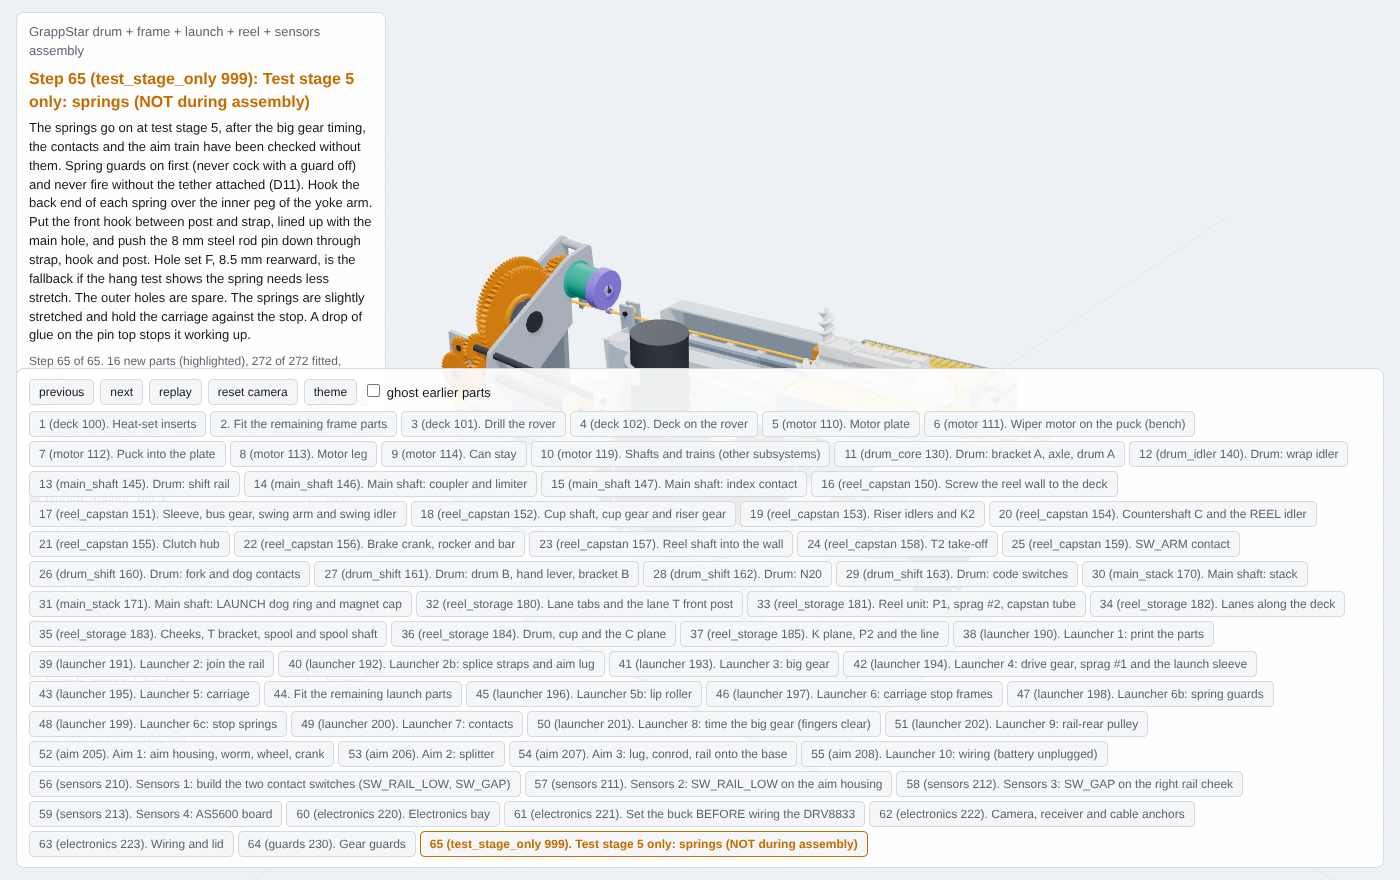
base/out/base/shots/assembly_step65.png
