HarryHYu/GrappStar/base/out/base/shots/assembly_step65_flyin.png

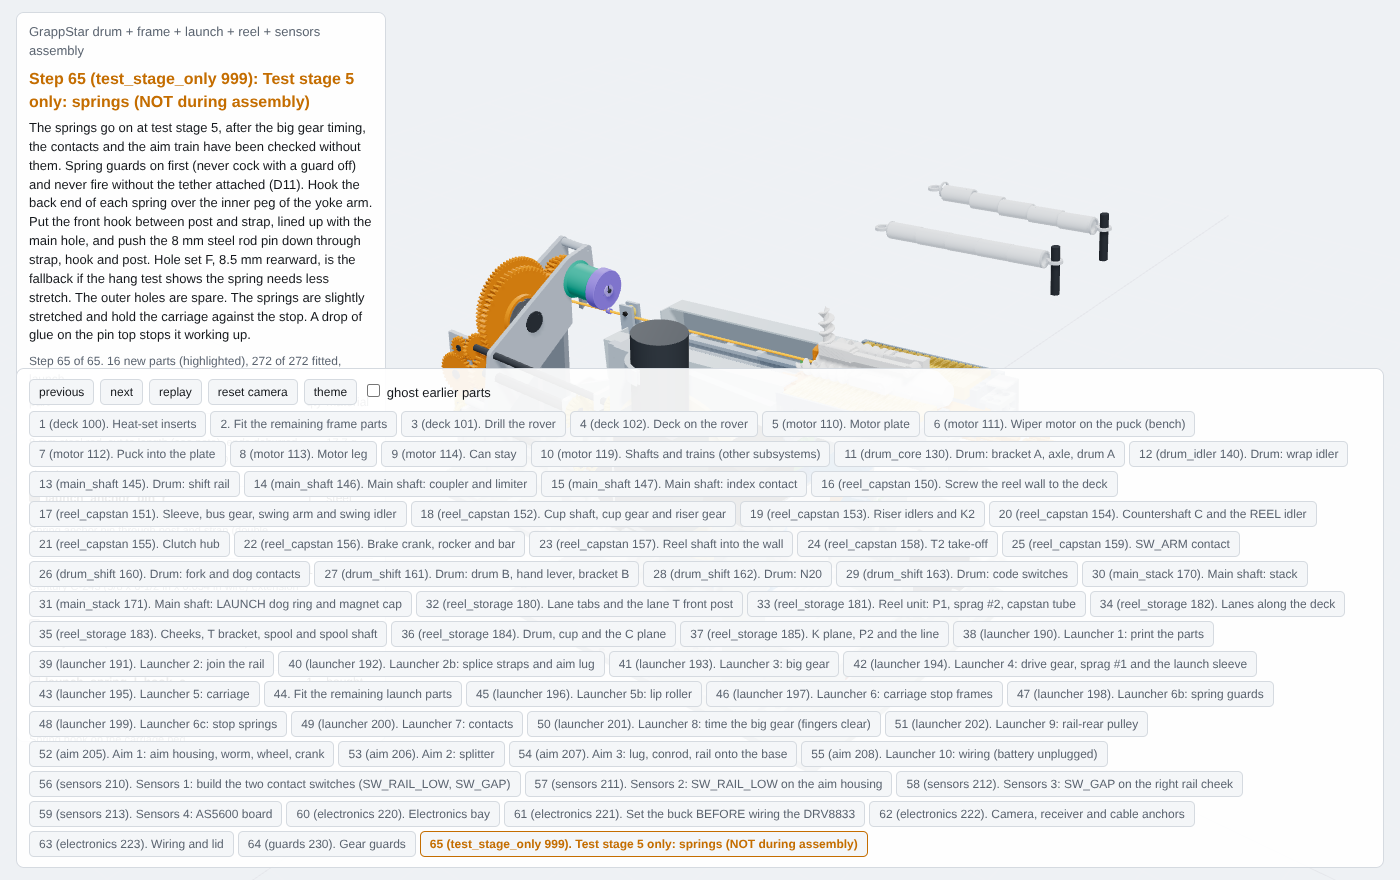
base/out/base/shots/assembly_step65_flyin.png
