HarryHYu/GrappStar/kedge/dist_v35/KEDGE_v35/docs/wiring.png

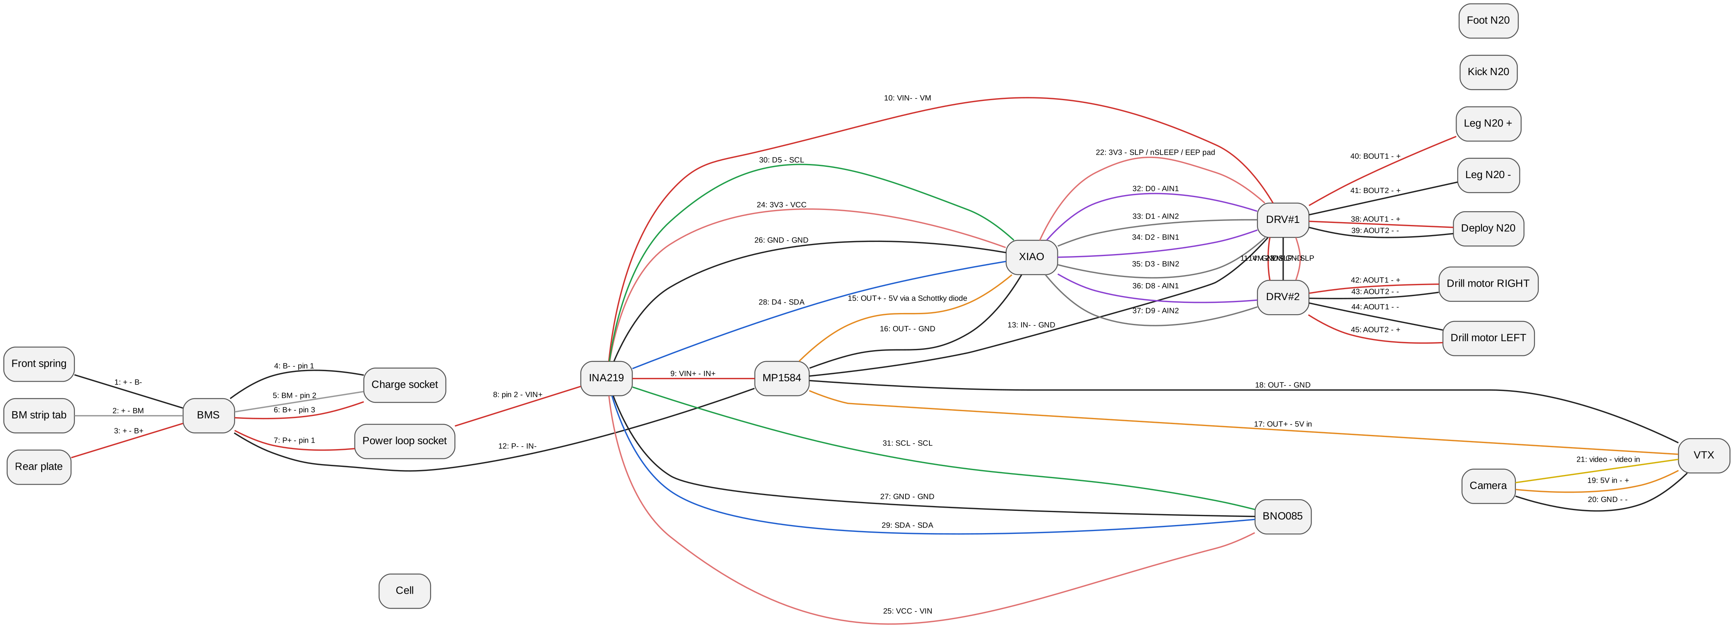
kedge/dist_v35/KEDGE_v35/docs/wiring.png
