HarryHYu/GrappStar/kedge/gs/shots/guide_p0.png

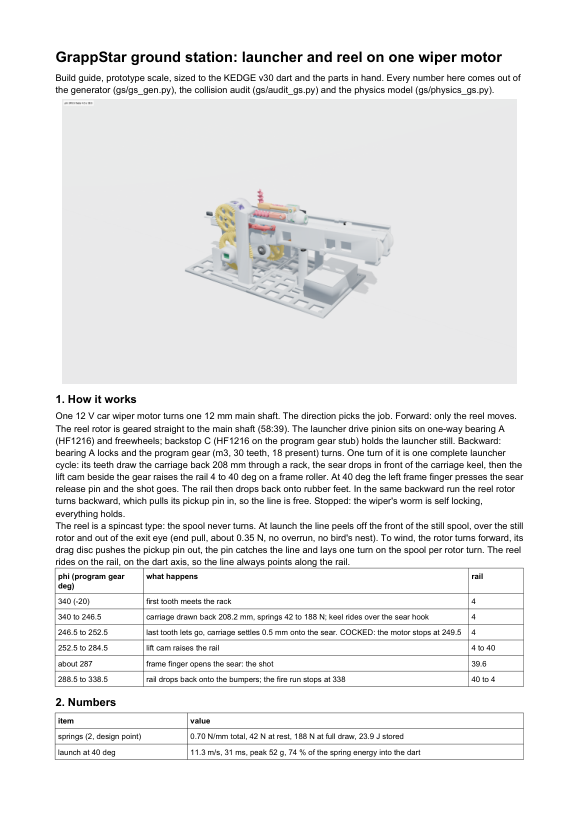
kedge/gs/shots/guide_p0.png
