HarryHYu/GrappStar/kedge/gs/shots/guide_p2.png

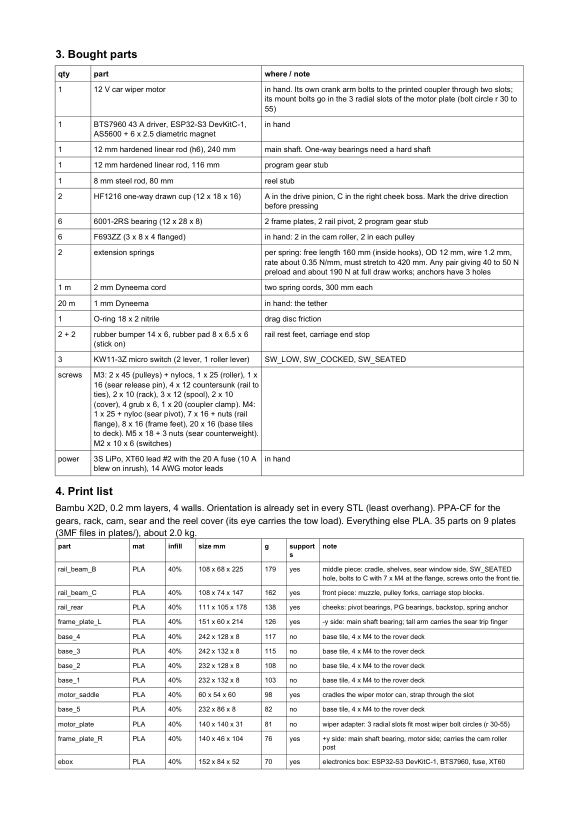
kedge/gs/shots/guide_p2.png
