HarryHYu/GrappStar/kedge/gs/shots/guide_p4.png

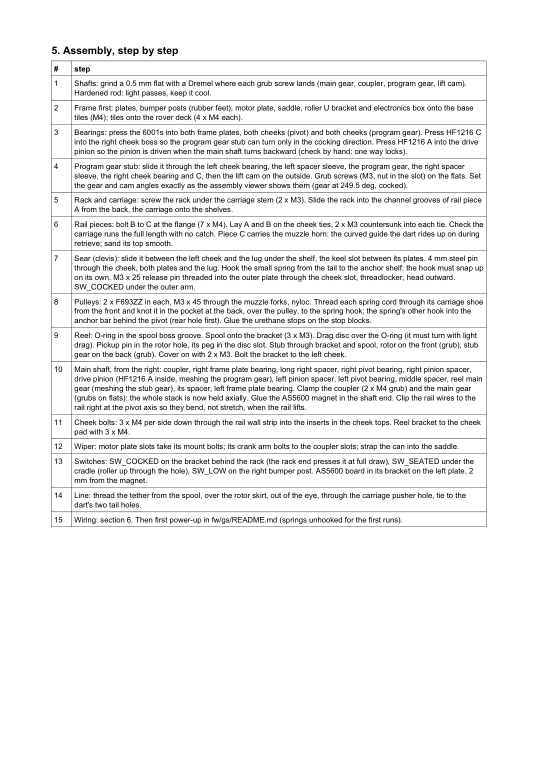
kedge/gs/shots/guide_p4.png
