HarryHYu/GrappStar/kedge/out32/review_pub_montage.png

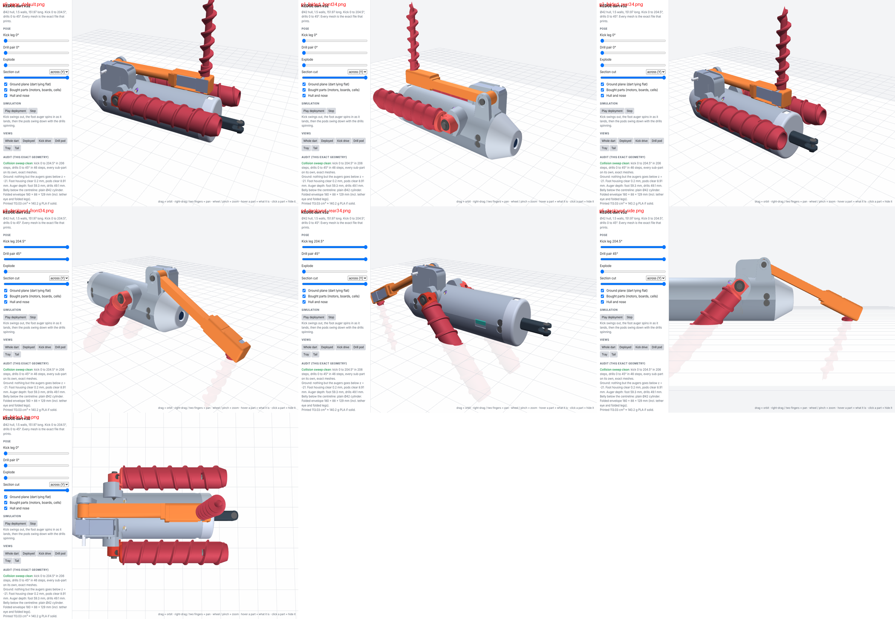
kedge/out32/review_pub_montage.png
