HarryHYu/GrappStar/kedge/out34/assembly_stages.png

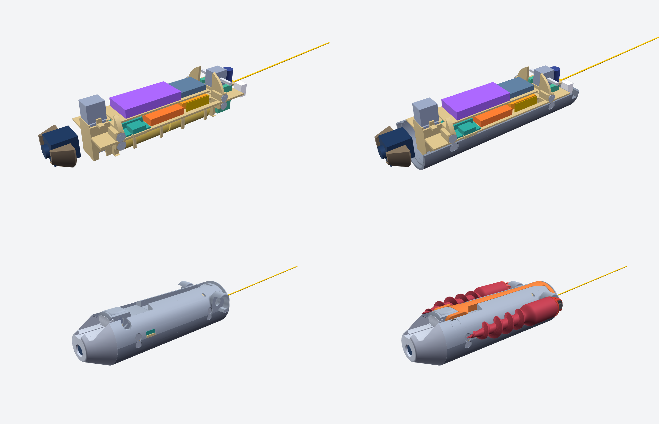
kedge/out34/assembly_stages.png
