HarryHYu/GrappStar/kedge/out35/review_montage.png

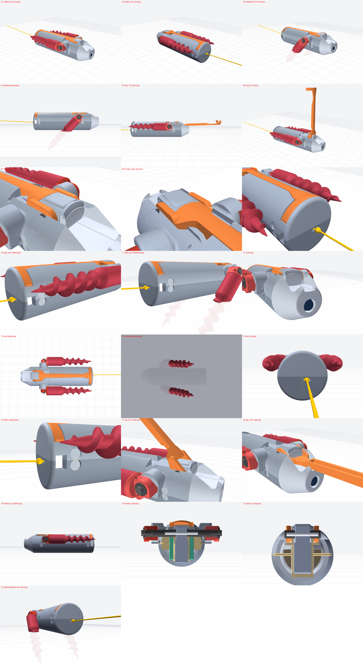
kedge/out35/review_montage.png
