HarryHYu/GrappStar/kedge/pack_gs/wiring_gs.png

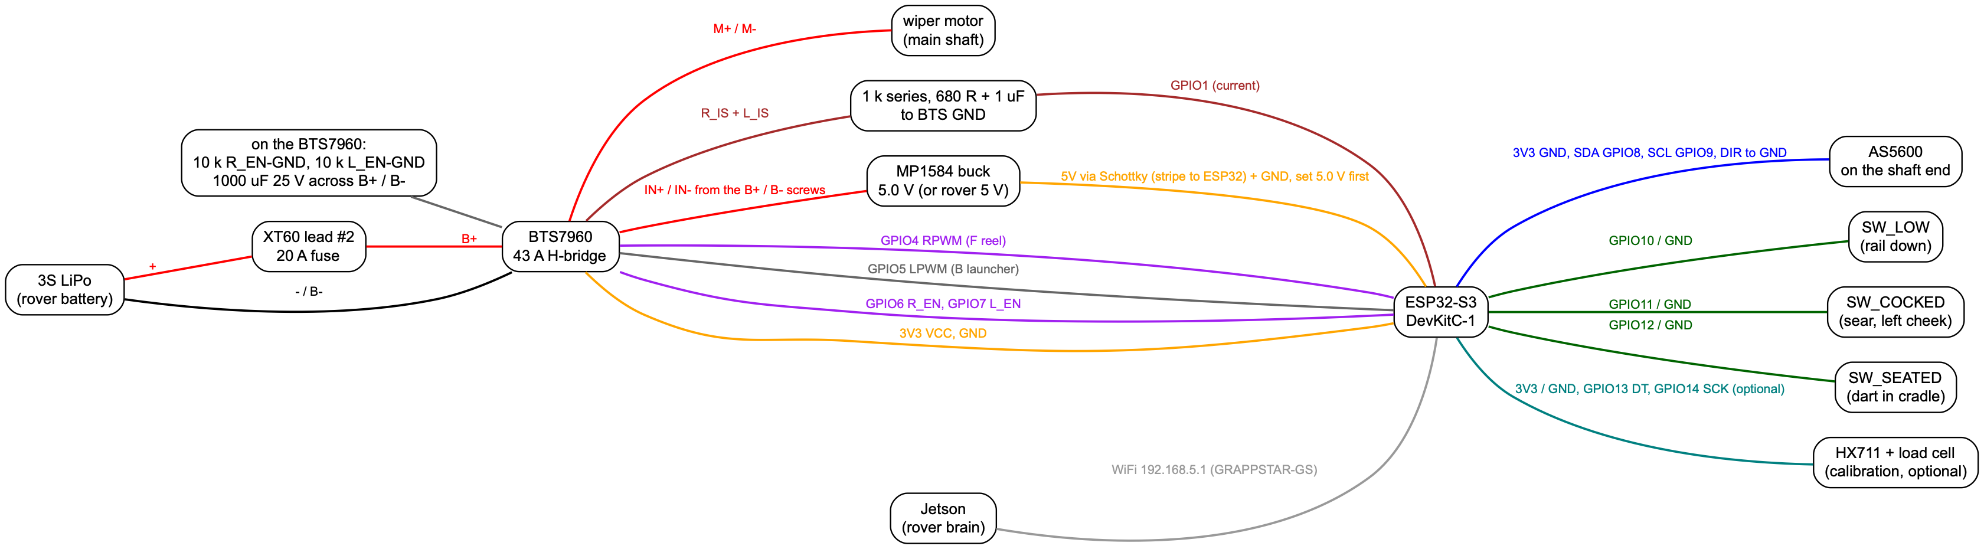
kedge/pack_gs/wiring_gs.png
