HarryHYu/GrappStar/originals/grappstar_mini_reel_v9/mini_assembled.png

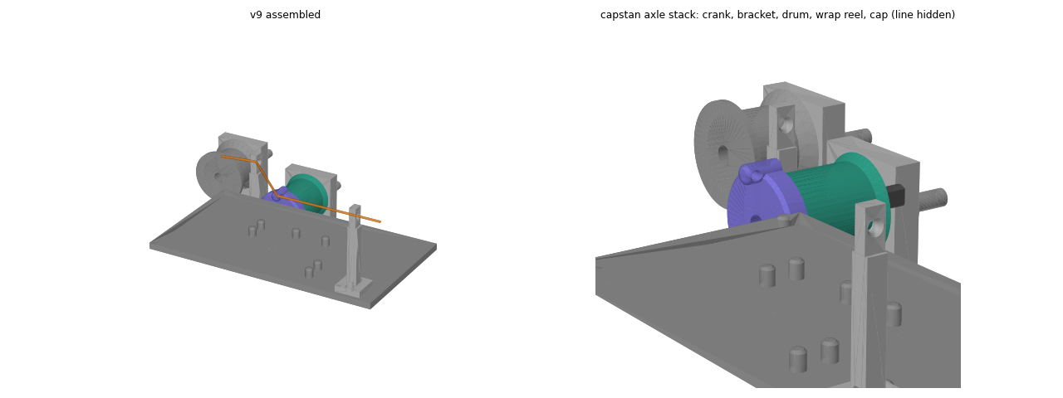
originals/grappstar_mini_reel_v9/mini_assembled.png
