HarryHYu/GrappStar/docs/build/TEST_PLAN.md

# First tests: bench to field

Do the stages in order. Do not skip ahead when a stage fails: fix it, then repeat the stage. Write the date and the
result of each stage in a notebook (or `docs/build/test_log.md`).

How to fire: `python3 -m grappstar base fire` on the Jetson. It shows mode, pitch, cock and seated, asks you to type
FIRE, then sends `arm` and `fire` with the token at once (the token is only valid 3 s, too short to type by hand).

How to send base commands: on the Jetson, in `~/GrappStar/jetson`, run `python3 -m grappstar base console`. It shows
telemetry twice a second and every event, and sends what you type: a JSON line from firmware/base/PROTOCOL.md (for
example `{"cmd":"jog","motor":"wiper","dir":1,"ms":300}`), a word with key=value pairs (`mode to=REEL`), or a bare
`stop` / `estop` / `status`. `estop` stops everything and is always safe to send. Only one program may hold the
base's serial port: quit the console before `base fire` or the operator page, and stop the grappstar service
first if installed.

Rules that catch people out:
- Aim before every shot: every `FIRED` and every `decock` clears the aim, and `base fire` refuses `NOT_AIMED`.
  Send `aim` before every `cock` and every fire.
- `require_seated` goes back to `true` at every start-up. In stages 4 and 5 (no dart) re-send
  `{"cmd":"set","key":"require_seated","val":false}` after every power-up.
- On the rover the ESP32 and the Jetson run from the same LiPo. When a step says "battery unplugged" only so your
  hands can touch the mechanism while you still read `sw`, use the motors-safe state instead: lead #2's XT60 out
  (both motors dead, ESP32 and Jetson still up). For any WIRING change: the whole battery out.

Safety for every stage:
- Battery unplugged before you touch any wire.
- Hands out of the gears, the drum and the rail whenever the battery is plugged in.
- From stage 5 on: nobody in front of the rail, safety glasses on, the launch area clear for 30 m.
- Never fire a dart (dummy or real) without the tether tied on.
- Stopping and approaching: build guide section 2 (`estop`, then lead #2's XT60, then the battery; and the checklist
  before you walk up to the base or the dart). Cutting power does not release a drawn spring or a taut line.

## Stage 0. Risk coupons (before any big print)

Print the base fit coupon (`base/pack/fit_coupon/coupon_plate_1.3mf`, PLA; its checks are in
`base/pack/fit_coupon/COUPON.md`) and the two day-one risk coupon plates (`base/pack/coupons/risk_plate_1_PLA.3mf` PLA and `risk_plate_2_PPA-CF.3mf`
PPA-CF; settings in section 4 of the build guide). They test, in a few hours of printing, the things most likely to
go wrong: the swing splitter, a printed contact, the dog clutch, the slip clutch, the bearing seats, heat-set
inserts and nut traps, the key rib, the gear meshes and the shear pin. Work through the test sheet
(`base/pack/coupons/COUPON_TEST.md` or `.pdf`).

Pass: every check on the coupon sheet passes.
If it fails: write down the test and what you saw. First check the print itself (right material, settings as in
section 4, spool dry). If the print is right, the design number the sheet names must change: ask a Claude Code
session in the repo to change it and re-run the coupons, then reprint only that piece (`rcN_*.stl`). Do not start
the big base parts until the coupons pass.

## Stage 1. Power-on (no motors attached)

Follow SYSTEM_ELECTRICAL.md section 4, the first power-on sequence, steps 1 to 9. Both motors stay disconnected
from their drivers until step 10, unless the base already passed WIRING.md Part D on the bench (then see the note at
the top of that sequence).

Pass: no steady beeps on the short check, MP1584 #2 reads 9.0 V, the Jetson boots, `ping` replies, `vbat` within 0.3 V
of the meter, `fault` is null.
If it fails: a beep means a short (check the Y harness and the BTS7960 screws first). No reply: check the USB
cable is a data cable and in the ESP32 port marked USB; see troubleshooting in the build guide.

## Stage 2. Each motor alone, out of the base

Battery unplugged. Connect the wiper motor to BTS7960 M+ / M- and clamp the motor to the bench. Connect the drum
N20 to DRV8833 #3 AOUT1 / AOUT2, loose on the bench. Battery in.

1. `jog` wiper dir 1 for 300 ms, then dir -1 (backward jogs are refused outside LAUNCH with `BACKSTOP`: on the
   bench set the drum code to LAUNCH with the jumpers BENCH_TEST.md gives). Mark with a pen arrow on the motor which way the shaft turns for
   dir 1. That is FORWARD: on the built base it is the direction that draws the carriage back (cocks). Before the
   base exists it is only a label; once assembled, a short forward jog in LAUNCH must move the carriage BACK. If it
   moves forward, swap the wiper leads at M+ / M- (battery unplugged).
2. `jog` drum dir 1 for 500 ms, then dir -1. Mark the shaft direction.
3. Do the current-sense calibration now (MEASURE_LIST G1, CALIBRATION.md), then watch `amps` during a 1.5 s wiper
   jog (jogs are capped at 1.5 s; sending the same jog again extends it).

Pass: each motor turns both ways, stops when the jog ends, no fault. Wiper free current at jog power about 1 to
2 A, safely under the jog trips (2.5 A forward, 3 A backward); a jog that trips on a bare clamped motor means
something binds or the current scale is off (redo G1).
If it fails: no movement on the wiper: check R_EN / L_EN wiring and the 20 A fuse. Wiper turns only one way: one of
RPWM / LPWM is not connected. Drum does nothing: check 9.0 V on VM and the AIN1 / AIN2 / GND jumpers. If it still does nothing, check which board
it is (MEASURE_LIST D3): a board that does not pull SLP high by itself cannot be used as wired (decision D9); write
it in the test log. Wrong direction against CALIBRATION.md: swap that motor's two leads (battery unplugged).

## Stage 3. Sensors alone

1. Battery unplugged, ESP32 on USB only. Before the magnet holder is on the motor, turn the magnet by hand over the
   chip (the wiper worm locks its own shaft, so on the built base use short `jog`s instead): `wiper_deg` changes
   smoothly, no jumps, and goes up for the FORWARD way (the arrow you drew in stage 2).
2. Touch each printed contact closed with a finger: its entry in `sw` changes and changes back when released.
3. Load cell (if fitted): press it, `tension_n` rises.

Pass: every sensor responds and returns. If it fails: AS5600 not found: check SDA / SCL are not swapped and the
STEMMA cable is pushed in; angle jumps: magnet too far (keep 1 to 2 mm) or off centre. Contact never changes:
check the GND wire and that the screw head really touches the nut.

## Stage 4. Base assembled, dry cycles, NO springs, no launch line

Before the first powered cock: break three spare shear pins on the torque arm (MEASURE_LIST G14, decision D44).
Springs off, no tether, no dart. Run CALIBRATION.md first (zeros and drum positions; part (g), the cock geometry check, waits for stage 5).
With no dart, `arm` refuses (`NOT_SEATED`): for this stage and stage 5 send
`{"cmd":"set","key":"require_seated","val":false}` (again after every power-up); it is `true` again by itself at
the next start-up, so power-cycle (or set it `true`) before stage 6.

1. `mode` LAUNCH, `mode` NEUTRAL, `mode` LAUNCH: 20 rounds. Each change ends with the right `drum_pos`. (REEL is
   only reachable with the wraps on: step 4.)
2. `aim` 15, 30, 45, then the minimum and maximum pitch: 5 rounds. Rail reaches each angle within 1 degree
   (`pitch_deg`) and holds with the motor off.
3. Cock and fire with stand-in springs: without springs nothing returns the carriage after the release, so the
   firmware would fault every cycle. Hook two strong rubber bands (or loops of bicycle inner tube) from the spring
   anchor pins to the carriage hooks instead: enough to pull the carriage home, far too weak to throw anything.
   Then `aim` 20, `cock`, `{"cmd":"decock"}` (the carriage creeps home, `SW_HOME` closes): 5 cycles. Then, with
   `aim` 20 before each one, fire with
   `python3 -m grappstar base fire` (it arms and fires in one go, inside the 3 s token life, after you type FIRE):
   the carriage travels back, releases, the bands pull it home, and the big gear re-engages: 10 cycles.
   Take the bands off afterwards.
4. Wrap and unwrap, with a spare line (not the launch tether) through the capstan path and slack: from LAUNCH, `wrap`, `tidy`, `mode`
   REEL, then `unwrap` and `mode` LAUNCH (the stage 7 table without the shot): 10 cycles. Once wrapped and in REEL,
   send `reel` with duty 0.3, wait 3 s, send `stop`.
5. Send `estop` in the middle of each kind of move once. The wiper stops at once and the drum goes to NEUTRAL,
   except when the spring is drawn, the wraps are on or the drum itself faulted: then the drum holds (`DRUM_HELD`),
   which is correct (decision D27).
6. Fault test: `estop` first, then with nothing moving, slide only the AS5600 sensor board away from its magnet
   (do not unplug anything, touch nothing else). `base status` shows `"magnet":"NONE"` and a wiper jog is refused
   with `ANGLE_SENSOR`. Put it back, `clear`.

Pass: all cycles complete with no fault, no clicking or skipping teeth, no part warm to the touch, the drum never
stops BETWEEN positions.
If it fails: a STALL fault means something binds: find it by turning by hand with the battery unplugged. Skipped
teeth: check the mesh spacing and the frame screws. Drum stops BETWEEN: re-run the drum calibration; check the drum
contacts close cleanly.

## Stage 5. Springs on, no dart

Fit both springs and the spring guard. Rail pointing at a clear area.

0. CALIBRATION.md (g), the cock geometry check, comes first: it needs the springs. It ends by setting
   `require_seated` true: set it false again for the rest of this stage.
1. `aim` to the lowest pitch. Fire once with `python3 -m grappstar base fire`. Look at every part of the launch train after the shot.
2. Five more shots, `aim` before each. Check the stop bumpers, the carriage, the rack teeth and the big gear's last tooth after each.
3. Watch `amps` while cocking: note the peak (the physics expects about 5 A; decision D8 trips at 6.5 A while
   cocking).

Pass: the carriage stops on the bumpers, nothing cracks or loosens over 6 shots, the cocking current peaks under
6.5 A (about 5 A expected), the rail holds its pitch while cocking.
If it fails: cracks at the bumpers: stop and report (no more dry shots). Rail drops while cocking: the aim worm is
slipping, check its mesh. STALL while cocking: the springs are stronger than planned (redo B2) or something binds.

## Stage 6. Dummy dart WITH the tether, first shots

Never fire a dart (dummy or real) without the tether tied on. The tether is what keeps it flying nose first; a shot
with no line can tumble or land tail first.

Make the dummy: the plate A hull top and bottom, nose and tail cap (spare prints or the dart shells before the
electronics go in), taped shut with M8 nuts or sand inside to 279 g including the 15 g nose ballast (decision D10). Paint the
nose bright. Tie the line through the tail cap holes. Route the line as in the base assembly steps (for launch it
bypasses the capstan). Set the payout brake with hanging weights (G4): 40 g does not pull line off, 50 g does.

1. Check `require_seated` is back to `true` (`{"cmd":"get","key":"require_seated"}`). `aim` 20 degrees. Load the
   dummy, check `SW_SEATED` is closed. Fire. Walk out to the dummy only after the approach checklist (section 2).
2. Film it side-on with the phone in slow motion, tape measure on the ground in view (muzzle speed, G5).
3. Measure the range. Repeat at 30 and 36 degrees (G6).
4. Check the line paid out with no loops or overrun on the storage reel.
   Between shots, bring the dummy home: `{"cmd":"set","key":"line_m","val":<measured m>}`, `mode` NEUTRAL,
   `{"cmd":"retrieve","duty":0.3}` until `SEATED`, then `mode` LAUNCH and `aim` for the next shot (no wraps needed
   for a slack line; the full wrap sequence is stage 7).
5. Range calibration, after 2 or 3 shots on level ground: measure each range from the ground point under the rail
   pivot, then on the Jetson in `~/GrappStar/base/physics`:
   `python3 calib.py range 20:0.5:3.6 36:0.5:4.2` (pitch:brake N:measured range m, your numbers) fits a
   muzzle-speed factor; `python3 ballistics.py --v-scale <factor>` rewrites `base/out/ballistics.json`, which the
   Jetson uses to aim (base/physics/README.md has the details). On the Mac the same two commands need the repo's
   Python (the Mac's own python3 has no numpy): `../../kedge/.venv/bin/python calib.py range ...` and
   `../../kedge/.venv/bin/python ballistics.py --v-scale <factor>`; then copy the file across from `~/GrappStar`:
   `scp base/out/ballistics.json <user>@GrappStar.local:GrappStar/base/out/`. Also put the factor in
   `base/spec/params.py` as `LAUNCH` `v_scale`, so a later physics run keeps it.

Pass: clean exit (no rubbing marks on the dummy), it flies nose first, payout is clean, the range is within 30
percent of the ballistics table at the same pitch (measured from the ground point under the rail pivot; the table is `base/out/ballistics.json`, shown on the
operator page and in section 1 of the build guide).
If it fails: short range: measure the springs (B2) and the muzzle speed, then re-run the physics. Rubbing marks:
check the cradle and the barrel against the dart. Loops on the reel: raise the brake a little (never over 1 N).
Big range loss with clean payout: the line catches somewhere; watch the slow-motion video.

## Stage 7. Reel cycle with the dummy

The base follows one fixed command sequence (BASE_SPEC section 10.1, decision D35). The operator page runs it for
you; by hand it is (each line: what you send, what to wait for):

| Step | Send | Wait for |
|---|---|---|
| after the shot | `{"cmd":"set","key":"line_m","val":4.5}` (the measured distance) | reply |
| rail down first if above 15 degrees (decision D45) | `{"cmd":"aim","deg":6}` | `AIMED` |
| wrap at once, line still slack | `{"cmd":"wrap"}` (from LAUNCH or NEUTRAL) | `WRAPPED` (allow 90 s; the drum parks at 314: cup locked, collar NEUTRAL, clutch FIRM) |
| (real dart only: anchor) | dart `auto` | dart ANCHORED |
| tidy the slack | `{"cmd":"tidy"}` | `TIDIED` |
| into REEL | `{"cmd":"mode","to":"REEL"}` | `MODE` ok (REEL) |
| tow (stage 8 only) | `{"cmd":"reel","duty":1,"until":"tension"}` | `LIMIT` holding |
| (real dart: release) | `{"cmd":"stop"}` FIRST (`ABORTED`), then dart `release` | dart released (operator page) |
| reel in | `{"cmd":"reel","until":"stop"}`, then `{"cmd":"stop"}` when `line_m` reads about 1.5 | `ABORTED` |
| unwrap | `{"cmd":"unwrap"}` | `UNWRAPPED`, then `MODE` NEUTRAL |
| final approach | `{"cmd":"retrieve","duty":0.3}` | `SEATED` (never seat it on the capstan) |
| back to launch | `{"cmd":"mode","to":"LAUNCH"}` | `MODE` ok |

1. After a stage 6 shot, run the table top to bottom, skipping the anchor, tow and release rows.
2. Check the line runs on the launch path again (not round the capstan). `aim` 30, fire again.

Pass: the wrap lays 7 turns on the capstan, reel-in works, unwrap returns the line to the launch path, the dummy
seats, and the next shot pays out cleanly. Repeat 5 times.
If it fails: wrap misses the capstan: check the wrap cup position at the end of `wrap`. Line still round the
capstan after `unwrap`: do not fire; unwrap again and check the drum position. `DART_STUCK` when `retrieve`
passes its time limit (about 50 s from 1.5 m of line at duty 0.3, longer with more line out; `max_s` sets it):
the dummy snagged; clear it by hand after the approach checklist (section 2).

## Stage 7b. Bench tow (before the first field tow)

Rover chocked, base wrapped and in REEL (stage 7 table), the line end tied to the luggage scale on a post at least
5 m away (a short stiff line overshoots the limit by up to half); everyone beside the line, glasses on. Free current
and tension calibrated (CALIBRATION.md (d) and (f)).

1. First pull: `{"cmd":"reel","duty":0.5,"max_n":30,"until":"tension"}`. Slacken (below), then the real one:
   `{"cmd":"reel","duty":0.5,"max_n":40,"until":"tension"}` (40 N: the first-tows limit, decision D46).
2. Watch the 7 wraps on the capstan the whole time: they must not walk along the capstan, and the line must not get
   trapped in the gap at the capstan skirt.
3. Read the scale when the base holds (`LIMIT`): it should read 35 to 45 N.

Pass: the wraps stay in place, no line trapped, the base holds at 35 to 45 N.
To slacken afterwards (and if it fails: `estop` first): the
capstan cannot let line out, so walk the scale end slowly toward the base, standing beside the line. If it failed: wraps walking or trapped line: check the
wrap cup position and the capstan skirt; wrong tension: redo CALIBRATION.md (f).

## Stage 8. The anchor in soil

The real dart, built and tested to the dart run sheet section 10. Use real soil (moist loam is the target).

1. Place the dart on the soil by hand, tether tied, line slack. `wrap` now, before the dart anchors (decision D22,
   the stage 7 table). Then send `/auto` from the operator page (or key `a`).
2. When the dart reports ANCHORED: standing beside the line, not in line with it, glasses on, pull the tether by
   hand with the luggage scale, slowly, up to 50 N or until
   it moves (G7).
3. HARD PREREQUISITE for any tow: CALIBRATION.md (d) free running current (`free_a`) and (f) tension
   (`k_n_per_a`, MEASURE_LIST G9) are done, and stage 7b passed. Why: with the factory values a simulated tow
   reached 61 N against a 40 N limit. The tow limit rule: the hand result from step 2 minus 10 N, and never above 40 N for the first field tows, until
   the wrap cup ring has been checked for wear (decision D46; the firmware cap is 55 N).
   Example: the dart held 45 N by hand, so the limit is 35 N. Set it in the firmware
   (`{"cmd":"set","key":"limit_n","val":35}`) and as the operator page's tow limit (jetson/README.md, settings).
   Re-anchor (wrap first, as in step 1). Rover chocked, everyone beside the line. Then the stage 7 table from
   `tidy` on: `tidy`, `mode` REEL, then the tow: `{"cmd":"reel","duty":1,"max_n":35,"until":"tension"}` (your
   limit).
4. `stop` the tow first, then send release (operator page, or `python3 -m grappstar dart release`): drills out,
   pods up, foot out, kick back. Then finish the stage 7 table: reel in to about 1.5 m, `unwrap`, `retrieve`, `mode` LAUNCH.

Pass: the dart anchors on its own, holds at least 20 N in loam, the base stops at its tension limit, the release
sequence frees the dart, it reels home.
If it fails: augers back out: swap that motor's leads (dart run sheet section 10). Pulls out at low force: try
firmer soil, and report the force (it sets the reel limit). Base overshoots the limit: redo CALIBRATION.md (f)
(MEASURE_LIST G9).

## Stage 9. Full mission

Before the first mission: `free_a` and `k_n_per_a` are calibrated (CALIBRATION.md (d) and (f)), the tow limit is
set by the stage 8 rule in both the firmware (`limit_n`) and the operator page, `require_seated` is `true`, and the
Jetson README steps 5 to 7 are done (cameras, dart WiFi, rover camera calibration: targeting needs it).

From the operator page on the Jetson (jetson/README.md): preflight, pick a target on the Kiyo view, aim, confirm
the fire prompt, flight video from the dart, landing verdict, anchor, tow, release, reel home.

1. First run: a short target well inside the range the operator page offers (about two thirds of the best range shown on the operator page), soft soil, open ground.
2. Watch every prompt: the software stops and asks before each dangerous step.

Pass: the whole sequence runs with only the expected operator confirmations, the dart lands within 2 m of the target,
anchors, the rover is pulled toward the dart, the dart releases and is reeled home.
If it fails: note the mission step and the fault code in the log (`mission.jsonl` on the operator page), then
repeat the stage where that step was first tested.
