HarryHYu/GrappStar/docs/build/src/12_tests.md

# 12. First tests, bench to field

@include docs/build/TEST_PLAN.md

## Expected numbers (physics model)

Compare your test results with these. They are recomputed from params.py, so after you enter the measured spring
and wiper numbers and re-run the physics, they update.

@include base/physics/SUMMARY.md
