HarryHYu/GrappStar/render/out/test_cy720_A_0330.png

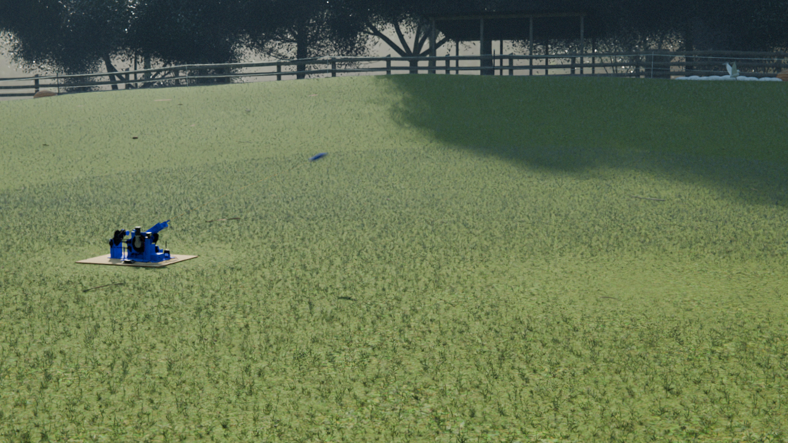
render/out/test_cy720_A_0330.png
