HarryHYu/GrappStar/render/out/test_cy720_B_0900.png

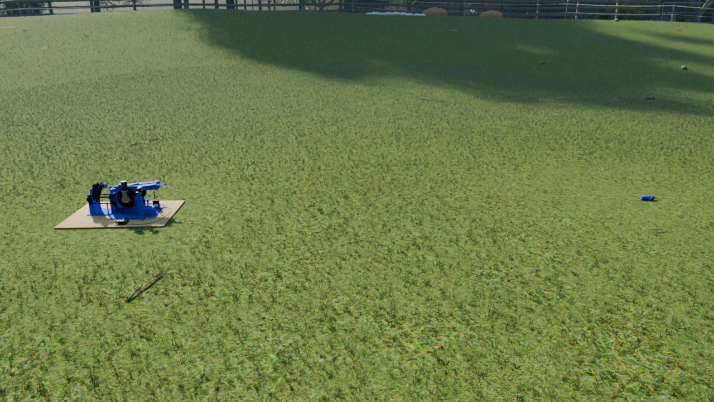
render/out/test_cy720_B_0900.png
