HarryHYu/GrappStar/base/out/display/gear_fix.txt

one M3 x 15 self-tapping screw through the hole in the rail mid cheek into the big gear's pilot hole, with the carriage at HOME resting on the gear's first tooth
