HarryHYu/GrappStar/docs/build/src/13_troubleshooting.md

# 13. Troubleshooting

First move for any problem: send `estop`; if anything still moves, pull lead #2's XT60 (section 2, Stopping). Then
read the `fault` field in telemetry. The operator page STOP button sends a plain `stop` (wiper off, drum stays);
`estop` also moves the drum to NEUTRAL when safe.

## Base

| Symptom | Likely cause | Fix |
|---|---|---|
| No reply from the base on the Jetson | Charge-only USB cable; cable in the UART port; wrong serial device | Data cable in the port marked USB. On the Jetson, `ls -l /dev/grappstar-base` must show a link to ttyACM0 (jetson/README.md section 4) |
| ESP32 resets when the wiper starts | Ground or USB power dip | Check the ESP32 GND wire to the BTS7960 GND; short USB cable; report BROWNOUT faults |
| Wiper does nothing, no fault | R_EN / L_EN not wired, 20 A fuse blown | Battery unplugged, check the fuse and the two enable wires |
| Wiper turns one way only | RPWM or LPWM loose | Re-seat the Dupont jumper |
| 20 A fuse blows | Stall into a hard stop, short on the wiper leads | Find the bind by turning by hand; never fit a bigger fuse |
| Wiper runs but nothing turns, after a jam | The coupler shear pin broke (it is the torque limiter, about 5 N m, decision D26) | Battery unplugged. Find and clear the jam first. Push the pieces of the old pin out of the coupler with a 3 mm rod, push a spare printed pin (d 4, six in the print pack) in until flush, then jog gently. Print more spares from the pack if you use them up. Never replace it with a metal pin: it protects the printed gears |
| Fault STALL or OVERCURRENT | Something binds, springs stronger than planned | Battery unplugged, turn the train by hand, find the tight spot; redo the spring measurement |
| Fault DRUM_TIMEOUT | Drum N20 not turning: no 9 V, board asleep, gear slipping | Meter on DRV8833 VM (9.0 V); check AIN1 / AIN2 / GND; check the board make (MEASURE_LIST D3); check the printed pinion is still pressed on the N20's D shaft (no set screw: a loose one needs a reprint) |
| Fault DRUM_SENSOR or SWITCH_DISAGREE | A drum contact does not close or stays closed | Battery unplugged, ESP32 on USB only (contacts read on USB power): watch `sw` while turning the drum by the hand lever; bend or re-screw the contact |
| Fault ANGLE_SENSOR | AS5600 cable out, magnet too far | Re-seat the STEMMA cable; check the magnet cap is fully on the shaft end and the board sits on its carrier pegs (the carrier sets the 2 mm gap: never shim it closer, MEASURE_LIST G13) |
| `pitch_deg` wrong after a restart | Pitch reference lost | Run the pitch part of the calibration again (section 10) |
| Drum stuck between positions with the power off | Expected: the worm holds it | Loosen the cradle swing screw, swing the N20 out of mesh, use the hand lever on the drum shaft end, battery unplugged. Never use the hand lever while the carriage is drawn (`cock` above 0 or `SW_HOME` open) or while the line is under tension: shifting under load can dry fire the launcher or drop the line. De-cock and slacken the line first. |
| Base cocked and you need to unload without firing | | Send `{"cmd":"cal","what":"decock"}`: the wiper runs backward slowly and the springs unwind under the worm until `SW_HOME` closes. If it fails: `clear`, `mode` LAUNCH, `decock` again; then, if it says `SWITCH_DISAGREE` and the carriage is visibly drawn, `{"cmd":"decock","force":true}`; last resort the manual unload in section 2 (battery out, one spring at a time with a hook tool). Never hand-release the carriage |

## Rover and video

| Symptom | Likely cause | Fix |
|---|---|---|
| Jetson turns off under load | Battery low, or voltage dip | Charge the LiPo; check the barrel plug is tight; check `vbat` |
| No dart video | VTX and RC832 on different channels; RC832 not powered | Set the RC832 to the VTX channel (scan button); check its LED and the RCA lead |
| Dart video is snow | Range, antenna off, bad channel | Antenna on both ends; try another channel |
| Kiyo X shows nothing or errors | JPEG library mismatch on JetPack | The software forces YUYV or MJPEG (jetson/README.md); unplug and replug |

## Dart

| Symptom | Likely cause | Fix |
|---|---|---|
| Serial Monitor blank | Wrong port, monitor not at 115200, or the board needs a reset | Check Tools > Port, 115200 baud, press the XIAO reset button once (the sketch will not even compile with USB CDC On Boot disabled) |
| No KEDGE WiFi | XIAO not powered or crashed | Loop plug in? 5 V at the XIAO? Press reset |
| A motor turns the wrong way | Leads reversed | Loop plug out, swap that motor's two thin input wires at its driver (section 6, "Reverse a motor"); only if just one drill is wrong, swap that drill's motor leads |
| Current trip during anchoring | Stall on a stone, or the trip set too low | Re-measure stall currents (section 14 F3) and update the tuning |
| INA219 or BNO085 not found | I2C wiring | `z` key scans; SDA and SCL must not be swapped |
