HarryHYu/GrappStar/kedge/dist_v35/KEDGE_v35/firmware/wiring/changes_from_v29.csv

v29 # | action | detail | note
13 | REMOVE | DRV#2 VM -> DRV#3 VM | DRV#3 is no longer on the dart
17 | REMOVE | DRV#2 GND -> DRV#3 GND | DRV#3 is no longer on the dart
27 | REMOVE | DRV#2 SLP -> DRV#3 SLP | DRV#3 is no longer on the dart
5 | CHANGE (now #5) | was BMS B- -> Charge socket pin 1 (tail window) (80 mm); now BMS B- -> Charge socket pin 1 (tail cap, bottom seat) (90 mm) | JST-XH 3-pin, balance charge
6 | CHANGE (now #6) | was BMS BM -> Charge socket pin 2 (125 mm); now BMS BM -> Charge socket pin 2 (tail cap, bottom seat) (90 mm)
7 | CHANGE (now #7) | was BMS B+ -> Charge socket pin 3 (80 mm); now BMS B+ -> Charge socket pin 3 (tail cap, bottom seat) (90 mm)
8 | CHANGE (now #8) | was BMS P+ -> Power loop socket pin 1 (tail window) (80 mm); now BMS P+ -> Power loop socket pin 1 (tail cap, top seat) (105 mm) | JST-XH 2-pin; the shorting plug is the ON switch
9 | CHANGE (now #9) | was Power loop socket pin 2 -> INA219 VIN+ (95 mm); now Power loop socket pin 2 -> INA219 VIN+ (80 mm) | main + after the loop
10 | CHANGE (now #10) | was INA219 VIN+ (same pad) -> MP1584 IN+ (140 mm); now INA219 VIN+ (same pad) -> MP1584 IN+ (200 mm) | buck taps before the shunt, so INA219 reads motor current only
12 | CHANGE (now #12) | was DRV#1 VM -> DRV#2 VM (65 mm); now DRV#1 VM -> DRV#2 VM (70 mm) | daisy chain ends here (no DRV#3)
14 | CHANGE (now #13) | was BMS P- -> MP1584 IN- (130 mm); now BMS P- -> MP1584 IN- (90 mm) | main ground
15 | CHANGE (now #14) | was MP1584 IN- (same pad) -> DRV#1 GND (120 mm); now MP1584 IN- (same pad) -> DRV#1 GND (200 mm)
16 | CHANGE (now #15) | was DRV#1 GND -> DRV#2 GND (65 mm); now DRV#1 GND -> DRV#2 GND (70 mm)
18 | CHANGE (now #16) | was MP1584 OUT+ (5.04 V) -> XIAO 5V via a Schottky diode (stripe toward the XIAO) (160 mm); now MP1584 OUT+ (5.04 V) -> XIAO 5V via a Schottky diode (stripe toward the XIAO) (195 mm) | set and check 5.04 V BEFORE connecting; 1N5817 or SS14 in heat shrink
19 | CHANGE (now #17) | was MP1584 OUT- -> XIAO GND (160 mm); now MP1584 OUT- -> XIAO GND (195 mm)
22 | CHANGE (now #20) | was VTX 5V in (same pad) -> Camera + (red) (105 mm); now VTX 5V in (same pad) -> Camera + (red) (120 mm) | runs forward along the top through the disc notches
23 | CHANGE (now #21) | was VTX GND (same pad) -> Camera - (black) (105 mm); now VTX GND (same pad) -> Camera - (black) (120 mm)
24 | CHANGE (now #22) | was Camera video (yellow) -> VTX video in (105 mm); now Camera video (yellow) -> VTX video in (120 mm) | twist with the camera ground
26 | CHANGE (now #24) | was DRV#1 SLP -> DRV#2 SLP (65 mm); now DRV#1 SLP -> DRV#2 SLP (70 mm)
29 | CHANGE (now #26) | was INA219 VCC -> BNO085 VIN (60 mm); now INA219 VCC -> BNO085 VIN (180 mm)
31 | CHANGE (now #28) | was INA219 GND -> BNO085 GND (60 mm); now INA219 GND -> BNO085 GND (180 mm)
33 | CHANGE (now #30) | was INA219 SDA -> BNO085 SDA (60 mm); now INA219 SDA -> BNO085 SDA (180 mm)
35 | CHANGE (now #32) | was INA219 SCL -> BNO085 SCL (60 mm); now INA219 SCL -> BNO085 SCL (180 mm)
40 | CHANGE (now #37) | was XIAO D8 -> DRV#2 AIN1 + BIN1 (bridge the two pads) (45 mm); now XIAO D8 -> DRV#2 AIN1 (only AIN1: NO bridge to BIN1) (50 mm) | drills
41 | CHANGE (now #38) | was XIAO D9 -> DRV#2 AIN2 + BIN2 (bridge the two pads) (45 mm); now XIAO D9 -> DRV#2 AIN2 (only AIN2: NO bridge to BIN2) (50 mm) | drills
42 | CHANGE (now #39) | was XIAO D6 -> DRV#3 AIN1 (145 mm); now XIAO D6 -> DRV#2 BIN1 (50 mm) | foot (slow worm, harmless if it twitches at reset)
43 | CHANGE (now #40) | was XIAO D7 -> DRV#3 AIN2 (145 mm); now XIAO D7 -> DRV#2 BIN2 (50 mm) | foot
44 | CHANGE (now #41) | was DRV#1 AOUT1 -> Deploy N20 + (red) (165 mm); now DRV#1 AOUT1 -> Deploy N20 + (red) (220 mm) | motor sits in the sled cradle
45 | CHANGE (now #42) | was DRV#1 AOUT2 -> Deploy N20 - (black) (165 mm); now DRV#1 AOUT2 -> Deploy N20 - (black) (220 mm)
46 | CHANGE (now #43) | was DRV#1 BOUT1 -> Kick N20 + (red) (150 mm); now DRV#1 BOUT1 -> Kick N20 + (red) (215 mm) | out through the hole in the saddle floor
47 | CHANGE (now #44) | was DRV#1 BOUT2 -> Kick N20 - (black) (150 mm); now DRV#1 BOUT2 -> Kick N20 - (black) (215 mm)
48 | CHANGE (now #45) | was DRV#2 AOUT1 -> Drill motor LEFT + (red) (195 mm); now DRV#2 AOUT1 -> Drill motor LEFT + (red) (170 mm) | out the left flank hole, 30 mm loop for the pod swing; v32: the motor drives the sleeve directly, so the sleeve turns with the motor (BENCH_TEST step 4 checks the sleeves)
49 | CHANGE (now #46) | was DRV#2 AOUT2 -> Drill motor LEFT - (black) (195 mm); now DRV#2 AOUT2 -> Drill motor LEFT - (black) (170 mm)
50 | CHANGE (now #47) | was DRV#2 BOUT1 -> Drill motor RIGHT - (black) SWAPPED (170 mm); now DRV#2 AOUT1 (same pad as the LEFT red) -> Drill motor RIGHT - (black) SWAPPED (170 mm) | reversed on purpose: the pair counter-rotates; v32: the motor drives the sleeve directly, so the sleeve turns with the motor (BENCH_TEST step 4 checks the sleeves)
51 | CHANGE (now #48) | was DRV#2 BOUT2 -> Drill motor RIGHT + (red) SWAPPED (170 mm); now DRV#2 AOUT2 (same pad as the LEFT black) -> Drill motor RIGHT + (red) SWAPPED (170 mm)
52 | CHANGE (now #49) | was DRV#3 AOUT1 -> Foot N20 + (red) (255 mm); now DRV#2 BOUT1 -> Foot N20 + (red) (300 mm) | forward along the top through the disc notches, out the skin hole, 60 mm loop round the hub, through the pole channel
53 | CHANGE (now #50) | was DRV#3 AOUT2 -> Foot N20 - (black) (255 mm); now DRV#2 BOUT2 -> Foot N20 - (black) (300 mm) | silicone wire, it flexes every deploy
