HarryHYu/GrappStar/kedge/dist_v35/KEDGE_v35/firmware/kedge_dart/kedge_logic.h

// KEDGE dart control logic v4.3 (dart v34): plain C++, no Arduino calls, so it is unit-tested on a PC (see
// ../test/test_logic.cpp). The sketch supplies the hardware through the Io struct and feeds IMU samples in.
//
// v4.3 (9 Nov 2026, dart v34): no foot and no kick leg. The old kick channel (DRV#1 B) drives the RIGHTING LEG (flush in
// the dorsal groove, swings 0 to 178 deg over the nose; far stop = its bed in the nose top, fold stop = the groove floor);
// the foot channel (DRV#2 B, D6/D7) is not wired and never driven (keys 4 / $ refused). /auto = righting (if needed),
// then pods down with the drills spinning. Righting mirrors the study sim (kedge/sim_righting simCore) on v34's one
// deploy worm: belly up = leg flip, on a flank = both pods out with the drills off, upright = tilt under 15 deg.
//
// v4 changes (3 Nov 2026): DRV8833 #3 removed from the dart (it goes to the base station). DRV#2 channel A drives both
// drill motors in parallel, DRV#2 channel B drives the foot. New: release sequence, phase, fault codes, flight and
// landing detection, 12 s flight log ring buffer, per-motor stall, sequence time limits, low rail and sensor-loss
// handling.
#pragma once
#include <stdint.h>
#include <stdio.h>
#include <string.h>
#include <math.h>

namespace kedge {

static const char* const FW_VERSION = "kedge-dart-v4.3";

// v34: KICK is the channel of the righting leg (the name stays for the API: /status motors.kick); FOOT is not wired
enum { DEPLOY = 0, KICK = 1, DRILLS = 2, FOOT = 3, NMOT = 4 };
static inline const char* motorName(int m) {
  static const char* n[] = {"deploy", "leg", "drills", "foot"};
  return (m >= 0 && m < NMOT) ? n[m] : "?";
}

// ---------------------------------------------------------------------------------------------------------------
// Pin map. GPIO numbers of the Seeed XIAO ESP32S3 (Dn labels in the strings). The sketch checks these numbers against
// the Arduino Dn macros at compile time, the PC test checks the layout.
// sign: +1 = the part turns the way the motor shaft turns; -1 = a gear stage reverses it, so the sketch drives the
// channel the other way (dir +1 always means out / in / down for the PART, keys and sequences never change).
// v32 as built (dart-cad): the motor shaft drives each drill sleeve DIRECTLY through its tip hub (no gear stage),
// so the sleeve turns with the motor: DRILLS sign +1. If a tip planetary is ever added (it reverses the sleeve), set -1.
// The left / right counter-rotation (right drill leads swapped) is unchanged; BENCH_TEST step 4 confirms.
static constexpr int DRILL_SIGN = +1;
struct PinMap { int gpioA, gpioB; const char* labelA; const char* labelB; int drv; char ch; int sign; };
static constexpr PinMap PINS[NMOT] = {
  {1, 2, "D0", "D1", 1, 'A', +1},          // deploy N20: DRV#1 AIN1 / AIN2
  {3, 4, "D2", "D3", 1, 'B', +1},          // leg N20:    DRV#1 BIN1 / BIN2 (v34 righting leg, the old kick motor and channel)
  {7, 8, "D8", "D9", 2, 'A', DRILL_SIGN},  // drills:     DRV#2 AIN1 / AIN2, BOTH drill motors in parallel on AOUT1 / AOUT2
  {43, 44, "D6", "D7", 2, 'B', +1},        // foot:       v34 has none: DRV#2 B and D6/D7 are not wired, the pins are held low, never driven
};
static constexpr int PIN_SDA_GPIO = 5, PIN_SCL_GPIO = 6;   // D4 / D5: INA219 0x40 + BNO085 0x4A
// D10 (GPIO9): optional video power switch (WIRING.md "Optional: video power switch"). HIGH = camera and VTX on. With
// nothing fitted the pin drives nothing and the video simply stays on. GPIO9 is not a strapping pin and is quiet at boot.
static constexpr int PIN_VIDEO_GPIO = 9;
static const int N_DRIVERS = 2;                        // DRV#3 is no longer on the dart
static const float DRV_CHANNEL_MAX_MA = 1200;          // DRV8833 continuous per channel (2 A peak, internal OCP)

// ---------------------------------------------------------------------------------------------------------------
struct Io {
  void (*setMotor)(int motor, int dir, int duty);   // dir -1/0/+1, duty 0..255
  float (*current_mA)();                            // total motor-rail current (INA219); NAN when the read failed
  float (*rail_V)();                                // motor rail volts; <= 0 when unknown
  void (*log)(const char* line);
  void (*setVideo)(bool on);                        // optional video power switch (may be nullptr)
};

// Replace the current numbers with bench values (BENCH_TEST.md steps 3 to 6, written in at step 10). Currents are the total read by
// the INA219 on the motor rail at 2S.
struct Tuning {
  uint32_t serialRunMs = 1500, wifiDeadmanMs = 350, wifiMaxRunMs = 500;
  float tripMa = 2000; uint32_t tripHoldMs = 10;        // all four stalled at 8.4 V is about 1700 mA (v34: three channels)
  float stallMa[NMOT] = {150, 150, 600, 450};           // deploy, leg, drill PAIR, (foot, not on v34) (stall 180 / 180 / 700)
  float loadMa[NMOT] = {40, 70, 420, 130};              // normal working current (in soil), used when 3+ run at once
  float freeMa[NMOT] = {30, 30, 70, 45};               // free running current (bench, 8 V)
  float refV = 8.0f;                                    // the currents above are at this rail voltage; they scale with it
  uint32_t kickMaxMs = 15000, deployMaxMs = 150000, drillAfterMs = 3000;   // leg fold limit (KICK_TIMEOUT); deploy: milling, loam about 90 s
  uint32_t drillLeadMs = 3000;                          // release: drills unscrew alone this long first
  uint32_t autoMaxMs = 240000, releaseMaxMs = 180000;   // whole-sequence limits: room for the 150 s milling deploy (v4.1) and,
                                                        // v4.3, up to 6 righting moves of about 10 s before it
  uint32_t surgeIgnoreMs = 250, stallHoldMs = 200;
  uint32_t podsMinMs = 700, kickBackMinMs = 1500;      // shortest real travel before an end-stop stall is believed (release)
  float riseFrac = 0.5f;                                // a worm stall in a sequence must also raise the total current
  float noCurrentFrac = 0.4f; uint32_t noCurrentMs = 500;   // a lone motor under 40 % of its free current: open wire, or a
                                                        // short chopped by the DRV8833 protection (about 9 mA); worms 20+
  float lowRailV = 5.6f; uint32_t lowRailMs = 500;      // 2S at 2.8 V per cell under load
  float armMinV = 6.6f;                                 // refuse to arm a flat battery (3.3 V per cell at rest)
  uint32_t armMaxMs = 15UL * 60 * 1000;                 // an arm expires after 15 min without a launch
  uint32_t podLeadMs = 300;                             // pods steps start with the deploy worm alone (open wire, at the stop)
  uint32_t podsWithDrillsMs = 600;                      // release: the drills turn with the lifting pods this long, then the pods go on alone
  uint32_t podsTravelMs = 1400;                         // pods stowed to down stop at full duty and refV (BENCH_TEST step 3)
  uint32_t kickSwingMs = 3800;                          // leg 0 to 178 deg at full duty and refV (BENCH_TEST step 5): travel bookkeeping
                                                        // (178 of the old kick's 200.75 deg at the same worm speed: about 3.8 s)
  uint32_t manualMaxMs = 8000;                          // a manual motor (held key or repeats) never runs longer
  uint32_t manualMaxNoInaMs = 2000;                     // ...and without current sensing (no stall detection)
  int inaFailLimit = 3;                                 // consecutive failed current reads = sensor lost
  // battery (2S 18350) at rest: the INA219 bus voltage with no motor running for battRestMs. Low = 3.4 V per cell (about
  // 10 % left: a warning), critical = 3.2 V per cell (a few percent: /auto refused so an anchor is never left without
  // the charge to release it, and the video is switched off to stretch what is left; /release and keys still work)
  float battLowV = 6.8f, battCritV = 6.4f, battHystV = 0.1f; uint32_t battRestMs = 1000;
  // orientation while still, from the BNO085 accelerometer. imuUpAxis = the chip axis that points UP when the dart lies
  // belly down: 1 = x, 2 = y, 3 = z, negative = the minus direction (BENCH_TEST step 7 checks it; default: the BNO085
  // board lies flat on its deck, parts up, so chip +z is up). Tilt = angle between that axis and straight up.
  int imuUpAxis = 3; float uprightMaxDeg = 70, invertedMinDeg = 120;
  // orient in /status once the chip axis pointing to the NOSE is known too (imuNoseAxis, same coding; 0 = not known: the
  // tilt-only rule above): |roll| under levelRollDeg upright, up to sideRollDeg leaning, beyond on its side / upside
  // down; nose pitch outside pitchMinDeg..pitchMaxDeg nose_down / nose_up. v34: report only, the righting uses the tilt.
  // v34 CAD: the BNO085 lies flat on deck 1 with its arrow to the nose: set imuNoseAxis from BENCH_TEST step 7.
  int imuNoseAxis = 0; float levelRollDeg = 10, sideRollDeg = 60, pitchMinDeg = -25, pitchMaxDeg = 15;
  // v4.3 righting (dart v34), the policy of the study sim (kedge/sim_righting simCore, v34 check: loam 40/40, sand 20/20)
  // on v34's hardware (one deploy worm drives both pods). Tilt = angle of the belly-down up axis from vertical.
  //   tilt under rightedMaxDeg: belly down, anchor as it lies (sim: 15 deg).
  //   tilt over rightInvDeg (belly up): LEG FLIP: leg out until the tilt falls under legOverDeg (the dart goes over end
  //     to end), then legOverMs more; or until it stalls for legStallMs (its far stop, reached in air once the dart is
  //     over: normal, not a fault; or it cannot lift the dart); or legOutMaxMs. Then the leg back to its fold stop.
  //   otherwise (on a flank, leaning on a pod): POD ROLL: both pods out with the drills off until the tilt is under
  //     rollLevelDeg (the low pod rolls the dart onto its belly) or they stall for rollStallMs, or rollMaxMs. Held there:
  //     if that righted it the anchor goes on from there, else the pods fold before the next move. Every 4th flank move
  //     is a leg flip (sim list: pod roll, pod roll, both pods, leg flip; one worm makes the first three the same).
  //   then still for rightSettleMs (at most rightSettleMaxMs for a fresh reading), read the tilt again: after a move a
  //   tilt under rightAcceptDeg is upright enough (dart-physics v34 shared-worm check: with coupler play the pod hold
  //   sags back to about 16 deg after a roll that stopped at 10; on uneven ground the pods may not get it under 15).
  //   The pods going down with the drills level it further, as the sim's anchor does. So the thresholds never fight:
  //   roll target 10 < start test 15 < accept after a move 20 (the v4.2 "pods to 16 deg" levelling step is gone).
  //   rightTries moves in all, then fault NOT_UPRIGHT. No attitude (BNO085 silent) or /auto?force=1: no righting,
  //   anchored as it lies.
  float rightedMaxDeg = 15, rightAcceptDeg = 20, rightInvDeg = 110, legOverDeg = 60, rollLevelDeg = 10;
  uint32_t legOverMs = 600, legStallMs = 1500, legOutMaxMs = 9000, rollStallMs = 1000, rollMaxMs = 10000;
  uint32_t rightSettleMs = 600, rightSettleMaxMs = 4000; int rightTries = 6;
  // anchoring in soil (dart-physics 7 Nov): the augers sweep sideways through soil, so the deploy worm stalls in soil
  // long before its end stop. A deploy stall before podsDownFrac of podsTravelMs is soil: the deploy pauses millOffMs while
  // the drills keep cutting, then pushes again (milling). Travel is counted at full speed (a load factor from the pair
  // readings was tried and dropped, see tick). No travel gained for millNoProgressMs ends the step: taken as the stop
  // when the estimate is past podsStuckDownFrac, else warning pods_time_limit (firm soil).
  float podsDownFrac = 0.85f, podsStuckDownFrac = 0.6f; uint32_t millOffMs = 200, millNoProgressMs = 5000;
  uint32_t podsPlainMaxMs = 6000;                       // pods step limit while no milling has started (the v4 limit); deployMaxMs once milling
  // v4.2 deploy guard (dart-physics v32): end the milling deploy when the drill pair, read alone, is over drillGuardFrac
  // of its real stall current (drillPairStallMa, BENCH_TEST step 4, at refV): the sleeves are then never driven deeper
  // than the drills can back them out of after standing (release margin 1.15). Anchor ends ANCHORED, warning depth_limited.
  // (Replaces the v4.1 85 % "drill relax" pause, which this lower line always reached first.)
  float drillPairStallMa = 700, drillGuardFrac = 0.67f;
  // release: drills that stall unscrewing are rocked (in for rockInMs, then out again) up to rockMax times before
  // DRILL_JAM; pods that stall on the way up before 60 % back are milled the same way, PODS_JAM only after
  // millNoProgressMs without progress
  uint32_t rockInMs = 300; int rockMax = 5;
  uint32_t hotMillMs = 60000, hotRestMs = 60000;        // a pods step over 60 s heats the motors: /auto waits 60 s (dart-physics (9))
  // anchor motion while ANCHORED (the tow): tilt change over moveDeg, or |a| off 1 g by moveG, for moveHoldMs
  float moveDeg = 2, moveG = 0.15f; uint32_t moveHoldMs = 200;
};

// codes keep their numbers and names (API); v4.3 never raises FOOT_JAM or NO_GROUND (no foot; the leg's far stop in air
// is normal). KICK_* now mean the righting leg (same channel).
enum Fault { F_NONE = 0, F_OVERCURRENT, F_KICK_TIMEOUT, F_SEQ_TIMEOUT, F_DRILL_JAM, F_FOOT_JAM, F_CURRENT_SENSOR, F_LOW_RAIL,
             F_BROWNOUT, F_WATCHDOG, F_NO_CURRENT, F_KICK_JAM, F_NO_GROUND, F_PODS_JAM, F_NOT_UPRIGHT, F_NFAULT };
static inline const char* faultName(int f) {
  static const char* n[] = {"", "OVERCURRENT", "KICK_TIMEOUT", "SEQ_TIMEOUT", "DRILL_JAM", "FOOT_JAM", "CURRENT_SENSOR",
                            "LOW_RAIL", "BROWNOUT", "WATCHDOG", "NO_CURRENT", "KICK_JAM", "NO_GROUND", "PODS_JAM", "NOT_UPRIGHT"};
  return (f > 0 && f < F_NFAULT) ? n[f] : "";
}

// v4.3: RT_* = righting (part of the anchor sequence, phase ANCHORING); the kick / foot steps are gone
enum Seq { IDLE, RT_LEG_OUT, RT_LEG_BACK, RT_PODS, RT_PODS_BACK, RT_SETTLE, D_DEPLOY, D_AFTER, DONE, ABORTED, R_DRILL, R_PODS, R_KICK, RELEASED, NSEQ };
static inline const char* seqName(int s) {
  static const char* n[] = {"idle", "righting: leg out", "righting: leg folding", "righting: pods out, drills off", "righting: pods back up",
                            "righting: settling", "deploy + drills", "drills finishing", "anchored", "aborted", "release: drills out",
                            "release: drills out + pods up", "release: leg folding", "released"};
  return (s >= 0 && s < NSEQ) ? n[s] : "?";
}
enum Phase { P_IDLE, P_ARMED, P_FLIGHT, P_LANDED, P_ANCHORING, P_ANCHORED, P_RELEASING, P_FAULT };
enum Batt { B_UNKNOWN, B_NONE, B_OK, B_LOW, B_CRIT };
static inline const char* battName(int b) { static const char* n[] = {"unknown", "none", "ok", "low", "critical"}; return (b >= 0 && b <= B_CRIT) ? n[b] : "?"; }
enum Orient { O_UNKNOWN, O_UPRIGHT, O_SIDE, O_INVERTED, O_LEANING, O_NOSE_DOWN, O_NOSE_UP, O_NORIENT };
static inline const char* orientName(int o) { static const char* n[] = {"unknown", "upright", "side", "inverted", "leaning", "nose_down", "nose_up"}; return (o >= 0 && o < O_NORIENT) ? n[o] : "?"; }
static inline const char* phaseName(int p) {
  static const char* n[] = {"IDLE", "ARMED", "FLIGHT", "LANDED", "ANCHORING", "ANCHORED", "RELEASING", "FAULT"};
  return (p >= 0 && p <= P_FAULT) ? n[p] : "?";
}

// ---------------------------------------------------------------------------------------------------------------
// Launch and landing detector on |a| in g (BNO085 accelerometer, gravity included, saturates near 8 g).
//   launch:  |a| > launchG continuously for launchHoldMs (contract C2: 4 g for 20 ms)
//   landing: after free fall (|a| < freeFallG for freeFallMs in total) or pushOverMs after launch with |a| < launchG,
//            and minFlightMs, an impact over impactG, then still (|a| inside stillLo..stillHi) for stillMs. C2 said 6 g;
//            3.5 g is used because the sensor clips and filters short impacts (API.md). Landing time = the LAST impact.
//            v4.1: minFlightMs 400 -> 250 and pushOverMs 400 -> 200. The real launcher (base/out/ballistics.json) flies
//            the dart for 0.37 s at the 6 deg low aim (about 0.42 s after the push starts): 400 ms missed that impact.
//   fallbacks: no impact seen but still for softStillMs after the flight ("still"); nothing for flightTimeoutMs after
//            launch ("timeout": also covers a silent IMU, checked from tick()).
struct Flight {
  enum St { WAIT = 0, FLYING, IMPACTED, LANDED };
  enum Ev { NONE = 0, LAUNCH, LAND };
  float launchG = 4, impactG = 3.5f, freeFallG = 0.6f, stillLo = 0.85f, stillHi = 1.15f;
  uint32_t launchHoldMs = 20, sampleSlackMs = 5, freeFallMs = 60, pushOverMs = 200, minFlightMs = 250, stillMs = 1000, softStillMs = 2000, flightTimeoutMs = 15000;
  int st = WAIT; bool above = false, quiet = false, stillOn = false, launched = false;
  uint32_t tAbove = 0, tLaunch = 0, tImpact = 0, tStill = 0, tLand = 0, ffMs = 0, tPrev = 0;
  // a dropped dart is in free fall before it hits: a push within dropWindowMs after free fall (|a| < dropG for at least
  // dropFallMs) is not a launch. Rail vibration, tilts and the cocking jerk never read that low, so they do not matter.
  float dropG = 0.5f; uint32_t dropFallMs = 40, dropWindowMs = 400, ffStart = 0, lastFall = 0; bool inFall = false, hadFall = false, pushBad = false;
  void armedAt(uint32_t) { inFall = hadFall = pushBad = false; }
  const char* how = "";                       // impact | still | timeout | stop
  void reset() { st = WAIT; above = quiet = stillOn = launched = false; tAbove = tLaunch = tImpact = tStill = tLand = ffMs = tPrev = 0; how = ""; }
  bool fallback() const { return st == LANDED && (strcmp(how, "still") == 0 || strcmp(how, "timeout") == 0); }
  bool flying() const { return st == FLYING || st == IMPACTED; }
  int land(uint32_t t, const char* why) { st = LANDED; tLand = t; how = why; return LAND; }
  int update(float a, uint32_t now) {
    if (!(a == a)) return NONE;               // NaN sample
    switch (st) {
      case WAIT:
        if (a > launchG) {
          if (!above) {
            above = true; tAbove = now;
            if (inFall && (int32_t)(now - ffStart) >= (int32_t)dropFallMs) { hadFall = true; lastFall = now; }
            inFall = false;
            pushBad = hadFall && (int32_t)(now - lastFall) < (int32_t)dropWindowMs;   // a drop hitting the ground, not a shot
          }
          if (pushBad) break;
          // samples above 4 g spanning hold - one sample period = the push lasted about 20 ms
          if (now - tAbove + sampleSlackMs >= launchHoldMs) { st = FLYING; launched = true; tLaunch = tAbove; quiet = false; stillOn = false; ffMs = 0; tPrev = now; return LAUNCH; }
        } else {
          above = false; pushBad = false;
          if (a < dropG) { if (!inFall) { inFall = true; ffStart = now; } }
          else if (inFall) { if ((int32_t)(now - ffStart) >= (int32_t)dropFallMs) { hadFall = true; lastFall = now; } inFall = false; }
        }
        break;
      case FLYING:
        if ((int32_t)(now - tLaunch) >= (int32_t)flightTimeoutMs) return land(now, "timeout");
        // a real flight has free fall (|a| well under 1 g, drag and tether only); a bump on the bench does not
        // a tumbling dart may never read under 0.6 g (spin), so 200 ms after launch with the push over also counts
        if (!quiet) {
          uint32_t dt = now - tPrev; tPrev = now;
          if (a < freeFallG) { ffMs += dt > 20 ? 20 : dt; if (ffMs >= freeFallMs) quiet = true; }
          if ((int32_t)(now - tLaunch) >= (int32_t)pushOverMs && a < launchG) quiet = true;
          if (!quiet) break;
        }
        if ((int32_t)(now - tLaunch) < (int32_t)minFlightMs) break;
        if (a > impactG) { st = IMPACTED; tImpact = now; stillOn = false; break; }
        if (a > stillLo && a < stillHi) { if (!stillOn) { stillOn = true; tStill = now; } if (now - tStill >= softStillMs) return land(tStill, "still"); }
        else stillOn = false;
        break;
      case IMPACTED:
        if ((int32_t)(now - tLaunch) >= (int32_t)flightTimeoutMs) return land(tImpact, "timeout");
        if (a > impactG) { tImpact = now; stillOn = false; break; }
        if (a > stillLo && a < stillHi) { if (!stillOn) { stillOn = true; tStill = now; } if (now - tStill >= stillMs) return land(tImpact, "impact"); }
        else stillOn = false;
        break;
      default: break;
    }
    return NONE;
  }
  int poll(uint32_t now) {                    // called every tick: the timeout must fire even with no IMU samples
    if (flying() && (int32_t)(now - tLaunch) >= (int32_t)flightTimeoutMs) return land(st == IMPACTED ? tImpact : now, "timeout");
    return NONE;
  }
};

// ---------------------------------------------------------------------------------------------------------------
// Flight log: 50 Hz ring of (t, quaternion, acceleration). 12 s = 600 samples x 20 bytes = 12 kB.
struct Sample { uint32_t t; int16_t q[4]; int16_t a[3]; int16_t pad; };   // q in 1/16384, a in 0.01 m/s^2
template <int N>
struct FlightLog {
  Sample buf[N]; int head = 0, count = 0;
  bool frozen = false, freezePending = false; uint32_t freezeAt = 0, winStart = 0; bool haveWin = false;
  uint32_t nextT = 0; bool started = false;
  static int16_t q14(float v) { float x = v * 16384.f; if (x > 32767) x = 32767; if (x < -32767) x = -32767; return (int16_t)lrintf(x); }
  static int16_t a100(float v) { float x = v * 100.f; if (x > 32767) x = 32767; if (x < -32767) x = -32767; return (int16_t)lrintf(x); }
  void clear() { head = count = 0; frozen = freezePending = haveWin = started = false; freezeAt = winStart = nextT = 0; }
  void unfreeze() { frozen = freezePending = haveWin = false; }
  // offer a sample; stored when the 20 ms slot is due (keeps a 50 Hz grid, resyncs after a gap)
  bool offer(uint32_t now, const float q[4], const float a[3]) {
    if (frozen) return false;
    if (started && (int32_t)(now - nextT) < 0) return false;
    if (!started || now - nextT > 40) nextT = now;
    started = true; nextT += 20;
    Sample& s = buf[head];
    s.t = now; for (int i = 0; i < 4; i++) s.q[i] = q14(q[i]); for (int i = 0; i < 3; i++) s.a[i] = a100(a[i]); s.pad = 0;
    head = (head + 1) % N; if (count < N) count++;
    return true;
  }
  void window(uint32_t start) { winStart = start; haveWin = true; }
  void scheduleFreeze(uint32_t at) { freezePending = true; freezeAt = at; }
  void poll(uint32_t now) { if (freezePending && (int32_t)(now - freezeAt) >= 0) { frozen = true; freezePending = false; } }
  const Sample& at(int i) const { return buf[(head - count + i + N) % N]; }   // 0 = oldest
};
static const int LOG_N = 600;
typedef FlightLog<LOG_N> Log;

// Streams /flightlog JSON in chunks (no big String on the heap). Works on a snapshot copy of the log.
struct LogJson {
  const Log* L; int stage = 0, i = 0; const char* phase = ""; bool launched = false, landedF = false; uint32_t tLaunch = 0, tLand = 0;
  const char* how = ""; uint32_t lo = 0; bool first = true;
  void begin(const Log* log, const char* ph, bool hasLaunch, uint32_t tl, bool hasLand, uint32_t td, const char* howLanded) {
    L = log; stage = 0; i = 0; phase = ph; launched = hasLaunch; tLaunch = tl; landedF = hasLand; tLand = td; how = howLanded; first = true;
    lo = (L->haveWin && launched) ? L->winStart : 0;
  }
  bool keep(const Sample& s) const { return !(L->haveWin && launched) || (int32_t)(s.t - lo) >= 0; }
  int countKept() const { int n = 0; for (int k = 0; k < L->count; k++) if (keep(L->at(k))) n++; return n; }
  // fills buf (cap >= 256) and returns the byte count; 0 = finished
  int chunk(char* buf, int cap) {
    int n = 0;
    if (stage == 0) {
      char tl[16] = "null", td[16] = "null";
      if (launched) snprintf(tl, sizeof tl, "%lu", (unsigned long)tLaunch);
      if (landedF) snprintf(td, sizeof td, "%lu", (unsigned long)tLand);
      n = snprintf(buf, cap, "{\"hz\":50,\"frozen\":%s,\"phase\":\"%s\",\"t_launch_ms\":%s,\"t_land_ms\":%s,\"landing\":%s%s%s,"
                   "\"n\":%d,\"fields\":[\"t_ms\",\"qw\",\"qx\",\"qy\",\"qz\",\"ax\",\"ay\",\"az\"],\"samples\":[",
                   L->frozen ? "true" : "false", phase, tl, td, landedF ? "\"" : "", landedF ? how : "null", landedF ? "\"" : "", countKept());
      stage = 1; return n;
    }
    if (stage == 1) {
      while (i < L->count && cap - n > 100) {
        const Sample& s = L->at(i++);
        if (!keep(s)) continue;
        n += snprintf(buf + n, cap - n, "%s[%lu,%.4f,%.4f,%.4f,%.4f,%.2f,%.2f,%.2f]", first ? "" : ",", (unsigned long)s.t,
                      s.q[0] / 16384.f, s.q[1] / 16384.f, s.q[2] / 16384.f, s.q[3] / 16384.f, s.a[0] / 100.f, s.a[1] / 100.f, s.a[2] / 100.f);
        first = false;
      }
      if (i >= L->count) stage = 2;
      if (n) return n;
    }
    if (stage == 2) { stage = 3; return snprintf(buf, cap, "]}"); }
    return 0;
  }
};

// ---------------------------------------------------------------------------------------------------------------
struct Kedge {
  Io io; Tuning tu;
  int dir[NMOT] = {0, 0, 0, 0};
  uint32_t until[NMOT] = {0, 0, 0, 0};
  int spd = 255;
  int seq = IDLE; uint32_t seqT0 = 0, condT = 0, motT0[NMOT] = {0, 0, 0, 0}, seqStart = 0;
  float lastMa = 0, peakMa = 0, fMa = 0; char lastEvent[64] = "boot";   // fMa: filtered current for stall decisions
  int fault = F_NONE;
  bool armed = false, autoOnLanding = true, landed = false, landedFresh = false; uint32_t armT = 0;
  bool podLead = false; float kickPos = 0; uint32_t lastTickT = 0; bool tickSeen = false;   // kickPos: leg travel estimate, ms at full duty from folded
  float kickRaw = 0;                                    // leg travel like kickPos but not clamped to kickSwingMs
  bool capHit[NMOT] = {false, false, false, false};     // the current stall lock came from the hold cap (refusal text)
  bool leadLowOn = false; uint32_t leadLowT = 0;        // pods lead: deploy drawing nothing
  bool kickKnown = true;                                // kickPos is trusted (power-on with the legs folded, or after a fold to the stop)
  bool kickOverPair = false;                            // last pair reading said the leg (as the paused worm) is at stall
  bool deployOverPair = false;                          // same for the pods worm
  float deployPos = 0, deployOutOk = 0; bool deployKnown = true;         // pods travel estimate, ms at full duty from stowed (like kickPos)
  float deployBackStart = 0, deployBackDone = 0, deployBackOk = 0, kickBackOk = 0;   // release: travel back, last counted while not at stall
  bool freshHold[NMOT] = {false, false, false, false};  // presses were refused (busy, flight, fault): the next accepted one starts a new hold
  float kickBackStart = 0, kickBackDone = 0;            // leg fold: estimated travel out at the start, real travel counted back
  bool drillsStalled = false;                           // drills stopped for a stall are not re-driven in the next step
  uint32_t warn = 0;                                    // warnings of the last sequence (bits, see warnNames)
  bool inaOk = true, imuOk = true; int inaFails = 0;
  uint32_t tripT = 0, lowT = 0, manT = 0; bool tripOn = false, lowOn = false, manOn = false;
  int stallLock[NMOT] = {0, 0, 0, 0}; uint32_t lastCmd[NMOT] = {0, 0, 0, 0};   // a held key that stalled stays off until released
  uint32_t heldStart[NMOT] = {0, 0, 0, 0};             // when the current manual hold began
  int lastKeyDir[NMOT] = {0, 0, 0, 0}; bool bothLock[NMOT] = {false, false, false, false};
  uint32_t pressT[NMOT][2] = {}; bool pressSeen[NMOT][2] = {};   // last press of each direction ([0] = -1, [1] = +1), refused or not                 // direction of the last accepted key per motor (hold continuity)
  // pair check state (two motors share the INA219, see pairCheck)
  uint32_t pulseT = 0; bool paused = false, readDone = false; int pz = -1, hitsMain = 0, hitsOther = 0, hitsNoRise = 0, hitsRise = 0, nReads = 0, underRun = 0, pairKey = -1; bool riseSeen = false; float riseBase = 0;
  float bothMa = -1, soloMa = -1, bothMin = -1, diffMin = -1, bothRing[4] = {-1, -1, -1, -1}, railV = -1; bool needRise = false;
  uint32_t lastRunMs[NMOT] = {0, 0, 0, 0};
  Flight flight; Log log;
  float accG = 1.0f, peakG = 0;                        // peakG: highest |a| since the last arm
  uint32_t lowT2 = 0; bool lowOn2 = false;
  bool video = true;                                   // video power (camera + VTX), see PIN_VIDEO_GPIO
  float battV = -1; int batt = B_UNKNOWN; uint32_t lastRunT = 0; bool runSeen = false;   // battery at rest
  float upF = 1; int upN = 0; uint32_t upT = 0;        // orientation: filtered cosine of the tilt, still samples, last one
  float gF[3] = {0, 0, 1};                             // filtered gravity direction (unit vector, chip axes) while still
  // v4.1 anchoring and release state
  bool millPause = false, milled = false, rocking = false; uint32_t millUntil = 0, progT = 0, lastReadT = 0; float progPos = 0, deployEst = 0;
  int rocks = 0; float soilMa = -1; int guardHits = 0; bool guardOn = false; uint32_t guardT = 0; uint32_t millEndT = 0, millDurMs = 0;
  // v4.3 righting: moves made (all, belly up, on a flank), pods left out by a pod roll, /auto?force=1, when the dart went over
  int rightN = 0, rightInv = 0, rightSide = 0; bool rollOut = false, forceAnchor = false; uint32_t overT = 0;
  float g0[3] = {0, 0, 0}; bool g0ok = false, moving = false, moveOn = false; uint32_t moveT = 0;   // anchor motion (ANCHORED)

  // ---- orientation (BNO085 accelerometer while still)
  float tiltDeg() const { float c = upF > 1 ? 1 : upF < -1 ? -1 : upF; return acosf(c) * 57.29578f; }
  static float axisVal(const float v[3], int ax) { int i = ax < 0 ? -ax : ax; return (i >= 1 && i <= 3) ? v[i - 1] * (ax < 0 ? -1.f : 1.f) : 0.f; }
  bool noseKnown() const { int u = tu.imuUpAxis < 0 ? -tu.imuUpAxis : tu.imuUpAxis, n = tu.imuNoseAxis < 0 ? -tu.imuNoseAxis : tu.imuNoseAxis; return n >= 1 && n <= 3 && u >= 1 && u <= 3 && n != u; }
  // body roll and pitch in degrees from the filtered gravity (needs imuNoseAxis); left = up x nose
  void rollPitch(float& roll, float& pitch) const {
    int u = tu.imuUpAxis < 0 ? -tu.imuUpAxis : tu.imuUpAxis, n = tu.imuNoseAxis < 0 ? -tu.imuNoseAxis : tu.imuNoseAxis, k = 6 - u - n;
    float su = tu.imuUpAxis < 0 ? -1.f : 1.f, sn = tu.imuNoseAxis < 0 ? -1.f : 1.f;
    float eps = ((u % 3) + 1 == n) ? 1.f : -1.f;        // e_u x e_n = +e_k for cyclic (u, n, k), else -e_k
    float gU = su * gF[u - 1], gN = sn * gF[n - 1], gL = su * sn * eps * gF[k - 1];
    pitch = asinf(gN > 1 ? 1 : gN < -1 ? -1 : gN) * 57.29578f;
    roll = atan2f(gL, gU) * 57.29578f;
  }
  int orient(uint32_t now) const {
    if (!imuOk || upN < 20 || (int32_t)(now - upT) > 2000) return O_UNKNOWN;
    if (!noseKnown()) { float t = tiltDeg(); return t < tu.uprightMaxDeg ? O_UPRIGHT : t > tu.invertedMinDeg ? O_INVERTED : O_SIDE; }
    float roll, pitch; rollPitch(roll, pitch); float ar = fabsf(roll);
    if (pitch < -60.f) return O_NOSE_DOWN;              // steep: roll means little
    if (pitch > 60.f) return O_NOSE_UP;
    if (ar > tu.invertedMinDeg) return O_INVERTED;
    if (ar > tu.sideRollDeg) return O_SIDE;
    if (pitch < tu.pitchMinDeg) return O_NOSE_DOWN;
    if (pitch > tu.pitchMaxDeg) return O_NOSE_UP;
    return ar > tu.levelRollDeg ? O_LEANING : O_UPRIGHT;
  }
  // the tilt can be used (fresh still readings from a live BNO085): the righting needs it
  bool tiltKnown(uint32_t now) const { return imuOk && upN >= 20 && (int32_t)(now - upT) <= 2000 && tu.imuUpAxis != 0; }
  void orientSample(const float a[3], uint32_t now) {
    float n = sqrtf(a[0] * a[0] + a[1] * a[1] + a[2] * a[2]) / 9.80665f;
    if (seq == DONE) motionCheck(n, now); else { moving = moveOn = false; g0ok = false; }
    int ax = tu.imuUpAxis < 0 ? -tu.imuUpAxis : tu.imuUpAxis;
    if (!(n > 0.85f && n < 1.15f) || ax < 1 || ax > 3) return;   // only while still (|a| near 1 g)
    float c = axisVal(a, tu.imuUpAxis) / (n * 9.80665f), u[3] = {a[0] / (n * 9.80665f), a[1] / (n * 9.80665f), a[2] / (n * 9.80665f)};
    if (upN == 0 || (int32_t)(now - upT) > 2000) { upF = c; upN = 0; for (int i = 0; i < 3; i++) gF[i] = u[i]; }
    else { upF += 0.05f * (c - upF); for (int i = 0; i < 3; i++) gF[i] += 0.05f * (u[i] - gF[i]); }   // about 0.1 s at 200 Hz
    if (upN < 1000) upN++;
    upT = now;
  }
  // anchored: the dart tilting or shaking means the anchor is moving under the tow (dart-physics: 2 deg or 0.15 g, 200 ms)
  void motionCheck(float nG, uint32_t now) {
    if (!imuOk) { moving = moveOn = false; return; }
    if (!g0ok) { if (upN >= 20 && (int32_t)(now - upT) < 500) { for (int i = 0; i < 3; i++) g0[i] = gF[i]; g0ok = true; } return; }
    float d = g0[0] * gF[0] + g0[1] * gF[1] + g0[2] * gF[2], ng = sqrtf(gF[0] * gF[0] + gF[1] * gF[1] + gF[2] * gF[2]);
    float ang = acosf(ng > 0 ? (d / ng > 1 ? 1 : d / ng < -1 ? -1 : d / ng) : 1) * 57.29578f;
    bool m = ang > tu.moveDeg || fabsf(nG - 1.f) > tu.moveG;
    bool was = moving;
    moving = heldT(m, moveOn, moveT, tu.moveHoldMs, now);
    if (moving && !was) { char b[64]; snprintf(b, sizeof b, "anchor moving (tilt %.1f deg, %.2f g)", ang, nG); ev(b); }
  }
  // ---- video power
  const char* setVideo(bool on, const char* why) {
    if (on != video || !why) { video = on; if (io.setVideo) io.setVideo(on); }
    if (why) { char b[64]; snprintf(b, sizeof b, "video %s (%s)", on ? "on" : "off", why); ev(b); }
    return nullptr;
  }
  // ---- battery at rest (called every tick with the rail reading)
  void battUpdate(float v, uint32_t now) {
    if (running()) { lastRunT = now; runSeen = true; return; }
    if (!(v == v) || v < 0.f) return;                  // no reading: keep the last state
    int b = batt;
    if (v < 3.f) { battV = v; b = B_NONE; }            // power loop plug out (USB only)
    else {
      if (runSeen && now - lastRunT < tu.battRestMs) return;   // the cells recover for a moment after a motor stops
      battV = battV < 3.f ? v : battV + 0.02f * (v - battV);   // about 0.25 s at 200 Hz
      bool wasCrit = batt == B_CRIT, wasLow = batt == B_LOW || wasCrit;
      if (battV < tu.battCritV || (wasCrit && battV < tu.battCritV + tu.battHystV)) b = B_CRIT;
      else if (battV < tu.battLowV || (wasLow && battV < tu.battLowV + tu.battHystV)) b = B_LOW;
      else b = B_OK;
    }
    if (b == batt) return;
    batt = b; char m[64];
    if (b == B_CRIT) { snprintf(m, sizeof m, "battery critical (%.2f V at rest): charge it", battV); ev(m); if (video) setVideo(false, "battery critical"); }
    else if (b == B_LOW) { snprintf(m, sizeof m, "battery low (%.2f V at rest)", battV); ev(m); }
    else if (b == B_OK) { snprintf(m, sizeof m, "battery ok (%.2f V at rest)", battV); ev(m); }
    else ev("no battery (rail under 3 V: power loop plug out?)");
  }

  bool seqRunning() const { return (seq >= RT_LEG_OUT && seq <= D_AFTER) || (seq >= R_DRILL && seq <= R_KICK); }
  bool anchoring() const { return seq >= RT_LEG_OUT && seq <= D_AFTER; }
  bool releasing() const { return seq >= R_DRILL && seq <= R_KICK; }
  int phase() const {
    if (fault) return P_FAULT;
    if (releasing()) return P_RELEASING;
    if (anchoring()) return P_ANCHORING;
    if (flight.flying()) return P_FLIGHT;
    if (seq == DONE) return P_ANCHORED;
    if (landed && landedFresh && (seq == IDLE || seq == ABORTED) && !running()) return P_LANDED;   // not after a release or a hand move
    if (armed) return P_ARMED;
    return P_IDLE;
  }

  // bits keep their positions (API); foot_stalled, kick_plant_time_limit and kick_already_down are not raised on v34
  enum { W_FOOT_STALL = 1, W_DRILL_STALL = 2, W_PLANT_LIMIT = 4, W_PODS_LIMIT = 8, W_KICK_ALREADY = 16, W_DEPTH_LIMIT = 32, W_NBITS = 6 };
  static const char* warnName(int b) { static const char* n[] = {"foot_stalled", "drills_stalled", "kick_plant_time_limit", "pods_time_limit", "kick_already_down", "depth_limited"}; return n[b]; }
  float guardMa() const { return tu.drillGuardFrac * tu.drillPairStallMa * vScale(); }   // sequences run at full duty
  int duty() const { return seqRunning() ? 255 : spd; }   // sequences always run at full duty (stall currents are for 255)
  static float fin(float v) { return v == v && v < 1e9f && v > -1e9f ? v : 0.f; }
  void ev(const char* s) { strncpy(lastEvent, s, sizeof(lastEvent) - 1); lastEvent[sizeof(lastEvent) - 1] = 0; if (io.log) io.log(s); }
  void setFault(int f, const char* msg, uint32_t now) {
    armed = false; if (seq == D_DEPLOY) { millDurMs = now - seqT0; millEndT = now; }   // heat bookkeeping (hotMillMs)                                    // a fault must never be cleared by the automatic landing /auto
    if (!seqRunning()) for (int m = 0; m < NMOT; m++) if (dir[m]) { stallLock[m] = dir[m]; capHit[m] = false; }   // a held key stays off until released
    stopAll(now); if (seqRunning()) seq = ABORTED; fault = f; ev(msg); }

  // threshold for motor m: bench stall current scaled by rail voltage, and by PWM duty for manual runs
  float vScale() const { if (!(railV > 3.f)) return 1.f; float k = railV / tu.refV; return k < 0.6f ? 0.6f : k > 1.15f ? 1.15f : k; }
  float lim(float ma) const { float d = duty() / 255.f; return ma * vScale() * d * d; }   // slow decay: stall supply current ~ duty^2
  // stall threshold for motor m: never below 1.5 x its free current (free supply current goes ~ duty, so at low speed
  // the duty^2 stall line would cut into normal running)
  float stallLim(int m) const { float d = duty() / 255.f, a = lim(tu.stallMa[m]), b = 1.5f * tu.freeMa[m] * vScale() * d; return a > b ? a : b; }

  // Pair check: two motors share the INA219. Every 550 ms the self-locking worm ("main") stops for 150 ms and holds
  // its position while the other motor keeps turning and is read alone at 110 ms; the main motor's own current is
  // (both, read just before the pause) - (other alone). Pausing the worm, not the auger, keeps an auger in soil
  // turning, so a stopped screw never fakes a stall. Returns bit 1 = main stalled, bit 2 = other stalled
  // (2 readings in a row each).
  int pairCheck(int main, int other, float mainLim, float otherLim, uint32_t now) {
    uint32_t ph = now - pulseT;
    if (!paused) {
      if (ph >= 380 && ph < 400) bothMa = fMa;
      if (ph >= 400) { paused = true; pz = main; readDone = false; pulseT = now; io.setMotor(main, 0, 0); }
      return 0;
    }
    int r = 0;
    if (!readDone && ph >= 110) {
      readDone = true; soloMa = fMa; lastReadT = now;
      if (bothMa >= 0) {
        // sequences: the total must also have risen over the phase's lowest reading (guards against the auger's
        // current changing while the worm pauses, which biases both - alone). The rise asked for is a share of the
        // way from the worm's own lowest reading in this step (at least its free current) to the line, at least 25 mA,
        // so a worm already working hard on the ground still shows its stall
        float base = lim(tu.freeMa[main]); if (diffMin > base) base = diffMin;
        float need = tu.riseFrac * (mainLim - base); if (need < 25.f) need = 25.f;
        bool rose = !needRise || (bothMin >= 0 && bothMa - bothMin * vScale() > need)   // bothMin is kept at refV: a rail sag does not hide a rise
                    || soloMa < tu.noCurrentFrac * lim(tu.freeMa[other]);   // other draws nothing (open wire): nothing to fake with
        // once a reading showed the rise and the line together, later readings over the line count without the rise
        // (the ring of 4 forgets the level before the stall), until two readings in a row are under the line
        bool over = bothMa - soloMa > mainLim;
        if (!over) { if (++underRun >= 2) riseSeen = false; } else underRun = 0;
        bool hitR = over && (rose || (riseSeen && bothMa - riseBase * vScale() > need));   // still risen over the level before the rise
        if (over && rose && !riseSeen) { riseSeen = true; riseBase = bothMin; }
        hitsMain = hitR ? hitsMain + 1 : 0;
        hitsRise = ((hitsRise << 1) | (hitR ? 1 : 0)) & 0xF;   // one noisy miss does not reset it
        if (__builtin_popcount(hitsRise) >= 3 || __builtin_popcount(hitsRise & 7) >= 2) hitsMain = 2;   // 3 of 4, or 2 of the last 3 (noisy stall just over the line)
        if (main == KICK) kickOverPair = bothMa - soloMa > mainLim;
        if (main == DEPLOY) deployOverPair = bothMa - soloMa > mainLim;
        if (main == KICK && !kickOverPair) kickBackOk = kickBackDone;       // release: travel counted up to a reading under the line
        if (main == DEPLOY && !deployOverPair) { deployBackOk = deployBackDone; deployOutOk = deployPos; }
        // anchor: a reading over the line means the pods stopped somewhere since the last good reading; drop the travel
        // counted meanwhile (it was counted at full speed), so a soil stall is not mistaken for travel (v4.1 milling)
        if (main == DEPLOY && (!deployOverPair || deployPos > deployOutOk)) deployEst = deployPos;   // before the correction (at most one cycle long)
        if (main == DEPLOY && deployOverPair && seq == D_DEPLOY && deployPos > deployOutOk) deployPos = deployOutOk;
        if (other == DRILLS && seq == D_DEPLOY && deployPos > 0.4f * tu.podsTravelMs) {   // augers in the soil: soil reading
          float sm = soloMa / vScale(); if (sm > soilMa) soilMa = sm;
        }
        // a worm already at its stop when the step starts never shows a rise: 3 of the first 4 readings of the step
        // over the line also count (one noisy reading does not spoil it). Only at the start: a stop reached later
        // shows a rise, and an auger whose current drops during the pause could otherwise fake a stall
        if (nReads < 100) nReads++;
        hitsNoRise = ((hitsNoRise << 1) | (bothMa - soloMa > mainLim ? 1 : 0)) & 0xF;
        if (nReads <= 4 && __builtin_popcount(hitsNoRise) >= 3) hitsMain = 2;
        // lowest of the last 4 readings (not of the whole step): an auger whose current falls during the step
        // (crust, then soft soil) does not hide a later stall
        for (int k = 3; k > 0; k--) bothRing[k] = bothRing[k - 1];
        bothRing[0] = bothMa / vScale(); bothMin = -1;   // stored at refV
        for (int k = 0; k < 4; k++) if (bothRing[k] >= 0 && (bothMin < 0 || bothRing[k] < bothMin)) bothMin = bothRing[k];
        if (diffMin < 0 || bothMa - soloMa < diffMin) diffMin = bothMa - soloMa;
      }
      hitsOther = soloMa > otherLim ? hitsOther + 1 : 0;
      if (hitsMain >= 2) r |= 1;
      if (hitsOther >= 2) r |= 2;
    }
    if (ph >= 150) { endPause(); pulseT = now; }
    return r;
  }
  void endPause() { if (paused && pz >= 0 && dir[pz]) io.setMotor(pz, dir[pz], duty()); paused = false; pz = -1; bothMa = -1; }
  void pairReset(uint32_t now) { endPause(); pulseT = now; readDone = false; hitsMain = hitsOther = hitsNoRise = hitsRise = nReads = underRun = 0; riseSeen = false; soloMa = -1; bothMin = -1; diffMin = -1; for (float& b : bothRing) b = -1; condT = 0; kickOverPair = false; deployOverPair = false; }
  // stall of main (and of other while it runs): pair check while both run, plain threshold once other has stopped
  int stallPair(int main, int other, uint32_t now) {
    if (dir[other] && dir[main]) { needRise = true; return pairCheck(main, other, stallLim(main), stallLim(other), now); }
    if (paused) endPause();
    return (now - motT0[main] > tu.surgeIgnoreMs && held(fMa > stallLim(main), tu.stallHoldMs, now)) ? 1 : 0;
  }
  bool soloStalled(int m, uint32_t now, uint32_t hold = 0) { return dir[m] && now - motT0[m] > tu.surgeIgnoreMs && held(fMa > stallLim(m), hold ? hold : tu.stallHoldMs, now); }

  void drive(int m, int d, uint32_t ms, uint32_t now) {
    if (d && dir[m] != d) motT0[m] = now;     // a repeat of the same command keeps its start time (stall timer)
    dir[m] = d; until[m] = d ? now + ms : 0;
    if (!d && m == pz) { paused = false; pz = -1; }
    if (d && paused && m == pz) return;       // held off by the pair check for a moment; it restarts the motor itself
    io.setMotor(m, d, d ? duty() : 0);
  }
  void stopAll(uint32_t now) { for (int m = 0; m < NMOT; m++) drive(m, 0, 0, now); paused = false; pz = -1; pairKey = -1; }
  bool running() const { for (int m = 0; m < NMOT; m++) if (dir[m]) return true; return false; }

  // boot: called once by the sketch with the reset cause (F_BROWNOUT / F_WATCHDOG / F_NONE)
  // kickStowed: true after a power-on (leg and pods folded, as README asks); false after a brownout, crash, OTA or
  // software reset, when they may be out (the next /auto folds the leg to its stop first; pods checks wait for a release)
  void boot(int resetFault, uint32_t now, bool kickStowed = true) {
    setVideo(true, nullptr);                          // camera and VTX on (if the switch is fitted)
    stopAll(now); kickKnown = kickStowed; kickPos = 0; kickRaw = 0; deployKnown = kickStowed; deployPos = 0;
    if (resetFault) { fault = resetFault; char b[64]; snprintf(b, sizeof b, "boot after %s reset, motors off", faultName(resetFault)); ev(b); }
    else ev("boot, motors off");
  }

  // returns nullptr when accepted, else the reason
  // disarm=false (GET /stop?disarm=0) stops the motors but keeps the landing detector armed and flight tracking going
  const char* stop(uint32_t now, bool disarm = true) {
    bool wasSeq = seqRunning();
    if (seq == D_DEPLOY) { millDurMs = now - seqT0; millEndT = now; }   // heat bookkeeping (hotMillMs)
    // explicit STOP: a key that any client is still repeating (running, in a deadman gap, or refused while a sequence
    // ran) cannot restart its motor until it has been released
    if (disarm) for (int m = 0; m < NMOT; m++) {
      uint32_t w = tu.wifiDeadmanMs + 250;
      bool neg = pressSeen[m][0] && (int32_t)(now - pressT[m][0]) < (int32_t)w;
      bool pos = pressSeen[m][1] && (int32_t)(now - pressT[m][1]) < (int32_t)w;
      if (dir[m] && !wasSeq) { if (dir[m] > 0) pos = true; else neg = true; }
      if (pos && neg) { bothLock[m] = true; lastCmd[m] = now; }               // both keys of this motor still held: lock both
      else if (pos || neg) { int d = pos ? 1 : -1; stallLock[m] = d; capHit[m] = false; lastCmd[m] = now; lastKeyDir[m] = d; }
    }
    stopAll(now);
    if (wasSeq) seq = ABORTED;
    if (disarm) {
      if (flight.flying()) { flight.land(now, "stop"); landed = true; landedFresh = true; uint32_t fr = now + 3000, cap = freezeCap(); log.scheduleFreeze((int32_t)(fr - cap) > 0 ? cap : fr); }
      armed = false;
    }
    fault = F_NONE;
    ev(wasSeq ? "stop: sequence aborted" : "stop");
    return nullptr;
  }
  // v4.3 (dart v34): righting first when the dart is not belly down (see Tuning), then the pods down with the drills.
  // force: /auto?force=1 (no righting: anchor as it lies, for an IMU whose axes are wrong or a picture that shows it upright)
  const char* startAuto(uint32_t now, bool force = false) {
    if (flight.flying()) return "in flight";
    if (anchoring()) return nullptr;                  // already running: a repeated request is not an error
    if (seqRunning()) return "busy";
    if (seq == DONE) return "already anchored, release first";
    if (!inaOk) return "no current sensor";          // refuse before changing anything
    if (batt == B_CRIT) return "battery low: charge it (release still works)";   // never anchor without the charge to let go
    if (millDurMs > tu.hotMillMs && now - millEndT < tu.hotRestMs) return "motors hot after a long milling: wait 60 s";
    if (armed) { armed = false; ev("auto: disarmed first (the launch was not seen)"); }
    stopAll(now); pairReset(now); fault = F_NONE; armed = false; warn = 0; drillsStalled = false;
    millPause = milled = rocking = false; rocks = 0; soilMa = -1; guardHits = 0; guardOn = false;
    rightN = rightInv = rightSide = 0; forceAnchor = force;
    rollOut = !deployKnown || deployPos > 0.05f * tu.podsTravelMs;   // pods left out (a stopped anchor): folded before a righting move
    seqStart = now; peakMa = 0;
    if (!legFolded()) { startLegFold(now, "auto: leg to its fold stop first"); return nullptr; }   // the pods never deploy with the leg out
    assess(now);
    return nullptr;
  }
  // the leg is known to be in its groove (within 2 % of its swing, about 3.5 deg, of the fold stop)
  bool legFolded() const { return kickKnown && kickPos <= 0.02f * tu.kickSwingMs; }
  // the anchor proper: pods down with the drills spinning (milling, deploy guard), drills finishing, anchored
  void startDeploy(uint32_t now, const char* why) {
    stopAll(now); drive(DEPLOY, +1, tu.deployMaxMs, now); podLead = true; seq = D_DEPLOY; seqT0 = now; pairReset(now); deployOutOk = deployPos; ev(why);
  }
  // release: the pods are up; the leg folds only when it is not known to be folded already
  void releaseLeg(uint32_t now, const char* why) {
    if (legFolded()) { stopAll(now); released(now); return; }
    stopAll(now); seq = R_KICK; seqT0 = now; pairReset(now); kickBackStart = kickPos; kickBackDone = kickBackOk = 0;
    drive(KICK, -1, tu.kickMaxMs, now); char b[64]; snprintf(b, sizeof b, "%s, leg folding", why); ev(b);
  }
  void released(uint32_t now) {
    (void)now; seq = RELEASED; deployPos = 0; deployKnown = true; landedFresh = false; ev("release: done, legs stowed");
  }
  void startLegFold(uint32_t now, const char* why) {
    stopAll(now); seq = RT_LEG_BACK; seqT0 = now; pairReset(now); kickBackStart = kickPos; kickBackDone = kickBackOk = 0;
    drive(KICK, -1, tu.kickMaxMs, now); ev(why);
  }
  // reads the attitude (the dart is still) and picks the next step: anchor, fold the pods, a righting move, or give up
  void assess(uint32_t now) {
    char b[64];
    if (forceAnchor) { startDeploy(now, "auto: forced, no righting: deploy with drills spinning"); return; }
    if (!tiltKnown(now)) { startDeploy(now, "auto: attitude unknown, no righting: deploy + drills"); return; }
    float tilt = tiltDeg();
    if (tilt < (rightN ? tu.rightAcceptDeg : tu.rightedMaxDeg)) {   // after a move the pods hold it: up to 20 deg is upright enough
      if (rightN) snprintf(b, sizeof b, "auto: upright after %d righting move%s (tilt %.0f deg), deploy", rightN, rightN > 1 ? "s" : "", tilt);
      else snprintf(b, sizeof b, "auto: upright (tilt %.0f deg), deploy with drills spinning", tilt);
      startDeploy(now, b); return;
    }
    if (rollOut) {                                    // a pod roll that did not right it: pods back up before the next move
      stopAll(now); seq = RT_PODS_BACK; seqT0 = now; pairReset(now); deployBackStart = deployPos; deployBackDone = deployBackOk = 0;
      drive(DEPLOY, -1, tu.podsPlainMaxMs, now); ev("righting: pods back up first"); return;
    }
    if (rightN >= tu.rightTries) {
      snprintf(b, sizeof b, "auto: not upright after %d righting moves (tilt %.0f deg)", rightN, tilt);
      setFault(F_NOT_UPRIGHT, b, now); return;
    }
    // belly up: the leg flips it end over end; on a flank: the pods roll it (every 4th flank move a leg flip, as the sim)
    bool inv = tilt > tu.rightInvDeg, leg = inv || rightSide % 4 == 3;
    if (inv) rightInv++; else rightSide++;
    rightN++; stopAll(now); seqT0 = now; pairReset(now); overT = 0;
    if (leg) { seq = RT_LEG_OUT; drive(KICK, +1, tu.legOutMaxMs, now); }
    else { seq = RT_PODS; drive(DEPLOY, +1, tu.rollMaxMs, now); }
    snprintf(b, sizeof b, "righting %d: %s (tilt %.0f deg)", rightN, leg ? "leg flip" : "pods roll it, drills off", tilt); ev(b);
  }
  // deploy guard hit: stop the pods where they are (and the drills), anchored with warning depth_limited
  void depthLimit(uint32_t now) {
    drive(DEPLOY, 0, 0, now); drive(DRILLS, 0, 0, now); millPause = false; warn |= W_DEPTH_LIMIT;
    if (deployKnown && deployPos > deployOutOk) deployPos = deployOutOk;   // best estimate of where the pods stopped
    millDurMs = now - seqT0; millEndT = now; seq = DONE; pairReset(now);
    char b[64]; snprintf(b, sizeof b, "auto: drills at %.0f %% of stall: depth limited, anchored", 100.f * tu.drillGuardFrac); ev(b);
  }
  const char* startRelease(uint32_t now) {
    if (flight.flying()) return "in flight";
    if (releasing()) return nullptr;                  // already running
    if (seqRunning()) return "busy";
    if (!inaOk) return "no current sensor";
    stopAll(now); pairReset(now); fault = F_NONE; armed = false; warn = 0; millPause = rocking = false; rocks = 0; forceAnchor = false;
    seq = R_DRILL; seqT0 = seqStart = now; peakMa = 0; drive(DRILLS, -1, tu.drillLeadMs, now); ev("release: drills out");
    return nullptr;
  }
  const char* arm(bool on, bool withAuto, uint32_t now) {
    if (!on) { armed = false; ev("disarmed"); return nullptr; }
    if (seqRunning()) return "busy";
    if (flight.flying()) return "in flight";
    if (!imuOk) return "no IMU";
    if (seq == DONE) return "anchored: release first";
    if ((kickKnown && kickPos > 0.1f * tu.kickSwingMs) || (deployKnown && deployPos > 0.1f * tu.podsTravelMs)) return "legs out: release first";   // legs out: arming would forget that
    if (withAuto && !inaOk) return "no current sensor";
    if (withAuto && !running() && railV >= 0.f && railV < tu.armMinV) return "battery low";   // includes 0 V (plug out); log-only arm still allowed
    // the moment of arming counts as still, so a shot right after the arm is still seen
    flight.reset(); flight.armedAt(now); armT = now; log.unfreeze(); landed = false; landedFresh = false; peakG = 0; armed = true; autoOnLanding = withAuto; fault = F_NONE;
    if (seq == ABORTED || seq == RELEASED) seq = IDLE;   // a new shot
    ev(withAuto ? "armed: auto-anchor on landing" : "armed: log only");
    if (!video) setVideo(true, "armed: the flight is filmed");
    return nullptr;
  }
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
