HarryHYu/GrappStar/firmware/base/grappstar_base/base_logic.h

// GrappStar base station logic: one wiper motor (BTS7960 + AS5600) and the N20 selector drum (DRV8833).
// Plain C++ (no Arduino calls): the sketch supplies the hardware through Io, the PC tests supply a simulation.
// Protocol: PROTOCOL.md (contract C1, JSON lines over USB CDC). Mechanism: base/spec/BASE_SPEC.md.
//
// Drum travel (one line, params.DRUM): LAUNCH -- L_TO_N -- NEUTRAL -- WRAP_PREP -- WRAP (the cup lays 7 turns) --
// N_TO_R (WRAPPED park 314, collar still NEUTRAL) -- REEL. The order is physical: the capstan is wrapped with the collar
// in NEUTRAL, REEL is only reached with the wraps on, and LAUNCH only with them off.
// LAUNCH: wiper aimDir turns the aim train (pitch from the aim table), the other direction cocks, fires and resets.
// REEL (and WRAPPED): wiper reelDir winds the capstan. NEUTRAL: the wiper turns nothing (the safe state).
#pragma once
#include <stdint.h>
#include <stdio.h>
#include <string.h>
#include <math.h>
#include "config.h"
#include "json_lite.h"
#include "sensors.h"
#include "drives.h"
#include "persist.h"

namespace gb {

#define GB_FW_VERSION "base-1.3.1"

enum Fault { F_NONE, F_STALL, F_OVERCURRENT, F_DRUM_TIMEOUT, F_DRUM_SENSOR, F_ANGLE_SENSOR, F_SWITCH_DISAGREE, F_BROWNOUT, F_BAD_STATE, F_DART_STUCK };
static const char* const FAULT_NAME[] = {nullptr, "STALL", "OVERCURRENT", "DRUM_TIMEOUT", "DRUM_SENSOR", "ANGLE_SENSOR",
                                         "SWITCH_DISAGREE", "BROWNOUT", "BAD_STATE", "DART_STUCK"};

enum State { S_IDLE, S_DRUM, S_AIM, S_COCK, S_FIRE, S_WRAP, S_UNWRAP, S_REEL, S_HOLD, S_JOG, S_CALDRUM, S_SAFING, S_FAULT, S_DECOCK };
static const char* const STATE_NAME[] = {"IDLE", "MODE", "AIM", "COCK", "FIRE", "WRAP", "UNWRAP", "REEL", "HOLD", "JOG",
                                         "CAL", "SAFING", "FAULT", "DECOCK"};

enum Phase { PH_REST, PH_COCKING, PH_COCKED, PH_FIRING, PH_RESETTING, PH_UNKNOWN };
static const char* const PHASE_NAME[] = {"REST", "COCKING", "COCKED", "FIRING", "RESETTING", "UNKNOWN"};

enum Until { U_STOP, U_SEATED, U_TENSION, U_SLIP, U_TIME };

struct Io {
  void (*wiper)(int dir, int duty) = nullptr;     // BTS7960: dir +1 RPWM, -1 LPWM, 0 both low (brake); duty 0..255
  void (*drum)(int dir, int duty) = nullptr;      // DRV8833 channel A: dir +1 / -1, 0 = brake (both inputs high)
  void (*drumSleep)(bool awake) = nullptr;        // nSLEEP
  int (*angle)(uint8_t* status) = nullptr;        // AS5600 raw 0..4095 or -1 on an I2C error; *status = STATUS register
  float (*wiperIsVolts)() = nullptr;              // volts at the IS pin
  float (*vbat)() = nullptr;                      // battery volts, NAN if not wired
  uint16_t (*switches)() = nullptr;               // bit i = contact on PIN_SW_(A+i) closed
  float (*hxRaw)() = nullptr;                     // HX711 counts, NAN if absent or no new sample
  void (*save)(const Saved& s) = nullptr;         // persist (the sketch writes NVS outside the tick)
  void (*saveTun)(const Tun& t) = nullptr;        // bench settings (set / cal)
  void (*out)(const char* line) = nullptr;        // event line to the host (queued by the sketch)
  uint32_t (*rand32)() = nullptr;                 // token source (esp_random on the ESP32)
};
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
