HarryHYu/GrappStar/(commit log)

2026-11-02 Add system plan, Harry's messages and pastes, and every original source file
    [01_gear.stl, 02_axle_crank.stl, 02_drive_gear.stl, 03_axle.stl, 03_axle_head.stl, 03_carriage.stl, 04_carriage.stl, 04_dart.stl]
2026-11-02 Add the KEDGE project: generators, pipelines, firmware, ground station v1 source
    [01_gear.stl, 02_drive_gear.stl, 03_axle.stl, 04_carriage.stl, 05_dart.stl, 06_rail_body.stl, 07_frame.stl, 08_pinion.stl]
2026-11-02 Add ground station v1 print pack, STEP, HD sim, assembly steps and site files
    [as5600_bracket.step, as5600_bracket.stl, base_1.step, base_1.stl, base_2.step, base_2.stl, base_3.step, base_3.stl]
2026-11-02 Add dart v29 and v30 print packs and assembly STEPs
    [KEDGE_v29_assembly_folded.step, KEDGE_v30_assembly_folded.step, barrel_keepout.stl, barrel_profile.dxf, coupler_L.step, coupler_L.stl, coupler_R.step, coupler_R.stl]
2026-11-02 Add dart v29 and v30 model data and distribution zips
    [_tmp.stl, antenna.stl, ballast.stl, barrel_keepout.stl, barrel_profile.dxf, bms_2s.stl, bno085.stl, brg_ear.stl]
2026-11-02 cad-infra: API v1 README and package skeleton
    Claude-Session: https://claude.ai/code/session_01Y9T2M7xeBSYoEFK93RSkJe
2026-11-02 firmware/base: pins, JSON, sensors, drives, persistence, params generator (WIP)
2026-11-02 physics: shared parameter blocks (battery, wiper, spring, line, dart, parts)
2026-11-02 cad-infra: core API, assembly, audit, timeline, tests
    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
2026-11-02 cad-infra: demo subsystem (placeholder gears until the gear lib lands), grounded() hook
    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
2026-11-02 jetson: package skeleton, interfaces, C1 base client and mock base, C2 dart client and mock dart
    Claude-Session: https://claude.ai/code/session_01Y9T2MArQjFyXqqrY1x14Ci
2026-11-02 firmware/dart: v4 logic (pin map without DRV#3, release, phase, faults, flight detection, flight log) and 118 PC tests
2026-11-02 Add base spec v0.1: concept, frame, ownership, sensor names
    Claude-Session: https://claude.ai/code/session_01Y9T2MA1da8uJdcpXwDwLHT
2026-11-02 cad-infra: world frame per BASE_SPEC section 2, timeline reads P.TIMELINE and P.DRUM
    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
2026-11-02 firmware/dart: v4 sketch (raw INA219 with failure detection, watchdog, reset reason, WiFi-loss stop, /release /arm /flightlog)
    [kedge_dart.ino, kedge_logic.h]
2026-11-02 cad-infra lib: gears (spur, internal, rack, gear math, Lewis)
    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
2026-11-02 cad-infra lib: bearings, shafts, fasteners, clutch
    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
2026-11-02 cad-infra: ignore pycache
    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
2026-11-02 firmware/base: base logic, sim and tests (WIP, tests failing)
    [base_logic.h, config.h, sim.h, test_base.cpp]
2026-11-02 physics: launch (chain spring model), flight (bead-chain tether), payout reel, capstan, drivetrain, gears, spec bridge
2026-11-02 cad-infra: demo uses the real gear, 608 seat and keyed shaft libraries (audit CLEAN)
    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
2026-11-02 cad-infra: demo shaft prints body down (no overhang)
    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
2026-11-02 cad-launch: phase 0 kinematics, sizing and spec notes
2026-11-02 cad-infra lib: clips, switch, motors, line, springs
    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
2026-11-02 cad-drum: phase 0 notes, drum kinematics and timing, involute gear helper
    Claude-Session: https://claude.ai/code/session_01Y9T2M9N9qL2y5ALT8LFy85
2026-11-02 jetson: video, terrain, targeting, UI, setup kit, ballistics, mission, app, sim world
    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
2026-11-02 cad-infra: assembly loads only subsystem modules (no underscore), helpers skipped
    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
    [assembly.py]
2026-11-02 firmware/dart: v4 wire cut list, change list from v29, wiring diagram (SVG/PNG)
    [changes_from_v29.csv, wire_cut_list.csv]
2026-11-02 frame: parametric deck, cheeks, bearing blocks, wiper adapter, electronics bay, AS5600 bracket (phase 0)
    Claude-Session: https://claude.ai/code/session_01Y9T2M978hakvHyxZfkeYk4
2026-11-02 cad-infra lib: worm, screw, cams
    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
2026-11-02 physics: calib.py (spring hang test fit, wiper block) + tests
2026-11-02 frame: NOTES (board data with sources, adapter params, bay envelope, needs)
    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
2026-11-02 cad-infra: README library index and conventions
    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
2026-11-02 physics: review round 1 fixes (stop load incl spring KE, end node mass, eye gain on reel inertia, hook length over hooks, wiper inertia, payout json crash)
    [common.py, launch.py, payout.py]
2026-11-02 frame: PC tests and quick-look render script
    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
2026-11-02 firmware/dart: review round 1 fixes (hold cap, multi-motor and helper stall, duty scaling, no auto on fallback landings, free-fall rule, BNO callback, flightlog refused while moving, NaN-safe JSON) +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
    [kedge_dart.ino, kedge_logic.h, test_logic.cpp]
2026-11-02 cad-reel: phase 0 notes (interfaces, envelope, numbers) and reel_calc
    Claude-Session: https://claude.ai/code/session_01Y9T2M7bjamCMXizFoEX4TK
2026-11-02 firmware/dart: WIRING.md (v29 conversion and fresh build, learner steps), cleaner diagram
2026-11-02 docs/build: align with jetson CLI and physics summary
    Claude-Session: https://claude.ai/code/session_01Y9T2M7AEAgiEajoZ8R8wj4
2026-11-02 frame: pedestal supports for horizontal and vertical shafts not along Y
    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
2026-11-02 cad-infra tools: render, sim, steps
    Generic three.js viewer (viewer_core.js) driven by the manifest and asm.tracks: section cuts with hatched
    cut faces, explode, camera helpers, shadows, AUD API for headless shots. render.py writes the 24-view audit
    sheet, 12 section cuts and mission state views; sim.py the HD mission sim; steps.py the assembly steps page.
    Both pages also as body fragments for publishing (three.js r128 from cdnjs, meshes split to files if large).
    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
2026-11-02 frame: dovetail cheek split when a cheek exceeds the bed
    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
2026-11-02 physics: review fixes in gears/capstan/drivetrain (key failure mode, Lame hoop, constant-torque take-up, firmware trip)
    [capstan.py, drivetrain.py, test_capstan.py, test_gears.py]
2026-11-02 firmware/dart: README, BENCH_TEST, stall current in events, i resets the peak
    [kedge_dart.ino, kedge_logic.h]
2026-11-02 docs/build: csv tables, dart wiring v4 slots, code wrapping
    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
2026-11-02 frame: follow BASE_SPEC v0.1 world frame (wiper axis origin, boss face y = 0); AS5600 magnet holder left to cad-drum
    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
2026-11-03 firmware/dart: drop stale v3 client/mock copies (jetson owns the client)
2026-11-03 physics: flight fixes from review (reel start speed, dt, filtered reel peak, stricter C3 validate)
    [ballistics.py, flight.py, test_ballistics.py, test_flight.py]
2026-11-03 physics: review round 1 flight fixes (reel start speed, dt, filtered reel peak, stricter C3 validate) + regenerated outputs
2026-11-03 docs/build: fix electrical review findings (tap fuses, SLP check, fuse with battery out, e-stop, measurement methods)
    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
2026-11-03 frame: bearing seats from cad.lib.bearings, lip leaves the inner race free
    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
2026-11-03 cad-infra: fix review round 1 (core/audit): gear offsets without master, most restrictive Allow, grounded checks, timeline refinement (1 deg / 0.5 mm per step), rigid transform checks, clearance fail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
    [assembly.py, audit.py, params.py, timeline.py]
2026-11-03 cad-infra tools: pack, step, bom, guide, run_all
    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
2026-11-03 frame: assembly steps in whole-base order, tests
    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
2026-11-03 cad-launch: launch module first cut, gear library, release sweep
2026-11-03 cad-infra: infill in the manifest
    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
2026-11-03 firmware/dart: docs review fixes (meter checks through motor windings, two-wire pad steps, USB/battery order, B2 buck setting, totals split), diagram shows series link, diode and capacitor
    [wire_cut_list.csv]
2026-11-03 firmware/base: sketch (USB CDC JSON lines, tick task, NVS), tunables persistence; compiles on esp32 core 3.3.12
2026-11-03 frame: load and CG hand calcs
    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
2026-11-03 cad-infra lib: DIN 6885 key table and gear keyway matching shafts.keyed_bore
    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
2026-11-03 physics: cock train from cad-launch NOTES (big gear m2.5 40T, drive 26T), mode trips, defaults to launch NOTES, run_all.sh, REPORT draft
2026-11-03 cad-drum: drum.py geometry v0 (main shaft, dog clutch, selector drum, wrap idler, fork, brackets), coaxial launch dog ring
    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
2026-11-03 jetson: CLI, selftest, replay, mission retry fixes, sim rover cone, flight and mosaic vision
    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
    [flight.py, mission.py, mock_base.py]
2026-11-03 frame: deck at 20 % infill (optional top pockets, off)
    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
2026-11-03 physics: full rerun on cad-launch numbers, FINDINGS update
2026-11-03 frame: cable-tie points along the cheek feet
    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
2026-11-03 physics: brake vs overrun recommendation
2026-11-03 docs/build: fix learner review (merged dart build order, run sheet wire map, foot direction, order of work, payout brake numbers)
    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
2026-11-03 cad-infra: REPORT draft
    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
2026-11-03 frame: NOTES for spec v0.1, interim REPORT
    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
2026-11-03 cad-drum: audit fixes (segment gear entry, lock clearance, cradle, rail flat, lever deflection); drum-only audit clean except the dog ring that bolts to the launch sleeve
    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
2026-11-03 firmware/dart: docs worker feedback (antenna before power, buck set off the 3S lead as run sheet 6.2, loose vs assembled bench steps, steps 9/10 swapped, foot direction wording)
    [Arduino.h, ArduinoOTA.h, WebServer.h, WiFi.h, Wire.h, esp_system.h, esp_task_wdt.h, sim_world.h]
2026-11-03 cad-launch: real tooth contact release table, lead-in phase, springs, pins, stop pads; launch audit CLEAN (without aim)
2026-11-03 docs/build: dart motor reversal rule
    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
2026-11-03 physics: aim model on the cad-launch worm + crank-rocker train
2026-11-03 frame: guard band closing the cheek box, openings from the swept parts of the other subsystems
    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
2026-11-03 frame: guard band assembly step
    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
2026-11-03 frame: test band cutters
    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
2026-11-03 jetson: dart client and mock to kedge-dart-v4 (409 refusals, /arm, clock sync, IMU axis remap), mission uses log-only arm, app and CLI tests
    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
2026-11-03 physics: attitude.py (pitch-plane stability at 6 to 8 m/s) + tests, FINDINGS F9
    [attitude.py]
2026-11-03 cad-drum: notes v2 (coaxial launch dog ring, axial stack, wrap idler, contacts SW_DRUM_A/B/C), REEL at 87, magnet cap, tests, quick-look renders
    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
2026-11-03 cad-reel: first reel model (wall, sprag backstop, capstan, v7 cup and drum, spool, clutch, rocker, gears)
    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
2026-11-03 firmware/dart: review round 2 fixes (worm-paused pair check for sequences and manual pairs, hold continuity across slow repeats, voltage-scaled thresholds, NaN reads skip current checks, tumbling fli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
    [Arduino.cpp, WebServer.cpp, Wire.cpp, esp_stubs.cpp, kedge_dart.ino, kedge_logic.h, sim_main.cpp, sim_world.cpp]
2026-11-03 cad-launch: dart reference part, flight states, arm fix; launch audit CLEAN
    [launch.py]
2026-11-03 jetson: fix review round 1 findings (dart stop on any step failure, ESTOP base first, fire retry after a real shot, stop/fire lock, release in reshoot, bad JSON, tension-hold anchor check)
    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
    [dart.py, mission.py, test_app_sim.py, test_mission.py, test_review_round1.py]
2026-11-03 frame: review round 1 fixes (adapter assembly from inside the cheek, print orientations, bay USB facing out, lid inserts, board retention, insert walls)
    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
    [_frame_ebay.py, _frame_motor.py]
2026-11-03 cad-launch: notes updated (27 teeth, stroke 241.2, timing), view script
2026-11-03 cad-reel: notes v2 (m3 capstan gear, 8 wraps, brake levels and forces)
    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
2026-11-03 cad-infra tools: fit coupon and subsystem template
    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
2026-11-03 cad-infra lib: fix review findings (keys, internal gears, contact ratio, flexure, clutch walls, snap pins, switch, shaft fit)
    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
2026-11-03 cad-reel: m3 capstan gear, m2 take-up train, 24T cup ring, exit post on the wall pad; reel-only audit CLEAN
    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
2026-11-03 frame: screw lengths, motor before shafts in the steps, notes updated after review round 1
    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
2026-11-03 docs/build: DRV8833 #3 SLP not wired (coordinator decision)
    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
2026-11-03 cad-infra: audit fails printed parts that are not watertight as STL (after vertex merge)
    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
    [audit.py]
2026-11-03 physics: review round 2 fixes (aim wiper torque x4, sprag #1 torque on the wiper axis, full shot time, summary layout and font, sensitivity on chain model)
    [calib.py, drivetrain.py, sensitivity.py, summary.py]
2026-11-03 docs/build: coordinator decisions (tether always on, 0.5 N brake, range 4 to 5 m, AS5600 magnet, spring options)
    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
2026-11-03 frame: deck covers and inserts other subsystems' feet (auto-detected), bay avoids their sweep, main axis 165 above the deck
    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
    [_frame_ebay.py]
2026-11-03 firmware/base: drum Gray-code sectors (drum_NOTES), SW_DOG wiggle, fire from rest, review round 1 fixes (sw keys, token expiry, events, flash-write gate, AS5600 read, USB buffers, task watchdog), lea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
    [base_logic.h, config.h, drives.h, grappstar_base.ino, sensors.h, sim.h, test_base.cpp]
2026-11-03 firmware/dart: host simulator of the real sketch (11 HTTP tests incl. old Jetson client); fix IMU timestamp ahead of tick (imu_ok flapping, would end a real flight as timeout), signed flight time mat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
    [kedge_dart.ino, kedge_logic.h, test_logic.cpp, test_sim.py]
2026-11-03 cad-launch: printed contact switches SW_HOME (rail) and SW_SEATED (carriage); audit CLEAN
2026-11-03 physics: coordinator decisions D5-D10 as defaults, 5 N m torque limiter, recoil.py (recoil, tip-over, 4 springs), FINDINGS F10
2026-11-03 frame: 1:1 rover drill template PDF + CSV
    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
2026-11-03 cad-reel: line path check (every cup angle), tilted plain eyes, unwrap schedule fix, reel_calc tests
    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
2026-11-03 cad-drum: fork prints flat on its pad plane, SW_DOG tab and hard stops (separate fork stop), assembly steps
    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
2026-11-03 firmware/base: logic review round 1 fixes (aim sub-state, drum jog interlocks, bounded cock creep, shift-under-load guard on phase, backstop in wrap sectors, stall always faults, second fault in safi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
    [base_logic.h, test_base.cpp]
2026-11-03 firmware/base: fix the test file (bad edit in the previous commit); 253 checks pass
    [test_base.cpp]
2026-11-03 cad-launch: preload from spare spring extension, 18 mm stop pad, true contact follower, tests
2026-11-03 firmware/base: sim realism (edge jitter, dry-fire detector, delayed flash acks), comment fixes
    [config.h, pins.h, sensors.h, sim.h, test_base.cpp]
2026-11-03 Decisions D18 (rover-side kit on the base frame), D19 (confirm list)
    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
2026-11-03 cad-launch: aim train (swing-arm splitter, bevel, self-locking worm, crank-rocker, housing); grounded; audit CLEAN 47 parts 407 states
2026-11-03 Add panel doc D (performance lens)
    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
2026-11-03 firmware/dart: review round 3 fixes (rise check on worm stalls, kick plant time limit, hold window = ms + 250, filtered current for stall decisions, min flight 400 ms, keys refused while a fault is l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
    [kedge_logic.h, test_logic.cpp]
2026-11-03 cad-launch: sleeve per D13 and drum 3b (integral ribs, flange at y 101, spigot bore through), cheek rib slots; CLEAN
2026-11-03 physics: recoil json fix, outputs
    [recoil.py]
2026-11-03 physics: FINDINGS current-numbers block, stale numbers refreshed
2026-11-03 firmware/dart: web page fixes from the browser test (STOP button clears held keys, keepalive STOP on pagehide); sim/test_page.js headless Chromium test, 11 checks
    [kedge_dart.ino]
2026-11-03 cad-drum: D16 drum order (LAUNCH, NEUTRAL, WRAP, REEL), D15 bus gear, D8 shear pin limiter, REEL gear m2 40T, split drum on a fixed axle, round-nub code bands, review fixes (WIP, audit next)
    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
    [_drum_kin.py, _drum_test.py]
2026-11-03 firmware/base: WIP drum order LAUNCH/NEUTRAL/WRAP/REEL (D16), lens B sequence, dog window, per-state trips (D8), DART_STUCK; tests being updated
2026-11-03 Add panel doc A (Harry-faithful lens)
    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
2026-11-03 cad-launch: rail split flanges (M3), split moved to u 140
2026-11-03 jetson: UI rebuilt after browser test (docked prompts, landing report tabs, settings), review fixes in analysis and app, settings.json, --imu-axes
    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
    [base.py, eval_terrain_flight.py, flight.py]
2026-11-03 cad-launch: assembly steps
2026-11-03 docs/build: merge base-v1 (fw-base docs), jog cap, bench vs rover power-on order
    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
2026-11-03 jetson: sim re-renders the flight at the aimed pitch, README settings and IMU axes
    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
2026-11-03 jetson: settings.json test; work in progress from parallel agents
    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
2026-11-03 physics: tests renamed test_phys_* (no basename clash with base/cad/parts), conftest pins this dir's modules and fails on writes to base/out or kedge/out30
    [test_phys_attitude.py, test_phys_ballistics.py, test_phys_calib.py, test_phys_capstan.py, test_phys_drivetrain.py, test_phys_flight.py, test_phys_gears.py, test_phys_launch.py]
2026-11-03 docs/build: measure list from CAD notes (N20, keyways, BTS7960, wiper boss, rover mass, tension, contacts), assembly hand steps
    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
2026-11-03 cad-drum: REEL gear lip and N20 strap clearance
    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
2026-11-03 docs/build: measure order before printing
    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
2026-11-03 jetson: dart client verified against the real dart firmware simulator (test_dart_realsim), mock dart refuses flightlog while armed or busy
    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
2026-11-03 physics: rename launch.py -> launcher.py, gears.py -> printed_gears.py (module names clashed with base/cad/parts/launch.py and base/cad/lib/gears.py in a combined pytest run)
2026-11-03 physics: recoil nets the stop pulse against the stroke (review round 3), rolling-wheel case, FINDINGS
2026-11-03 physics: landing load note
2026-11-03 jetson: mission re-sequenced to PROTOCOL.md and the coordinator order (cock, RESET, NEUTRAL after landing, tidy, retrieve to approach, final approach, LAUNCH at the end), decock action
    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
    [mission.py]
2026-11-03 frame: chunked swept hulls (fast), shot tip estimate, report update
    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
2026-11-03 jetson: rover camera pose from params FRAMEWORK (calibration file first), range offset to the launcher pivot
    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
2026-11-03 jetson: decock button, jog labels fwd/back, README mission step table
    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
2026-11-03 jetson: WIP from parallel agents (mock base to PROTOCOL.md in progress; mission tests not yet green)
    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
2026-11-03 firmware/dart: hardware review fixes (slow decay PWM with duty-squared thresholds, NO_CURRENT for open or shorted motors, impact 3.5 g, peak_g), docs synced with code (21 items), optional hold-up and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
    [kedge_dart.ino, kedge_logic.h, sim_world.cpp, test_logic.cpp]
2026-11-03 jetson: WIP from parallel agents
    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
2026-11-03 firmware/dart: no-current threshold 40 % of free current
2026-11-03 jetson: dart reboot at impact counts as landing (stop then auto), mock dart reboot and peak_g
    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
    [base.py, flight.py, mission.py, mock_dart.py, test_base_realsim.py, test_comms_base.py, test_mission.py]
2026-11-03 cad-reel: D3/D15/D16 train (m2 40:24 capstan, take-up bus with forward-only swing idler, 7 wraps), print fixes
    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
2026-11-03 cad-drum: notes v3, assembly steps for the new parts, REEL gear one body
    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
2026-11-03 cad-drum: drum_table.json for fw-base (positions, Gray code, edges, stop plan, timing, rules)
    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
2026-11-03 cad-reel: notes v3 (D3/D15/D16), kin sign fix
    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
2026-11-03 cad-drum: report draft
    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
2026-11-03 cad-reel: model tests (validity, bed fit, senses, meshes, swing park, line path, steps)
    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
2026-11-03 jetson: review round 2 fixes (IMU saturation, glitch-proof launch and impact, 3.5 g impact, launch time convention, max_fps schedule, replay robustness, non-BGR inputs, camera byte cap and clean shut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
    [test_base_realsim.py, test_comms_base.py, test_review2_findings.py]
2026-11-03 frame: notes on automatic deck feet, deck height decision
    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
2026-11-03 firmware/base: D16 drum order and lens B sequence complete; review round 2 + fuzzer fixes (loaded invariants, SW_HOME checks, persisted phase hint, decock by travel, AS5600 plausibility, drum-still c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
    [base_logic.h, config.h, grappstar_base.ino, pins.h, sensors.h, sim.h, test_base.cpp, test_fuzz.cpp]
2026-11-03 jetson: rover camera pose from params.FRAMEWORK.camera (base spec v1.0), --deck-height setting
    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
2026-11-03 cad-launch: WIP tether path module, SW_SEATED relocation (before review-1 rework)
    [launch.py]
2026-11-03 cad-reel: separate PPA-CF sprag hub (printed upright), audit CLEAN
    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
2026-11-03 docs/build: spec v1.0 (drum order, take-up, 7 wraps, contacts, magnet D12, confirm list D19, decock, torque limiter)
    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
2026-11-03 cad-infra: optional line_path(P, S) hook and Assembly.line(S) for the tether polyline
    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
2026-11-03 physics: spec v1.0 mapped (stroke, preload, carriage, stop, pivot height, reel 50/66/22, capstan 50:22, 7 wraps, clutch LIGHT/FIRM, limiter), take-up overdrive 2.5, pitch-dependent muzzle, range from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
2026-11-03 firmware/dart: review round 5 fixes (failed read at a step end no longer faults, both directions held refused, page key release keeps the arm, stale key 409, low-speed stall floor, LANDED only when i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
    [kedge_dart.ino, kedge_logic.h, test_logic.cpp]
2026-11-03 cad-infra tools: fix review round 2 (step validity, guide steps and battery rule, bom parsing, pack bed fit and 3MF names, run_all cleanup, fonts)
    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
    [bom.py, coupon.py, guide.py, pack.py, step_export.py]
2026-11-03 docs/build: review round 3 fixes (FORWARD defined, require_seated for dry cycles, estop exceptions, no live unplugging, magnet required for now, jog duty, tow limit)
    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
2026-11-03 jetson: basesim, the real base firmware logic plus sim.h over C1 stdio/pty, and BaseClient tests against it (binary untracked)
    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
2026-11-03 physics: ballistics meta and docs say range is from the pivot ground point
2026-11-03 jetson: full mission test against the real base firmware logic (basesim) and mock dart: PREFLIGHT to LAUNCH_READY passes
    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
2026-11-03 docs/build: coupon stage 0, stages renumbered, measure list tables as Item/How/Changes/Reprint
    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
2026-11-03 cad-infra: README bought_ref count syntax
    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
2026-11-03 jetson: full mission against both real firmwares (basesim + fw-dart kedge_sim) passes
    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
2026-11-03 jetson: mock base and client aligned to PROTOCOL.md (states, events, sw letters, HOLD, DRUM_HELD, HELLO/ABORTED), mission follow-ups (stop and settle, HOLD, decock hints, seated letter S)
    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
2026-11-03 firmware/base: D12 no-magnet mode (SW_INDEX 6-bump angle source, errs high), SW_GAP re-zero in the reset; 305 checks, fuzz clean
    [base_logic.h, sim.h, test_base.cpp]
2026-11-03 cad-drum: BASE_SPEC v1.0 relayout (drum front-below, stack bands, REEL m2 50T, zones and codes per params), SW_DOG_L/R post, SW_INDEX cam, SW_N20 cradle, review round 2 fixes
    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
    [_drum_kin.py, _drum_test.py, _drum_views.py]
2026-11-03 physics: review round 4 fixes (capstan gear 50T, overdrive from spec, both clutch settings referenced to the full reel, spec_used complete, wraps int, meta notes)
    [ballistics.py, capstan.py, drivetrain.py, retrieve.py, spec_bridge.py, test_phys_capstan.py]
2026-11-03 physics: plots.py (range vs pitch, trajectories; plain black/grey)
2026-11-03 docs/build: merge base-v1, FIRST_DAY.md, wiring cheat sheets per board, safety page (clear zone, LiPo storage), number fixes
    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
2026-11-03 jetson: terrain classifier robust on flight landing frames (72/72 held out), analysis passes no fake slope and falls back to post-landing frames
    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
2026-11-03 docs/build: pick up the risk coupon sheet and plate pictures wherever the pack writes them
    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
2026-11-03 docs/build: cross-check fixes (shear pin, 14 AF lever, 12:1 drum, keyway 1.5, D20 orientation, integral key rib, stop pad, k_n_per_a, limit_n, 608 uses, magnet gap, park wire, D9 exception, fault exc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
2026-11-03 frame: conform to BASE_SPEC v1.0 (main-shaft plates carved round the other subsystems, outboard thrust bushing 160..172, motor above the axis, 124 x 124 bay in the params region, grounded deck)
    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
2026-11-03 Spec v1.1: wrap before anchoring (D22), sleeve to y 193 with aim-housing seat (D23), FIRM 5 N (D24), take-up bus as built (D25), shear-pin limiter (D26), contacts and Gray code from the owners (D27),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
2026-11-03 cad-drum: notes v4 (params v1.0 numbers, deviations), honest torque budget, firmware rules, audit fixes
    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
    [_drum_kin.py, _drum_test.py]
2026-11-03 Point the old dart pin map at firmware/dart/WIRING.md; contract C2 impact threshold 3.5 g (D28)
    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
2026-11-03 physics: Century C-243 catalogue limits in the spring model, launcher flags over_catalogue_load
2026-11-03 frame: integration audit script
    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
2026-11-03 systest: base firmware pty shim (real base_logic.h + sim.h, NVS persistence, power cut, USB unplug, control socket)
2026-11-03 firmware/dart: agent work in progress (fuzz test, failure modes)
    [fuzz_logic.cpp]
2026-11-03 cad-infra: timeline steps int/bool targets at mid-phase instead of blending
    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
2026-11-03 docs/build: learner round 4 fixes (power-up order, Mac clone, pipeline commands, MEASURE_RESULTS fill-in sheet, dart bench supply wording, hole compensation path, spring method)
    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
2026-11-03 firmware/dart: BENCH_TEST bench-supply version of the loose-motor steps (docs worker review)
2026-11-03 jetson: re-cock from fresh status phase, reshoot test fixes, sim uses aim_target
    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
    [mission.py, test_app_sim.py, test_mission.py, test_review_round1.py]
2026-11-03 docs/build: spec v1.1 (wrap after landing D22, FIRM 5 N D24, shear pin and flexure stop D26, single SW_DOG and hold rules D27, minimum range D29)
    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
2026-11-03 cad-infra: audit performance (vectorised broad phase, chunked exact checks, branch and bound clearances, pinned pool)
    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
    [audit.py]
2026-11-03 cad-infra tools: fix web review (joint-space tracks, size limits, shots, theme)
    Joint-space tracks (per joint parent, static origin/base, scalar value per
    sample; page rebuilds parent * T(origin) * base * motion(value)), exact hull
    bboxes and whole-track box for ground/cut, externalized and split data with
    16 MB page / 15 MB file checks, frozen deterministic shots, viewer setTheme,
    ghosted cut caps, clamped tooltips, tether polyline, mission view and follow.
    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
    [assembly_app.js, render.py, sim.py, sim_app.js, steps.py, viewer_core.js]
2026-11-03 docs/build: physics 1.0.1 numbers (17 N/A, 5.2 m at 36 deg), Pololu confirm, shear pin replacement, dart bench supply section
    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
2026-11-03 jetson: D22 order (wrap right after the verdict), D29 ballistics (prefer high pitch, pivot reference), contract text for spec v1.1
    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
2026-11-03 cad-launch: review-1 rework (two-layer big gear, arm stops, SW_HOME/SW_SEATED rail levers, SW_GAP cam, light carriage, steel anchor pins in double shear, pin clip, tether pulleys, v1.0 frame, kin con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
    [launch.py, test_launch.py]
2026-11-03 frame: v1.1 (motor plate only, AS5600 bracket to cad-launch, deck covers the target footprint); integration report: origin mismatch
    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
2026-11-03 Spec v1.2: drum block back to cad-drum's v1.0 build (D31 corrects D27), springs to the Century C-243 rating, 265 mm full cock (D30), tow current constant (D32)
    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
    [params.py]
2026-11-03 systest: harness (base shim + dart sim + Jetson App, scripted operator, fault scenarios); FINDINGS F1
2026-11-03 cad-reel: restructure for spec v1.0 (6 mm wall, m2 22T capstan gear, m1.5 bus 46T + swing idler 30T + reel 20T, two-piece 72 reel, shroud, hub screws from the front)
    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
2026-11-03 firmware/dart: fuzz findings fixed (worm already at its stop: 3 readings over the line count without a rise; kick already down on a retried /auto; pair pause ends even on a failed read), fuzz_logic.c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
    [kedge_logic.h, test_logic.cpp]
2026-11-03 cad-infra tools: web shots keep the device scale, earlier fly-in fraction
    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
2026-11-03 cad-drum: params v1.1/v1.2 (bus 50T, spigot to y 198.5, magnet face 201.5, dog ring follows launch_sleeve), FIRM 5 N track 2 with 2x N20 margin, WRAPPED park 314
    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
2026-11-03 systest: calibrated bench, uncalibrated scenario, checks
2026-11-03 cad-infra: line_path hook only for (P, S) signatures
    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
2026-11-03 docs/build: safety review fixes (one stop rule, power-off freezes energy, approach checklist, hand lever warning, line tension stance, spring hook margin, unfused Y length, 18350 charging, dart picku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
2026-11-03 jetson: basesim tests detect the firmware generation with #sim dump; contact letters not asserted until PROTOCOL lists them
    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
2026-11-03 cad-drum: notes v5 (params v1.2)
    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
2026-11-03 cad-infra: interim base sim (launch, reel, drum; 103 parts, 109 s mission) for the 15:00 site
    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
2026-11-03 physics: full rerun on spec v1.2 (C-243 at 265 mm, flange 72, FIRM 5 N), ballistics.json, summary PDF, FINDINGS headline
2026-11-03 firmware/dart: BENCH_TEST safety (no cloth on turning augers; safe-to-touch rule after arm or auto tests)
2026-11-03 jetson: confirmations before the base goes live and before COCK; README stop rule matches the build guide
    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
2026-11-03 params 1.2.1: WRAPPED park 314 with FIRM clutch, clutch ramps per cad-drum, magnet cap 195..201.5
    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
2026-11-03 cad-infra tools: day-one risk coupon plate
    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
    [rc1_arm.stl, rc1_crank.stl, rc1_idler.stl, rc1_output.stl, rc1_plate.stl, rc1_sleeve.stl, rc1_stop.stl, rc1_sun.stl]
2026-11-03 systest: run_mission.sh, power loss in every state, serial garbage, NO GO reshoot, wifi drop, brownout, encoder glitch
2026-11-03 cad-infra lib: prim.clean() merges near-duplicate vertices; flexure_ring watertight as STL
    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
2026-11-03 cad-infra: audit performance (motion envelopes clear or crop rotating / sliding pairs, static checks after the broad phase)
    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
2026-11-03 params 1.2.2: current trips and tow tension model (D33), spring guard, physics v1.2 flight numbers
    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
2026-11-03 cad-infra: guide section 2 'First print: test coupons' from base/pack/coupons/COUPON_TEST.md
    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
2026-11-03 docs/build: params 1.2.1 (D30 springs C-243 265 mm, D31 SW_DOG_L/R, D32 17 N/A), range 4.8 m, drum N20 torque note
    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
2026-11-03 firmware/dart: worm no-rise stall uses 3 of the last 4 readings; fuzz quick mode in run_tests.sh; launch detection figure from the fuzz sweep
    [kedge_logic.h]
2026-11-03 frame: adapter clears the drum coupler (67 bore, hub ring keyed in a counterbore, 12-hole plate ring, inserts where clear of the motor slots); rover kit (Kiyo X edge mount, RC832 holder, cable anchor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
2026-11-03 docs/build: learner round 7 (bench test before base assembly, where to type commands, Jetson wall-supply branch, glossary terms)
    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
2026-11-03 jetson: README stop the service before base and camera commands, drop the stale --base caveat
    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
2026-11-03 cad-drum: main axis angle from launch_sleeve when cad-launch is present (one master angle on the axis)
    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
2026-11-03 systest: review fixes (raw injection escapes, peaks tracked per tick in the shim, fault knobs and dry fires survive power loss, plant geometry fixed, NVS timer, ctl timeout, trigger re-arm, injected-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
2026-11-03 physics: review round 5 fixes (py3.10 f-string, --step guard, calib errors, --help everywhere, odd flags never overwrite outputs, over-limit warning, stale docs)
    [attitude.py, ballistics.py, calib.py, capstan.py, drivetrain.py, flight.py, launcher.py, payout.py]
2026-11-03 jetson: review round 3 fixes (no stop during firmware safing, take-up final approach, retrieve before the reshoot limit, load-cell rewind BUSY, decock warning from fresh phase, BASE_NEUTRAL retry mar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
    [base.py, mission.py]
2026-11-03 Firmware to spec v1.2 / params 1.2.1: WRAPPED park 314, tidy/retrieve/decock, D8 tow trip 6.5 A, tension 17 x (I - I_free) - 10.4
    - wrap parks at WRAPPED (collar NEUTRAL); mode REEL flies the collar in; faults and estop from REEL / N_TO_R go to WRAPPED
    - DOG_L / DOG_R checked during every move; inside the wrap window the operator decides (unwrap)
    - new commands tidy (take-up by time, TIDIED), retrieve, decock
    - aim sets its own 5 A trip; tow (until tension) uses 6.5 A; overcurrent text shows one decimal
    - drum 'came too early' check measures to the target code edge and only with a trusted start angle
    - dog window start state from the config (was a fixed 30)
    - GB_FW_VERSION base-1.2; sim and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
    [base_logic.h, config.h, sim.h, test_base.cpp, test_fuzz.cpp]
2026-11-03 systest: dart_never_anchors models a non-holding anchor (check pull must catch it), operator frees jammed drills
2026-11-03 D34: rail pivot pulley ownership and line hand-over; tow trip formula
    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
2026-11-03 cad-launch: line_path/line_entry, pivot pulley lowered, sleeve_deg kin, notes refresh
2026-11-03 jetson: flightlog retries 409 busy with backoff (auto-anchor), cli dart release only reports success on seq released; tests
    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
2026-11-03 physics: field calibration from test shots (calib.py range -> ballistics.py --v-scale)
2026-11-03 firmware/dart: coordinator review R1-B: flight log freezes no later than 10 s after launch (timeout landing kept launch and impact); regression tests for R1-B #1 and #2 (#3 fixed earlier)
    [kedge_logic.h, test_logic.cpp]
2026-11-03 firmware/dart: long-flight log test bounds (20 ms grid); FAILURE_MODES.md (87 rows, 69 verified)
    [test_logic.cpp]
2026-11-03 cad-infra: audit performance (per-pair refinement: sub-states only where a pair's relative pose moves a point more than 0.5 mm; --global-refine keeps the old refinement)
    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
2026-11-03 cad-reel: review fixes (assemblable D flats, trim screws for LIGHT, rocker clearance, wider clutch ring for D24, tie hole, swing arm drag ring, exit post load path, pulley 1, line_path(P, S), main-ax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
2026-11-03 review: round 1 C jetson vision findings
2026-11-03 cad-drum: pinion tip land includes backlash (no pointed-teeth warnings)
    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
2026-11-03 jetson: systest F2 tidy command (TIDIED) with slip fallback, F3 sw letters l r I, F5 release option on base faults in TOW/CHECK and no re-pull above the limit, preflight warns about uncalibrated tens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
    [mission.py]
2026-11-03 docs/build: current-sense calibration is a hard prerequisite of the first tow (systest F5)
    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
2026-11-03 cad-drum: drum A lock layer sits on the segment gear (no air gap overhang)
    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
2026-11-03 Fix the docs cross-check findings; 16 new regression checks
    - one clear after a hand-turned drum (quiet sector tracked in FAULT)
    - cal decock with the carriage home and the phase unknown answers RESET ok:false (never silent)
    - mode only answers ok at once with the collar confirmed (LAUNCH: DOG_L, REEL: DOG_R, NEUTRAL: neither)
    - cock needs SW_SEATED (lens B I2); decock ends only with SW_HOME and SW_GAP closed (BASE_SPEC 10)
    - mode / wrap / unwrap that need the centering jog are refused without the AS5600 (ANGLE_SENSOR)
    - Tun ver 2 saves host_timeout_s, tension_offset_n, tow_trip_a (new set key); a ver 1 record is ignored
    - status reports ev_drops (events dropped by the USB ring)
    - stale comm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
    [base_logic.h, config.h, drives.h, grappstar_base.ino, persist.h, sim.h, test_base.cpp]
2026-11-03 cad-drum: report draft v2
    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
2026-11-03 cad-drum: kin per params v1.2.3 state keys (wiper_deg, sleeve_deg, reel_deg)
    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
2026-11-03 cad-drum: LAUNCH dog ring keeps the collar angle when the state has no sleeve_deg
    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
2026-11-03 cad-launch: bolted spring arms (body prints flat), D5 second pair provision, flange clearance, layer gap disk, telescoped line, faster dart mesh; quick audit CLEAN
    [launch.py]
2026-11-03 Refuse cal/set while booting (systest F1); tension averaged over 200 ms (D33)
    Claude-Session: https://claude.ai/code/session_01Y9T2M89Toez9ciFvBybsqW
2026-11-03 cad-drum: print table in notes
    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
2026-11-03 docs/build: binding command sequence (BASE_SPEC 10.1, D35) in TEST_PLAN and system text, range calibration step, cheat sheet tidy/retrieve
    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
2026-11-03 cad-drum: solid infill on the shear pin, shaft, collar, dog ring
    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
2026-11-03 physics: restore run_all.sh (emptied by a bad edit), test that it lists every CLI, --sweep may write outputs, critic findings in the model (shoe couple friction, eye gain 1.35, impact angles in meta)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
2026-11-03 docs/build: D33 tension model and firmware defaults (k 17, offset -10.4, limit_n 50), D12 no-magnet mode now in firmware, range from ballistics.json
    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
2026-11-03 params 1.2.4: LAUNCH axis_z 0 (world origin on the main axis), sleeve_y0 111 (D23), rail_y 140: launch.py read 165 and 101 defaults
    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
2026-11-03 cad-drum: contact levers 36 long (0.66 percent strain), SW_INDEX holes fixed per params, prim.clean on every solid
    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
2026-11-03 physics: tests on the real spec (capstan ratio direction, absolute tow torque, spring and reel geometry, headline band, committed ballistics not stale)
2026-11-03 cad-reel: notes v4 (params v1.2, D22/D24/D25), reel_calc on v1.2 numbers with the corrected cup torque model, shroud tabs
    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
2026-11-03 cad-drum: code ramps close at the code edges (80 percent point), lever feet end at the block face, N20 shaft D flat
    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
2026-11-03 frame: review round 2 fixes (perfboard spot, BTS hole pattern, lid grille, USB opening, seams off deck holes, kit step), frame audit CLEAN
    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
    [_frame_ebay.py, _frame_kit.py]
2026-11-03 scripts: merge_workers.sh includes jetson-vision
    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
2026-11-03 frame: integration script with origin check, no-refine
    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
2026-11-03 firmware/dart: failure-mode walk fixes (stop locks keys of all clients, /auto refused while armed, battery-low arm refusal, 0 V rail = LOW_RAIL, launch needs 300 ms still before the push, arm expires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
    [Arduino.h, ArduinoOTA.h, Wire.h, esp_stubs.cpp, esp_system.h, fuzz_logic.cpp, kedge_dart.ino, kedge_logic.h]
2026-11-03 cad-reel: SW_ARM printed contact on a bracket behind the cup gear (bump on the gear)
    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
2026-11-03 Safety review round: drum re-finds an overshot edge (never into WRAP after a cut), drum jog dog checks and wrap-window stop, worst-case phase hint after a cut mid-cock, D34 tow trip, fly-in duty for 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
    - tests: 344 checks, fuzz clean; params_gen.h from params 1.2.4 (aim table now from params)
    - docs: PROTOCOL (BASE_SPEC 10.1 sequence, new commands, D8/D33 trips), README (exact menus, core 3.3.12, HX711 0.6.6), WIRING (SLP not wired + 3V3 fallback, resistor/fuse table), CALIBRATION, BENCH_TEST
    Claude-Session: https://claude.ai/code/session_01Y9T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
2026-11-03 cad-reel: longer reel shaft bushing, report draft
    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
2026-11-03 frame: integration audit report
    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
2026-11-03 docs/build: risk coupon sheet and plates in the guide (base/pack/coupons), coupon extras in the measure list
    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
2026-11-03 physics: REEL hard trip 6 A (above the 50 N tow trip, below limiter slip), outputs
    [capstan.py, drivetrain.py, test_phys_capstan.py]
2026-11-03 jetson: TOW refused without load cell and factory k_n_per_a, harness rover lets the base rewind by itself, REPORT draft
    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
2026-11-03 cad-infra: README: kin must be cheap
    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
2026-11-03 systest: reference driver for BASE_SPEC 10.1, F14 (tension offset vs CALIBRATION.md), tug metric fix
2026-11-03 Protocol review round: estop obeyed with a bad id, id/cmd win a key slot, status survives long ids, cal ranges, get precision, tuning saved only on change, tidy POSITION_UNKNOWN
    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
2026-11-03 systest: reference driver with operator recovery; every fault and power-loss scenario also along BASE_SPEC 10.1 (ref_*)
2026-11-03 physics: line-slack geometry at the shot (last guide position as a parameter; snatch modelled when the path shortens), used by ballistics, summary, plots
    [ballistics.py, common.py, launcher.py, plots.py, summary.py, test_phys_launch.py, test_phys_spec.py]
2026-11-03 firmware/dart: C2 end-to-end test: the Jetson's dart client against the real sketch in kedge_sim (8 tests), in run_tests.sh
2026-11-03 cad-reel: kin on reel_deg (params 1.2.3), pulley 2 on its own post, line_path ends round the rail pivot pulley at launch.line_entry
    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
2026-11-03 cad-launch: PLA flexure carriage stop integrated (launch_stop.py), overshoot check, arms per stop design, arm bottom 73.2, aim cache (kin 700x faster); quick audit CLEAN 83 parts
    [launch.py]
2026-11-03 cad-reel: pulley 2 assembly step
    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
2026-11-03 review: round 2 H jetson app/mission/UI findings
2026-11-03 docs/build: coupon round fixes (print settings table, PPA-CF handling before plate 2, coupon failure route, two plates, bought extras, contact gap 0.9, spring rule, git prompt, glossary, relative ima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
2026-11-03 params 1.2.5: DRUM n20 train (10T/120T m0.8 = 12:1, 8.1 deg/s at 9 V, stall 0.22 est) as an interface number: physics used 9:1
    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
    [params.py]
2026-11-03 review: round 2 E base CAD findings
2026-11-03 cad-launch: steps for the current parts, notes from generated numbers
2026-11-03 cad-reel: lighter storage reel (thin rear flange, 1.6 front disc, open core pocket, tie into the pocket)
    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
2026-11-03 frame: motor plate + bridge + leg for v1.x (3D-carved round the others' sweeps), spring guards on the launch rail (frame_guards), seams placed far from deck holes
    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
2026-11-03 systest: drumDeg knob (power loss in LAUNCH_MODE starts from NEUTRAL), atomic shim build
2026-11-03 physics: wrap loads and time read the spec DRUM.n20 (ratio, drum_deg_per_s, design torque), mission uses it, test
2026-11-03 docs/build: final pack filenames (PRINT_SHEET, plates, BOM, guide.pdf appendix, base fit coupon), PPA-CF 6 walls 60%
    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
2026-11-03 cad-infra: audit performance (per-pair sub-states on the shared global grid, never finer than the per-joint rule, cropped parts set the step)
    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
2026-11-03 cad-reel: kin tolerates None state values
    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
2026-11-03 cad-infra tools: risk coupon sheet review fixes (gram bands, shear range, measuring methods, settings, fit coupon in pack)
    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
    [coupon_a1_608_rib.stl, coupon_a2_608_rib.stl, coupon_a3_608_rib.stl, coupon_b1_key_bore.stl, coupon_b2_key_bore.stl, coupon_b3_key_bore.stl, coupon_b_key_shaft.stl, coupon_c_m3_insert.stl]
2026-11-03 cad-drum: review round 3 fixes (REEL journal on the coupler with a retaining washer, idler shoulders, longer fork sleeve and real racking model, dog post moved, cradle arc slot, SW_N20 contact, M8 nu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
    [_drum_kin.py]
2026-11-03 docs/build: renamed risk plates, base fit coupon, PPA-CF 6/6 top/bottom
    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
2026-11-03 systest: F16 (settings lost on power cycle)
2026-11-03 jetson: mission to BASE_SPEC 10.1 / D35 (wrap park, tidy TIDIED, fly-in, capstan reel-in to 1.5 m, unwrap, take-up retrieve with max_s, never seat on the capstan), decock and re-aim recovery, link dr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
2026-11-03 cad-drum: notes v6
    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
2026-11-03 firmware/dart: review round 8 fixes (launch rejected only after free fall, so ramps and rail vibration pass; /auto while armed disarms first; kick travel not counted while stalled or planting, truste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
    [kedge_dart.ino, kedge_logic.h, test_logic.cpp]
2026-11-03 cad-drum: idler shoulders only next to the posts, cam disc follows the lock cam, dog post prints on its clamp end
    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
2026-11-03 frame: leg/bridge touch, adapter carve optional (off), auditor notes in the integration report
    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
2026-11-03 jetson: README mission step table for BASE_SPEC 10.1
    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
2026-11-03 physics: summary no-tether case and measure list
2026-11-03 cad-drum: geometry tests (26: shells, print fit, moving pairs at 17 drum angles, wiper sweeps, levers ride the bands, idler lock)
    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
2026-11-03 jetson-vision: roll-invariant rest tilt, high-arc solver with LIGHT drag default, camera lateral offset (R1-C 1, 2, 5, 7, 8)
    Claude-Session: https://claude.ai/code/session_01Y9T2M9gKxqxvaF2MVECuVK
2026-11-03 jetson: per-test time limit, slow marker (real-firmware and full-app tests) and check_all.sh, mission harness at 20x, dart hold ends normally on a stalled refusal
    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
    [dart.py, mission_harness.py, test_app_sim.py, test_dart_realsim.py, test_mission_realsim.py]
2026-11-03 params 1.2.5: faults with the wraps on hold the drum (D27); AS5600 dropouts no longer lose travel (step allowance grows with missed reads, an uncounted resync faults); take-up time limit per physics;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
    [base_logic.h, config.h, sensors.h, sim.h, test_base.cpp, test_fuzz.cpp]
2026-11-03 docs/build: printed anchor pins and clips (not hardware), O-ring and e-clip replaced by printed parts, CAD bought list (608 x5, M8x25)
    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
2026-11-03 cad-drum: fault rules per params 1.2.6 (hold with the wraps on)
    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
2026-11-03 jetson: target from the pivot ground point via campose.target_info_pivot (fallback until w/jetson-vision merges), cli solve --low
    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
2026-11-03 cad-infra tools: risk coupon follows base-v1 drum (dog_post replaces fork_stop, REEL output m2 z50 / capstan z22, pinion tip_short), per-coupon source guards
    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
    [coupon_plate_1.3mf, rc1_arm.stl, rc1_crank.stl, rc1_idler.stl, rc1_output.stl, rc1_plate.stl, rc1_sleeve.stl, rc1_sun.stl]
2026-11-03 firmware/dart: Jetson client test for /auto disarming while armed
2026-11-03 jetson-vision: dart ring sized by time, flight hold packs frames instead of dropping them (R1-C 4)
    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
2026-11-03 jetson: hold the dart camera frames from just before the shot until the landing analysis (jetson-vision Camera.hold)
    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
2026-11-03 cad-drum: dog post clear of the launch rail cheeks (clamp s 106.5..111.5), fork sleeve 66 long toward the motor
    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
2026-11-03 cad-drum: notes racking number
    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
2026-11-03 cad-drum: read params DRUM.n20 (train, stall, supply) with the built values as defaults
    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
    [_drum_kin.py]
2026-11-03 systest: F18 (preview of w/jetson: tow waits 60 s per round)
2026-11-03 Launch review round: index-mode missed bump found within 1.5 bump periods (no shot), stop keeps the drawn hint, decock gives REST with SW_HOME and SW_GAP closed, index snaps correct the driven train,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
    [base_logic.h, test_base.cpp]
2026-11-03 firmware/dart: docs audit round 2 (29 items: API, BENCH_TEST, README, FAILURE_MODES rows, comments); /auto refuses before it disarms
    [kedge_logic.h]
2026-11-03 firmware/dart: API low-speed stall estimate
2026-11-03 jetson: WIP mock base to the D35 drum model (sub-agent in progress)
    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
2026-11-03 cad-reel: integration fixes (foot clear of frame cheek and drum idler bracket, guide post hangs from the wall, exit post on its own foot, pulley 2 post clear of the drum switch block), gears follow c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
2026-11-03 Sim: wiper inertia and coast (fuzzer 2 of 3 seeds; tests pass at 40 and 100 ms); sketch: IS sampled across the PWM period (16 reads 53 us apart); params_gen 1.2.6
    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
2026-11-03 cad-reel: notes v5 (integration, meshes, SW_ARM logic, mounting)
    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
2026-11-03 Docs: faults hold with the wraps on, AS5600 jump fault, max_s 5..600 per physics, index mode, decock to REST, doubtful wraps, IS capacitor strongly recommended; REPORT draft
    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
2026-11-03 Spec v1.2.7: D36 line guide behind the rail and carriage at most 70 g, D37 sleeve flange lugs, D38 two springs only in v1, D39 tow cap 70 N and retrieve in NEUTRAL only; TIMELINE dog phase (engaged L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
2026-11-03 frame: v1 load calcs (limiter torque, leg feet, rover bolts), leg in the steps, seam threshold
    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
2026-11-03 cad-reel: watertight after vertex merge for every printed part (+test), sprag hub flange cut back on the main-axis side
    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
2026-11-03 review: round 2 I CAD lib and tools findings
2026-11-03 README: two springs only in v1 (D38), range about 4 m from the model
    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
2026-11-03 systest: ref_refusals scenario (retrieve at the park, tow max_n 80, seat on the capstan, wrap while cocked, fire without arm, aim out of range)
2026-11-03 jetson: r2_H fixes (settings allowlist and 70 N cap, unique prompt ids tied to text, stale flight log and landing guard, recovery entry act_recover, keep towing local), host watchdog with keep-alive 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
    [base.py, mission.py, mission_harness.py, test_base_realsim.py, test_comms_base.py, test_comms_serial.py, test_mission_realsim.py]
2026-11-03 physics: spec 1.2.7 (rear line guide, carriage 70 g, D33 trips, 4 springs not supported in v1, real aim splitter gear m1.5 z30 face 8)
2026-11-03 cad-infra: cross-owner gear mesh check (Mesh declarations: centre distance, parallel axes, face overlap, joint ratio; NOT CLEAN on failure)
    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
    [assembly.py, audit.py, meshcheck.py]
2026-11-03 docs/build: GPIO numbers from pins.h (diagram filled at build, test that every GPIO in the guide matches pins.h), D38 two springs only, stage 4 with stand-in bands, A6 scaled from the 40 percent jog,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
2026-11-03 cad-reel: cup gear phase against cad-drum's idler, mesh audit states follow the drum keys; all three cross-owner meshes zero overlap
    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
2026-11-03 frame: NOTES rewritten for v1.2
    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
2026-11-03 jetson: WIP from sub-agents (mock base D35, UI security)
    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
2026-11-03 cad-launch: review-2 fixes: one bolted yoke with web keys, captive SW_SEATED plunger + wedge pushrod, axial spacers (drive collar/lip, washers), full layer 1.5 clear of the rack, ramped SW feet and S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
    [launch.py]
2026-11-03 docs/build: stage 2 free current band under the jog trips (r1_G #7)
    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
2026-11-03 jetson: base fire CLI (confirm, arm and fire on one connection, prints FIRED and RESET); UI security (session token, same-origin POSTs, Escape STOP, answer tied to text, Recover dart button, 70 N tow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
    [test_cli.py]
2026-11-03 cad-infra: review R2-I 2 and 6: audit sub-states interpolate joint values directly (string/flag-driven joints sweep evenly), no silent refinement cap (error), timeline eases counts and steps 0/1 flags
    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
    [assembly.py, audit.py, timeline.py]
2026-11-03 docs/build: fire with grappstar base fire (arm and fire inside the token life), cheat sheet
    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
2026-11-03 scripts: merge_workers.sh includes sensors
    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
2026-11-03 D39: tow limit at most 70 N (BAD_ARG), retrieve / seat only in NEUTRAL; SW_ARM home = open (cad-reel); systest F15: a cut while the wiper turned with the train at rest keeps REST when SW_HOME and SW_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
2026-11-03 frame: spring guards follow launch_rail through a frame joint (frame_guards.py was skipped by the loader)
    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
2026-11-03 cad-launch: tether wraps the pivot pulley (centre w -53.5, feed at its bottom), line_path/line_entry tangents
2026-11-03 docs/build: G9 procedure from fw-base CALIBRATION (e), tow cap 70 N (D39)
    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
2026-11-03 physics: rerun on spec 1.2.7, ballistics.json (taut line), FINDINGS headline, aim gear trip recommendation
2026-11-03 review: round 2 C2 jetson vision re-review
2026-11-03 jetson: mission harness uses the real ballistics table and a reachable 3.6 m target (aim range 6 to 47 deg)
    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
2026-11-03 cad-launch: assembly steps corrected (order, front insertion, hooks before pins, M3x20, GPIO 21, washers)
    [launch.py]
2026-11-03 jetson: retrieve max_s clamped to the firmware range 5..600
    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
2026-11-03 cad-infra: review R2-I fixes 3, 4, 5, 7 (stale asm.json, internal gears, worm self-locking, BOM mass model)
    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
    [bom.py, guide.py, pack.py]
2026-11-03 firmware/dart: review round 9 fixes (kick travel not counted while stalled either way; release KICK_JAM from real travel back vs travel out; a fault disarms; flightlog refreshes the loop heartbeat an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
    [fuzz_logic.cpp, kedge_dart.ino, kedge_logic.h, test_logic.cpp]
2026-11-03 frame: test for the rail guard joint value
    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
2026-11-03 firmware/dart: API.md for round 9 (KICK_JAM 60 % rule, fault disarms, flightlog cut-off, no re-drive)
2026-11-03 cad-infra tools: steps never dropped, dependency and stage ordering
    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
2026-11-03 jetson-vision: fused video-only speed estimator (horizon track, flight time, C3 prior), table range calibration, run_post_flight aim and drag priors (R1-C 6, WIP tests)
    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
2026-11-03 cad-infra: guide lists 'also handle' parts; README step stage
    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
2026-11-03 r1_D audit leftovers: wiper backward jog only in LAUNCH (BACKSTOP), cock from REST and cal cock_rest need SW_GAP, drum jog end-stop guard at the end stops and refused with an untrusted angle; params_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
2026-11-03 docs/build: cold-read round 10 (clone base-v1 if main lacks the docs, Jetson step 4 after flashing, CALIBRATION letters, range from ballistics.json, A7 optional, dart SLP ohms check, z over USB, new 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
2026-11-03 cad-launch: aim train: SW_RAIL_LOW, housing spigot bore and end before the magnet cap, AS5600 bracket, lug pin clip, deck heights from LAYOUT
2026-11-03 firmware/dart/sim: WebServer stub client().stop() for the flightlog cut-off
2026-11-03 cad-infra tools: risk coupon derives coupon 3 base and coupon 9 slices from drum's current layout, shear pin on its flat, adaptive plate spacing
    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
    [coupon_plate_1.3mf, rc2_switch_base.stl, rc2_switch_lever.stl, rc3_base.stl, rc3_dog_post.stl, rc3_fork.stl, rc3_rail.stl, rc3_reel_face.stl]
2026-11-03 docs/build: magnet cap is coupon 10, backward jogs only in LAUNCH
    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
2026-11-03 jetson: mission passes the aimed pitch and drag to the landing analysis (jetson-vision priors)
    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
2026-11-03 jetson-vision: report draft, fuse_speed unit test fixed
    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
    [test_flight.py]
2026-11-03 cad-infra tools: risk coupon 10 (AS5600 magnet cap for the bench test), rerun lines with the venv interpreter and pack paths
    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
    [coupon_plate_1.3mf, rc10_magnet_cap.stl, risk_plate_1_PLA.3mf, risk_plate_2_PPA-CF.3mf]
2026-11-03 frame: can stay for the upright wiper can, frame-only clearances fixed
    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
    [_frame_motor.py]
2026-11-03 firmware/dart: WIRING B2 starts battery unplugged (coordinator review r1_G #21)
2026-11-03 Docs: backward jogs only in LAUNCH (bench step 4 split), SW_GAP on cock / cock_rest, drum jog end-stop guard, params 1.2.7, bench magnet and FORWARD label, cross-references
    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
2026-11-03 systest: operator think time on fault prompts; stall load removed 0.3 s after the fault
2026-11-03 cad-launch: pivot pulley 44 below the axis (clear of cad-drum's fork rail), dart return along the rail axis; full assembly: no launch collisions
    [launch.py]
2026-11-03 jetson: uncalibrated-tow check knows both factory k_n_per_a values (8, 17); tests follow the 10.1 no-go path
    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
2026-11-03 physics: review round 6 fixes (take-up drag per D25: clutch disk at 2.5 x wiper, tow offset -3.0 N; capstan shaft without the take-up branch; flight eye at the D36 guide; taut from the slack peak; tr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
    [capstan.py, drivetrain.py, flight.py, launcher.py, spec_bridge.py, test_phys_capstan.py]
2026-11-03 jetson-vision: review fixes: long hold thins after the protected launch head, buffer(since=), speed model starts at rail exit, one solution on a table row
    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
    [ballistics.py, flight.py, test_ballistics.py, test_flight.py, test_video_camera.py]
2026-11-03 cad-launch: lip roller + retrieval funnel, spring guards (D33), top splice straps; quick audit CLEAN 96 parts
2026-11-03 jetson: landing analysis reads the dart buffer with since= (no decoding of older held frames)
    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
2026-11-03 cad-sensors: sensors.py (AS5600 carrier with pegs and M3 clamp strips, SW_RAIL_LOW and SW_GAP from cad.lib contact_switch with brackets), launch patch for cad-launch
    Claude-Session: https://claude.ai/code/session_01Y9T2M9jppT9fjgWHfoVucp
2026-11-03 cad-launch: REPORT draft
    Claude-Session: https://claude.ai/code/session_01Y9T2M7U6DHgK3nHG48LDmQ
2026-11-03 cad-sensors: notes, tests, SW_GAP plate overlap fix
    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
    [sensors.py, test_sensors.py]
2026-11-03 frame: spring guards carved with the exact carriage sweep and launch audit states, watertight; origin verdict
    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
2026-11-03 cad-launch: lighter lip-roller fork and funnel (carriage 85.8 g); merge base-v1
    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
2026-11-03 Spec v1.2.8: D40 aim trip 3 A (every backward run in LAUNCH) and PPA-CF aim gears; SW_ARM opens at home; launcher as built (stroke 240.9, drive face 7, two-layer big gear); 10.1 step 7 no-go goes via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
2026-11-03 physics: review r2 F2 fixes (tow limit cap check, validate + end rows in the staleness test, spec headline test), regenerated, FINDINGS
    [capstan.py, test_phys_spec.py]
2026-11-03 Adversarial round: cock jog from LAUNCH faults if the collar leaves or chatters (release guard by start mode); current/tension constants and trips refused while moving or holding; tow holds on the ra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
    [base_logic.h, config.h, test_base.cpp]
2026-11-03 fw-dart: stall lock is per direction (a stale '@' lock no longer refuses a fresh '@' after '2' presses)
    Fixes test_jetson_client test_06_hold_and_stop. Full run_tests.sh green.
    Claude-Session: https://claude.ai/code/session_01Y9T2MA1d5WKQuq7yaGnXjA
    [kedge_logic.h, test_logic.cpp]
2026-11-03 jetson: one drag default 0.5 N (LIGHT) in the CLI, mission and settings example, with a test (r2_C2 #1)
    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
2026-11-03 cad-drum: whole-base pairs: SW_INDEX cam to s 33.5..38.5 with the block on the cheek inner face, code contacts mirrored to the drum back, idler post 2 clear of reel_wall, coupler under r 28.5 (reel_w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
2026-11-03 jetson: line_m estimate from the flight range only with the IMU log, capped by the table (R2-C2); aim overcurrent hint (D40)
    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
2026-11-03 physics: merge spec 1.2.8, carriage_mass_g (as built) key, tow check at the D39 cap
2026-11-03 frame: gear guards (hood off the motor plate, front panel), carved round the sweeps
    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
2026-11-03 physics: fix capstan CLI print (tow at the cap)
    [capstan.py]
2026-11-03 jetson-vision: R2-C2: speed searched in the C3 band with the table default, hold expiry warns loudly
    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
2026-11-03 systest: R2-L review fixes: stiff Dyneema line (EA 20 kN), real plant pitch for the aim check and the shot, two-sided reel-in and seat-in-NEUTRAL checks, retrieve mandatory and stop after release in 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
2026-11-03 cad-drum: SW_INDEX block on a strut of idler post 2 (cad-frame carves the cheek round drum parts), step order, strut tests
    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
2026-11-03 physics: path gain dart->capstan in the tow model (1.5 plain printed eyes, 1.15 with pulleys), approach eye gain 1.75, reel lay_width input (review: retrieve critic)
2026-11-03 Spec v1.2.9: D41 fly-in stops at the dog bite and is tension limited after it (systest F20), D42 tow sensing offset -3.0 (physics), carriage 85.8 g as built, flight 4.1 m at 34 deg, SW_INDEX mount on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
2026-11-03 docs/build: review r3_M (polarity at the bare leads first, real decock unload path and a safe manual unload, buck re-measured before VM)
    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
2026-11-03 cad-drum: review round 4: REEL washer keyed on the hex with screws clear of the flats (journal d32), N20 ear arc slots 0..+15 deg only, fork sleeve necked under reel c1, dog post clamp screw onto the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
2026-11-03 jetson: review round 4 fixes (motion commands through a STOP-aware lock, host watchdog restored to off, recover unwraps a seated dart, failed decock re-prompts, serial open keeps DTR high and drops R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
    [base.py, mission.py, test_comms_serial.py, test_mission_realsim.py, test_review4_findings.py, test_ui.py]
2026-11-03 cad-drum: fork tab walls round the contact nut, dog post bar at r1+8.5
    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
2026-11-03 review: N jetson setup and dart wiring findings
2026-11-03 systest: nominal_uncal expects the Jetson's tow refusal (F5), C1 ignores bench sets, tidy slack only on the strict plant, take-up seating during the unwrap allowed, ref_doc_cal retired (F14 fixed in 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
2026-11-03 cad-drum: notes for the whole-base fixes, hub flats end at WIPER.shaft_len from the motor frame
    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
2026-11-03 fw-dart: review round 10 fixes and clean-clone doc fixes
    - NO_GROUND fault: a kick that swings its whole travel through air no longer ends in a false ANCHORED
    - pair check: no-rise rule only in the first 4 readings of a step; needed rise measured from the
    worm's own lowest reading (25 mA floor); no rise needed when the other motor draws nothing
    - a single key reversal reverses the motor (no bothLock latch); bothLock only when both keys repeat
    - /arm refused while ANCHORED (release first)
    - web-loop restart after 30 s (was 10 s) so a stalled /flightlog client cannot reboot the dart
    - README: new 3.3.12 sizes, libraries, test and simulator dependencies, compile from repo root
    - removed the s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
    [kedge_dart.ino, kedge_logic.h, test_logic.cpp]
2026-11-03 cad-drum: report draft v3
    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
2026-11-03 cad-sensors: SW_GAP base and cheek arm in one part (clear of drum_dog_post), riser 4.0, physical cock audit states, closure window tests
    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
2026-11-03 cad-launch: D37 sleeve lugs + M3 r28.5, sleeve follows sleeve_deg/wiper (dog ring), cad-sensors patch (SW_GAP out, pilots), 8 mm rod anchor pins, fallback hole set F, springs to test stage 5, stop re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
2026-11-03 cad-sensors: launch patch rebased on base-v1 cda09d7
    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
2026-11-03 cad-drum: meshes(P) for the mesh check, main shaft always from wiper_deg, fork sleeve 83 long and racking with the far yoke pad, drum B keyed to drum A (one orientation)
    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
2026-11-03 Spec 1.2.9: D40 backward runs in LAUNCH trip at 3 A, D42 tension offset -3.0, D41 fly-in stops creeping at the bite and winds in 5 deg legs limited at 20 N; host_timeout_s no longer saved, require_se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
    [base_logic.h, config.h, sensors.h, test_base.cpp]
2026-11-03 docs/build: decock failure path exactly as fw-base specifies (force only on SWITCH_DISAGREE with the carriage visibly drawn, cock_rest after a manual unload)
    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
2026-11-03 cad-launch: aim train printed drag pad + C clips (no O-ring/e-clips), splitter face 12, wheel face 16; review 3 fixes: drive washer passes the sun rib, ring-first assembly order, worm holds pitch whi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
    [launch.py]
2026-11-03 systest: F10 fixed on branch; angle sensor refusal check
2026-11-03 systest: drum placed with the board off (power_launch_mode)
2026-11-03 cad-launch: NOTES refresh (D37, sensors, stop retune, aim rule after backward turns)
    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
2026-11-03 systest: power scenario operator no longer matches the routine Cock prompt
2026-11-03 cad-reel: brake linkage from cad-drum's track 2 cam: bar (nose envelope on the real cam), bell crank, stiff rocker leg; rocker spring sized with the real section; wall cut round the drum coupler; swi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
2026-11-03 cad-drum: notes for racking, sleeve, keyed drum B, state keys
    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
2026-11-03 cad-launch: REPORT decisions and open items update
    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
2026-11-03 docs/build: dart round 11 (run sheet 6.4/6.5 wire numbers spelled out, old pack cut list marked replaced, capacitor fitted in step 3, live free ends insulated, dart never USB plus loop plug, z on the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
2026-11-03 physics: review round 7 fixes (capstan-side tension for drum stresses, wraps and break check; take-up slip with the seating path gain; shaft at trip without the take-up branch; docstrings), FINDINGS
    [capstan.py, drivetrain.py, retrieve.py, summary.py, test_phys_capstan.py, test_phys_drivetrain.py, test_phys_retrieve.py]
2026-11-03 jetson: r3_M safety (LOADED banner when the shot phase is unknown and the carriage is not home, ESTOP not followed by a mission stop, STOP/ESTOP/dart_stop accepted without the token from the same ori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
2026-11-03 cad-launch: sun key rib over the full 12 mm sun face; carriage lightening in progress (tests pass, quick audit CLEAN)
    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
2026-11-03 Review D2 leftovers: drum re-references on a real code edge when its angle is a guess (boot in N_TO_R, code back after 000), tidy/reel refused on a guessed N_TO_R angle, line_m unknown after a cut mi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
2026-11-03 Spec v1.3.0: D43 pulleys at the exit eye, cup ring and guide (path gain 1.15), tow law and limit at the dart (14.8 / -2.6, cap 60 N); D44 shear pin prints lying down, bench tow test, lay guide; TIMEL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
2026-11-03 cad-infra tools: risk coupon follows drum's new fork (auto print orientation when a part loses its flat bed face)
    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
    [coupon_plate_1.3mf, rc1_arm.stl, rc1_idler.stl, rc1_output.stl, rc1_plate.stl, rc1_sleeve.stl, rc1_sun.stl, rc3_base.stl]
2026-11-03 jetson: base link up only after a valid C1 line (never write to a wrong board), sim sync thread survives bad samples (r3_N #2), firmware version compared by major.minor
    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
    [base.py, test_comms_base.py, test_comms_serial.py]
2026-11-03 physics: seating path gain follows the pulley decision (1.3 with D43 pulleys)
2026-11-03 docs/build: spec 1.3.0 (D43 dart-side tension law and 60 N cap, D44 shear pins broken before the first cock, bench tow stage 7b, fallback hole F 256.5 mm, loaded unless cock 0 and SW_HOME closed)
    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
2026-11-03 cad-infra tools: risk coupon 1 uses launch's printed drag pad, shim and idler clip (face 12), shear pin forced lying (D44)
    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
    [coupon_plate_1.3mf, rc1_drag_pad.stl, rc1_drag_shim.stl, rc1_idler_clip.stl, rc1_plate.stl, rc1_sleeve.stl, risk_plate_1_PLA.3mf, risk_plate_2_PPA-CF.3mf]
2026-11-03 jetson: A2 leftovers (is_wrapped needs all 7 wraps at the park or REEL, prompt before unwrapping a dart seated on the capstan, TIDIED and DART_STUCK in the lists, mock holds with the wraps on like th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
2026-11-03 cad-launch: step stage numbers (authored order, springs last), renumbered steps; merge base-v1
    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
2026-11-03 Spec: D45 rail down before the wrap (10.1 step 7b) and SW_HOME ignored 0.5 s after the release
    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
2026-11-03 cad-launch: REPORT bevel SF at the D40 trip, fallback F accepted
    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
2026-11-03 systest: D43 path gain (dart-side tension = plant / 1.15, calibration dart-side), D45 aim 6 before the wrap in the C1 check
2026-11-03 systest: reference driver D45 aim 6 before the wrap
2026-11-03 frame: v1.x motor end per BASE_SPEC section 2 (motor plate y -10..0, puck adapter in a window with a rear lip, rim screws from the front, SW_INDEX inserts in the puck front face), leg with a two-side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
2026-11-03 jetson: D45 rail low before the wrap (RAIL_LOW step); setup/README fixes in progress
    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
    [check_env.py, mission.py, test_mission.py, test_mission_realsim.py]
2026-11-03 cad-launch: carriage lightening checkpoint (tests pass, quick audit CLEAN)
    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
2026-11-03 cad-drum: hub D bore past the wiper flats end
    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
2026-11-03 cad-sensors: SW_GAP lever at 217.5 deg and base trimmed on the low side (clear of reel_p2_post and the launch sleeve), gear sweep test
    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
2026-11-03 jetson: README RAIL_LOW row, check_env reports the base serial rule (r3_N #3 #4 #6 #7 done)
    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
2026-11-03 Nuisance-fault review: SW_ARM arrivals near the window ends counted and checked 4 deg later, collar dropout waits 100 ms with the wiper stopped, quiet code change must hold 300 ms, code chatter only 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
    [base_logic.h, config.h]
2026-11-03 jetson: base fire CLI test waits for the drum and the aim instead of fixed sleeps
    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
    [test_cli.py]
2026-11-03 Spec: section 8 launcher numbers as built (two-layer big gear, C-243 265 mm, stroke 240.9, F hole 256.5, stop flexure, D36/D37/D40/D45) and section 10 trips (3 A backward in LAUNCH, dart-side tow lim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
2026-11-03 physics: full run on spec 1.3.0 (D43 pulleys), FINDINGS headline
2026-11-03 cad-drum: fork sleeve full r 9 below s 31.5 (bed face), cross-owner meshes behind DRUM_REEL_MESHES until meshcheck skips missing parts; drum+launch audit CLEAN
    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
2026-11-03 cad-infra: render ground from LAYOUT deck_top_z, never above the model (review O #12)
    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
2026-11-03 site: measure list split into 'before printing the base' (A, B, H) and 'confirm in the parts box' (C), full list linked; note style
    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
2026-11-03 cad-drum: dog ring follows launch_sleeve when S has no sleeve_deg and (not LAUNCH or no wiper_deg); D44 pin print note in the step
    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
2026-11-03 cad-launch: review 4: fork pulleys get printed top-hat washers (bosses blocked insertion), M3x20 axles, stale text fixes
    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
    [launch.py]
2026-11-03 cad-launch: stop preload per side, no hard stop (text)
    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
2026-11-03 jetson-vision: placeholder ballistics table uses the real rail window 6..47 (high branch never asks for an aim the base refuses)
    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
2026-11-03 systest: power_launch_mode starts from NEUTRAL via mode; hand_lever scenario; F26
2026-11-03 cad-reel: review-2 fixes: exit post screws clear of gussets, 693 inner-race bosses + M3x20 axles, trim-screw access holes in the reel gear + LIGHT set-up, guide eye top widened, SW_ARM moved off cad-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
2026-11-03 Tow on a stiff (tidied Dyneema) line: start at the minimum duty and speed up only while the line is slack, raw cut after 30 ms, 80 ms start blanking; only a load-cell hold resumes on slack (a jam tha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
    [base_logic.h, config.h, test_base.cpp]
2026-11-03 fw-dart: review round 11 fixes, fuzz extended
    - NO_GROUND also on a retry or a part swing retried (kickPlanted flag; absolute travel check at 95 %
    of the air swing when the travel is known); retries after a real plant still 'kick already down'
    - kick travel scaled by rail voltage; marked unknown when driven by hand with other motors
    - pair check: rise measured from the lowest of the last 4 readings; once rise and line were seen
    together, later over-line readings count until two in a row are under it
    - hold cap counts per motor (alternating keys cannot drive a stop without limit)
    - fuzz: no-ground chaos case and invariant 11; nominal soils follow the documented kick geometry;
    the known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
    [fuzz_logic.cpp, kedge_dart.ino, kedge_logic.h, test_logic.cpp]
2026-11-03 physics: cock gear face from spec LAUNCH.drive_gear (as built face 7), params_hash limited to the inputs ballistics uses, table regenerated
2026-11-03 cad-infra: Assembly.line accepts nested line_path results (segments with name sets)
    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
2026-11-03 systest: power_tow cuts while the tow pulls or holds over 10 N
2026-11-03 fw-dart: simulator no_ground knob and test_12 (NO_GROUND end to end through the real sketch); REPORT update
    Full run_tests.sh green (238 checks, fuzz, sim 12, jetson client 9, page 11).
    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
2026-11-03 cad-drum: no wiper_deg in LAUNCH: the engaged shaft follows the launch sleeve; dog post arm clear of the launch pulley pivot axle; drum+launch audit CLEAN against w/cad-launch 48c4b35+
    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
2026-11-03 cad-launch: carriage set 84.1 g (was 109.5: truss windows, 3 rings, rack back 3, hollow pusher, truss yoke arms); stop review 4 fixes (draw screws M3x20 with 12.5 pilots, front foot bolts reachable, 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
    [launch.py]
2026-11-03 cad-reel: rocker in PPA-CF (no PETG): crank arm A 20 on a bar lug, leg stroke 2.1 mm for LIGHT -> FIRM at E 5 GPa, cam force 5 N; calc summary on the real section
    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
2026-11-03 cad-drum: review round 5: no unreachable shaft screw (shaft captured axially), N20 swing screw on cradle material (holes moved, ear r 20), step order (drum A, idler, rail, coupler, index), index bloc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
2026-11-03 systest: F27 aim 6 refused; ref driver falls back to pitch_range min
2026-11-03 systest: hand_lever waits for the bench save before the power cut; F26 re-confirmed
2026-11-03 cad-infra: interim base outputs 2 (227 parts, tether, mode/drum_pos readout, assembly steps page) for the 15:00 site
    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
2026-11-03 systest: F27 low (Jetson already aims 6.06)
2026-11-03 Spec 1.3.x: D43 dart-side tension law 14.8 / -2.6 and 60 N cap from params; forward gap run closes SW_GAP after an aim or decock (cad-launch: sprag drag opens it), arm starts it and a fire is queued 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
    [base_logic.h, config.h, sim.h, test_base.cpp, test_fuzz.cpp]
2026-11-03 systest: ref driver stops before each new tow pull (F22 by design); F23 fixed on branch
2026-11-03 cad-drum: notes fork print orientation
    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
2026-11-03 systest F26: a drum turned by hand while off boots without a fault (BOOT drum_moved, angle a guess, wraps doubtful near the window); F27: aim targets within aim_tol of the table ends are clamped, not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
2026-11-03 cad-launch: drive gear and full 40T layer face 11 (physics: SF 1.5 at the 5 N m pin), rail shelf/web notched for it; rack 9 wide, carriage set 80.5 g
    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
2026-11-03 jetson-vision: report with test output
    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
2026-11-03 physics: WIP usability fixes (agent in progress)
    [ballistics.py, calib.py, spec_bridge.py]
2026-11-03 cad-launch: NOTES numbers refresh (face 11, 80.5 g, physics speed/range)
    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
2026-11-03 site v4 (interim 15:00): integrated sim and assembly pages from the publishing variants plus web/ data files (each under 16 MB); generated copies ignored
    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
2026-11-03 cad-reel: D44 storage flange r 40 (reel axis to R X -94, shroud r 43.5, wall to X -134); sprag hub flange cut under cad-frame's cheek r; guide 1 moved clear of the shroud
    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
2026-11-03 cad-infra: timeline defines every S key from t = 0 (first target value), no null readouts
    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
2026-11-03 cad-infra: timeline defines every S key from t = 0 (first phase targets, then first target values), no null readouts
    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
2026-11-03 cad-sensors: SW_RAIL_LOW bracket web under the plate, one foot screw + deck screw (x 116 pilot sits under the column), notes for SW_GAP rework
    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
    [sensors.py]
2026-11-03 cad-infra: run_all runs the audit in parallel with the outputs that do not need it (SERIAL=1 for the old order), AUDIT_ARGS passthrough, audit --max-mm, settings in audit.json
    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
2026-11-03 systest: --index-cam (D12 no-magnet build) and no_magnet_index scenario
2026-11-03 systest: magnet-missing set before boot
2026-11-03 params 1.3.1: drive gear and full 40T layer face 11 (SF 1.5 at the shear pin), carriage 80.5 g as built
    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
2026-11-03 systest: aim check uses the shot aim (not the D45 low aim); ref driver records the stop after release
2026-11-03 cad-infra: meshcheck skips (with a note) meshes whose parts are not loaded
    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
    [meshcheck.py]
2026-11-03 jetson-vision: video-only pitch fitted to the horizon track when no pitch is known; rail view all sky bounds the pitch and widens the late-launch search
    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
2026-11-03 docs/build: run sheet pointed to, not appended (no Helvetica anywhere), stop before release, rail to 6 deg before the wrap (D45)
    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
2026-11-03 systest: plant line out follows the rendered flight's range (what the Jetson analyses), shifted by the real pitch
2026-11-03 cad-drum: review round 6b: firmware rules (unexpected code stops, tighter timeouts, boot cross-checks with the dog and arm switches, fault in NEUTRAL, SW_N20 re-boot, D41 fly-in, debounce), unload jo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
    [_drum_kin.py]
2026-11-03 docs/build: rover and mission round 12 (motors-safe state, one serial user at a time, aim before every shot, require_seated after power-up, (g) before spring shots, recovery between shots, 7b gentler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
2026-11-03 fw-dart: review round 12 and coordinator review fixes
    - firmware logs the kick swing it measured ('kick travel from stowed'); NO_GROUND line 90 %, bench
    ground rule 80 %; BENCH step 5 uses the firmware's number (no stopwatch)
    - key-release stop (keep=1) only stops manual motors (r2_B2 #5)
    - page STOP retried until confirmed; Cmd/Ctrl/Alt keys stop held keys
    - INA219 reading well below zero = sensor fault (swapped VIN+/VIN-); IMU silent in /status event;
    failed OTA refreshes the loop heartbeat
    - fuzz: a frozen flight log must hold the launch (r2_B2 #7)
    - WIRING: wire numbers fixed and completed (r3_N #5), A7 DRV#2 GND/VM checks, docs learner items
    - BENCH: hull closed for assembled steps,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
    [fuzz_logic.cpp, kedge_dart.ino, kedge_logic.h, test_logic.cpp]
2026-11-03 Regression review of the afternoon diff: stop / fault clear the gap run and any queued fire; a collar dropout pauses the wiper and keeps its request (homing, fire, decock resume); aim homing time lim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
    [base_logic.h, config.h, drives.h, test_base.cpp]
2026-11-03 physics: usability fixes (v_scale from the spec, pytest last in run_all, clear test messages, STALL rows, calib spring force verdict at 41 N soft limit, spec key names, numbered measure list)
    [calib.py, summary.py, test_phys_ballistics.py, test_phys_calib.py, test_phys_spec.py]
2026-11-03 cad-drum: cross-owner meshes with cad-reel on by default (meshcheck skips missing parts)
    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
2026-11-03 jetson-vision: review round 2: dark check on the whole landed window (a void with one lit frame was GO), grey images in terrain, UNSURE fallback score 45, stronger mosaic and capture read-back tests
    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
2026-11-03 jetson-vision: report round 2
    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
2026-11-03 systest: ref driver tells the base the true landing line out
2026-11-03 jetson-vision: report terrain eval with tilt
    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
2026-11-03 cad-reel: review 3: linkage follows the reel move, LIGHT stop pad, adjustable FIRM screw in the rocker leg (covers E 4..9 GPa), d7 crank boss + M3x20, blind flange-disc slots, C clip land 1.65, rocke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
2026-11-03 fw-dart: stuck I2C bus recovery by time (1 s), not tick count; API 409 note
    Full run_tests.sh green.
    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
    [kedge_dart.ino]
2026-11-03 Adversarial round 2: an interrupted gap run leaves the phase unknown (a held jog then gets WOULD_FIRE; no shot), REST re-zeroes on the first tooth, no forward jog with SW_GAP open; decock with the ph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
2026-11-03 cad-launch: guards (bracket screw access, segment a rear wall + top cover, b split for side fitting, c bolts off the anchor posts), lip roller printed washers, fire phase is the shot in kin, idler ke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
2026-11-03 cad-launch: REPORT open items (guard coverage, rail front supports, shelf notch)
    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
2026-11-03 site: Jetson operator page section with a full dry-mission screenshot (simulator, all 23 steps, landing zone GO, aerial map)
    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
2026-11-03 Fuzzer: tension constants count as calibration faults; docs in progress
    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
2026-11-03 cad-sensors: report draft, notes for the SW_RAIL_LOW bracket fixing
    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
2026-11-03 systest: dart sim plays the rendered flight's own IMU samples (consistent /flightlog for the Jetson's landing estimate)
2026-11-03 frame: puck carved round the reel cup and capstan (rim screws counted on plate and lip), v1 steps rewritten, bay exits away from the leg, rover holes kept out from under feet, camera plate tilted to 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
    [_frame_ebay.py, _frame_guard.py, _frame_kit.py]
2026-11-03 Docs: gap-run abort, decock with SW_GAP open, collar pause, tow re-pull rule; motors-safe state (lead #2 XT60), require_seated not saved
    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
2026-11-03 jetson-vision: review round 3: clock offset from the launch match only, flightlog rows sanitised, no launch fallback onto the impact when the log starts late, per-sample time steps in the push integr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
2026-11-03 jetson-vision: report round 3
    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
2026-11-03 params 1.3.2: REEL path_gain 1.30 (cup ring plain eye), dart-side law 13.1 / -2.3, tow cap 55 N; drum as built (spigot 106..198.5, main axis to 201.5, REEL dogs to 69.5, cup lock frees 62, idler face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
    [params.py]
2026-11-03 cad-reel: D43 exit eye replaced by pulley 1 (groove tangent to Harry's ring-to-eye line at the old eye centre), new pulley 1 post, line spans and check
    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
2026-11-03 frame: report and auditor notes
    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
2026-11-03 cad-reel: reel_calc flange default r 40 (D44)
    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
2026-11-03 systest: path gain read from the firmware's params_gen.h (D43/D46), LIMIT vs plant dart-side tension check
2026-11-03 docs/build: params 1.3.2 and D46 (tow cap 55 N, law 13.1/-2.3, first field tows 40 N, drum N20 0.171 N m, brake trim screws)
    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
2026-11-03 jetson: BASE_NEUTRAL no longer waits out the reset timeout after RAIL_LOW; final approach max_s from the firmware approachLimit formula (O#13); mock and tests follow base-1.2.1 (drum holds with the w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
    [base.py, mission.py, mock_base.py, mock_dart.py, test_comms_base.py, test_dart_v4_round11.py, test_review5_findings.py]
2026-11-03 cad-drum: brake track LIGHT across the whole LAUNCH zone to the -4 stop (cliff in the unreachable gap)
    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
2026-11-03 cad-reel: notes v6 numbers (flange d 80, pulley 1 at the eye, linkage with FIRM screw), FIRM set-up step, report open items and measure list
    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
2026-11-03 cad-launch: NOTES strength notes (cock train face 11, aim bevel protected by the 3 A trip, rim supports)
    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
2026-11-03 fw-dart: review round 12 (logic) fixes; full fuzz passes on 6 seeds
    - kick swing stall decision table: planted -> already down; >= 90 % -> NO_GROUND; near stowed or
    moved over 10 % in air -> KICK_JAM; soft end stop 'contact' at >= 90 % -> NO_GROUND
    - NO_GROUND sets the kick position to its end stop and blocks 'planted' until it comes back
    - rise rule: readings compared at refV (rail sag no longer hides a stall), latch tied to the
    level before the rise, 2 of the last 3 readings also count
    - hold cap refusal 'hold limit: release the key first' (distinct from an end stop)
    - pods lead NO_CURRENT judged over 100 ms, not one sample
    - fuzz: plant stalls within 10 % of the firmware line reported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
    [fuzz_logic.cpp, kedge_logic.h, test_logic.cpp]
2026-11-03 params 1.3.2 / D46: dart-side law 13.1 / -2.3, tow cap 55 N; cad-drum's tightened drum rules: timeout 1.3 x nominal + 1 s, an intermediate code must last 70 percent of its span, unload jog 6 deg stop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
    [base_logic.h, config.h, test_base.cpp]
2026-11-03 frame: tests for the v1 puck rim screws, STL check on v1 parts
    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
2026-11-03 jetson: tow cap 55 N at the dart (D46); F28 factory k matches every firmware default; F22 stop before a new reel after HOLD; F24 host watchdog 2.5 s with a fixed 0.4 s ping schedule; dart hold() stop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
    [base.py, dart.py, mission.py, test_app_unit.py, test_comms_dart.py, test_comms_serial.py]
2026-11-03 cad-drum: review round 6a: N20 swing slot in the cradle with the ear tapped, SW_N20 nut in the ear front face (screw from +s), strap screws in lugs, contact nut pockets flats to s, switch block top +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
2026-11-03 systest: F29 fused landing range 27 % short
2026-11-03 cad-drum: notes printing table (supports, brims) and N20 cradle hardware
    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
2026-11-03 params 1.3.3: unload jog 6 deg (fw-base + cad-drum, dog play +-8), TIMELINE follows
    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
2026-11-03 cad-drum: report draft v4
    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
2026-11-03 jetson-vision: calibrate_range switch (systest F29: sim worlds that do not follow the C3 table)
    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
2026-11-03 systest: step 15 judged on the base's line_m at the stop and no capstan seating; landing estimate error informational (F29 sim/table gap)
2026-11-03 README: FIRST_DAY first, and the Jetson simulator as a start-here step
    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
2026-11-03 systest F28: tension_cal flag (get key and status field), set by k_n_per_a / tension_offset_n, saved with the tuning, cleared by the new cal factory; docs for D46 and the cad-drum rules
    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
2026-11-03 params 1.3.4: ASSEMBLY_STAGES, one global stage band per subsystem group for the generated assembly order (cross-owner constraints built in)
    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
2026-11-03 jetson: mock and tests follow base-1.3.0 (version, k 14.8 / offset -2.6, max_n over the cap BAD_ARG); contract request for a tension_cal status flag
    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
2026-11-03 cad-drum: code and index lever angles solved exactly on the designed nub path; firmware rules in NOTES 7 and drum_table.json match fw-base c740e46
    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
    [_drum_kin.py]
2026-11-03 frame: wider stepped leg foot (8 thick, screws 36 apart), calc checks the leg feet, flange and rim screws
    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
2026-11-03 cad-reel: review r3_Q: SW_ARM notch with 45 deg ramps, capstan drum PPA-CF (hoop stress), hub screw taps through, pulley 2 web under cad-sensors' SW_GAP
    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
2026-11-03 fw-dart: merge base-v1; WIRING B2 beep check before the LiPo (OPEN_ITEMS r1_G #21); REPORT triage
    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
2026-11-03 cad-drum: step stages (drum A 130, idler 140, rail 145, coupler with REEL gear 146, index 147, shift 160-163, stack 170-171)
    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
2026-11-03 frame: notes for the puck adapter
    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
2026-11-03 frame: cable routes bundle by bundle
    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
2026-11-03 fw-dart: coordinator review r3_B3 fixes
    - /flightlog refusals give distinct reasons: busy (motors running), armed (disarm first), in flight
    - API.md no longer contradicts itself on arming from ANCHORED
    - tests: impact landings 7, 8.5 and 10 s after launch keep 2 s before launch in the frozen log
    Full run_tests.sh green (249 checks, fuzz 2 seeds, sim 12, jetson client 9, page 11).
    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
    [kedge_dart.ino, test_jetson_client.py, test_logic.cpp]
2026-11-03 Tow: no duty ramp before the first tension samples, cut on tension + rise rate x 60 ms (stiff line going taut); docs for tension_cal and cal factory
    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
    [base_logic.h, config.h]
2026-11-03 cad-infra: audit sub-states evaluate kin on the blended state; joint interpolation only across a string / bool / 0-1 flag change (fake drift collisions)
    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
    [audit.py]
2026-11-03 cad-sensors: review fixes: housing deck screw from above through the SW_RAIL_LOW foot, bracket prints foot down, strip screws into carrier nut pockets with clamp preload, 8 mm plate and 10 mm column 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
    [sensors.py, test_sensors.py]
2026-11-03 jetson-vision: report full suite at bc19732
    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
2026-11-03 cad-infra tools: steps strictly by ASSEMBLY_STAGES, band checks, dependency only validated, band labels
    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
2026-11-03 cad-infra: guide prints the step heading with the stage band
    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
2026-11-03 PROTOCOL: tow keeps minimum duty until the first tension samples, rate-predictive hold
    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
2026-11-03 cad-infra: guide step heading 'Step n (band stage). title', unchanged without a stage
    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
2026-11-03 cad-infra: STEP export skips meshes over 100k triangles (use the STL), runs last in run_all, STEP_ARGS passthrough
    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
    [step_export.py]
2026-11-03 physics: review round 9 fixes (seating gain for the plain-ring path, v_scale in the trajectory plot, hash scope applied, drivetrain text), docs
    [common.py, drivetrain.py, plots.py, retrieve.py, test_phys_retrieve.py]
2026-11-03 cad-reel: pulley 2 on a swivel fork about the incoming run (line within 2 deg of the groove over aim 6..60), post block with the tube bore and C-clip, pulley 2 raised 4 mm off the drum; test
    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
2026-11-03 frame: wiper stub follows drum_main (same shaft); auditor notes
    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
2026-11-03 params 1.3.5: TIMELINE lowers the rail right after the flight (rail_low, D45) instead of at the end; wiper targets re-phased so every engaged state stays in the dog play; site name for rail_low
    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
2026-11-03 frame: print table script, v1 part notes
    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
2026-11-03 cad-infra: sim_hero.png, a stable-name shot of the aim phase for the site
    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
2026-11-03 cad-reel: notes: pulley 2 swivel section and coordinates
    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
2026-11-03 jetson-vision: review round 4: dark check on the first landed frames (a dying link no longer hides good ground), no launch without rest before the push, bad clock_offset_s ignored, solve with no rows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
    [ballistics.py, flight.py, test_ballistics.py, test_flight.py, test_terrain_flight.py]
2026-11-03 frame: report mass, CG and stability
    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
2026-11-03 params 1.3.6: drum stage bands as cad-drum must assemble (drum_core 130, idler 140-144, main_shaft 145-149); site hero from shots/sim_hero.png; spec final-approach margin about 1.7
    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
2026-11-03 cad-launch: review r3 P HIGH: sprag outer key rib 1.3 deep (CSK20 outer keyway 1.5) with keyway modelled, lip levers at rest with a 0.5 gap on their own joints, yoke spring pegs printed PPA-CF in d8.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
    Claude-Session: https://cla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
    [launch.py, test_launch.py]
2026-11-03 cad-launch: REPORT decisions 14-17 and open items
    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
2026-11-03 cad-infra: REPORT draft update
    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
2026-11-03 jetson-vision: cache the speed model tracks (pitch fit cost)
    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
2026-11-03 jetson-vision: report round 4
    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
2026-11-03 docs/build: round 13 (Jetson step 4 at the end of step 7, bench tow 40 N band 35-45, spring test 3.5 kg max, bench magnet taped, 23 coupon pieces, tow overshoot wording, motors note)
    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
2026-11-03 Tow: the taper may only lower the duty (it undid the tow cap above 70 % of max_n); fly-in limit uses its own current estimate when the code is not REEL; test
    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
2026-11-03 cad-infra: coupon 10 magnet is not included with the board (MEASURE_LIST C13); cap fits the base spigot, bench test tapes the magnet
    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
    [coupon_plate_1.3mf, rc10_magnet_cap.stl, rc3_base.stl, rc3_dog_post.stl, rc3_fork.stl, rc3_reel_face.stl, rc7_spigot.stl, rc9_hub_lever.stl]
2026-11-03 jetson-vision: report mutation check
    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
2026-11-03 jetson: tension_cal flag from the base (F28), else params.py default k; dart hold raises on hold limit; LANDING_ZONE ends a stuck FLIGHT with /stop instead of a 40 s wait; mock cap 55 N, k 13.1 / -2.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
    [dart.py, mission.py, mock_base.py, test_comms_base.py, test_comms_dart.py, test_review3_findings.py, test_review5_findings.py]
2026-11-03 cad-sensors: SW_GAP at 213.75 deg, contact 1 mm in on the bump, 10 mm clamp pad (3.1 mm from the moved reel pulley 2 arm, 2.0 from the sleeve), clearances enforced; assembly stages 210-213
    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
    [sensors.py, test_sensors.py]
2026-11-03 review: S frame deep review
2026-11-03 frame: puck prints front face down, hood prints roof down
    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
2026-11-03 Spec: D47 the wiper boss face is the y 0 datum (frame places the motor to it; coupler engagement from params WIPER); deck tiles keep 3 mm bed margin
    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
2026-11-03 cad-sensors: no literal em dash in the test source
    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
2026-11-03 cad-reel: review 4: pulley 1 axle tapped into its post and heads seated, stiffer pulley 1 column, wall to X -139.5 under the shroud screw, shroud taps through, race bosses r 2.25, FIRM screw text, no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
2026-11-03 Fault safing holds the drum in LAUNCH with SW_GAP open; mode/cock/decock cancel the arm token even when nothing moves; decock re-runs a stopped gap run; tests
    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
2026-11-03 jetson-vision: fisheye lens option for the horizon pitch (Caddx Ant), hfov and lens through run_post_flight
    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
2026-11-03 jetson: base console (one connection: live telemetry and events, typed commands); README tow rule, wrap and take-up timings, port-busy note; INTERFACES.md for jetson-vision APIs
    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
2026-11-03 docs/build: base console (one connection: telemetry plus typed commands) in the test plan, calibration, bench test and cheat sheet
    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
2026-11-03 cad-sensors: housing 4th deck screw from below (cad-launch 4d203e4) continues into a pilot in the SW_RAIL_LOW foot (M3x20)
    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
2026-11-03 fw-dart: review round 13 fixes (whole logic + end-to-end missions)
    - release: the drills turn with the lifting pods for 0.6 s, then the pods finish alone (read every
    tick); a stall before 60 % of the way back is the new fault PODS_JAM, not 'legs stowed'
    - release kick check counts travel only up to a pair reading under the line
    - /arm refused while the kick or pods are known to be out ('legs out: release first')
    - phase LANDED not shown again after a release or a hand move
    - the first accepted press after refused ones starts a fresh hold (no instant 'hold limit')
    - presses older than a minute are forgotten (no stale lock after 25 days)
    - 409 bodies carry the refusal once
    - fuzz: nominal sc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
    [fuzz_logic.cpp, kedge_dart.ino, kedge_logic.h, test_logic.cpp, test_sim.py]
2026-11-03 Docs: base console instead of monitor plus cmd, buck fuse at the B+ screw, reel cap 55 N
    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
2026-11-03 Final touches: MEASURE_LIST C15/C16/C19/C21 match the CAD (8 mm rod anchor pins, PPA-CF rocker, printed coupon drag pad and clips); firmware comments and REPORT quote the D46 law and 55 N cap
    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
2026-11-03 D12 index mode: the coast estimate after a stop no longer grows the launch phase at REST (systest F31: mode NEUTRAL LAUNCH_BUSY after every shot); test; REPORT
    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
    [base_logic.h, test_base.cpp]
2026-11-03 jetson: F22 tow rounds stop (and wait for ABORTED) before a new reel, the held estimate never skips a pull without a load cell; review 6: landing zone never stops an anchoring or releasing dart (stop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
    [mission.py, test_review5_findings.py]
2026-11-03 jetson: REPORT verified counts and open items at the end of the day
    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
2026-11-03 jetson: REPORT slow suite wording
    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
2026-11-03 Assembly order: params 1.3.7 ASSEMBLY_STAGE_OVERRIDES give every unstaged frame/launch/reel step its global stage (launcher band 190-204, aim 205-209); tools.steps reads them; plan check report-only 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
2026-11-03 Final base outputs: audit, print pack, BOM, guide, sim and steps pages
    Full pipeline at params 1.3.7: 235 parts over 44678 poses, audit nearly clean
    (2 small passing overlaps, 1 bracket STL not watertight). Print pack: PLA 108 parts
    on 13 plates, PPA-CF 48 parts on 4 plates. Steps page regenerated with the stage
    overrides; sim and assembly screenshots recaptured. README status filled in.
    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
    [BOM.csv, drum_axle.stl, drum_bracket_a.stl, drum_bracket_b.stl, drum_bracket_idler.stl, drum_bracket_idler2.stl, drum_collar.stl, drum_coupler.stl]
2026-11-03 Build guide: regenerate with the final base print pack and assembly guide
    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
2026-11-03 Spec 1.3.8: final cross-check fixes (D48 boss face datum, drum code edges, gear planes)
    params: WIPER boss_face_y -10 (D48, supersedes the y 0 datum of D47), DRUM code_edges
    as built, big gear full layer plane (face 11), splitter sun plane 170..182.
    BASE_SPEC: gear numbers and the retrieve max_s default synced to params and firmware.
    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
    [params.py]
2026-11-03 Frame and drum hub: D48 boss face datum, tether channels in the puck, SW_INDEX step text
    cad_power-1 (D48): the frame places the wiper motor from params WIPER boss_face_y
    (-10, the motor plate's rear face) instead of the plate face, and frame.checks flags a
    boss_face_y that is not the plate's rear face. drum.G derives the coupler hub (start,
    D bore end, M8 nut seat) from boss_face_y and the WIPER shaft numbers through cad-frame's
    motor model (wiper_cfg), so measurements move the shaft and the hub together. With
    today's numbers the hub starts at y -5 in the puck bore (1.0 above the output boss, 0.5
    once the nut pulls it onto the end of the flats), the D bore takes 13.5 mm of the flats
    and the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
2026-11-03 cad-launch, cad-sensors: aim housing screws to the deck from the top, engaged stop post, sprag direction
    Cross-check fixes cad_support-4, cad_power-3, cad_power-2 and the cad_power-4 comment.
    - cad_support-4: the deck is on the rover long before Aim 3, so the aim housing now
    screws to it from the TOP: foot flanges behind the spine, in front of the outer
    wall and on an inboard tab, 4 x M3 x 10 through d6.1 x 3.2 counterbores into deck
    heat-set inserts. launch.deck_holes(P) re-exports launch_aim.deck_holes so
    _frame_others.deck_contacts cuts the inserts. Probed in an export: insert holes
    in frame_deck_1/3 at all five points; deck outline and seams unchanged; deck
    holes 40 -> 45. T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
    [rc1_plate.stl, rc1_sleeve.stl, rc1_stop_e.stl, risk_plate_1_PLA.3mf, risk_plate_2_PPA-CF.3mf]
2026-11-03 Final cross-check fixes: base-1.3.1, Jetson and systest (fw-1..11, cad_support-2/3/6/9, docs-16, jetson-1..9)
    Firmware (base-1.3.1, params 1.3.8):
    - fw-1 / cad_support-2: gapCloseDeg 520 -> 531 (CAD SW_GAP window, +-14.9 big-gear
    deg = 22.9 wiper deg before rest); new set key gap_close_deg (480..553, BUSY while
    moving), COCKED reports gap_deg, CALIBRATION.md (h); Tun record ver 3.
    - fw-2: gap run limit 150 -> 215 wiper deg (the 127 deg sprag drag is big-gear deg,
    195 wiper deg); tests and fuzz drag 195.4.
    - fw-3 / cad_support-6: aimHomeDeg 3365 -> 3502 (CAD SW_RAIL_LOW window +-97.6 aim deg).
    - cad_support-3: SW_SEATED latch: a dart seated when the cock starts (carriage home)
    still c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
    [base.py, base_logic.h, config.h, dart.py]
2026-11-03 Docs: cross-check fixes (docs-1, docs-2, docs-4 to docs-15, docs-17)
    - docs-1: MEASURE_LIST "After you measure" runs FORCE=1 base/run_all.sh (the audit
    lists only the known items), the physics (sh base/physics/run_all.sh: ballistics.json,
    SUMMARY, tests) and make_guide.py with kedge/.venv; README, 00_title, 01_system,
    04_printing and FIRST_DAY say the same. kedge/requirements.txt adds pypdf (guide
    appendix) and pytest (physics run). make_guide.py falls back to Arial and Courier New
    on macOS (the Liberation font path is Linux only).
    - docs-2: physics README: the stronger spring over 38.4 N at full cock means hole set F
    (8.5 mm rearward, 256.5 mm); there are no 250 mm holes. B4 str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
    [summary.py]
2026-11-03 Reel: pulley 2 post feet, SW_ARM polarity and pilots, pivot pulley feed, whole-assembly tether check
    cad_support-5: the pulley 2 post foot is 29 mm wide (it was 17.7 and its four M3 holes broke out of the
    edges, so cad-frame cut no inserts). Every hole has 2.8 mm or more of solid round it, and the gussets now
    sit on the foot and are fused to the column (they stood 0.15 mm off it). deck_holes(P) lists all 15 reel
    deck screws for _frame_others.deck_contacts: after export frame_deck_1 has the four inserts under the post,
    the other eleven and the deck tiles are unchanged, frame.checks is clean.
    cad_support-7 / docs-3: the SW_ARM step, the part notes and the comments follow the real polarity: cl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
2026-11-03 Tether over the lip roller, spring fallback hole set F, spec comments after D48
    launch.line_path routes the pusher to dart span over the lip roller when the dart is
    ahead and below (the whole-assembly tether check now passes: 0 hits). params: spring
    fallback 256.5 mm (hole set F), frame datum comment after D48, SW_ARM window as built.
    D30 and calib.py follow.
    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
2026-11-03 F32 index-mode tow, SW_ARM window text, physics summary on macOS and layout
    Firmware indexTick: while winding the capstan in REEL the SW_INDEX overdue window is
    4 x longer and its clock restarts while the line takes up load (current above free
    running + 0.5 A); LAUNCH keeps the 1.5 x window. systest no_magnet_index passes.
    summary.py finds Arial on macOS and wraps long rows; risk plate 1 has 24 pieces.
    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
2026-11-03 Base outputs (in progress): assembly, renders, sim, steps, pack and BOM at params 1.3.8
    The exact-mesh audit and the base guide are still running; their outputs follow in
    the next commit.
    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
    [BOM.csv, drum_coupler_hub.stl, frame_deck_1.stl, frame_deck_3.stl, frame_guard_front.stl, frame_motor_adapter.stl, launch_aim_housing.stl, plate_10_PLA.3mf]
2026-11-03 Final audit after the cross-check fixes; README status
    Exact-mesh audit at params 1.3.8: 235 parts, 44678 poses, only the 2 known small
    passing overlaps (24.5 and 55.6 mm3); the bracket STL defect is gone and the new
    whole-assembly tether check has no hits. Base guide regenerated.
    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
2026-11-03 Mission: skip the capstan reel-in when line_m is lost after a tow
    After a base reset during the tow the base has no line_m, and the landing estimate is
    too long once the tow has pulled the rover in: reeling on the capstan by it pulled the
    dart into the cradle on the capstan (systest usb_unplug_tow, D16). The take-up final
    approach now does all of it in that case; before any tow the landing estimate is used.
    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
    [mission.py]
2026-11-03 Build guide and sim screenshots from the final outputs
    Guide regenerated (142 pages) with the final print pack, the base guide and the
    calibration step (h) gap_close_deg; sim screenshots recaptured.
    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
2026-11-03 Site and README: final test results; frame layout test ignores real-layout deck holes
    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
2026-11-03 Mechanisms one by one: sim picker and explainer page
    tools/mechanisms.py groups the 235 parts by mechanism (motor and torque limiter,
    selector drum, wrap cup, capstan, storage reel and clutch, launcher, cock and release,
    aim, tether path, switches, frame) with what each does and drives. The sim gets a
    "show" picker (and sim.html#mech=<key>) that isolates one mechanism while the mission
    plays; the site gets mechanisms.html with a picture of each on its own and its parts.
    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
2026-11-04 Proposal D49: rail-mounted reel and capstan layout study (not yet applied)
    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
2026-11-04 Spec: D49 rail reel (params 1.4.0)
    DECISIONS D49 supersedes D14, D34, D36 (the guide is the cup eyelet), D20
    capstan placement, D25 c1 on the capstan tube, D43/D46 pulleys and the
    D7/D24 0.5 N LIGHT. params: RAIL_REEL block (rail frame positions, trains,
    bridge, pitching mass), REEL capstan 2.307, spool d40/d62 x 20, LIGHT
    0.25 N fixed, path gain 1.18, payout gain 1.04, tow law 14.1/-2.5, DRUM
    wrap train 49T/28T, SW_INDEX frame-fixed, ASSEMBLY_STAGES bridge and head
    after the rail.
    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
    [params.py]
2026-11-04 Physics: D49 rail reel (spool d40/d62, LIGHT 0.25 N, capstan 2.307, path gain 1.18)
    Payout gain 1.04 from params REEL, aim moment from the real pitching mass
    (RAIL_REEL pitching: the head balances the launcher, nose-up moment),
    seating gain 1.05 on the straight line, C3 drag columns 0.25 / 0.5 /
    0.75 N. Ballistics and every physics output regenerated: about 4.9 m at
    34 deg, 7.05 m/s.
    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
2026-11-04 Firmware and Jetson: D49 tow law 14.1/-2.5, capstan 2.307, LIGHT 0.25 N column
    params_gen.h regenerated from params 1.4.0; config.h fallbacks and the
    documented wrap direction (positive drum still wraps); PROTOCOL and
    CALIBRATION defaults; Jetson default drag 0.25 N (the C3 table columns
    are now 0.25 / 0.5 / 0.75 N).
    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
2026-11-04 WIP D49: rail reel CAD in progress (incomplete, not audited)
    Drum, frame, launch and reel module edits and tests as left when the rebuild agent
    stopped. main is untouched.
    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
2026-11-04 Reel D49: clutch leaf 4.6 mm so FIRM reaches 5 N (reel tests pass)
    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
2026-11-04 D49: drum B watertight, c1' stub prints on its flat; guide sources for the rail reel
    Full audit at dt 0.2: only the 2 known small collisions, tether check clean.
    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
2026-11-04 D49: mechanism groups (clutch disk) and site texts for the rail reel
    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
2026-11-04 Jetson realsim: basesim bench counts as calibrated (F28), tests follow D40 SW_ARM and F23 wrap line draw
    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
2026-11-04 D49 rail reel: full pipeline outputs, guide, site and README status
    Audit: 233 parts over 46676 poses, only the 2 known small overlaps
    (drum_coupler x drum_index_lever 24.5 mm3, launch_aim_sun x launch_aim_idler
    55.6 mm3); whole-assembly tether check clean. Range about 4.9 m at 34 deg
    (5.0 m at 40) with the fixed 0.25 N brake. Print: PLA 95 parts on 15 plates
    (4.0 kg, 109 h), PPA-CF 60 parts on 4 plates (1.5 kg, 68 h).
    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
    [BOM.csv, drum_axle.stl, drum_bracket_a.stl, drum_bracket_b.stl, drum_bracket_idler.stl, drum_bracket_idler2.stl, drum_crank.stl, drum_dog_post.stl]
2026-11-05 D50 start: restore the 53ed345 design (reel at the base), keep the D49 study file and the basesim F28 fix
    Reverts the D49 rail reel (7031a2a..eedf646) in CAD, params, firmware, Jetson, physics and docs.
    Kept: base/spec/proposals/D49_rail_reel_layout.md (numbers only) and b02c538 (basesim bench calibrated, realsim tests).
    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
    [BOM.csv, drum_axle.stl, drum_bracket_a.stl, drum_bracket_b.stl, drum_bracket_idler.stl, drum_bracket_idler2.stl, drum_crank.stl, drum_dog_post.stl]
2026-11-05 D50 spec, firmware and Jetson: reel unit behind the launcher (params 1.5.0)
    DECISIONS D50 (supersedes D49), params REEL (free spool d40/d62 x 20, LIGHT 0.25 N fixed, path gain 1.18,
    payout gain 1.32, dart-side law 14.4 / -2.5, capstan still 50/22) and the new REEL_UNIT block, BASE_SPEC
    interfaces and section 9, ASSEMBLY_STAGES texts. Firmware tension defaults and params_gen.h (470 checks pass),
    Jetson LIGHT 0.25 N column (suite passes). Physics: C3 drag columns 0.25 / 0.5 / 0.75, payout gain and the
    take-up chain inertia from the spec.
    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
    [params.py]
2026-11-05 D50 physics: regenerated ballistics.json and outputs (LIGHT 0.25 N, payout gain 1.32, take-up chain inertia)
    Physics run_all: all models ran, 83 tests pass.
    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
2026-11-06 D50 CAD: reel unit, lanes and front take-offs; rail-rear pulley; deck extension tile; systest offset
    Frame tests pass (extension tile dovetailed on the main deck's rear edge), reel tests updated for D50,
    systest nominal and ref_nominal pass with the two-point offset at half the bench drag.
    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
2026-11-06 D50 docs: MEASURE_LIST bearing count, calibration example note
    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
2026-11-06 D50: keep LAYOUT axes.capstan on the cup gear axis (cad-drum places the wrap idler from it), reel unit capstan under its own key; I_c mesh frames, spool flat, slack-line tether allowance
    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
2026-11-06 D50: allow the brake bar nose on the drum cam (0.03 mm3 envelope sampling)
    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
2026-11-06 D50: round shafts print standing (flat end face on the bed); README D50 status
    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
2026-11-06 D50 full pipeline outputs: audit (only the 2 known tiny collisions, tether check clean), render, sim, steps, pack, BOM
    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
    [BOM.csv, frame_cheek_r.stl, frame_deck_1.stl, frame_deck_2.stl, frame_deck_3.stl, frame_deck_4.stl, frame_deck_ext.stl, frame_guard_front.stl]
2026-11-07 Notes: dart-jetson asks dart-physics for flight and landing numbers at 7 m/s
    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
2026-11-07 dart-physics: v31 shared model (mass incl. own inertia, profiles, motor torque from bench currents, reviewed soils) and anchoring analysis (deploy milling, install/unscrew torque, planar limit analys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
2026-11-07 Notes: dart-physics anchoring asks to dart-cad and dart-fw
    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
2026-11-07 dart-physics: v31 physics on v30 geometry: real launcher loads, flight check (tether keeps it nose first), landing loads and rest states, anchoring limit analysis, pull-test script and procedure, fin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
2026-11-07 Notes: dart-physics findings, more cad asks, fw orientation gate, jetson answers and tow ramp
    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
2026-11-07 Jetson: realistic dart flights (real launcher, Caddx fisheye, analog chain) and the vision fixes they showed
    - sim: real launcher by default (C3 speed with 3 percent spread, 8..47 deg, exit 0.42 m, drag fitted to
    base/out/ballistics.json within 0.8 percent); profile caddx: equidistant fisheye with a 4:3 picture in 720x480,
    auto exposure lag, motion blur, sensor and FM noise, sharpening, vignetting, chroma smear, sparkles, line
    jitter, interlaced fields, YUYV capture, 60 ms capture delay, repeated frames; rest flat or buried
    - vision/lens.py: measured or default dart lens, every frame rectified to the canonical 100 deg pinhole view
    - calibrate dart: fisheye checkerboard calibration (pic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
    [eval_realistic.py, flight.py, test_flight.py]
2026-11-07 dart-physics: motor heating while milling
    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
2026-11-07 dart-physics: holding plot with the fixed design
    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
    [dart_anchor.py]
2026-11-07 Dart v31 WIP: generator defaults v30 + anchoring hardware fixes (deploy stop horns, fold lugs, kick rest, pod stack with terminal and bushing room, auger core 7.5, pod caps), tail cap socket seats, k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
    [launcher_fit.py]
2026-11-07 Dart fw v4.1: real-launcher flight windows, orientation, battery at rest, optional video switch, kedge/fw synced
    - minFlightMs 400 -> 250, pushOverMs 400 -> 200: the real launcher's 6 deg shot lands about 0.42 s after the push
    starts, which the old 400 ms window missed (fell back to a 'still' landing)
    - orientation from the BNO085 accelerometer while still (orient, tilt_deg in /status, Tuning imuUpAxis); /auto refused
    'not upright: on its side / upside down' unless /auto?force=1; auto on landing not started when not upright
    - battery state at rest from the INA219 bus voltage (batt, batt_V): low 6.8 V warns, critical 6.4 V refuses /auto
    (release still works) and switches the video off
    -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
    [wire_cut_list.csv]
2026-11-07 Dart v31: pivot z 11 (deploy 43.0, augers 45.7 deep), hard-stop audit, solver regen loop, wire room and mass props tools, v4 harness on v31 routes, coupon v31 row, pack supports
    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
2026-11-07 Notes: dart-cad v31 decisions and replies to dart-physics and dart-fw
    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
2026-11-07 Jetson dart: 5 Hz status spacing, WiFi gaps by time, frozen flight log, lens and capture delay settings, learn tools
    - comms/dart: /status requests from every caller spaced 0.2 s (API 5 Hz), wait_phase gives up after 10 s of no
    answer (not a miss count), hold retries a first-press stall lock once
    - mission: wait for log_frozen before /flightlog, ride out a WiFi gap for the log, preflight dart INA219 and
    battery (flat under 6.0 V, warning under 6.6 V), dart fault codes in plain words, lens and capture delay to the
    analysis; app/cli/settings: dart_cam_calib, dart_hfov_deg, dart_aspect, dart_video_latency_s
    - mock dart: log freezes 3 s after landing, WiFi gaps, settable rail and INA219
    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
    [ballistics.py, dart.py, eval_realistic.py, flight.py, mission.py]
2026-11-07 Dart v31: d13 augers (core 6, flat base on the inner race), pods y 29, no ballast, PPA-CF couplers printed flat, run sheet and report generators for v31, STEP check, wiring diagram for the v4 list
    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
2026-11-07 Dart fw v4.1: dart-physics anchoring asks (milling deploy, drill relax, release rocking and milling, orientation gate with levelling, anchor motion), docs
    - pods step: a deploy stall before 85 % of the estimated travel is soil: pause 0.2 s with the drills cutting, push again;
    5 s without progress ends it (the stop when past 60 %, else pods_time_limit); 6 s limit until milling starts, 30 s after
    - drill pair over 85 % of its line (read alone): deploy paused 0.5 s; soil_mA in /status
    - release: stuck drills rocked (in 0.3 s, out) up to 5 times before DRILL_JAM; pods held in soil milled up, PODS_JAM after 5 s
    without progress
    - orientation gate with imuNoseAxis: leaning 12-60 deg levels wit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
    [fuzz_logic.cpp, kedge_logic.h, sim_world.cpp, test_logic.cpp, test_sim.py]
2026-11-07 Notes: dart-physics final v31 numbers, horn check ask, kick planting and heat for fw
    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
2026-11-07 Notes: dart-fw v4.1 API changes for dart-jetson, pins/wiring/kedge-fw for dart-cad, physics asks status
    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
2026-11-07 Jetson dart: dart-physics flight and landing numbers in the realistic sim, API v4.1 (orientation gate, battery, anchor moving)
    - sim caddx: angle of attack 4 to 16 deg decaying slowly, no roll, skid 0.1 to 1 m, lean about 42 deg on hard
    ground (kedge/DART_PHYSICS31.md answers); still scenes reuse the clean field (render about 1.5x faster)
    - flight: video impact window and typical lateness from the realistic eval (late up to 0.25 s, typical 0.11 s),
    track sigma 8 deg (angle of attack), table speed prior 8 percent (physics: 2 percent scatter plus model error),
    stronger glitch frame filter and end-of-video noise floor
    - mission: /auto refused not upright offers Force anchor (/auto?force=1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
    [dart.py, flight.py, mission.py, mock_dart.py, test_dart_v31.py]
2026-11-07 Notes: dart-jetson uses the physics answers and API v4.1
    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
2026-11-07 Jetson: link check no longer drops realistic frames as torn, ground ROI levels a leaning dart's horizon
    - video/quality: tear rows judged against their neighbourhood (textured ground under a smooth sky is not a tear),
    black side strips of a shifted band caught; on realistic flights every corrupted frame is caught, no clean
    frame dropped (it marked half the rail frames bad before)
    - terrain: ground_roi turns the picture by the horizon angle first (dart leaning about 42 deg on a flank on hard
    ground) and keeps the square inside the turned picture; learning caches rendered landing frames
    - tests: test_realistic_flight (launcher model against the C3 table, link check on realistic frames)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
    [test_learn.py, test_realistic_flight.py]
2026-11-07 Dart v31 outputs: out31 (audit CLEAN, launcher fit FITS, wire room OK, all STEP valid), pack_v31 (3 plates, PPA-CF couplers, run sheet, engineering report), dist_v31 zips; CLAUDE.md sections 5 and 7
    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
    [KEDGE_v31_assembly_folded.step, _tmp.stl, antenna.stl, ballast.stl, barrel_keepout.stl, barrel_profile.dxf, bms_2s.stl, bno085.stl]
2026-11-07 Notes: dart-cad horn and kick-rest strength check, BNO085 orientation for dart-fw
    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
2026-11-07 Ignore the dart CAD scratch runs in kedge/work
    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
2026-11-07 Ignore more dart CAD scratch files
    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
2026-11-07 Dart fw v4.1: kick pulsing while the foot finishes, 150 s milling with heat rest, level to 20 deg, 3-motor stall no longer marks the kick planted; v31 wire routes; docs
    - dart-physics (8): when planting ends on a kick stall the kick pulses 0.4 s on / 0.2 s off while the foot finishes
    - dart-physics (9): pods step up to 150 s once milling (loam about 90 s), whole sequence 180 s; after a pods step over
    60 s the next /auto waits 60 s ('motors hot')
    - correction to (6): level with the pods to about 20 deg (650 ms), leaning from 10 deg
    - fix (fuzz seed 1 ep 5682, ANCHORED in air): the 3-or-4-motor manual stall rule stops the whole group without knowing
    which motor stalled, so it no longer mar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
    [changes_from_v29.csv, wire_cut_list.csv]
2026-11-07 Dart docs: BNO085 nose axis from the v31 sled mounting (bench check decides), video MOSFET place
    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
2026-11-07 Jetson: terrain classifier re-learned with realistic flights, aerial map marker from the flight path, levelling rule above the angle of attack
    - terrain prototypes learned with 216 realistic (caddx) flights added; realistic eval 48 flights: verdict as
    expected 90 percent, 0 GO on sand, rock or water, GO on all 16 hard ground and loose soil landings
    - mosaic: the landing marker comes from the model trajectory and the dart attitude at the reference frame
    (angle of attack up to 20 deg): median 0.07 m, 90th percentile 0.15 m (was 0.46 / 4.6 m)
    - flight: levelling-out cut needs a 15 deg rise ending near level and staying up (AoA swing no longer cuts the
    flight); video only range median 4.4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
    [flight.py, test_realistic_flight.py]
2026-11-07 Jetson tests: off-table launcher speeds at 6 percent (dart-physics scatter 2 percent), time-only fuse with the measured video lateness
    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
2026-11-07 Jetson tests: aim solver against the base rules on the real C3 table (LIGHT 0.25 N column, 6..47 deg, high branch)
    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
2026-11-07 Jetson docs: README accuracy on realistic synthetic flights (section 13), dart camera notes; REPORT dart v31 round
    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
2026-11-07 Dart v31 viewer data (exact print meshes) for the dart artifact
    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
2026-11-07 Jetson tests: clock offset check fits the 5 Hz status spacing on a 5x fast mock; real firmware test stows the legs before arming (API v4 legs out)
    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
2026-11-07 Jetson REPORT: verified counts for the dart v31 round
    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
2026-11-07 Jetson: dart v4.1 anchor 200 s and release 180 s time limits, motors hot refusal, --sim world lands the dart lying or leaning (dart-physics)
    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
2026-11-07 Notes: dart-jetson v4.1 follow-ups done, systest landing pose request
    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
2026-11-07 dart-physics: v32 sleeve auger sizing (spin torque vs drill gearmotor, holding at the new depth, with and without the foot); Matlock near-surface cohesion; notes to dart-cad
    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
2026-11-07 dart-physics: fins (panel-pair normal-force slope) in the flight model, tether attachment at a boom eye when the build has one
    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
2026-11-07 dart-physics: v32 preview (spin torque model for radial sleeve augers, boom/eye check, fin span sweep), 15 N first tow; notes
    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
2026-11-07 dart-physics: v31 outputs refreshed (spin torque without tip term, 15 N first tow)
    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
2026-11-07 Dart v32 WIP: drill motors inside hollow sleeve augers, kick leg on the centreline, tail boom with steel-pin eye, faired pivot blocks with swept stop faces (quick audit CLEAN)
    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
2026-11-07 Dart v32: capsule kick saddle, boom 28 (launcher rail-rear limit), foot auger 68 (reel cup limit), review renders, pipeline on kedge_v32.py
    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
2026-11-07 Notes: dart-cad v32 geometry for dart-physics, launcher needs for base
    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
2026-11-07 Ignore dart v32 CAD scratch runs
    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
2026-11-07 dart-physics: v32 release by milling out (breakaway vs stall, c 4 to 10 kPa), planetary / plain sleeve / firmware depth-limit fixes; notes
    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
    [dart_phys31.py, dart_v32_release.py]
2026-11-07 dart-physics: v32 rerun on the CLEAN out32 (release by milling out in the findings)
    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
2026-11-07 Dart v32: boom 9 x 9 (pusher hole clearance), kick hub screw M3 x 8, run sheet and report for v32
    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
    [report.py, runsheet.py]
2026-11-07 Dart fw v4.2: deploy guard at 67 % of the drill pair stall (depth_limited), drill channel reversed for the v32 tip planetary
    - dart-physics v32: during the pods step the drill pair read alone over drillGuardFrac (0.67) x drillPairStallMa (700 mA,
    bench step 4) stops pods and drills: ANCHORED with warning depth_limited (release keeps its 1.15 margin); replaces the
    85 % relax pause
    - dart-cad v32: the 2.33:1 star planetary in each sleeve tip reverses the sleeve; PinMap sign, DRILL_SIGN -1, applied in
    hwSetMotor; keys, sequences, flight hands and harness unchanged; levelling pods to 16 deg
    - simulator models the planetary (drill_gear_reverse, motor_dir in /sim/state); new sim test 15 (sig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
    [changes_from_v29.csv, wire_cut_list.csv]
2026-11-07 Dart v32: flush M3 x 8 boom pin (audit CLEAN, launcher fit FITS apart from base's line model)
    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
2026-11-07 Dart v32 outputs: out32 (audit CLEAN, launcher fit FITS apart from base's line model, all STEP valid, review renders), pack_v32 (plates A/B PLA, C PPA-CF, run sheet, engineering report), dist_v32 zip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
    [KEDGE_v32_assembly_folded.step, _tmp.stl, antenna.stl, barrel_keepout.stl, barrel_profile.dxf, bms_2s.stl, bno085.stl, boom_anchor.step]
2026-11-07 Notes: v32 as built has no tip planetary (DRILL_SIGN +1), horn check, wire points
    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
2026-11-07 Ignore dart CAD scratch leftovers
    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
2026-11-07 Dart v32b polish: tip caps close the sleeve ends, boom collar + stinger, flush screws in hull colour (quick audit CLEAN)
    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
2026-11-07 Dart fw v4.2: v32 drills are direct drive (no tip planetary): simulator default, tests and docs follow DRILL_SIGN +1
    - sim: drill_gear_reverse defaults to 0 (direct drive); test 15 expects motor and sleeve both +1 on key 3; test 14
    (milling) passes again
    - API, BENCH_TEST step 4, WIRING drill direction check, README, REPORT, wire list notes: planetary assumptions removed;
    the 67 % deploy guard stays as the main release safeguard in firmer loam
    - (DRILL_SIGN +1 and the test_logic sign check came from the coordinator)
    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
    [changes_from_v29.csv, wire_cut_list.csv]
2026-11-07 Dart v32b outputs: out32 (audit CLEAN, launcher fit FITS, STEP valid, wire room OK), review renders before/after, pack_v32, dist_v32, pub32
    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
    [KEDGE_v32_assembly_folded.step, boom_anchor.step, changes_from_v29.csv, coupler_L.step, coupler_R.step, drill_leg_L.step, drill_leg_L_auger.step, drill_leg_L_tip.step]
2026-11-07 WIP dart v32c polish (in progress, not audited)
    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
    [dbg_body.stl]
2026-11-07 Dart v32c: kick pivot lowered 5 (KICK_RAISE 0), round-cornered pole flute in the nose top (floor = kick rest, hull slotted over the spigot), foot housing tilted about its output shaft with a web (foo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
    [dbg_body.stl]
2026-11-07 Dart v32c: saddle outboard shoulder r4.5, kick N20 -y stub trimmed inside the pocket (no outboard slot), broken strap slots removed (worm box keys the motor), foot web shorter and strap groove clear 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
2026-11-07 Dart v32c: arm head/neck r1.2 face edges (no ledge), run sheet/report/pack text for the flute rest, trimmed kick stub and pivot-block stops; v32b review shots kept in out32/review/before_v32b (coarse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
2026-11-07 Dart v32c: pole and web datum edges 45 deg chamfers (fit the flute, print on the bed), web corner arcs r3.6, pack stands the tilted foot auger back on its base
    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
2026-11-07 Dart v32c outputs: out32 (audit CLEAN at 1 deg, launcher fit FITS, all STEP valid, wire room OK), review after-shots in out32/review/after, pack_v32, dist_v32, pub32; CLAUDE.md section 5 and shared n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
    [KEDGE_v32_assembly_folded.step, barrel_keepout.stl, barrel_profile.dxf, boom_anchor.step, brg_ear.stl, coupler_L.step, coupler_R.step, drill_leg_L.step]
2026-11-07 Prototype tapered drill bits (T12, T16 L/R, T20) with a motor grip, and the v32c simulation spec sheet
    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
    [bit_T12_RH.stl, bit_T16_LH.stl, bit_T16_RH.stl, bit_T20_RH.stl, drill_grip.stl]
2026-11-07 Drill test print pack: STLs, one 3MF plate and a zip
    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
    [bit_T12_RH.stl, bit_T16_LH.stl, bit_T16_RH.stl, bit_T20_RH.stl, drill_grip.stl, drill_test_plate.3mf]
2026-11-07 WIP dart v33: tapered drill augers (motor in a short hub, gimlet point on the M3 shaft spine, buttress flight 45/30), foot gimlet
    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
2026-11-07 Dart v33: tangent S-curve necks on the drill and foot augers, review33.js close-ups, audit counts the shaft self-tap as thread (coarse audit CLEAN)
    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
2026-11-07 Run sheet, report and pack notes for the v33 tapered drills (pressed nut + self-cut spine thread, no tip cap)
    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
2026-11-07 Dart v33 outputs: out33 (audit CLEAN at 1 deg, launcher fit FITS, all STEP valid, wire room OK), pub33, review shots; CLAUDE.md section 5 and shared notes (tapered drills, deploy 50, mass 270.3 g, CG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
    [_tmp.stl, antenna.stl, bms_2s.stl, bno085.stl, boom_anchor.step, boom_anchor.stl, boom_pin.stl, brg_ear.stl]
2026-11-07 Dart v33 print pack and delivery zips: pack_v33 (STL, 3MF plates, STEP, run sheet and report PDFs, assembly STEP via LFS), dist_v33
    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
    [KEDGE_v33_assembly_folded.step, barrel_keepout.stl, barrel_profile.dxf, boom_anchor.step, boom_anchor.stl, changes_from_v29.csv, coupler_L.step, coupler_L.stl]
2026-11-08 KEDGE righting sim: Rapier rigid-body study of landing, self-righting, drilling in and the reel tow
    kedge/sim_righting/index.html: one-page browser sim (Rapier 3D 0.14.0, three.js r128). Body, two drill pods
    and a top righting leg as rigid bodies on hinge joints; worm drives (0.21 N m stall, self-locking) and hard
    stops as explicit torque springs so the page shows motor load versus stop load per joint. Landing presets,
    firmware-style righting controller, plant and drill, 15 to 55 N tow, batch of 50 random landings in Web
    Workers. results.json: preset and batch results.
    Claude-Session: https://claude.ai/code/session_01Y9T2MA1da8uJdcpXwD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
2026-11-09 KEDGE dart findings report: v31 to v33, prototype drill bits, self-righting study (21 pages, 19 figures)
    kedge/reports/make_findings_report.py builds KEDGE_dart_findings_report.pdf (plain black Arial / Liberation Sans)
    from out31..out33 physics, anchor, flight, audit and fit JSON, v32_release.json, sim_righting/results.json, and
    graphs in fig/ (holding by soil, release margin vs cohesion, spin torque vs OD, mass breakdown, righting time
    histogram, holding vs tow tension, centre of mass height, pod layout worm-load sketch). Renders and sim screenshots
    copied into fig/. righting_batch_rerun.mjs reruns the page's batch headless (same physics core and seeds) for the
    per-run righting times and th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
2026-11-09 WIP dart v34: rear pods folding forward (eye lugs, mirrored stops), flush righting leg with fork root on two couplers, in-line cells, integral tail walls; viewer joint/sign aware
    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
2026-11-09 Dart v34: coarse audit clean, CG on the axis (in-line cells, motors down, belly putty pockets, pod pivot z 9.5), joint/sign-aware audit, solver, mass props
    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
2026-11-09 Dart v34: flush skin plugs carry the leg couplers (no grubs), swept forward bed for the leg root, eye lugs above the launcher stops, tray prints on a flat underside, rounded socket openings
    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
2026-11-09 v34 harness (45 wires on the corridor routes), wire room corridors, v34 run sheet and engineering report, assembly-stage shots
    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
2026-11-09 Dart v34 polish: the righting leg's blade tapers aft and flares into the pad (plan-shaped groove), seat boxes inside the wall, BM tab slot in deck 1, socket corners
    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
2026-11-09 Dart v34 outputs: out34 (audit CLEAN at 1 deg, launcher fit FITS over 1684 states, ALL STEP VALID, wire room OK), pack_v34 (assembly STEP via LFS), dist_v34, pub34; CLAUDE.md results (249.4 g, CG z -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
    [KEDGE_v34_assembly_folded.step, antenna.stl, ballast_belly.stl, barrel_keepout.stl, barrel_profile.dxf, bms_2s.stl, bno085.stl, camera.stl]
2026-11-09 Ignore dart v34 CAD scratch runs
    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
2026-11-09 Viewer draws the v34 tether (bridle legs, knot, line to the rover); per-part and rope review renders
    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
2026-11-09 Dart v34 independent review: blockers (sealed putty pockets, 3-pin seat, rear disc screws, coupler play, bridle vs launcher, fw auto), parts vs inventory, tether path, 0.55 N m worm peak traced
    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
2026-11-09 Dart v34 physics: one deploy worm on a stiff axle (rigid 0.14 N m median, 1 of 80 over stall; play undoes it), flight with the bridle (nose first, pitch stable on half the v32c moment, yaw near neutr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
    - sim_righting/v34_check/run34_shared.mjs: the study sim with one deploy worm for both pods (rigid one-joint axle, or a press-fit
    axle with compliance and residual play), the real eye lug and a 78 mm sliding-loop bridle; summarize_shared.py,
    v34_shared_worm.json / .md (loam 80, sand 20, 12 configurations incl. no putty and highest CG)
    - flight34.py + phys34/flight34.json: planar pitch and yaw flight with flight_sim's strip aero on out34, bridle tow m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
    [dart_model.py, flight34.py, mass34.py]
2026-11-09 Dart fw v4.3 for v34: righting leg on the kick channel, no foot, auto rights the dart then pods + drills
    Fixes review B6. The kick channel (DRV#1 B) now drives the righting leg; the foot channel (DRV#2 B, D6/D7) is never
    driven and keys 4/$ answer "no foot on v34". /auto folds the leg first if it is not known folded, then reads the tilt:
    under 15 deg no righting; belly up a leg flip (out until going over plus 0.6 s, or a stall: the far stop in air is
    normal, no NO_GROUND), leg back to its fold stop; on a flank both pods roll it with the drills off. After a move
    under 20 deg counts as upright (shared-worm sag cases), 6 moves then NOT_UPRIGHT. This is the study sim's policy on
    v34's one deploy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
    [fuzz_logic.cpp, kedge_dart.ino, kedge_logic.h, mission.py, mock_dart.py, sim_world.cpp, test_jetson_client.py]
2026-11-09 Dart v34 review fixes (code): nose putty pocket, 3-pin seat, screw bosses, tail key, press-fit couplers, bridle grooves, U saddles, USB notch, capacitor; audit shells/insertion/screw bite; launcher_f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
    [audit27.py, coupon.py, kedge_v34.py, launcher_fit.py, pack.py, report34.py, runsheet34.py]
2026-11-09 Dart v34 review fixes (outputs): out34 audit CLEAN with shell, insertion and screw bite checks, launcher fit FITS with the stowed rope, ALL STEP VALID; pack_v34, pub34, fix close-ups c01-c24; docs (m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
    [KEDGE_v34_assembly_folded.step, ballast.stl, ballast_belly.stl, barrel_keepout.stl, barrel_profile.dxf, capacitor.stl, coupler_L.step, coupler_L.stl]
2026-11-09 Dart v34 dist rebuilt after the review fixes
    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
    [barrel_keepout.stl, barrel_profile.dxf, coupler_L.step, coupler_L.stl, coupler_R.step, coupler_R.stl, drill_leg_L.step, drill_leg_L.stl]
2026-11-09 Jetson side for dart fw v4.3 (v34): leg keys, no foot, righting in the mock, NOT_UPRIGHT handling
    comms/dart.py keys and docs (2/@ the righting leg, no 4/$). comms/mock_dart.py follows v4.3: righting steps before
    the anchor (leg flip from its back, pods roll from a flank, drills off), no "not upright" refusal, hooks cannot_right
    (NOT_UPRIGHT), warn_pods_limit, fail_anchor (NO_CURRENT), motors per step, foot always 0, 4/$ refused. mission.py:
    fault texts for the leg, NOT_UPRIGHT offers Release and reshoot or Force anchor, anchor timeout 260 s; cli dart auto
    waits 260 s; App dart keys; README/REPORT. Dart sim: a finished trace hands its resting pose to the plant so the
    righting acts on the ren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
    [dart.py, mission.py, mock_dart.py, sim_world.cpp, test_comms_dart.py, test_dart_v31.py]
2026-11-09 Dart v34 tether simplified (code): line tied through two holes in the tail face, straight back; no bridle grooves (Harry)
    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
2026-11-09 Dart v34 tail tie holes moved 1 mm in (knot clear of the pusher hole); sim: tail tie puts about 0.9 N m on the deploy worm at 55 N in loam
    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
2026-11-09 Dart v34 with the simple tail tie (outputs): audit CLEAN, launcher fit FITS, STEP valid; pack_v34, pub34, dist_v34, run sheet tether step; CLAUDE.md tether notes
    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
    [KEDGE_v34_assembly_folded.step, _tmp.stl, barrel_keepout.stl, barrel_profile.dxf, coupler_L.step, coupler_R.step, drill_leg_L.step, drill_leg_L_auger.step]
2026-11-09 Dart v34: all print-oriented STLs in one zip (PLA / PPA-CF folders); tail tie close-ups
    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
    [coupler_L.stl, coupler_R.stl, drill_leg_L.stl, drill_leg_L_auger.stl, drill_leg_R.stl, drill_leg_R_auger.stl, fit_coupon.stl, fit_coupon_pegs.stl]
2026-11-09 Fit coupon laid out with no overlaps (the v34 row and the old rows sat on the rings and the old peg); all print STLs checked
    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
    [fit_coupon.step, fit_coupon.stl, fit_coupon_pegs.step]
2026-11-10 Run sheet: tether step points at 6.2; assembly stages image
    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
2026-11-10 Base show build: v34 dart, no one-way bearings, hand crank and aim knob, sensing and electronics left out
    The base is now the hand-operated SHOW version of the D50 design (tag base-parked-d50):
    - launcher dart model swapped to KEDGE v34 folded (built from kedge/out34), tether line starts at the v34 tail knot
    - sprag #1 replaced by a printed fixed hub, sprag #2 by a plain bore idler on a plain axle
    - aim splitter and take-up swing idler left out; aim by a knob on the countershaft, a hand crank on the main shaft
    - wiper and N20 mounts kept but not linked (no shear pin, no N20 pinion)
    - sensors subsystem, switches, magnet cap, electronics bay, camera and receiver mounts left out (assembly drop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
    [assembly.py, audit.py, launch.py]
2026-11-10 Base show build: render and print pack scripts, loaded / cocked / fired renders with the v34 dart
    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
2026-11-10 Base show build outputs: audit CLEAN, print pack zip (PLA / PPA-CF), one-page hand operation note
    Audit CLEAN over 46300 states (207 parts, no FORCE). 160 printed parts: 80 PLA, 80 PPA-CF.
    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
    [BOM.csv]
2026-11-10 Base show: sheet of all 20 print plates
    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
2026-11-11 Launcher display build: real size, launcher only, 670 g PLA on 3 plates, interference check clean
    Fused D50 launcher prints at one pose (rail 30 deg, carriage at HOME on the big gear's first tooth, v34 dart loaded),
    a small motor adapter plate with one leg for the real wiper motor, the D50 electronics bay with thinner walls for
    the real boards, the real C-243 springs on printed anchor pins. Reel and drum as optional hollow look-alikes on a 4th
    plate. Oriented STLs in one zip, one standalone 3MF per plate, one-page note, renders.
    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
    [plate_1_PLA.3mf, plate_2_PLA.3mf, plate_3_PLA.3mf, plate_4_optional_PLA.3mf]
2026-11-11 Launcher display: plates sheet
    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
2026-11-11 Render: Mac runner (double-click render_mac.command: presets, resumable PNG frames, MP4 join; tested here)
    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
2026-11-11 Render motion: physically driven motion.json for the base and the v34 dart
    Base from its own joints, kin and line paths (full D50 build, asm.json part list) on
    its timeline: aim to 34 deg, cock 241 mm, the 59 ms shot from the launcher physics
    trace, rail low, drum to NEUTRAL, 7-turn wrap, park, tidy, REEL, tow. Flight from
    flight34 physics; landing, righting and anchoring from the sim_righting v34 tail tie
    sim (loam seed 1021, instrumented, unchanged physics). Tether rope on the base line
    path. Slow motion baked into film time, 1731 frames at 30 fps. Checks and plots.
    Claude-Session: https://claude.ai/code/session_01Y9T2MA1da8uJdcpXwDw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
2026-11-11 Render env: paddock environment module (terrain, GN grass, fencing, logs, HDRI sky, render settings)
    build_env(scene): rolling 60 m+ paddock with flat zones at the base and landing patch
    (within 1.5 cm of z 0), worn horse tracks, poached gateway mud, geometry-nodes grass
    (3 LODs, hero-zone density, clover, plantain, dandelion, buttercups, seed heads),
    post-and-rail fencing with a field gate, log jump, fallen logs, stump, hay bale,
    trough; Poly Haven Evening Meadow HDRI with matched sun lamp; set_render() for
    EEVEE and Cycles. fetch_env.py downloads the CC0 assets, CREDITS.md lists them.
    Claude-Session: https://claude.ai/code/session_01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
2026-11-11 Render models: base, dart v34 and kit models module (first cut), Jetson Orin Nano dev kit mesh, PBR detail materials
    render/models.py builds every D50 base part at its rest pose under base:root, the v34 dart
    with pivot empties (DART_JOINTS), the board, the electronics and cables, stretchable C-243
    spring coils, and renders three preview sheets. The Jetson comes from NVIDIA's dev kit CAD in
    the CC0 Printables model 555369 (fetch_models.py converts it); CC0 texture sets from
    ambientCG and Poly Haven are fetched into the cache.
    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
2026-11-11 render: build.py integration scene (env, models, motion keys, GN tether, fx, cameras)
    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
2026-11-11 Render models: real Jetson Orin Nano dev kit mesh with per-part materials, PBR detail on every material, motion.json joint form for the dart, rope material
    The dev kit comes from NVIDIA's CAD (CC0 Printables upload) with every component; face
    indices fixed and each part number mapped to a material. Materials get roughness and height
    maps (CC0, box projected), fingerprints, cavity grime, worn edges, dust and micro bump; the
    board uses the Poly Haven plywood re-toned to birch. Dart moving parts are their own pivots
    named as in motion.json joints; mat_rope() gives the 12-strand Dyneema braid; springs key
    from motion.json pins; wiper motor plug and lead.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
2026-11-11 Render models: LiPo label colour and wrap detail, wiper lead routing
    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
2026-11-11 Render motion: righting sim started from the flight's own end state, no blend
    Flight in 3D (flight34 strip aero in both planes, cross-wind, no roll mechanism). The
    righting sim now starts from the flight's end pose, velocity and angular velocity (no
    attitude blend, no artificial roll). Launch inputs found by search_landing.py within
    plausible ranges: its own bounce leaves the dart inverted and the leg alone rights it,
    both drills go in, 55 N held. Carriage stop flexure overshoot and rebound from a stop
    model (springs follow), tip-off builds up over the cradle slide, spool coasts when
    slack, line bows with air drag in flight.
    Claude-Ses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
2026-11-11 Render models: wiper motor model, silkscreen and parts on the bay boards, rope colour that holds under AgX
    Procedural 12 V wiper motor at the CAD envelope (die-cast gearbox with cover, parting line
    and ribs, ears with rubber grommets, black can with crimped flange and end cap, brush-holder
    plug and leads to the bay). ESP32-S3 DevKitC-1 and BTS7960 get real silkscreen text (pin
    labels, board names), chip markings and more parts. mat_rope pushes saturation and tints the
    sheen so the braid reads yellow in the paddock light.
    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
2026-11-11 Render models: previews with the wiper motor, board detail and tuned materials
    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
2026-11-11 render: build.py flat-mat grass presses, short grazed landing patch, soil heaps along the drill cuts
    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
2026-11-11 render: build.py data-driven auger axes and dart length (drop-in for a revised dart), calmer ground cameras, anchoring from the nose side
    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
2026-11-11 render: build.py reroutes the slack line over the muzzle lip roller (motion.json drops it through the rail), debug camera fix
    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
2026-11-11 render: low-res motion check video (Cycles 8 spp, 320x180, every 2nd frame)
    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
2026-11-11 render: SPEC v2 direction (v35 dart, static distant cameras, real time, Australian paddock, PLA/PPA-CF prints, 4K)
    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
2026-11-11 render v2: two locked-off fitted cameras (A wide 3/4, B side-on to the line, cut at the cut event), compositor camera look, tripod micro-shake, cockatoo hook, uhd preset as the default
    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
2026-11-11 render v2: BUILD.md for the two locked-off cameras, camera look and uhd; motion check every frame at 480x270
    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
2026-11-11 Render models: dark blue PLA and black PPA-CF prints with print-oriented layer lines, KEDGE_OUT dart source, data-driven dart joints
    Printed parts follow the build: PLA dark blue satin, PPA-CF matte black carbon nylon. Layer
    lines, banding, z seam and top infill come from each part's print orientation (asm.json
    print_tf for the base, kedge/pack.py ORIENT for the dart, local z otherwise) through object
    properties, so they live in the shader. The dart dir comes from KEDGE_OUT (out35 when READY,
    else out34) and DART_JOINTS is derived from parts.json (pivots, riders, auger axes).
    Claude-Session: https://claude.ai/code/session_01Y9T2MA1da8u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
2026-11-11 render v2: cam:B 5.2 m off the line on a 1.7 m tripod, lens fitted within 24-35 mm; native 4K line crop test
    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
2026-11-11 Render motion v2: real time 1:1 with one cut, motor-driven base, line over the lip roller
    Base moves on a real-time schedule: the wiper as a DC motor against the springs and
    trains, the drum at the N20's 8.1 deg/s, the firmware C1 order (aim, cock, the shot,
    rail low, NEUTRAL, wrap, park, tidy until tight, REEL, tow, hold). No slow motion; one
    cut (cam:A -> cam:B) skips the drilling and the wrap. Quarter-frame keys around the
    shot and the impact for motion blur. The free line now runs to the funnel mouth and over
    the muzzle lip roller with the total line conserved; checked clear of every base part.
    Dart build from KEDGE_OUT (out35 once READY), sim configuration and joint mapping derived
    from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
2026-11-11 Render motion: v35-ready sim configuration (mass34 groups) and joint map from the build's own meshes
    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
2026-11-11 Dart v35 CAD: pods hinged at the front (x 50), folding aft, drills raked back toward the tether; out35 audit CLEAN, launcher fit FITS, ALL STEP VALID; out35/READY
    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
    [_tmp.stl, antenna.stl, ballast.stl, bms_2s.stl, bno085.stl, camera.stl, capacitor.stl, cell_1.stl]
2026-11-11 Dart v35 outputs: pack_v35 (plates A/B PLA, C PPA-CF, run sheet, engineering report, v35 wire routes), dist_v35 (STL by material, reprint vs v34), pub35 viewer, righting/tow sim (sim_righting/v35_che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
    Righting 100 % (loam, sand, named poses, fixed paths); tow: deploy worm 0, stops 4.24 N m both; loam holds 45-49.5 N in the study sim.
    Flight: nose first at every rail (CG x 75.6). Reprint vs v34: hull_top, hull_bottom, tray, righting_leg.
    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
    [KEDGE_v35_assembly_folded.step, barrel_keepout.stl, barrel_profile.dxf, changes_from_v29.csv, coupler_L.step, coupler_L.stl, coupler_R.step, coupler_R.stl]
2026-11-11 Render motion: KEDGE v35 dart (front pods folding aft, drills raked back)
    Landing search rerun on out35 (160 runs): picked run's own bounce ends inverted, the leg
    flips it and one pod roll finishes it, both drills go in, held 45 N in the sim. Sim set
    up from out35 parts.json and mass props (whole-dart CG matched). Under the tow the dart
    pitches 6 deg nose up and presses both pods onto their stops. Real time, one cut, line
    over the lip roller as before.
    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
2026-11-11 Render models: KEDGE v35 dart from kedge/out35 (READY), docs for the v2 materials
    DART_JOINTS for v35 come out of parts.json exactly as motion.json has them (front pods at
    x 50, sgn +1, augers spinning about +x); kedge/pack.py's v35 print orientation feeds the layer
    lines; folded and deployed poses checked against out35/review/04_deployed_side.png.
    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
2026-11-11 Render motion: v35 sims on the dart team's validated v35 job, leg-only righting landing
    Sim configuration now the kedge/sim_righting/v35_check F_rigid_tie job (front pods at x 50
    folding aft, hull 192.1 g, CG x 74.9, z -2.55, rigid axle, tail tie). Landing search rerun
    (160 runs): the picked launch lands inverted from its own bounce and the leg alone rights
    it in 6 s, both drills go in, held 45 N; the tow presses both pods onto their stops.
    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
2026-11-11 Render env v2: sunny Australian summer paddock, gum trees, wire fence, litter, wind, cockatoos
    Dry straw grass with green at the base, tussocks and wild oat / barley grass / ryegrass
    seed heads (3 LODs, dense where the two tripod cameras look), patchy hoof-trodden dirt,
    gum leaves, bark strips, twigs, sticks, rocks, grit and dried manure; procedural
    eucalypts with pale trunks and sparse pendulous canopies; timber post and plain wire
    fence with star pickets, sighter tape and a tube gate; trough, fallen limbs, far shed
    and bales. Poly Haven Qwantani Noon HDRI (clear, sun 50 deg) with a matched side-on sun
    lamp, bluer camera sky, horizon haze. Wind sway on grass and leaves through the scene
    tim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
2026-11-11 render v2 integration: never interpolate across the cut (held keys, line cache, settled crumbs), shutter opens at the frame, cameras on the -y side of env v2, reroute removed (motion v2 leads the lin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
2026-11-11 render: BUILD.md cut handling, camera side, cockatoos
    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
2026-11-11 render: phone-footage camera look (sun veil and lens ghosts from the sun's screen position, fog glow, CA, softness + sharpening halo, sensor noise, AgX Punchy, warm WB), sun placed ahead of cam:A via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
2026-11-11 Render env v3: Harry's yard (mown lawn, rail fence on the crest, treeline), set_sun, one cockatoo
    Mown green lawn (cut blades, mower stripes, mottled yellow-brown dry patches, clover,
    waxy speculars and translucency), rise and hump to a fence crest; grey 3-rail
    post-and-rail fence with mesh gate, electric tape on tread-in posts and star pickets,
    stump, sandstone boulders, sacks, open shelter; mixed treeline (eucalypts, dense
    bushy trees, Norfolk Island pine, dead and bare trees, shrubs). Pretoria Gardens
    HDRI, sun ahead of the cameras by default; set_sun(scene, az, el) moves the lamp,
    rotates the HDRI, re-aims the camera-visible sun glow and the cloud-shadow plane.
    add_cockatoos(scene, fire_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
2026-11-11 render: deadline build: 720p fast EEVEE defaults, film trimmed to launch, drill and taut (273-712, 859-1157: 739 frames), preset.py renders the ranges back to back into one MP4, Workbench glitch pass
    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
2026-11-11 Render env: lighter mottled lawn ground under the blades, wider near blades, LODs less tufty
    The cam:A foreground read dark and flat: the ground under the mown blades was darkened
    to a shaded tone and the near (LOD0) blades were too thin to show at that distance.
    Ground under the lawn is now a mottled green-yellow lawn tone, mown blades are 4.5 to
    7.5 mm wide and 3 to 6.5 cm long, and the LOD1/LOD2 widening is reduced so distant
    clumps no longer look tuftier than the near ones. API unchanged.
    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
2026-11-11 render: final deadline build (env b63de1b): 720p fast EEVEE, 25 s film in two ranges, lawn ground fallback hook, stills cam:A launch and landed, cam:B taut; stale v1 check video and crops removed
    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
2026-11-11 Render env: matte, rough materials (grass, ground, timber, rocks, sacks, galvanised steel)
    Grass roughness 0.58 to 0.75 with a low specular level (a few random blades glint),
    smaller per-blade normal tilt; ground rough and nearly non-specular; fence timber
    rough with a stronger grain normal; sandstone, rocks and sacks matte; galvanised
    gate, wire and roof steel dull. API unchanged.
    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
2026-11-11 Render models: matte satin PLA with stronger layer ribs, matte PPA-CF, dull metals, matte wires, PCBs and ply, dust, dirt and ground staining
    Roughness floor 0.3 on every detailed material (no mirror highlights), dust film on upward
    faces, dirt and grass stain near the ground and on dart objects (object property dirt).
    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
2026-11-11 Render models: sunlit close-up check of the matte materials (base and v35 dart)
    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
2026-11-11 render: stills from the matte-material final build (cam:A launch to drills, cam:B taut)
    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
2026-11-11 render mac: short cut 273-650 + 859-960, hd720 10 samples, clear empty placeholders before resuming
    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
2026-11-11 render mac: clip 1 = frames already rendered (273-579), clip 2 = cam:B 859-960
    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
2026-11-11 render mac: still grass (no cloud shadows, no wind) at render time, frames_v2, hd720 16 samples; still.py for HD stills
    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
2026-11-11 render mac: 15-min cut (launch, drills, taut), clean image without filter or warm cast, frames_v3; still.py drops markers
    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
2026-11-11 render: neutral toned-down camera look (WB 5700 K, natural AgX contrast, light vignette, mild glare, faint noise); cy720 preset (Cycles on the Apple GPU, 16 samples + OIDN, 5 bounces, frames_cy720, 2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
2026-11-11 render: build.py --size for test frames and --pack (grappstar_render.zip with the .blend and the Mac files)
    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
2026-11-11 Render env: photoscanned lawn (Poly Haven grass_bermuda_01), even green, no wind, clouds or dry blobs
    The lawn is now about 380k instances of the Poly Haven grass_bermuda_01 scanned
    alpha-card clumps (small, medium and seedling), scattered densely on a jittered grid with
    random rotation and scale, kept 5 to 8 cm tall, density easing off with distance
    (about 420 per m2 near the action and the cameras, 140 by 20 m, sparse to 30 m), over the
    even photo lawn texture. Dry patches, mower-stripe pattern, cloud-shadow plane and all
    wind sway are removed. The procedural clumps remain as the fallback when the scan is not
    cached; fetch_env.py downloads the scan. Fence, trees, shelter, cockatoo, terrain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
2026-11-11 render: Cycles 720p test frames with the photoscanned lawn and the toned-down grade (cam:A 330, cam:B 900)
    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
2026-11-11 Render models: uneven highlights: layer lines drive roughness (ridges 0.35, valleys 0.75), smudges, fingerprints, scratches, speckle, darker grime, per-part hue / value shift
    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
2026-11-11 render: workshop-table HD stills (both sides, dart close-up) with the uneven-highlight materials
    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
